leolei2012/power_system/inverter/reference/README.md

# 开源参考

本目录保留已有开源项目的索引和对照笔记。用户指定的参考资料下载统一放在工程根目录 [reference](../../reference/README.md)，ATK-PD6010B 单独归档。

当前第一版已定母线 12～60 V、直流输入最大 10 A、每相连续 10 A_rms、20 kHz。当前 G431 控制、驱动和功率级集成在 inverter 同一板，旧分板说明只作历史参考。下表及既有对照笔记中涉及旧 100 V / 1 kW 目标的比较，需按 [当前规格](../docs/spec.md)重新核对。

| 资料 | 电压 / 功率 | 对本板 | 笔记 |
|---|---|---|---|
| [OWNVERTER](ownverter.md) | 高压侧最高 100 V，约 1.3 kW | 电气最接近，优先看 | 滤波后电压采样口可参考 |
| [Nexperia 逆变板](nexperia-nevb.md) | 工作 12~48 V，1 kW；管子 100 V | 功率板单独成板的画法 | 不能直接上 100 V 母线 |
| [openinverter](openinverter.md) | 几百伏 IGBT | 控制 / 驱动 / 采样分板 | 第一版低压用不上功率级 |
| [ODrive / ODriveX](odrive.md) | 24~60 V | 电机固件成熟 | 母线不够出 60 V 交流 |
| [VESC / FOC_KING](vesc.md) | 常见 60 V 级，FOC_KING 约 84 V | 大电流布局、模块化 | 60 V 交流没有余量 |
| [SimpleFOC](simplefoc.md) | 评估板约 25 V | 学 FOC、对 PWM 接口 | 功率级不是这一档 |

没有找到带可旁路 LC、专门做可编程交流电源的开源功率板。电机驱动是主流，交流源要自己加。

## 使用约定

- 对照原理图时打开上游仓库，不要把 KiCad / Eagle 工程提交到这里。
- CERN-OHL、CC BY-SA 是相同方式共享。若以后把他人图纸改进 `hardware/`，必须保留原许可和署名，不能改成私有设计。
- MIT 可以借鉴电路思路；直接复制整页图纸仍要保留版权声明。
- 仓库简介和文档里的电压、电流有时不一致，以对应版本的原理图和手册为准。

各项目的克隆地址写在 [sources.md](sources.md)。
