leolei2012/power_system/docs/design_decisions.md

# Rev E-1 设计决定记录（design decisions）

- 整理人：领班（项目经理 bot），2026-11-12（Asia/Shanghai）
- 修订（2026-11-12 00:45 后）：
  - 新增 A12（叠板顺序），删去待定的叠板顺序项，冲突第 5 条改为已移除；
  - 默认做法几条改为已定；
  - C12 标为须按新顺序重新核对；
  - 2026-11-12 00:46 新增 A13（保护参数），风扇预留位移到作废方案 X17，删去对应待定项，冲突清单补 4 条；
  - 2026-11-12 00:57 新增 A14–A23（叠板细节、验收环境、母线电流检测）；C12 定案；X8 改为采用顶面散热片；冲突清单补 #32–#35；
  - 2026-11-12 01:03 新增 A24（阻容最小 0603），冲突清单补 #36；
  - 2026-11-12 01:36 新增 A25–A27（母线高端保护、板上比较器、J4 和 C20 位置），A13/A21/A23 加交叉注。
- 依据：
  - 总管 2026-11-12 00:30 转来的开工需求全文（下称「开工需求」）；
  - 2026-11-11 晚到 2026-11-12 凌晨雨田和总管的需求讨论记录；
  - 2026-11-11 群聊「研发部交流群」的讨论（本次只拿到群聊结论，没有拿到原文，见文末「说明」）；
  - 焊台评估 `/workspace/tmp/ps_eval/评估.md`、探针报告 `/workspace/tmp/probe/report.md`、料号立创查价笔记 `/workspace/liaohao_notes/*.md`（都在共享电脑上，不在仓库里）。
- 理由的写法：「理由」只写讨论记录里出现过的说法，并注明是谁说的。记录里没有理由的，写「理由未记录」。
- 拍板日期：多数决定在 2026-11-11 晚到 11-12 凌晨的讨论中陆续定下，**2026-11-12 00:30 雨田确认开工时整体生效**。下表「日期」列写讨论定下的日期。表中标「默认做法」的条目由总管提出，雨田 2026-11-12 00:30 在开工确认卡片上选「按默认开工」（总管转述），已定。
- 本文件只记录决定。和现有文档冲突的地方只在第 3 节标出来，没有改动那些文件。

## 1. 已定决定

### 1.1 总体与板间连接

| # | 决定 | 理由（出处） | 日期 |
|---|---|---|---|
| A1 | 保持**两块板**（controller + inverter），各 60×60 mm，叠装。不合成一块板 | 理由未记录（群聊讨论过合一块板，原文本次没拿到） | 2026-11-11 |
| A2 | 板间用 **2.54 mm 排针/排母叠装**，不做 GH1.25 线束端子版 | 雨田在群里说「改回 2.54 mm 排针叠装吧」，本人没说理由。参考依据：寻宝调研认为排针叠装的载流和插拔都比 GH1.25 线束好；焊台估算端子版到能打样要多出约 60–90 h | 2026-11-11 |
| A3 | 左右两条边**最外侧各放一个 2×16** 排针，共 64 针。**不改 2×20** | 雨田先定「最左边和最右边各一个排针」，后来说「2×16 两组吧，可以」，本人没说理由。总管说明：MCU 放在两排中间，引脚出线都短；2×16 竖放长约 41 mm，放得下 | 2026-11-11 |
| A4 | 排针上**空着的脚全部接 GND** | 默认做法，已定（出处：雨田 2026-11-12 00:30 在开工确认卡片上选「按默认开工」（总管转述））。总管的理由：多点回流，抗干扰更好。寻宝调研也指出 Rev E 只有 7/64 根地针，偏少 | 2026-11-12 |
| A5 | controller **4 层**，inverter **6 层** | 沿用现有 Rev E 层数，讨论中没另说理由 | 2026-11-12 |
| A6 | 铜厚 **2 oz** | 默认做法，已定（出处：雨田 2026-11-12 00:30 在开工确认卡片上选「按默认开工」（总管转述））。总管的理由：5 A 用 1 oz 也能过，但 2 oz 温升更低，贵不了多少 | 2026-11-12 |
| A7 | 这一版是 **controller 和功率级一起做的完整版**，不只是功率级验证板 | 默认做法，已定（出处：雨田 2026-11-12 00:30 在开工确认卡片上选「按默认开工」（总管转述））。理由未记录 | 2026-11-12 |
| A8 | 验收电流 **5 Arms**，母线 **12–60 V**，开关频率 **20 kHz** | 5 Arms：雨田说「最大电流 4A」，「5A 吧，留点余量」。12–60 V 和 20 kHz 是 2026-10-31 已定的指标（`inverter/docs/spec.md`），这次沿用 | 2026-11-12 |
| A9 | **不加风扇，不焊铜条** | 默认做法。总管按 5 A 估算，每颗 MOS 约 0.5 W，温升约 20–25 °C，靠 PCB 铺铜和过孔就够 | 2026-11-12 |
| A10 | 物料**一律从立创商城选**，写 C 编号和商品链接。价格和库存由料号去立创查 | 雨田的规定，理由未记录 | 2026-11-11 |
| A11 | 引脚改动**先改 `docs/pinmap.md`**，再改原理图和固件 | 团队协作规则（硬件和固件靠 pinmap 对接），开工需求里重申 | 2026-11-12 |
| A12 | 叠板顺序：**功率板（inverter）在上，controller 在下** | 雨田 2026-11-12 00:44 亲口定（经总管转达），理由未记录。现有 Rev E 文档本来就是这个顺序 | 2026-11-12 |

**A12 的影响项（焊台已在 #4 核对；2026-11-12 00:57 已按 A14–A23 定案）：**

1. **排针的公母和安装方向**：现有文档写的是 controller 顶面装公针朝上，功率板底面装母座朝下（`docs/controller_daughterboard.md:107`、`docs/pcb_review_2026-11-11.md:25`）。排针已改到左右外侧（A3），所以要重新核对 1 脚位置、镜像关系和同号针是否同心。
2. **controller 上的 SWD、LED 和 CAN/485/编码器端子**：这些都在功率板下面，要核对叠装后线还能不能插拔、LED 能不能看到。必要时调整端子的位置或朝向（比如改成侧出、弯角端子），或者加高铜柱。
3. **功率板底面正对 controller**：功率板底面的散热过孔和裸铜区对着 controller，要留够间距和绝缘，controller 顶面的器件高度也要算进去。
4. **散热可能要改到顶面**（**已定：顶面散热片，见 A20**）：功率板底面被 controller 挡住，散热余量可能要转到功率板顶面。注意「正面散热」X8 已经作废，当时的理由之一是「功率板上面被控制板挡住」，现在功率板在上，这条理由不再成立。X8 已同步改为采用。
   - 底面散热器已作废（X5）。如果将来恢复，必须考虑它正对着 controller。
5. **C12「controller 底面不放器件」**（**已定案，见 A19**）：C12 当时的理由是「排母高 8.5 mm，底面有元件会顶到功率板」，是按 controller 在上推出来的。现在 controller 在下，朝向功率板的是它的**顶面**，原来的理由不再成立，这条规则和叠板顺序已经对不上了。规则本身是开工需求原文，暂时保留，等焊台核对后报雨田。真正要约束的是 controller **顶面**器件高度和功率板底面之间的净空。
| # | 决定 | 理由（出处） | 日期 |
|---|---|---|---|
| A13 | **保护参数跟着 5 Arms 改**：相电流硬件过流门限从 ±20 A 降到**约 ±12 A**；保险和直流输入电流上限按**约 8 A** 选；**分流电阻不动**。具体数值由焊台按器件和采样量程核算后，写进原理图和 `inverter/sim/params.py` | 雨田 2026-11-12 00:46 定（总管转达），理由未记录 | 2026-11-12 **交叉注：母线短路快速关断见 A25（约 15 A，补在保险来不及的场合），±12 A 和约 8 A 不变** |

### 1.1b 叠板细节和母线电流检测（2026-11-12 00:57 定）

下面各条都是 **雨田 2026-11-12 00:57 定（总管转述）**。理由都引自焊台 #4 评论 https://github.com/leolei2012/power_system/issues/4#issuecomment-6801916762（下称「焊台 #4 核对」）。

| # | 决定 | 理由（出处：焊台 #4 核对） | 日期 |
|---|---|---|---|
| A14 | **板距 11.0 mm**，用 **M2×11 双通铜柱** | 板距由排针决定：公针塑高 2.50 mm + 母座塑高 8.5 mm = 11.0 mm。铜柱短了会压坏排针，长了会减少插入深度。加高板距对散热几乎没帮助 | 2026-11-12 |
| A15 | controller 的 **SWD、485、CAN、ABZ、SPI 接口全部用板边侧插**（卧式），插头在板外 | 叠好后 controller 顶面全被功率板盖住；竖插要 ≥20 mm 板距 | 2026-11-12 |
| A16 | **RESET 改成板边侧按开关** | 原来的 TS-1101 是顶面按压开关，叠好后按不到 | 2026-11-12 |
| A17 | **取消 BOOT 按钮**，烧录走 SWD，需要时用 nBOOT0 选项字节（BOOT0 保留下拉和测试焊盘，按焊台建议） | 同 A16；而且新 pinmap 中 BOOT0 不再经排针引出 | 2026-11-12 |
| A18 | **RUN/FAULT 用上边缘的侧发光 LED** | 顶面贴片 LED 从 11 mm 侧缝几乎看不到 | 2026-11-12 |
| A19 | **controller 底面允许放 ≤1 mm 的无源件，以及 SWD/测试焊盘**。不放有源器件、连接器和高于 1 mm 的器件；底部支撑 ≥5 mm | controller 在下，底面朝外；底面最靠近 MCU，适合放去耦；现在底面已经有 5 个 0402/0603 件；底面 SWD 焊盘分不分板都能接。**C12 由此定案** | 2026-11-12 注：A24 定最小 0603，现有底面 0402 件也要换成 0603，并继续满足 ≤1 mm 的高度要求。 |
| A20 | **功率板顶面加散热片**，**底面整面铺 GND**（大量缝合过孔接 In1/In4），散热铜放顶面和内层。**仍然无风扇、无铜条** | 功率管本来就在顶面朝外；底面朝着半封闭的板缝。估算在 Ta 25 °C 时，加顶面散热片后 controller 均温约 40–45 °C，只靠铜皮约 53–63 °C。底面铺 GND 既能均热又能屏蔽，裸露的开关节点铜也就没了 | 2026-11-12 |
| A21 | **功率级整体左移 8–10 mm**，**三相输出 J4 移到上边缘** | 右侧排针移到最外侧（x151–157）后，和功率板上 23 个封装、三块相铜冲突 | 2026-11-12 **交叉注：J4 定在上边缘，挪 C20，功率级再下移 2–3 mm，见 A27** |
| A22 | **MCU 保持 STM32G431RBT6，不换**；**验收环境 ≤30 °C** | 焊台估算：没有散热片时，Ta 40 °C 下板缝温度会超过 RBT6 的 85 °C 上限。焊台给的选项是「保持 RBT6，验收环境 ≤30 °C 并实测板缝温度」 | 2026-11-12 |
| A23 | **不接受相线对地短路的保护盲区，加母线电流检测**：母线分流电阻加放大器，接 ADC 或比较器，并接进硬件过流保护或 TIM1_BKIN。具体方案由焊台设计，引脚先在 PR #11 改 pinmap，器件由料号在立创查 | 雨田 00:57 定，理由未记录。背景：现有只有三路低端分流，`inverter/docs/spec.md:60` 写了「低端分流存在检测盲区」 | 2026-11-12 **交叉注：具体方案已定，见 A25（高端分流 5 mΩ、20 V/V、约 15 A、PA3/COMP2/BKIN2）和 A26（板上硬件比较器接故障锁存）** |
| A24 | **电阻及同类贴片阻容件最小封装 0603**，不用 0402 及更小封装 | 雨田 2026-11-12 01:03 定（总管转述）。理由：便于手焊 | 2026-11-12 |
| A25 | **母线高端电流保护**：5 mΩ 高端分流（在母线电容和三相桥上管漏极之间），双向、高共模电流检测放大器，增益 **20 V/V**，跳闸约 **15 A**。定位是在保险来不及的短路时快速关断；正常过载仍靠相电流 ±12 A 硬件过流和约 8 A 保险（A13）。I_BUS 走 **J101/23 → PA3**（ADC1_IN4 + COMP2 → TIM1_BKIN2） | 雨田 2026-11-12 01:36 定（总管转述）。理由引自焊台 PR #11 评论 https://github.com/leolei2012/power_system/pull/11#issuecomment-6802827693：相线对地短路、上管导通时，短路电流不经过下桥 RS1–RS3；共地系统里，低端分流会抬高控制地，经外部地返回的电流也会绕过它。PA3 同时有 ADC1_IN4 和 COMP2_INP，其他同时具备这两项的引脚都已占用 | 2026-11-12 |
| A26 | **inverter 上加硬件比较器**（开漏、带迟滞），接进现有故障锁存：触发后硬件封锁 PWM，并拉低 FAULT_N 到 PB12/BKIN | 雨田 2026-11-12 01:36 定（总管转述）。理由引自同一条评论：这一层保护不依赖固件 | 2026-11-12 |
| A27 | **MR60（J4）放在上边缘**，**挪开 C20**，功率级**再下移 2–3 mm** | 雨田 2026-11-12 01:36 定（总管转述），按焊台建议。J4 移到上边缘的原因见 A21（右排针让位）；挪 C20 和下移 2–3 mm 的具体理由，上面那条评论里没写，理由未记录 | 2026-11-12 |

### 1.2 controller（控制板）

| # | 决定 | 理由（出处） | 日期 |
|---|---|---|---|
| C1 | MCU 用 **STM32G431RBT6**，板上**只放 MCU 最小系统** | 雨田说「这块板上只有 mcu 的最小系统」，没说理由 | 2026-11-11 |
| C2 | 3.3 V 由**板上自己的 LDO** 产生，沿用现有方案 | 现有设计就是这样：控制板从排针取 5 V，再用 TLV76733 转 3.3 V，两块板的 3.3 V 不并联 | 2026-11-11 |
| C3 | **通讯口搬到 controller 上** | 雨田说「通讯端子做在 controller 上也可以」。总管的理由：通讯信号直接从 MCU 引到板边，不用穿过排针，空出来的针可以改成地 | 2026-11-11 |
| C4 | 通讯只做 **UART（改成 485）和 CAN**，不要 USB | 雨田说「UART、CAN 就够了」，没说理由 | 2026-11-11 |
| C5 | CAN 沿用 **SN65HVD232**（C30530） | 共享库里已经选好这颗料 | 2026-11-12 |
| C6 | 串口从 TTL **改成 RS-485** | 总管的理由：485 是差分信号，在逆变器噪声下抗干扰强，线可以拉长。探针补充：两块板共地，TTL 一接电脑，电脑的地就直接连到功率地 | 2026-11-11 |
| C7 | 485 收发器用 **MAX3485ESA+T（C18148），不隔离**。DE 脚从 **PB3、PB4、PB9** 里选一根 | 雨田问了隔离型的价格和体积后说「用 max3485 吧」，没说理由。DE 只能从这三根里选，因为它们是空闲脚，PC14/PC15 驱动能力弱（总管） | 2026-11-11 |
| C8 | 485 端子 **4 针：A、B、GND、5V**。5V 要串二极管或加跳线 | 第 4 针接 5 V 是雨田定的（「5 V」），没说理由。加二极管或跳线是为了防止 5 V 倒灌底板的 5 V，现有文档也禁止两路 5 V 并联 | 2026-11-11 |
| C9 | 485 和功率地**共地**，PC 端**必须用隔离型 USB 转 485**。这一条写进测试规范 | MAX3485 不隔离，485 的地就是功率地（总管、探针） | 2026-11-11 |
| C10 | 编码器**两种接口都留**：一路 ABZ（PA0/PA1/PA2，TIM2），一路 SPI（引脚由焊台定）。原来的第二路 ABZ 去掉 | 雨田说「两种都留吧」。总管的理由：现成电机多半带 ABZ；SPI 磁编上电就知道绝对角度，FOC 不用先对位。两种都留最灵活 | 2026-11-11 |
| C11 | **两颗可编程 LED**：PC5 RUN 绿色、PC8 FAULT 红色，放在**上边缘** | 两颗灯是雨田定的，没说理由。复用 PC5/PC8 是总管的建议，理由是固件不用改。放在边缘是雨田定的，总管补充：叠装后从侧面也能看到 | 2026-11-11 **2026-11-12 00:57 改成上边缘侧发光 LED（A18）** |
| C12 | （**已定案，见 A15、A19。底面规则改为允许 ≤1 mm 无源件和 SWD/测试焊盘，端子改为板边侧插**）布局：**上边缘**放 SWD 和 LED，**下边缘**放 CAN、485 和编码器端子，**左右两边**放排针，**底面不放器件** | 总管的理由：叠装后调试线不会挡住端子；排母高 8.5 mm，底面有元件会顶到另一块板 | 2026-11-11 |
| C13 | 备用 ADC **PB0、PB2 引到排针上**，在 inverter 上悬空。**不加额外的 AD 端子，三相电压不测** | 雨田先说「三相电压不需要测」，后来说「这两个端子不要了」，都没说理由 | 2026-11-12 |

### 1.3 inverter（功率板）

| # | 决定 | 理由（出处） | 日期 |
|---|---|---|---|
| I1 | MOS 沿用 **BSC110N15NS5**（C412739），**不换双面散热型号** | 总管按 5 A 估算，每颗约 0.5 W，用现有 MOS 就够，便宜，货也多。对比：双面散热的 BSC110N15NS5SC 价格约 2.6 倍，LCSC 国际站库存只有 24 只（料号查价） | 2026-11-12 |
| I2 | 散热靠**底面过孔加铺铜**。底面要留出以后贴绝缘导热垫和铝板的条件，MOS 附近留 **M3 安装孔和禁布区**，作为以后加散热器的余量 | 总管的理由：电流小时靠 PCB 就够，留好余量，以后加大电流再贴散热片 | 2026-11-12 **2026-11-12 00:57 补充：底面改为整面 GND，散热改为顶面散热片（A20）；底面导热垫和铝板的余量不再适用** |
| I3 | **NTC 放在 MOS 旁边，接 PB1**，型号由焊台选 | 总管的理由：紧贴 MOS 测温才准，最好放在 V 相下管旁边。PB1 是端子版规划里的 NTC 通道（ADC09） | 2026-11-11 |
| I4 | 母线输入用 **XT60PW-M（C98732）** | 雨田说「用 XT60 / XT30 插头当电源」，没说理由。料号建议板上装公座，电池或线端用母头 | 2026-11-11 |
| I5 | 辅助电源用 **XT30PW-M（C431092）** | 同 I4。总管补充：辅助电源电流小，XT30 就够 | 2026-11-11 |
| I6 | 三相输出用 **MR60PW-M（C19268044）**，线端配 **MR60-F（C3040681）** | 雨田说「用 mr60」。总管的理由：一个插头接三相，不会插错相序，比螺丝端子方便。料号提示：板端持续电流按保守的 20 A 算 | 2026-11-12 |
| I7 | **D1 改成理想二极管**做防反接，型号由焊台选 | 默认做法，已定（出处：雨田 2026-11-12 00:30 在开工确认卡片上选「按默认开工」（总管转述））。总管的理由：比普通二极管压降和发热都小。焊台和探针估算现有 MBRD20150CT 在 10 A 输入时约 6–7.5 W | 2026-11-12 |

### 1.4 评估中提出、还要在 Issue 里落实的项（不是雨田拍板的决定）

下面几条来自焊台、探针、寻宝的只读评估，开工需求里没有逐条写。列在这里，避免遗漏：

- DC 输入 J3→F1 只有一条 2.0 mm、1 oz 的外层线，按 10 A 估算温升约 82 °C（焊台）。改成 2 oz、5 A 后要重新核算。
- U/V 相的 VBUS 换层过孔只有 2–3 个，U 相 source-transfer 只有 2 个，焊台认为不够。
- 顶面测试点：探针建议补 GND 测试环和 VBUS 测试点。总管在讨论 controller 布局时也提过 I_U/V/W、FAULT_N、GND 测试点放顶层，雨田没有确认。
- ADC 加 RC：寻宝调研建议 MCU 一侧的 ADC 加 RC。现有底板已经有 360 Ω/BAT54S 加 100 Ω/1 nF。
- `inverter/sim/params.py` 的阈值要按 12–60 V 重写（见第 3 节）。

## 2. 作废方案

| # | 作废方案 | 作废原因（出处） | 替代方案 |
|---|---|---|---|
| X1 | 三相 U/V/W 用 **5.08 mm 螺丝端子**（KF128 / DG129 / DG500） | 雨田改用 MR60，总管的理由是一个插头不会插错相序。料号查价也发现：KF128 的 UL 额定只有 10 A；DG129 国际站库存只有 99 只 | MR60PW-M + MR60-F（I6） |
| X2 | **隔离型 485**（CA-IS2092W/A、ADM2587E、金升阳模块等） | 雨田选了 MAX3485，没说理由。背景：CA-IS2092W 10 只单价约 15 元，约是 SP3485 的 10 倍，整个 485 区域约占 15×12 mm | MAX3485ESA+T 不隔离，PC 端用隔离型 USB 转 485（C7、C9） |
| X3 | **两个额外 AD 输入端子**（PB0/PB2 各一个 2 针，先放 controller，后改 inverter） | 雨田说「算了，这两个端子不要了」，没说理由 | PB0、PB2 作为备用 ADC 引到排针，inverter 上悬空（C13） |
| X4 | **双面散热 MOS**（BSC110N15NS5SC / BSC093N15NS5SC 等） | 验收电流定为 5 A 后发热小，不需要（总管）。另外价格约 2.6 倍，库存紧（料号） | 沿用 BSC110N15NS5（I1） |
| X5 | **底面散热器 / 铝底板** | 5 A 时靠 PCB 铺铜和过孔就够（总管） | 底面过孔加铺铜，留好导热垫、铝板和 M3 孔的余量，现在不装（I2） |
| X6 | **大电流路径焊铜条** | 5 A 时不需要，「风扇和铜条都不加」（默认做法，雨田 2026-11-12 00:30 在开工确认卡片上选「按默认开工」（总管转述）） | 2 oz 铜加走线宽度和过孔（A6、A9） |
| X7 | **风扇 / 侧面风道** | 同 X6 | 无风扇（A9） |
| X8 | ~~**正面（顶面）散热**~~ **→ 2026-11-12 00:57 改为采用**：顶面散热片（A20），不换 TOLT 封装，仍然无风扇、无铜条 | 当时作废的理由是「功率板上方被控制板挡住」；叠板顺序定为功率板在上（A12）后，这条理由不成立。雨田 2026-11-12 00:57 定（总管转述） | 见 A20 |
| X9 | **两组 2×20 排针**（80 针） | 雨田定了 2×16，没说理由 | 2×16，空脚全接 GND（A3、A4） |
| X10 | **HSEC 金手指**（TI controlCARD 那种） | 雨田在群里问过它长什么样，最后改回 2.54 mm 排针，理由未记录。参考：寻宝调研提到它需要硬金，成本高 | 2.54 mm 排针叠装（A2） |
| X11 | **两块板合成一块板** | 理由未记录（群聊原文本次没拿到） | 两块板叠装（A1） |
| X12 | **GH1.25 线束端子版**（19 个连接器、10 个 ADC2P、I²C 等，见 `docs/terminal_interface_plan.json`） | 雨田改回排针叠装。焊台估算端子版到能打样要多约 60–90 h | 排针叠装（A2） |
| X13 | 串口用 **TTL**（3.3 V，3 针） | 485 抗干扰更好；共地时 TTL 会把电脑地直接连到功率地（总管、探针） | RS-485（C6） |
| X14 | **第二路 ABZ 编码器**（PB6/PB7/PA3）和**第二路 SPI** | 雨田定了 ABZ 和 SPI 各留一路 | 一路 ABZ 加一路 SPI（C10） |
| X15 | 底板上的 **4 颗 LED**（RUN/FAULT/COMM/AUX） | 雨田要在 controller 上放两颗可编程灯 | controller 上两颗（C11） |
| X16 | **4 mm 香蕉接线柱**做电源或相线端子 | 雨田直接选了 XT60/XT30。总管提过 60×60 板上放 5 个会很挤 | XT60/XT30/MR60（I4–I6） |
| X17 | **在 inverter 上预留风扇安装位**（只留孔和一个供电座，不装风扇） | 雨田 2026-11-12 00:46 定不留（总管转达）。背景：焊台估算 5 Arms、无风扇时整板约 2.6–4 W，开放放置时板温约 55–80 °C，叠板间隙小时悲观情况可能超过 110 °C（估算，不是仿真） | 不留风扇位；继续无风扇（A9），靠铺铜和过孔散热（I2） |

## 3. 与现有 docs 的冲突（只标出，不改）

基准：仓库 main 分支提交 `487548d`。行号是文件里的物理行号。很多 md 文件一行就是一整段，所以「行号」指那一段。

| # | 文件:行 | 旧写法（摘要） | 新决定 |
|---|---|---|---|
| 1 | `README.md:3` | 最新方案已收敛为单功率 PWM 口，19 个 GH1.25 连接器的端子版 | 端子版作废，走 2.54 mm 排针叠装（A2、X12） |
| 2 | `README.md:5` | 编码器、SPI、TTL、CAN、LED 和应用采样保护都在底板 | 通讯、编码器、LED 放在 controller；TTL 改成 485（C3、C6、C10、C11） |
| 3 | `README.md:14` | 两组 2×16 中有 7 根地；底板 9 个未用插座脚显式 NC | 空脚全部接 GND（A4） |
| 4 | `README.md:18` | 直流输入最大 10 A、每相连续 10 Arms | 验收 5 Arms（A8）；输入电流上限按约 8 A（A13） |
| 5 | （已移除）`README.md:12`、`docs/controller_daughterboard.md:105`、`docs/roadmap.md:3/40`、`docs/pcb_review_2026-11-11.md:3` | 上层功率板，下层 G431 最小核 | **与 A12 一致，不再算冲突**。排针位置的冲突另见第 6 条 |
| 6 | `docs/controller_daughterboard.md:105`、`docs/pcb_review_2026-11-11.md:18`、`docs/pcb_stack_contract_rev_e.json:15-17` | 两组排针集中在左侧（J101 x≈104.7，J102 x≈128.7），右侧留给功率桥 | 左右两条边最外侧各放一个 2×16（A3） |
| 7 | `docs/controller_daughterboard.md:3-90` | 「当前方案：单功率口」，包括 GH1.25 连接器表、10 路 ADC2P、I²C、TTL 3P、PWM 8P | 整段作废（X12） |
| 8 | `docs/controller_daughterboard.md:115`、`inverter/hardware/README.md:15`、`docs/roadmap.md:35` | SWD/TTL/ABZ/SPI/CAN 和五个 LED 都在底板 | 移到 controller（C3、C10–C12） |
| 9 | `docs/controller_daughterboard.md:119/131`、`docs/roadmap.md:33`、`inverter/docs/pin_assignment.md:29-31` | 本底板 9 个 socket 脚 NC；64 针里只有 7 根地 | 空脚全接 GND（A4） |
| 10 | `docs/controller_daughterboard.md:109`、`inverter/hardware/README.md:27`、`inverter/hardware/design_review.md:40` | 要安排上板背面散热和**风道**，按 10 Arms 考虑 | 无风扇；5 Arms；底面过孔加铺铜，并留好余量（A8、A9、I2） |
| 11 | `inverter/docs/pin_assignment.md:17-18` | V_W 接 **PB1**，NTC 接 **PB2**；另外还测 V_U/V_V/V_W | NTC 接 **PB1**；三相电压不测；PB0/PB2 作为备用 ADC（I3、C13） |
| 12 | `inverter/docs/pin_assignment.md:19-22` | 编码器 A、B 两路 ABZ；SPI A、B 两路 | 一路 ABZ（PA0/PA1/PA2）加一路 SPI，SPI 引脚由焊台定（C10） |
| 13 | `inverter/docs/pin_assignment.md:23` | 应用 TTL 用 PB10/PB11 | 改成 RS-485（MAX3485），另加一根 DE 脚（C6、C7） |
| 14 | `inverter/docs/pin_assignment.md:26` | 4 个 GPIO LED（PC5/PC8/PD2/PB5），实体都在底板 | 2 个 LED：PC5 绿、PC8 红，放在 controller 上边缘（C11） |
| 15 | `inverter/docs/pin_assignment.md:29` | PB3/PB4/PB9 应用未分配 | 其中一根做 485 DE（C7） |
| 16 | `inverter/docs/spec.md:7,15-16` | 每相连续 10 A_rms，峰值约 14.1 A | 验收 5 Arms（A8） |
| 17 | `inverter/docs/spec.md:36` | 「驱动、G431 与采样保护集成在 inverter 同一 PCB，不另设 controller 板」 | 两块板（A1） |
| 18 | `inverter/docs/spec.md:70-80` | 接口表：J3/J4 焊线孔，J2 辅助，J8 外接 NTC，J9/J10 两路 ABZ，J11/J12 两路 SPI，J13 SWD，J14 TTL，J15 CAN 都在 inverter | XT60/XT30/MR60；NTC 板载在 MOS 旁边；通讯和编码器在 controller（I3–I6、C3） |
| 19 | `inverter/hardware/README.md:11` | D1 用 MBRD20150CT-13/C151357；目标是 DC 输入最大 10 A、每相 10 Arms | D1 换成理想二极管；5 Arms；输入约 8 A（I7、A8、A13） |
| 20 | `inverter/hardware/README.md:19` | J3 是 6 mm 间距 2P 焊线孔，J4 是 15 mm 间距 U/V/W 三孔 | J3 改 XT60PW-M，J4 改 MR60PW-M，辅助 J2 改 XT30PW-M（I4–I6）。J5 制动电阻焊线孔没讨论 |
| 21 | `inverter/hardware/PCB_REVIEW.md:5`、`inverter/docs/component_selection.md:8`、`docs/integrated_board.md:98` | 6 层、1.6 mm，**1 oz** 铜厚为候选 | **2 oz**（A6） |
| 22 | `docs/pcb_review_2026-11-11.md:59` | 设计目标：12–60 V / 输入最大 10 A / 每相 10 Arms | 验收 5 Arms（A8）；输入约 8 A（A13） |
| 23 | `inverter/sim/params.py:8-12` | V_DC_NOM=100、MIN=80、MAX=120、**V_DC_UV=75、V_DC_OV=130** | 母线 12–60 V（A8）。`spec.md:56` 已经写明硬件过压 65 V、「旧 130 V 值作废」，params.py 没跟上；欠压阈值要按 12–60 V 重新定 |
| 24 | `inverter/sim/params.py:15,20-21` | V_LL_RMS_MAX=60、P_RATED=1000 W、I_RMS_RATED=10 A | `spec.md:22/25/29` 已经撤回 60 V_rms 和 1 kW；电流改成 5 Arms（A8） |
| 25 | `docs/terminal_interface_plan.json:2-4`、`docs/controller_single_power_pin_plan.*`、`docs/controller_connector_inventory.*` | 端子版规划，状态写着 Current（当前方案） | 作废（X12），要标成历史 |
| 26 | `docs/daughterboard_pin_contract.json` | 64 针合同：7 根 GND，未用脚在底板 NC，编码器 A/B 等应用网名 | 空脚接 GND，通讯移到 controller，合同要重写（A4、C3） |
| 27 | （缺文件）`docs/pinmap.md` | 仓库里**没有这个文件**。引脚信息分散在 `inverter/docs/pin_assignment.md`、`docs/controller_daughterboard.md` 和 csv/json 里 | 开工需求要求引脚改动先改 `docs/pinmap.md`（A11），由焊台新建 |
| 28 | `inverter/docs/spec.md:17,59-60` | 相电流硬件过流名义门限**瞬时 ±20 A**；按 5 mΩ、增益 10 换算约 0.65/2.65 V | 约 **±12 A**，分流电阻不动，具体值由焊台核算（A13） |
| 29 | `inverter/docs/spec.md:14,24,70` | 直流母线输入电流上限 **10 A**，P_dc,max = V_dc×10 A，最大 600 W@60 V | 输入电流上限和保险都按**约 8 A**（A13） |
| 30 | `docs/parts_to_complete_2026-11-10.md:41`（F1 0476015.MRSN，15 A） | 保险 15 A | 保险按约 8 A 输入重新选（A13） |
| 31 | `inverter/docs/component_selection.md:16,64`、`docs/schematic_handoff.md:39,63,82`、`docs/schematic_agent_task.md:59,67,108`、`docs/integrated_board.md:63,68` | 输入最大 10 A、瞬时 ±20 A 过流（多处重复） | 约 8 A 输入、约 ±12 A 过流（A13）。其中 handoff 和 agent_task 是旧任务书，integrated_board 是历史文档 |
| 32 | `inverter/docs/pin_assignment.md:35,41`、`docs/controller_daughterboard.md:5,111` | RESET（SW2）和 BOOT（SW3）都是控制板顶面按钮；物理 BOOT 操作是「按住 BOOT，再按 RESET」 | RESET 改成板边侧按开关，取消 BOOT 按钮，改用 SWD + nBOOT0 选项字节（A16、A17） |
| 33 | `docs/controller_daughterboard.md:107`、`docs/pcb_review_2026-11-11.md:29` | 「母座 8.5 mm 塑高不是已验证的板间距」，支柱长度待定 | 板距 11.0 mm，M2×11 双通铜柱（A14） |
| 34 | `inverter/docs/spec.md:60` | 只有三路低端分流，「存在检测盲区」 | 加母线电流检测，接硬件过流或 BKIN（A23） |
| 35 | `inverter/hardware/inverter.kicad_pcb`（不是文档，焊台 #4 核对实测 J4 在 x153.9–159.5） | J4 三相焊线孔在右边缘 | J4 移到上边缘，功率级左移 8–10 mm（A21） |
| 36 | `controller/hardware/g431_core/bom/bom.csv`、`controller/hardware/g431_core/bom/selection_pending.csv`（各 13 行 `C_0402_1005Metric`/`R_0402`，如 C63、C64 MCU 去耦）；`inverter/hardware/bom/bom.csv`、`inverter/hardware/bom/selection_pending.csv`（各 117 行 0402）；`docs/parts_to_complete_2026-11-11/selection_pending.csv`（24 行）、`docs/inverter_selection_todo.csv`（19 行） | 阻容封装用 0402 | 最小 0603（A24）。这些是 BOM/待选 csv，不是 md 文档；md 文档里没有写 0402 或更小封装的地方（检索到的「AR02016」是开关型号，不算）。原理图和 PCB 的封装要由焊台改（#2/#3/#4），BOM 由料号在 PR #12 改。只标出，不改 |

另外：`docs/integrated_board.md`、`docs/schematic_handoff.md`、`docs/schematic_agent_task.md`、`controller/docs/*`（旧 LKS 方案）、`vfd/docs/architecture.md` 本身已经标成历史或旧方案，没有逐条列。和现有文档一致、不算冲突的：12–60 V、20 kHz、controller 自己用 LDO 出 3.3 V、两侧 3.3 V 不并联、共地不隔离、物料走立创。

## 4. 待定事项

| # | 事项 | 现状 / 谁定 |
|---|---|---|
| P1 | **仓库要不要改成私有**。leolei2012/power_system 现在是 PUBLIC，它依赖的 kicad_library 是私有的 | 领班会给出建议（另开 Issue），**由雨田决定** |
| P2 | **kicad_library 用 submodule 引入，还是继续放同级目录** | 同上，由雨田决定 |
| P3 | 器件和引脚细节：理想二极管和 NTC 的型号（焊台选），485 DE 用 PB3/PB4/PB9 中哪一根，SPI 编码器用哪几根脚，485 端子的 5 V 用二极管还是跳线，M3 孔的位置 | 开工后由焊台定，先写进 `docs/pinmap.md` 和布局约束 |
| P4 | 控制板四条边能不能放下所有端子（CAN、485、ABZ、SPI、SWD、LED） | 等焊台出初始布局后确认 |
| P5 | J5 外接制动电阻端子保留现有焊线孔还是换型 | 这次讨论没涉及 |
| P6 | `params.py` 的欠压和软件过压阈值具体取多少 | 由焊台在 #7 重写；过流和输入上限的方向已定（A13） |

## 说明

- 群聊「研发部交流群」2026-11-11 的原文本次没能读到。A1、A2、X10、X11 是根据领班会话里的结论摘要整理的：雨田提过要不要「两块板不分开，合二为一」，问过「HSEC 金手指长什么样子」，最后说「改回 2.54 mm 排针叠装吧」。这几条雨田本人的理由都是「理由未记录」。
- 「默认做法」几条（A4、A6、A7、A9、I7）由总管在雨田问「可以开始设计了吗」时提出；雨田 2026-11-12 00:30 在开工确认卡片上选「按默认开工」（总管转述），这几条都已定。
