leolei2012/power_system/docs/schematic_agent_task.md

# 旧分板原理图任务书

## 当前入口：Rev E（2026-11-07）

最小核与应用底板原理图已完成：子板7页47位号/3DNP，底板20页317位号/14DNP，双ERC0错误/0警告；64针、全部52信号pad及32768组静态保护/ARM逻辑检查通过。子板仅MCU及最小系统，SWD/TTL/ABZ/SPI/CAN/LED/ADC应用保护均在底板；PC7用于主动ARM。两个新PCB均未画；机械规划为两板60×60 mm轮廓对齐、上功率板下最小核，四角M2孔及板距待共同校核。下板顶面male朝上，上板底面female朝下；8.5 mm母座塑高不等于板距。

当前入口为 [最小核与底板](controller_daughterboard.md)、[G431工程](../controller/hardware/g431_core/README.md)、[功率底板](../inverter/hardware/README.md)及 [应用脚表](../inverter/docs/pin_assignment.md)。当前PDF为 [controller.pdf](../controller/hardware/g431_core/review/controller.pdf)和 [inverter.pdf](../inverter/hardware/review/inverter.pdf)。

**下文LKS、旧24脚接口、Rev C合板及40针Rev D均为历史，不是当前实施任务。** Rev E两组2×16与旧40针不兼容；前版 [Rev D整体归档](../inverter/history/daughterboard_rev_d_before_minimum_core_2026-11-07.zip)及更早资料仅用于追溯。后续以当前原生工程、64针合同及BOOT/SWD操作说明为准。

## 以下为历史正文

2026-11-05 架构变更：用户确定控制、驱动与逆变功率级合板，MCU 改为 **STM32G431**。当前依据见 [合板方案](integrated_board.md)。本文下方 LKS、独立 controller、24 脚板间接口及旧引脚/软件预算属于上一版记录；旧 KiCad/BOM/检查结果不代表新合板版本已完成。已确定每板一颗 MCU，分变频板与电源板，取消单 MCU 同时控制两路逆变和 PFC。LLC 在电源板恢复讨论，具体配置、接口和 MCU 完整后缀待评估。

## 旧版交付及电气分析参考

以下分板结构、LKS 引脚和集中控制任务已被新方案取代；电气目标与功率电路分析按合板方案逐项复用。

2026-11-01 交付更新：[controller 九页](../controller/hardware/README.md)和 [inverter 十三页](../inverter/hardware/README.md)草稿均已完成，后续工作应基于现有原生工程修订。未进入 PCB 或生产发布；inverter 当前电路/缺口以 [Rev A 审查记录](../inverter/hardware/design_review.md)为准。

更新：2026-11-01。任务目标是完成可审查的 controller 与 inverter 第一版 KiCad 原理图草稿，并在绘图过程中补齐计算、选型与待解决项。当前可开始绘图；本任务书不代表电气参数已经冻结或可以直接制板。

## 范围与资料

工作目录为 `D:/workspace/power_system`。只展开 controller 与一份可复用的三相 inverter 电路，controller 保留两路逆变及一路 PFC 控制接口；PFC 功率板另阶段设计。LLC、USB、霍尔不在范围内。用户负责新增器件库物料，公共库位于 `D:/workspace/kicad_library`；本任务不自动改公共库、不提交或推送。

用户明确当前仅考虑硬件，不展开软件设计或固件实现，母线软件欠压门限后续再定。已记录的软件控制方向/门限目标保留为接口背景；现阶段只落实所需采样、控制输入、默认电平和硬件独立保护。软件实时性待验证项移交后续，不当作本次已完成内容；驱动 UVLO 与电源异常封锁等硬件需求仍须完成。

通用贴片小阻容品牌已统一为 **YAGEO（国巨）**，适用于 controller 和 inverter；常规去耦、滤波、上下拉等按此选型，不继续采用村田。采样分流、功率/制动电阻、母线大电解等仍单独选型。已确认的母线高频旁路改用国巨 CS1210KKX7R0BB225 / C5578983，两只 2.2 µF / 100 V / X7R / 1210，原村田候选不用于本工程；公共库维护不在本任务的自动修改范围。

首版功率母线按用户决定不做独立预充/限浪涌和专用放电支路，原 47 Ω 电阻、旁路继电器及其驱动不画、不留作本版装配项，也不新增 inverter 预充控制脚。参照 ATK 的直接母线入口结构，防反接、TVS及熔断器等具体防护另行落实；制动电路与独立辅助输入保护保留，PFC 预充资源不受影响。

先读以下文件，旧草案与本文有冲突时按当前决策和接口/引脚表处理，不能直接照抄旧图块：

1. [交接与缺口](schematic_handoff.md)。
2. [controller 接口](../controller/docs/connector.md)、[MCU 引脚分配](../controller/docs/pin_assignment.md)、[100 脚 CSV](../controller/hardware/LKS32MC451VCT8_pin_plan.csv)。
3. [供电结构及接地边界](../controller/docs/power_architecture.md)。
4. [有源器件依据](../inverter/docs/component_selection.md)、[电路草案](../inverter/hardware/design.md)、[候选规格](../inverter/docs/spec.md)。
5. [器件清单](library_build_list.md)、[含库引用的 CSV](library_build_list.csv)、[inverter BOM](../inverter/hardware/bom/bom.csv)。

## 按当前决策绘制的部分

| 部分 | 接线要求 |
| --- | --- |
| 主控 | 单颗 LKS32MC451VCT8，LQFP100，按既有脚号与 AF 分配；不覆盖 SWD 和 REF/LDO12 保留用途 |
| 控制接口 | 两路各 24 脚 inverter、一路 24 脚 PFC；两路 ABZ、两路 SPI、两路制动控制、TTL、CAN、SWD；功率母线不进入 controller |
| 功率桥 | 六只 **IRFS4227TRLPBF，TO-263 / D²PAK，200 V**；替代旧 IRFB4227PBF 直插候选。新库物料待建，不得套旧 TO-220 封装 |
| 母线电解电容 | 2026-11-01 用户确定首版暂用 **2×220 µF / 100 V 并联，共 440 µF**；选 NCC EKYB101ELL221MK25S / C1585673，库与纹波/温升验证待完成；桥臂旁路另核 |
| 母线高频旁路 | 每块 inverter 两只 **YAGEO CS1210KKX7R0BB225 / C5578983，2.2 µF / 100 V / ±10% / X7R / 1210**，并在 DC+/DC−、靠近功率桥；实际偏压容量及纹波/布局待核，替代旧三只 250 V 薄膜候选 |
| 门极驱动 | 每桥臂一颗 2ED2182S06FXUMA1，共三颗，与 MOS 集成在同一 inverter PCB，标称 12 V；自举后实际栅压、补电时间、MCU 与内部死区一起核对 |
| 制动驱动 | 每块 inverter 一颗 TI UCC27517DBVR，SOT-23-5 / C99395，稳压 12 V 供电；BRAKE 3.3 V 高有效、输入默认下拉，IN+ 接命令、IN− 接低；库与外围待完成 |
| 辅助电源 | 12～24 V 适配器进入 inverter，经保护后分别生成 12 V 驱动和 5 V；inverter 本地 LDO 到 3.3 V |
| controller 供电 | 指定一块 inverter 经独立 5 V/GND 线供电，controller 本地 LDO 到 3.3 V；两路电源不直接并联，供电不依赖电机 ENABLE |
| 采样 | 三路低端分流放大、三相输出电压、母线电压与 NTC；按既有接口刻度研究，1.65 V 用分压加缓冲生成 |
| 故障 | ENABLE 默认低，故障由硬件先关断；FAULT_N 开漏；活动故障优先于清锁存，故障消除不自动重启；不增加功率板 RESET_N |

用户已确定第一版直流母线工作范围 **12～60 V**，**直流母线输入电流最大 10 A**；输入功率上限为 V_dc×10 A，12 V 时 120 W、60 V 时 600 W，输出功率需扣除损耗。输出相电流已定每相连续 10 A_rms，正弦峰值约 14.1 A，需另计 PWM 纹波；相电流硬件过流名义门限已定瞬时 ±20 A；短时过载、误差和总关断延迟仍需核对。输入电流与相电流限制需同时满足，不能宣称最大输出电压和 10 A 相电流必然同时可用。三相桥 PWM 频率已定 **20 kHz**（周期 50 µs）；PFC、制动频率另定。旧 100 V / 80～120 V / 1 kW、60 V_rms 输出、130 V 过压和 ±25 A 过流不可当作当前定稿指标。涉及更改已定母线范围、隔离域或板卡结构的方案，须列明依据与影响交用户讨论。

## 建议分页与推进顺序

2026-11-01 补充确认：母线硬件过压名义门限 **65 V**，由 inverter 本地硬件封锁六路 PWM、锁存并拉低 FAULT_N；故障消除后经 ENABLE 复位，电压恢复不自动重启。分压、基准、迟滞及检测误差仍需计算。制动门限可配置，60 V 工况名义设计目标为 **62 V 开启、61 V 关闭，1 V 迟滞**；其他供电工况门限另定，具体实现与执行延迟须结合电源容差、母线电容、回馈功率及耗能能力验证，制动 PWM 频率未定。

同日已确认保护结构：比较器→板内故障汇总/锁存→六路 PWM 硬件封锁，同时经开漏 FAULT_N 通知 controller；沿用 2ED2182S06F，在其 HIN/LIN 前封锁，不新增外部关断/复位脚。按 [已确认保护结构](../inverter/hardware/design.md#保护)落实具体门电路、故障优先、上电默认态与 ENABLE 复位时序；74LVC74A 候选与新增逻辑门的型号/门数仍需完成设计。

制动控制方式也已确认：由 controller 软件读取所属母线电压、判断迟滞门限并输出 BRAKE_1/2，inverter 只执行制动功率驱动，不另加自主电压门限制动比较控制。65 V 硬件过压及瞬时 ±20 A 硬件过流锁存独立保留。原理图需落实制动输入/栅极默认态；软件快速路径需测最坏响应时间，核对 MCPWM FAIL 对制动 CH3P 的影响，避免三相桥关断误封锁制动输出。具体频率、失效策略和支路保护待设计。

外接制动电阻详细选型按用户要求后续进行：5.6 Ω、±5%、1 kW 等级仅为参考目标，完整型号及实际热/脉冲能力未定。当前先完成板内制动电路与 2P 端子；原理图定稿前仍需核对支路电流、功率及能量，保留未确定电阻和运行边界的清晰记录。

controller 先画电源入口及 3.3 V、MCU 最小系统与 SWD、三路 24 脚端口、ABZ/SPI、串口/CAN及制动控制接口。先落实已核对的芯片脚号、电源去耦和网络名，再处理连接器与外部电平调理。

inverter 分为辅助输入及转换、直流入口及防护、三相桥及栅极驱动、电流/电压/温度采样、比较与锁存/封锁、输出滤波及接口。三路驱动与六只 MOS 已确定集成在同一块 inverter PCB；驱动可作为层级功能页，板内直接连接。controller 继续独立。

新 MOS 资料、引脚和库引用确认后再完成该部分落图。其余已确认物料可先画；未建库或参数不明的部分用明确的设计 TODO 标注，不能用近似器件冒充最终物料或默认连通未审查的回路。

## 绘图时需要完成的设计工作

| 工作 | 需要给出的结果 |
| --- | --- |
| 电源外围 | 按原厂应用计算电感、电容、反馈/门限、限流、软启动、EN/IGN/PG 接法和 LDO 稳定性；核对 12 V 低输入角点、启动与负载预算 |
| 输入保护 | 适配器容差/浪涌假设、eFuse 切断门限及延迟、下游 32/36 V 额定协调；TVS 不能只看标称工作电压 |
| 保护逻辑 | 真值表、活动故障/复位优先级、上电/失电默认态、开漏输出与外部上拉；74LVC74 异步置位/清零不能同时有效，推挽比较器不能直接并联 |
| 地与驱动回流 | 完整标出三只低端分流、驱动 COM、辅助回流与 DC−；不得以公共地线跨接分流。未来串联整流/PFC 的多个参考域不能直接共地 |
| 关键功率件 | 母线及旁路/吸收电容、分流、熔断器、输入防护、输出 LC 的额定及脉冲计算；首版不做功率母线独立预充/限浪涌或专用放电支路。制动已定每块 inverter 一路 MOS 及驱动，一个 2P BR+/BR_SW 端子接外置电阻，电阻可不接、端子开路且禁止短接；驱动外围、电阻能量及门限实现仍需设计 |
| 连接器及外部接口 | 24 脚座方向、防反插、脚序、板间 5 V 接插件；ABZ/SPI 电平及供电、CAN 端接和防护、晶振与 NTC 完整型号 |
| 贴片散热 | TO-263 漏极焊盘网络、铜皮/导热过孔与外部散热路径；按已定 10 A_rms，冷态导通损耗简算约 7.8 W，不作为整桥总损耗，不把不同漏极铜区并接 |

常规去耦、阻容计算与未占用输入处理可按原厂资料完成并记录。需要额外 MCU 信号时先修订资源分配并列出影响，不擅自占用保留脚。软件/PFC 动态验证项继续保留，不以原理图连通代替验证。

## 交付与定稿条件

交付原生 KiCad 工程、分页 PDF 或可审查图、与实际位号一致的 BOM、库依赖及资料路径、关键计算、ERC 报告，以及包含位置/影响/所缺参数的待解决事项。正式工程放在对应 `controller/hardware` 和 `inverter/hardware` 目录，不能把公共库的单器件验证工程当应用原理图。

草稿允许有可追踪的 TODO。原理图定稿前，新 MOS 库定义、外部接口、供电及参考域、保护真值表和关键功率额定都应解决并审查；不隐藏 ERC 问题或以批量不连接标记消除未设计电路。电气与热设计审核后再进入 PCB。

## 指定参考板

用户指定 [ATK-PD6010B](../reference/ATK-PD6010B/README.md)为设计参考。已取得 GitHub 转存的 V1.0、2021/12/24 两页原理图，两仓库副本逐字节一致，两页均已渲染查看；另有 DMG474 配套控制板原理图及硬件手册，不能当作 PD6010B 独立用户手册。

2026-11-01 用户进一步明确：**inverter 以该板作为主要硬件设计参考**，按原图的功能块、回路和常规外围结构展开；只针对本项目已有决定与必要差异做适配，避免无依据扩大规格或把所有模块重新设计。controller 继续采用已定 LKS32MC451VCT8 引脚与接口方案。

| 模块 | 参考与适配方式 |
| --- | --- |
| 母线储能 | 沿用 2×220 µF / 100 V 首版配置，具体品牌料号按立创选型；纹波和热验证保留 |
| 三相桥 / 自举驱动 | 参考六管桥、低侧分流、自举及就近去耦结构；按已选 IRFS4227 与 2ED2182 的原厂引脚和外围要求适配 |
| 电流、电压与温度采样 | 参考信号路径与滤波/缓冲；按 INA241A1、1.65 V 偏置、现有 ADC 刻度及 NTC 方案计算，不采用 ATK 的 1.25 V 零点 |
| 过流 / 锁存 | 参考比较检测和锁存关断结构；实现本项目瞬时 ±20 A 正负窗口及 65 V 独立过压，适配推挽比较器汇总和六路 PWM 封锁 |
| 制动 | 参考低侧斩波 MOS 与外接电阻结构；采用已选 UCC27517、独立 BRAKE 控制和一个 2P 电阻功率端子 |
| 辅助电源 / 接口 | 本项目仍为独立 12～24 V 辅助输入、inverter 向 controller 送 5 V；24 脚口按本项目脚序，独立制动和供电接口按已定分工 |
| 参考板以外的扩展 | 用户已明确首版预充/限浪涌和专用母线放电与 ATK 一样先不做；交流源输出 LC 及旁路边界仍需单独确定 |

先读 [对照笔记](../reference/ATK-PD6010B/design_notes.md)，再对照原图。重点参考三相桥、自举驱动、低端电流采样和硬件过流锁存；该板供电结构、采样刻度与 24 脚脚序均不直接适用于本工程，光耦也不能作为整板隔离的证明。PD6010B 独立手册、可编辑源工程与 BOM 尚待补齐；本项目已定规格、器件和接口继续以自身文档为准。
