leolei2012/power_system/docs/schematic_handoff.md

# 设计交接与旧分板资料

## 当前入口：Rev E（2026-11-07）

最小核与应用底板原理图已完成：子板7页47位号/3DNP，底板20页317位号/14DNP，双ERC0错误/0警告；64针、全部52信号pad及32768组静态保护/ARM逻辑检查通过。子板仅MCU及最小系统，SWD/TTL/ABZ/SPI/CAN/LED/ADC应用保护均在底板；PC7用于主动ARM。两个新PCB均未画；机械规划为两板60×60 mm轮廓对齐、上功率板下最小核，四角M2孔及板距待共同校核。下板顶面male朝上，上板底面female朝下；8.5 mm母座塑高不等于板距。

当前入口为 [最小核与底板](controller_daughterboard.md)、[G431工程](../controller/hardware/g431_core/README.md)、[功率底板](../inverter/hardware/README.md)及 [应用脚表](../inverter/docs/pin_assignment.md)。当前PDF为 [controller.pdf](../controller/hardware/g431_core/review/controller.pdf)和 [inverter.pdf](../inverter/hardware/review/inverter.pdf)。

**下文LKS、旧24脚接口、Rev C合板及40针Rev D均为历史，不是当前实施任务。** Rev E两组2×16与旧40针不兼容；前版 [Rev D整体归档](../inverter/history/daughterboard_rev_d_before_minimum_core_2026-11-07.zip)及更早资料仅用于追溯。后续以当前原生工程、64针合同及BOOT/SWD操作说明为准。

## 以下为历史正文

2026-11-05 架构变更：用户确定控制、驱动与逆变功率级合板，MCU 改为 **STM32G431**。当前依据见 [合板方案](integrated_board.md)。本文下方 LKS、独立 controller、24 脚板间接口及旧引脚/软件预算属于上一版记录；旧 KiCad/BOM/检查结果不代表新合板版本已完成。已确定每板一颗 MCU，分变频板与电源板，取消单 MCU 同时控制两路逆变和 PFC。LLC 在电源板恢复讨论，具体配置、接口和 MCU 完整后缀待评估。

## 旧版交付及电气分析参考

以下分板结构、LKS 引脚和集中控制任务已被新方案取代；电气目标与功率电路分析按合板方案逐项复用。

2026-11-01 原理图交付时复核公共库：本清单 19 种中 18 种已为 reviewed（包含 UCC27517、NCC 电解、国巨旁路），IRFS4227 尚待公共入库。下文早期“新增三种待建库”记录由此更新取代；详细符号/封装见 CSV。inverter 新增候选 D1、D2、小信号管、分流及未定电感/连接器见实际 BOM，不包含在这 19 种历史清单内。

更新：2026-11-01。本轮范围只包括 controller 控制板与 inverter 逆变功率板。PFC 功率板不在当前原理图任务内；controller 仍保留两路变频和一路 PFC 接口。LLC 暂停。

当前阶段用户明确只推进硬件设计，软件实现及母线软件欠压门限的讨论留待后续。保留已有软件控制方向与软硬件接口约定，作为引脚/电路需求；不在本阶段继续细化固件、线程时序或软件保护参数。母线欠压的数值尚未确认，不能采用对话中的未确认建议作定稿；硬件驱动 UVLO、供电监控、上电/掉电默认封锁及已定过流/过压保护继续落实。

用户明确 inverter 以 ATK-PD6010B V1.0 作为主要硬件参考，按其功能块和回路展开；本项目已选 MCU/器件、独立辅助供电、保护门限与接口做必要适配。具体模块对应见 [指定参考板](schematic_agent_task.md#指定参考板)。

2026-11-01 用户确定首版功率母线参照 ATK：取消独立预充/限浪涌及专用母线放电支路，原 47 Ω 预充电阻、旁路继电器与驱动撤出首版 BOM/原理图。不新增 inverter 预充 GPIO；PFC 预充资源保留。已有制动、输入防反接/TVS及独立辅助供电保护继续设计，不能将本决定扩展为取消这些功能。

通用贴片小阻容已统一采用 **YAGEO（国巨）**，覆盖 controller 与 inverter 的常规去耦、滤波、上下拉等；分流、功率电阻及大电解仍单独选型。母线高频旁路已定每板两只 2.2 µF/100 V/X7R/1210，并按品牌决定选 YAGEO CS1210KKX7R0BB225 / C5578983，替代此前村田候选及旧 3×250 V 薄膜草案。库及偏压/纹波/布局验证仍待完成。

结论：**controller 九页、inverter 十三页第一版 KiCad 原理图草稿均已建立；两板 PCB 尚未开始。** 原生工程、PDF、实际位号 BOM 和检查结果分别见 [controller](../controller/hardware/README.md) 与 [inverter](../inverter/hardware/README.md)。两工程默认 ERC 均为 0 错误、0 警告；inverter 与 controller 的接口及静态故障逻辑核对通过。inverter 电源外围与门级故障逻辑已展开，但选型、额定、热及动态保护尚未完成验证；最新实现和阻断项以 [Rev A 审查记录](../inverter/hardware/design_review.md)为准。下文为需求与待定项清单，历史“待设计”不再表示缺少原理图。

## 已确定的边界

- 一颗 LKS32MC451VCT8，同时控制两路逆变和一路预留 PFC。控制器采用 ThreadX 的方向已确定，线程和内存等具体数值为预算草案。
- 控制器保留两路 24 脚变频口、一路 24 脚 PFC 专用口、两路 A/B/Z、两路独立 SPI、两路制动、TTL、CAN、SWD；不设 USB、霍尔或 LLC 口。
- 第一版直流母线工作范围已确定为 **12～60 V**，**直流母线输入电流最大 10 A**；输入功率上限 120～600 W，随母线变化；输出相电流已定每相连续 10 A_rms，正弦峰值约 14.1 A；相电流硬件过流名义门限已定瞬时 ±20 A；短时过载、误差/延迟与额定输出功率待核算。旧 100 V / 80～120 V / 1 kW 指标不再沿用。
- inverter 三相桥 PWM 开关频率已定 **20 kHz**，周期 **50 µs**；死区仍需结合驱动及开关波形确定。该决定不冻结 PFC 或制动 PWM 频率。
- 2026-11-01 已确定母线硬件过压名义门限 **65 V**，由 inverter 本地硬件关断六路 PWM、锁存并拉低 FAULT_N；故障消除后通过 ENABLE 复位，电压恢复不自动重启。分压/基准误差、迟滞、响应和器件裕量仍需核对。
- 同日已确认直流母线电解首版暂用 **2×220 µF / 100 V 并联，共 440 µF**，选 NCC EKYB101ELL221MK25S / C1585673。仅作为首版试验配置，纹波、温升/寿命、实际母线应力及钳位配合仍需校核；库定义待建立，桥臂旁路单独设计。
- 同日已确认制动门限可配置：**60 V 工况按 62 V 开启、61 V 关闭（1 V 迟滞）作为名义设计目标**。其他供电工况门限另定；需核对实际电源输出容差、检测误差/纹波、总响应时间及制动耗能能力，尚不代表实际母线已能钳位于该范围。控制分工已确定为 controller 软件判断、BRAKE_1/2 输出、inverter 制动驱动执行，不另设自主电压门限制动控制；65 V 本地硬件过压锁存保留。快速采样/执行时序、PWM 频率及 MCU/采样故障策略待定，见 [软件规划](../controller/docs/software_resources.md)。
- 2026-11-01 已确认保护结构：inverter 本地比较器经逻辑汇总进入故障锁存，锁存同时控制六路 PWM 硬件封锁与开漏 FAULT_N 通知；保留 2ED2182S06F，封锁位于 HIN/LIN 前。对外只沿用 ENABLE 和 FAULT_N，不新增关断/复位脚。74LVC74A 为优先研究的锁存候选，具体门级实现及上下电/复位验证仍为绘图任务。
- inverter 的功率入口为 DC+ / DC−。可接实验直流电源，也可接以后自研模块的直流输出；运行时选择一种来源，输入需满足最终电气规格。
- 辅助供电与功率母线分开。第一阶段外部适配器供控制板和栅极驱动的辅助电，辅助输入目标 12～24 V，功率母线另接实验直流电源。本轮按板上 12 V 升降压、5 V Buck、两板各自 3.3 V LDO 结构推进。适配器容量、外围与热设计、隔离和接地仍待核对。
- 用户提出 controller 从 inverter 取辅助电：适配器先接 inverter，独立电源线再供 controller。当前按稳压 5 V 送 controller、本地 LDO 到 3.3 V 的结构选型与绘图，该入口不能接 24 V。电源分支不受电机 ENABLE 控制；两路 inverter 中先指定一路供电，不直接并联稳压输出。
- 主桥 MOS 已由用户确认改为 IRFS4227TRLPBF（TO-263 / D²PAK）六只；采用 200 V 等级、标称 12 V 栅极驱动，低端电流采样。制动功率管沿用同型号候选；2026-11-01 已确认每块 inverter 集成一路制动 MOS 及驱动、设置一个 2P 外接电阻端子，不再按只留空位不贴处理。电阻可不接，功率端子开路、禁止短接；驱动、电阻参数及门限具体实现待设计。
- controller 目录由原 control 更名。三路半桥驱动、自举电容、栅极电阻及六只 MOS 全部集成在 inverter 同一 PCB；controller 独立，板间通过 24 脚信号口连接。
- 2026-11-01 已确认制动低侧驱动为 **TI UCC27517DBVR，SOT-23-5，C99395**；每块 inverter 一颗，稳压 12 V 供电，BRAKE 3.3 V 高有效、输入默认下拉关闭。IN+ 接 BRAKE，IN− 接低；详细引脚与来源见选型文档，建库及外围验证待完成。
- 外接制动电阻以 **5.6 Ω、±5%、1 kW 等级**作用户接受的参考目标，用户允许详细设计后续进行；完整型号、散热和单次/重复制动能量待负载参数明确后核算，不作为已定采购物料或持续制动能力保证。板内先落实 MOS、驱动及 2P 端子，支路额定校核仍是原理图定稿要求。
- 选型及采购统一用立创商城国内站；技术依据使用厂家规格书与勘误。价格/库存不可读取则标待核实，不以其他商城替代。

## 阅读顺序与资料状态

| 资料 | 当前可用于什么 | 状态 |
| --- | --- | --- |
| [controller 接口](../controller/docs/connector.md) | 24 脚信号类别、方向与故障复位原则 | 功能草案；连接器未选 |
| [引脚草案 A](../controller/docs/pin_assignment.md) / [100 脚 CSV](../controller/hardware/LKS32MC451VCT8_pin_plan.csv) | MCU 网络名、编号、AF、模拟通道 | 静态核对通过；PFC 时序/采样窗口待验证 |
| [单芯片评估](../controller/docs/single_mcu_evaluation.md) | 数量、算力与待验证项 | 不代表三套闭环运行已验证 |
| [ThreadX 软件资源](../controller/docs/software_resources.md) | 线程、中断、CPU、内存与 DMA 预算 | 规划草案；无可编译工程 |
| [供电与参考地](../controller/docs/power_architecture.md) | 适配器/母线来源、12～24 V 输入与接地边界 | 输入范围为目标；容量/稳压/隔离待定 |
| [inverter 规格](../inverter/docs/spec.md) | 第一版 12～60 V 母线、直流输入最大 10 A | 每相连续 10 A_rms、瞬时 ±20 A 过流及 65 V 过压名义门限已定；误差、时延及额定输出功率待核算 |
| [inverter 电路草案](../inverter/hardware/design.md) | 功率级、采样、保护、驱动的候选结构 | 未冻结，需按本文修订项逐项审查 |
| [inverter 首轮选型](../inverter/docs/component_selection.md) | 有源器件、立创记录及所需电源电压 | 主桥、制动驱动、母线电解及国巨旁路已列选型；新增库与整板定型待完成 |
| [实际位号 BOM](../inverter/hardware/bom/bom.csv) | 对照十三页原理图的 214 条记录 | 设计 BOM；含 TBD，非采购发布；旧候选表已归档 |

controller MCU 已可在 `D:/workspace/kicad_library` 中找到规格书、MyParts:LKS32MC451VCT8、100 脚对照和验证工程；其库验证不等于应用电路验证。当前清单中的原有 15 种有源器件已在库中记录为 reviewed（资料、符号及封装核对，无实物验证）；新增 IRFS4227TRLPBF、UCC27517DBVR、EKYB101ELL221MK25S 与 CS1210KKX7R0BB225 待建库，MOS 不能套用原 IRFB4227PBF 的 TO-220 封装。旧直插物料保留在公共库。库引用见建库 CSV，应用电路仍待审查。该库的测试工程不是本项目原理图模板电路。

## Controller 定稿前缺口

1. 适配器输出电压/电流、容差和启动行为；各辅助电源的功耗预算、保护、稳压、分配和隔离方式。
2. controller GND 与每个功率端口参考地的关系，独立逆变试验与未来串联系统分别画出电源/信号隔离边界。非隔离 GPIO/ADC 跨参考地时不能仅接排线解决。
3. 3.3 V 负载、电源候选的外围/热设计、晶振频率/负载、上电复位和去耦；REF/LDO12 脚不能误当固定电源输入。
4. 24 脚连接器的具体型号、方向、防反插和封装；SPI/编码器的电平调理、供电和接插件；CAN 收发器候选 SN65HVD232 的端接、防护和供电默认态。
5. 25 路模拟输入的调理、保护、滤波和源阻抗，以及信号调理放在哪块板上。GPIO 的 5VT 不代表模拟输入允许 5 V。
6. 79 脚已安排、5 脚保留的预算下，新增板卡识别、CAN 待机、额外故障或温度反馈需要重排；不得擅自覆盖 SWD 保留脚。
7. PFC 通用 Timer 同步/更新和三套共享 ADC 的窗口尚未验证；只画预留接口不等于这些能力已验证。

## Inverter 定稿前缺口

1. 母线工作范围已定 12～60 V；直流母线输入电流最大 10 A 已确定，输入功率上限随母线为 120～600 W；输出相电流已定每相连续 10 A_rms；相电流硬件过流名义门限已定瞬时 ±20 A、母线硬件过压名义门限已定 65 V；短时过载、门限误差和时延、损耗及额定输出功率待核算。按新范围重新计算采样刻度、已定保护/制动门限的实现、尚未确定的欠压与其他供电工况制动门限及功率无源件；不沿用旧 1 kW 指标。
2. MOSFET、半桥驱动、放大器、比较器与逻辑已有完整后缀候选，其中新贴片 MOS 需完成建库，已有 reviewed 库物料可用于草稿；分流器及完整保护逻辑仍待定型。
3. 母线电解/旁路、熔断器、输入防护、制动功率件和输出 LC 的纹波、脉冲、热与故障额定值校核；功率母线预充及专用放电已确定首版不做。
4. 母线 TVS 与 MOSFET 裕量重新核对：旧候选 Littelfuse 5.0SMDJ150A 的 150 V 为反向工作电压，规格书最大钳位可到 243 V；不能将其作为已证明能保护 200 V MOSFET 的方案。该候选从冻结清单撤回，需重新设计吸收/钳位与开关过冲裕量。[厂家规格书](https://www.littelfuse.com/~/media/electronics/datasheets/tvs_diodes/littelfuse_tvs_diode_5_0smdj_datasheet.pdf.pdf)
5. 母线电解首版配置 440 µF，60 V 电解储能约 0.792 J、65 V 约 0.930 J。首版无独立预充/限浪涌和专用自动放电能力，应在实际实验电源与接线条件下核对上电瞬态，断电残压实测确认，不设固定自动放电时间承诺。旧 47 Ω/继电器/200 ms 方案不再属于首版。
6. 每相低端分流源极的驱动参考与公共辅助电源回路须完整画出；不能通过公共驱动/辅助回流跨接三个分流器。采样盲区、开关瞬态与短路保护要单独设计，不能以软件下次采样或母线熔断器代替快速保护。
7. 故障锁存需保证活动故障优先、ENABLE 默认封锁、清锁存仅在故障消除后允许；上电/欠压状态和最短复位时间要用完整电路证明。不设独立功率板 RESET_N。
8. TO-263 底部散热焊盘为漏极，按 DC+ 及各相开关节点分别布铜，禁止跨网络合并散热铜皮。设计铜皮、导热过孔及绝缘散热结构，热态导通和开关损耗需另外计算。
9. 每块 inverter 使用一路 24 脚接口，原两根 20 脚线、2×13 排针与固定 BOARD_ID 数值均不再作为当前要求。两路制动控制独立于这些端子，分别对应两块 inverter 上各一路制动功率电路；每块设一个 2P 外接电阻端子 BR+/BR_SW，功率端子与低压控制接口分开，接插件及驱动仍需选型。

## 建议交付顺序

按 [任务书](schematic_agent_task.md)开始草稿：先画 controller 最小系统、供电和已分配接口，同时展开 inverter 的电源、驱动、采样与保护功能页。已有 reviewed 库物料可以直接核对后引用；新 MOS 建库期间可推进其他部分。电源外围与保护逻辑作为绘图任务的设计工作补齐，影响母线额定、隔离域或板卡结构的决定列出依据与影响后再定稿。

原理图交付应同时包含：功能与供电框图、选型依据和原厂资料、带立创编号的可核对 BOM、已建库器件记录、KiCad 原理图、ERC 结果，以及未解决事项。电气审核通过后再进入 PCB；不以 ERC 零报错替代功率、电气额定和保护审查。

## 当前器件与资料交接

[器件清单](library_build_list.md)及 [CSV](library_build_list.csv)包含 19 种选型。新增贴片 IRFS4227TRLPBF、制动驱动 UCC27517DBVR、母线电解 EKYB101ELL221MK25S 与国巨旁路 CS1210KKX7R0BB225 待建库，其余原有 15 种均匹配到公共库 reviewed 记录及实际符号/封装文件；MCU 另有 reviewed 物料。库状态不等于整板或实物验证。

2ED2182S06FXUMA1 的国内商品页 C1850289 已补核。贴片 MOS 的原厂型号、200 V、26 mΩ 与 TO-263 封装已核对，C146578 来自 LCSC 全球商品记录，国内商品页与价格仍待补核；未沿用原直插 MOS 的 C2652、价格和封装。

开始绘图无需等所有阻容值讨论完，但定稿前必须完成上文缺口及任务书的电气审查。完整的可执行任务见 [Controller 和 Inverter 原理图任务书](schematic_agent_task.md)。
