leolei2012/power_system/controller/hardware/design_review.md

# Controller Rev A 设计审查记录

2026-11-05：本文为旧分板/集中控制方案的参考记录。当前按 [变频板与电源板各一颗 MCU](../../docs/integrated_board.md)推进，MCU 改为 STM32G431 方向，电源板 PFC＋LLC 恢复评估；本文旧引脚、资源数量和检查不能覆盖新版。

日期：2026-11-01。当前交付为九页 KiCad 原理图草稿，范围仅 controller。inverter 电路、固件与 PCB 不属于本次绘图交付。

## 已落实的电路

U1 使用现有 MyParts:LKS32MC451VCT8，四个单元合并为同一颗 LQFP100；全部 100 个编号逐项与 [引脚规划](LKS32MC451VCT8_pin_plan.csv) 对照。84 个 GPIO 中 79 个已有业务/系统用途，另外五个保留脚只接高阻测试焊盘。74/85 脚未当作电源，不加默认大电容；NC 5/29/60/72 悬空。

AVDD 14/42/71/92/93 全部接同一个 +3V3_MCU，每脚一只 100 nF，并另设 4.7 uF 局部储能；七个地脚全部接 GND。不以原理图上的 AGND 名字划出隔离域，不在 MCU 下方切断地平面。布局时仍需逐脚靠近去耦，控制功率和数字回流路径。

U2 为 TLV76733DRVR：6 脚 IN、4 脚 EN 接独立 +5V_CTRL；1 脚 OUT 与 2 脚 SNS 相接；3/5 脚 GND 与 7 脚 EP 接地。输入和输出各 10 uF + 100 nF；10 uF 暂用 0805、至少 16 V 的国巨 X7R/X5R，最终完整型号及偏压降容待核。厂家推荐输入至少 1 uF、输出有效电容最低 0.5 uF；本项目选料目标按有效容量至少 1 uF 复核。[TI TLV767 Rev D](https://www.ti.com/lit/ds/symlink/tlv767.pdf)

U3 为 TPS3808G33DBVR，监测 3.3 V，下降阈值名义 3.07 V；CT 有意悬空选择名义 20 ms 释放延时。开漏 RESET 接 MCU_NRST，10 kΩ 上拉。按键经 MR 请求复位，SWD NRST 可直接拉低 MCU_NRST；没有在 SWD 复位线上接大容量电容。[TI TPS3808 Rev N](https://www.ti.com/lit/ds/symlink/tps3808.pdf)

三路 24 脚口沿用 [端口定义](../docs/connector.md) 的脚序：每路六个地接触点；INV1/INV2 的 12、24 脚有意不连接；PFC 的 12、24 脚分别为下半母线反馈和预充控制。制动通过 J3/J5 单独引出，不经过 24 脚口，也不与 ENABLE 短接。全部功率板接口只有控制和反馈，不接功率母线或板间电源。

18 路 PWM 命令、三路 ENABLE、一路 PFC_PRECHARGE、两路 BRAKE 共 24 路均设 33 Ω 串联和 10 kΩ 默认下拉。MCU 复位高阻时由下拉保持低；功率板侧仍必须完成独立、默认关断的本地保护。本控制板未用 MCU 中断替代 inverter 硬件关断。三路开漏 FAULT_N 各有 4.7 kΩ 上拉和 100 Ω 串联，不加延时电容；接口断开时上拉为高，因此不具备断线检测。

25 路 ADC 分为 INV1 八路、INV2 八路、PFC 九路。每路预设 100 Ω + 1 nF，就近放在 MCU 侧；这是源阻抗及采样窗口验证前的起始值，不是已完成的过压保护或带宽设计。电流 1.65 V ±50 mV/A、电压 50:1 为 inverter 已有接口目标，PFC 刻度及 NTC 分压仍需功率板设计配合。

编码器暂按 A/B/Z/GND/VOPT 五脚，3.3 V 推挽单端，信号串 100 Ω、MCU 侧 100 kΩ 下拉。SPI 暂按 SCK/MOSI/MISO/CS_N/GND/VOPT 六脚，信号串 33 Ω、CS_N 10 kΩ 上拉。四路 VOPT 均通过默认 DNP 的 0 Ω 接 3.3 V，旁路也 DNP，初始装配不向外部传感器供电。此排列为绘图选择，未冻结用户尚未确定的传感器和连接器规格。

SWD 为 3V3/IO/CLK/GND/NRST；3V3 只作 VTREF，不默认从调试器给板供电。TTL 为 TX/RX/GND，无供电脚。CAN 用已建库 SN65HVD232DR，5/8 脚 NC、没有额外待机 GPIO；4 脚连接器暂排 CAN_H/CAN_L/GND/NC。CAN 全模块默认 DNP，通过两只 DNP 的 0 Ω 将 MCU TX/RX 与未装的收发器隔开。120 Ω 端接只在总线端点选装。[TI SN65HVD23x Rev O](https://www.ti.com/lit/ds/symlink/sn65hvd230.pdf)

五个 LED 为电源、RUN1、RUN2、FAULT、COMM；四个业务灯按原规划低有效，每灯 2.2 kΩ。LED 不是门极许可或故障锁存器。LED 完整型号、正向压降及低电流亮度仍待定。

## 时钟依据

本地原厂规格书：`D:/workspace/kicad_library/datasheets/LINKOSEMI_LKS32MC451VCT8_DS_v1.71.pdf`，印刷第 41 页 / PDF 第 42 页，第 8 章。该芯片外部晶体起振电路为 **12 MHz**，内置放大器与起振电容，因此 Y1 接 OSC_IN/OSC_OUT，没有照搬其他 MCU 的外接两只负载电容。

Y1 目前是 12 MHz、3225 四脚晶体的功能占位，完整晶体型号、CL 和 ESR 尚未冻结，不把搜索到的 20 pF 晶体直接当作兼容结论。厂家资料没有在本地规格书中给出足够的内部负载电容匹配参数，需补充官方应用电路/硬件指南或向厂商确认。Y1 的 1/3 为晶体端，2/4 为接地外壳端；最终料号必须核对该焊盘定义和起振裕量。

## 计算与当前设计假设

| 项目 | 计算 / 结果 | 限制 |
| --- | --- | --- |
| 3.3 V 初始负载预算 | 250 mA | 来源为原供电讨论；不是测量值，不含尚未启用的传感器功耗 |
| LDO 标称损耗 | (5−3.3)×0.25 = 0.425 W，另加静态损耗 | EP 必须有有效地铜散热 |
| 假设输入 5.25 V 时 | (5.25−3.3)×0.25 = 0.4875 W | 5 V ±5% 仅为角点计算假设，待 inverter 输出规格确认 |
| 参考热阻估算 | 厂家 DRV θJA 77.7 ℃/W；0.425 W 对应约 33 ℃ 温升 | 厂家测试板条件不等于本板，不能当作热验证结果 |
| ADC RC 时间常数 | 100 Ω×1 nF = 100 ns | 另计源阻抗、ADC 采样电容、通道切换及允许建立时间 |
| ADC RC 截止频率 | 1/(2πRC) ≈1.59 MHz | 不代表 2 MHz 连续转换已满足 14 位精度 |
| 一阶满量程阶跃至半 LSB | 14 位需要 ln(32768)×RC≈1.04 us | 只是简化参考，不直接等于 SAR 内部实际采样建立模型；需按采样窗口重算 |
| 33 Ω 与 10 kΩ 下拉的静态分压 | 3.3×10000/(10000+33)≈3.289 V | 还要叠加 MCU VOH、外部驱动 VIH、双端下拉、线缆和噪声裕量 |
| 故障上拉低态电流 | 3.3/4.7k≈0.70 mA | 核对功率板开漏输出灌电流、VOL 和未上电漏电 |
| LED 示例电流 | (3.3−1.6)/2.2k≈0.77 mA | 不同颜色 Vf 和实际亮度需选料验证 |

## 定稿前待解决事项

| 位置 | 尚缺内容及影响 | 草稿处理 |
| --- | --- | --- |
| J1~J13、SW1 | 完整型号、间距、方向、防反插、封装和采购编号 | 通用逻辑符号，连接器与按键封装为空；24 脚 0.5 mm 仅沿用原方向 |
| Y1 | 12 MHz 晶体与 LKS 内置负载匹配、ESR/驱动电平/温度及起振裕量 | 3225 功能占位，不默认采用任何已查到的晶体 |
| J7/J8 | 实际编码器供电、电平、推挽/开集/差分、频率和线缆 | 暂限 3.3 V 单端，VOPT 不装；其他类型需加对应接收器/电平调理 |
| J9/J10 | SPI 外设电流、电平、时钟速率和供电顺序 | 3.3 V，CS 上拉，可选供电不装，33 Ω 初值 |
| 25 路 ADC | 完整源阻抗/量程、抗混叠及采样建立、正负过压和失电注入保护 | RC 初值，不将 MCU 内部钳位或 5VT 字样当成已设计的外部保护 |
| 三路功率口 | 各参考域与隔离位置、共模误差、上下电反灌及连线容限 | 非隔离同参考地实验草稿；不同功率参考域不能直接接线 |
| CAN、外接调试及传感器口 | 外部 ESD/浪涌等级、TVS 钳位、终端和接地 | 未虚构防护等级；CAN 默认 DNP，保护按实际外接环境补设计 |
| U2 与上游 5 V | 负载预算、压降、启动、下游电容/偏压、EP 热设计和输入分支保护 | U2 外围已连通；上游保护仍由 inverter 完成 |
| R1~R123、C1~C41、D1~D5 | 国巨阻容及 LED 完整型号、立创 C 编号、允许误差/功率/偏压 | BOM 明确 TBD，未把通用符号当成公共库 reviewed 具体料 |
| PFC / MCPWM / ADC | 六路门极关系、公共时序、触发/采样窗口、FAIL 对制动的影响 | 保留既有引脚资源，不宣称单 MCU 全部同时闭环已验证 |

未确定事项保留在图面、BOM 与本表，不通过 ERC 排除或批量 NC 标记掩盖。已放 NC 的只有真正未用的封装/连接器脚，以及按规格书有意悬空的 U3 CT。

## 核对结果与复查方法

KiCad 10.0.7 已成功加载九页层级工程、导出 PDF 和原生 XML 网表。ERC 默认规则为 0 错误、0 警告；未新增自定义忽略项。另用独立于图面生成器的核对脚本检查原始引脚 CSV 的全部 100 脚、50 条 24 脚口信号路径、25 个 ADC RC、24 路默认下拉、三路 FAULT、五个保留点、SWD/TTL/ABZ/SPI/CAN 和实际 BOM，全部通过。DNP 默认装配状态另行核对，因为 ERC 的连线分析仍包含 DNP 器件。

复查命令（在本目录，kicad-cli 使用安装目录中的可执行文件）：

```powershell
& 'C:/Program Files/KiCad/10.0/bin/kicad-cli.exe' sch export netlist controller.kicad_sch --format kicadxml -o review/controller.net.xml
python tools/verify_controller.py
& 'C:/Program Files/KiCad/10.0/bin/kicad-cli.exe' sch erc controller.kicad_sch -o review/erc.rpt --exit-code-violations
& 'C:/Program Files/KiCad/10.0/bin/kicad-cli.exe' sch export pdf controller.kicad_sch -o review/controller.pdf
```

这些结果验证静态网络和文件，不验证模拟性能、上电安全时序、抗扰度、热、实物装配或软件实时性。完成上述硬件待定项并审查后再转 PCB。
