leolei2012/power_system/inverter/docs/spec.md

# 逆变器规格

2026-11-06 Rev D：变频器由一颗STM32G431RBT6控制一套三相桥和一路制动，物理上拆成8页MCU子板与16页功率底板，两组2×10排针连接。新PCB尚未设计，底板目标60×60 mm。PFC/LLC电源板暂停绘图；当前图纸及未定项见[硬件入口](../hardware/README.md)和[审查记录](../hardware/design_review.md)。

第一版目标：实验室可用的低压三相逆变，先把功率级和控制跑通。

2026-10-31 用户确定第一版直流母线工作范围为 **12～60 V**，**直流母线输入电流最大 10 A**。输入功率上限按 V_dc×10 A 计算，12 V 时 120 W，60 V 时 600 W；交流有功输出扣除损耗。输出相电流已确定为每相连续 10 A_rms，正弦峰值约 14.1 A；相电流硬件过流名义门限已定瞬时 ±20 A；PWM 纹波、检测误差及关断延迟、短时过载与额定输出功率仍需核算。两项电流限制须同时满足，不保证最高输出电压与最大相电流同时可用。旧 100 V / 80～120 V / 1 kW 工作点不再作为第一版设计指标。辅助电源仍单独按 12～24 V 规划。

## 电气

| 参数 | 符号 | 值 | 备注 |
|---|---|----|---|
| 直流母线工作范围 | V_dc | **12～60 V DC** | 用户已确认；标称测试点另定 |
| 直流母线输入电流上限 | I_dc,max | **10 A** | 用户已确认电流定义；持续/短时条件待定 |
| 连续输出相电流上限 | I_phase,rms | **每相 10 A_rms** | 用户已确认；受直流输入电流及功率约束 |
| 正弦相电流峰值 | I_phase,pk | **约 14.1 A** | 10 A_rms×√2；另计 PWM 纹波，不等于故障关断门限 |
| 相电流硬件过流名义门限 | I_trip | **瞬时 ±20 A** | 用户已确认；检测到越限后硬件关断并锁存，误差与总延迟待校核 |
| 母线硬件过压名义门限 | V_trip | **65 V** | 2026-11-01 用户确认；本地硬件关断六路 PWM 并锁存，FAULT_N 拉低；误差与制动配合待校核 |
| 直流母线电解电容配置 | C_dc | **2×220 µF / 100 V，并联共 440 µF** | 2026-11-01 用户确定首版暂用配置，参照 ATK；选型 EKYB101ELL221MK25S，纹波/温升及完整工况待验证；不改变母线 12～60 V 工作范围 |
| 制动开启名义门限（60 V 工况） | V_brake,on | **62 V** | 2026-11-01 用户确认设计目标；按实验母线配置，误差及动态响应待校核 |
| 制动关闭名义门限（60 V 工况） | V_brake,off | **61 V** | 对应 1 V 名义迟滞；其他供电工况的具体门限另定 |
| 输出线电压 | V_ll | 随母线与调制方式变化 | 不再沿用旧 60 V_rms 输出指标 |
| 输出频率 | f | 0～100 Hz 候选 | 交流源默认 50 Hz，仍待定稿 |
| 直流输入功率上限 | P_dc,max | V_dc×10 A；最大 600 W@60 V | 12 V 时上限 120 W；不含独立辅助输入 |
| 额定输出功率 | P_out | 待工况及损耗核算 | 不再沿用旧 1 kW 指标 |
| 三相桥 PWM 开关频率 | f_sw | **20 kHz** | 用户已确认；周期 50 µs；PFC 和制动频率另定 |
| 死区 | t_d | 1 µs 旧仿真候选 | 与最终驱动及波形共同核对 |

理想 SVPWM 线性区下，线电压有效值最大约为 \(V_{dc}/\sqrt{2}\)。60 V 母线对应约 42.4 V_rms，12 V 母线对应约 8.5 V_rms；实际还要计入死区及器件压降。旧草案 60 V_rms 输出要求已撤回。

当前电路见 [Rev C 审查](../hardware/design_review.md)和[PCB0.2说明](../hardware/PCB_REVIEW.md)；[早期电路讨论](../hardware/design.md)只作历史参考。

## 拓扑

- 三相两电平桥：6 只150 V BSC110N15NS5 TDSON-8贴片MOS；另一路制动同款，完整订货码BSC110N15NS5ATMA1，应用及热待验证
- 三颗半桥驱动、自举、栅极电阻、G431 与采样保护集成在 inverter 同一 PCB，不另设 controller 板
- 母线电解电容首版暂用 2×220 µF / 100 V 并联，共 440 µF；按用户决定，功率入口经输入防护直接供电，不设置独立预充/限浪涌电路或专用母线放电支路。制动电路保留，纹波/热额定及完整工况待验证
- 母线高频旁路已定每块两只 2.2 µF / 100 V / X7R / 1210，采用 YAGEO CS1210KKX7R0BB225 / C5578983；贴近功率桥并联于 DC+/DC−，实际偏压容量、纹波与布局待核
- 每块 inverter 集成一路制动 MOS 及驱动，一组2P、6 mm间距焊线孔接板外制动电阻；每板独立控制；制动由本板 MCU 的 TIM8 控制，不再有板间命令接口。电阻可不接，不用时端子开路、禁止短接；参考 5.6 Ω/±5%/1 kW，能量和热待核。制动门限可配置，60 V 工况名义目标为 62 V 开启、61 V 关闭
- 当前 U/V/W 为原始桥 PWM，未装输出 LC；旧 470 µH+10 µF 仅历史候选，交流源滤波与阻尼需另定

## 控制模式

2026-11-01 已确认制动驱动器为 **TI UCC27517DBVR（SOT-23-5，C99395）**，每块 inverter 一颗，接已有稳压 12 V。BRAKE 3.3 V 高有效、默认下拉关闭，外围已画入原理图；实际动态/栅压仍待验证，见 [本版审查](../hardware/design_review.md)。

| 模式 | 控制目标 | 第一版算法 |
|---|---|---|
| 交流源 | 三相电压跟踪给定 V、f | 开环 SVPWM，再加电压闭环 |
| 电机 | 转速 / 转矩 | 先 V/f，再 FOC |

两种模式共用 PWM、采样和保护。

## 保护（第一版）

- 2026-11-01 用户确认保护结构：inverter 本地比较检测→故障汇总与锁存→硬件封锁六路驱动命令，同时经开集电极 FAULT_N 通知本板 MCU 并接 TIM1_BKIN。沿用 2ED2182S06F，在 HIN/LIN 前封锁六路 PWM；ENABLE 与 FAULT_N 为板内网络，不增加独立故障复位脚。具体门级实现、上电/掉电状态及总关断时间仍须验证，详见 [当前保护结构](../hardware/design_review.md#MCU-与板内控制)。
- 母线硬件过压名义门限：**65 V**，2026-11-01 用户确认。inverter 本地比较器触发后硬件关断六路 PWM 并锁存，FAULT_N 拉低；电压恢复不自动重启，故障消除后通过 ENABLE 明确复位。分压比例、基准及检测总误差、纹波、响应时间和母线器件耐压需校核；过压关断不代替再生能量处理。旧 130 V 值作废。
- 制动开启/关闭门限：**可按实验母线配置；60 V 工况名义目标为上升至 62 V 开启、下降至 61 V 关闭，1 V 迟滞**，2026-11-01 用户确认。12/24/48 V 等其他工况具体值另定，不统一等待 62 V 才制动。配置须使关闭门限高于实际电源输出上限并计入检测误差/纹波，开启门限与 65 V 硬件过压之间需保留误差和动态升压裕量。采样/执行延迟、母线电容及制动耗能能力待校核，不把名义门限当作已验证钳位能力。
- 制动控制分工同日已确认：**本板 MCU 根据本路母线电压控制独立 BRAKE，不另设自主电压门限制动控制**；65 V 硬件过压及瞬时 ±20 A 硬件过流锁存独立保留。制动判断纳入快速采样/控制路径，不等待 ThreadX 1 ms 线程检查；具体采样/执行时序、输出方式、PWM 频率、MCU/采样故障行为仍需验证。
- 相电流硬件过流名义门限：**瞬时 ±20 A**（不是有效值），用户已确认。任一相检测超过正/负门限，硬件封锁六路 PWM 并锁存，FAULT_N 拉低；故障消除后仍需显式复位/重新使能，不自动重启。
- 保护实现需计入约 14.1 A 正弦峰值之外的 PWM 纹波，以及全链误差、滤波/放大/比较/锁存/驱动延迟和故障能量。候选 5 mΩ、增益 10、1.65 V 偏置下名义阈值为 0.65/2.65 V；低端分流存在检测盲区，门限确定不等于短路保护已验证。母线输入 10 A 限制另行落实。
- 上下管互锁在驱动芯片内；PWM 还要和硬件使能相与
- 母线欠压由软件处理，数值门限、滤波及恢复策略留待软件阶段确定；当前用户只推进硬件，不将未确认的软件欠压建议作为规格。硬件保留母线采样、驱动供电 UVLO、供电监控及上电/掉电默认封锁；驱动供电欠压与功率母线欠压是不同检测对象。

## 当前外部接口

旧 24 脚控制排线已取消；PWM、ENABLE、FAULT_N、八路采样及制动命令均为板内网络。详细脚号与资源见 [G431 引脚说明](pin_assignment.md)。

| 接口 | 位号 | 说明 |
| --- | --- | --- |
| 功率母线 | J3 | DC+ / DC−，12～60 V，直流输入最大 10 A |
| 三相输出 | J4 | U/V/W 原始 PWM |
| 辅助输入 | J2 | 独立 12～24 V，回路参考按本板设计 |
| 外接制动电阻 | J5 | VBUS/BR_SW，非 DC+/DC−；不用时开路 |
| 外接 NTC | J8 | TEMP_NTC/GND，10 kΩ基准配置，具体热敏电阻待选 |
| 两路 ABZ | J9/J10 | 3.3 V 单端；可选供电连接默认 DNP |
| 两路 SPI | J11/J12 | 独立 SPI1/SPI3，3.3 V；可选供电连接默认 DNP |
| SWD | J13 | VTREF/SWDIO/SWCLK/GND/NRST；VTREF 只作检测 |
| TTL 串口 | J14 | 本板 TX/RX/GND，3.3 V |
| 可选经典 CAN | J15 | H/L/GND；整物理层默认 DNP，端点终端另配置 |
| 可选传感器电源 | J7 | 5 V/GND，默认 DNP；全支路总目标 0.5 A |

连接器完整型号、封装、电流及电平/ESD防护尚未定稿。5 V 传感器供电不代表信号接口支持 5 V。没有 USB、霍尔、外部 PFC/LLC 控制口或 BOARD_ID。
