leolei2012/power_system/reference/ATK-PD6010B/design_notes.md

# ATK-PD6010B V1.0 原理图对照笔记

更新：2026-10-31。依据 [原始 PDF](original/github/ATK-PD6010B_V1.0.pdf)，标题栏 V1.0、2021/12/24、`lycreturn@ALIENTEK`。文件来自第三方 GitHub 仓库，来源和校验记录见 [README](README.md)。两页已渲染查看，文字提取见 [extracted](extracted/ATK-PD6010B_V1.0.txt)。以下仅为读图记录，不修改本项目的已定规格或选型。

## 分页

| 页码 | 图纸名 | 内容 |
| --- | --- | --- |
| 1 | MOTER.SchDoc | 三相桥、栅极驱动、电流采样、比较器与过流关断 |
| 2 | POWER&CON.SchDoc | 电源、板间接口、电压/温度采样、霍尔/编码器相关接口、制动 |

## 可参考的结构与差异

| 项目 | 参考板图纸所示 | 本工程对照要求 |
| --- | --- | --- |
| 三相桥及驱动（第 1 页） | 3 颗 IR2110SPBF、6 只 IRFS3607PBF，六路 PWM 经 TLP2355(TPL) 光耦进入驱动 | 参考自举和栅极回路组织；本工程仍按 2ED2182S06FXUMA1 与 IRFS4227TRLPBF 选型设计，不直接替换 |
| 电流采样（第 1 页） | 三路低端 20 mΩ 分流，TP2412-VR 放大；图中注明 `Vout = 6 × 0.02Ω × I + 1.25V` | 本工程候选 5 mΩ、INA241A1 增益 10、1.65 V 偏置，刻度不同；采样窗口、误差及低端分流盲区需独立检查 |
| 硬件保护（第 1 页） | LMV393TP-VR 比较器与 OC_OUT；注释通过 R70 装配选项选择锁存或逐周期保护，锁存由 CTRL_SD=0 清除 | 可参考硬件先关断的路径；本工程仍采用瞬时 ±20 A 名义门限及锁存，不照搬参考板门限。活动故障优先、禁止自动重启的逻辑需完整验证 |
| 辅助供电（第 2 页） | 从功率输入派生 VCC11、VCC5、3.3 V，图中器件为 TX4139、RY3825、ME6217C33M5G | 本工程辅助 12～24 V 独立输入；驱动 12 V、5 V 和本地 3.3 V 按已定拓扑计算，不能将参考板母线取电结构直接复制 |
| 板间连接（第 2 页） | CN3 为 2×12，含 PWM、关断、采样及编码器/霍尔相关信号，也包含 5V_IN | 同为 24 脚不代表兼容。本工程 24 脚仅作信号连接，controller 5 V/GND 用独立供电线，按自身 connector 文档执行 |
| 制动（第 2 页） | HSU0048 功率管、S8050 与 EL357N 驱动，外接电阻接口 | 可参考斩波结构；本工程制动电阻能量、门限、位置与驱动仍需单独确定 |
| 隔离与参考地（两页） | PWM 光耦两侧在图纸中使用相同 GND 网络 | 不能据“有光耦”推断整板电气隔离；按完整供电、地和其他跨接信号判断隔离边界 |

## 使用边界

### 2026-11-01：直流入口、预充与母线放电

两页图纸所示主路径为 CN1 的 VIN → 并联的 D17/D18（SS510）→ POWER → 三相桥及 C12/C42 母线电解，GND 为回流。串联肖特基支路用于正向供电并阻止该支路反向导通，提供输入反接/倒灌方向的阻断；不能据并联数量就保证持续电流或均流能力。

VD9（SMAJ60CA）接在 VIN 与 GND 之间作瞬态抑制。POWER 另经 L3（47 µH）及 C70/C73/C74 输入滤波进入 TX4139 辅助降压，L3 位于辅助电源支路，并未串在三相桥主供电回路中；R98（30 mΩ）为 TX4139 的 ILIM 相关元件，不能误当母线预充电阻。

图内未见主母线独立串联的预充电阻、NTC 限浪涌器件、继电器旁路或专用主动软启动，也未见独立输入熔断器符号。此结论仅针对已取得的 V1.0 两页板内原理图，不推断外部电源/线缆上没有相关设施，亦不说明允许任意带电插拔。

两页内也未见专用母线泄放电阻或自动断电放电开关。POWER 的电压采样分压与辅助电源负载可以消耗部分储能，但图纸未定义可保证的断电放电时间；制动电阻支路需外接电阻并由 R_BREAK 控制，不能默认自动承担断电放电。

本项目早期 47 Ω＋旁路继电器的预充方案属于额外草案候选，不是照搬 ATK 的既有电路。2026-11-01 用户已明确首版跟随 ATK 的简化入口，先不做独立预充/限浪涌和专用母线放电，旧预充电阻、继电器与驱动从首版移除；输入防反接/TVS、已有制动和独立辅助供电保护仍保留设计。

### 2026-11-01：主母线电容核对

第 1 页 C12、C42 均为 **220 µF / 100 V 电解电容**，并接在 POWER 与 GND 之间，主母线电解合计 **440 µF**；C9、C45 各为 2.2 µF / 100 V 的并联小容量旁路，图纸本身未明确其介质。不能将各驱动的自举或 11 V/5 V 去耦电容累计到主母线电解容量中。

第 2 页 C70（47 µF / 100 V）位于 L3 后的辅助降压输入滤波节点，不能直接当作三相桥端 POWER 母线的并联主储能电容。ATK 的 440 µF 是参考配置，不证明本项目每相连续 10 A_rms 和全部输出/线缆/回馈工况下同样够用。

### 2026-11-01：过流与过压实现核对

第 1 页过流路径为：R17/R57/R86（各 20 mΩ）→ U4A/U5A/U7A（TP2412-VR，增益 6、1.25 V 偏置）→ U8A/U11A/U12A（LMV393TP-VR，与约 2.5 V 基准比较）→ 共用低有效 OC_OUT → Q7（SI2302）、U9（BC847PN）及 OC7（EL357N）→ SD_IN → 三颗 IR2110 的 SD。任何一路过流拉低 OC_OUT，Q7 截止使 OC7 熄灭，R64 将 SD_IN 拉高，三颗驱动关断。故障灯 OC_LED 同时由该故障网络指示。

R67/R76/R89（510 kΩ）与各 10 kΩ 基准输入电阻形成正反馈迟滞，图注给出约 64 mV、折合约 0.51 A 的迟滞量，不能当作整链精度。比较器为每相一个正向上限比较通道，并非本工程正负双向窗口。按图中采样刻度，门限约在 10 A 量级，具体上下翻转点受迟滞及误差影响。

R70 装配时，U9 的互补双三极管及外围形成自锁；故障消失后 OC_OUT 仍保持低，直到 CTRL_SD 拉低清锁存。R70 不装配时取消这一持续锁存，图注称“周期保护”，过流信号解除后可恢复；不能据此推断全链路具有精确的逐 PWM 周期限流时序。

第 1 页 U8B/U11B/U12B 为反电动势过零检测，不是母线过压比较器。第 2 页 POWER 经 R112/R113/R118（12 kΩ + 12 kΩ 对 1 kΩ，约 25:1）分压、U17A（LMV358B-VR）缓冲后输出 VBUS 到控制接口。两页内未见 VBUS 送独立比较器再触发 SD_IN 的母线过压锁存通路，因此不能称此版本驱动板具有与过流同样的独立硬件过压关断。是否在外接控制器内部比较器或固件中实现，尚未核对。

第 2 页 VD9（SMAJ60CA）是输入瞬态抑制，VD7/VD8 为低压电源轨 TVS；它们不是精确过压锁存比较器。制动的 OC8、Q10、Q8 和外接电阻由 R_BREAK 输入控制，图内未见自主母线阈值比较器。其控制策略需查配套控制器资料/程序。

本工程仍保留独立母线过压比较器，与正负过流窗口汇总后进入硬件锁存及 PWM 封锁；已确定的 65 V、瞬时 ±20 A 名义门限不沿用 ATK 参数。TLV3202 为推挽输出，不照抄 ATK 的 OC_OUT 并接方式。

参考板的产品名称和电流宣传不能证明本工程 12～60 V、母线最大 10 A、每相连续 10 A_rms、20 kHz 和瞬时 ±20 A 保护组合已经成立。功率器件额定、热设计、保护误差与关断延迟均按 [inverter 规格](../../inverter/docs/spec.md)及实际器件资料验证。

DMG474 的 6 页原理图与 38 页硬件手册是配套控制板资料，本轮仅确认可读取与页数，未做逐页电气审查。PD6010B 独立用户手册、可编辑 SchDoc/PCB 源工程及 BOM 未取得。
