leolei2012/power_system/controller/hardware/g431_core/PCB_REVIEW.md

# Rev E G431最小核PCB审查稿

当前原生板为 [controller.kicad_pcb](controller.kicad_pcb)，从本轮47件原理图的实际XML建立，另加4个板级安装孔。全部233个符号物理引脚对应真实封装焊盘；Y1、C83、C84三项DNP保留。PCB使用的通用封装不代表剩余26个位号的采购型号已经确定。

两板共用 [机械合同](../../../docs/pcb_stack_contract_rev_e.json)：轮廓为60×60 mm，当前坐标范围为(100,100)～(160,160)；四角M2孔为2.2 mm NPTH，孔心(104,104)、(156,104)、(104,156)、(156,156)，各保留半径2.8 mm的铜净空。两组公头均位于控制板顶面，64个同号焊盘坐标与上层功率板配对。四层、1.6 mm及1 oz铜厚为本轮候选，板间支撑高度和实际插合仍须验证。

MCU和两键在顶面，C65/C67/C81/R122/R402安排在背面。RESET、BOOT靠底边，操作面朝上，从叠板侧面伸入后向下按，必须留出同时按住BOOT并操作RESET的空间。上层功率板的按键操作预留区、支柱和线束须共同检查，当前尚无实物装配验证。

## 布线与检查状态

已完成MCU与去耦、VDDA/VREF、可选HSE、LDO及监控/ARM的局部连线，再以本地路由器补普通GPIO。In1为GND参考面，In2为3.3 V供电面，普通信号仅在F/In2/B布线；全部走线保持不小于0.15 mm，通孔过孔采用0.6/0.3 mm，电气铜间距不小于0.15 mm。关键局部线先锁定，必要调整会保留网络关系并记录。

2026-11-11最终保存板已填铜，共1041段线、95个过孔，原生连通检查与CLI均为0项未连接，电气/几何DRC错误为0。独立重新加载检查通过47个位号、233个物理pin、3项DNP及全部64个排针触点，courtyard碰撞和器件出界均为0。实际结果见 [最终跨板报告](../../../outputs/pcb_review_2026-11-11/system_check.json)和 [当前原生DRC](../../../outputs/pcb_review_2026-11-11/controller_drc.json)。收尾另加3.0mm安装孔铺铜避让并重填铜复核2.8mm最小净空；走线、过孔和元件位置保持本段统计。

最后局部调整包括C79原位旋转以保留VREF去耦与MCU地返回、VBAT改为直接接本地3.3 V馈入、C67背面焊盘接同网过孔，以及PC13单独逃线。冗余悬空短枝和单层无用途过孔已清理；没有移动64针排针或四孔。自动路由曾产生的107段细线均恢复至0.15 mm下限并重新检查间距，没有降低制造规则。

15条原理图一致性警告均为KiCad 10保留字段`ki_fp_filters`未保存在PCB用户字段中。实际Value、FPID、DNP和逐焊盘网络独立核对通过；没有通过改原理图或排除规则隐藏这些警告。另有9条丝印警告（5条丝印覆盖铜、4条文字重叠），须在生产发布前整理；最终报告没有悬空走线或过孔警告。

HSE两脚同时引出至GPIO排针；安装晶体时必须把该分支寄生计入CL和启动验证。去耦回路、参考电源噪声、TL431稳定性及断电/注入动态仍须样机验证。共地结构不能保证功率器件损坏后MCU存活。

## 文件与复核工具

- [PCB独立检查](review/pcb_2026-11-11/pcb_check.json)：重新加载保存板，核对47个位号、233个物理pin、DNP、64触点、四孔、轮廓、courtyard及真实3D路径。
- [本轮布线记录](review/pcb_2026-11-11/)：初始/局部/路由DRC、固定短回路、线宽修正及最后补丁。旧阶段DRC仅用于追溯，不能代替最终保存板检查。
- [布线保存记录](review/pcb_2026-11-11/final_state.json)：铺铜余量收尾前的PCB哈希、布线统计和最后局部改动来源；当前源哈希以最终跨板报告为准。[before_final_merge.kicad_pcb](review/pcb_2026-11-11/before_final_merge.kicad_pcb)保留最后两项未连接时的快照。
- [建板工具](tools/build_core_pcb_2026_11_11.py)、[局部短回路工具](tools/seed_core_routes_2026_11_11.py)、[本地路由接口](tools/route_core_pcb_2026_11_11.py)、[局部逃线工具](tools/fanout_core_gpio_2026_11_11.py)。这些是本轮作者记录，不应重跑覆盖人工修改后的板。
- [只读PCB校验](tools/verify_core_pcb_2026_11_11.py)可在最终填铜保存后重跑，`--require-connected`要求零未连接，`--drc`指定同一保存版本的原生DRC JSON。
- 原项目文件备份为 [rev_e_before_pcb_2026-11-11.zip](history/rev_e_before_pcb_2026-11-11.zip)。原理图及公共库在PCB阶段未修改。

共享STEP路径只在板实例上改为指向相邻公共库，保存后已重新加载核对。两键没有借用其它型号的3D模型；布局预览不能代替厂家机械图或实际插合验证。本版不提供生产Gerber、钻孔或装配发布包。
