leolei2012/power_system/inverter/hardware/review/pcb_control_review.md

# 控制、采样与保护区 PCB 首稿审查

历史范围：本文为200×140 mm四层PCB0.1的审查记录，坐标、器件封装和检查结论仅对应 [改板前归档](../../history/pcb_0_1_200x140_before_60mm_2026-11-06.zip)。当前60×60 mm六层PCB0.2正在重新布线，见 [现行板级审查](../PCB_REVIEW.md)，不得把本文作为当前布局或验证结果。

本报告检查原生 `inverter.kicad_pcb` 的实际 footprint/pad 坐标、网络与最初功率铜，并查看 `pcb_top.png`。审查基线 SHA256：`08d3f9571eb73bf8e4544930046115f0714341367e12dea62201dca9a22d5da2`。该快照包含313个电路器件及4个安装孔、126条铜线段、40个过孔、6个已填充铜区；线段集中在母线、相线、SOURCE、功率回流和栅极电阻到MOS栅极，控制/ADC/去耦回路尚未完成。下面距离均为实际焊盘中心的欧氏直线距离，除特别注明外不是已布线路径长度。

已输出独立候选 `tools/pcb_control_refinements.json`，本审查未修改PCB、原理图或工程设置。候选48件与当前317个footprint的courtyard一起检查，未出现新courtyard重叠；四组指定的母线电容过孔阵列中心另留0.7mm半宽避让。根代理导入及布线后需重做实际DRC。

## 本稿已给出可直接应用的局部修正

### 三相分流与硬件过流前端

|通道|原 IN+→RS高端 / IN−→RS低端|候选两路距离|原 INA OUT→比较器输入|候选距离|
|---|---:|---:|---:|---:|
|U10 / RS1 / U18|16.519 / 10.364 mm|5.961 / 5.961 mm|61.786 mm|10.032 mm|
|U11 / RS2 / U19|17.072 / 11.020 mm|5.961 / 5.961 mm|62.968 mm|10.032 mm|
|U12 / RS3 / U20|17.271 / 11.387 mm|5.961 / 5.961 mm|81.298 mm|11.547 mm|

实际RS1/2/3中心在(119.35/143.35/167.35,71)，高端pad1位于y68.0375、低端pad2位于y73.9625。候选INA中心改为(126/150/174,71)、旋转90°，使pin8 IN+和pin1 IN−朝向分流器。比较器及各自去耦跟随前端，六只过流阈值电阻也移到中间安静区，避免以很长的参考线代替原本很长的电流信号线。TI明确要求放大器输入以独立Kelvin连接接到分流器，布局不能只看同网连通。[INA241 Rev D §8.4](https://www.ti.com/lit/ds/symlink/ina241a.pdf)

原W相INA U12中心(177,82.5)贴近制动MOS Q7：Q7的BR_SW大漏极pad2中心(177.5,90)、尺寸9.4×10.8mm；U12 OUT pad5中心(178.1375,83.475)，其焊盘边到该开关漏极焊盘顶边仅约0.875mm。候选把U12移到y71，直接消除这处模拟输出邻接开关铜的问题。此距离问题即使不触发间距DRC也值得先修。

### 八路ADC滤波电容靠近对应实际引脚

|电容 / ADC|原cap pad1→MCU pad|候选距离|
|---|---:|---:|
|C69 / U30.8|9.788 mm|4.016 mm|
|C70 / U30.9|9.381 mm|4.934 mm|
|C71 / U30.10|10.593 mm|2.689 mm|
|C72 / U30.11|12.977 mm|4.907 mm|
|C73 / U30.18|3.516 mm|3.516 mm|
|C74 / U30.24|6.780 mm|4.203 mm|
|C75 / U30.25|10.534 mm|3.559 mm|
|C76 / U30.26|12.139 mm|2.410 mm|

网络事实为R84..R91 pad2、对应C69..C76 pad1及相应MCU ADC pad共网，电容pad2接GND。候选优先缩短电容后的ADC节点；HSE晶体及负载电容稍向右下让位，C63/C67、NRST支路与两只SPI串阻仅做局部微移。这里的5mm是本稿优化目标，不是芯片规格书规定的合格界限；最终要看电容到ADC的真实路径、回流与采样稳定时间。

## 布线阶段仍应完成的本地连接

### MCU与模拟参考去耦

|器件|实际目标|当前pad中心直线距离|
|---|---|---:|
|C63|VDD pin16|2.051 mm（候选为让ADC空间小幅外移）|
|C64|VDD pin32|3.843 mm|
|C65|VDD pin48|2.065 mm|
|C66|VDD pin64|2.658 mm|
|C67|VBAT pin1|2.065 mm（候选小幅下移）|
|C77|VDDA pin29|3.093 mm|
|C79|VREF+ pin28|2.562 mm|

C79的GND pad2当前在(65.5,38.225)，U30 VSSA pin27在(65.75,42.325)，两者直线4.108mm；现有电容朝向使其地端背向MCU。布线时应优先把C79/C80的回路直接收在VREF+与VSSA附近，避免自动路由分别接到很远的同名GND节点后绕回。可试把C79改为水平放置再检查courtyard和两根局部短线；该额外建议没有包含在48件候选中。ST要求参考去耦以尽量小的寄生回路连接VREF+与VSSA，不能只依据电源网名判定完成。[AN5346 §2.5.1](https://www.st.com/resource/en/application_note/an5346-stm32g4-adc-use-tips-and-recommendations-stmicroelectronics.pdf)

所有VDD去耦及对应地返回需先于普通信号布线固定。C64与pin32之间比其他VDD去耦更远，可在不挤占VDDA/VREF区的前提下收紧。C17已随U6移动，C17.pad1→U6.VDD pin6约2.32mm，属于本地去耦；NRST原C81→U30.7为7.999mm、U6.1→U30.7为14.487mm，候选为ADC让位后仍需把这条复位网作为敏感输入检查实际绕行。ST的电源布局建议强调去耦及供电/地连接的低阻抗和小回路。[AN5093 §7.3–7.4](https://www.st.com/resource/en/application_note/dm00442716-getting-started-with-stm32g4-series-hardware-development-boards-stmicroelectronics.pdf)

### FAULT、ENABLE与六路PWM

FAULT_N实际只有Q8集电极、R143上拉、TP16及U30.PB12/TIM1_BKIN；Q8.3→U30.34直线22.253mm，R143.1→U30.34约3.935mm。这条网应优先直接回到BKIN，避免经TP16或绕保护逻辑外围形成长支线。FAULT_N没有误并到NRST，ENABLE和BRAKE也保持独立。

六路TIM1信号先经R135..R140接到原PWM_*_IN，再经U25/U26硬件门送U7/U8/U9。当前快照只完成了栅极电阻到MOS栅极的固定铜，不能据此认为PWM链已经完成。最终应逐条确认MCU→串阻→逻辑输入及逻辑输出→驱动输入的真实路径；与PHASE、BR_SW和栅极功率回路保持可见分离。

## 连接器与发布前需验证的具体事项

- J9/J10/J11/J12已采用2.54mm单排候选，旋转90°后分别沿上边缘水平排布。其courtyard距上板边约8.23mm；J13/J14/J15距左板边约8.23mm，当前没有角孔空间冲突。J13 pad1为+3V3_INV的VTREF，pad4为GND，pad5为NRST；J14为TX/RX/GND。应保持这些针序的丝印可读。
- 当前实际板上接口文字只有ENC A/B、SPI A/B、SWD、TTL 3V3、CAN DNP等。J9..J12的电源分别经DNP的R100/R107/R113/R119接5V_SENSOR，而信号直接进入3.3V逻辑，并没有5V信号电平转换。发布前应在接口旁增加电源选择/3.3V IO说明，避免把候选5V供电理解为允许5V信号。
- CAN的U31、R126..R129、C82、J15和HSE的Y1/C83/C84仍须保留DNP状态；可选器件已经放置不等于首版装配启用。现有单排连接器及SW2均是机械候选，需与最终采购件核实针序、键位、插拔和触达空间。
- In1.Cu和B.Cu都存在覆盖(1,1)..(199,139)的GND区，且三只分流器低端均通过4个贯穿过孔连接地。它们在电气上属于同一GND，不能仅凭“In1安静/B层功率回流”的命名保证动力回流不经过模拟参考附近。最终检查分流低端到DC−的实际高电流回路、平面颈部与信号参考完整性。
- 完成布线后重点复核：INA.8→各RS.1的独立SOURCE支路、INA.1→各RS.2的独立GND Kelvin支路、FAULT_N→BKIN及六路PWM是否被普通自动长线绕行。Kelvin负输入与整板GND同网，ratsnest归零不能证明已从对应分流器低端独立取样。
- 发布前仍需对本板实际铜厚、分流/制动发热、母线与相线过孔阵列、采样噪声及硬件过流/过压到桥臂关断的总延时做验证；这些不由本次pad距离和courtyard检查证明。
