leolei2012/power_system/inverter/hardware/review/pcb_power_review.md

# PCB 功率与辅助电源独立审查

历史范围：本文为200×140 mm四层PCB0.1的审查记录，坐标、器件封装和检查结论仅对应 [改板前归档](../../history/pcb_0_1_200x140_before_60mm_2026-11-06.zip)。当前60×60 mm六层PCB0.2正在重新布线，见 [现行板级审查](../PCB_REVIEW.md)，不得把本文作为当前布局或验证结果。

2026-11-06。范围为当前200×140 mm、4层整合变频板的功率铜、驱动、分流取样和辅助电源；只读审查，未修改原生PCB、原理图、工程或BOM。本版是机械/电气审查稿，本文不构成投板或10 A运行放行。

## 审查基准与结果边界

本文几何测量以只读快照 `pcb_power_review_tmp/power_snapshot.kicad_pcb` 为准，SHA-256：`08d3f9571eb73bf8e4544930046115f0714341367e12dea62201dca9a22d5da2`。此快照包含126条线段、40个过孔、6个已填充铜区；信号布线尚未补齐。父任务随后决定进行下文“本稿修正”列出的局部修改，因此**本文原始尺寸描述不表示修改后仍存在，修改后须重新读板核验**。

核对实际原生文件、pcbnew读取的焊盘/网络/铜区/线宽，及独立导出的B.Cu+F.Fab图 `pcb_power_review_tmp/power_bottom.svg` / `power_bottom.png`。现有 `pcb_power_drc.json` 的已布铜违反项为0错误、8丝印警告，另有499条未连接项；parity为0。该结果说明当前部分布线的几何和网络映射，不说明功率回路、Kelvin取样或热设计完成。

## 主要发现及本稿修正

| 优先级 | 快照中的实际证据 | 影响与本稿处理 |
| --- | --- | --- |
| 优先修正 | C21/C22正端位于(134.025,67.5)/(158.025,67.5)，而顶层VBUS区只覆盖x122..183、y21..49；当前没有专门的功率连接到这两个正端。 | 信号自动布线即使连通，也可能只生成HV默认0.6 mm长支路，旁路回路仍很差。根代理已决定增加In2.Cu VBUS宽区x111..184、y20..78，与In1 GND配对，高侧漏极及两只MLCC正端接独立过孔阵列，负端就近接GND多过孔；实施后重查间隙和实际连通。 |
| 优先修正 | 各相下管tab中心至y67.2过孔排均用1.2 mm宽、7.2 mm长的F.Cu共同干线。脚本生成四条完全重合的干线，重合不增加铜厚或并行截面。 | 此处是4 mm输出线前的窄颈。根代理已决定加宽至4 mm；需确认从tab铜面到所有过孔的连续有效宽度，不能只改某条重复线。 |
| 优先修正 | RS低端是GND，INA241的IN−也叫GND，故自动布线可直接利用附近平面，网表/ERC/DRC都不会识别其没有Kelvin回路。快照INA中心分别(127,83)/(152,83)/(177,82.5)，距分流约14～15 mm。 | 必须从RS两个焊盘分别取样，输入正负两线成对直达INA，不能从附近GND取代低端取样。根代理已决定把三INA移到RS右侧约(126/150/174,71)、90°，比较器跟到y80..83。移动只是创造条件，还须固定两条Kelvin线。 |
| 保留待优化 | U/V输出B.Cu的4 mm线绕到上边再回J4，固定路由中心线长分别139.20/114.72 mm，W为17.02 mm；不含各自局部PHASE铜区中的路径。 | U/V大幅绕行且三相不对称；它们与PHASE铜区共同切开B面DC−回流空间，并把高dv/dt节点带到母线电容、输入二极管下方。本稿按根代理决定保留此初稿走向，明确后续改成桥至端子的就近通道；不能以4 mm宽度推断该路线已经合格。 |
| 保留待验证 | 各相共8个0.8/0.4 mm通孔：4个在高管源极出口，另外4个在下管漏极出口。 | 这是“4个并联组成第一组，再经B面铜区，串联通过第二组4个”的路径，**不是8个一起并联分担电流**。加宽干线后仍需验证两组过孔的分流、温升、孔铜和动态寄生。 |

## SOURCE与GND：当前正确部分与布线约束

快照三个下管源极到RS高端均已用独立2 mm、长5.4975 mm的F.Cu连接，且SOURCE没有被赋成GND。实际焊盘网络正确：Q2/4/6源极、RS1/2/3高端、U7/8/9的COM、对应VCC电容负端和栅源/输入下拉属于各相SOURCE；只有RS低端才是GND。已填充GND区没有显示为SOURCE的铜桥，现有DRC也没有相应短路报告。

当前固定SOURCE铜只完成Q→RS主支路，其余COM/电容/下拉连接仍待补齐。后续必须做到：

- COM与VCC去耦回流在下管源极/RS高端附近取短支路，不能经全局GND；三相SOURCE也不能先并成一片再接某一只分流。
- INA正输入在RS高端焊盘单独取线，负输入在RS低端焊盘单独取线；避免沿Q→RS的功率干线、过孔公共回流或GND铜中的电流路径取样。
- INA的IN−即便与电源地同名，也应在外层无GND铺铜的短通道成对布线，避免自动就近打GND过孔或在芯片旁先与电源地脚短并。当前两层GND平面中的任意地电位不等于RS低端焊盘电位。5 mΩ分流上1 mV的取样地误差就对应0.2 A。
- 高侧驱动VS、自举负端和高管栅源下拉接对应PHASE；低侧COM、低管栅源下拉及VCC去耦负端接SOURCE。必须按这个分工配对回线。

## 驱动、自举与回流

栅阻已经靠近MOS：固定R19/20等到MOS gate的0.4 mm支路约3.64 mm；自举电容靠近驱动的VB/VS，机械位置可以作为第一稿基础。C28/C32/C36的100 nF到VCC脚约3.6 mm，位置也有利。

但HO/LO、VS/COM、自举和100 nF回流还未布好，不能仅凭器件距离判定栅极环路。特别是100 nF负端位于驱动右侧，COM脚在左侧，建议在驱动下方形成**本相SOURCE局部铜岛/短回线**，把VCC电容和COM就近闭合，再单独回到下管源极。不要把电容回流拉到RS附近后再绕回驱动，也不要用全板GND代替SOURCE。对HO配PHASE、LO配SOURCE；这些回路宜人工固定，不能只按自动布线的网络连通接受。

## 主母线、DC−和热

新增In2 VBUS可以让C21/C22经宽铜接入并与In1 GND配对，但并不自动解决所有回流：新增VBUS过孔、原有PHASE通孔和后续信号孔会在In1 GND形成反焊盘，必须确认功率区仍有足够连续的DC−截面。B面U/V长输出路由已经造成明显绕行，功率回流不可只依赖“整板GND区”名称。检查RS低端→C21/22负端→C19/20负端→J3负端的实际填充铜和过孔，而非仅检查网络同名。

当前只有C21/C22两只2.2 µF/100 V MLCC供三相共用。即使补上宽铜，也仍没有三相各自独立的一颗局部电容；有效直流偏压容量、纹波电流、再生/换流时的母线过冲和三相间共阻抗仍须验证。本轮不增加未批准器件。

散热方面，高侧三个tab连接约1599 mm²的顶层VBUS铜区；低侧tab仅经上述干线和两组过孔转接到各约313 mm²的B面PHASE区，热路径不同。Q7和D1也未形成经计算的散热设计。**Q1/3/5和D1 tab是VBUS，Q2/4/6 tab是各自PHASE，Q7 tab是BR_SW**；任何公共散热器、热孔或底层扩铜都必须保留这些电气隔离，不能按“都是功率器件”直接合并。

`pcb_power_copper.json`中的外层70 µm/内层35 µm目前是目标；快照只有1.6 mm总板厚，没有显式制造叠层铜厚定义。因而4 mm线、2 mm SOURCE、孔径/孔数与所需10 A之间还没有完成可审核的温升计算，不能据报告字段认定已经选择2 oz板或通过10 A能力验证。

## 辅助电源审查约束

12 V buck-boost和5 V buck的电感、输入输出电容布局分区合理；本快照尚未完成这些电源的开关/自举/去耦实际回路，因此仍须人工复核开关环路，禁止把BB_L1/BB_L2、BUCK_SW做成长距离跨板铜区。U2的VREG仅限本地调节/去耦，不作负载电源。

U1 eFuse裸露焊盘17及pin8为EFUSE_RTN，pin9才是GND。热孔、铜岛与UV/OV/MODE/ILIM/DVDT及复位按键回流必须按实际网络区分；不可给EP套通用GND热孔模板。3.3 V LDO的总负载和温升预算、两只10.4 mm电感候选的实际Isat/DCR及F1/F2的DC能力仍属于物料/电气定稿项，几何可放下不代表额定已通过。

## 本稿后续最低复查

根代理实施上述三项局部修正并补信号后，应重新保存、填铜和运行完整DRC/原理图parity，再独立核对：两只主MLCC的宽铜/过孔接入、下管tab宽颈、每只RS两端Kelvin路线、每相COM/自举/100 nF闭环，以及新增In2 VBUS与SOURCE/PHASE/GND的间隙。本文没有审查尚未生成的最终自动布线会话；最终板如与快照不同，以新的原生文件和检查结果为准。
