leolei2012/power_system/docs/roadmap.md

# 电力电子实验平台长期规划

更新：2026-11-07。平台仍分变频器与电源板两类功能。当前变频器采用 **STM32G431RBT6最小核＋共地应用功率底板**，Rev E七页最小核和二十页底板原理图已完成；新PCB均未设计，两板均规划60×60 mm，上功率板、下G431最小核，轮廓边线对齐，四角M2支撑待PCB共同校核。全部52个可GPIO复用pad由64针引出，专用接口/ADC应用保护均在底板。电源板暂不绘制，继续按自有MCU、G431方向独立评估。原LKS集中控制双逆变/PFC保留历史，当前依据见 [最小核与底板](controller_daughterboard.md)。

## 已确定的方向

先用外部直流源开展实验，不接市电；后续再独立设计市电版本。各板先单独验证，再组合运行。长期实验电源的 12~100 V 设想不改变当前变频板已确定的 12～60 V 母线指标，也不表示电源板已完成对应范围设计。

| 板卡或功能 | 当前分工 | 尚未确定 |
| --- | --- | --- |
| 变频器双板 | 一颗G431控制一路三相桥及一路制动；Rev E最小核7页47位号/3DNP，底板20页317位号/14DNP，双ERC0/0；52信号pad全部引出、PC7 ARM、64针；应用接口/采样保护在底板 | 两板60×60 mm叠放布局、四角M2支撑/插合/板距与散热、公共库同步、额定、输出LC、热与动态保护验证 |
| 电源板 | 暂不绘图；本板一颗 MCU 独立完成所属电源控制和保护，当前按 STM32G431 方向评估 | 输入/中间母线、具体拓扑、辅助供电、隔离、板间通信、资源与实时性；已定输出见下文 |
| Boost PFC | 电源板的一个后续版本，原单相整流加 Boost 为候选起点 | 单路/交错、工作模式、输入输出指标与外围 |
| Vienna PFC | 电源板的另一个后续版本，研究三相三电平整流 | 输入输出指标、器件连接、中点平衡及采样/保护 |
| LLC | 已恢复讨论：评估在电源板上增加 LLC，由该板单颗 MCU 同时控制 PFC 与 LLC | 半桥/全桥、输出电压/电流、频率范围、调制控制、同步整流及单 MCU 资源可行性 |
| 市电版本 | 低压实验验证后另行设计 | 输入制式、隔离、防护、结构与完整额定 |

电源板对外已确定两路输出：辅助低压和功率母线。功率母线已定 12～60 V 可调、最大 10 A，最大 600 W@60 V；辅助口及连续额定/启动方式尚未冻结，见 [输出规划](integrated_board.md#电源板两路输出)。

Boost 与 Vienna 是两种 PFC 版本，不要求串联。电源板采用 PFC 加 LLC 是正在评估的组合，不代表一块通用 PCB 已兼容全部拓扑，也不代表 STM32G431 同时控制 PFC 和 LLC 已得到验证。LLC 的功率级及输出指标须先确定，再核对定时器、互补/死区、ADC 触发、保护与软件预算。

## 可组合的实验路径

- 实验直流源直接给变频板供母线，先验证三相桥和电机控制。
- 实验直流源 → 作为交流源的变频板 → Boost 或 Vienna 电源板 → 直流负载，或另一块电机变频板。
- 若采用 PFC 加 LLC：交流源 → 电源板 PFC 级 → LLC 级 → 匹配的直流负载或变频板。

每套变频器（含控制子板和功率底板）与每块电源板分别运行自有MCU；两套变频器可以分别承担交流源和电机控制，不共享一颗主控。Vienna 路线需匹配三相交流源；LLC 是否承担隔离、输出是否适合后级、各级参考地及通信隔离均待设计。上述路径没有冻结各级电压和功率。

## 对当前工程的影响

- inverter为二十页Rev E应用底板，controller/hardware/g431_core为七页G431最小核；双ERC0/0，64针、52pad及32768组静态保护/ARM逻辑通过，新PCB均未画。上一版 [40针Rev D](../inverter/history/daughterboard_rev_d_before_minimum_core_2026-11-07.zip)、[Rev C集成板](../inverter/history/integrated_rev_c_60x60/)及旧LKS工程保留历史。
- 子板只保留MCU、局部电源/去耦/VDDA/VREF、RESET/BOOT/HSE、ARM及两组2×16排针。52个信号pad全部引出，底板9个未用socket脚NC；核心参考轨仅供回传钳位/故障上拉及调试参考，不与底板本地3.3 V并联。NRST通过64针供底板SWD。
- 原 LKS 100 脚分配、25 路 ADC 预算以及“两路逆变加一路 PFC”的单 MCU 实时预算失效。变频板与电源板各自重新规划资源和固件。
- 两路ABZ、两路SPI、TTL、SWD、可选经典CAN、五个LED、ADC末端RC及输入保护均在底板。核心仅HSE三件DNP，底板14项DNP；外部应用信号为3.3 V单端。PC7插底板时保留RUN_ARM，ROM/复位默认不许可功率桥。电源板接口、通信及隔离仍待定义。
- ThreadX 方向保留，需按 G431 的存储与各板控制任务重算；PFC 加 LLC 的可行性不能由原软件预算推导。

## 实施状态

当前已完成Rev E最小核7页47位号/3DNP、应用功率底板20页317位号/14DNP；双ERC0错误/0警告，64针、52信号pad、迁移物理pin及32768组静态保护/ARM逻辑检查通过。两个PCB均未设计，两板60×60 mm同轮廓，上功率板下最小核为机械规划。四角M2孔、实际板距及上下元件/风道需校核，母座8.5 mm塑高不冻结板距。历史 [Rev D](../inverter/history/daughterboard_rev_d_before_minimum_core_2026-11-07.zip)、[Rev C](../inverter/history/integrated_rev_c_60x60/)及 [PCB0.1](../inverter/history/pcb_0_1_200x140_before_60mm_2026-11-06.zip)不覆盖本版；机械、额定、热和保护动态仍待实物验证，见 [双板说明](controller_daughterboard.md)和 [审查](../inverter/hardware/design_review.md)。

PFC 电源板按本阶段要求暂不绘图；既有 PFC 加 LLC、两路输出及已确定的功率母线指标继续保留，其他拓扑和资源问题留待后续明确。原 100 V/1 kW 实验逆变、390 V 市电母线及旧 FFC 结构均不自动用于新版。

## 拓扑参考

- [TI Vienna 三相 PFC 参考设计](https://www.ti.com/tool/TIDA-010257)
- [TI PFC 与 LLC 产品及拓扑资料](https://www.ti.com/product-category/power-management/pfc-llc.html)
