leolei2012/power_system/controller/docs/connector.md

# 控制板端子

2026-11-05 架构变更：用户确定控制、驱动与逆变功率级合板，MCU 改为 **STM32G431**。当前依据见 [合板方案](../../docs/integrated_board.md)。本文下方 LKS、独立 controller、24 脚板间接口及旧引脚/软件预算属于上一版记录；旧 KiCad/BOM/检查结果不代表新合板版本已完成。已确定每板一颗 MCU，分变频板与电源板，取消单 MCU 同时控制两路逆变和 PFC。LLC 在电源板恢复讨论，具体配置、接口和 MCU 完整后缀待评估。

控制板按功能分端子，板与板用螺钉柱固定。机箱内信号排线长度暂按不超过约 15 cm 设计。

## 接口范围

| 端子 | 数量 | 用途 |
|---|---|---|
| 变频接口 | 2 路，每路 24 脚 | 两路逆变 / 电机控制，预留脚暂不接 MCU |
| PFC 专用接口 | 1 路，24 脚 | 支持 Boost / Vienna 板型，独立于两路变频接口 |
| 编码器 | 2 路独立接口 | 暂按增量式 A/B/Z 预留；供电、电平、脚数和接插件待定，不支持霍尔 |
| SPI | 2 路独立接口 | 面向 SPI 编码器或其他外设；暂按各 4 根信号线规划 |
| 制动 | 2 路独立控制接口，脚位待定 | 分别控制两路制动电阻斩波电路 |
| 电源 | 独立电源入口，建议 2 芯 | 从指定 inverter 取稳压 5 V；独立电源线；容量/接插件待定 |
| 通讯 | 1 路 TTL 串口，预留 CAN | 调试、给定、总线；不设 USB |
| SWD | 1 路，暂按 5 脚 | 烧录和在线调试，包含复位 |

主控为单颗 LKS32MC451VCT8。最新要求为两路变频加一路 Boost / Vienna PFC 同时运行，LLC 暂停且接口取消。[引脚草案 A](pin_assignment.md)已落实封装脚号和外设复用，静态核对无物理冲突；PFC PWM 时序、三套采样窗口和实时负载仍待验证，详见 [单芯片评估](single_mcu_evaluation.md)。

功率母线不进控制板，不经信号 FFC 传输。适配器供辅助电、实验直流源供母线；辅助输入目标为 12～24 V，当前按 12 V 驱动、5 V 板间供电和本地 3.3 V 选型；参考地和隔离边界见 [供电讨论](power_architecture.md)。电源板可由本控制板或另一块控制板单独控制。

## 变频端子

每路一只 24 脚变频功率板接口，两路采用相同定义，分别独立接 MCU；下文 PFC 为另外一路专用接口。若继续采用 FFC，间距暂沿用 0.5 mm，24 脚座型号待选。原两根 20 脚排线方案作废。

### 引脚预算

| 信号 | 脚数 |
|---|---|
| 三相上下管 PWM | 6 |
| ENABLE、FAULT_N | 2 |
| 三相电流 I_U / I_V / I_W | 3 |
| 母线电压 V_DC | 1 |
| 三相输出电压 V_U / V_V / V_W | 3 |
| NTC 温度反馈 TEMP_NTC | 1 |
| 地线 | 6 |
| 预留 | 2 |
| 合计 | 24 |

原 TEMP 信号用于 NTC 温度反馈，占一个采样脚。NTC 的阻值、安装位置、分压电路所在板卡与温度刻度待定；接口送给 MCU 的电压必须在 ADC 允许范围内。高压板仍须满足采样隔离要求。

以下是讨论用排列，最终顺序需结合布局和信号回流确认，尚不作为制板依据。

| 脚 | 信号 | 脚 | 信号 |
|----|---|----|---|
| 1 | PWM_UH | 13 | GND |
| 2 | PWM_UL | 14 | I_U |
| 3 | GND | 15 | I_V |
| 4 | PWM_VH | 16 | I_W |
| 5 | PWM_VL | 17 | AGND |
| 6 | GND | 18 | V_DC |
| 7 | PWM_WH | 19 | V_U |
| 8 | PWM_WL | 20 | V_V |
| 9 | GND | 21 | AGND |
| 10 | ENABLE | 22 | V_W |
| 11 | FAULT_N | 23 | TEMP_NTC |
| 12 | RSVD_ADC | 24 | RSVD_GPIO |

GND / AGND 是数字与模拟信号回流的命名，不代表两者隔离；接地方式随板卡原理图与布局确定。当前以六根地线做引脚预算，后续布线审查再验证。

PWM 和 ENABLE 为 3.3 V，高有效；FAULT_N 低有效、开漏。不设独立 RESET_N，故障复位合并到 ENABLE。实验室逆变器电流刻度沿用 1.65 V ± 50 mV/A，电压 50:1；其他功率板另定。

两路编码器和两路制动控制分别另设接口，不支持霍尔。24 脚变频接口不提供传感器供电，也不保留原 3V3_OUT。

BOARD_ID 是否采用尚未确定，第 24 脚暂作预留，不固定电阻编码或识别电压。固件必须使用与实际功率板匹配的采样刻度和保护参数；若后续采用板卡识别，再补充识别与启动规则。

### 使能与故障复位

- ENABLE 默认下拉。低电平时硬件封锁全部六路 PWM；只有故障条件已消除时，才允许清除故障锁存。
- ENABLE 为高且无活动故障、无锁存故障时，才允许 PWM 进入驱动器。
- 故障条件仍存在时，故障置位优先，必须保持封锁，FAULT_N 保持低；ENABLE 的任何变化都不能绕过保护。
- 运行中故障先由功率板硬件关断，不等待 MCU。MCU 随后记录故障、停 PWM 并拉低 ENABLE。
- FAULT_N 是 inverter → controller 的开漏故障通知输出。板内故障锁存同时控制六路驱动命令的硬件封锁；封锁不依赖 FAULT_N 经过 MCU 处理。此结构已于 2026-11-01 用户确认，不增加外部关断/复位脚，连接关系见 [inverter 保护](../../inverter/hardware/design.md#保护)。
- 恢复时保持 PWM 为低，确认故障消除并完成锁存复位后，再拉高 ENABLE，最后恢复 PWM；不因故障自行消失而自动重启。
- ENABLE 低电平复位所需的最短时间待锁存电路确定。停机可能清除历史锁存状态，固件应在复位前记录故障；掉电等情况下不保证保留历史记录。

## PFC 专用控制端子：24 脚

PFC 改为 24 脚，原 12 脚方案作废。采用与变频接口相同的地线位置和信号类别，但保持专用。目标为两路变频端子加一路 PFC 端子同时工作；PFC 支持 Boost / Vienna，不承诺兼容电机变频。下表的电机列仅作脚序对照。MCU 管脚见 [引脚草案 A](pin_assignment.md)，连接器型号待定；三个端子独立布线，不直接并联 MCU 信号。

| 脚 | 电机逆变 / 交流源 | 单路 Boost | Vienna |
|----|---|---|---|
| 1 | PWM_UH | PWM_BOOST | PWM_A1 |
| 2 | PWM_UL | 不使用 | PWM_A2 |
| 3 | GND | GND | GND |
| 4 | PWM_VH | 不使用 | PWM_B1 |
| 5 | PWM_VL | 不使用 | PWM_B2 |
| 6 | GND | GND | GND |
| 7 | PWM_WH | 不使用 | PWM_C1 |
| 8 | PWM_WL | 不使用 | PWM_C2 |
| 9 | GND | GND | GND |
| 10 | ENABLE | ENABLE | ENABLE |
| 11 | FAULT_N | FAULT_N | FAULT_N |
| 12 | 预留模拟输入 | 不使用 | V_BUS_LOWER |
| 13 | GND | GND | GND |
| 14 | I_U | I_L | I_A |
| 15 | I_V | 不使用 | I_B |
| 16 | I_W | 不使用 | I_C |
| 17 | AGND | AGND | AGND |
| 18 | V_DC | V_DC | V_BUS_UPPER |
| 19 | V_U | V_AC | V_A |
| 20 | V_V | 不使用 | V_B |
| 21 | AGND | AGND | AGND |
| 22 | V_W | 不使用 | V_C |
| 23 | TEMP_NTC | TEMP_NTC | TEMP_NTC |
| 24 | 预留数字输出 | PRECHARGE | PRECHARGE |

两路变频接口的第 12/24 脚均预留且不接 MCU，每路占 16 根 MCU 信号。PFC 专用口的第 12 脚接下半母线 ADC，第 24 脚接预充控制 GPIO；不再要求变频口切换成 PFC。LLC 接口取消。

### 兼容条件

- 六根地线位置固定，PWM、ADC 和数字控制的方向固定；各模式未使用的脚在功率板侧不连接，控制侧设为已定义的安全状态。
- 反馈经调理及所需隔离后，必须符合控制侧 ADC 范围。电流零点、增益、电压比例及欠压 / 过压阈值由板型配置决定，不能只因插头相同就沿用参数。
- Vienna 的两路半母线反馈用于获得总母线电压及中点平衡信息；母线中点不直接接控制地。
- 六路门极命令仅代表接口预算。Vienna 是否需要六路、每路如何配对，由实际开关连接与驱动方案确定；不能直接沿用电机的互补 PWM 时序或半桥互锁驱动电路。
- ENABLE / FAULT_N 沿用硬件封锁和故障复位原则。预充脚仅输出控制信号，继电器驱动与续流保护位于功率板；极性和时序待定。
- 同一种连接器不等于允许随意换板运行。启动前需明确板型、门极时序和采样刻度；BOARD_ID 是否采用仍待定。
- PFC 第 12 脚 ADC、第 24 脚 GPIO 及六路命令已在引脚草案落脚；Boost / Vienna 的功能停用、门极关系和采样时序须随板型验证，不能仅凭物理脚号认定兼容已完成。

参考：[TI TIDM-1000 设计指南](https://www.ti.com/lit/ug/tiducj0g/tiducj0g.pdf)列出六路 PWM、三相电流、三相电压与上下半母线反馈。本表的共用脚序、预充和温度信号为本项目设计草案。

## 制动控制接口

预留两路独立制动控制接口，分别输出 BRAKE_1、BRAKE_2，对应两块 inverter 各自板内的一路制动斩波电路。低压接口按控制信号与 GND 连接；2026-11-01 已确认 3.3 V 高有效、输入默认下拉关闭，inverter 每路使用一颗 12 V 供电的 TI UCC27517DBVR 同相驱动。接插件型号、最终脚数及是否增加独立故障 / 温度反馈仍需落实；当前 MCU 预算仅计两个控制输出，不含这些可选反馈。

2026-11-01 已确认：每块 inverter 集成一路制动功率 MOS 及驱动，设置一个 2P 外接电阻端子（BR+、BR_SW），制动电阻放在板外。电阻可不接，不用时功率端子保持开路，不短接。控制板不承载制动功率；此低压控制接口与制动电阻功率端子分开。每路使用其所属母线的电压反馈决定制动动作。两路独立母线各对应一路；共母线时按实际配置选择启用一路或协调使用两路。

三相桥停 PWM 后仍可能发生能量回馈，制动控制不能简单跟随电机 ENABLE 一并关闭。制动单元自身保护与故障处理策略待功率电路设计时确定。

2026-11-01 已确认制动门限按所属实验母线配置：60 V 工况名义目标为母线上升到 62 V 开启、下降到 61 V 关闭（1 V 迟滞）；65 V 独立硬件过压锁存门限保持已定值。其他供电工况的具体门限另定，需匹配实际电源输出容差及允许回馈电压。同日用户确定制动由 controller 软件判断并经 BRAKE_1/2 控制，inverter 执行功率驱动，不另设自主电压门限制动控制。快速采样/输出响应时间及制动 PWM 频率仍待落实；MCPWM FAIL 不能未经核对就连同 CH3P 制动输出一起封锁。

## 编码器接口

预留两路独立编码器接口，不支持霍尔。每路暂按增量式 A/B/Z 信号规划；编码器供电、单端 / 差分、电平、总脚数与接插件尚未确定，不能仅按三个信号脚确定连接器。

MCU 资源需安排两组编码器 A/B 计数功能，Z 相作为索引输入另行分配。两路与两路功率控制的并行能力须在引脚分配时确认。

## SPI 接口

在两路 A/B/Z 编码器接口之外，增加两路独立 SPI 接口，暂命名 SPI_A、SPI_B。两路分别安排硬件 SPI 实例及独立信号线，控制板作为主机，不默认共享时钟或数据线。用于短距离连接 SPI 编码器等外设。

| 信号 | 相对控制板的方向 | 用途 |
|---|---|---|
| SCK | 输出 | 时钟 |
| MOSI | 输出 | 主机发送数据 |
| MISO | 输入 | 从机返回数据 |
| CS_N | 输出 | 暂按低有效片选，最终以外设协议为准 |
| GND | 参考地 | 信号回流 |

逻辑电平暂按 3.3 V。每路 MCU 预算为 4 个信号脚，两路共 8 个；若外设无需 MOSI，可不接该信号但接口仍预留。是否提供传感器电源、供电电压与电流、额外地线以及最终接插件脚数待定，不将连接器先固定为五脚。

SPI 模式、时钟频率、帧格式和角度读取周期随具体编码器确定。新增 SPI 不替代两路 A/B/Z，也不表示所接器件必然具有绝对位置功能。与全部功率控制接口的同时可用性需核对 MCU 引脚复用、SPI 实例和控制时序。

## 电源端子

当前讨论方向为低压适配器的 12～24 V 先进入 inverter，再由 inverter 给 controller 提供辅助电。本轮推荐独立电源线送稳压 5 V，controller 本地生成 3.3 V；5 V 尚未冻结，不能据此把 controller 同一入口标成可直接接 24 V。若最终转送原始 12～24 V，需相应调整 controller 的本地稳压级。

辅助供电不经 24 脚信号 FFC，建议独立 2 芯电源口，具体脚序、接插件、限流、滤波及共地/隔离待设计。供电不受电机 ENABLE 控制。两路 inverter 同时连接时，初版只指定一路提供电源，不直接并联两路稳压输出；独立调试也使用同一电源入口。详见 [供电讨论](power_architecture.md)。

## 通讯端子

不设 USB 接口。TTL 串口用于调试和给定，SWD 用于烧录和在线调试。CAN 单独留一只 4 脚座，给以后的机器人或无人机总线，不和功率板接口混在一起，第一台可以不贴 CAN 座。
## TTL 串口

预留一路独立 UART，暂按 3.3 V 逻辑电平、3 脚接口设计：TX、RX、GND。TX / RX 方向以控制板为准，与外部串口交叉连接。不提供供电脚，不是 RS-232 或 RS-485 电平。引脚草案采用 UART0，TX 为 P0_2（4 脚）、RX 为 P2_11（53 脚）；波特率和连接器型号待定。

## SWD 烧录调试口

预留一路，暂按以下 5 脚排列；最终连接器与顺序待布局确认。

| 脚 | 信号 | 用途 |
|----|---|---|
| 1 | VTREF / 3V3 | 提供目标板逻辑电压参考，不默认由调试器给板供电 |
| 2 | SWDIO | 调试数据 |
| 3 | SWCLK | 调试时钟 |
| 4 | GND | 调试参考地 |
| 5 | NRST | MCU 复位，支持连接复位状态下的目标板 |

SWDIO / SWCLK 对应 MCU 调试功能脚，优先保留；不与功率控制信号冲突。此处 NRST 是 MCU 复位，不是已取消的功率板 RESET_N。SWO 暂不列入接口。
## MCU 资源评估

最新方案的 GPIO、ADC、PWM 与算力评估见 [单芯片评估](single_mcu_evaluation.md)。旧的含 LLC 和第三路完整通用口预算作废。
