leolei2012/power_system/inverter/reference/sources.md

# 上游地址

需要看原图时在仓库外克隆，不要把这些目录提交进 `power_system`。

| 项目 | 地址 | 许可 |
|---|---|---|
| OWNVERTER | https://github.com/owntech-foundation/OWNVERTER | CERN-OHL-S，文档 CC BY-SA |
| SPIN 控制板 | https://github.com/owntech-foundation/SPIN | 与 OWNVERTER 配套 |
| OWNVERTER 文档 | https://docs.owntech.org/latest/ownverter/1.1.0/getting_started/ | CC BY-SA |
| Nexperia 逆变板 | https://github.com/Nexperia/NEVB-MTR1-I56-1 | MIT/X |
| Nexperia 原理图 PDF | https://assets.nexperia.com/documents/design-support/NEVB-MTR1-I56-1-schematic.pdf | 厂商设计文件 |
| openinverter 硬件 | https://github.com/jsphuebner/inverter-hardware | CC BY-SA 4.0 |
| openinverter 说明 | https://openinverter.org/wiki/Main_Page | 见站内页面 |
| ODrive 硬件 | https://github.com/odriverobotics/ODriveHardware | 见仓库 LICENSE |
| ODrive 固件 | https://github.com/odriverobotics/ODriveFirmware | 见仓库 LICENSE |
| ODriveX | https://github.com/zhbi98/MotorKit | MIT |
| FOC_KING | https://github.com/nordstream3/FOC | CERN-OHL |
| VESC 控制板（paltatech） | https://github.com/paltatech/VESC-controller | CERN OHL 1.2 |
| VESC 固件 | https://github.com/vedderb/bldc | GNU GPL |
| SimpleFOC | https://github.com/simplefoc/Arduino-FOC | MIT |
| B-G431B-ESC1 用户手册 | https://www.st.com/resource/en/user_manual/um2516-electronic-speed-controller-discovery-kit-based-on-b-g431besc1-stmicroelectronics.pdf | ST 文档 |
| 立创三相 BLDC（课设） | https://oshwhub.com/lovewangdake/BLDC_Drive | GPL 3.0 |
