leolei2012/power_system/controller/hardware/g431_core/review/core_supply.pdf

1 | 2 | 3 | 4 | 5 | 6 | 7 | 8

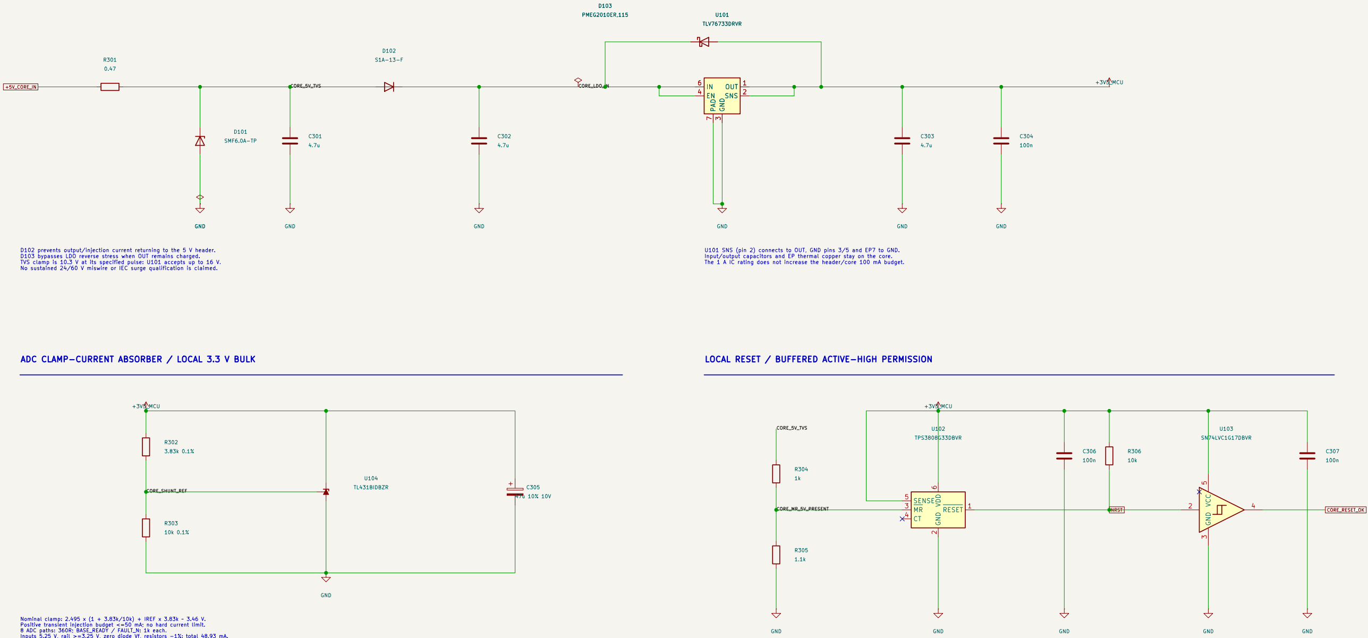
[picture p3: figure]
GND ⁺3V3_MCU; SMF6.0A-TP; GND; OUT 1 SNS 2 GND; PAD; TLV76733DRVR; 3 VCC; SN74LVC1G17DBVR; GND U104; TL431BIDBZR; +3V3_MCU; D103 PMEG2010ER,115 GND; 1.1k GND; R306 10k RESET 1 GND; SENSE 5; VDD; TPS3808G33DBVR ⁺3V3_MCU; 100n GND; +5V_CORE_IN; NRST; CORE_RESET_OK; CORE_5V_TVS; CORE_SHUNT_REF; CORE_LDO_IN; TLV76733DRVR OUT 1; SNS 2 GND
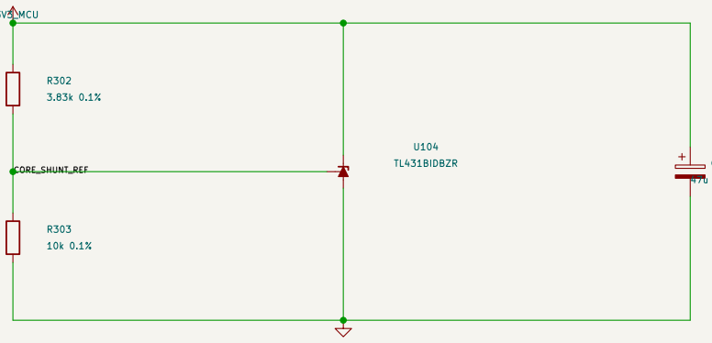
[picture p4: figure]
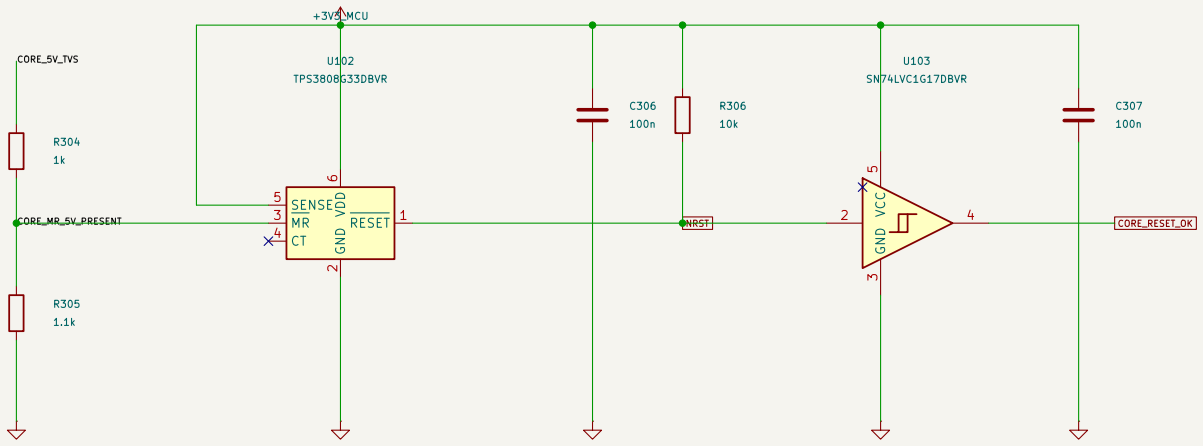
[picture p5: figure]

1 | 2 | 3 | 4 | 5 | 6 | 7 | 8

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
## F Date: 2026-11-07 KiCad E.D.A. 10.0.7

Size: A3 | Rev: E-core-draft Id: 5/7

# Title: Minimum core - independent power and local reset

## File: core_supply.kicad_sch

## Sheet: /Local power and reset/

## power_system

## HARDWARE REVIEW DRAFT - NOT RELEASED FOR PCB

## CONTROLLER | local regulated 5 V input | independent 3.3 V | common ground

## CORE_MR_5V_PRESENT LOCAL RESET / BUFFERED ACTIVE-HIGH PERMISSION

## 5 V INPUT / INDEPENDENT 3.3 V MCU RAIL

Regulated baseboard supply: +5V_CORE_IN = 4.75-5.25 V at header. Shared GND; no galvanic isolation. 100 mA continuous core budget; optional CAN/sensors require a fresh load and thermal budget.

RESET is open drain; CT open gives nominal 20 ms release delay. MR divider requires 5 V presence even if ADC clamps back-power 3.3 V. RESET and C81 stay on the core support page; SWD is on the base. CORE_RESET_OK goes to the separate RUN_ARM gate. PC7/RUN_ARM is required before CTRL_READY can be HIGH.

U101 SNS (pin 2) connects to OUT, GND pins 3/5 and EP7 to GND. Input/output capacitors and EP thermal copper stay on the core. The 1 A IC rating does not increase the header/core 100 mA budget. ADC CLAMP-CURRENT ABSORBER / LOCAL 3.3 V BULK

Nominal clamp: 2.495 x (1 + 3.83k/10k) + IREF x 3.83k ~ 3.46 V. Positive transient injection budget <=50 mA; no hard current limit. 8 ADC paths: 360R; BASE_READY / FAULT_N: 1k each.

Inputs 5.25 V, rail >=3.25 V, zero diode Vf, resistors -1%: total 48.93 mA. The downstream 100R does not limit rail injection. ADC RC: (360+100)R x 1nF = 0.46 us; add external source impedance. C305 required for shunt stability; validate startup/pulse/ringing on prototype. No sustained 60 V fault immunity is claimed.

D102 prevents output/injection current returning to the 5 V header. D103 bypasses LDO reverse stress when OUT remains charged. TVS clamp is 10.3 V at its specified pulse: U101 accepts up to 16 V. No sustained 24/60 V miswire or IEC surge qualification is claimed. | U101
