leolei2012/power_system/controller/hardware/review/expected_pin_nets.csv

Sheet | Reference | Pin | Expected_Net
power | J1 | 1 | +5V_CTRL
power | J1 | 2 | GND
power | #FLG01 | 1 | +5V_CTRL
power | #FLG02 | 1 | GND
power | C1 | 2 | GND
power | C1 | 1 | +5V_CTRL
power | C2 | 2 | GND
power | C2 | 1 | +5V_CTRL
power | C3 | 2 | GND
power | C3 | 1 | +3V3_MCU
power | C4 | 2 | GND
power | C4 | 1 | +3V3_MCU
power | U2 | 6 | +5V_CTRL
power | U2 | 4 | +5V_CTRL
power | U2 | 1 | +3V3_MCU
power | U2 | 2 | +3V3_MCU
power | U2 | 3 | GND
power | U2 | 5 | GND
power | U2 | 7 | GND
power | U3 | 1 | MCU_NRST
power | U3 | 2 | GND
power | U3 | 3 | RESET_BUTTON_N
power | U3 | 5 | +3V3_MCU
power | U3 | 6 | +3V3_MCU
power | C5 | 1 | +3V3_MCU
power | C5 | 2 | GND
power | R1 | 1 | MCU_NRST
power | R1 | 2 | +3V3_MCU
power | R2 | 1 | RESET_BUTTON_N
power | R2 | 2 | +3V3_MCU
power | SW1 | 1 | RESET_BUTTON_N
power | SW1 | 2 | GND
power | U1 | 12 | GND
power | U1 | 14 | +3V3_MCU
power | U1 | 31 | GND
power | U1 | 42 | +3V3_MCU
power | U1 | 44 | GND
power | U1 | 62 | GND
power | U1 | 71 | +3V3_MCU
power | U1 | 73 | GND
power | U1 | 92 | +3V3_MCU
power | U1 | 93 | +3V3_MCU
power | U1 | 94 | GND
power | U1 | 95 | GND
power | C6 | 1 | +3V3_MCU
power | C6 | 2 | GND
power | C7 | 1 | +3V3_MCU
power | C7 | 2 | GND
power | C8 | 1 | +3V3_MCU
power | C8 | 2 | GND
power | C9 | 1 | +3V3_MCU
power | C9 | 2 | GND
power | C10 | 1 | +3V3_MCU
power | C10 | 2 | GND
power | C11 | 1 | +3V3_MCU
power | C11 | 2 | GND
power | TP1 | 1 | +5V_CTRL
power | TP2 | 1 | +3V3_MCU
power | TP3 | 1 | GND
mcu | U1 | 1 | INV1_ENABLE
mcu | U1 | 2 | SPI_A_CS_N
mcu | U1 | 4 | UART_TX
mcu | U1 | 7 | SPI_A_MISO
mcu | U1 | 8 | INV1_I_W
mcu | U1 | 9 | INV2_I_W
mcu | U1 | 10 | MCU_NRST
mcu | U1 | 11 | OSC_OUT
mcu | U1 | 13 | OSC_IN
mcu | U1 | 15 | DEBUG_nTRST_RESERVED
mcu | U1 | 16 | SWDIO
mcu | U1 | 17 | DEBUG_TDI_RESERVED
mcu | U1 | 18 | SWCLK
mcu | U1 | 19 | DEBUG_TDO_RESERVED
mcu | U1 | 20 | CAN_RX
mcu | U1 | 21 | LED_RUN1
mcu | U1 | 22 | BRAKE_2
mcu | U1 | 23 | SPI_B_SCK
mcu | U1 | 24 | INV1_PWM_UH
mcu | U1 | 25 | INV1_PWM_VL
mcu | U1 | 26 | INV1_PWM_VH
mcu | U1 | 27 | INV1_PWM_WL
mcu | U1 | 28 | SPI_A_MOSI
mcu | U1 | 30 | SPI_B_CS_N
mcu | U1 | 32 | BRAKE_1
mcu | U1 | 33 | SPI_B_MOSI
mcu | U1 | 34 | SPI_B_MISO
mcu | U1 | 35 | PFC_PWM_A2
mcu | U1 | 36 | PFC_PRECHARGE
mcu | U1 | 37 | SPI_A_SCK
mcu | U1 | 38 | ENC1_A
mcu | U1 | 39 | ENC1_B
mcu | U1 | 40 | PFC_PWM_B1
mcu | U1 | 41 | PFC_FAULT_N
mcu | U1 | 43 | INV2_FAULT_N
mcu | U1 | 45 | INV2_PWM_WH
mcu | U1 | 46 | INV2_PWM_VH
mcu | U1 | 47 | INV2_PWM_UH
mcu | U1 | 48 | INV2_PWM_WL
mcu | U1 | 49 | INV2_PWM_VL
mcu | U1 | 50 | INV2_PWM_UL
mcu | U1 | 51 | ENC1_Z
mcu | U1 | 52 | PFC_PWM_C1
mcu | U1 | 53 | UART_RX
mcu | U1 | 54 | PFC_PWM_C2
mcu | U1 | 55 | LED_RUN2
mcu | U1 | 56 | INV1_PWM_UL
mcu | U1 | 57 | INV1_FAULT_N
mcu | U1 | 58 | INV1_I_U
mcu | U1 | 59 | INV2_I_U
mcu | U1 | 61 | LED_FAULT
mcu | U1 | 63 | INV1_I_V
mcu | U1 | 64 | INV2_I_V
mcu | U1 | 65 | PFC_I_B
mcu | U1 | 66 | PFC_PWM_B2
mcu | U1 | 67 | PFC_I_C
mcu | U1 | 68 | INV1_V_W
mcu | U1 | 69 | INV1_TEMP_NTC
mcu | U1 | 70 | INV2_V_W
mcu | U1 | 74 | REF_TEST_RESERVED
mcu | U1 | 75 | INV2_TEMP_NTC
mcu | U1 | 76 | PFC_V_C
mcu | U1 | 77 | PFC_TEMP_NTC
mcu | U1 | 78 | PFC_PWM_A1
mcu | U1 | 3 | INV2_ENABLE
mcu | U1 | 6 | PFC_ENABLE
mcu | U1 | 79 | LED_COMM
mcu | U1 | 80 | INV1_V_V
mcu | U1 | 81 | INV2_V_V
mcu | U1 | 82 | CAN_TX
mcu | U1 | 83 | INV1_PWM_WH
mcu | U1 | 84 | INV1_V_DC
mcu | U1 | 85 | LDO12_TEST_RESERVED
mcu | U1 | 86 | PFC_V_A
mcu | U1 | 87 | PFC_V_B
mcu | U1 | 88 | ENC2_B
mcu | U1 | 89 | ENC2_A
mcu | U1 | 90 | ENC2_Z
mcu | U1 | 91 | PFC_I_A
mcu | U1 | 96 | INV1_V_U
mcu | U1 | 97 | INV2_V_DC
mcu | U1 | 98 | INV2_V_U
mcu | U1 | 99 | PFC_V_BUS_LOWER
mcu | U1 | 100 | PFC_V_BUS_UPPER
mcu | TP4 | 1 | DEBUG_nTRST_RESERVED
mcu | TP5 | 1 | DEBUG_TDI_RESERVED
mcu | TP6 | 1 | DEBUG_TDO_RESERVED
mcu | TP7 | 1 | REF_TEST_RESERVED
mcu | TP8 | 1 | LDO12_TEST_RESERVED
mcu | Y1 | 1 | OSC_IN
mcu | Y1 | 3 | OSC_OUT
mcu | Y1 | 2 | GND
mcu | Y1 | 4 | GND
inverter_1 | J2 | 1 | INV1_PWM_UH_PORT
inverter_1 | J2 | 2 | INV1_PWM_UL_PORT
inverter_1 | J2 | 3 | GND
inverter_1 | J2 | 4 | INV1_PWM_VH_PORT
inverter_1 | J2 | 5 | INV1_PWM_VL_PORT
inverter_1 | J2 | 6 | GND
inverter_1 | J2 | 7 | INV1_PWM_WH_PORT
inverter_1 | J2 | 8 | INV1_PWM_WL_PORT
inverter_1 | J2 | 9 | GND
inverter_1 | J2 | 10 | INV1_ENABLE_PORT
inverter_1 | J2 | 11 | INV1_FAULT_N_PORT
inverter_1 | J2 | 13 | GND
inverter_1 | J2 | 14 | INV1_I_U_PORT
inverter_1 | J2 | 15 | INV1_I_V_PORT
inverter_1 | J2 | 16 | INV1_I_W_PORT
inverter_1 | J2 | 17 | GND
inverter_1 | J2 | 18 | INV1_V_DC_PORT
inverter_1 | J2 | 19 | INV1_V_U_PORT
inverter_1 | J2 | 20 | INV1_V_V_PORT
inverter_1 | J2 | 21 | GND
inverter_1 | J2 | 22 | INV1_V_W_PORT
inverter_1 | J2 | 23 | INV1_TEMP_NTC_PORT
inverter_1 | R3 | 1 | INV1_PWM_UH
inverter_1 | R4 | 2 | GND
inverter_1 | R3 | 2 | INV1_PWM_UH_PORT
inverter_1 | R4 | 1 | INV1_PWM_UH_PORT
inverter_1 | R5 | 1 | INV1_PWM_UL
inverter_1 | R6 | 2 | GND
inverter_1 | R5 | 2 | INV1_PWM_UL_PORT
inverter_1 | R6 | 1 | INV1_PWM_UL_PORT
inverter_1 | R7 | 1 | INV1_PWM_VH
inverter_1 | R8 | 2 | GND
inverter_1 | R7 | 2 | INV1_PWM_VH_PORT
inverter_1 | R8 | 1 | INV1_PWM_VH_PORT
inverter_1 | R9 | 1 | INV1_PWM_VL
inverter_1 | R10 | 2 | GND
inverter_1 | R9 | 2 | INV1_PWM_VL_PORT
inverter_1 | R10 | 1 | INV1_PWM_VL_PORT
inverter_1 | R11 | 1 | INV1_PWM_WH
inverter_1 | R12 | 2 | GND
inverter_1 | R11 | 2 | INV1_PWM_WH_PORT
inverter_1 | R12 | 1 | INV1_PWM_WH_PORT
inverter_1 | R13 | 1 | INV1_PWM_WL
inverter_1 | R14 | 2 | GND
inverter_1 | R13 | 2 | INV1_PWM_WL_PORT
inverter_1 | R14 | 1 | INV1_PWM_WL_PORT
inverter_1 | R15 | 1 | INV1_ENABLE
inverter_1 | R16 | 2 | GND
inverter_1 | R15 | 2 | INV1_ENABLE_PORT
inverter_1 | R16 | 1 | INV1_ENABLE_PORT
inverter_1 | R17 | 1 | INV1_FAULT_N
inverter_1 | R18 | 2 | +3V3_MCU
inverter_1 | R17 | 2 | INV1_FAULT_N_PORT
inverter_1 | R18 | 1 | INV1_FAULT_N_PORT
inverter_1 | R19 | 1 | INV1_I_U_PORT
inverter_1 | C12 | 2 | GND
inverter_1 | R19 | 2 | INV1_I_U
inverter_1 | C12 | 1 | INV1_I_U
inverter_1 | R20 | 1 | INV1_I_V_PORT
inverter_1 | C13 | 2 | GND
inverter_1 | R20 | 2 | INV1_I_V
inverter_1 | C13 | 1 | INV1_I_V
inverter_1 | R21 | 1 | INV1_I_W_PORT
inverter_1 | C14 | 2 | GND
inverter_1 | R21 | 2 | INV1_I_W
inverter_1 | C14 | 1 | INV1_I_W
inverter_1 | R22 | 1 | INV1_V_DC_PORT
inverter_1 | C15 | 2 | GND
inverter_1 | R22 | 2 | INV1_V_DC
inverter_1 | C15 | 1 | INV1_V_DC
inverter_1 | R23 | 1 | INV1_V_U_PORT
inverter_1 | C16 | 2 | GND
inverter_1 | R23 | 2 | INV1_V_U
inverter_1 | C16 | 1 | INV1_V_U
inverter_1 | R24 | 1 | INV1_V_V_PORT
inverter_1 | C17 | 2 | GND
inverter_1 | R24 | 2 | INV1_V_V
inverter_1 | C17 | 1 | INV1_V_V
inverter_1 | R25 | 1 | INV1_V_W_PORT
inverter_1 | C18 | 2 | GND
inverter_1 | R25 | 2 | INV1_V_W
inverter_1 | C18 | 1 | INV1_V_W
inverter_1 | R26 | 1 | INV1_TEMP_NTC_PORT
inverter_1 | C19 | 2 | GND
inverter_1 | R26 | 2 | INV1_TEMP_NTC
inverter_1 | C19 | 1 | INV1_TEMP_NTC
inverter_1 | R27 | 1 | BRAKE_1
inverter_1 | R28 | 2 | GND
inverter_1 | R27 | 2 | BRAKE_1_PORT
inverter_1 | R28 | 1 | BRAKE_1_PORT
inverter_1 | J3 | 1 | BRAKE_1_PORT
inverter_1 | J3 | 2 | GND
inverter_2 | J4 | 1 | INV2_PWM_UH_PORT
inverter_2 | J4 | 2 | INV2_PWM_UL_PORT
inverter_2 | J4 | 3 | GND
inverter_2 | J4 | 4 | INV2_PWM_VH_PORT
inverter_2 | J4 | 5 | INV2_PWM_VL_PORT
inverter_2 | J4 | 6 | GND
inverter_2 | J4 | 7 | INV2_PWM_WH_PORT
inverter_2 | J4 | 8 | INV2_PWM_WL_PORT
inverter_2 | J4 | 9 | GND
inverter_2 | J4 | 10 | INV2_ENABLE_PORT
inverter_2 | J4 | 11 | INV2_FAULT_N_PORT
inverter_2 | J4 | 13 | GND
inverter_2 | J4 | 14 | INV2_I_U_PORT
inverter_2 | J4 | 15 | INV2_I_V_PORT
inverter_2 | J4 | 16 | INV2_I_W_PORT
inverter_2 | J4 | 17 | GND
inverter_2 | J4 | 18 | INV2_V_DC_PORT
inverter_2 | J4 | 19 | INV2_V_U_PORT
inverter_2 | J4 | 20 | INV2_V_V_PORT
inverter_2 | J4 | 21 | GND
inverter_2 | J4 | 22 | INV2_V_W_PORT
inverter_2 | J4 | 23 | INV2_TEMP_NTC_PORT
inverter_2 | R29 | 1 | INV2_PWM_UH
inverter_2 | R30 | 2 | GND
inverter_2 | R29 | 2 | INV2_PWM_UH_PORT
inverter_2 | R30 | 1 | INV2_PWM_UH_PORT
inverter_2 | R31 | 1 | INV2_PWM_UL
inverter_2 | R32 | 2 | GND
inverter_2 | R31 | 2 | INV2_PWM_UL_PORT
inverter_2 | R32 | 1 | INV2_PWM_UL_PORT
inverter_2 | R33 | 1 | INV2_PWM_VH
inverter_2 | R34 | 2 | GND
inverter_2 | R33 | 2 | INV2_PWM_VH_PORT
inverter_2 | R34 | 1 | INV2_PWM_VH_PORT
inverter_2 | R35 | 1 | INV2_PWM_VL
inverter_2 | R36 | 2 | GND
inverter_2 | R35 | 2 | INV2_PWM_VL_PORT
inverter_2 | R36 | 1 | INV2_PWM_VL_PORT
inverter_2 | R37 | 1 | INV2_PWM_WH
inverter_2 | R38 | 2 | GND
inverter_2 | R37 | 2 | INV2_PWM_WH_PORT
inverter_2 | R38 | 1 | INV2_PWM_WH_PORT
inverter_2 | R39 | 1 | INV2_PWM_WL
inverter_2 | R40 | 2 | GND
inverter_2 | R39 | 2 | INV2_PWM_WL_PORT
inverter_2 | R40 | 1 | INV2_PWM_WL_PORT
inverter_2 | R41 | 1 | INV2_ENABLE
inverter_2 | R42 | 2 | GND
inverter_2 | R41 | 2 | INV2_ENABLE_PORT
inverter_2 | R42 | 1 | INV2_ENABLE_PORT
inverter_2 | R43 | 1 | INV2_FAULT_N
inverter_2 | R44 | 2 | +3V3_MCU
inverter_2 | R43 | 2 | INV2_FAULT_N_PORT
inverter_2 | R44 | 1 | INV2_FAULT_N_PORT
inverter_2 | R45 | 1 | INV2_I_U_PORT
inverter_2 | C20 | 2 | GND
inverter_2 | R45 | 2 | INV2_I_U
inverter_2 | C20 | 1 | INV2_I_U
inverter_2 | R46 | 1 | INV2_I_V_PORT
inverter_2 | C21 | 2 | GND
inverter_2 | R46 | 2 | INV2_I_V
inverter_2 | C21 | 1 | INV2_I_V
inverter_2 | R47 | 1 | INV2_I_W_PORT
inverter_2 | C22 | 2 | GND
inverter_2 | R47 | 2 | INV2_I_W
inverter_2 | C22 | 1 | INV2_I_W
inverter_2 | R48 | 1 | INV2_V_DC_PORT
inverter_2 | C23 | 2 | GND
inverter_2 | R48 | 2 | INV2_V_DC
inverter_2 | C23 | 1 | INV2_V_DC
inverter_2 | R49 | 1 | INV2_V_U_PORT
inverter_2 | C24 | 2 | GND
inverter_2 | R49 | 2 | INV2_V_U
inverter_2 | C24 | 1 | INV2_V_U
inverter_2 | R50 | 1 | INV2_V_V_PORT
inverter_2 | C25 | 2 | GND
inverter_2 | R50 | 2 | INV2_V_V
inverter_2 | C25 | 1 | INV2_V_V
inverter_2 | R51 | 1 | INV2_V_W_PORT
inverter_2 | C26 | 2 | GND
inverter_2 | R51 | 2 | INV2_V_W
inverter_2 | C26 | 1 | INV2_V_W
inverter_2 | R52 | 1 | INV2_TEMP_NTC_PORT
inverter_2 | C27 | 2 | GND
inverter_2 | R52 | 2 | INV2_TEMP_NTC
inverter_2 | C27 | 1 | INV2_TEMP_NTC
inverter_2 | R53 | 1 | BRAKE_2
inverter_2 | R54 | 2 | GND
inverter_2 | R53 | 2 | BRAKE_2_PORT
inverter_2 | R54 | 1 | BRAKE_2_PORT
inverter_2 | J5 | 1 | BRAKE_2_PORT
inverter_2 | J5 | 2 | GND
pfc | J6 | 1 | PFC_PWM_A1_PORT
pfc | J6 | 2 | PFC_PWM_A2_PORT
pfc | J6 | 3 | GND
pfc | J6 | 4 | PFC_PWM_B1_PORT
pfc | J6 | 5 | PFC_PWM_B2_PORT
pfc | J6 | 6 | GND
pfc | J6 | 7 | PFC_PWM_C1_PORT
pfc | J6 | 8 | PFC_PWM_C2_PORT
pfc | J6 | 9 | GND
pfc | J6 | 10 | PFC_ENABLE_PORT
pfc | J6 | 11 | PFC_FAULT_N_PORT
pfc | J6 | 12 | PFC_V_BUS_LOWER_PORT
pfc | J6 | 13 | GND
pfc | J6 | 14 | PFC_I_A_PORT
pfc | J6 | 15 | PFC_I_B_PORT
pfc | J6 | 16 | PFC_I_C_PORT
pfc | J6 | 17 | GND
pfc | J6 | 18 | PFC_V_BUS_UPPER_PORT
pfc | J6 | 19 | PFC_V_A_PORT
pfc | J6 | 20 | PFC_V_B_PORT
pfc | J6 | 21 | GND
pfc | J6 | 22 | PFC_V_C_PORT
pfc | J6 | 23 | PFC_TEMP_NTC_PORT
pfc | J6 | 24 | PFC_PRECHARGE_PORT
pfc | R55 | 1 | PFC_PWM_A1
pfc | R56 | 2 | GND
pfc | R55 | 2 | PFC_PWM_A1_PORT
pfc | R56 | 1 | PFC_PWM_A1_PORT
pfc | R57 | 1 | PFC_PWM_A2
pfc | R58 | 2 | GND
pfc | R57 | 2 | PFC_PWM_A2_PORT
pfc | R58 | 1 | PFC_PWM_A2_PORT
pfc | R59 | 1 | PFC_PWM_B1
pfc | R60 | 2 | GND
pfc | R59 | 2 | PFC_PWM_B1_PORT
pfc | R60 | 1 | PFC_PWM_B1_PORT
pfc | R61 | 1 | PFC_PWM_B2
pfc | R62 | 2 | GND
pfc | R61 | 2 | PFC_PWM_B2_PORT
pfc | R62 | 1 | PFC_PWM_B2_PORT
pfc | R63 | 1 | PFC_PWM_C1
pfc | R64 | 2 | GND
pfc | R63 | 2 | PFC_PWM_C1_PORT
pfc | R64 | 1 | PFC_PWM_C1_PORT
pfc | R65 | 1 | PFC_PWM_C2
pfc | R66 | 2 | GND
pfc | R65 | 2 | PFC_PWM_C2_PORT
pfc | R66 | 1 | PFC_PWM_C2_PORT
pfc | R67 | 1 | PFC_ENABLE
pfc | R68 | 2 | GND
pfc | R67 | 2 | PFC_ENABLE_PORT
pfc | R68 | 1 | PFC_ENABLE_PORT
pfc | R69 | 1 | PFC_PRECHARGE
pfc | R70 | 2 | GND
pfc | R69 | 2 | PFC_PRECHARGE_PORT
pfc | R70 | 1 | PFC_PRECHARGE_PORT
pfc | R71 | 1 | PFC_FAULT_N
pfc | R72 | 2 | +3V3_MCU
pfc | R71 | 2 | PFC_FAULT_N_PORT
pfc | R72 | 1 | PFC_FAULT_N_PORT
pfc | R73 | 1 | PFC_V_BUS_LOWER_PORT
pfc | C28 | 2 | GND
pfc | R73 | 2 | PFC_V_BUS_LOWER
pfc | C28 | 1 | PFC_V_BUS_LOWER
pfc | R74 | 1 | PFC_I_A_PORT
pfc | C29 | 2 | GND
pfc | R74 | 2 | PFC_I_A
pfc | C29 | 1 | PFC_I_A
pfc | R75 | 1 | PFC_I_B_PORT
pfc | C30 | 2 | GND
pfc | R75 | 2 | PFC_I_B
pfc | C30 | 1 | PFC_I_B
pfc | R76 | 1 | PFC_I_C_PORT
pfc | C31 | 2 | GND
pfc | R76 | 2 | PFC_I_C
pfc | C31 | 1 | PFC_I_C
pfc | R77 | 1 | PFC_V_BUS_UPPER_PORT
pfc | C32 | 2 | GND
pfc | R77 | 2 | PFC_V_BUS_UPPER
pfc | C32 | 1 | PFC_V_BUS_UPPER
pfc | R78 | 1 | PFC_V_A_PORT
pfc | C33 | 2 | GND
pfc | R78 | 2 | PFC_V_A
pfc | C33 | 1 | PFC_V_A
pfc | R79 | 1 | PFC_V_B_PORT
pfc | C34 | 2 | GND
pfc | R79 | 2 | PFC_V_B
pfc | C34 | 1 | PFC_V_B
pfc | R80 | 1 | PFC_V_C_PORT
pfc | C35 | 2 | GND
pfc | R80 | 2 | PFC_V_C
pfc | C35 | 1 | PFC_V_C
pfc | R81 | 1 | PFC_TEMP_NTC_PORT
pfc | C36 | 2 | GND
pfc | R81 | 2 | PFC_TEMP_NTC
pfc | C36 | 1 | PFC_TEMP_NTC
sensors | J7 | 1 | ENC1_A_PORT
sensors | R82 | 1 | ENC1_A_PORT
sensors | R82 | 2 | ENC1_A
sensors | R83 | 1 | ENC1_A
sensors | R83 | 2 | GND
sensors | J7 | 2 | ENC1_B_PORT
sensors | R84 | 1 | ENC1_B_PORT
sensors | R84 | 2 | ENC1_B
sensors | R85 | 1 | ENC1_B
sensors | R85 | 2 | GND
sensors | J7 | 3 | ENC1_Z_PORT
sensors | R86 | 1 | ENC1_Z_PORT
sensors | R86 | 2 | ENC1_Z
sensors | R87 | 1 | ENC1_Z
sensors | R87 | 2 | GND
sensors | J7 | 4 | GND
sensors | J7 | 5 | ENC1_VOPT
sensors | R88 | 1 | +3V3_MCU
sensors | R88 | 2 | ENC1_VOPT
sensors | C37 | 1 | ENC1_VOPT
sensors | C37 | 2 | GND
sensors | J8 | 1 | ENC2_A_PORT
sensors | R89 | 1 | ENC2_A_PORT
sensors | R89 | 2 | ENC2_A
sensors | R90 | 1 | ENC2_A
sensors | R90 | 2 | GND
sensors | J8 | 2 | ENC2_B_PORT
sensors | R91 | 1 | ENC2_B_PORT
sensors | R91 | 2 | ENC2_B
sensors | R92 | 1 | ENC2_B
sensors | R92 | 2 | GND
sensors | J8 | 3 | ENC2_Z_PORT
sensors | R93 | 1 | ENC2_Z_PORT
sensors | R93 | 2 | ENC2_Z
sensors | R94 | 1 | ENC2_Z
sensors | R94 | 2 | GND
sensors | J8 | 4 | GND
sensors | J8 | 5 | ENC2_VOPT
sensors | R95 | 1 | +3V3_MCU
sensors | R95 | 2 | ENC2_VOPT
sensors | C38 | 1 | ENC2_VOPT
sensors | C38 | 2 | GND
spi | J9 | 1 | SPI_A_SCK_PORT
spi | R96 | 1 | SPI_A_SCK
spi | R96 | 2 | SPI_A_SCK_PORT
spi | J9 | 2 | SPI_A_MOSI_PORT
spi | R97 | 1 | SPI_A_MOSI
spi | R97 | 2 | SPI_A_MOSI_PORT
spi | J9 | 3 | SPI_A_MISO_PORT
spi | R98 | 1 | SPI_A_MISO_PORT
spi | R98 | 2 | SPI_A_MISO
spi | J9 | 4 | SPI_A_CS_N_PORT
spi | R99 | 1 | SPI_A_CS_N
spi | R99 | 2 | SPI_A_CS_N_PORT
spi | J9 | 5 | GND
spi | J9 | 6 | SPI_A_VOPT
spi | R100 | 1 | SPI_A_CS_N_PORT
spi | R100 | 2 | +3V3_MCU
spi | R101 | 1 | +3V3_MCU
spi | R101 | 2 | SPI_A_VOPT
spi | C39 | 1 | SPI_A_VOPT
spi | C39 | 2 | GND
spi | J10 | 1 | SPI_B_SCK_PORT
spi | R102 | 1 | SPI_B_SCK
spi | R102 | 2 | SPI_B_SCK_PORT
spi | J10 | 2 | SPI_B_MOSI_PORT
spi | R103 | 1 | SPI_B_MOSI
spi | R103 | 2 | SPI_B_MOSI_PORT
spi | J10 | 3 | SPI_B_MISO_PORT
spi | R104 | 1 | SPI_B_MISO_PORT
spi | R104 | 2 | SPI_B_MISO
spi | J10 | 4 | SPI_B_CS_N_PORT
spi | R105 | 1 | SPI_B_CS_N
spi | R105 | 2 | SPI_B_CS_N_PORT
spi | J10 | 5 | GND
spi | J10 | 6 | SPI_B_VOPT
spi | R106 | 1 | SPI_B_CS_N_PORT
spi | R106 | 2 | +3V3_MCU
spi | R107 | 1 | +3V3_MCU
spi | R107 | 2 | SPI_B_VOPT
spi | C40 | 1 | SPI_B_VOPT
spi | C40 | 2 | GND
debug_comms | J11 | 1 | +3V3_MCU
debug_comms | J11 | 2 | SWDIO_PORT
debug_comms | J11 | 3 | SWCLK_PORT
debug_comms | J11 | 4 | GND
debug_comms | J11 | 5 | MCU_NRST
debug_comms | R108 | 1 | SWDIO_PORT
debug_comms | R108 | 2 | SWDIO
debug_comms | R109 | 1 | SWCLK_PORT
debug_comms | R109 | 2 | SWCLK
debug_comms | R110 | 1 | SWDIO
debug_comms | R110 | 2 | +3V3_MCU
debug_comms | R111 | 1 | SWCLK
debug_comms | R111 | 2 | GND
debug_comms | J12 | 1 | UART_TX_PORT
debug_comms | J12 | 2 | UART_RX_PORT
debug_comms | J12 | 3 | GND
debug_comms | R112 | 1 | UART_TX
debug_comms | R112 | 2 | UART_TX_PORT
debug_comms | R113 | 1 | UART_RX_PORT
debug_comms | R113 | 2 | UART_RX
debug_comms | R114 | 1 | UART_RX
debug_comms | R114 | 2 | +3V3_MCU
debug_comms | U4 | 1 | CAN_TX_PHY
debug_comms | U4 | 4 | CAN_RX_PHY
debug_comms | U4 | 3 | +3V3_MCU
debug_comms | U4 | 2 | GND
debug_comms | U4 | 6 | CAN_L
debug_comms | U4 | 7 | CAN_H
debug_comms | R115 | 1 | CAN_TX
debug_comms | R115 | 2 | CAN_TX_PHY
debug_comms | R116 | 1 | CAN_RX_PHY
debug_comms | R116 | 2 | CAN_RX
debug_comms | R117 | 1 | CAN_TX_PHY
debug_comms | R117 | 2 | +3V3_MCU
debug_comms | C41 | 1 | +3V3_MCU
debug_comms | C41 | 2 | GND
debug_comms | J13 | 1 | CAN_H
debug_comms | J13 | 2 | CAN_L
debug_comms | J13 | 3 | GND
debug_comms | R118 | 1 | CAN_H
debug_comms | R118 | 2 | CAN_L
debug_comms | R119 | 1 | +3V3_MCU
debug_comms | R119 | 2 | PWR_ANODE
debug_comms | D1 | 2 | PWR_ANODE
debug_comms | D1 | 1 | GND
debug_comms | R120 | 1 | +3V3_MCU
debug_comms | R120 | 2 | LED_RUN1_ANODE
debug_comms | D2 | 2 | LED_RUN1_ANODE
debug_comms | D2 | 1 | LED_RUN1
debug_comms | R121 | 1 | +3V3_MCU
debug_comms | R121 | 2 | LED_RUN2_ANODE
debug_comms | D3 | 2 | LED_RUN2_ANODE
debug_comms | D3 | 1 | LED_RUN2
debug_comms | R122 | 1 | +3V3_MCU
debug_comms | R122 | 2 | LED_FAULT_ANODE
debug_comms | D4 | 2 | LED_FAULT_ANODE
debug_comms | D4 | 1 | LED_FAULT
debug_comms | R123 | 1 | +3V3_MCU
debug_comms | R123 | 2 | LED_COMM_ANODE
debug_comms | D5 | 2 | LED_COMM_ANODE
debug_comms | D5 | 1 | LED_COMM
