leolei2012/power_system/inverter/hardware/review/expected_pin_nets.csv

Sheet | Reference | Pin | Net
aux_input | J2 | 1 | AUX_IN
aux_input | J2 | 2 | GND
aux_input | F2 | 1 | AUX_IN
aux_input | F2 | 2 | AUX_FUSED
aux_input | C1 | 1 | AUX_FUSED
aux_input | C1 | 2 | GND
aux_input | U1 | 1 | AUX_FUSED
aux_input | U1 | 2 | AUX_FUSED
aux_input | U1 | 3 | AUX_UV_DIV
aux_input | U1 | 5 | AUX_OV_DIV
aux_input | U1 | 6 | AUX_MODE
aux_input | U1 | 7 | AUX_SHDN_N
aux_input | U1 | 8 | EFUSE_RTN
aux_input | U1 | 9 | GND
aux_input | U1 | 11 | AUX_ILIM
aux_input | U1 | 12 | AUX_DVDT
aux_input | U1 | 14 | AUX_FLT_N
aux_input | U1 | 15 | AUX_PROTECTED
aux_input | U1 | 16 | AUX_PROTECTED
aux_input | U1 | 17 | EFUSE_RTN
aux_input | R1 | 1 | AUX_FUSED
aux_input | R1 | 2 | AUX_UV_DIV
aux_input | R2 | 1 | AUX_UV_DIV
aux_input | R2 | 2 | EFUSE_RTN
aux_input | R3 | 1 | AUX_FUSED
aux_input | R3 | 2 | AUX_OV_DIV
aux_input | R4 | 1 | AUX_OV_DIV
aux_input | R4 | 2 | EFUSE_RTN
aux_input | R5 | 1 | AUX_MODE
aux_input | R5 | 2 | EFUSE_RTN
aux_input | R6 | 1 | AUX_ILIM
aux_input | R6 | 2 | EFUSE_RTN
aux_input | C2 | 1 | AUX_DVDT
aux_input | C2 | 2 | EFUSE_RTN
aux_input | R7 | 1 | AUX_FLT_N
aux_input | R7 | 2 | +3V3_INV
aux_input | C3 | 1 | AUX_PROTECTED
aux_input | C3 | 2 | GND
aux_input | R8 | 1 | AUX_FUSED
aux_input | R8 | 2 | AUX_SHDN_N
aux_input | SW1 | 1 | AUX_SHDN_N
aux_input | SW1 | 2 | EFUSE_RTN
supply_12v | U2 | 1 | GND
supply_12v | U2 | 2 | BB_L1
supply_12v | U2 | 3 | BB_BST1
supply_12v | U2 | 4 | AUX_PROTECTED
supply_12v | U2 | 5 | AUX_PROTECTED
supply_12v | U2 | 6 | AUX_PROTECTED
supply_12v | U2 | 7 | GND
supply_12v | U2 | 8 | GND
supply_12v | U2 | 9 | GND
supply_12v | U2 | 10 | BB_PG_DLY
supply_12v | U2 | 11 | BB_VREG
supply_12v | U2 | 12 | BB_VREG
supply_12v | U2 | 13 | GND
supply_12v | U2 | 14 | BB_VREG
supply_12v | U2 | 15 | DRV_PG_NOM
supply_12v | U2 | 16 | +12V_DRV
supply_12v | U2 | 17 | +12V_DRV
supply_12v | U2 | 18 | GND
supply_12v | U2 | 19 | BB_BST2
supply_12v | U2 | 20 | BB_L2
supply_12v | U2 | 21 | GND
supply_12v | L1 | 1 | BB_L1
supply_12v | L1 | 2 | BB_L2
supply_12v | C4 | 1 | BB_BST1
supply_12v | C4 | 2 | BB_L1
supply_12v | C5 | 1 | BB_BST2
supply_12v | C5 | 2 | BB_L2
supply_12v | C6 | 1 | AUX_PROTECTED
supply_12v | C6 | 2 | GND
supply_12v | C7 | 1 | AUX_PROTECTED
supply_12v | C7 | 2 | GND
supply_12v | C8 | 1 | +12V_DRV
supply_12v | C8 | 2 | GND
supply_12v | C9 | 1 | +12V_DRV
supply_12v | C9 | 2 | GND
supply_12v | C10 | 1 | BB_VREG
supply_12v | C10 | 2 | GND
supply_12v | R9 | 1 | BB_PG_DLY
supply_12v | R9 | 2 | GND
supply_12v | R10 | 1 | +5V_INV
supply_12v | R10 | 2 | DRV_PG_NOM
supply_12v | R11 | 1 | DRV_PG_NOM
supply_12v | R11 | 2 | DRV_PG_LOGIC
supply_12v | R12 | 1 | DRV_PG_LOGIC
supply_12v | R12 | 2 | GND
supply_12v | TP1 | 1 | +12V_DRV
supply_12v | TP2 | 1 | BB_VREG
supply_12v | TP3 | 1 | DRV_PG_LOGIC
supply_logic | U3 | 1 | +5V_INV
supply_logic | U3 | 2 | AUX_PROTECTED
supply_logic | U3 | 3 | AUX_PROTECTED
supply_logic | U3 | 4 | GND
supply_logic | U3 | 5 | BUCK_SW
supply_logic | U3 | 6 | BUCK_BST
supply_logic | C11 | 1 | AUX_PROTECTED
supply_logic | C11 | 2 | GND
supply_logic | C12 | 1 | BUCK_BST
supply_logic | C12 | 2 | BUCK_SW
supply_logic | L2 | 1 | BUCK_SW
supply_logic | L2 | 2 | +5V_INV
supply_logic | C13 | 1 | +5V_INV
supply_logic | C13 | 2 | GND
supply_logic | C14 | 1 | +5V_INV
supply_logic | C14 | 2 | GND
supply_logic | U4 | 1 | +5V_INV
supply_logic | U4 | 2 | GND
supply_logic | U4 | 3 | +5V_INV
supply_logic | U4 | 5 | +3V3_INV
supply_logic | C15 | 1 | +5V_INV
supply_logic | C15 | 2 | GND
supply_logic | C16 | 1 | +3V3_INV
supply_logic | C16 | 2 | GND
supply_logic | U6 | 1 | LOGIC_POWER_OK
supply_logic | U6 | 2 | GND
supply_logic | U6 | 3 | +3V3_INV
supply_logic | U6 | 5 | +3V3_INV
supply_logic | U6 | 6 | +3V3_INV
supply_logic | R13 | 1 | LOGIC_POWER_OK
supply_logic | R13 | 2 | +3V3_INV
supply_logic | C17 | 1 | +3V3_INV
supply_logic | C17 | 2 | GND
supply_logic | U5 | 1 | +5V_INV
supply_logic | U5 | 2 | GND
supply_logic | U5 | 3 | +5V_INV
supply_logic | U5 | 4 | SENSOR_PWR_FLT_N
supply_logic | U5 | 5 | SENSOR_ILIM
supply_logic | U5 | 6 | +5V_SENSOR
supply_logic | R14 | 1 | SENSOR_ILIM
supply_logic | R14 | 2 | GND
supply_logic | R15 | 1 | SENSOR_PWR_FLT_N
supply_logic | R15 | 2 | +3V3_INV
supply_logic | C18 | 1 | +5V_SENSOR
supply_logic | C18 | 2 | GND
supply_logic | J7 | 1 | +5V_SENSOR
supply_logic | J7 | 2 | GND
supply_logic | TP4 | 1 | SENSOR_PWR_FLT_N
bus_brake | J3 | 1 | DC_INPUT_POS
bus_brake | J3 | 2 | GND
bus_brake | F1 | 1 | DC_INPUT_POS
bus_brake | F1 | 2 | DC_FUSED
bus_brake | D1 | 1 | DC_FUSED
bus_brake | D1 | 3 | DC_FUSED
bus_brake | D1 | 2 | VBUS
bus_brake | C19 | 1 | VBUS
bus_brake | C19 | 2 | GND
bus_brake | C20 | 1 | VBUS
bus_brake | C20 | 2 | GND
bus_brake | C21 | 1 | VBUS
bus_brake | C21 | 2 | GND
bus_brake | C22 | 1 | VBUS
bus_brake | C22 | 2 | GND
bus_brake | D2 | 1 | VBUS
bus_brake | D2 | 2 | GND
bus_brake | J4 | 1 | U_PHASE
bus_brake | J4 | 2 | V_PHASE
bus_brake | J4 | 3 | W_PHASE
bus_brake | J5 | 1 | VBUS
bus_brake | J5 | 2 | BR_SW
bus_brake | R16 | 1 | BRAKE_IN
bus_brake | R16 | 2 | GND
bus_brake | U29 | 1 | +12V_DRV
bus_brake | U29 | 2 | GND
bus_brake | U29 | 3 | BRAKE_IN
bus_brake | U29 | 4 | GND
bus_brake | U29 | 5 | BR_DRV
bus_brake | C23 | 1 | +12V_DRV
bus_brake | C23 | 2 | GND
bus_brake | C24 | 1 | +12V_DRV
bus_brake | C24 | 2 | GND
bus_brake | Q7 | 4 | BR_GATE
bus_brake | Q7 | 5 | BR_SW
bus_brake | Q7 | 6 | BR_SW
bus_brake | Q7 | 7 | BR_SW
bus_brake | Q7 | 8 | BR_SW
bus_brake | Q7 | 1 | GND
bus_brake | Q7 | 2 | GND
bus_brake | Q7 | 3 | GND
bus_brake | R17 | 1 | BR_DRV
bus_brake | R17 | 2 | BR_GATE
bus_brake | R18 | 1 | BR_GATE
bus_brake | R18 | 2 | GND
bridge_u | U7 | 1 | U_HIN
bridge_u | U7 | 2 | U_LIN
bridge_u | U7 | 3 | U_SOURCE
bridge_u | U7 | 4 | U_LO
bridge_u | U7 | 5 | +12V_DRV
bridge_u | U7 | 6 | U_PHASE
bridge_u | U7 | 7 | U_HO
bridge_u | U7 | 8 | U_BOOT
bridge_u | Q1 | 4 | U_GATE_H
bridge_u | Q1 | 5 | VBUS
bridge_u | Q1 | 6 | VBUS
bridge_u | Q1 | 7 | VBUS
bridge_u | Q1 | 8 | VBUS
bridge_u | Q2 | 4 | U_GATE_L
bridge_u | Q1 | 1 | U_PHASE
bridge_u | Q1 | 2 | U_PHASE
bridge_u | Q1 | 3 | U_PHASE
bridge_u | Q2 | 5 | U_PHASE
bridge_u | Q2 | 6 | U_PHASE
bridge_u | Q2 | 7 | U_PHASE
bridge_u | Q2 | 8 | U_PHASE
bridge_u | R19 | 1 | U_HO
bridge_u | R19 | 2 | U_GATE_H
bridge_u | R20 | 1 | U_LO
bridge_u | R20 | 2 | U_GATE_L
bridge_u | R21 | 1 | U_GATE_H
bridge_u | R21 | 2 | U_PHASE
bridge_u | R22 | 1 | U_GATE_L
bridge_u | R22 | 2 | U_SOURCE
bridge_u | C25 | 1 | U_BOOT
bridge_u | C25 | 2 | U_PHASE
bridge_u | C26 | 1 | U_BOOT
bridge_u | C26 | 2 | U_PHASE
bridge_u | C27 | 1 | +12V_DRV
bridge_u | C27 | 2 | U_SOURCE
bridge_u | C28 | 1 | +12V_DRV
bridge_u | C28 | 2 | U_SOURCE
bridge_u | R23 | 1 | U_HIN
bridge_u | R23 | 2 | U_SOURCE
bridge_u | R24 | 1 | U_LIN
bridge_u | R24 | 2 | U_SOURCE
bridge_u | Q2 | 1 | U_SOURCE
bridge_u | Q2 | 2 | U_SOURCE
bridge_u | Q2 | 3 | U_SOURCE
bridge_u | RS1 | 1 | U_SOURCE
bridge_u | RS1 | 2 | GND
bridge_u | TP5 | 1 | U_PHASE
bridge_u | TP6 | 1 | U_SOURCE
bridge_v | U8 | 1 | V_HIN
bridge_v | U8 | 2 | V_LIN
bridge_v | U8 | 3 | V_SOURCE
bridge_v | U8 | 4 | V_LO
bridge_v | U8 | 5 | +12V_DRV
bridge_v | U8 | 6 | V_PHASE
bridge_v | U8 | 7 | V_HO
bridge_v | U8 | 8 | V_BOOT
bridge_v | Q3 | 4 | V_GATE_H
bridge_v | Q3 | 5 | VBUS
bridge_v | Q3 | 6 | VBUS
bridge_v | Q3 | 7 | VBUS
bridge_v | Q3 | 8 | VBUS
bridge_v | Q4 | 4 | V_GATE_L
bridge_v | Q3 | 1 | V_PHASE
bridge_v | Q3 | 2 | V_PHASE
bridge_v | Q3 | 3 | V_PHASE
bridge_v | Q4 | 5 | V_PHASE
bridge_v | Q4 | 6 | V_PHASE
bridge_v | Q4 | 7 | V_PHASE
bridge_v | Q4 | 8 | V_PHASE
bridge_v | R25 | 1 | V_HO
bridge_v | R25 | 2 | V_GATE_H
bridge_v | R26 | 1 | V_LO
bridge_v | R26 | 2 | V_GATE_L
bridge_v | R27 | 1 | V_GATE_H
bridge_v | R27 | 2 | V_PHASE
bridge_v | R28 | 1 | V_GATE_L
bridge_v | R28 | 2 | V_SOURCE
bridge_v | C29 | 1 | V_BOOT
bridge_v | C29 | 2 | V_PHASE
bridge_v | C30 | 1 | V_BOOT
bridge_v | C30 | 2 | V_PHASE
bridge_v | C31 | 1 | +12V_DRV
bridge_v | C31 | 2 | V_SOURCE
bridge_v | C32 | 1 | +12V_DRV
bridge_v | C32 | 2 | V_SOURCE
bridge_v | R29 | 1 | V_HIN
bridge_v | R29 | 2 | V_SOURCE
bridge_v | R30 | 1 | V_LIN
bridge_v | R30 | 2 | V_SOURCE
bridge_v | Q4 | 1 | V_SOURCE
bridge_v | Q4 | 2 | V_SOURCE
bridge_v | Q4 | 3 | V_SOURCE
bridge_v | RS2 | 1 | V_SOURCE
bridge_v | RS2 | 2 | GND
bridge_v | TP7 | 1 | V_PHASE
bridge_v | TP8 | 1 | V_SOURCE
bridge_w | U9 | 1 | W_HIN
bridge_w | U9 | 2 | W_LIN
bridge_w | U9 | 3 | W_SOURCE
bridge_w | U9 | 4 | W_LO
bridge_w | U9 | 5 | +12V_DRV
bridge_w | U9 | 6 | W_PHASE
bridge_w | U9 | 7 | W_HO
bridge_w | U9 | 8 | W_BOOT
bridge_w | Q5 | 4 | W_GATE_H
bridge_w | Q5 | 5 | VBUS
bridge_w | Q5 | 6 | VBUS
bridge_w | Q5 | 7 | VBUS
bridge_w | Q5 | 8 | VBUS
bridge_w | Q6 | 4 | W_GATE_L
bridge_w | Q5 | 1 | W_PHASE
bridge_w | Q5 | 2 | W_PHASE
bridge_w | Q5 | 3 | W_PHASE
bridge_w | Q6 | 5 | W_PHASE
bridge_w | Q6 | 6 | W_PHASE
bridge_w | Q6 | 7 | W_PHASE
bridge_w | Q6 | 8 | W_PHASE
bridge_w | R31 | 1 | W_HO
bridge_w | R31 | 2 | W_GATE_H
bridge_w | R32 | 1 | W_LO
bridge_w | R32 | 2 | W_GATE_L
bridge_w | R33 | 1 | W_GATE_H
bridge_w | R33 | 2 | W_PHASE
bridge_w | R34 | 1 | W_GATE_L
bridge_w | R34 | 2 | W_SOURCE
bridge_w | C33 | 1 | W_BOOT
bridge_w | C33 | 2 | W_PHASE
bridge_w | C34 | 1 | W_BOOT
bridge_w | C34 | 2 | W_PHASE
bridge_w | C35 | 1 | +12V_DRV
bridge_w | C35 | 2 | W_SOURCE
bridge_w | C36 | 1 | +12V_DRV
bridge_w | C36 | 2 | W_SOURCE
bridge_w | R35 | 1 | W_HIN
bridge_w | R35 | 2 | W_SOURCE
bridge_w | R36 | 1 | W_LIN
bridge_w | R36 | 2 | W_SOURCE
bridge_w | Q6 | 1 | W_SOURCE
bridge_w | Q6 | 2 | W_SOURCE
bridge_w | Q6 | 3 | W_SOURCE
bridge_w | RS3 | 1 | W_SOURCE
bridge_w | RS3 | 2 | GND
bridge_w | TP9 | 1 | W_PHASE
bridge_w | TP10 | 1 | W_SOURCE
current_sense | U10 | 1 | GND
current_sense | U10 | 5 | I_U
current_sense | U10 | 6 | +3V3_INV
current_sense | U10 | 8 | U_SOURCE
current_sense | U10 | 2 | GND
current_sense | U10 | 4 | GND
current_sense | U10 | 3 | VBIAS_1V65
current_sense | U10 | 7 | VBIAS_1V65
current_sense | R37 | 1 | I_U
current_sense | R37 | 2 | I_U_PORT
current_sense | C37 | 1 | +3V3_INV
current_sense | C37 | 2 | GND
current_sense | TP11 | 1 | I_U
current_sense | U11 | 1 | GND
current_sense | U11 | 5 | I_V
current_sense | U11 | 6 | +3V3_INV
current_sense | U11 | 8 | V_SOURCE
current_sense | U11 | 2 | GND
current_sense | U11 | 4 | GND
current_sense | U11 | 3 | VBIAS_1V65
current_sense | U11 | 7 | VBIAS_1V65
current_sense | R38 | 1 | I_V
current_sense | R38 | 2 | I_V_PORT
current_sense | C38 | 1 | +3V3_INV
current_sense | C38 | 2 | GND
current_sense | TP12 | 1 | I_V
current_sense | U12 | 1 | GND
current_sense | U12 | 5 | I_W
current_sense | U12 | 6 | +3V3_INV
current_sense | U12 | 8 | W_SOURCE
current_sense | U12 | 2 | GND
current_sense | U12 | 4 | GND
current_sense | U12 | 3 | VBIAS_1V65
current_sense | U12 | 7 | VBIAS_1V65
current_sense | R39 | 1 | I_W
current_sense | R39 | 2 | I_W_PORT
current_sense | C39 | 1 | +3V3_INV
current_sense | C39 | 2 | GND
current_sense | TP13 | 1 | I_W
current_sense | R40 | 1 | +3V3_INV
current_sense | R40 | 2 | VBIAS_DIV
current_sense | R41 | 1 | VBIAS_DIV
current_sense | R41 | 2 | GND
current_sense | C40 | 1 | VBIAS_DIV
current_sense | C40 | 2 | GND
current_sense | U13 | 1 | VBIAS_DIV
current_sense | U13 | 2 | GND
current_sense | U13 | 3 | VBIAS_1V65
current_sense | U13 | 4 | VBIAS_1V65
current_sense | U13 | 5 | +3V3_INV
current_sense | C41 | 1 | +3V3_INV
current_sense | C41 | 2 | GND
current_sense | R42 | 1 | +3V3_INV
current_sense | R42 | 2 | OC_LO_MID
current_sense | R43 | 1 | OC_LO_MID
current_sense | R43 | 2 | OC_LOW_REF
current_sense | R44 | 1 | OC_LOW_REF
current_sense | R44 | 2 | GND
current_sense | R45 | 1 | +3V3_INV
current_sense | R45 | 2 | OC_HIGH_REF
current_sense | R46 | 1 | OC_HIGH_REF
current_sense | R46 | 2 | OC_HI_MID
current_sense | R47 | 1 | OC_HI_MID
current_sense | R47 | 2 | GND
current_sense | U28 | 10 | +3V3_INV
current_sense | U28 | 11 | GND
current_sense | U28 | 12 | GND
current_sense | U28 | 13 | +3V3_INV
current_sense | U28 | 7 | GND
current_sense | U28 | 14 | +3V3_INV
current_sense | C62 | 1 | +3V3_INV
current_sense | C62 | 2 | GND
voltage_sense | R48 | 1 | VBUS
voltage_sense | R48 | 2 | V_DC_DIV1
voltage_sense | R49 | 1 | V_DC_DIV1
voltage_sense | R49 | 2 | V_DC_DIV2
voltage_sense | R50 | 1 | V_DC_DIV2
voltage_sense | R50 | 2 | V_DC_DIV
voltage_sense | R51 | 1 | V_DC_DIV
voltage_sense | R51 | 2 | GND
voltage_sense | C42 | 1 | V_DC_DIV
voltage_sense | C42 | 2 | GND
voltage_sense | U14 | 1 | V_DC_DIV
voltage_sense | U14 | 2 | GND
voltage_sense | U14 | 3 | V_DC
voltage_sense | U14 | 4 | V_DC
voltage_sense | U14 | 5 | +3V3_INV
voltage_sense | R52 | 1 | V_DC
voltage_sense | R52 | 2 | V_DC_PORT
voltage_sense | C43 | 1 | +3V3_INV
voltage_sense | C43 | 2 | GND
voltage_sense | R53 | 1 | U_PHASE
voltage_sense | R53 | 2 | V_U_DIV1
voltage_sense | R54 | 1 | V_U_DIV1
voltage_sense | R54 | 2 | V_U_DIV2
voltage_sense | R55 | 1 | V_U_DIV2
voltage_sense | R55 | 2 | V_U_DIV
voltage_sense | R56 | 1 | V_U_DIV
voltage_sense | R56 | 2 | GND
voltage_sense | C44 | 1 | V_U_DIV
voltage_sense | C44 | 2 | GND
voltage_sense | U15 | 1 | V_U_DIV
voltage_sense | U15 | 2 | GND
voltage_sense | U15 | 3 | V_U
voltage_sense | U15 | 4 | V_U
voltage_sense | U15 | 5 | +3V3_INV
voltage_sense | R57 | 1 | V_U
voltage_sense | R57 | 2 | V_U_PORT
voltage_sense | C45 | 1 | +3V3_INV
voltage_sense | C45 | 2 | GND
voltage_sense | R58 | 1 | V_PHASE
voltage_sense | R58 | 2 | V_V_DIV1
voltage_sense | R59 | 1 | V_V_DIV1
voltage_sense | R59 | 2 | V_V_DIV2
voltage_sense | R60 | 1 | V_V_DIV2
voltage_sense | R60 | 2 | V_V_DIV
voltage_sense | R61 | 1 | V_V_DIV
voltage_sense | R61 | 2 | GND
voltage_sense | C46 | 1 | V_V_DIV
voltage_sense | C46 | 2 | GND
voltage_sense | U16 | 1 | V_V_DIV
voltage_sense | U16 | 2 | GND
voltage_sense | U16 | 3 | V_V
voltage_sense | U16 | 4 | V_V
voltage_sense | U16 | 5 | +3V3_INV
voltage_sense | R62 | 1 | V_V
voltage_sense | R62 | 2 | V_V_PORT
voltage_sense | C47 | 1 | +3V3_INV
voltage_sense | C47 | 2 | GND
voltage_sense | R63 | 1 | W_PHASE
voltage_sense | R63 | 2 | V_W_DIV1
voltage_sense | R64 | 1 | V_W_DIV1
voltage_sense | R64 | 2 | V_W_DIV2
voltage_sense | R65 | 1 | V_W_DIV2
voltage_sense | R65 | 2 | V_W_DIV
voltage_sense | R66 | 1 | V_W_DIV
voltage_sense | R66 | 2 | GND
voltage_sense | C48 | 1 | V_W_DIV
voltage_sense | C48 | 2 | GND
voltage_sense | U17 | 1 | V_W_DIV
voltage_sense | U17 | 2 | GND
voltage_sense | U17 | 3 | V_W
voltage_sense | U17 | 4 | V_W
voltage_sense | U17 | 5 | +3V3_INV
voltage_sense | R67 | 1 | V_W
voltage_sense | R67 | 2 | V_W_PORT
voltage_sense | C49 | 1 | +3V3_INV
voltage_sense | C49 | 2 | GND
voltage_sense | R68 | 1 | +3V3_INV
voltage_sense | R68 | 2 | OV_REF_1V30
voltage_sense | R69 | 1 | OV_REF_1V30
voltage_sense | R69 | 2 | GND
voltage_sense | J8 | 1 | TEMP_NTC
voltage_sense | J8 | 2 | GND
voltage_sense | R70 | 1 | +3V3_INV
voltage_sense | R70 | 2 | TEMP_NTC
voltage_sense | C50 | 1 | TEMP_NTC
voltage_sense | C50 | 2 | GND
comparators | U18 | 1 | OC_U_HIGH_OK
comparators | U18 | 2 | I_U
comparators | U18 | 3 | OC_HIGH_REF
comparators | U18 | 5 | I_U
comparators | U18 | 6 | OC_LOW_REF
comparators | U18 | 7 | OC_U_LOW_OK
comparators | U19 | 1 | OC_V_HIGH_OK
comparators | U19 | 2 | I_V
comparators | U19 | 3 | OC_HIGH_REF
comparators | U19 | 5 | I_V
comparators | U19 | 6 | OC_LOW_REF
comparators | U19 | 7 | OC_V_LOW_OK
comparators | U20 | 1 | OC_W_HIGH_OK
comparators | U20 | 2 | I_W
comparators | U20 | 3 | OC_HIGH_REF
comparators | U20 | 5 | I_W
comparators | U20 | 6 | OC_LOW_REF
comparators | U20 | 7 | OC_W_LOW_OK
comparators | U21 | 1 | BUS_OV_OK
comparators | U21 | 2 | V_DC
comparators | U21 | 3 | OV_REF_1V30
comparators | U21 | 5 | DRV_UV_DIV
comparators | U21 | 6 | OV_REF_1V30
comparators | U21 | 7 | DRV_UV_OK
comparators | U18 | 4 | GND
comparators | U18 | 8 | +3V3_INV
comparators | C51 | 1 | +3V3_INV
comparators | C51 | 2 | GND
comparators | U19 | 4 | GND
comparators | U19 | 8 | +3V3_INV
comparators | C52 | 1 | +3V3_INV
comparators | C52 | 2 | GND
comparators | U20 | 4 | GND
comparators | U20 | 8 | +3V3_INV
comparators | C53 | 1 | +3V3_INV
comparators | C53 | 2 | GND
comparators | U21 | 4 | GND
comparators | U21 | 8 | +3V3_INV
comparators | C54 | 1 | +3V3_INV
comparators | C54 | 2 | GND
comparators | R71 | 1 | +12V_DRV
comparators | R71 | 2 | DRV_UV_DIV
comparators | R72 | 1 | DRV_UV_DIV
comparators | R72 | 2 | GND
fault_logic | U22 | 1 | OC_U_HIGH_OK
fault_logic | U22 | 2 | OC_U_LOW_OK
fault_logic | U22 | 3 | HEALTH_CHAIN_1
fault_logic | U22 | 4 | HEALTH_CHAIN_1
fault_logic | U22 | 5 | OC_V_HIGH_OK
fault_logic | U22 | 6 | HEALTH_CHAIN_2
fault_logic | U22 | 9 | HEALTH_CHAIN_2
fault_logic | U22 | 10 | OC_V_LOW_OK
fault_logic | U22 | 8 | HEALTH_CHAIN_3
fault_logic | U22 | 12 | HEALTH_CHAIN_3
fault_logic | U22 | 13 | OC_W_HIGH_OK
fault_logic | U22 | 11 | HEALTH_CHAIN_4
fault_logic | U23 | 1 | HEALTH_CHAIN_4
fault_logic | U23 | 2 | OC_W_LOW_OK
fault_logic | U23 | 3 | HEALTH_CHAIN_5
fault_logic | U23 | 4 | HEALTH_CHAIN_5
fault_logic | U23 | 5 | BUS_OV_OK
fault_logic | U23 | 6 | HEALTH_CHAIN_6
fault_logic | U23 | 9 | HEALTH_CHAIN_6
fault_logic | U23 | 10 | DRV_UV_OK
fault_logic | U23 | 8 | HEALTH_CHAIN_7
fault_logic | U23 | 12 | HEALTH_CHAIN_7
fault_logic | U23 | 13 | LOGIC_POWER_OK
fault_logic | U23 | 11 | HEALTH_CHAIN_8
fault_logic | U24 | 1 | HEALTH_CHAIN_8
fault_logic | U24 | 2 | DRV_PG_LOGIC
fault_logic | U24 | 3 | HEALTH_CHAIN_9
fault_logic | U24 | 4 | HEALTH_CHAIN_9
fault_logic | U24 | 5 | AUX_FLT_N
fault_logic | U24 | 6 | HEALTH_ALL
fault_logic | U27 | 1 | ENABLE_IN
fault_logic | U27 | 2 | ENABLE_IN
fault_logic | U27 | 3 | ENABLE_N
fault_logic | U24 | 9 | HEALTH_ALL
fault_logic | U24 | 10 | ENABLE_N
fault_logic | U24 | 8 | RESET_REQUEST
fault_logic | R73 | 1 | RESET_REQUEST
fault_logic | R73 | 2 | RESET_CLK
fault_logic | C55 | 1 | RESET_CLK
fault_logic | C55 | 2 | GND
fault_logic | U28 | 1 | +3V3_INV
fault_logic | U28 | 2 | GND
fault_logic | U28 | 3 | RESET_CLK
fault_logic | U28 | 4 | HEALTH_ALL
fault_logic | U28 | 5 | FAULT_LATCH
fault_logic | U28 | 6 | NO_LATCH
fault_logic | U24 | 12 | HEALTH_ALL
fault_logic | U24 | 13 | NO_LATCH
fault_logic | U24 | 11 | HEALTH_UNLATCHED
fault_logic | U25 | 1 | HEALTH_UNLATCHED
fault_logic | U25 | 2 | ENABLE_IN
fault_logic | U25 | 3 | DRIVE_PERMIT
fault_logic | U27 | 4 | HEALTH_ALL
fault_logic | U27 | 5 | NO_LATCH
fault_logic | U27 | 6 | FAULT_ACTIVE
fault_logic | R74 | 1 | FAULT_ACTIVE
fault_logic | R74 | 2 | FAULT_BASE
fault_logic | Q8 | 1 | FAULT_BASE
fault_logic | Q8 | 2 | GND
fault_logic | Q8 | 3 | FAULT_N
fault_logic | R75 | 1 | FAULT_BASE
fault_logic | R75 | 2 | GND
fault_logic | TP14 | 1 | FAULT_LATCH
control_interface | U25 | 4 | PWM_UH_IN
control_interface | U25 | 5 | DRIVE_PERMIT
control_interface | U25 | 6 | U_HIN
control_interface | R76 | 1 | PWM_UH_IN
control_interface | R76 | 2 | GND
control_interface | U25 | 9 | PWM_UL_IN
control_interface | U25 | 10 | DRIVE_PERMIT
control_interface | U25 | 8 | U_LIN
control_interface | R77 | 1 | PWM_UL_IN
control_interface | R77 | 2 | GND
control_interface | U25 | 12 | PWM_VH_IN
control_interface | U25 | 13 | DRIVE_PERMIT
control_interface | U25 | 11 | V_HIN
control_interface | R78 | 1 | PWM_VH_IN
control_interface | R78 | 2 | GND
control_interface | U26 | 1 | PWM_VL_IN
control_interface | U26 | 2 | DRIVE_PERMIT
control_interface | U26 | 3 | V_LIN
control_interface | R79 | 1 | PWM_VL_IN
control_interface | R79 | 2 | GND
control_interface | U26 | 4 | PWM_WH_IN
control_interface | U26 | 5 | DRIVE_PERMIT
control_interface | U26 | 6 | W_HIN
control_interface | R80 | 1 | PWM_WH_IN
control_interface | R80 | 2 | GND
control_interface | U26 | 9 | PWM_WL_IN
control_interface | U26 | 10 | DRIVE_PERMIT
control_interface | U26 | 8 | W_LIN
control_interface | R81 | 1 | PWM_WL_IN
control_interface | R81 | 2 | GND
control_interface | R82 | 1 | ENABLE_IN
control_interface | R82 | 2 | GND
control_interface | R83 | 1 | DRIVE_PERMIT
control_interface | R83 | 2 | GND
control_interface | U22 | 7 | GND
control_interface | U22 | 14 | +3V3_INV
control_interface | C56 | 1 | +3V3_INV
control_interface | C56 | 2 | GND
control_interface | U23 | 7 | GND
control_interface | U23 | 14 | +3V3_INV
control_interface | C57 | 1 | +3V3_INV
control_interface | C57 | 2 | GND
control_interface | U24 | 7 | GND
control_interface | U24 | 14 | +3V3_INV
control_interface | C58 | 1 | +3V3_INV
control_interface | C58 | 2 | GND
control_interface | U25 | 7 | GND
control_interface | U25 | 14 | +3V3_INV
control_interface | C59 | 1 | +3V3_INV
control_interface | C59 | 2 | GND
control_interface | U26 | 7 | GND
control_interface | U26 | 14 | +3V3_INV
control_interface | C60 | 1 | +3V3_INV
control_interface | C60 | 2 | GND
control_interface | U27 | 7 | GND
control_interface | U27 | 14 | +3V3_INV
control_interface | C61 | 1 | +3V3_INV
control_interface | C61 | 2 | GND
control_interface | U26 | 12 | GND
control_interface | U26 | 13 | GND
control_interface | U27 | 9 | GND
control_interface | U27 | 10 | GND
control_interface | U27 | 12 | GND
control_interface | U27 | 13 | GND
mcu | U30 | 1 | +3V3_INV
mcu | U30 | 16 | +3V3_INV
mcu | U30 | 32 | +3V3_INV
mcu | U30 | 48 | +3V3_INV
mcu | U30 | 64 | +3V3_INV
mcu | U30 | 15 | GND
mcu | U30 | 31 | GND
mcu | U30 | 47 | GND
mcu | U30 | 63 | GND
mcu | U30 | 27 | GND
mcu | U30 | 29 | +3V3_A_MCU
mcu | U30 | 5 | HSE_IN
mcu | U30 | 6 | HSE_OUT
mcu | U30 | 7 | LOGIC_POWER_OK
mcu | U30 | 8 | ADC_I_U
mcu | U30 | 9 | ADC_I_V
mcu | U30 | 10 | ADC_I_W
mcu | U30 | 11 | ADC_V_DC
mcu | U30 | 12 | ENC_A_A
mcu | U30 | 13 | ENC_A_B
mcu | U30 | 14 | ENC_A_Z
mcu | U30 | 17 | ENC_B_Z
mcu | U30 | 18 | ADC_V_U
mcu | U30 | 19 | SPI_A_SCK
mcu | U30 | 20 | SPI_A_MISO
mcu | U30 | 21 | SPI_A_MOSI
mcu | U30 | 22 | MCU_ENABLE
mcu | U30 | 23 | LED_RUN
mcu | U30 | 24 | ADC_V_V
mcu | U30 | 25 | ADC_V_W
mcu | U30 | 26 | ADC_TEMP_NTC
mcu | U30 | 28 | VREF_MCU
mcu | U30 | 30 | UART_TX
mcu | U30 | 33 | UART_RX
mcu | U30 | 34 | FAULT_N
mcu | U30 | 35 | MCU_PWM_UL
mcu | U30 | 36 | MCU_PWM_VL
mcu | U30 | 37 | MCU_PWM_WL
mcu | U30 | 38 | MCU_BRAKE
mcu | U30 | 40 | LED_FAULT
mcu | U30 | 41 | SPI_B_CS
mcu | U30 | 42 | MCU_PWM_UH
mcu | U30 | 43 | MCU_PWM_VH
mcu | U30 | 44 | MCU_PWM_WH
mcu | U30 | 45 | CAN_RX
mcu | U30 | 46 | CAN_TX
mcu | U30 | 49 | SWDIO
mcu | U30 | 50 | SWCLK
mcu | U30 | 51 | SPI_A_CS
mcu | U30 | 52 | SPI_B_SCK
mcu | U30 | 53 | SPI_B_MISO
mcu | U30 | 54 | SPI_B_MOSI
mcu | U30 | 55 | LED_COMM
mcu | U30 | 58 | LED_AUX
mcu | U30 | 59 | ENC_B_A
mcu | U30 | 60 | ENC_B_B
mcu | U30 | 61 | BOOT0
mcu | C63 | 1 | +3V3_INV
mcu | C63 | 2 | GND
mcu | C64 | 1 | +3V3_INV
mcu | C64 | 2 | GND
mcu | C65 | 1 | +3V3_INV
mcu | C65 | 2 | GND
mcu | C66 | 1 | +3V3_INV
mcu | C66 | 2 | GND
mcu | C67 | 1 | +3V3_INV
mcu | C67 | 2 | GND
mcu | C68 | 1 | +3V3_INV
mcu | C68 | 2 | GND
mcu_analog | R84 | 1 | I_U_PORT
mcu_analog | R84 | 2 | ADC_I_U
mcu_analog | C69 | 1 | ADC_I_U
mcu_analog | C69 | 2 | GND
mcu_analog | R85 | 1 | I_V_PORT
mcu_analog | R85 | 2 | ADC_I_V
mcu_analog | C70 | 1 | ADC_I_V
mcu_analog | C70 | 2 | GND
mcu_analog | R86 | 1 | I_W_PORT
mcu_analog | R86 | 2 | ADC_I_W
mcu_analog | C71 | 1 | ADC_I_W
mcu_analog | C71 | 2 | GND
mcu_analog | R87 | 1 | V_DC_PORT
mcu_analog | R87 | 2 | ADC_V_DC
mcu_analog | C72 | 1 | ADC_V_DC
mcu_analog | C72 | 2 | GND
mcu_analog | R88 | 1 | V_U_PORT
mcu_analog | R88 | 2 | ADC_V_U
mcu_analog | C73 | 1 | ADC_V_U
mcu_analog | C73 | 2 | GND
mcu_analog | R89 | 1 | V_V_PORT
mcu_analog | R89 | 2 | ADC_V_V
mcu_analog | C74 | 1 | ADC_V_V
mcu_analog | C74 | 2 | GND
mcu_analog | R90 | 1 | V_W_PORT
mcu_analog | R90 | 2 | ADC_V_W
mcu_analog | C75 | 1 | ADC_V_W
mcu_analog | C75 | 2 | GND
mcu_analog | R91 | 1 | TEMP_NTC
mcu_analog | R91 | 2 | ADC_TEMP_NTC
mcu_analog | C76 | 1 | ADC_TEMP_NTC
mcu_analog | C76 | 2 | GND
mcu_analog | R92 | 1 | +3V3_INV
mcu_analog | R92 | 2 | +3V3_A_MCU
mcu_analog | C77 | 1 | +3V3_A_MCU
mcu_analog | C77 | 2 | GND
mcu_analog | C78 | 1 | +3V3_A_MCU
mcu_analog | C78 | 2 | GND
mcu_analog | R93 | 1 | +3V3_A_MCU
mcu_analog | R93 | 2 | VREF_MCU
mcu_analog | C79 | 1 | VREF_MCU
mcu_analog | C79 | 2 | GND
mcu_analog | C80 | 1 | VREF_MCU
mcu_analog | C80 | 2 | GND
sensors | J9 | 1 | ENC_A_VCC
sensors | J9 | 2 | GND
sensors | J9 | 3 | ENC_A_A_PORT
sensors | J9 | 4 | ENC_A_B_PORT
sensors | J9 | 5 | ENC_A_Z_PORT
sensors | R94 | 1 | ENC_A_A_PORT
sensors | R94 | 2 | ENC_A_A
sensors | R95 | 1 | ENC_A_A
sensors | R95 | 2 | +3V3_INV
sensors | R96 | 1 | ENC_A_B_PORT
sensors | R96 | 2 | ENC_A_B
sensors | R97 | 1 | ENC_A_B
sensors | R97 | 2 | +3V3_INV
sensors | R98 | 1 | ENC_A_Z_PORT
sensors | R98 | 2 | ENC_A_Z
sensors | R99 | 1 | ENC_A_Z
sensors | R99 | 2 | +3V3_INV
sensors | R100 | 1 | +5V_SENSOR
sensors | R100 | 2 | ENC_A_VCC
sensors | J10 | 1 | ENC_B_VCC
sensors | J10 | 2 | GND
sensors | J10 | 3 | ENC_B_A_PORT
sensors | J10 | 4 | ENC_B_B_PORT
sensors | J10 | 5 | ENC_B_Z_PORT
sensors | R101 | 1 | ENC_B_A_PORT
sensors | R101 | 2 | ENC_B_A
sensors | R102 | 1 | ENC_B_A
sensors | R102 | 2 | +3V3_INV
sensors | R103 | 1 | ENC_B_B_PORT
sensors | R103 | 2 | ENC_B_B
sensors | R104 | 1 | ENC_B_B
sensors | R104 | 2 | +3V3_INV
sensors | R105 | 1 | ENC_B_Z_PORT
sensors | R105 | 2 | ENC_B_Z
sensors | R106 | 1 | ENC_B_Z
sensors | R106 | 2 | +3V3_INV
sensors | R107 | 1 | +5V_SENSOR
sensors | R107 | 2 | ENC_B_VCC
sensors | J11 | 1 | SPI_A_VCC
sensors | J11 | 2 | GND
sensors | J11 | 3 | SPI_A_SCK_PORT
sensors | J11 | 4 | SPI_A_MOSI_PORT
sensors | J11 | 5 | SPI_A_MISO_PORT
sensors | J11 | 6 | SPI_A_CS_PORT
sensors | R108 | 1 | SPI_A_SCK
sensors | R108 | 2 | SPI_A_SCK_PORT
sensors | R109 | 1 | SPI_A_MOSI
sensors | R109 | 2 | SPI_A_MOSI_PORT
sensors | R110 | 1 | SPI_A_MISO
sensors | R110 | 2 | SPI_A_MISO_PORT
sensors | R111 | 1 | SPI_A_CS
sensors | R111 | 2 | SPI_A_CS_PORT
sensors | R112 | 1 | SPI_A_CS
sensors | R112 | 2 | +3V3_INV
sensors | R113 | 1 | +5V_SENSOR
sensors | R113 | 2 | SPI_A_VCC
sensors | J12 | 1 | SPI_B_VCC
sensors | J12 | 2 | GND
sensors | J12 | 3 | SPI_B_SCK_PORT
sensors | J12 | 4 | SPI_B_MOSI_PORT
sensors | J12 | 5 | SPI_B_MISO_PORT
sensors | J12 | 6 | SPI_B_CS_PORT
sensors | R114 | 1 | SPI_B_SCK
sensors | R114 | 2 | SPI_B_SCK_PORT
sensors | R115 | 1 | SPI_B_MOSI
sensors | R115 | 2 | SPI_B_MOSI_PORT
sensors | R116 | 1 | SPI_B_MISO
sensors | R116 | 2 | SPI_B_MISO_PORT
sensors | R117 | 1 | SPI_B_CS
sensors | R117 | 2 | SPI_B_CS_PORT
sensors | R118 | 1 | SPI_B_CS
sensors | R118 | 2 | +3V3_INV
sensors | R119 | 1 | +5V_SENSOR
sensors | R119 | 2 | SPI_B_VCC
debug_comms | J13 | 1 | +3V3_INV
debug_comms | J13 | 2 | SWDIO_PORT
debug_comms | J13 | 3 | SWCLK_PORT
debug_comms | J13 | 4 | GND
debug_comms | J13 | 5 | LOGIC_POWER_OK
debug_comms | R120 | 1 | SWDIO_PORT
debug_comms | R120 | 2 | SWDIO
debug_comms | R121 | 1 | SWCLK_PORT
debug_comms | R121 | 2 | SWCLK
debug_comms | SW2 | 1 | LOGIC_POWER_OK
debug_comms | SW2 | 2 | GND
debug_comms | C81 | 1 | LOGIC_POWER_OK
debug_comms | C81 | 2 | GND
debug_comms | R122 | 1 | BOOT0
debug_comms | R122 | 2 | GND
debug_comms | TP15 | 1 | BOOT0
debug_comms | J14 | 1 | UART_TX_PORT
debug_comms | J14 | 2 | UART_RX_PORT
debug_comms | J14 | 3 | GND
debug_comms | R123 | 1 | UART_TX
debug_comms | R123 | 2 | UART_TX_PORT
debug_comms | R124 | 1 | UART_RX_PORT
debug_comms | R124 | 2 | UART_RX
debug_comms | R125 | 1 | UART_RX
debug_comms | R125 | 2 | +3V3_INV
debug_comms | U31 | 1 | CAN_TX_PHY
debug_comms | U31 | 2 | GND
debug_comms | U31 | 3 | +3V3_INV
debug_comms | U31 | 4 | CAN_RX_PHY
debug_comms | U31 | 6 | CAN_L
debug_comms | U31 | 7 | CAN_H
debug_comms | R126 | 1 | CAN_TX
debug_comms | R126 | 2 | CAN_TX_PHY
debug_comms | R127 | 1 | CAN_RX_PHY
debug_comms | R127 | 2 | CAN_RX
debug_comms | R128 | 1 | CAN_TX_PHY
debug_comms | R128 | 2 | +3V3_INV
debug_comms | C82 | 1 | +3V3_INV
debug_comms | C82 | 2 | GND
debug_comms | J15 | 1 | CAN_H
debug_comms | J15 | 2 | CAN_L
debug_comms | J15 | 3 | GND
debug_comms | R129 | 1 | CAN_H
debug_comms | R129 | 2 | CAN_L
debug_comms | R130 | 1 | +3V3_INV
debug_comms | R130 | 2 | LED_AN_0
debug_comms | D3 | 2 | LED_AN_0
debug_comms | D3 | 1 | GND
debug_comms | R131 | 1 | +3V3_INV
debug_comms | R131 | 2 | LED_AN_1
debug_comms | D4 | 2 | LED_AN_1
debug_comms | D4 | 1 | LED_RUN
debug_comms | R132 | 1 | +3V3_INV
debug_comms | R132 | 2 | LED_AN_2
debug_comms | D5 | 2 | LED_AN_2
debug_comms | D5 | 1 | LED_FAULT
debug_comms | R133 | 1 | +3V3_INV
debug_comms | R133 | 2 | LED_AN_3
debug_comms | D6 | 2 | LED_AN_3
debug_comms | D6 | 1 | LED_COMM
debug_comms | R134 | 1 | +3V3_INV
debug_comms | R134 | 2 | LED_AN_4
debug_comms | D7 | 2 | LED_AN_4
debug_comms | D7 | 1 | LED_AUX
mcu_control | R135 | 1 | MCU_PWM_UH
mcu_control | R135 | 2 | PWM_UH_IN
mcu_control | R136 | 1 | MCU_PWM_UL
mcu_control | R136 | 2 | PWM_UL_IN
mcu_control | R137 | 1 | MCU_PWM_VH
mcu_control | R137 | 2 | PWM_VH_IN
mcu_control | R138 | 1 | MCU_PWM_VL
mcu_control | R138 | 2 | PWM_VL_IN
mcu_control | R139 | 1 | MCU_PWM_WH
mcu_control | R139 | 2 | PWM_WH_IN
mcu_control | R140 | 1 | MCU_PWM_WL
mcu_control | R140 | 2 | PWM_WL_IN
mcu_control | R141 | 1 | MCU_ENABLE
mcu_control | R141 | 2 | ENABLE_IN
mcu_control | R142 | 1 | MCU_BRAKE
mcu_control | R142 | 2 | BRAKE_IN
mcu_control | R143 | 1 | FAULT_N
mcu_control | R143 | 2 | +3V3_INV
mcu_control | TP16 | 1 | FAULT_N
mcu_control | TP17 | 1 | ENABLE_IN
mcu_control | Y1 | 1 | HSE_IN
mcu_control | Y1 | 3 | HSE_OUT
mcu_control | Y1 | 2 | GND
mcu_control | Y1 | 4 | GND
mcu_control | C83 | 1 | HSE_IN
mcu_control | C83 | 2 | GND
mcu_control | C84 | 1 | HSE_OUT
mcu_control | C84 | 2 | GND
