leolei2012/power_system/controller/hardware/g431_core/review/core_contact_final.png

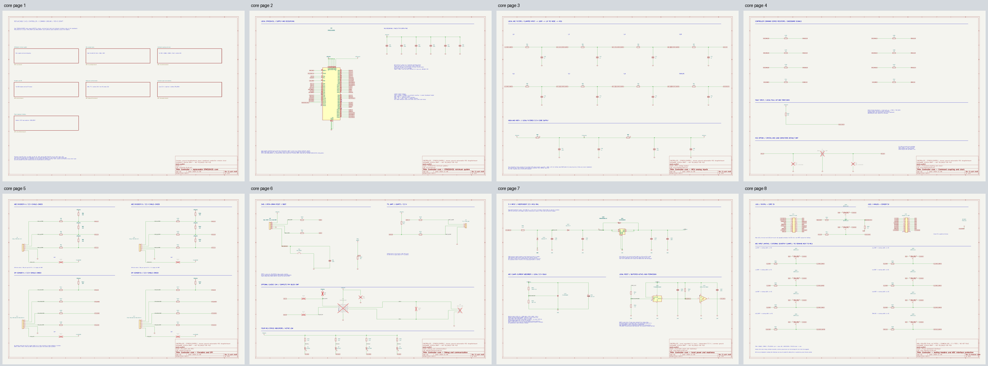
controller/hardware/g431_core/review/core_contact_final.png
