leolei2012/power_system/controller/hardware/g431_core/review/core_final_01.png

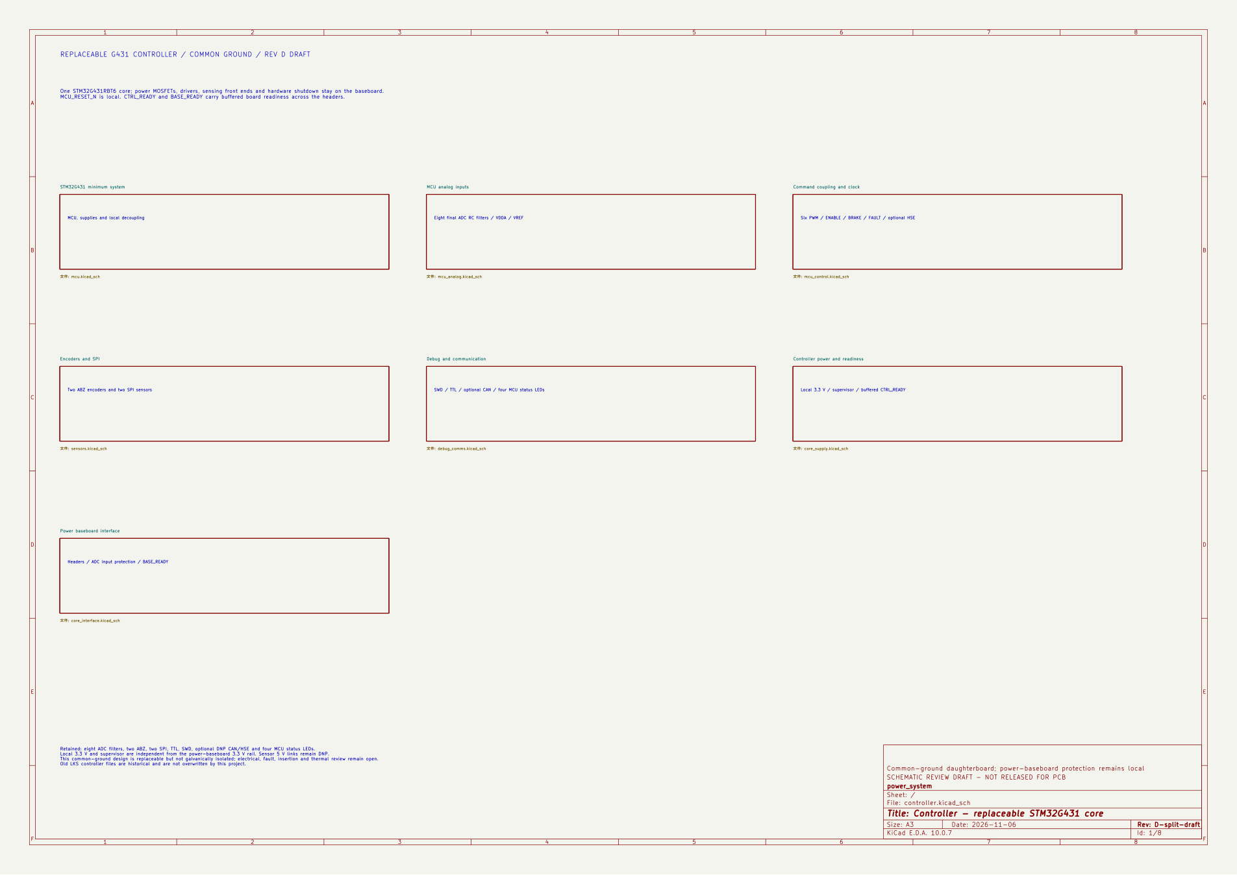
controller/hardware/g431_core/review/core_final_01.png
