leolei2012/power_system/controller/hardware/g431_core/review/core_final_02.png

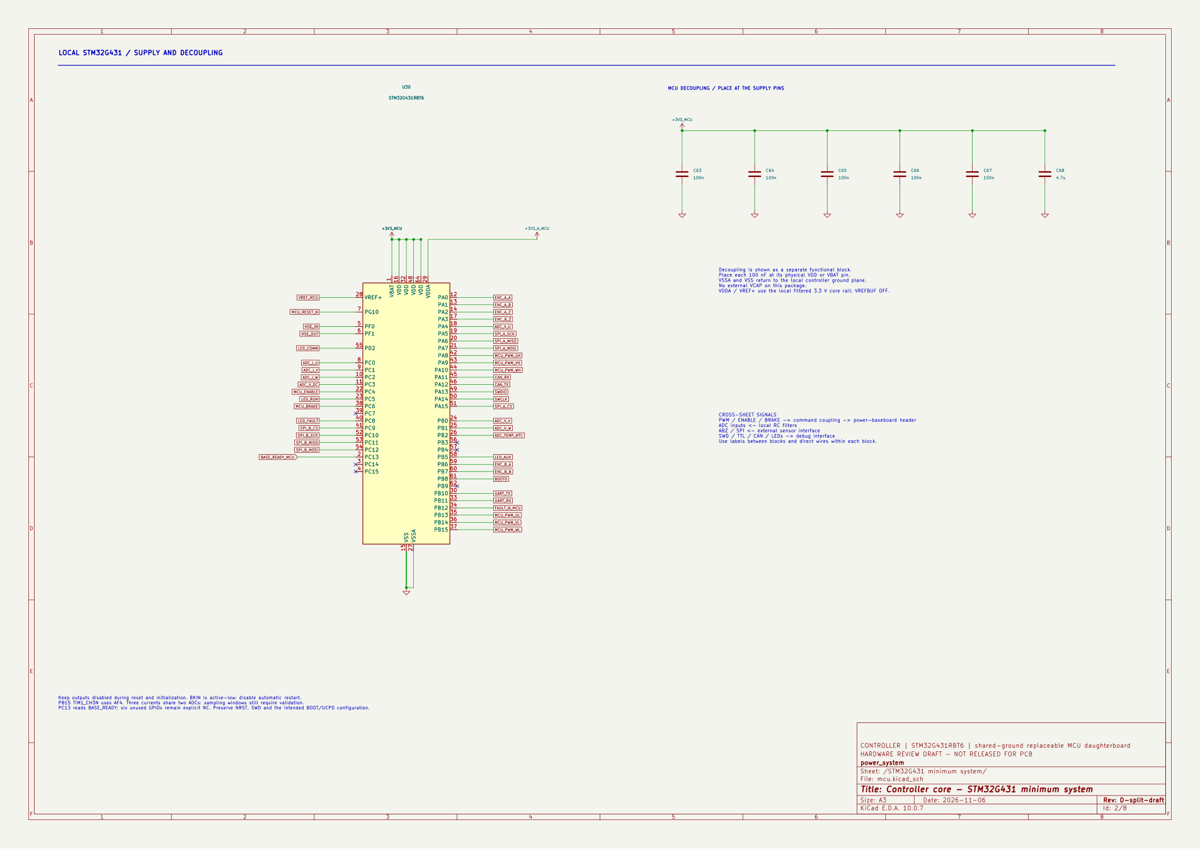
controller/hardware/g431_core/review/core_final_02.png
