leolei2012/power_system/controller/hardware/g431_core/review/core_header_detail.png

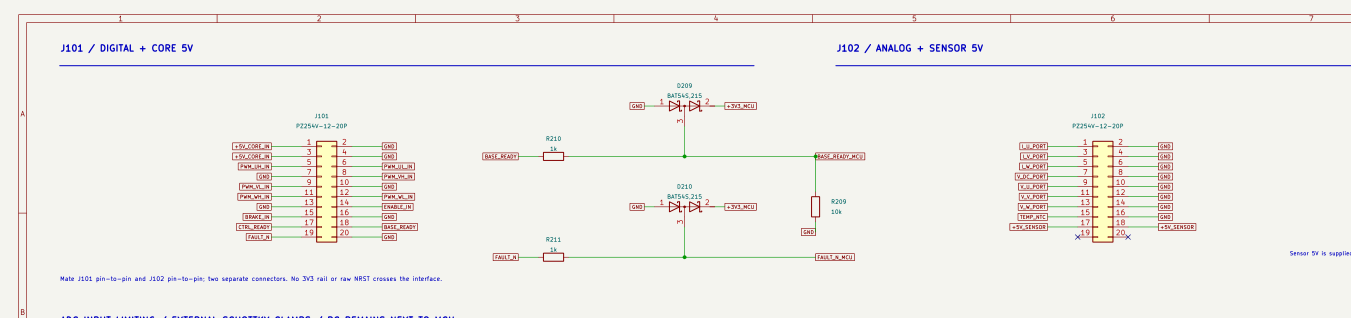
controller/hardware/g431_core/review/core_header_detail.png
