leolei2012/power_system/controller/hardware/g431_core/review/core_minimum_4.png

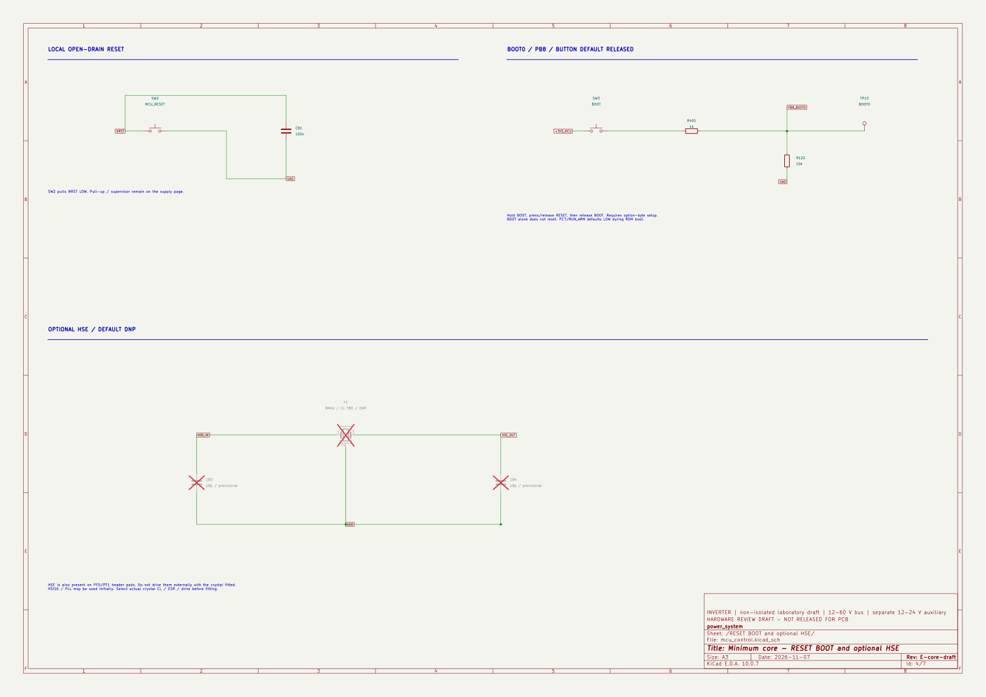
controller/hardware/g431_core/review/core_minimum_4.png
