leolei2012/power_system/controller/hardware/g431_core/review/core_minimum_6.png

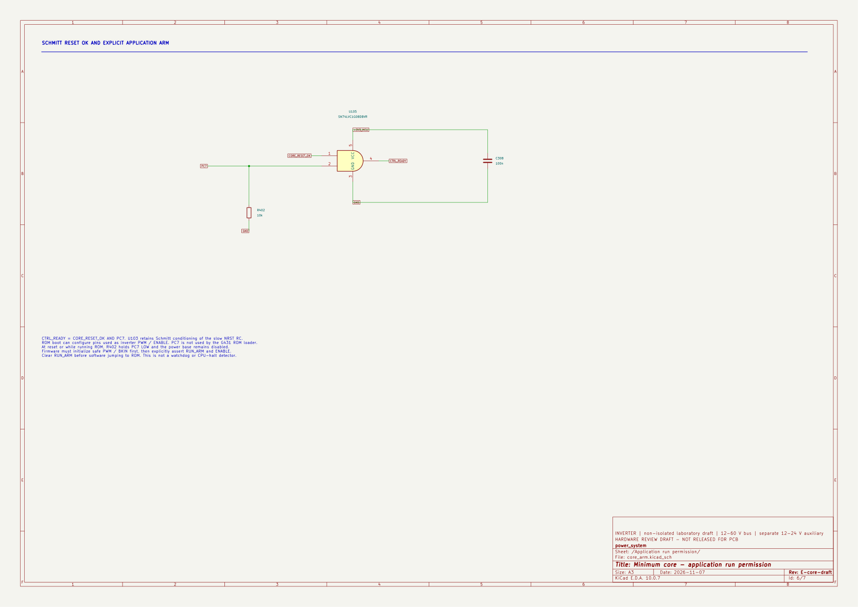
controller/hardware/g431_core/review/core_minimum_6.png
