leolei2012/power_system/controller/hardware/g431_core/review/core_minimum_7.png

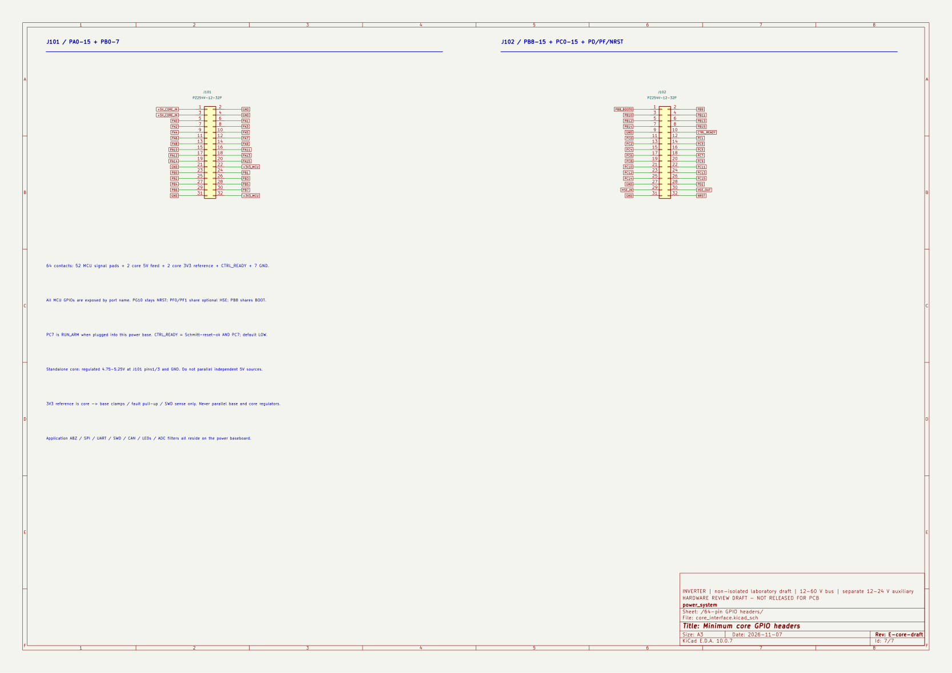
controller/hardware/g431_core/review/core_minimum_7.png
