leolei2012/power_system/controller/hardware/g431_core/review/core_minimum_contact.png

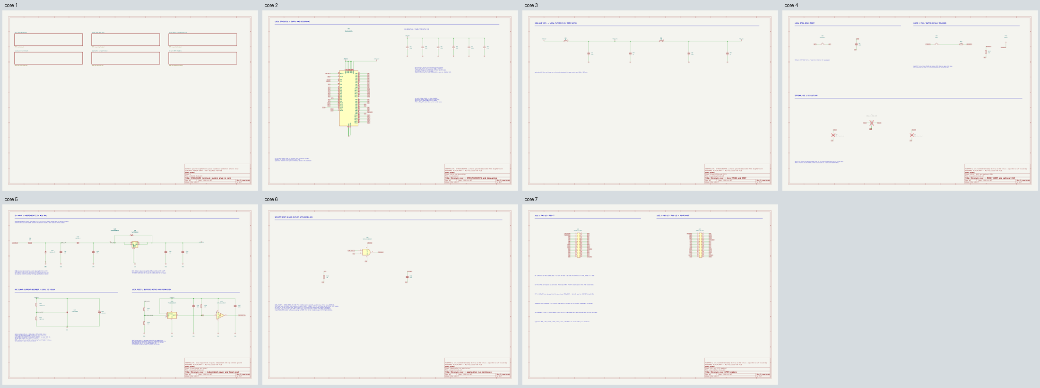
controller/hardware/g431_core/review/core_minimum_contact.png
