leolei2012/power_system/controller/hardware/g431_core/review/core_page_03.png

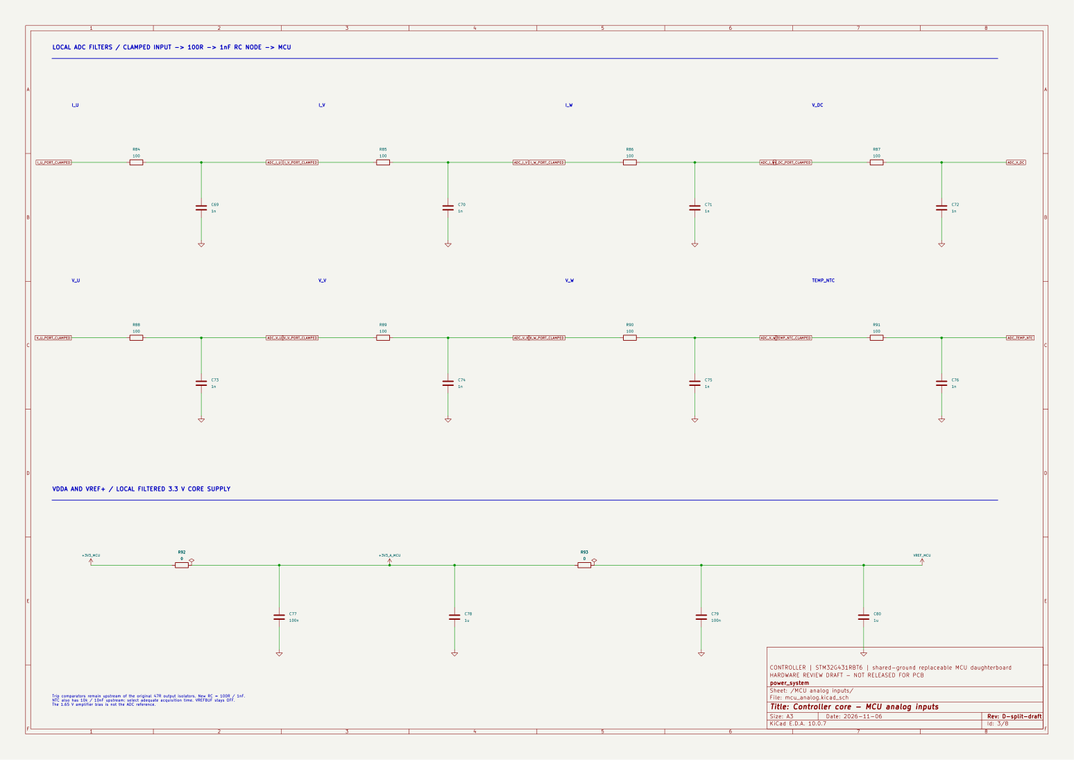
controller/hardware/g431_core/review/core_page_03.png
