leolei2012/power_system/controller/hardware/g431_core/review/core_page_04.png

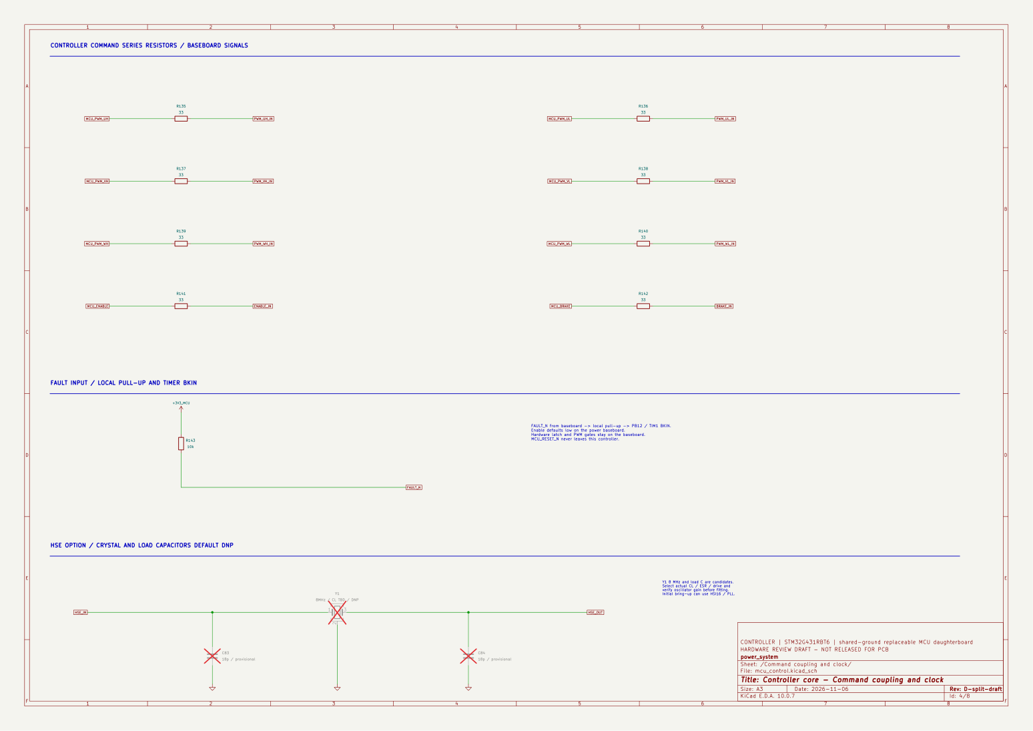
controller/hardware/g431_core/review/core_page_04.png
