leolei2012/power_system/controller/hardware/g431_core/review/core_page_05.png

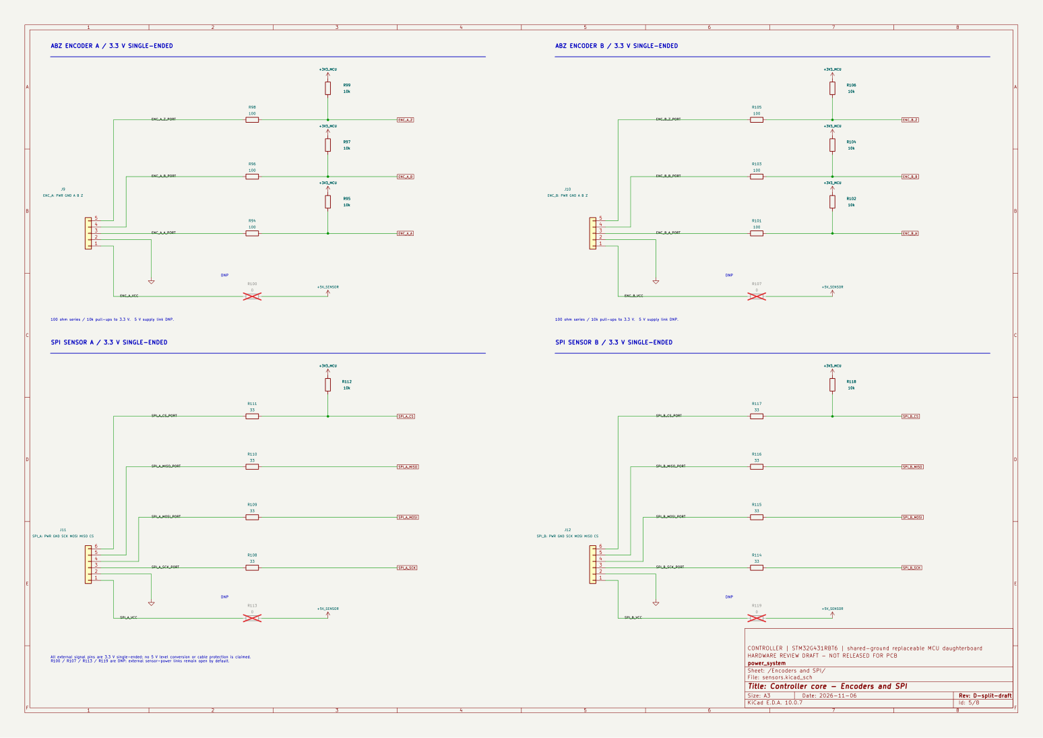
controller/hardware/g431_core/review/core_page_05.png
