leolei2012/power_system/controller/hardware/g431_core/review/core_supply_note_preview.png

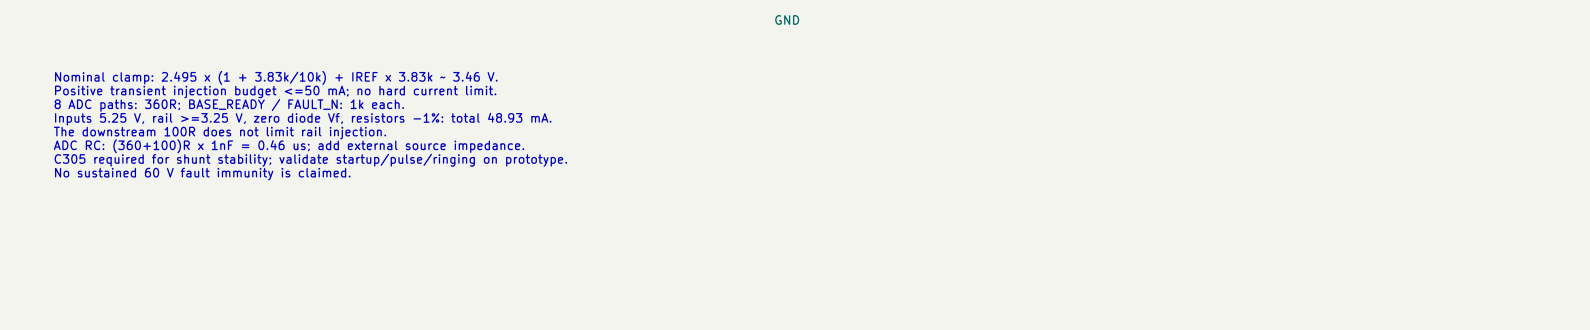
controller/hardware/g431_core/review/core_supply_note_preview.png
