leolei2012/power_system/controller/hardware/g431_core/review/supply_reference/tl431_stability.png

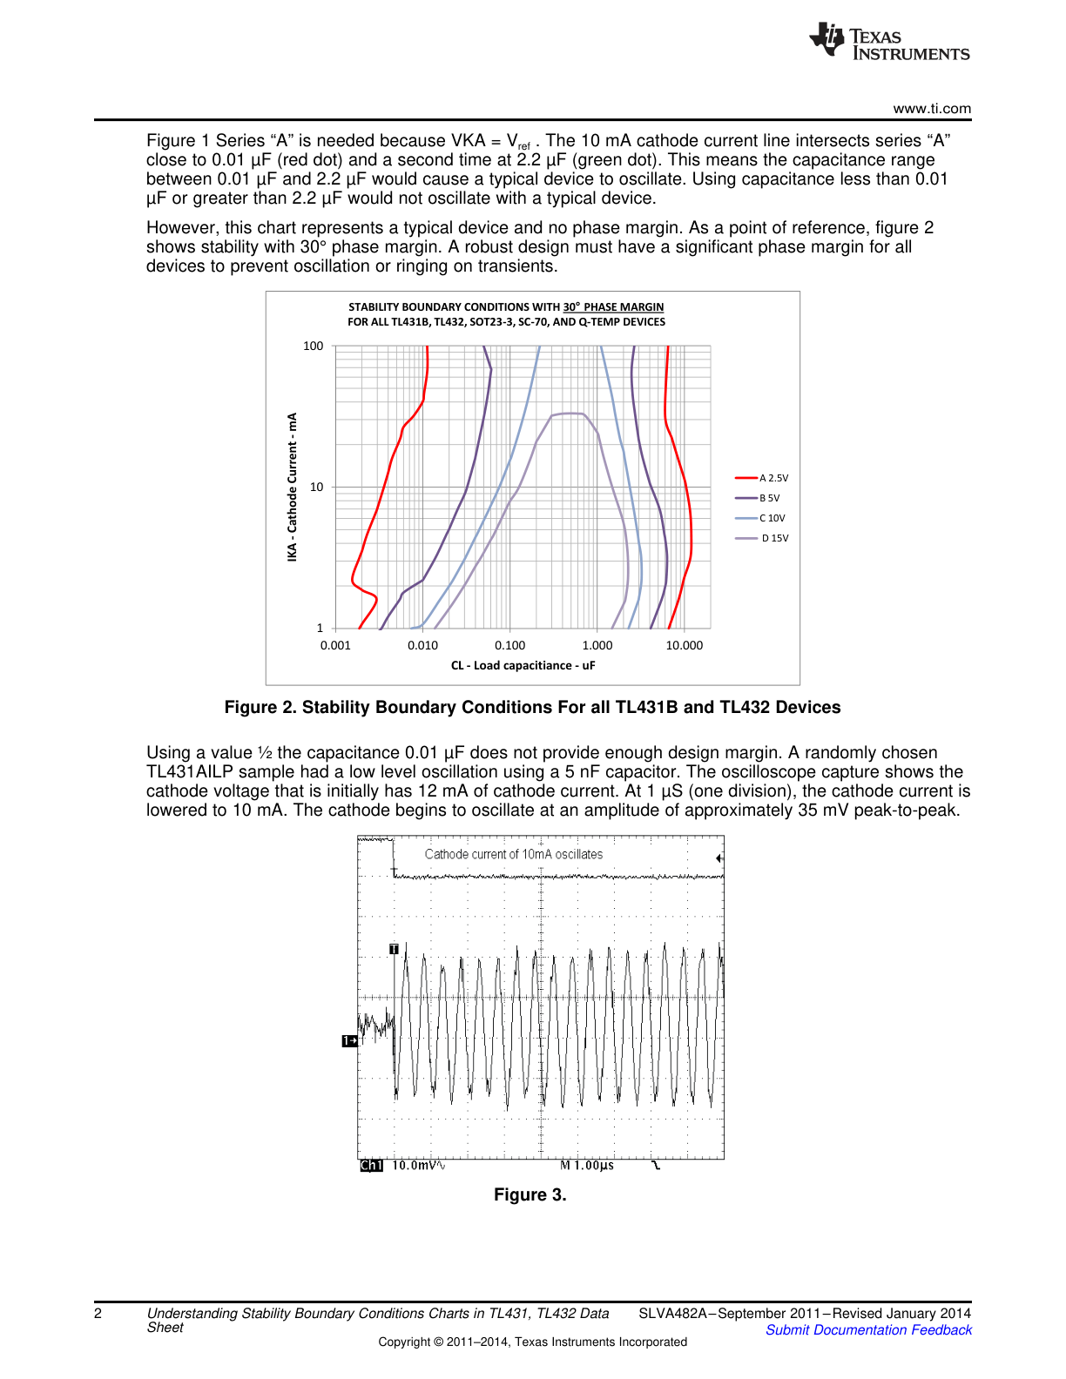
controller/hardware/g431_core/review/supply_reference/tl431_stability.png
