leolei2012/power_system/controller/hardware/review/preview/contact-sheet.png

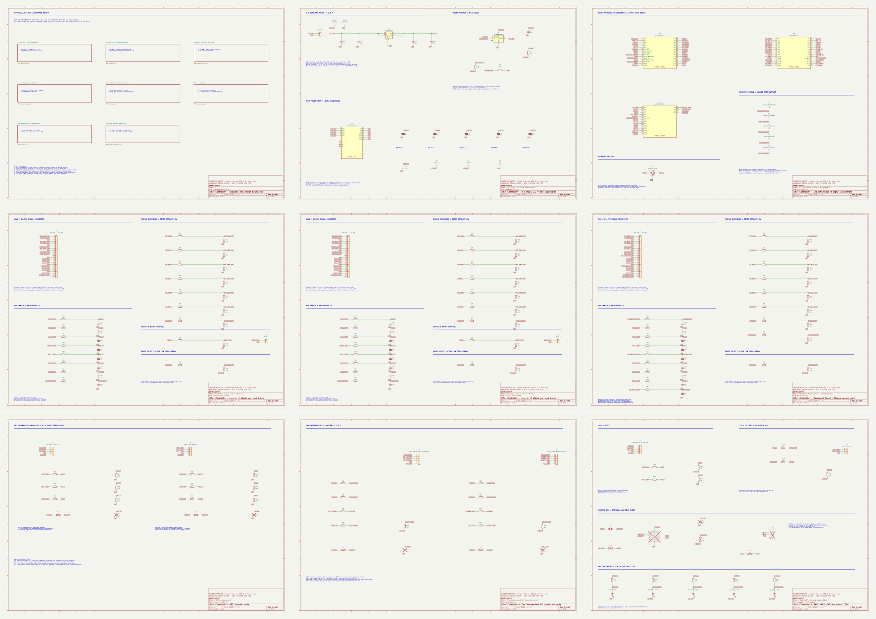
controller/hardware/review/preview/contact-sheet.png
