leolei2012/power_system/controller/hardware/review/preview/page-02.png

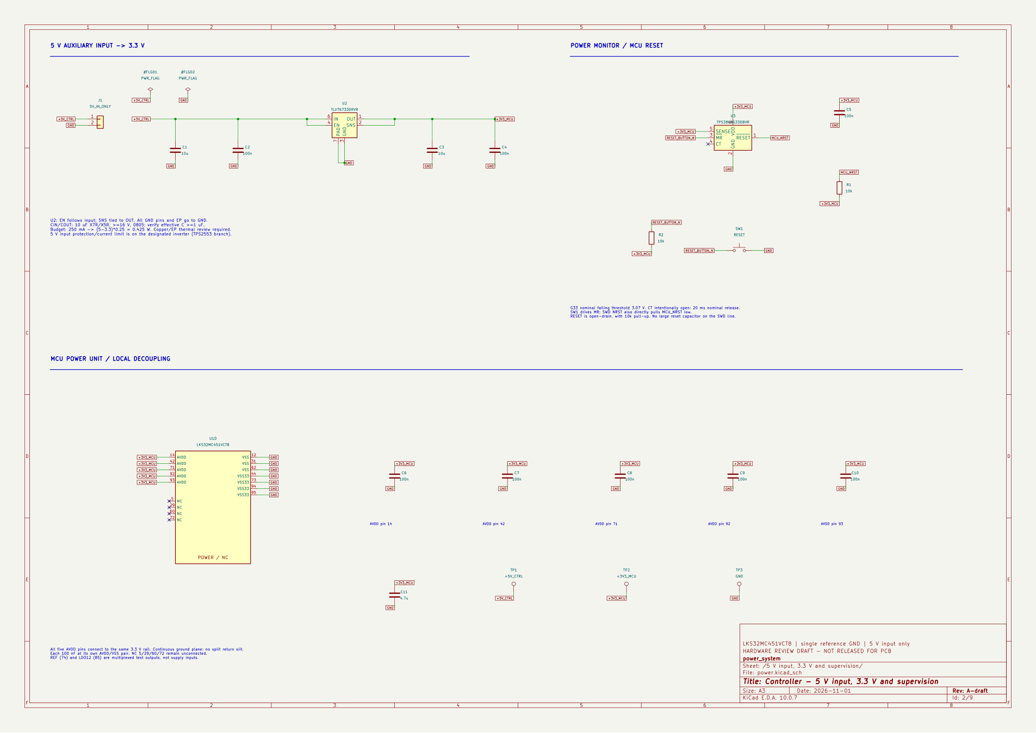
controller/hardware/review/preview/page-02.png
