leolei2012/power_system/controller/hardware/review/preview/page-04.png

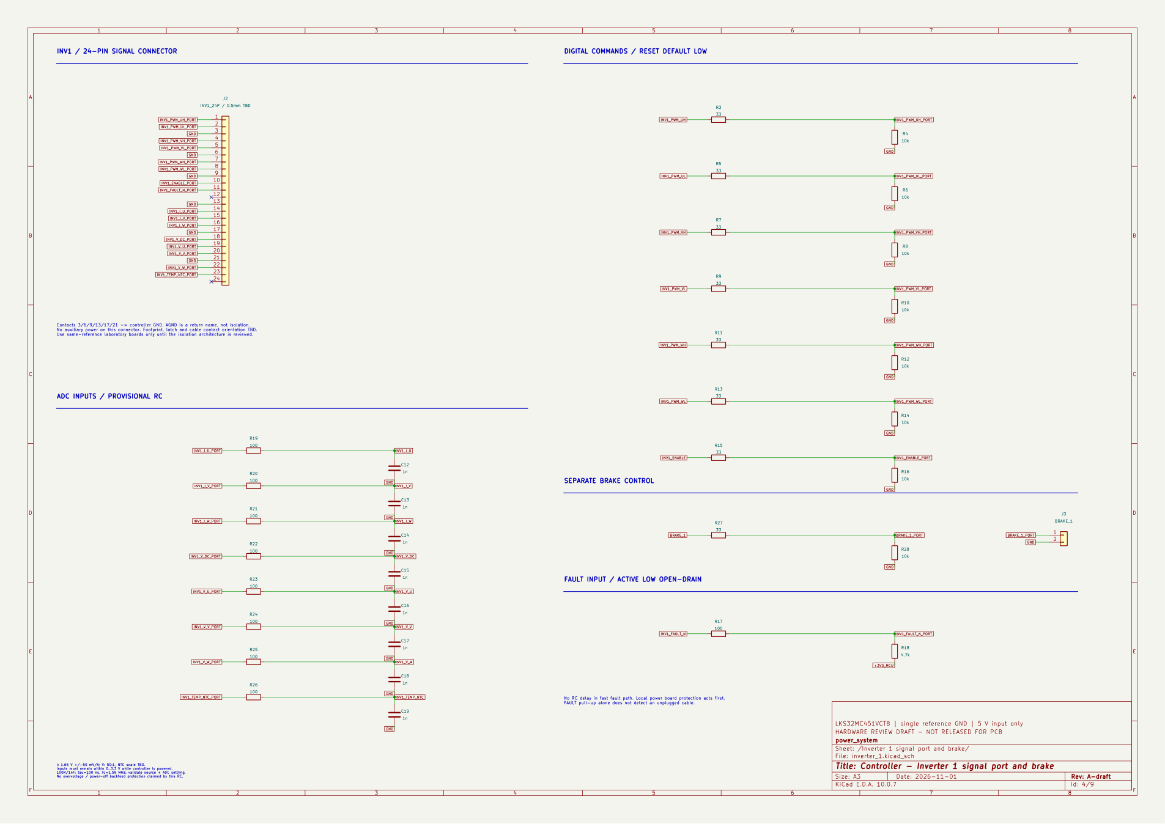
controller/hardware/review/preview/page-04.png
