leolei2012/power_system/inverter/hardware/review/base_minimum_17.png

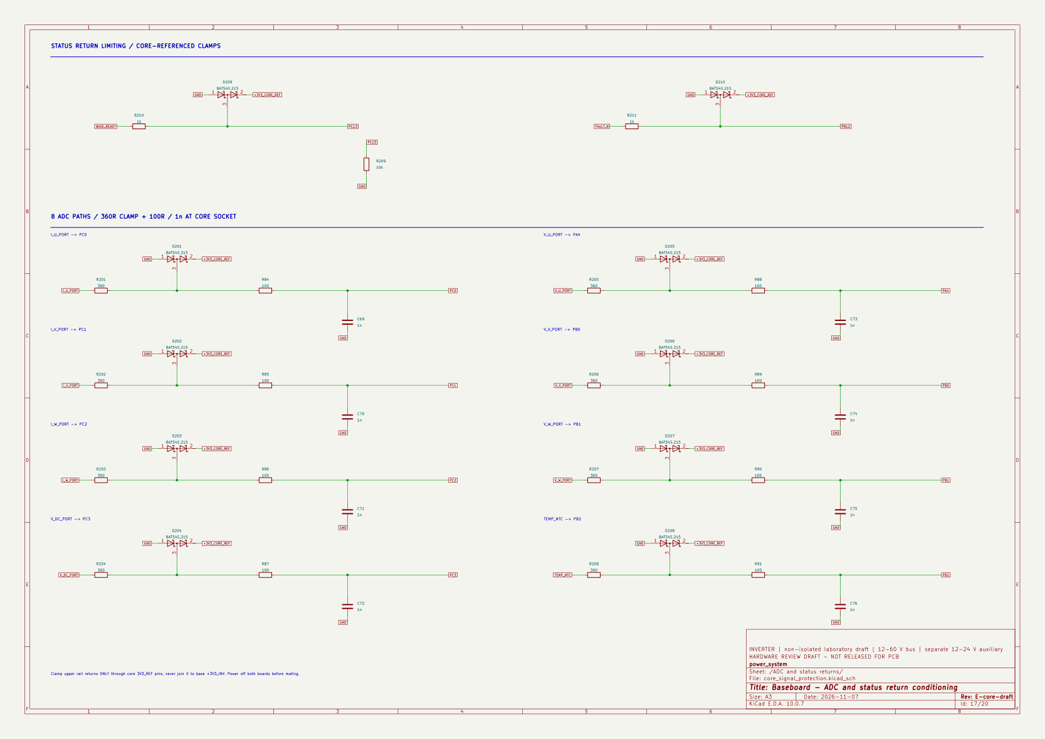
inverter/hardware/review/base_minimum_17.png
