leolei2012/power_system/inverter/hardware/review/base_minimum_19.png

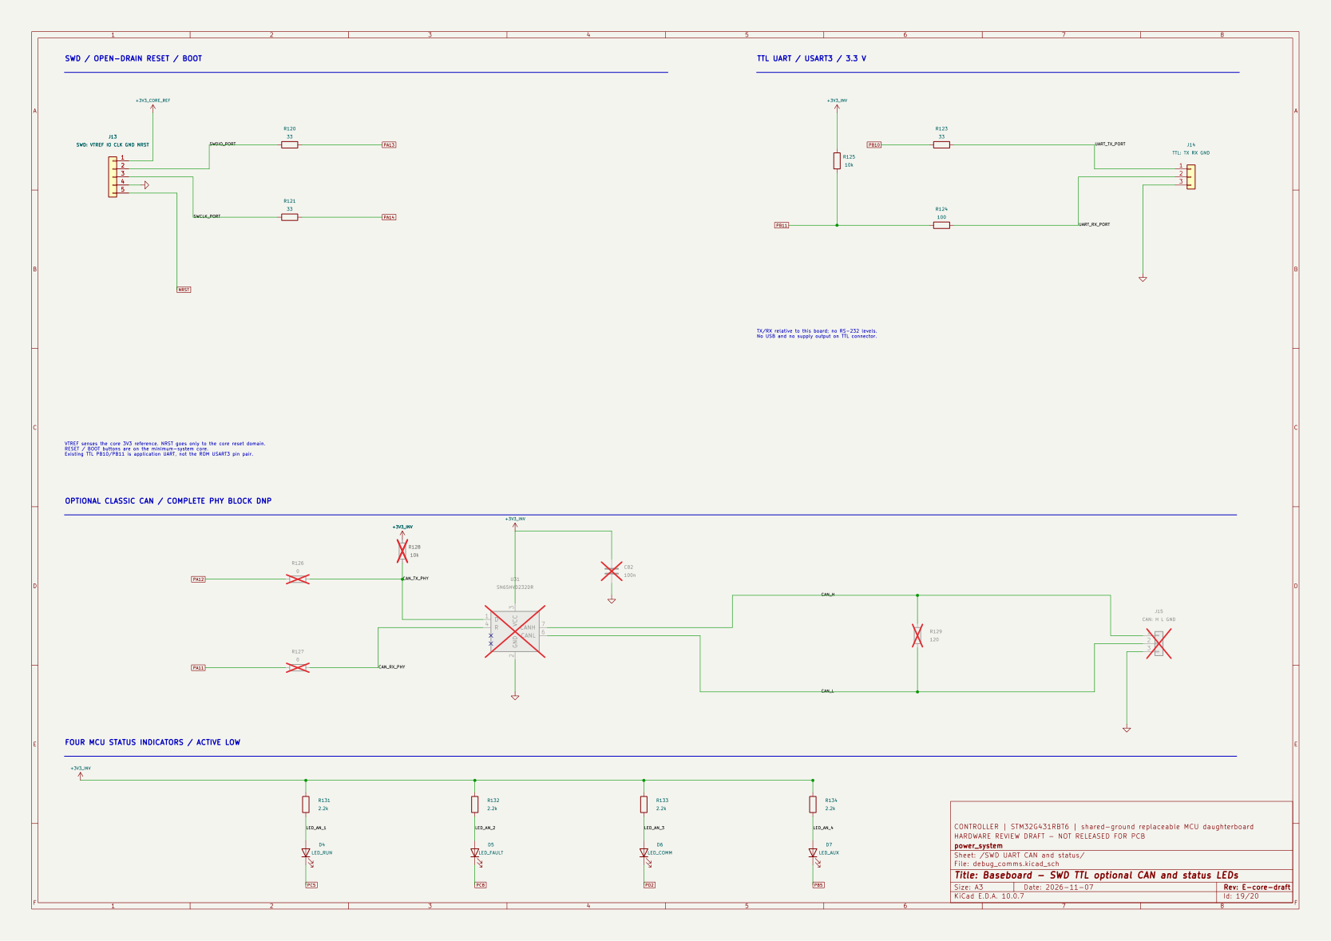
inverter/hardware/review/base_minimum_19.png
