leolei2012/power_system/inverter/hardware/review/base_minimum_20.png

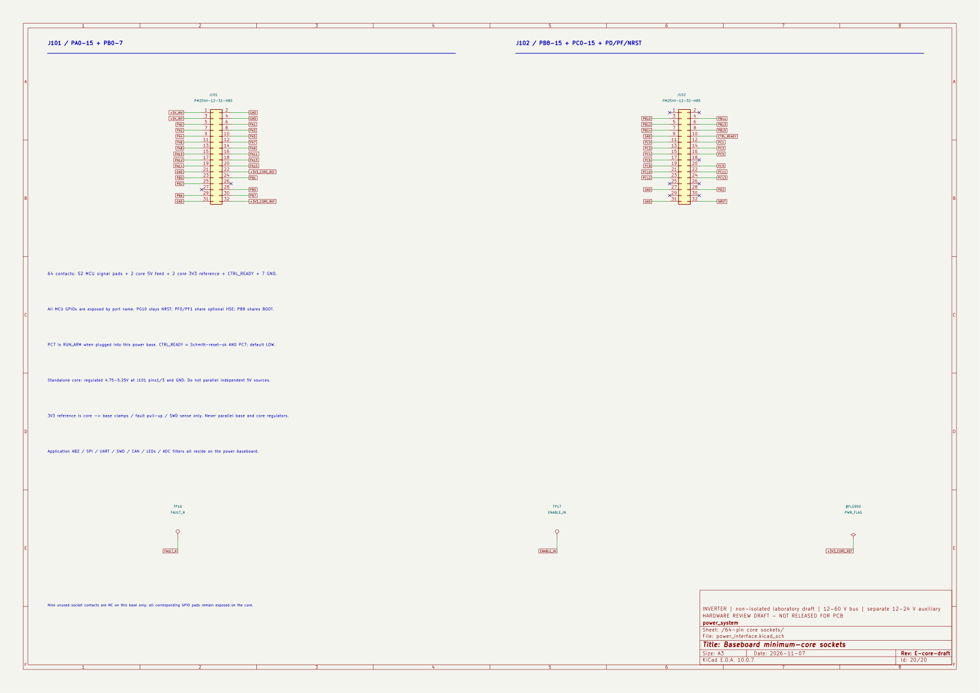
inverter/hardware/review/base_minimum_20.png
