leolei2012/power_system/inverter/hardware/review/base_minimum_contact.png

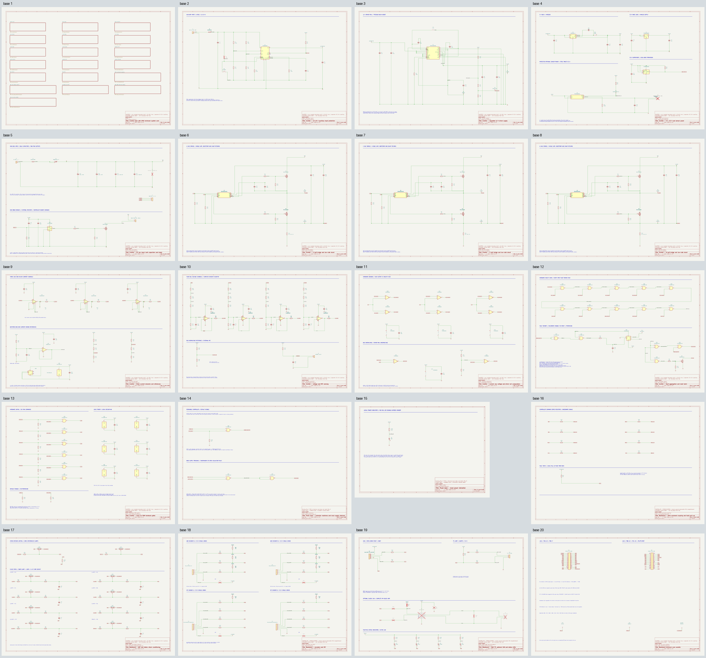
inverter/hardware/review/base_minimum_contact.png
