leolei2012/power_system/inverter/hardware/review/compact_d1_pinout.png

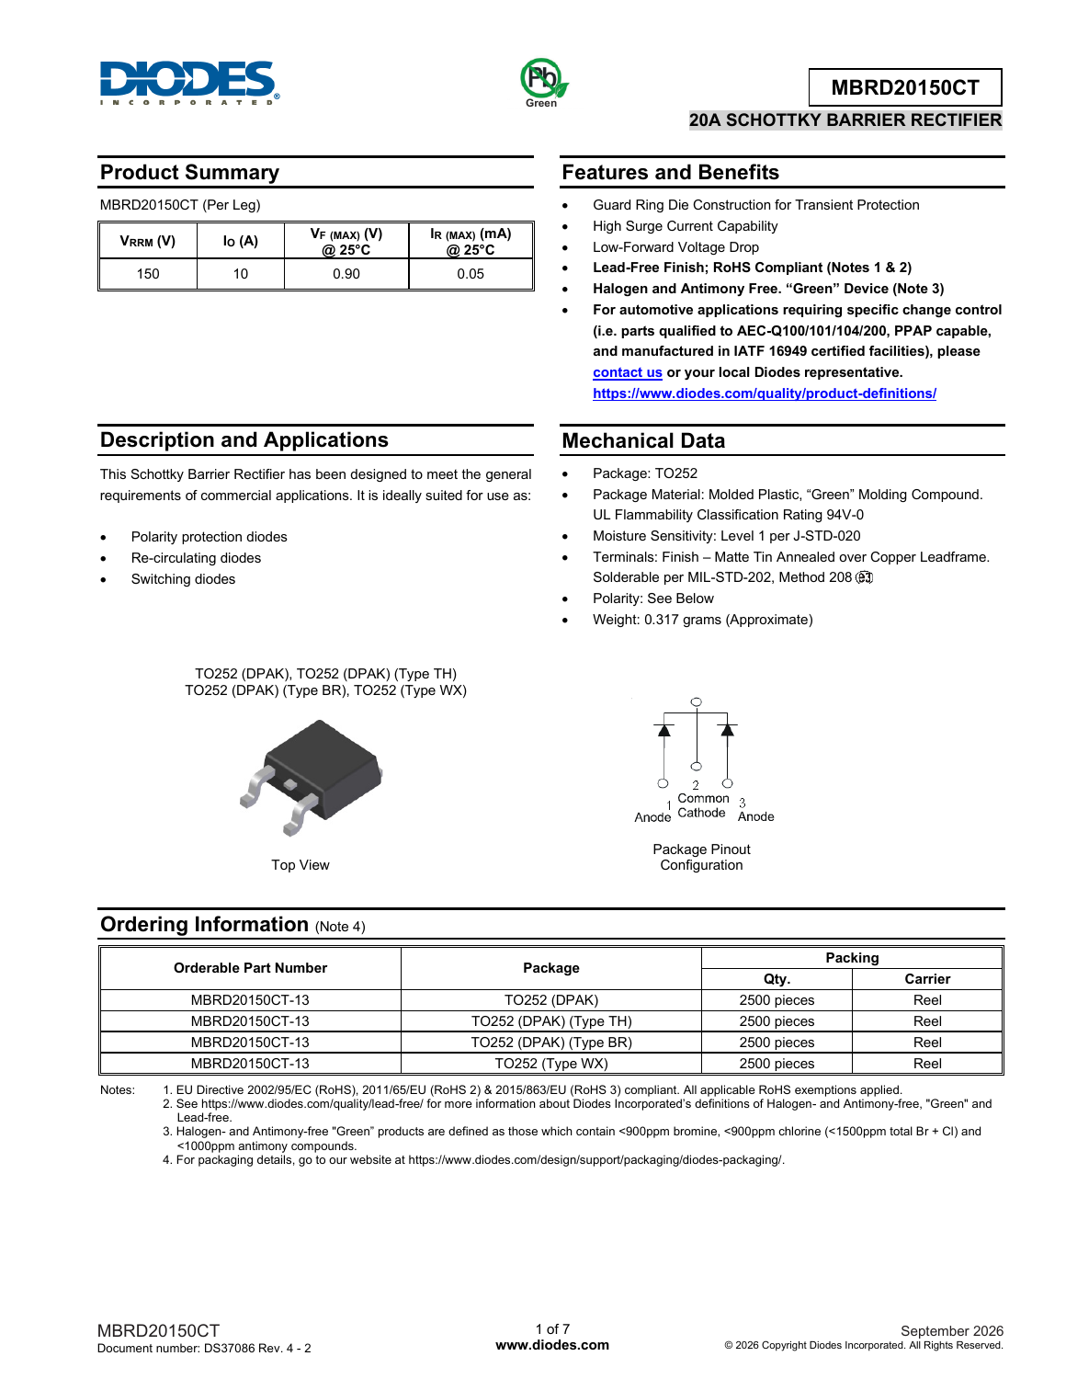
inverter/hardware/review/compact_d1_pinout.png
