leolei2012/power_system/inverter/hardware/review/compact_first_top.png

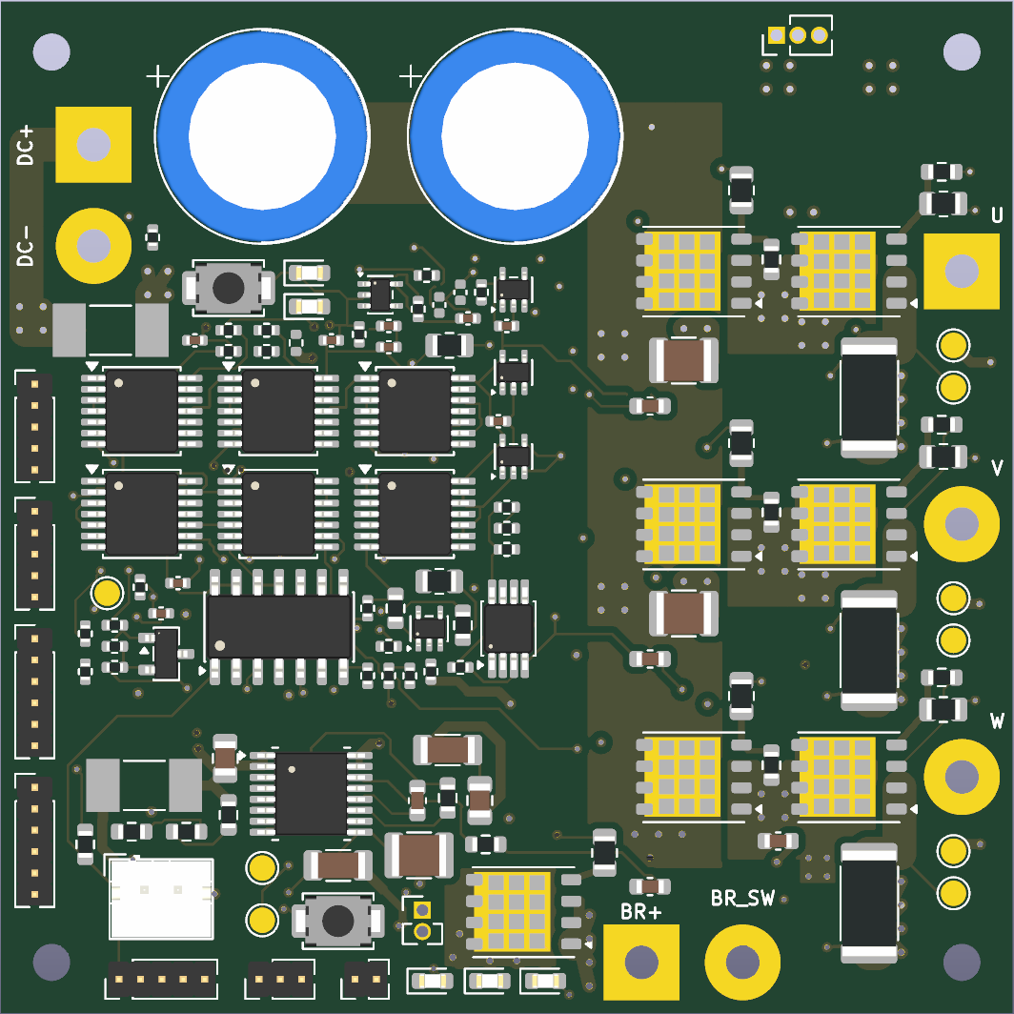
inverter/hardware/review/compact_first_top.png
