leolei2012/power_system/inverter/hardware/review/compact_placement_top.png

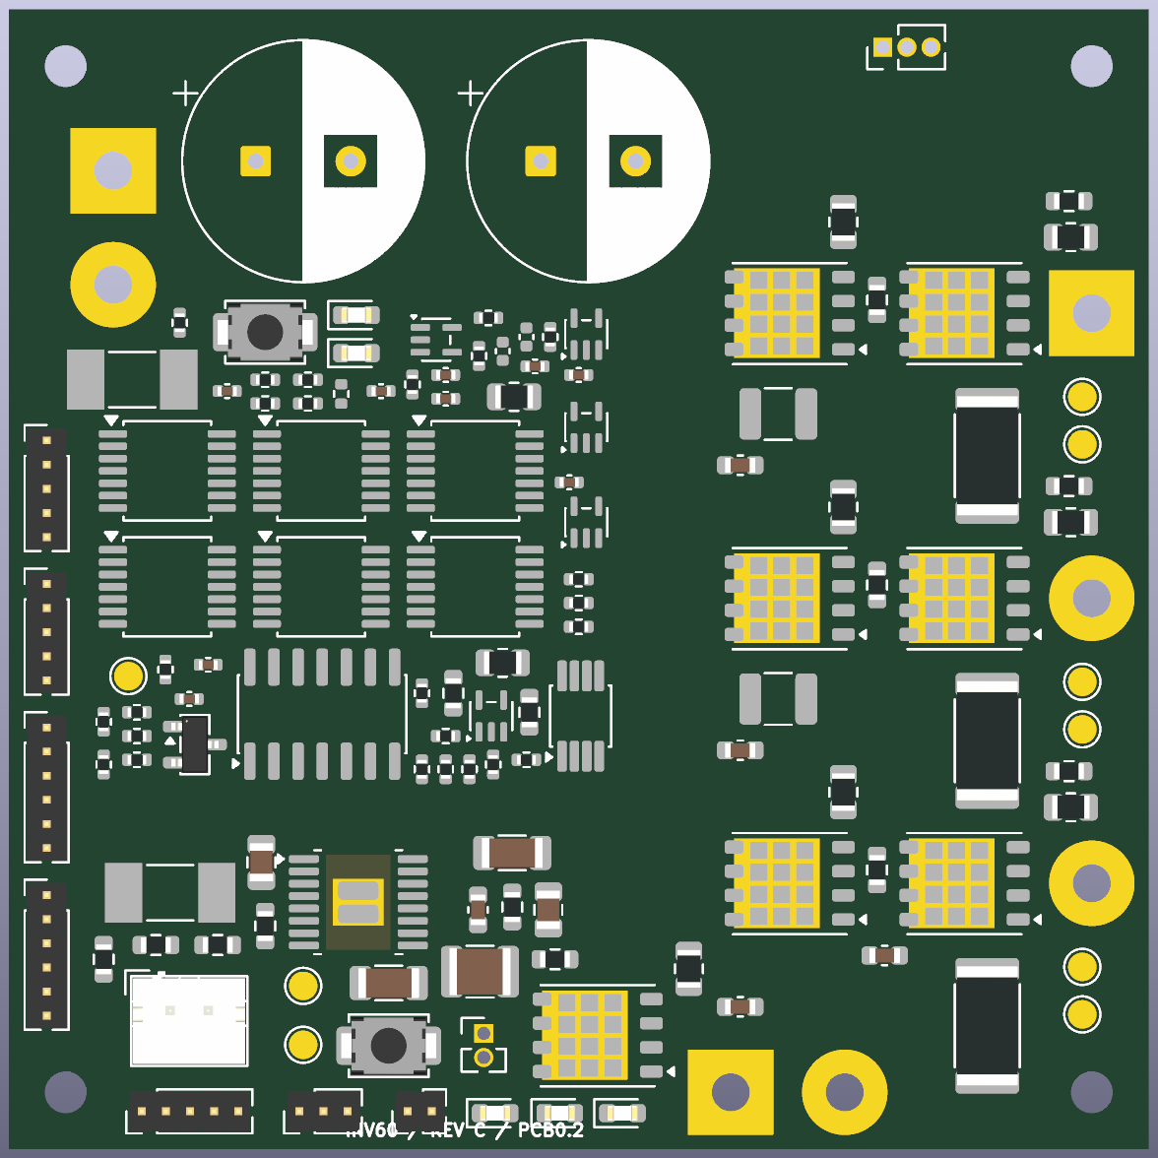
inverter/hardware/review/compact_placement_top.png
