leolei2012/power_system/inverter/hardware/review/compact_sch_page_06.png

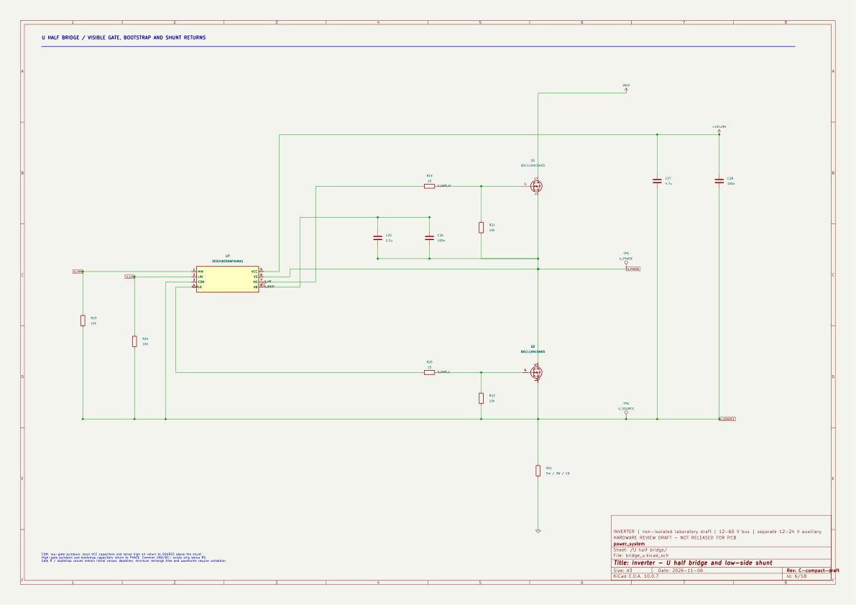
inverter/hardware/review/compact_sch_page_06.png
