leolei2012/power_system/inverter/hardware/review/pcb_back_copper.png

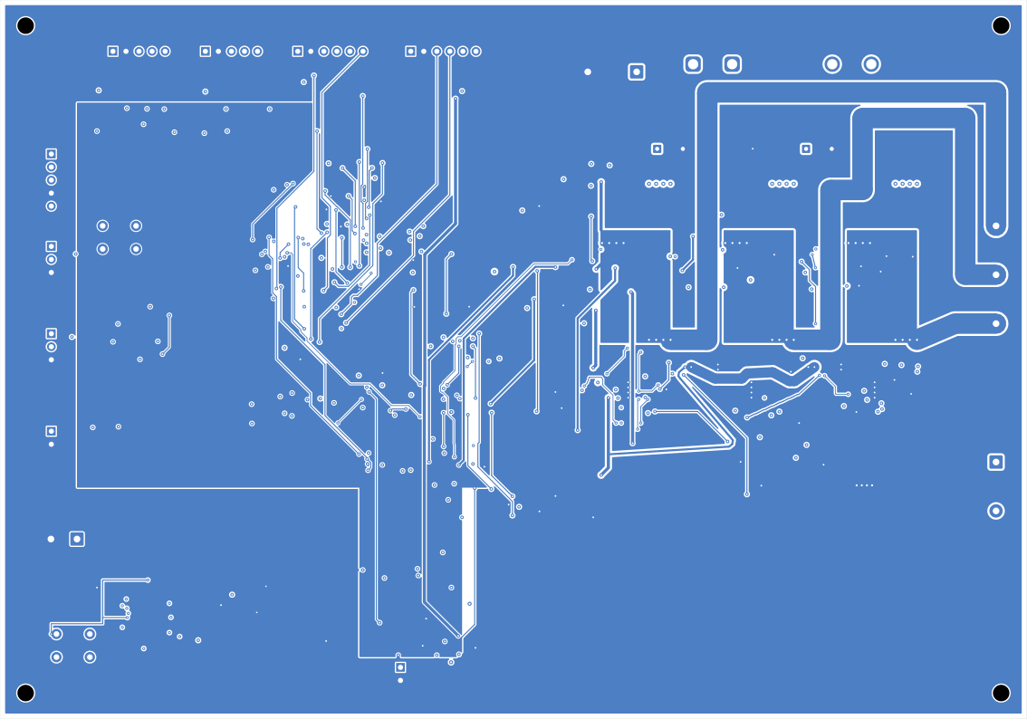
inverter/hardware/review/pcb_back_copper.png
