leolei2012/power_system/inverter/hardware/review/pcb_front_copper.png

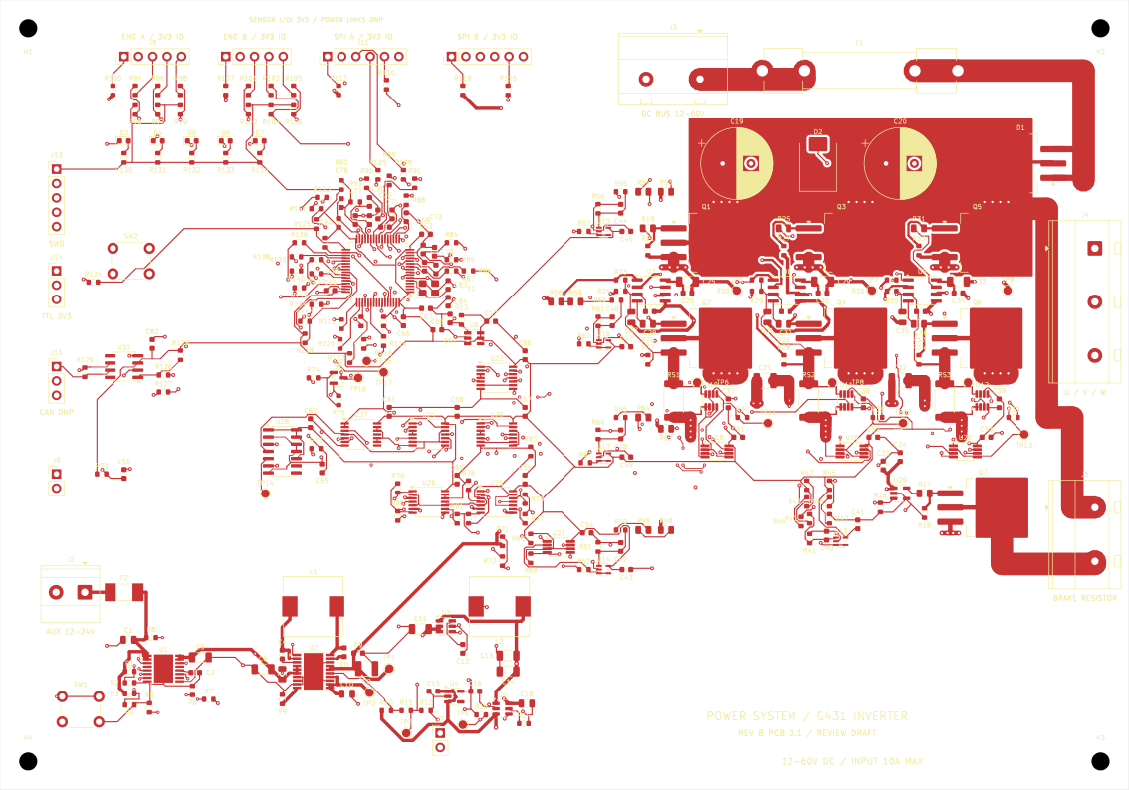
inverter/hardware/review/pcb_front_copper.png
