leolei2012/power_system/inverter/hardware/review/pcb_power_review_tmp/power_bottom.png

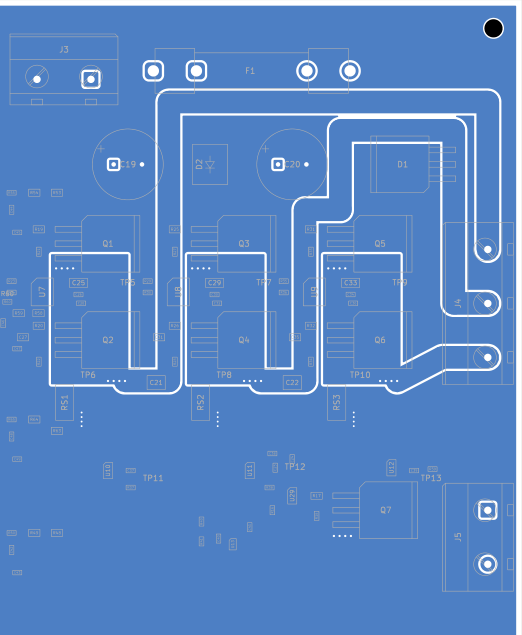
inverter/hardware/review/pcb_power_review_tmp/power_bottom.png
