leolei2012/power_system/inverter/hardware/review/pcb_top.png

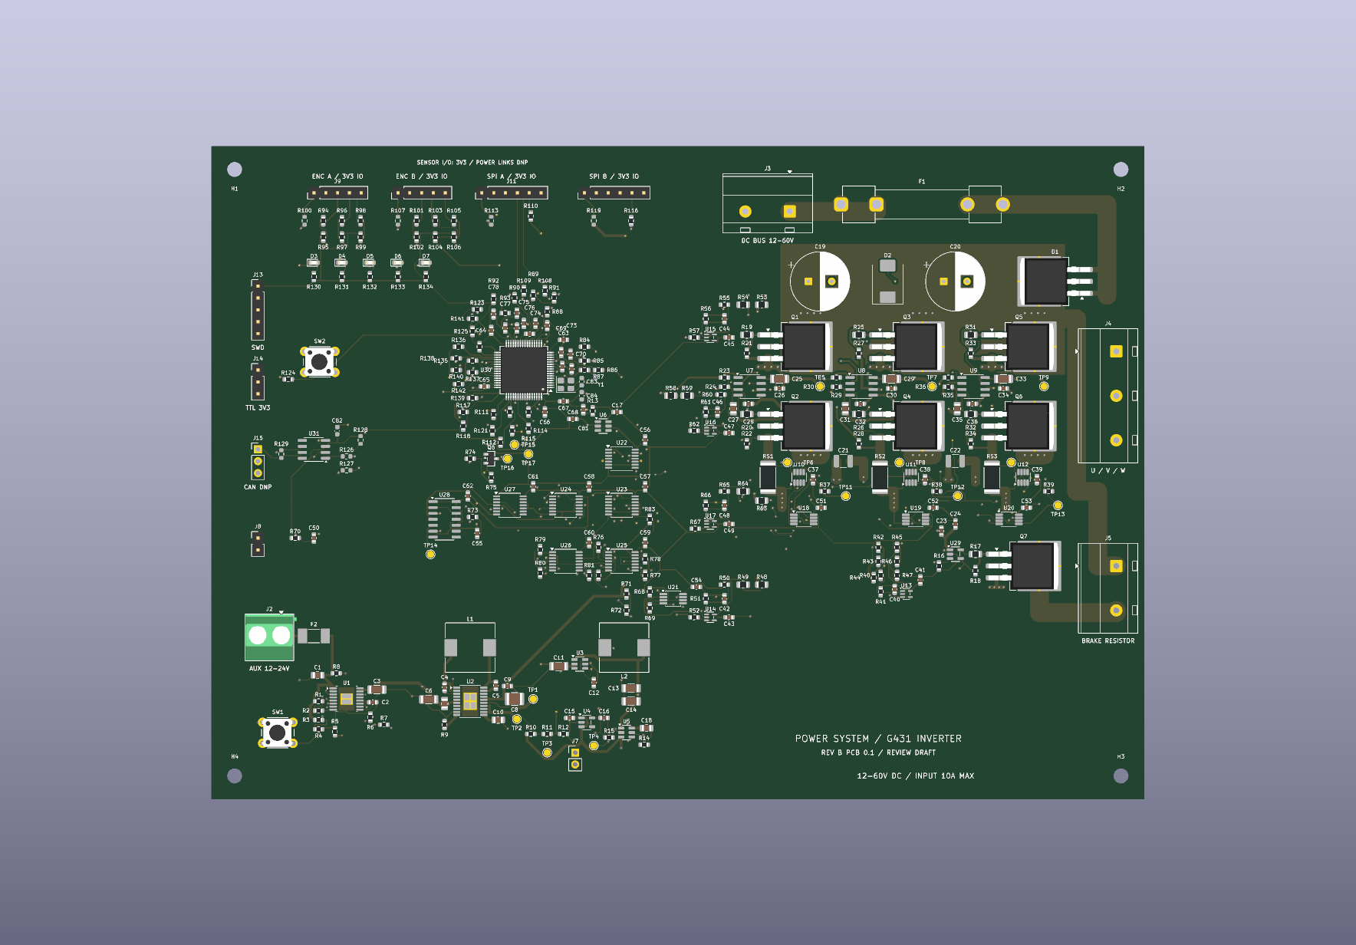
inverter/hardware/review/pcb_top.png
