leolei2012/power_system/inverter/hardware/review/power_contact_final.png

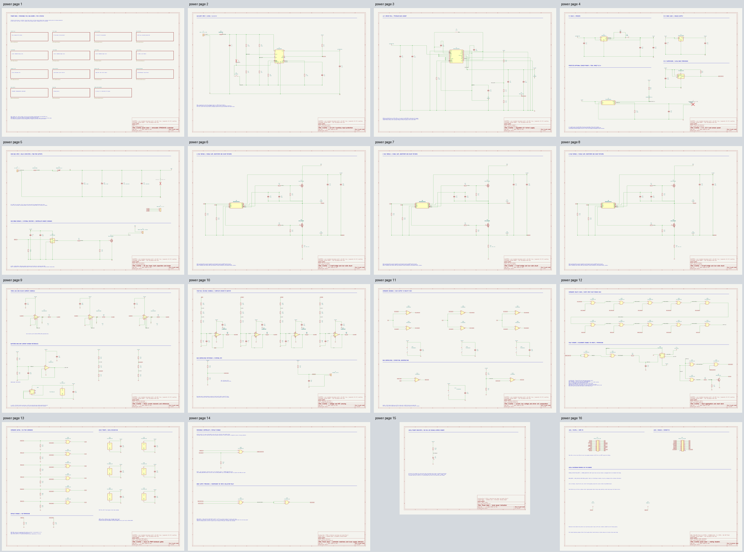
inverter/hardware/review/power_contact_final.png
