leolei2012/power_system/inverter/hardware/review/power_final_01.png

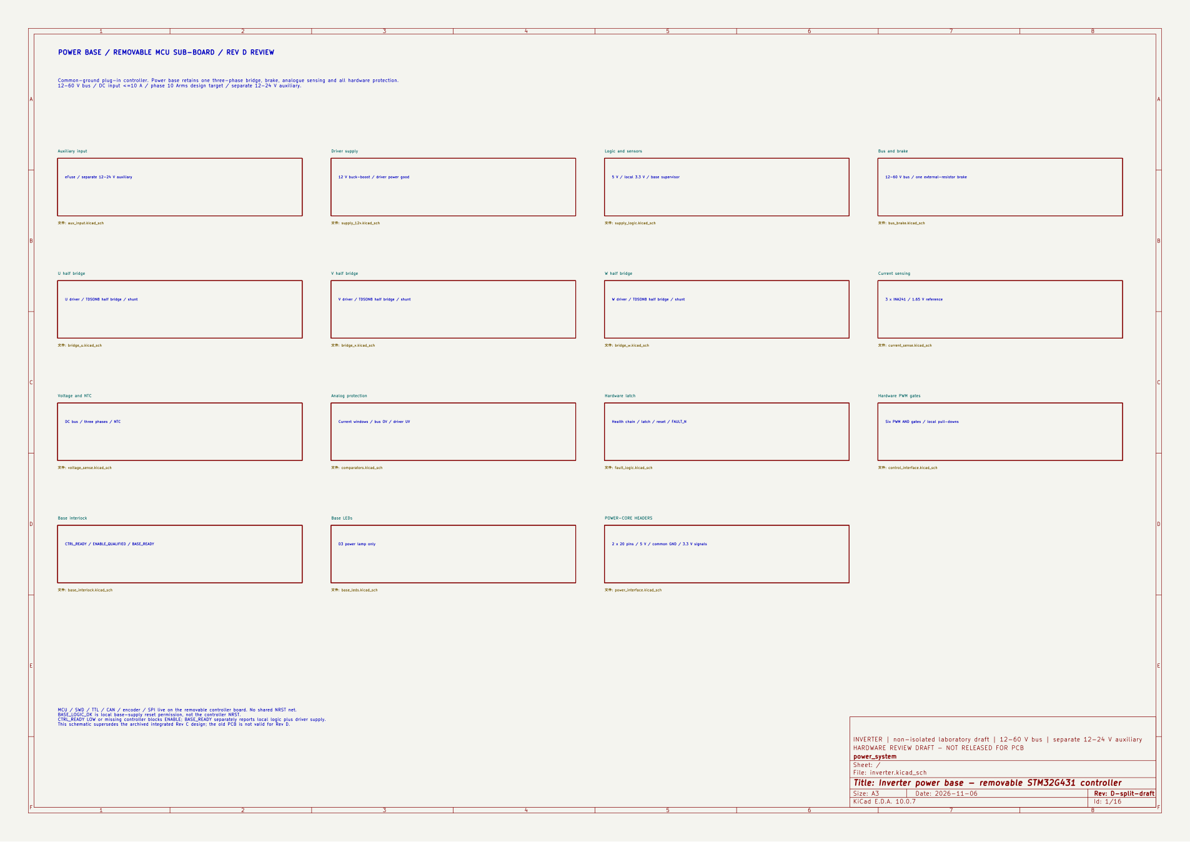
inverter/hardware/review/power_final_01.png
