leolei2012/power_system/inverter/hardware/review/power_final_16.png

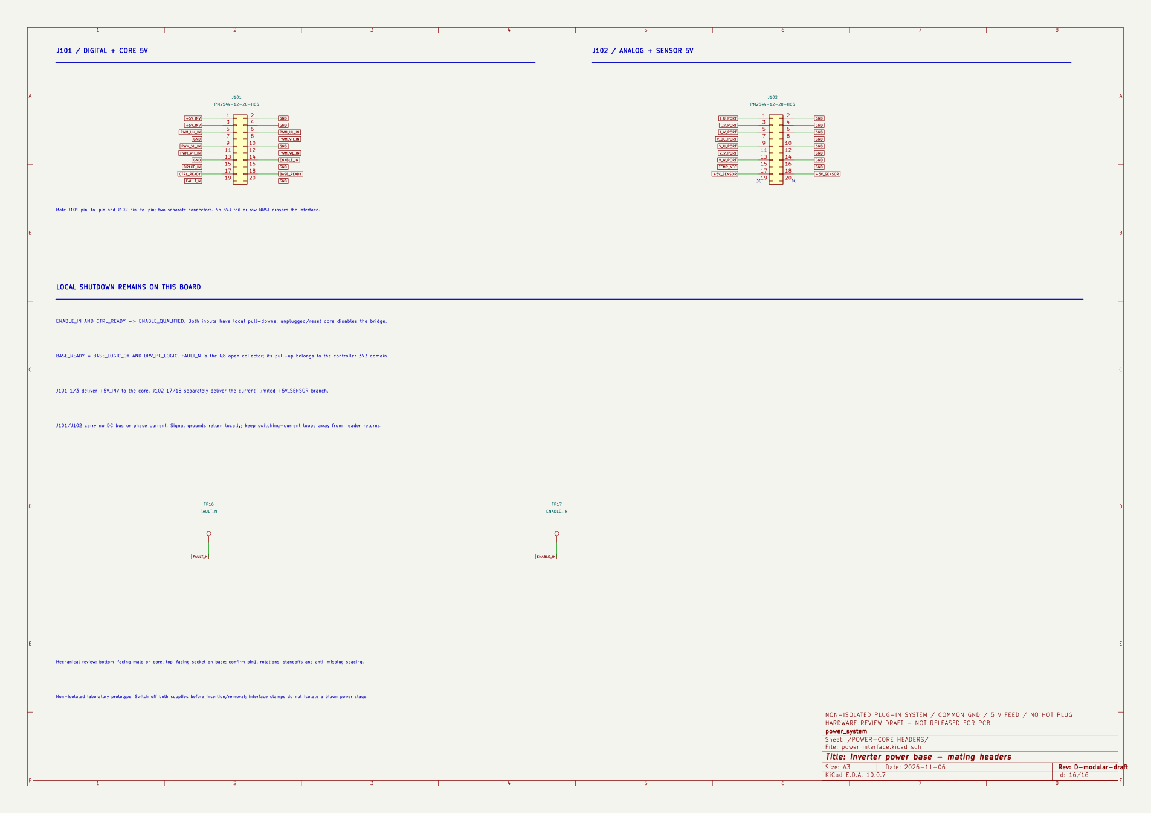
inverter/hardware/review/power_final_16.png
