leolei2012/power_system/inverter/hardware/review/power_redraw_renders/p3.png

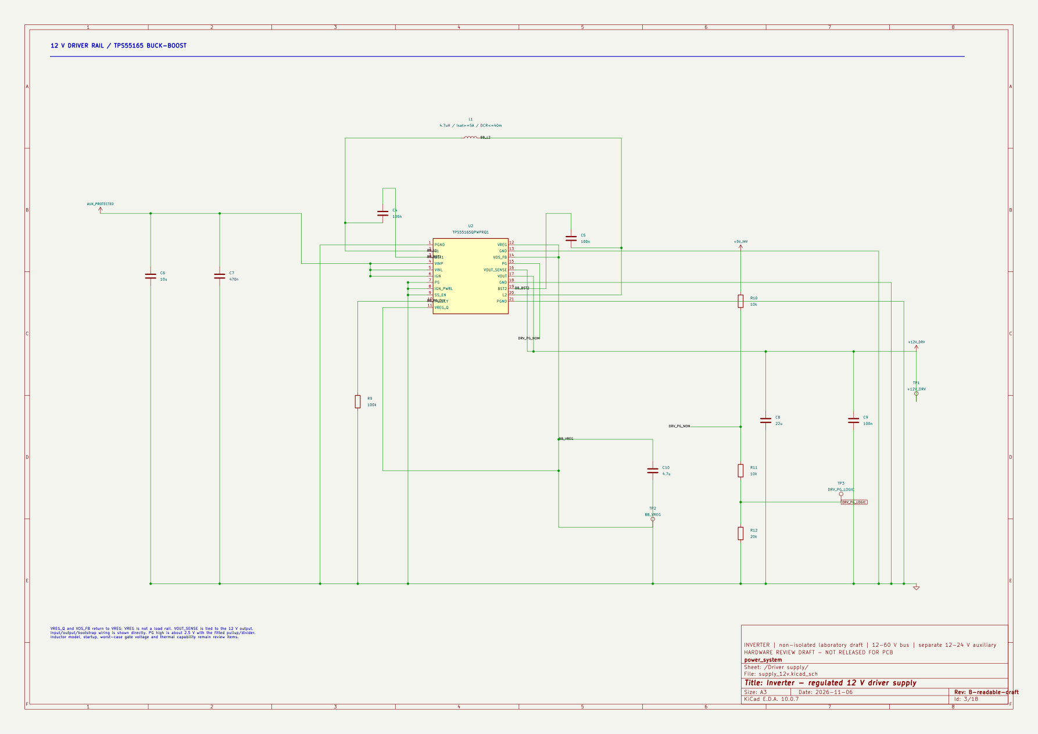
inverter/hardware/review/power_redraw_renders/p3.png
