leolei2012/power_system/inverter/hardware/review/preview/contact-sheet.png

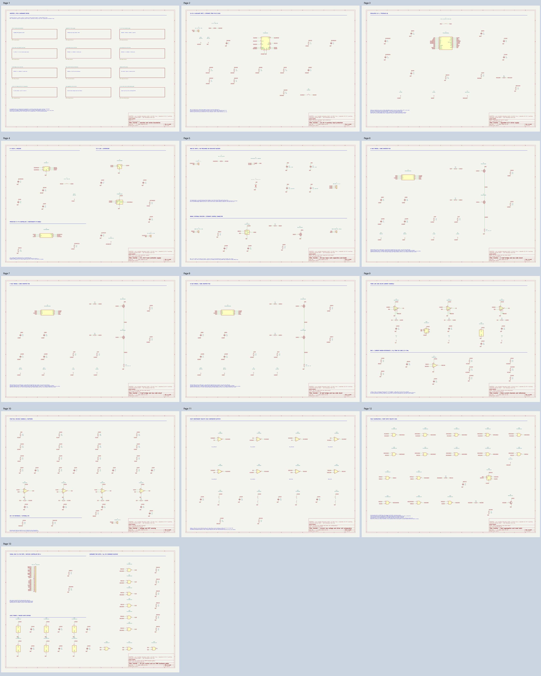
inverter/hardware/review/preview/contact-sheet.png
