leolei2012/power_system/inverter/hardware/review/preview/page-10.png

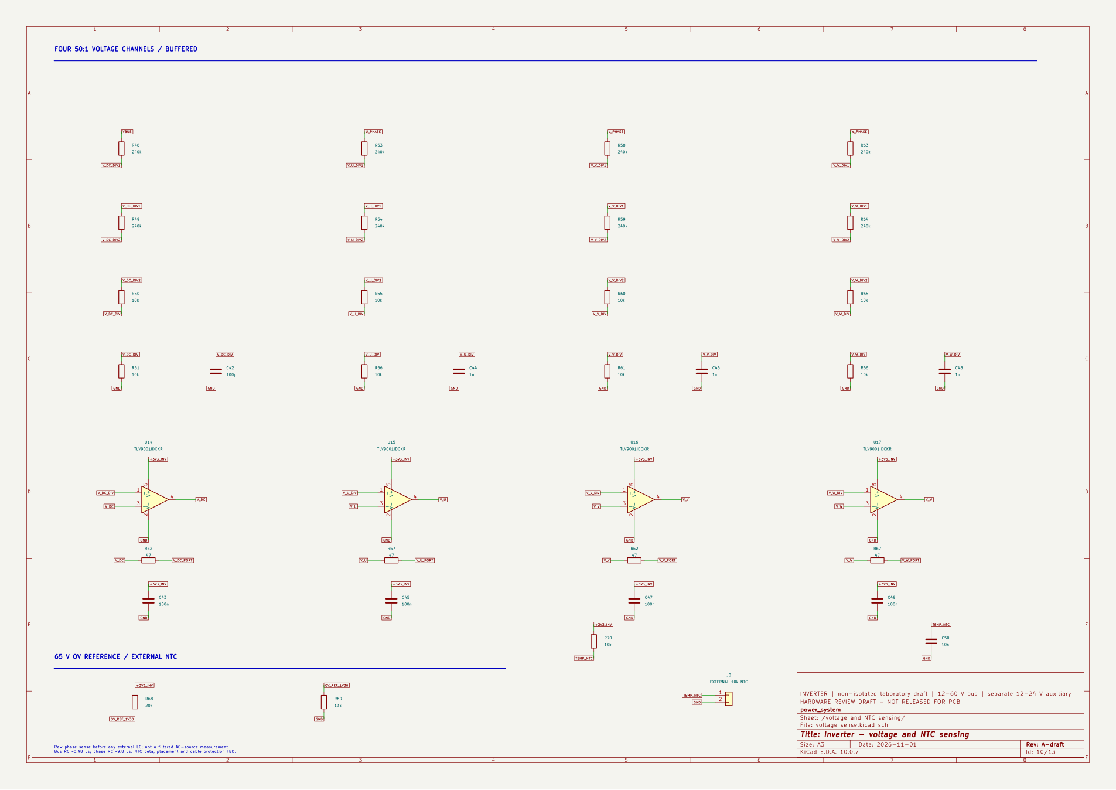
inverter/hardware/review/preview/page-10.png
