leolei2012/power_system/inverter/hardware/review/preview/page-13.png

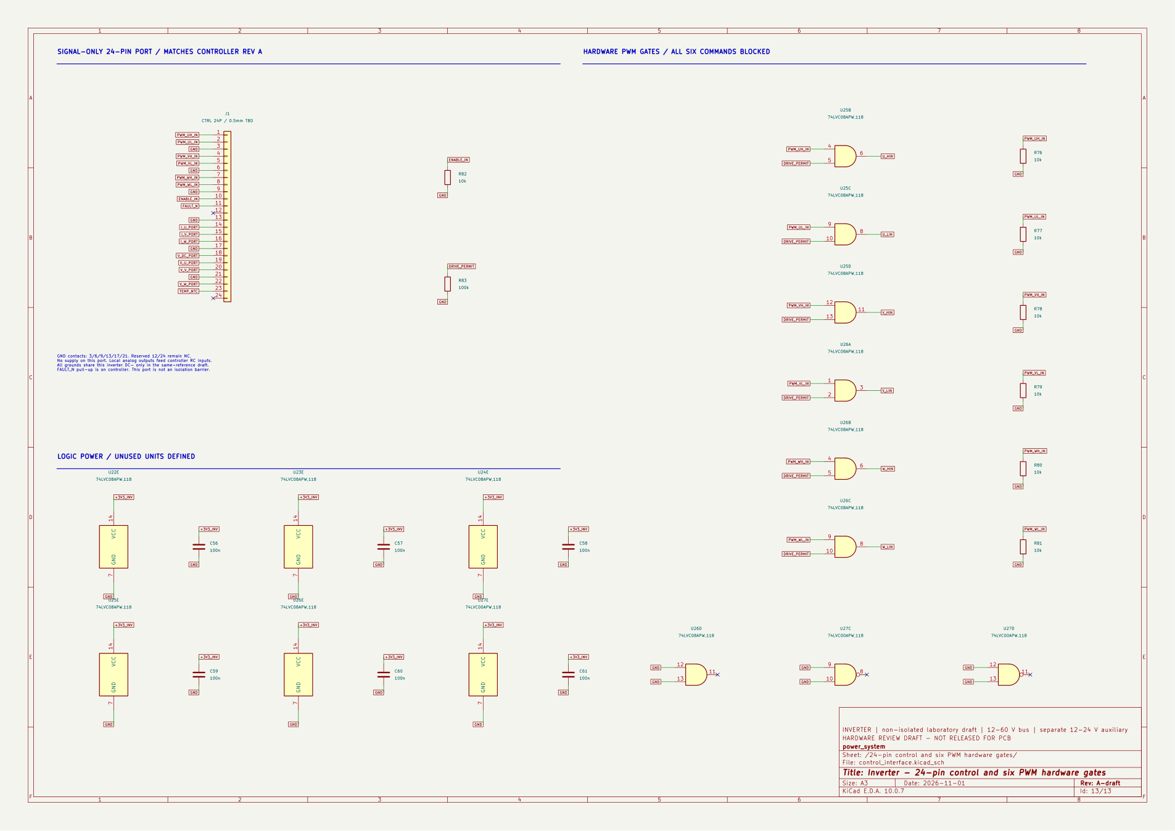
inverter/hardware/review/preview/page-13.png
