leolei2012/power_system/inverter/hardware/review/renders_readable/contact_01_06.png

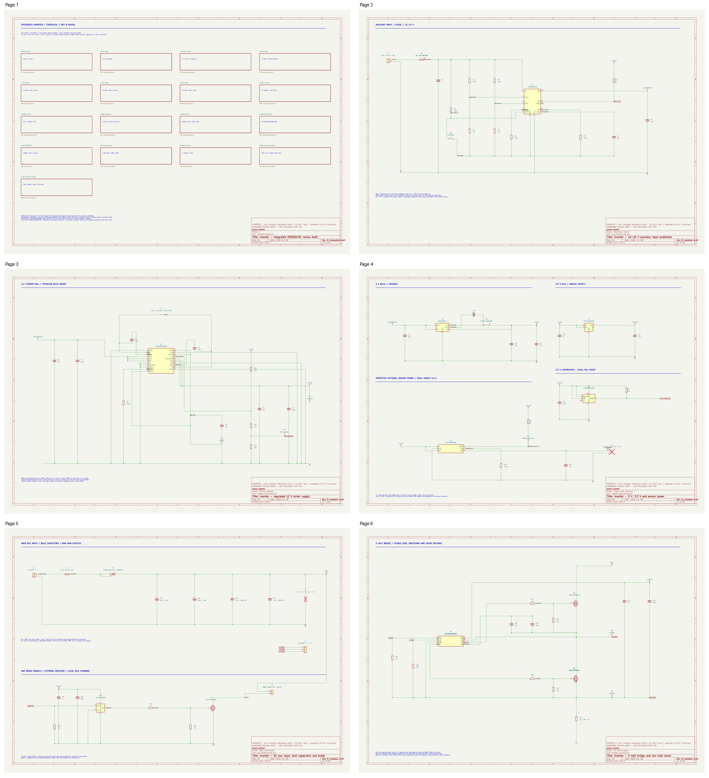
inverter/hardware/review/renders_readable/contact_01_06.png
