leolei2012/power_system/inverter/hardware/review/renders_readable/contact_07_12.png

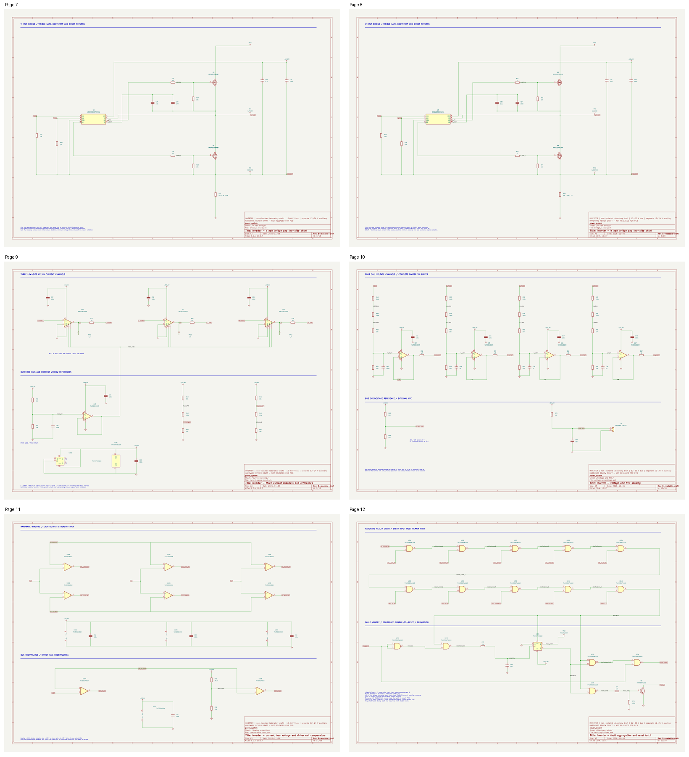
inverter/hardware/review/renders_readable/contact_07_12.png
