leolei2012/power_system/inverter/hardware/review/renders_readable/page_09.png

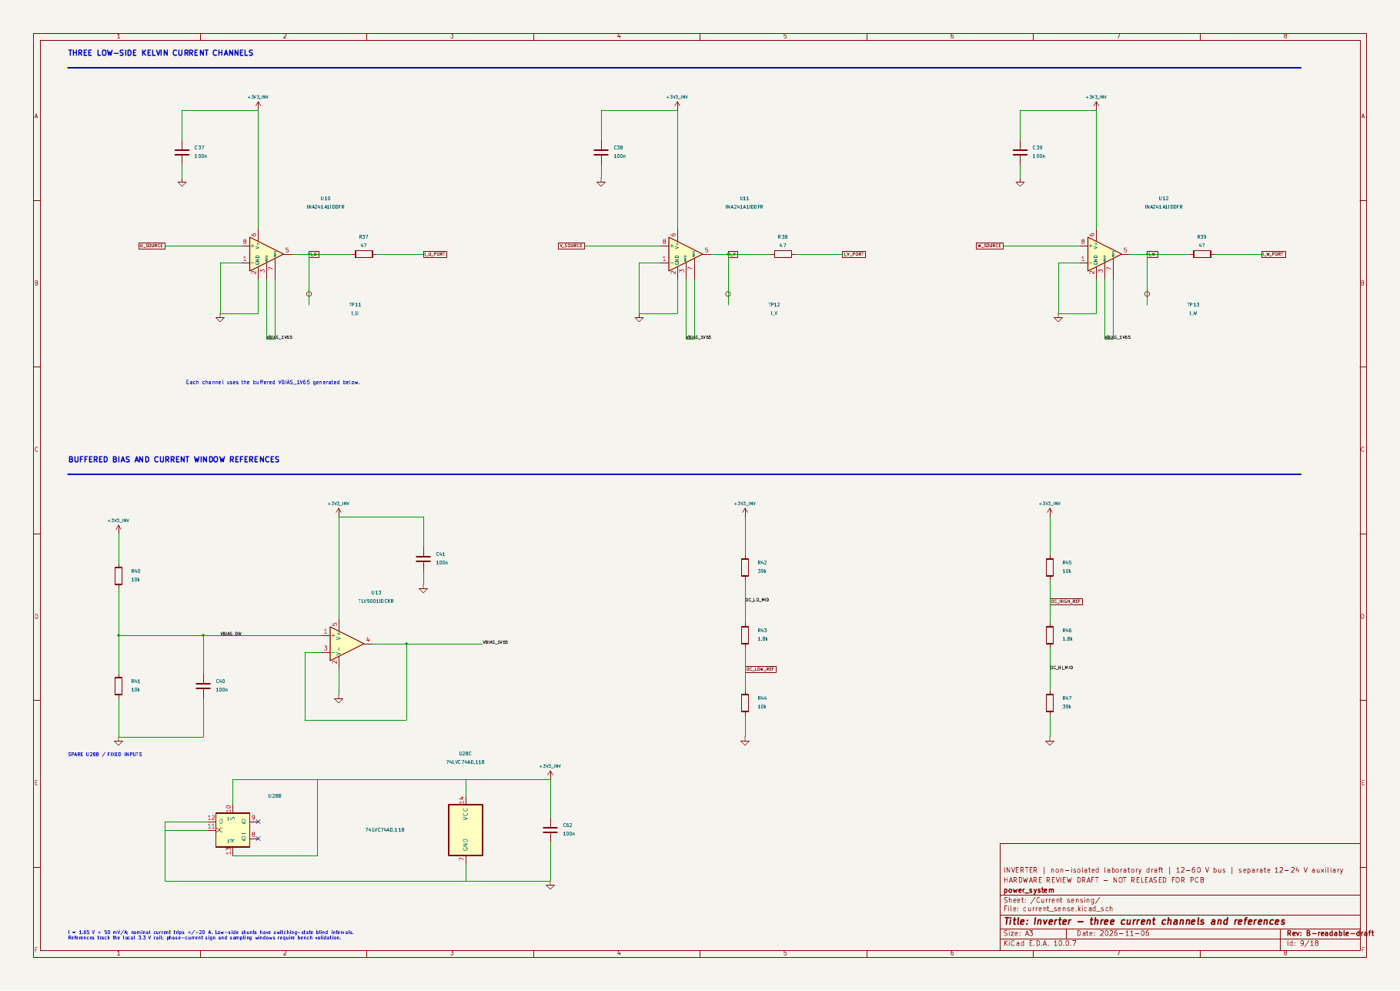
inverter/hardware/review/renders_readable/page_09.png
