leolei2012/power_system/inverter/hardware/review/renders_readable/page_11.png

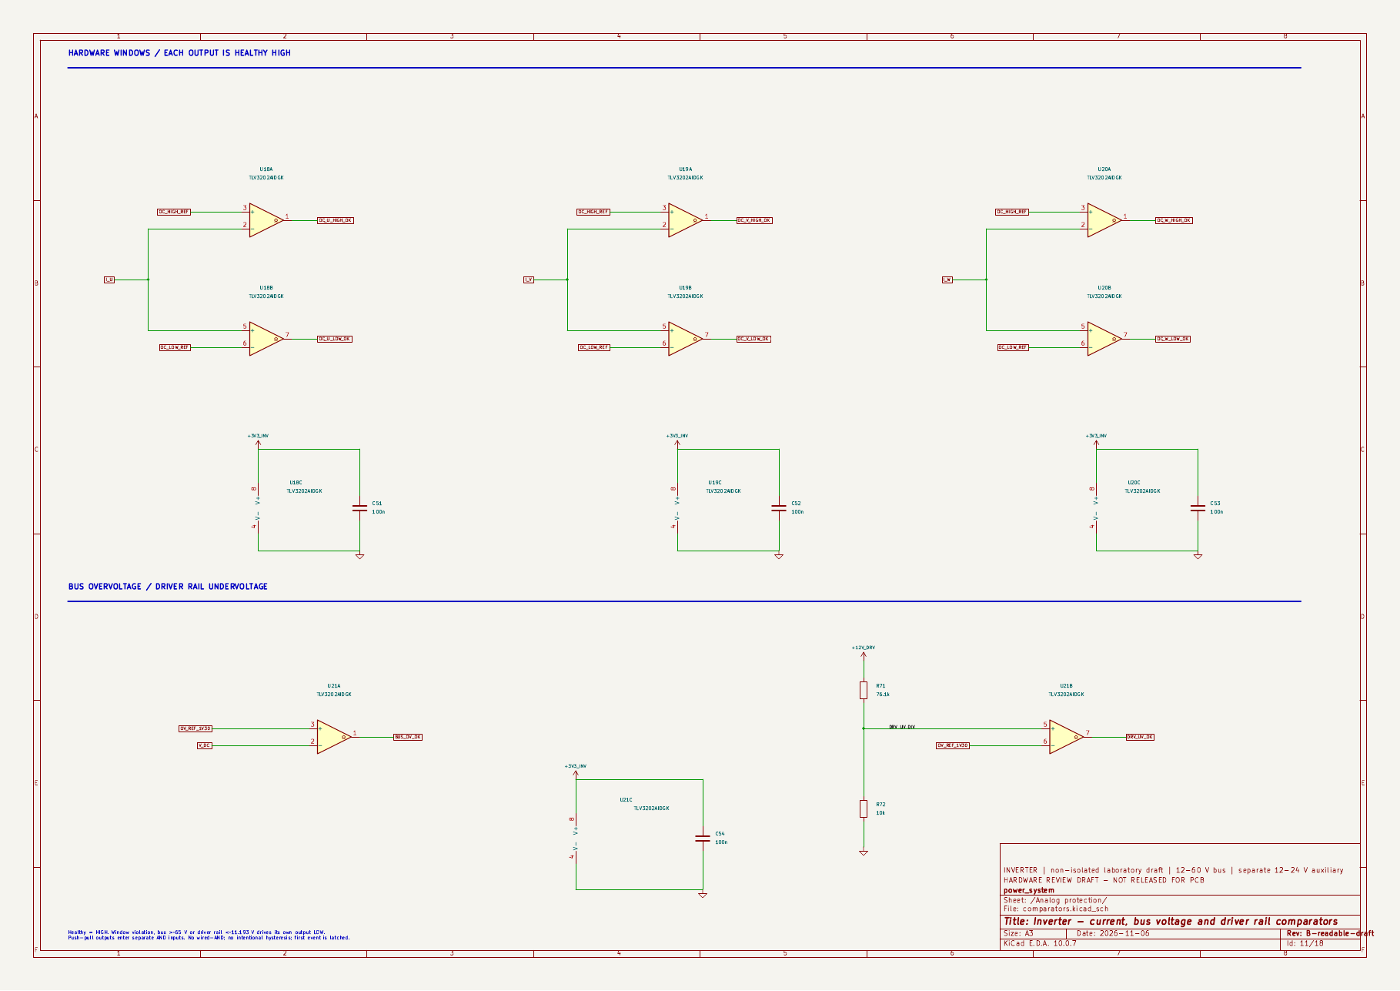
inverter/hardware/review/renders_readable/page_11.png
