leolei2012/power_system/inverter/hardware/review/renders_rev_b/contact_01_06.png

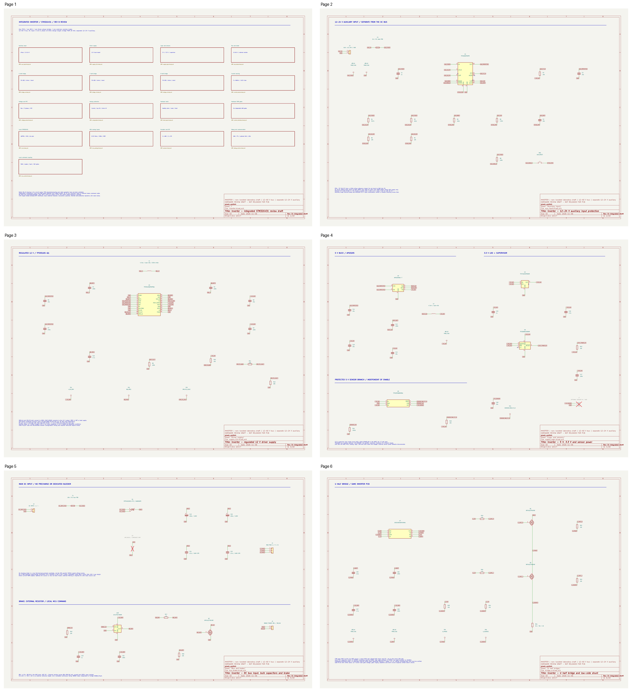
inverter/hardware/review/renders_rev_b/contact_01_06.png
