leolei2012/power_system/inverter/hardware/review/renders_rev_b/page_14.png

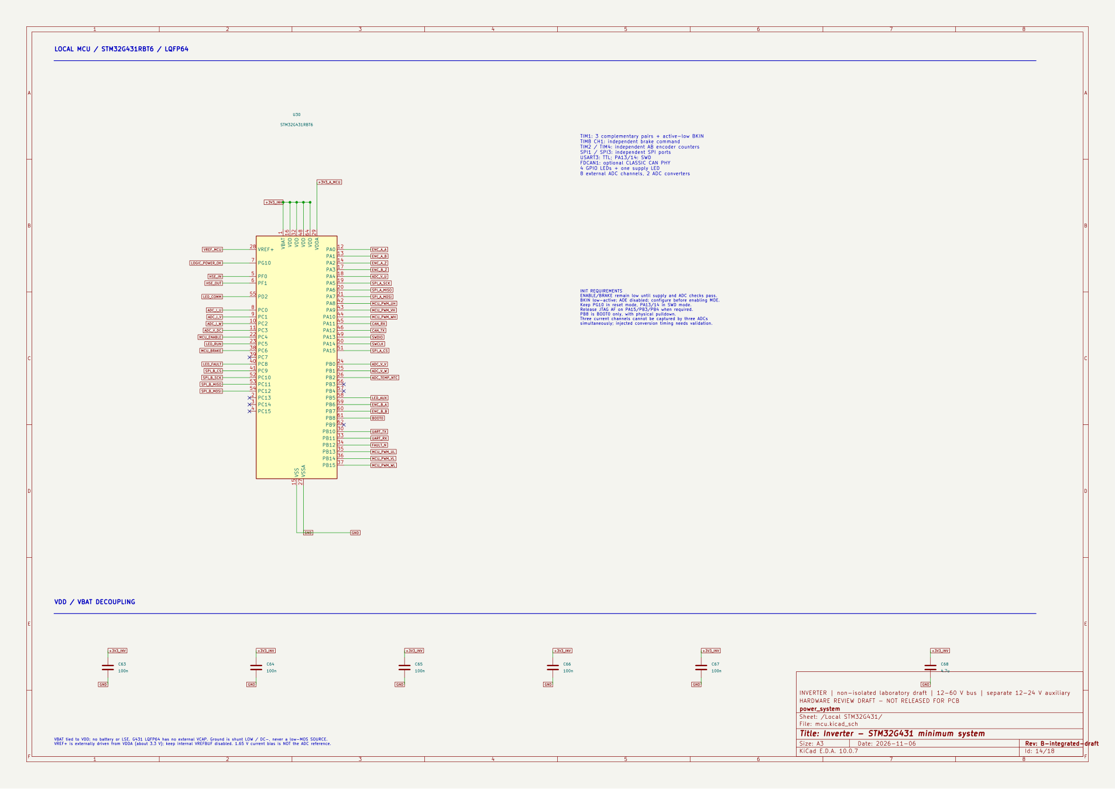
inverter/hardware/review/renders_rev_b/page_14.png
