leolei2012/power_system/inverter/hardware/review/renders_rev_b/page_18.png

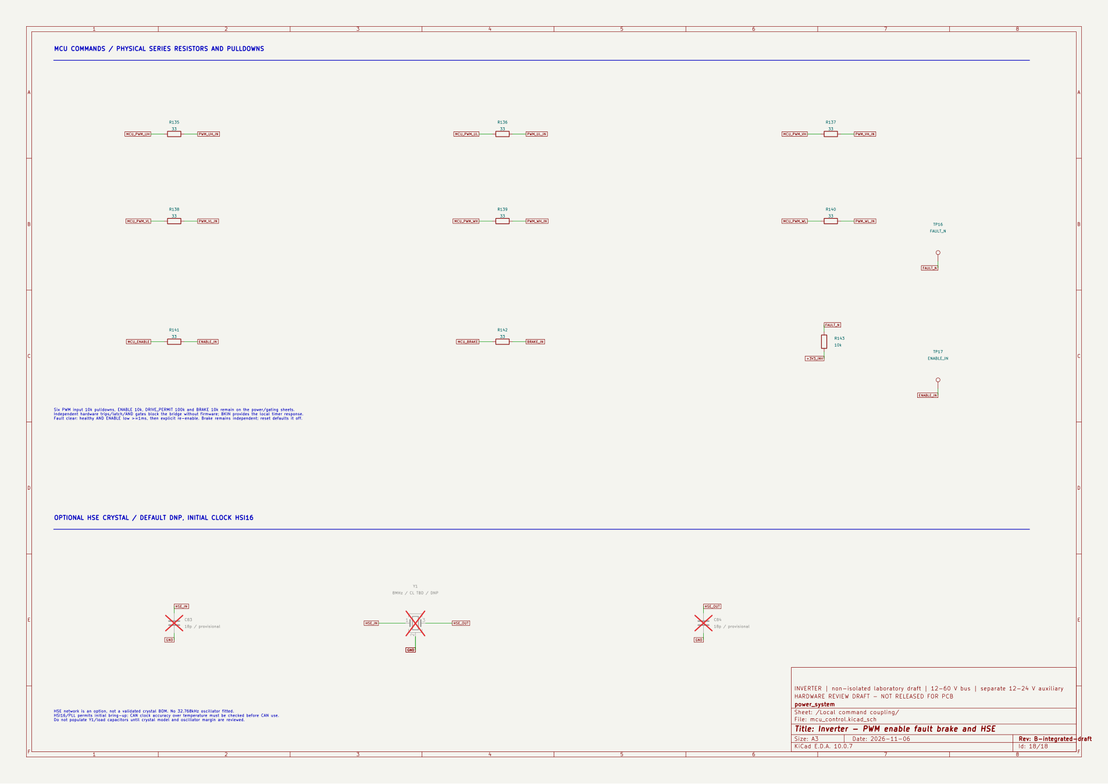
inverter/hardware/review/renders_rev_b/page_18.png
