leolei2012/power_system/inverter/hardware/review/revd_page_12.png

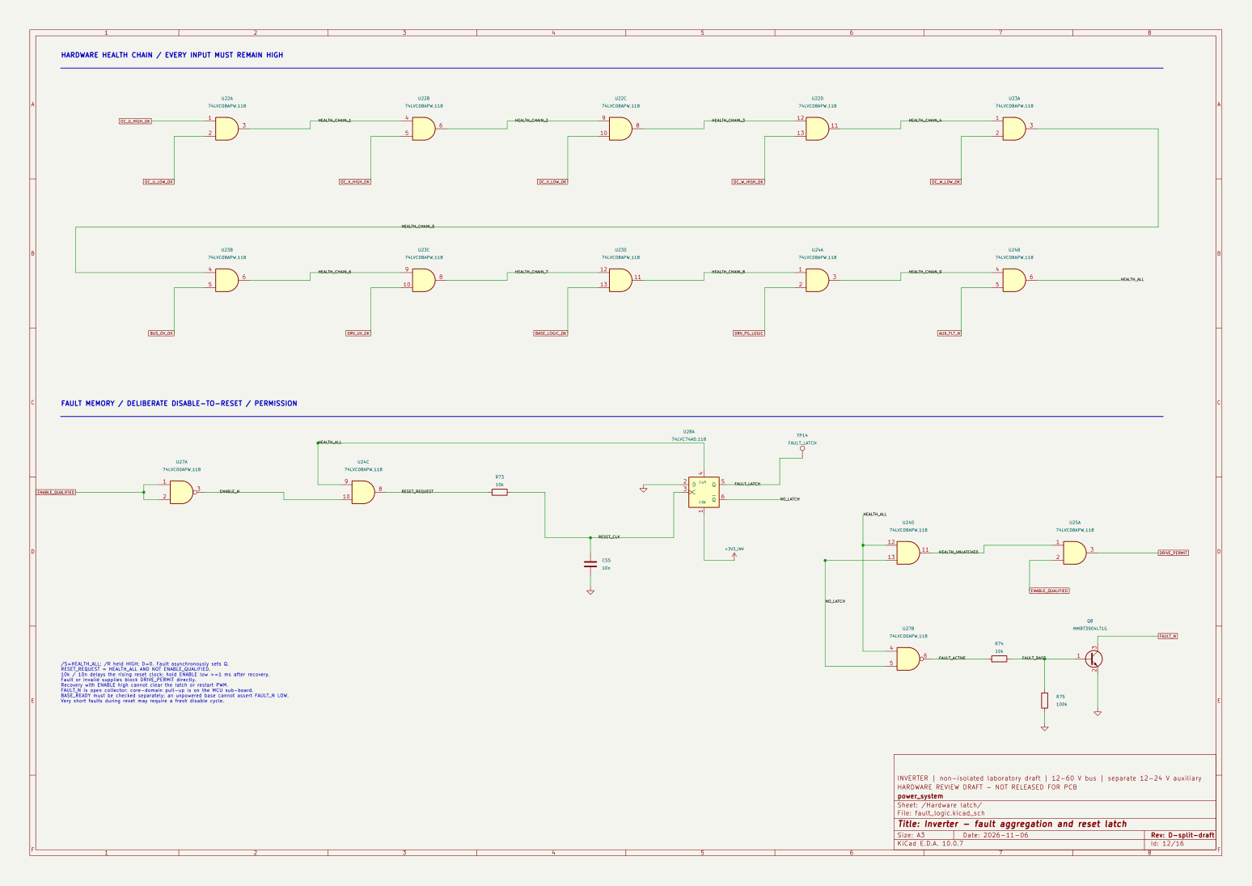
inverter/hardware/review/revd_page_12.png
