leolei2012/power_system/inverter/hardware/review/revd_power_page_13.png

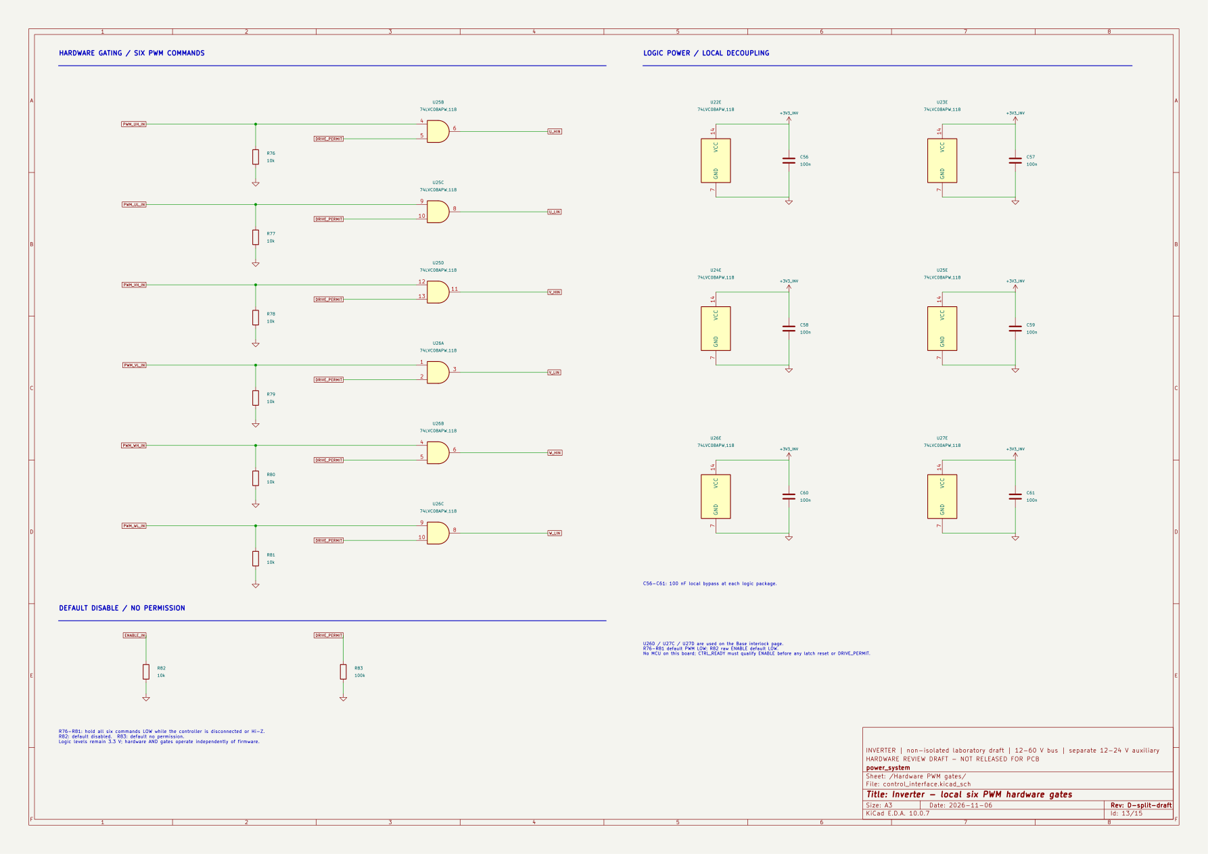
inverter/hardware/review/revd_power_page_13.png
