leolei2012/power_system/inverter/hardware/review/revd_power_page_15.png

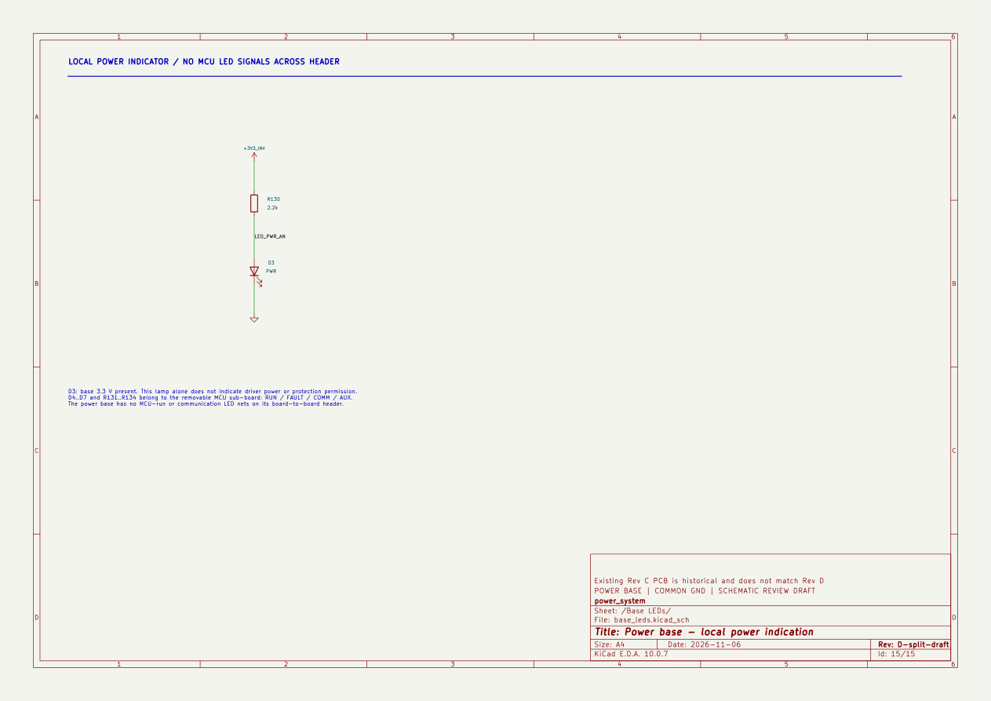
inverter/hardware/review/revd_power_page_15.png
