leolei2012/power_system/inverter/hardware/review/source_images/IRFS4227-pinout.png

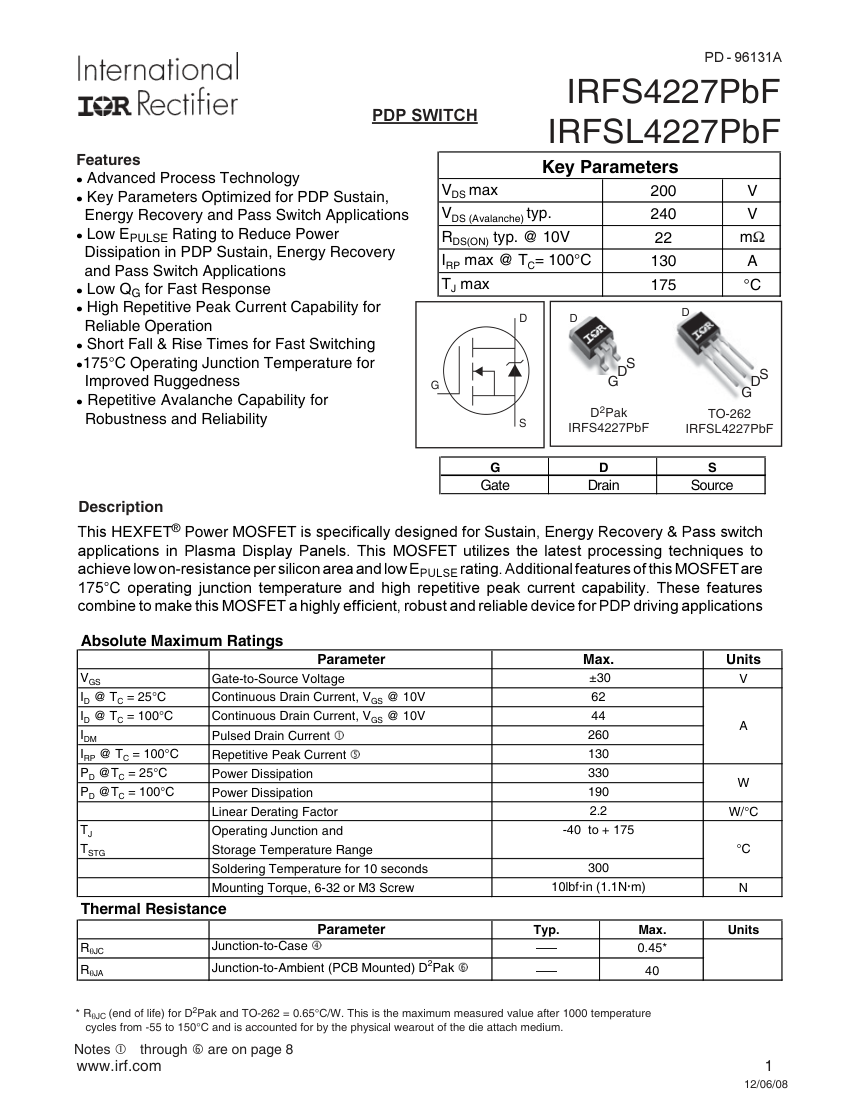
inverter/hardware/review/source_images/IRFS4227-pinout.png
