leolei2012/power_system/inverter/hardware/review/source_images/Milliohm_HoJLR2512-3W-5mR-1_lcsc.pdf-1.png

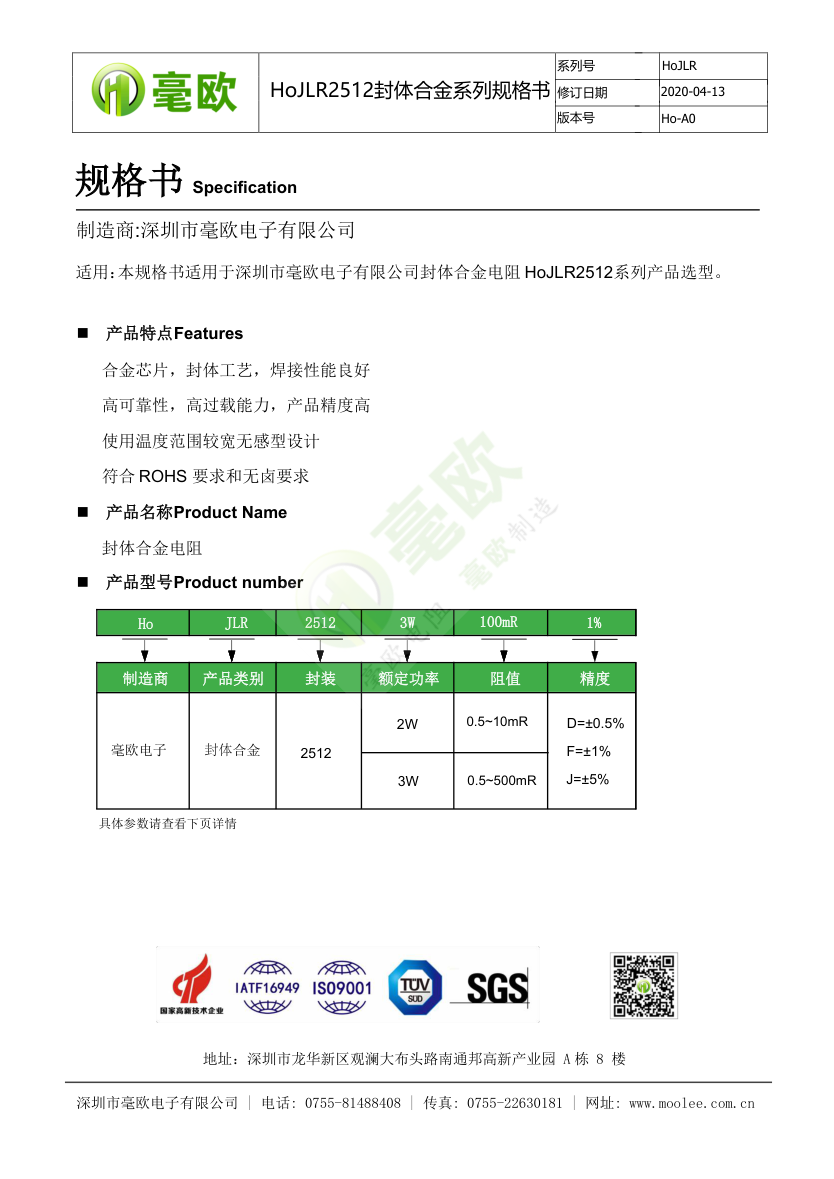
inverter/hardware/review/source_images/Milliohm_HoJLR2512-3W-5mR-1_lcsc.pdf-1.png
