leolei2012/power_system/inverter/hardware/review/source_images/TI_TPS26600PWPR.pdf-29.png

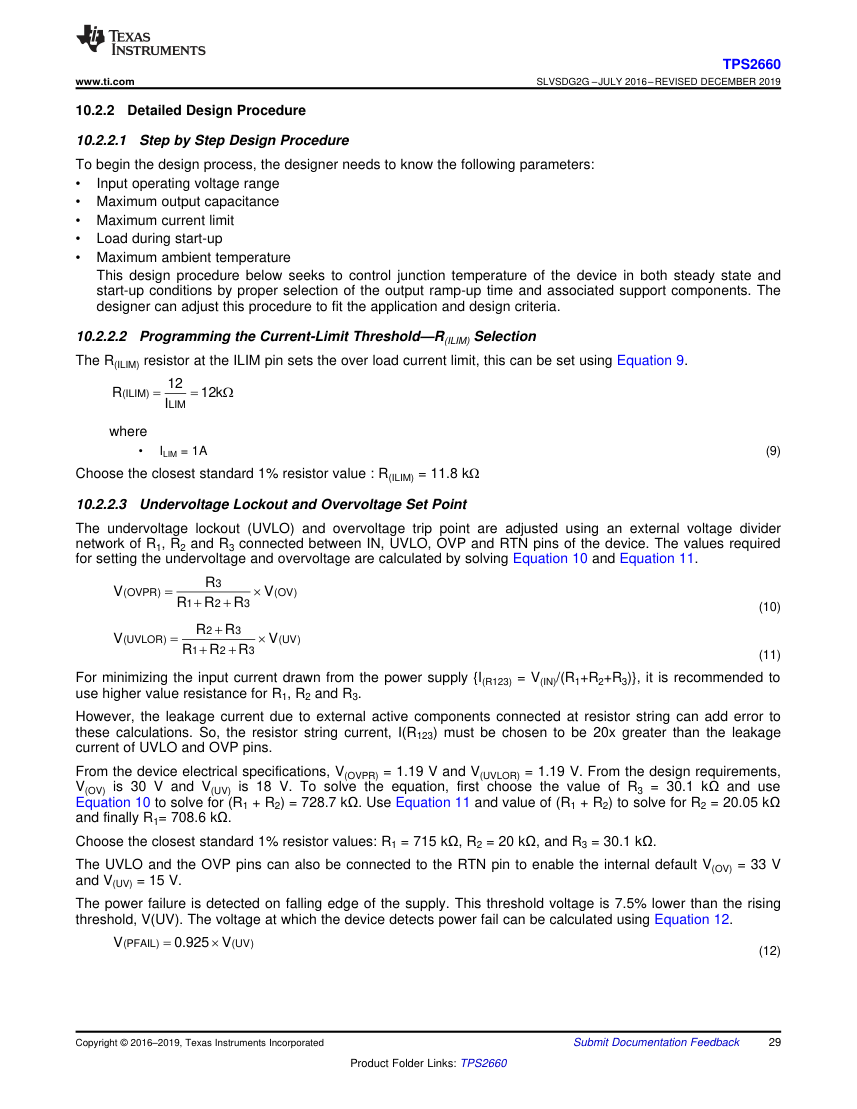
inverter/hardware/review/source_images/TI_TPS26600PWPR.pdf-29.png
