leolei2012/power_system/inverter/hardware/review/source_images/TI_TPS55165QPWPRQ1.pdf-31.png

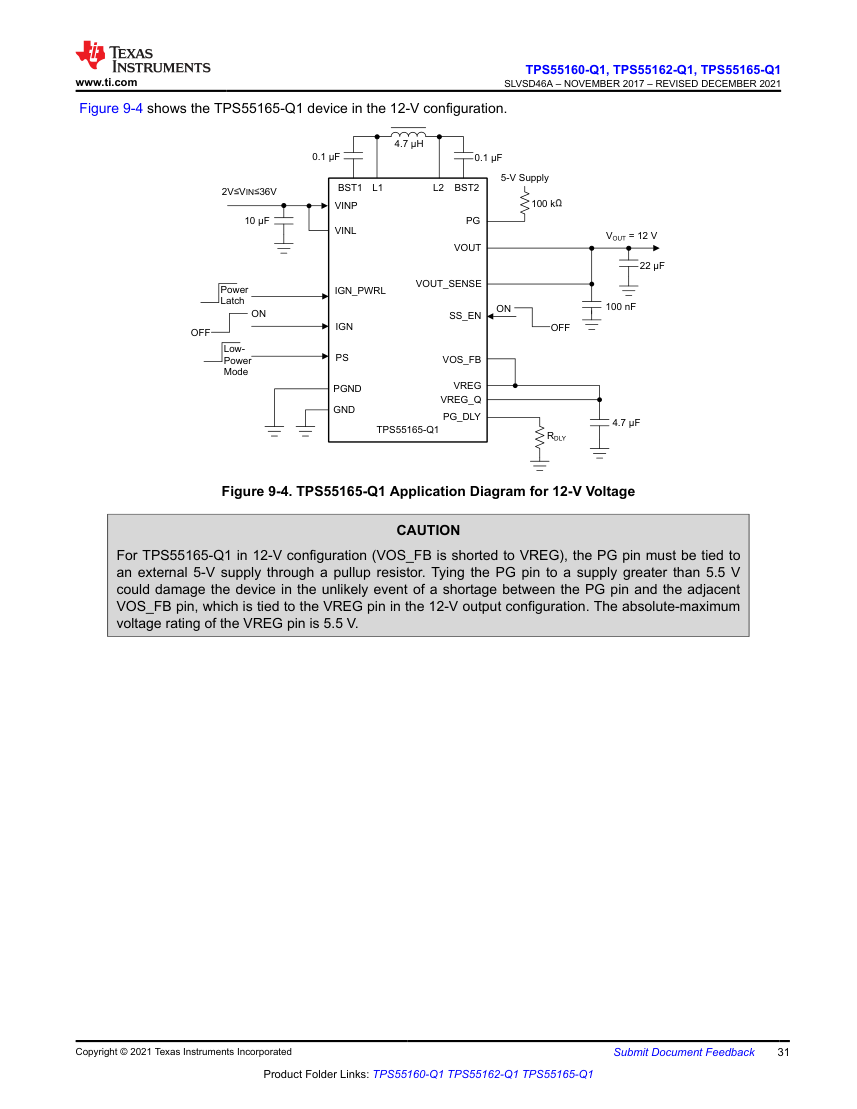
inverter/hardware/review/source_images/TI_TPS55165QPWPRQ1.pdf-31.png
