leolei2012/power_system/inverter/hardware/review/TS-1101-C-W_datasheet.png

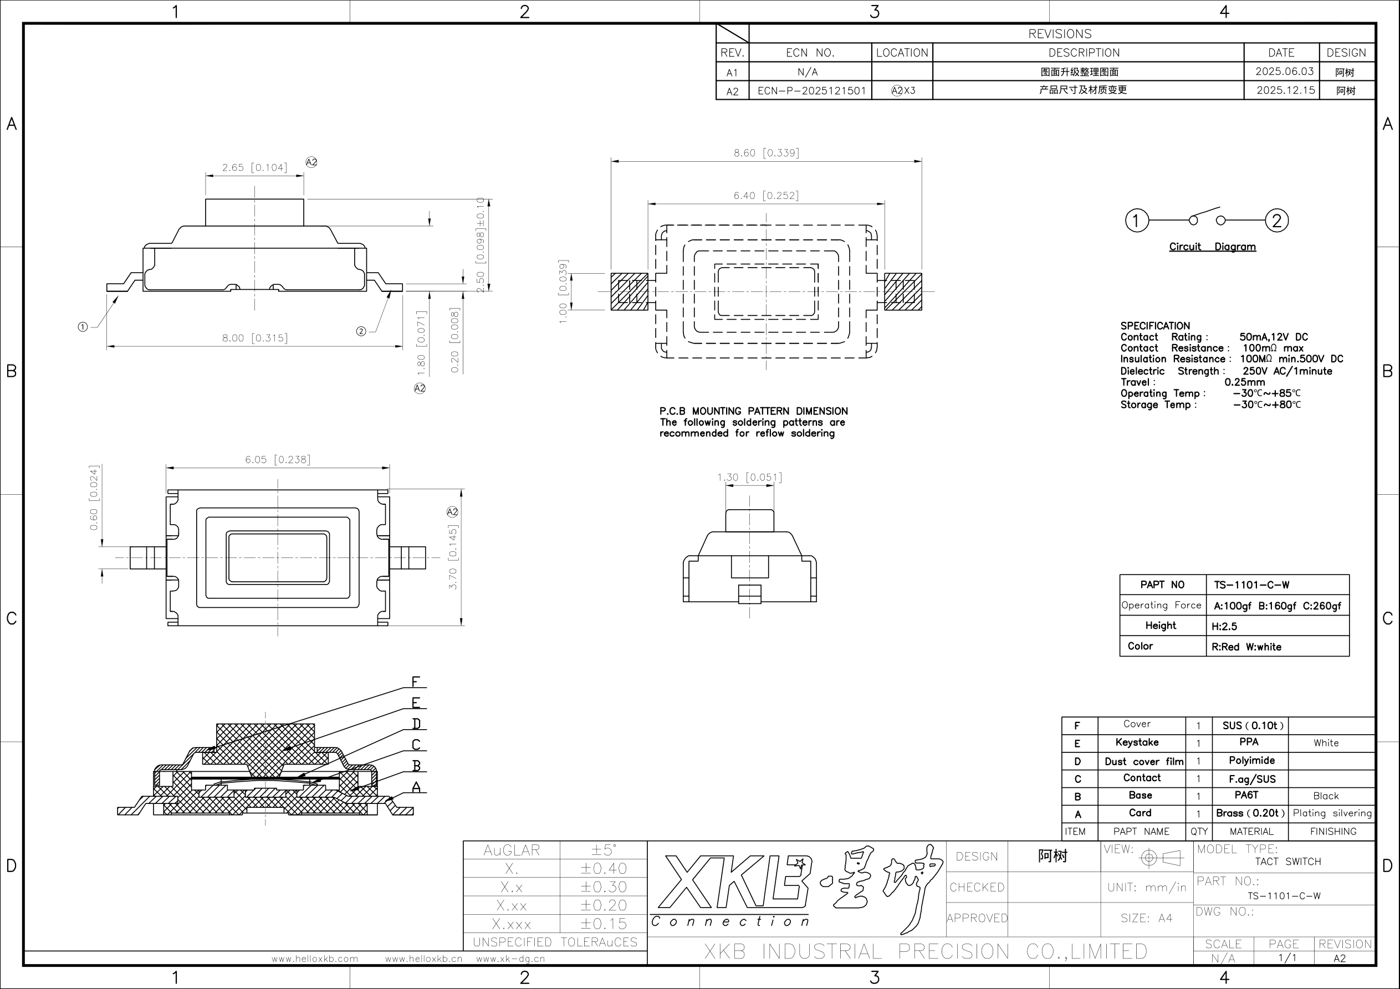
inverter/hardware/review/TS-1101-C-W_datasheet.png
