leolei2012/power_system/outputs/connector_candidates_2026-11-11/HC-GH-6PWT.jpg

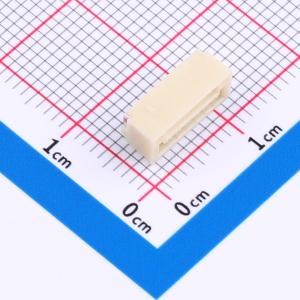
outputs/connector_candidates_2026-11-11/HC-GH-6PWT.jpg
