leolei2012/power_system/outputs/controller_60mm_fit_study_2026-11-11/controller_60mm_two_face_body_study.png

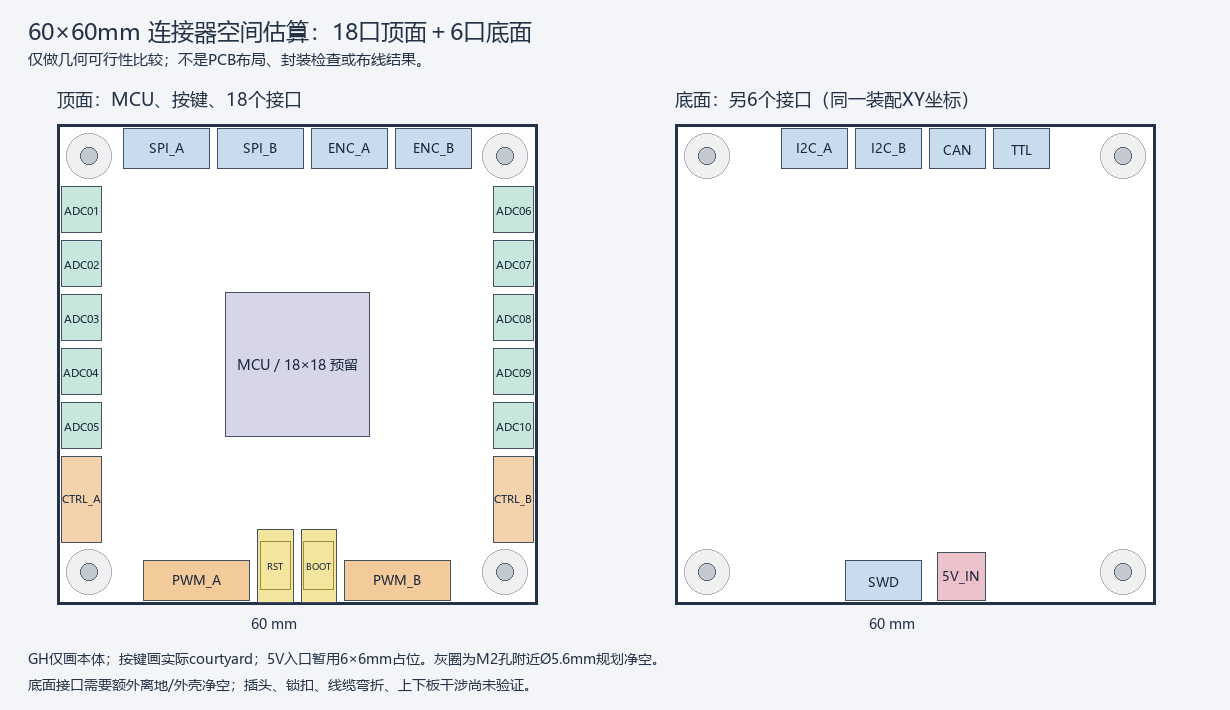
outputs/controller_60mm_fit_study_2026-11-11/controller_60mm_two_face_body_study.png
