leolei2012/power_system/outputs/controller_single_power_2026-11-11/controller_60mm_single_power_study.png

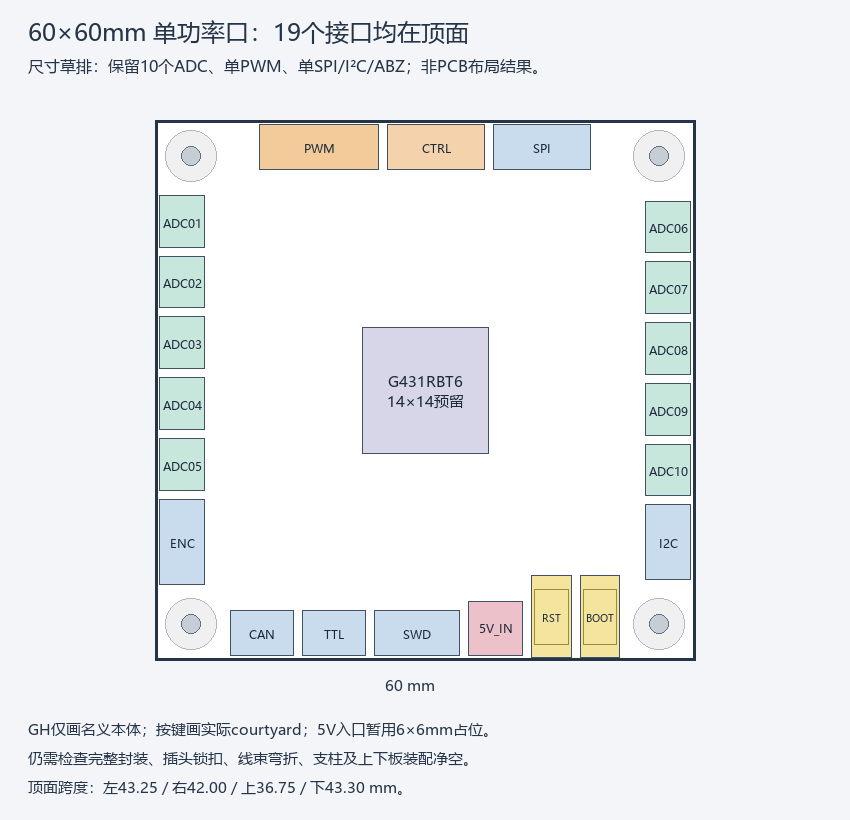
outputs/controller_single_power_2026-11-11/controller_60mm_single_power_study.png
