leolei2012/power_system/outputs/dual_pwm_pin_review_2026-11-11/DS12589_page_49.png

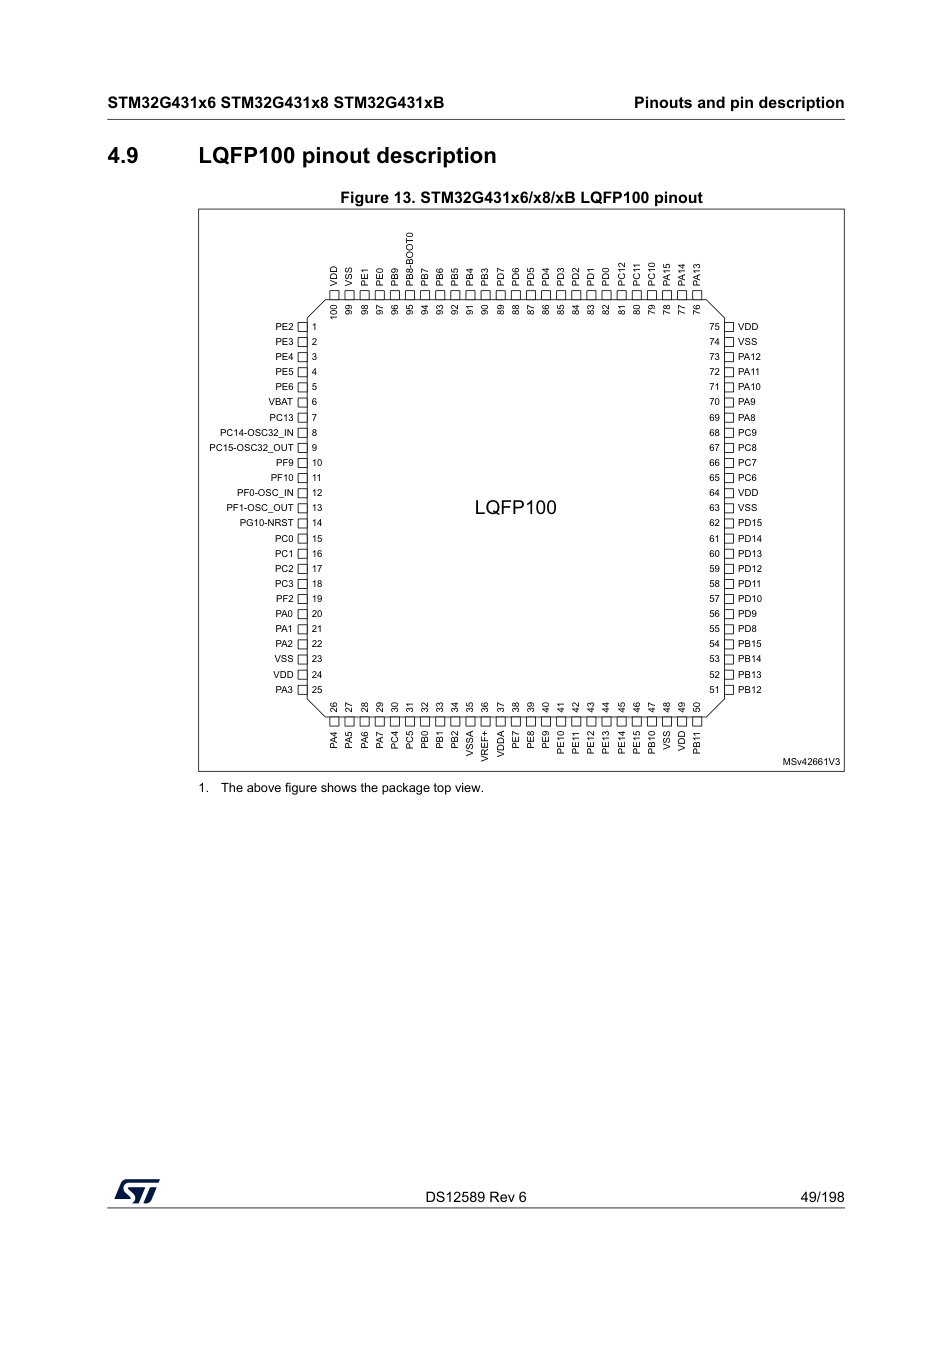
outputs/dual_pwm_pin_review_2026-11-11/DS12589_page_49.png
