leolei2012/power_system/outputs/g431_dual_motor_reference_2026-11-11/ST_dual_FOC_slide7.png

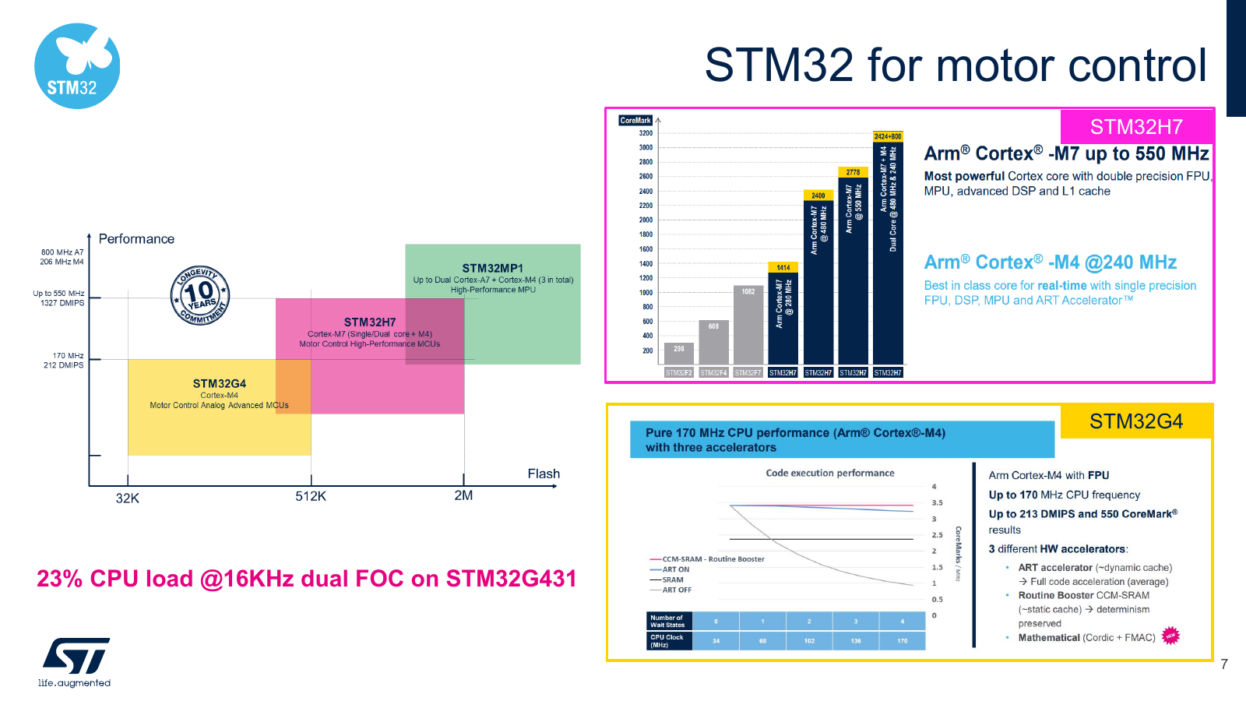
outputs/g431_dual_motor_reference_2026-11-11/ST_dual_FOC_slide7.png
