leolei2012/power_system/outputs/g431_dual_motor_reference_2026-11-11/UM2896_page1.png

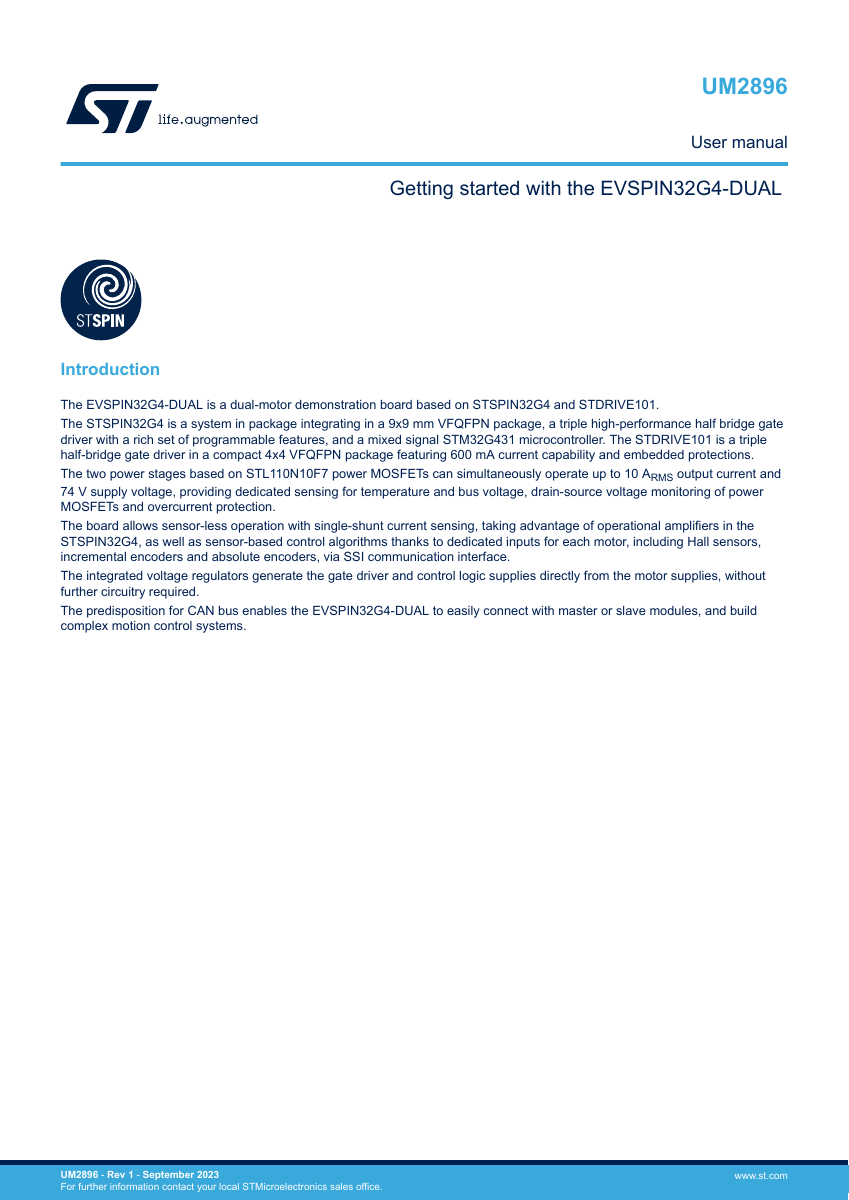
outputs/g431_dual_motor_reference_2026-11-11/UM2896_page1.png
