leolei2012/power_system/outputs/pcb_review_2026-11-11/previews/controller_bottom.png

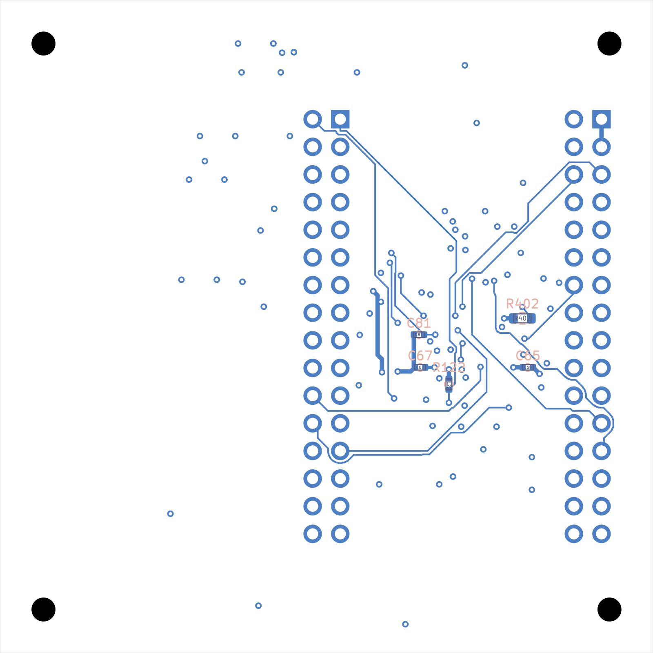
outputs/pcb_review_2026-11-11/previews/controller_bottom.png
