leolei2012/power_system/outputs/pcb_review_2026-11-11/previews/inverter_3d.png

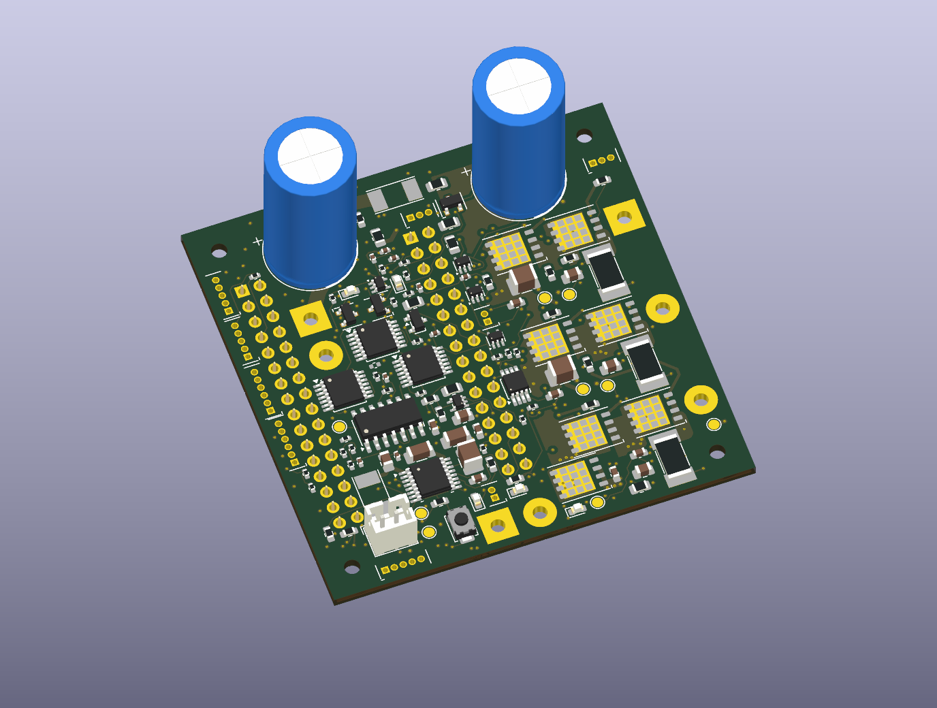
outputs/pcb_review_2026-11-11/previews/inverter_3d.png
