leolei2012/power_system/outputs/schematic_review_2026-11-11/final_core_render/page-4.png

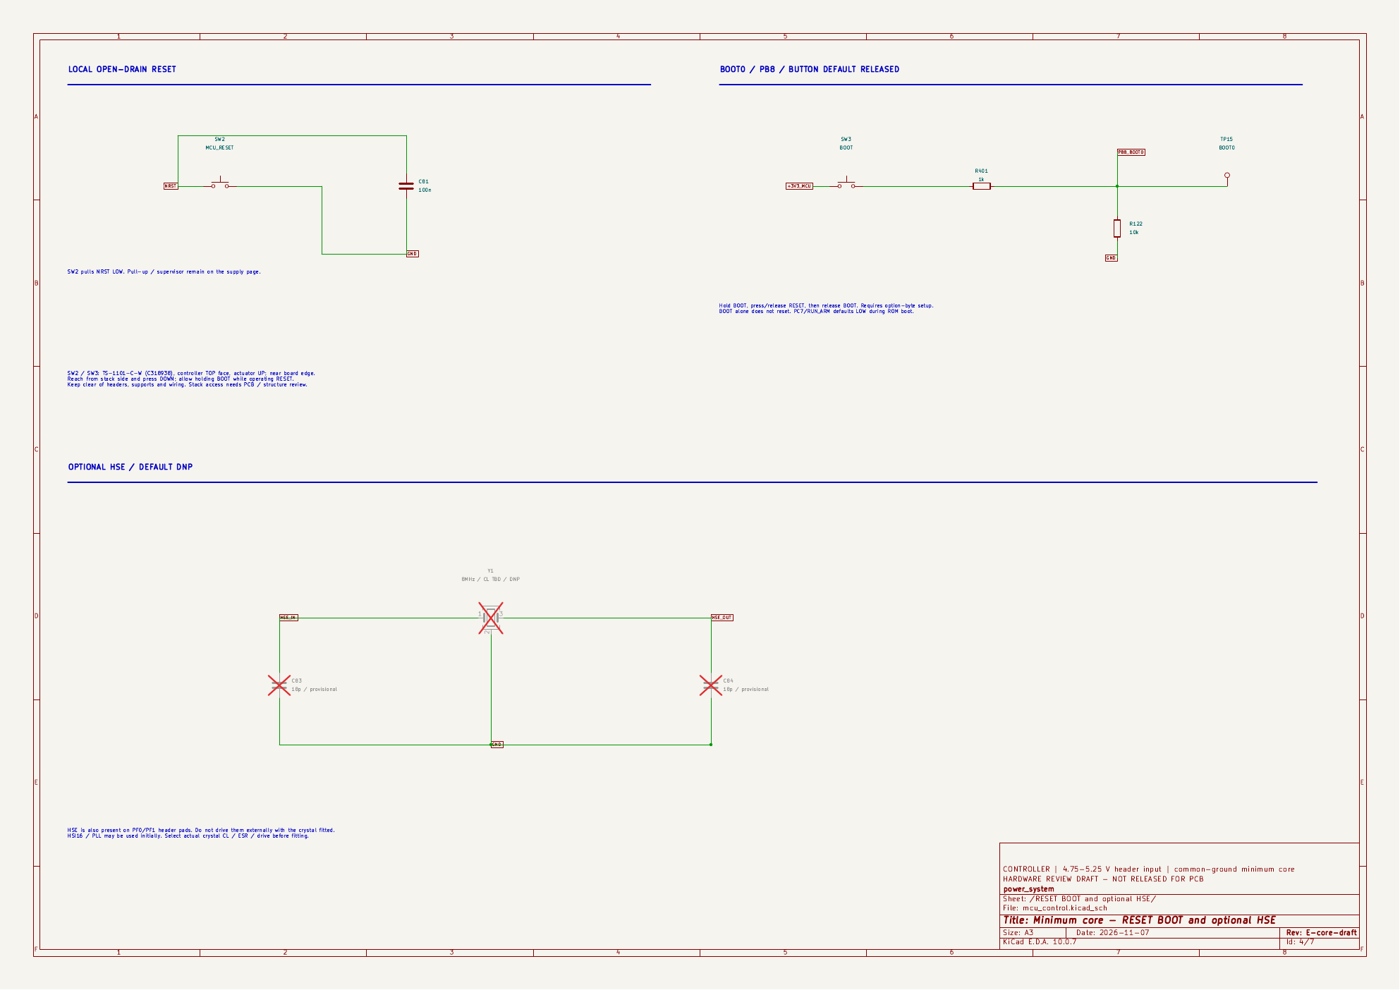
outputs/schematic_review_2026-11-11/final_core_render/page-4.png
