leolei2012/power_system/reference/ATK-PD6010B/preview/schematic-1.png

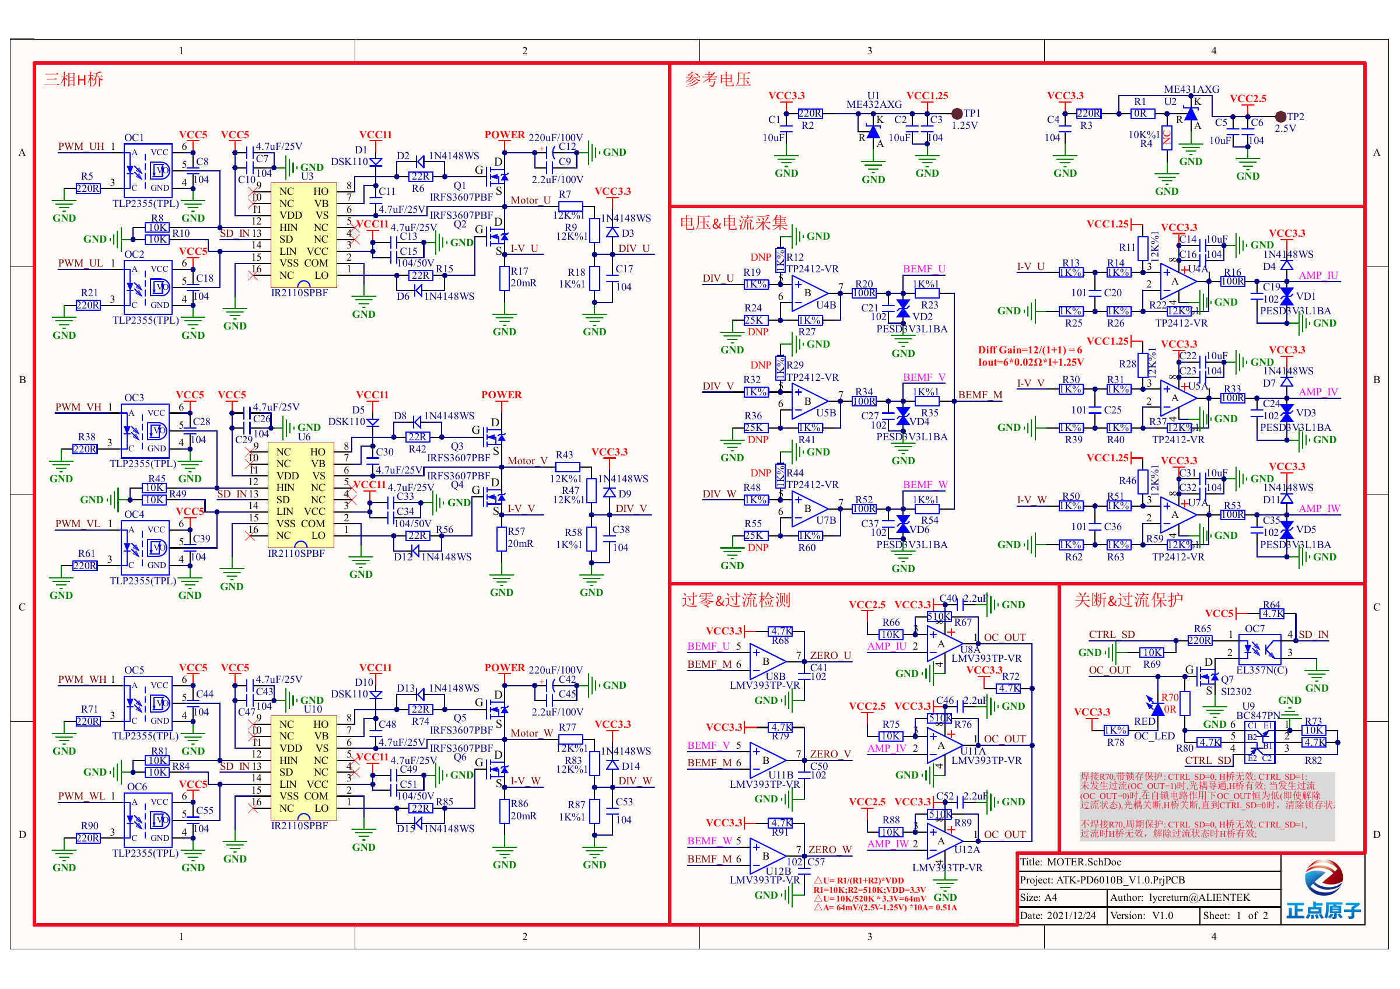
reference/ATK-PD6010B/preview/schematic-1.png
