leolei2012/power_system/docs/parts_to_complete_2026-11-11/README.md

# 待补采购型号清单（2026-11-11）

`selection_pending.csv` 是当前两块板的采购选型工作表，共 65 组、233 个位号：220 个装配位号、13 个 DNP 位号。controller 为 13 组 / 26 位号，inverter 为 52 组 / 207 位号。

表格沿用 2026-11-10 清单的列、分组编号、额定电压、公差、厂家要求、逐位号说明和已有候选记录。原 S04、S26 的 21 个 100 nF / 0603 位号已采用共享库 reviewed 物料 CC0603KRX7R9BB104 / C14663，因此剔除；其余 65 行保持原文，编号留空缺便于追溯。

填写“补充完整型号”“补充立创编号”“补充采购链接”；采购链接使用国内立创商城。已有候选及候选链接仅保留历史线索，不代表已选定或可直接下单。

这些分组只是选型起点。每个型号须满足组内所有逐位号要求；如有效容量、脉冲功率、精度或装配状态要求不同，应拆组复核。DNP 表示当前不装配，仍保留在工作表中；不能把它计入本版实装采购数量。普通电阻电容仍按表内国巨要求；未在这里新选任何型号。

从仓库根目录运行 `python tools/export_pending_parts.py` 可重新生成本目录。工具先核对 canonical BOM、待选 BOM 与最新 XML 完全一致，再核对分组覆盖和统计；不修改原理图、共享库或原 BOM。`summary.json` 记录输入 SHA-256、移除位号和分板统计。
