leolei2012/power_system/inverter/docs/component_selection.md

# Inverter 第一轮有源器件与电源轨评估

2026-11-11：本文保留历次选型推导，后续各段的“当前”“待建库”均指各自历史时点。现用Rev E为7页G431最小核＋20页功率底板，已接入reviewed共享器件；主桥及制动MOS为BSC110N15NS5ATMA1。当前入口为 [原理图交接](../../docs/schematic_update_2026-11-11.md)及 [双板说明](../../docs/controller_daughterboard.md)，采购料号和位号以当前原生图/BOM为准，旧PCB、数量及库状态不适用于本轮。

2026-11-06 Rev D：当前已改为G431可插拔子板与功率底板，8页+16页原理图完成，新PCB尚未设计。当前入口见[分板设计](../../docs/controller_daughterboard.md)，实际参数与位号以两板当前原生图/BOM为准。**本文件下方为历次设计推导，包含已废止的合板、LKS与24针叙述。**

2026-11-06：以下为历史讨论/选型背景。当前以 [Rev C / PCB0.2 紧凑方案](../hardware/PCB_REVIEW.md) 为准：60×60 mm、六层1 oz、双面装配和四个M2孔，正在布线；当前MOS为BSC110N15NS5、D1为MBRD20150CT-13。下文旧IRFS/TO-263、四层及分板叙述不构成当前装配或布局依据。

2026-11-05：本文为旧分板/集中控制方案的参考记录。当前按 [变频板与电源板各一颗 MCU](../../docs/integrated_board.md)推进，MCU 改为 STM32G431 方向，电源板 PFC＋LLC 恢复评估；本文旧引脚、资源数量和检查不能覆盖新版。

2026-11-01 实现更新：[十三页原理图及审查记录](../hardware/design_review.md)已建立。下文为首轮历史选型，数量/库状态以当前实际 BOM 和公共库台账为准。TLV9001 实用五颗（偏置及四路电压缓冲），74LVC08A 五颗；UCC27517、NCC 电解、国巨旁路均已有公共库 reviewed 记录。IRFS4227 尚未公共入库，当前使用工程专用草稿库。

日期：2026-10-31。目标是先确认决定供电电压的器件，当前母线范围已定 12～60 V、直流母线输入电流最大 10 A，输入功率上限为 V_dc×10 A，最高 600 W；输出相电流已定每相连续 10 A_rms，正弦峰值约 14.1 A，相电流硬件过流名义门限已定瞬时 ±20 A；门限误差和总关断延迟待核对。原器件评估按旧 100 V、10 A_rms、20 kHz 算例完成；下文旧工况的损耗/保护推导需按新指标复核。所有型号均为优先候选，尚未完成整板热设计、保护时序或应用原理图；库状态已同步，新增贴片 MOS 待建库。母线仍由实验电源或以后自研模块提供，与辅助输入分开。

## 本轮建议

inverter 先按 **12 V 门极驱动＋3.3 V 模拟/数字逻辑**规划。3V3_A/3V3_D 可以是滤波与布局区分的网络，不先要求两颗独立稳压器。1.65 V 是采样偏置参考，不是大电流电源。5 V 可作为降压后送 LDO 的中间电压；以下器件本身不要求必须增加独立 5 V 工作电源。15 V 驱动保留作复核备选，当前没有被本轮候选强制要求。

这些电压属于工程建议，待完整负载/时序核对后冻结。输入目标 12～24 V 不变：若要求全范围严格稳压到 12 V，低输入端须有足够调节能力，不能默认 LDO 或普通 Buck 在 Vin=12 V 时还能稳出 12 V。可研究升降压，或明确允许的驱动电压范围并验证低压角点；不默认直接把 24 V 送给驱动器。

## 优先候选

| 功能 | 完整型号 | 单块 inverter 数量候选 | 封装 | 器件电压范围/依据 | 项目电源建议 | 立创编号与国内页 |
| --- | --- | --- | --- | --- | --- | --- |
| 六只主功率 MOSFET | Infineon IRFS4227TRLPBF | 6 | TO-263 / D²PAK | VDS 200 V；RDS(on) 按 VGS=10 V 给出 | 栅极标称 12 V，漏极接功率母线 | C146578（国内商品页待核） |
| 半桥栅极驱动 | Infineon 2ED2182S06FXUMA1 | 3 | PG-DSO-8 | VCC 工作范围 10～20 V | 标称 12 V；高边自举另核对 | [C1850289](https://item.szlcsc.com/1941102.html) |
| 制动低侧栅极驱动（2026-11-01 已确认） | TI UCC27517DBVR | 1 | SOT-23-5 | VDD 4.5～18 V；兼容 3.3 V 输入 | 稳压 12 V；BRAKE 高有效，默认下拉 | [C99395](https://item.szlcsc.com/100609.html) |
| 低端电流检测放大器 | TI INA241A1IDDFR | 3 | SOT-23-8 | VS 2.7～20 V；增益 10 V/V | 3.3 V | [C19712054](https://item.szlcsc.com/21022225.html) |
| 1.65 V 偏置缓冲 | TI TLV9001IDCKR | 1 | SC-70-5 | 1.8～5.5 V，轨到轨输入/输出 | 3.3 V | [C398362](https://item.szlcsc.com/380592.html) |
| 电流窗口/母线过压比较 | TI TLV3202AIDGK | 4（8 个比较通道） | VSSOP-8 | 2.7～5.5 V，轨到轨输入，推挽输出 | 3.3 V | [C182416](https://item.szlcsc.com/193816.html) |
| 六路 PWM 硬件封锁 | Nexperia 74LVC08APW,118 | 2；故障汇总另计 | TSSOP-14 | 1.2～3.6 V | 3.3 V | [C6053](https://item.szlcsc.com/6519.html) |
| 故障锁存候选 | Nexperia 74LVC74AD,118 | 1 起，随逻辑审查 | SOIC-14 | 1.2～3.6 V；异步置位/复位 | 3.3 V | [C6099](https://item.szlcsc.com/6565.html) |

国内商城页用于确认型号、C 编号和封装；电气数值以下列厂家资料为依据。未引用其他商城价格/库存。本轮未核实这些候选的可购数量与价格，不能据此视为采购清单。带相似前缀的其他品牌料号不自动替代这里的厂家型号。

## MOSFET 与驱动电压

[IRFS4227TRLPBF 原厂规格书](https://www.infineon.com/assets/row/public/documents/24/49/infineon-irfs4227-datasheet-en.pdf)给出的 VDS 为 200 V，VGS=10 V 时 RDS(on) 最大 26 mΩ，栅极阈值 3～5 V 不是充分导通所需的驱动电压。标称 12 V 驱动是候选工作点，不能由 MCU 3.3 V 直接驱动主功率管。200 V 耐压还须与母线最高值、寄生过冲及吸收电路一起核对；不把封装电流额定当作整板额定电流。

[2ED2182S06F 原厂规格书 V2.32](https://www.infineon.com/assets/row/public/documents/24/49/infineon-2ed2182-4-s06f-j-datasheet-en.pdf)确认完整订货型号、10～20 V VCC、集成自举二极管和 3.3 V 逻辑兼容路线。它采用功能性电平移位，不提供控制/功率侧的隔离。逻辑电平为 3.3 V 与驱动电源为 12 V 是不同概念，驱动器峰值拉灌电流也不能直接当适配器持续电流。

低侧实际 VGS、驱动压降、高侧自举二极管压降、电容纹波和电源容差须一起计算；目标是在需要使用数据手册 10 V 导通电阻保证的工况中，实际栅压满足该条件，同时留有 UVLO 裕量。VCC=12 V 不代表高侧 VGS 恒为 12 V。若角点或试验表明裕量不足，可复核 15 V 驱动，但这会改变电源、栅极电荷、损耗与应力预算，不在本轮自动切换。

集成自举二极管后，旧 BOM 的外置 ES1J 不是必贴件。自举电容、栅极电阻/分立关断通道和栅源下拉均需依据所选 MOSFET、占空比、Qg、死区和开关速度计算，旧 10 µF/15 Ω 只保留为待复核值。自举不能保证上管无限期常导通。

## 主桥 MOSFET 与驱动配对建议

当前母线改为 12～60 V、直流母线输入电流最大 10 A，第一版暂保留已讨论的 **IRFS4227TRLPBF ×6＋2ED2182S06FXUMA1 ×3**，门极电源标称 12 V。两块 inverter 合计主桥用 12 只 MOSFET、6 颗半桥驱动；制动功率管及其驱动另计。此配对用于建库与详细设计，不把未冻结的母线/功率指标写成保证能力。

200 V MOSFET 为此前较高母线草案选出的型号；当前范围改为 12～60 V 后先保留该已讨论候选，耐压等级与效率优化另项评估，最终仍须核对尖峰裕量。IRFS4227 在 VGS=10 V、25°C 测试条件下 RDS(on) 最大 26 mΩ，Qg 典型 70 nC、最大 98 nC（对应手册测试工况）。按已确认每相连续 10 A_rms，按三相平衡且每相由一只 MOS 沟道导通的简化模型，整桥冷态导通损耗约 3×10²×0.026=7.8 W；温升、死区二极管导通、开关和反向恢复损耗另计，须配散热器。用户已确认采用 TO-263 贴片功率结构；效率与热设计仍需详细验证。

2ED2182 每颗独立接收 HIN、LIN，控制一个桥臂的上下管，与既有六路 PWM 接口匹配；3.3 V 输入逻辑、10～20 V 工作供电、集成自举二极管、高低侧欠压锁定与互锁均符合当前路线。手册给出的 ±2.5 A 为典型峰值驱动能力，电流测试条件涉及 15 V，不能写成 12 V 下持续能力。内部固定死区典型 400 ns，仍需与 MCU 死区和实际开关过程一起核对。

650 V 为驱动浮动通道的能力，不是本板母线额定，也不提供隔离或整机短路保护。过流/过压比较、故障锁存和六路硬件 PWM 封锁继续保留。自举要求定期补电，上管不能按无限期 100% 导通设计；12 V 供电下须核对二极管、驱动压降和纹波后实际 VGS。栅极环路应靠近功率管，公共辅助回路不能跨接低端分流器。

贴片 MOS 的完整订货型号为 IRFS4227TRLPBF；原厂型号与 TO-263 封装已核对，立创全球记录 C146578 的国内商品页仍待确认。驱动国内商品页 [C1850289](https://item.szlcsc.com/1941102.html)已核对，且库物料为 reviewed；新增 MOS 不得套用旧 TO-220 封装。

## 采样、偏置和保护

[INA241A 原厂规格书](https://www.ti.com/lit/ds/symlink/ina241a.pdf)确认 A1 为增益 10、允许 3.3 V 供电。与原 5 mΩ 分流候选配合，信号目标保持 Vout=1.65 V＋I×0.05 V/A，已定瞬时 ±20 A 名义门限对应约 0.65/2.65 V；具体零点、误差、输出摆幅、负载和滤波需核对。该方案是低端分流，其输入参考在 DC− 附近；当前 12～60 V 母线仍沿用低端分流结构；若改到相线/高侧，需要重新核对共模瞬态、接口和保护，不能仅凭约 110 V 的共模额定直接换位置。

[TLV9001 原厂产品资料](https://www.ti.com/product/TLV9001)确认 1.8～5.5 V 供电与单位增益缓冲用途。本轮具体化为已找到国内页的 IDCKR（SC-70-5），不将其与其他封装的引脚顺序混用。1.65 V 先由合适精度的分压/滤波生成再缓冲；分压误差、运放失调、REF 负载以及容性负载稳定性要算入偏置误差。它不是独立精密电压基准芯片。

[TLV3202 原厂规格书](https://www.ti.com/lit/ds/symlink/tlv3202.pdf)确认 3.3 V 供电可用、输入涵盖两电源轨附近、输出为推挽。三相正负过流窗口共 6 路，再加母线过压 1 路，需 7 个比较通道，因此先预留 4 颗双比较器；第 8 路用途未定，不默认形成额外反馈接口。典型 40 ns 是比较器自身延迟，不是“分流→放大→滤波→锁存→驱动关断”的整链时间。

本轮以 TLV3202 替代旧 LM393 的优先候选地位，必须同步重做故障汇总：**推挽输出不得像开漏输出一样直接并联线与。** 可通过逻辑门组合，再进入故障优先锁存；需要额外的故障汇总/反相逻辑，不能认为两颗用于六路 PWM 的 74LVC08 已覆盖全部保护逻辑。FAULT_N 对外仍按开漏定义，需要相应输出转换。

[74LVC08A](https://assets.nexperia.com/documents/data-sheet/74LVC08A.pdf)和[74LVC74A](https://assets.nexperia.com/documents/data-sheet/74LVC74A.pdf)均可在 3.3 V 工作。74LVC74 只是锁存元件候选，异步置位/复位同时有效等非法/不确定释放情形不能靠器件名称解决；需证明活动故障优先于 ENABLE 清锁存、上电/欠压默认封锁以及无自动重启。掉电输入、未使用输入和 3.3 V 与辅助驱动电源的起落顺序也需设计。

低端分流仍有采样和保护盲区。以上采样比较器组合不等于已完成短路保护；须核对不同调制状态、电机模式、放大器恢复及故障能量，并落实保护闭环。

## 其他器件对电压的影响

| 部分 | 目前建议/待定 | 对电源的影响 |
| --- | --- | --- |
| NTC 分压、母线与相电压采样 | 输出按 3.3 V ADC 接口目标调理 | 归入 3.3 V 模拟域，无需负电源 |
| 制动斩波 | 功率管沿用 200 V 候选；低侧驱动已选 TI UCC27517DBVR | 接已有稳压 12 V；独立保护/温度需求未定 |
| 电源监控/FAULT_N 输出级 | 监控优先 TPS3808G33DBVR；FAULT_N 输出级及完整逻辑待设计 | 用 3.3 V，不能靠 ThreadX 完成上电硬件封锁 |
| 输入稳压与保护 | TPS26600、TPS55165、AP63205、TPS7A20 等完整后缀见建库清单 | 转换器已选候选；外围、容差/瞬态、负载与散热待核对 |
| 母线电容、TVS、LC、分流、熔断器 | 额定/热/脉冲校核与物料未完成 | 不增加逻辑电源轨，但决定功率母线能力与保护 |

本轮可作为下一步辅助电源设计的输入：优先研究 12 V 与 3.3 V 两种工作电压，5 V 为可选中间轨。下一步需计算单块板和双块板的驱动平均功耗、采样/逻辑负载、制动附加负载及启动峰值，再选稳压器和适配器容量。已有 reviewed 库物料的引用见建库 CSV；新增贴片 MOS 仍须按 kicad_library 流程建立。整板静态兼容性与库定义核对属于不同验证范围。首版功率母线预充与旁路继电器已取消。

后续供电讨论增加了 controller 从 inverter 取辅助电的方向。若采用所建议的 5 V_CTRL 输出，中间 5 V 将同时承担板间电源接口用途，须追加 controller 与外接传感器负载预算；这一接口仍未冻结。电源分支在电机 ENABLE 关闭、功率母线未上电时仍应可工作，见 [供电架构](../../controller/docs/power_architecture.md)。

后续选型已补齐 12～24 V 辅助输入保护、12 V 升降压、5 V Buck 和两板 3.3 V LDO，具体型号及建库顺序见 [建库清单](../../docs/library_build_list.md)。本页保留功率、驱动和采样的选型依据。

2026-10-31 用户确认将主桥改为贴片 IRFS4227TRLPBF，旧直插 IRFB4227PBF 不再作为当前工程主桥候选。新型号需要单独建库，功率布局与散热按 TO-263 设计。

## 制动低侧驱动（2026-11-01 已确认型号）

制动已确定由 controller 软件经 BRAKE_1/2 控制，每块 inverter 板内各有一路制动 MOS 及驱动。用户已确认选用 **TI UCC27517DBVR**，每块 inverter 一颗，两块合计两颗；使用已有稳压 12 V，BRAKE 采用 3.3 V 高有效、输入默认下拉关闭。型号与控制极性已确认，公共库建库、外围参数及整板验证仍待完成。

| 项目 | 已核对内容 |
| --- | --- |
| 制造商 / 完整型号 | Texas Instruments / UCC27517DBVR，不与其他厂家同数字型号混用 |
| 立创国内商品 | [C99395](https://item.szlcsc.com/100609.html)，型号、TI 品牌及 SOT-23-5 已核对 |
| 电源 | 工作范围 4.5～18 V；本项目接已有稳压 12 V，不接原始 12～24 V 适配器输入 |
| 输入 | 固定 TTL/CMOS 兼容阈值，支持 3.3 V 命令；原厂表列输入高阈值最大 2.4 V，板间实际高电平裕量仍需核对 |
| 输出能力 | 12 V 条件下 4 A 拉 / 4 A 灌峰值栅极驱动能力，不是制动支路连续电流额定 |
| 拓扑 | 单通道低侧驱动，适合源极接 DC− 的制动 N-MOS；不需自举，功率回路仍由外接电阻及 MOS 承载 |
| 价格与库存 | 本次未取得可核实的阶梯报价及库存，不把搜索摘要中的起价作为报价 |
| 库状态 | 本轮 parts.csv 检索未找到该型号；如采用需按公共库流程另行核对建库，本次未修改公共库 |

原厂依据：[UCC27517 规格书](https://www.ti.com/lit/ds/symlink/ucc27517.pdf)，本次取得 SLUSAY4D / Rev. D。其 DBV 五脚定义为 1=VDD、2=GND、3=IN+、4=IN−、5=OUT。

已确认同相驱动方向：VDD 接稳压 12 V；GND 接制动 MOS 源极参考；IN+ 接 BRAKE_1 或 BRAKE_2 并设外部默认下拉；IN− 固定接低，使 OUT 跟随 IN+；OUT 经栅极串联电阻接 MOS 栅极，另设栅源下拉。BRAKE 高电平请求制动导通，低电平关闭；未使用输入不能悬空。具体阻容值、回流及上电/掉电行为在详细原理图中核对。

详细设计仍需计算去耦、栅极电阻/下拉、掉电与跨板输入行为、供电瞬态、最坏驱动延迟和开关损耗，并核对制动 MOS 栅极波形。后续若利用 IN− 加入本地支路故障关断，需明确其优先级；不能直接用三相桥 ENABLE/锁存故障把仍需耗能的制动支路一并封锁。

## 外接制动电阻参考目标（2026-11-01，详细选型后续进行）

用户接受每块 inverter 外接 **5.6 Ω、±5%、1 kW 等级**作为参考目标，并明确详细设计可后续进行。完整型号、实际连续耗能能力、散热安装和允许制动能量仍待负载条件明确后核算，不作为已定采购物料或已验证额定值。以下按“60 V 工况、回馈功率约 600 W”作初步比较；600 W 是计算假设，不由直流输入最大 10 A 推导成最大再生功率保证，实际负载回馈功率、惯量、速度和减速时间尚未确定。

| 母线电压 | 5.6 Ω 名义导通电流 V/R | 名义完全导通耗能功率 V²/R |
| --- | --- | --- |
| 61 V | 10.89 A | 664 W |
| 62 V | 11.07 A | 686 W |
| 65 V | 11.61 A | 754 W |

阻值 ±5% 下，R_min=5.32 Ω，65 V 完全导通电流约 12.22 A、功率约 794 W；R_max=5.88 Ω，61 V 完全导通功率约 633 W。需将这些值、温度系数及更高瞬态角点用于 MOS、端子、线缆、走线、保护和热设计；不能沿用“电源输入最大 10 A”作为制动支路电流上限。

对比：10 Ω 在 62 V 完全导通仅耗能约 384 W，100 Ω 仅约 38.4 W。提高电阻标称瓦数不会改变 V²/R，因此不能通过采用更高瓦数的 10 Ω 电阻就获得约 600 W 的瞬时耗能能力。

1 kW 为优先寻找的额定等级，须满足具体厂家的散热器、环境温度及降额要求，不表示自然散热可连续耗能 1 kW。参考 [Ohmite KABR 原厂资料](https://www.ohmite.com/arcolresistors/kabr/)对带/不带散热器的额定值分别定义；这里仅引用散热额定原则，不选定该系列或引用其他商城采购信息。重复制动平均功率、单次能量 E=∫Pdt、脉冲能力和允许温升仍待核算。

本轮尚未在立创国内站核实满足此规格的完整型号、C 编号与价格，不以全球站或其他商城信息代替。BOM 记录参考目标并保持完整选型待定；目前先完成板上制动 MOS、已选驱动和 2P 电阻端子的设计，支路电流、能量及保护额定在原理图定稿前仍须校核，不能将“外接电阻型号后选”视为板内功率回路免于核算。

## 母线电解选型（2026-11-01，首版暂用 2×220 µF）

用户确定首版每块 inverter 暂用两只 220 µF / 100 V 并联，共 440 µF，并以 ATK-PD6010B 为主要硬件参考。按其立创选型要求，选 **NCC / Nippon Chemi-Con EKYB101ELL221MK25S**，国内商品 [C1585673](https://item.szlcsc.com/1676488.html)，两块 inverter 合计四只；本次不修改公共器件库，库定义待建立。

| 参数 | 原厂及国内商品记录核对 |
| --- | --- |
| 额定值 | 220 µF、100 V、±20% |
| 耐久条件 | 10000 h / 105°C，具体使用寿命按实际环境和纹波发热核算 |
| 尺寸 | 直插径向，D12.5×L25 mm；脚距 5 mm，最大外形/引线尺寸按 KYB 原厂图建库 |
| 额定纹波 | 单只 1.62 A_rms / 105°C / 100 kHz；两只同条件理想均流合计 3.24 A，非已验证整板承载值 |
| 频率系数 | 120 Hz:0.50，1 kHz:0.85，10 kHz:0.94，100 kHz:1.00；20 kHz 及谐波按原厂规则和实际频谱核算 |
| 阻抗 | 20°C / 100 kHz 最大 39 mΩ；不是纯 ESR，不能直接混写 |
| 价格 / 库存 | 本轮未取得可核实的国内阶梯报价和库存，待采购时确认 |

依据：[原厂单品资料](https://www.chemi-con.co.jp/en/products/detail-condenser.php?part_number=EKYB101ELL221MK25S)、[KYB 原厂目录](https://www.chemi-con.co.jp/products/relatedfiles/capacitor/catalog/KYBLL-e.PDF)。首版先按两只落图，电容实际纹波分配、热/寿命和母线波动须复核；若实际电容电流超出该组合额定，应调整选型或试验工况，不能仅因 ATK 同容量就认定满足本项目每相 10 A_rms 全工况。

### 历史检索备选（不用于当前 BOM）

已找到可供后续比较的 **Nippon Chemi-Con EKYB101ELL681MMN3S**，立创国内 [C1585943](https://item.szlcsc.com/1676758.html)。[原厂单品资料](https://www.chemi-con.co.jp/en/products/detail-condenser.php?part_number=EKYB101ELL681MMN3S)与 [KYB 系列目录](https://www.chemi-con.co.jp/products/relatedfiles/capacitor/catalog/KYBLL-e.PDF)确认：680 µF、100 V、±20%、105°C/10000 h 耐久条件，D18×L31.5 mm，引脚间距 7.5 mm；额定纹波 2.55 A_rms / 105°C / 100 kHz，20°C / 100 kHz 最大阻抗 20 mΩ，后者不能直接标为纯 ESR。原厂频率折算系数为 120 Hz:0.60、1 kHz:0.87、10 kHz:0.95、100 kHz:1.00，故 120 Hz 额定为 1.53 A，不与 100 kHz 数值混用。

680 µF 型号仅保留为历史检索备选，不进入当前 BOM 或建库清单。当前按用户已确定的 2×220 µF 首版配置推进，2000 µF 算例不作为容量要求。

## 母线高频旁路（2026-11-01 已确认配置，统一国巨）

用户已确认每块 inverter 两只 2.2 µF / 100 V / X7R / 1210 母线旁路；随后明确通用贴片小阻容统一采用 YAGEO（国巨），因此本工程选用 **CS1210KKX7R0BB225**，取代原村田候选。原 ATK 图中 C9/C45 仅明确标称 2.2 µF/100 V，未明确介质；本项目采用贴片 MLCC 是当前选型，不声称与 ATK 实物料号相同。

| 项目 | 核对结果 |
| --- | --- |
| 厂家及完整型号 | YAGEO / CS1210KKX7R0BB225 |
| 国内商品 | [立创 C5578983](https://item.szlcsc.com/6497372.html)，国内索引记录已核对；本次页面请求返回访问校验内容，未取得实时价格/库存 |
| 标称参数 | 2.2 µF / ±10% / 100 VDC / X7R，1210 / 3225 |
| 结构与外形 | 软端头；原厂表列 L=3.2±0.4 mm、W=2.5±0.3 mm、T=2.0±0.3 mm，建库时以完整原厂图为准 |
| 数量 | 每块 inverter 2，只数已确认；两块共 4 |
| 库状态 | 新型号待建库，本次不修改公共库，也不删除已存在的村田物料 |

电气依据：[YAGEO 原厂单品规格及仿真页](https://www.yageogroup.com/download/specsheet/CS1210KKX7R0BB225)，本轮可读取 Generated 2026-10-20 版本。DC 偏压、交流纹波和温升曲线属于典型仿真而非保证额定，须结合实际工况核对，不将标称值核对写成应用验证。

两只并在 DC+ / DC−，靠近三相桥的母线换流回路，不串入相线，也不作为自举电容。须核对 60 V 及保护/瞬态角点下的有效容量、交流纹波/发热、焊接机械应力与布线寄生。与两只 220 µF 电解共同工作，首版按两只落图，具体位置按回路电感/过冲验证。旧 C2 三只 2.2 µF/250 V 薄膜从当前 BOM 撤下；额外吸收网络仍按波形另行设计。

## 通用贴片小阻容品牌规则

controller 与 inverter 的常规贴片电阻、小电容统一 YAGEO（国巨），包括去耦、常规滤波、上下拉等。具体型号随实际精度、功率/耐压、封装及应用计算补齐；精密采样/功率分流、制动功率电阻和母线大电解继续按专项要求选型。原有 NCC 母线电解保留，不把本次品牌统一扩展到未要求更换的关键功率器件。
