leolei2012/power_system/inverter/hardware/review/shared_parts_2026-11-11/review.md

# 底板共享物料同步检查（2026-11-11）

当前有效20页原理图已同步34种确切型号、91个位号到共享MyParts/MyFootprints。该91项均为器件库定义reviewed，不代表整板应用或实物通过。未修改PCB、共享库、控制板或工程电气规则；BOM及跨板汇总由主任务统一重导。

- 迁移前备份：`hardware/history/rev_e_before_shared_parts_2026-11-11_000310.zip`。备份内容含20页、库表、原工程设置及项目符号库，SHA见`backup_manifest.json`。
- 实际CLI前/后网表：`before.net.xml`、`after.net.xml`。317个位号、969个物理pin节点、238条网络分区、所有显示标称值、14DNP、J101/J102的64针连接全部保留，`pin_equivalence.json`为PASS。
- BAT54S采用厂家共享符号后，八条自动名由`Net-(D20x-common)`改为`Net-(D20x-K1/A2)`，只有名字变化。显式标签网名全部不变，物理pin连通分区完全等效。
- 91项共享器件的符号物理pin集合与对应封装所有非空pad编号逐项比较，0不匹配，见`physical_pad_audit.json`。MOS保留1/2/3为S、4为G、5/6/7/8为D；大散热盘仍重复D5。
- ERC：0错误、0警告，见`erc.json`；没有新增豁免或降低电气规则。
- 17颗100 nF/0603采用C14663（CC0603KRX7R9BB104，50 V、±10%、X7R），覆盖原25 V局部去耦/自举要求；所有其余TBD保持，见`remaining_tbd.json`：207个位号、52分组，其中152电阻/50电容/5 LED。未补猜采购型号。

图面QA已检查20页总览与D1、三相桥模板、ADC/状态钳位及64针页细图。D1采用完整双共阴肖特基图形，1/3仍由输入支路直连并联、2为VBUS输出，并修正横排字段；其余替换符号pin坐标一致，原模块内实线、模块间标签的结构保持。重点PNG为`after_d1.png`、`page_05.png`、`page_06.png`、`page_17.png`、`page_20.png`；全页PDF为`inverter.pdf`，20页SVG位于`svg/`。

三颗半桥驱动采购链接按主任务核得的官方C1850289/productId1941102对应国内页更新；不声明动态库存。电感C408447仍保留国内搜索链接，详情页待核。SW1仍是底板辅助复位TS-1088-AR02016，不随子板SW2/SW3按钮替换。

尚需待选料建档、PCB设计、功率/热/栅极/保护动态、供电及插接实物验证。当前ERC及静态网表检查不证明这些应用性能。
