leolei2012/power_system/inverter/hardware/review/shared_parts_2026-11-11/before.pdf

1 | 2 | 3 | 4 | 5 | 6 | 7 | 8

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
Size: A3 | Rev: E-core-draft | F Date: 2026-11-07
KiCad E.D.A. 10.0.7 | Id: 1/20

## Title: Inverter base with GPIO minimum-system core

File: inverter.kicad_sch

Sheet: /

power_system

HARDWARE REVIEW DRAFT - NOT RELEASED FOR PCB

INVERTER | non-isolated laboratory draft | 12-60 V bus | separate 12-24 V auxiliary
Driver supply 文件: supply_12v.kicad_sch | Logic and sensors 文件: supply_logic.kicad_sch U half bridge 文件: bridge_u.kicad_sch Encoders and SPI 文件: sensors.kicad_sch

Auxiliary input 文件: aux_input.kicad_sch Bus and brake 文件: bus_brake.kicad_sch W half bridge 文件: bridge_w.kicad_sch Analog protection 文件: comparators.kicad_sch Base interlock 文件: base_interlock.kicad_sch

Current sensing 文件: current_sense.kicad_sch Hardware latch 文件: fault_logic.kicad_sch Base LEDs 文件: base_leds.kicad_sch ADC and status returns 文件: core_signal_protection.kicad_sch 64-pin core sockets 文件: power_interface.kicad_sch

V half bridge 文件: bridge_v.kicad_sch Voltage and NTC 文件: voltage_sense.kicad_sch Hardware PWM gates 文件: control_interface.kicad_sch GPIO command coupling 文件: mcu_coupling.kicad_sch SWD UART CAN and status 文件: debug_comms.kicad_sch

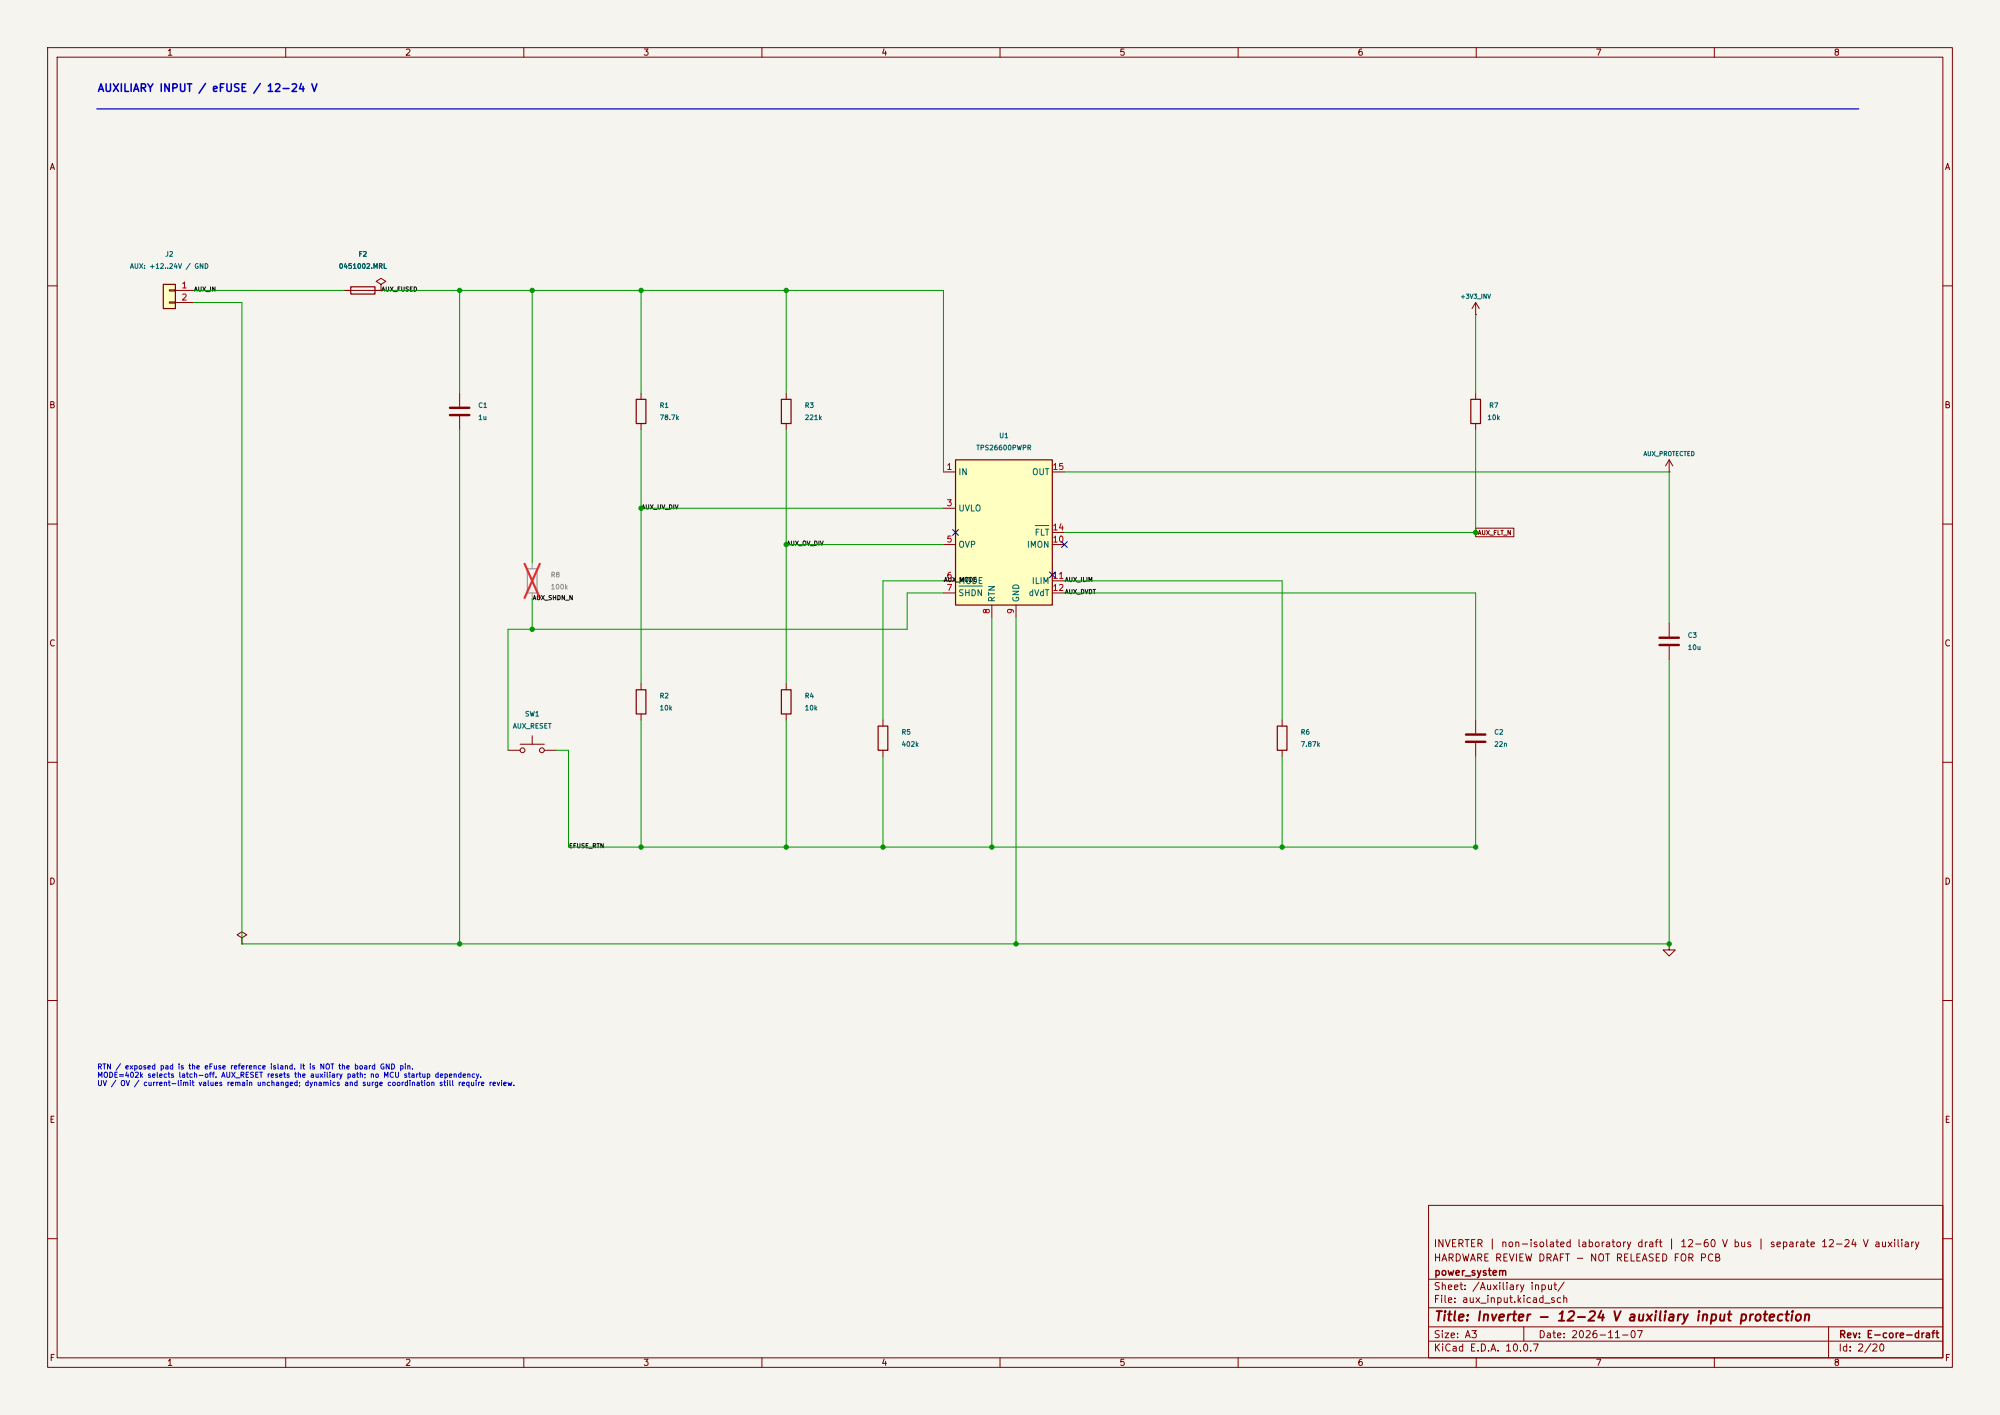
[picture p132: page 2]

RTN / exposed pad is the eFuse reference island. It is NOT the board GND pin. MODE=402k selects latch-off. AUX_RESET resets the auxiliary path; no MCU startup dependency. UV / OV / current-limit values remain unchanged; dynamics and surge coordination still require review.

INVERTER | non-isolated laboratory draft | 12-60 V bus | separate 12-24 V auxiliary
HARDWARE REVIEW DRAFT - NOT RELEASED FOR PCB
power_system
Sheet: /Auxiliary input/
File: aux_input.kicad_sch
Title: Inverter - 12-24 V auxiliary input protection

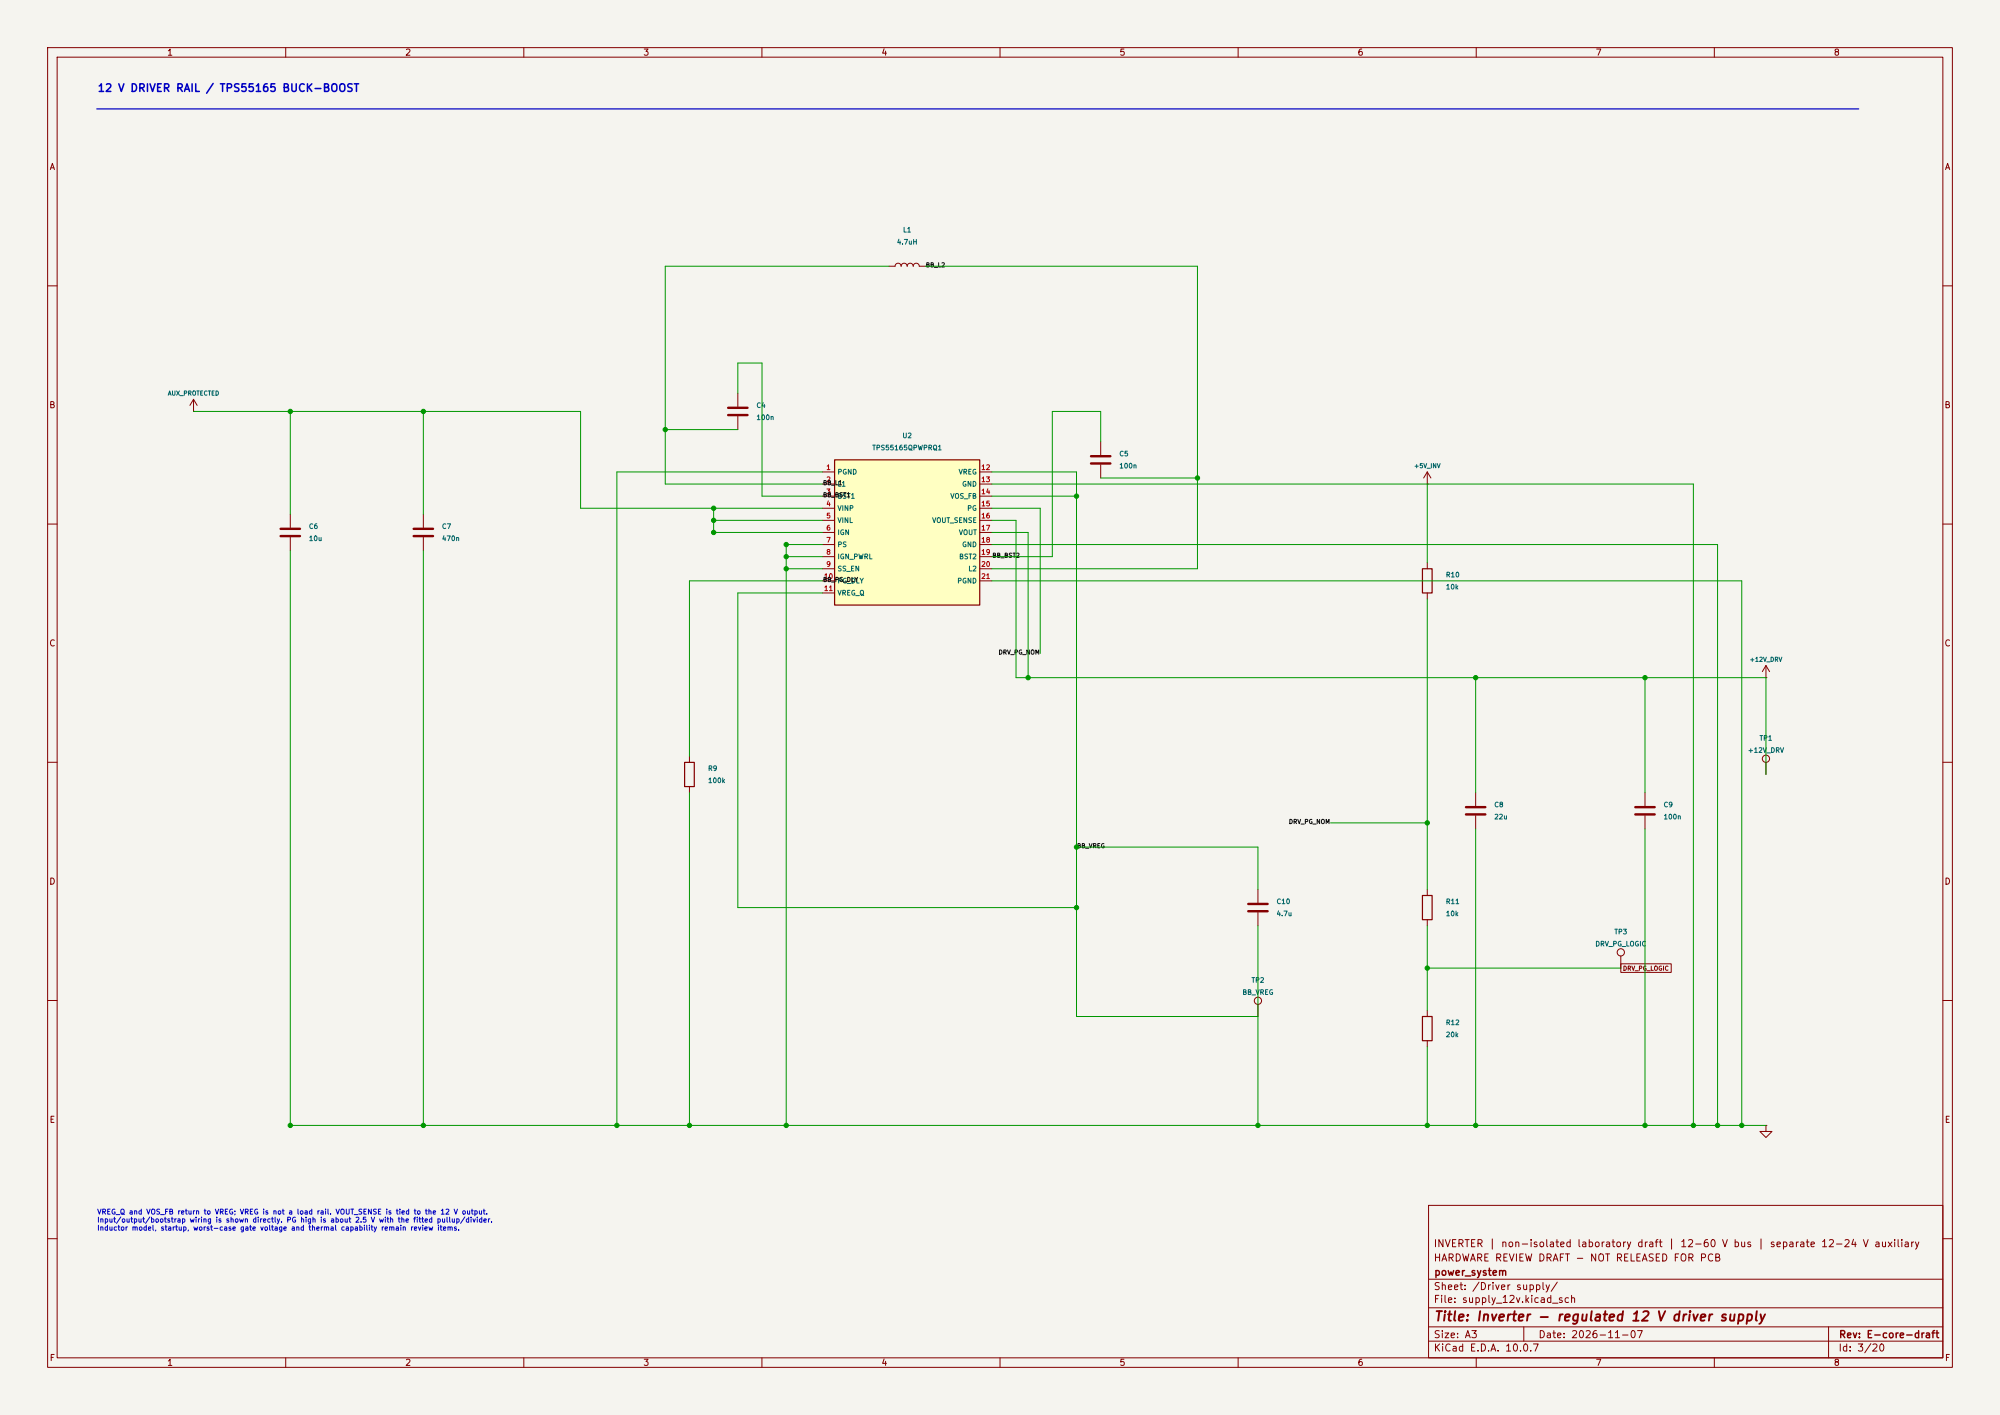
[picture p133: page 3]

12 V DRIVER RAIL / TPS55165 BUCK-BOOST

VREG_Q and VOS_FB return to VREG; VREG is not a load rail. VOUT_SENSE is tied to the 12 V output.
Input/output/bootstrap wiring is shown directly. PG high is about 2.5 V with the fitted pullup/divider.
Inductor model, startup, worst-case gate voltage and thermal capability remain review items.

INVERTER | non-isolated laboratory draft | 12-60 V bus | separate 12-24 V auxiliary
HARDWARE REVIEW DRAFT - NOT RELEASED FOR PCB
power_system
Sheet: /Driver supply/
File: supply_12v.kicad_sch
Title: Inverter - regulated 12 V driver supply

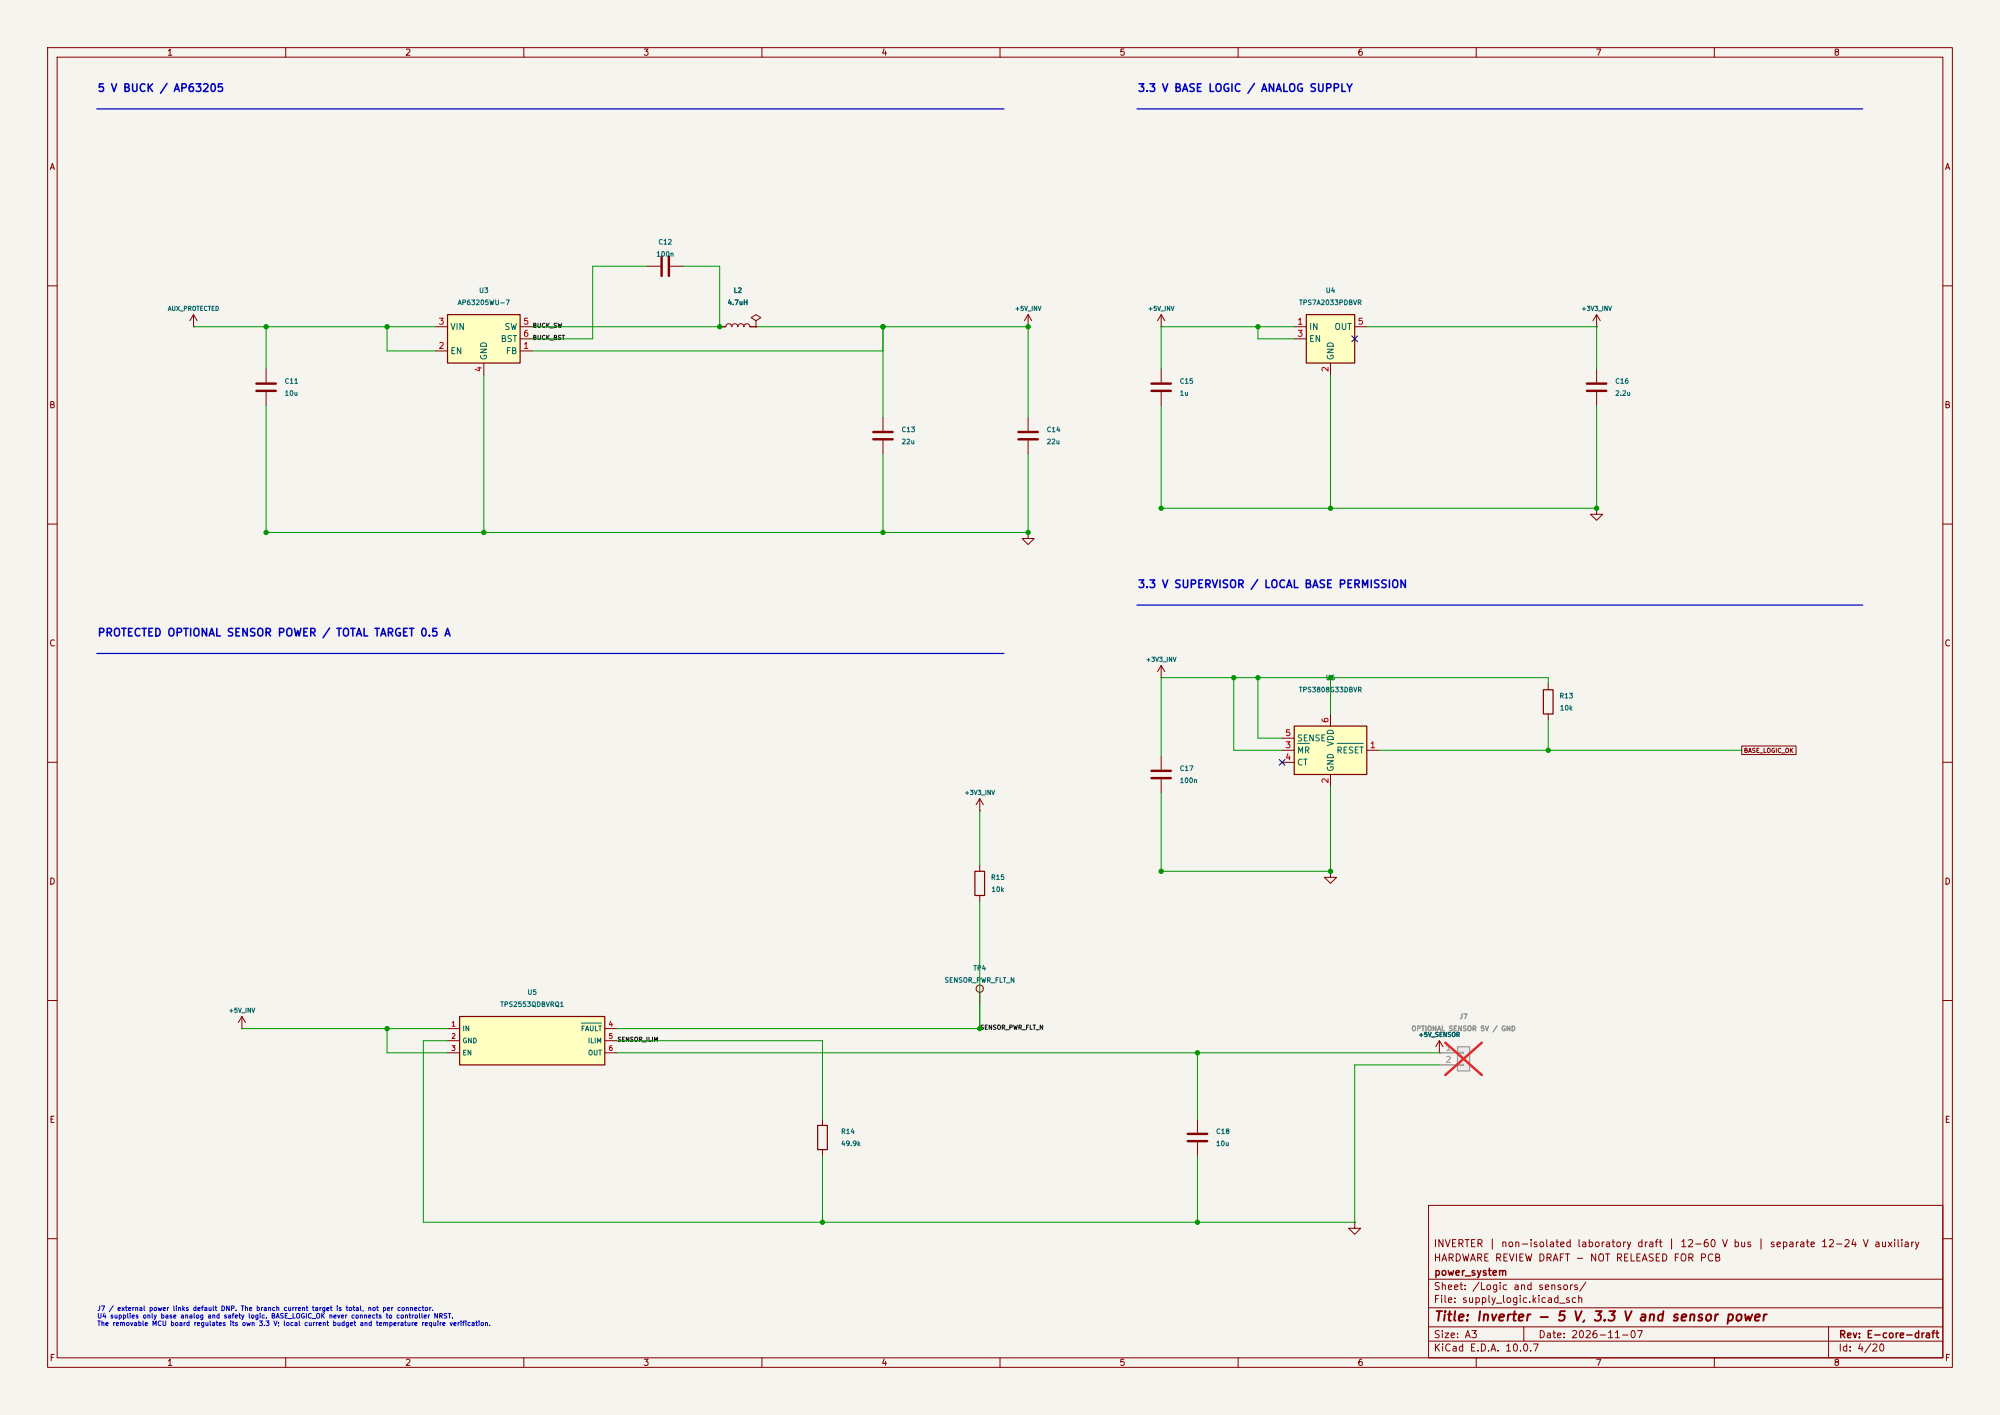
[picture p134: page 4]

3.3 V BASE LOGIC / ANALOG SUPPLY

3.3 V SUPERVISOR / LOCAL BASE PERMISSION

PROTECTED OPTIONAL SENSOR POWER / TOTAL TARGET 0.5 A

INVERTER | non-isolated laboratory draft | 12-60 V bus | separate 12-24 V auxiliary
HARDWARE REVIEW DRAFT - NOT RELEASED FOR PCB
power_system
Sheet: /Logic and sensors/
File: supply_logic.kicad_sch
Title: Inverter - 5 V, 3.3 V and sensor power

J7 / external power links default DNP. The branch current target is total, not per connector. U4 supplies only base analog and safety logic. BASE_LOGIC_OK never connects to controller NRST. The removable MCU board regulates its own 3.3 V; local current budget and temperature require verification.

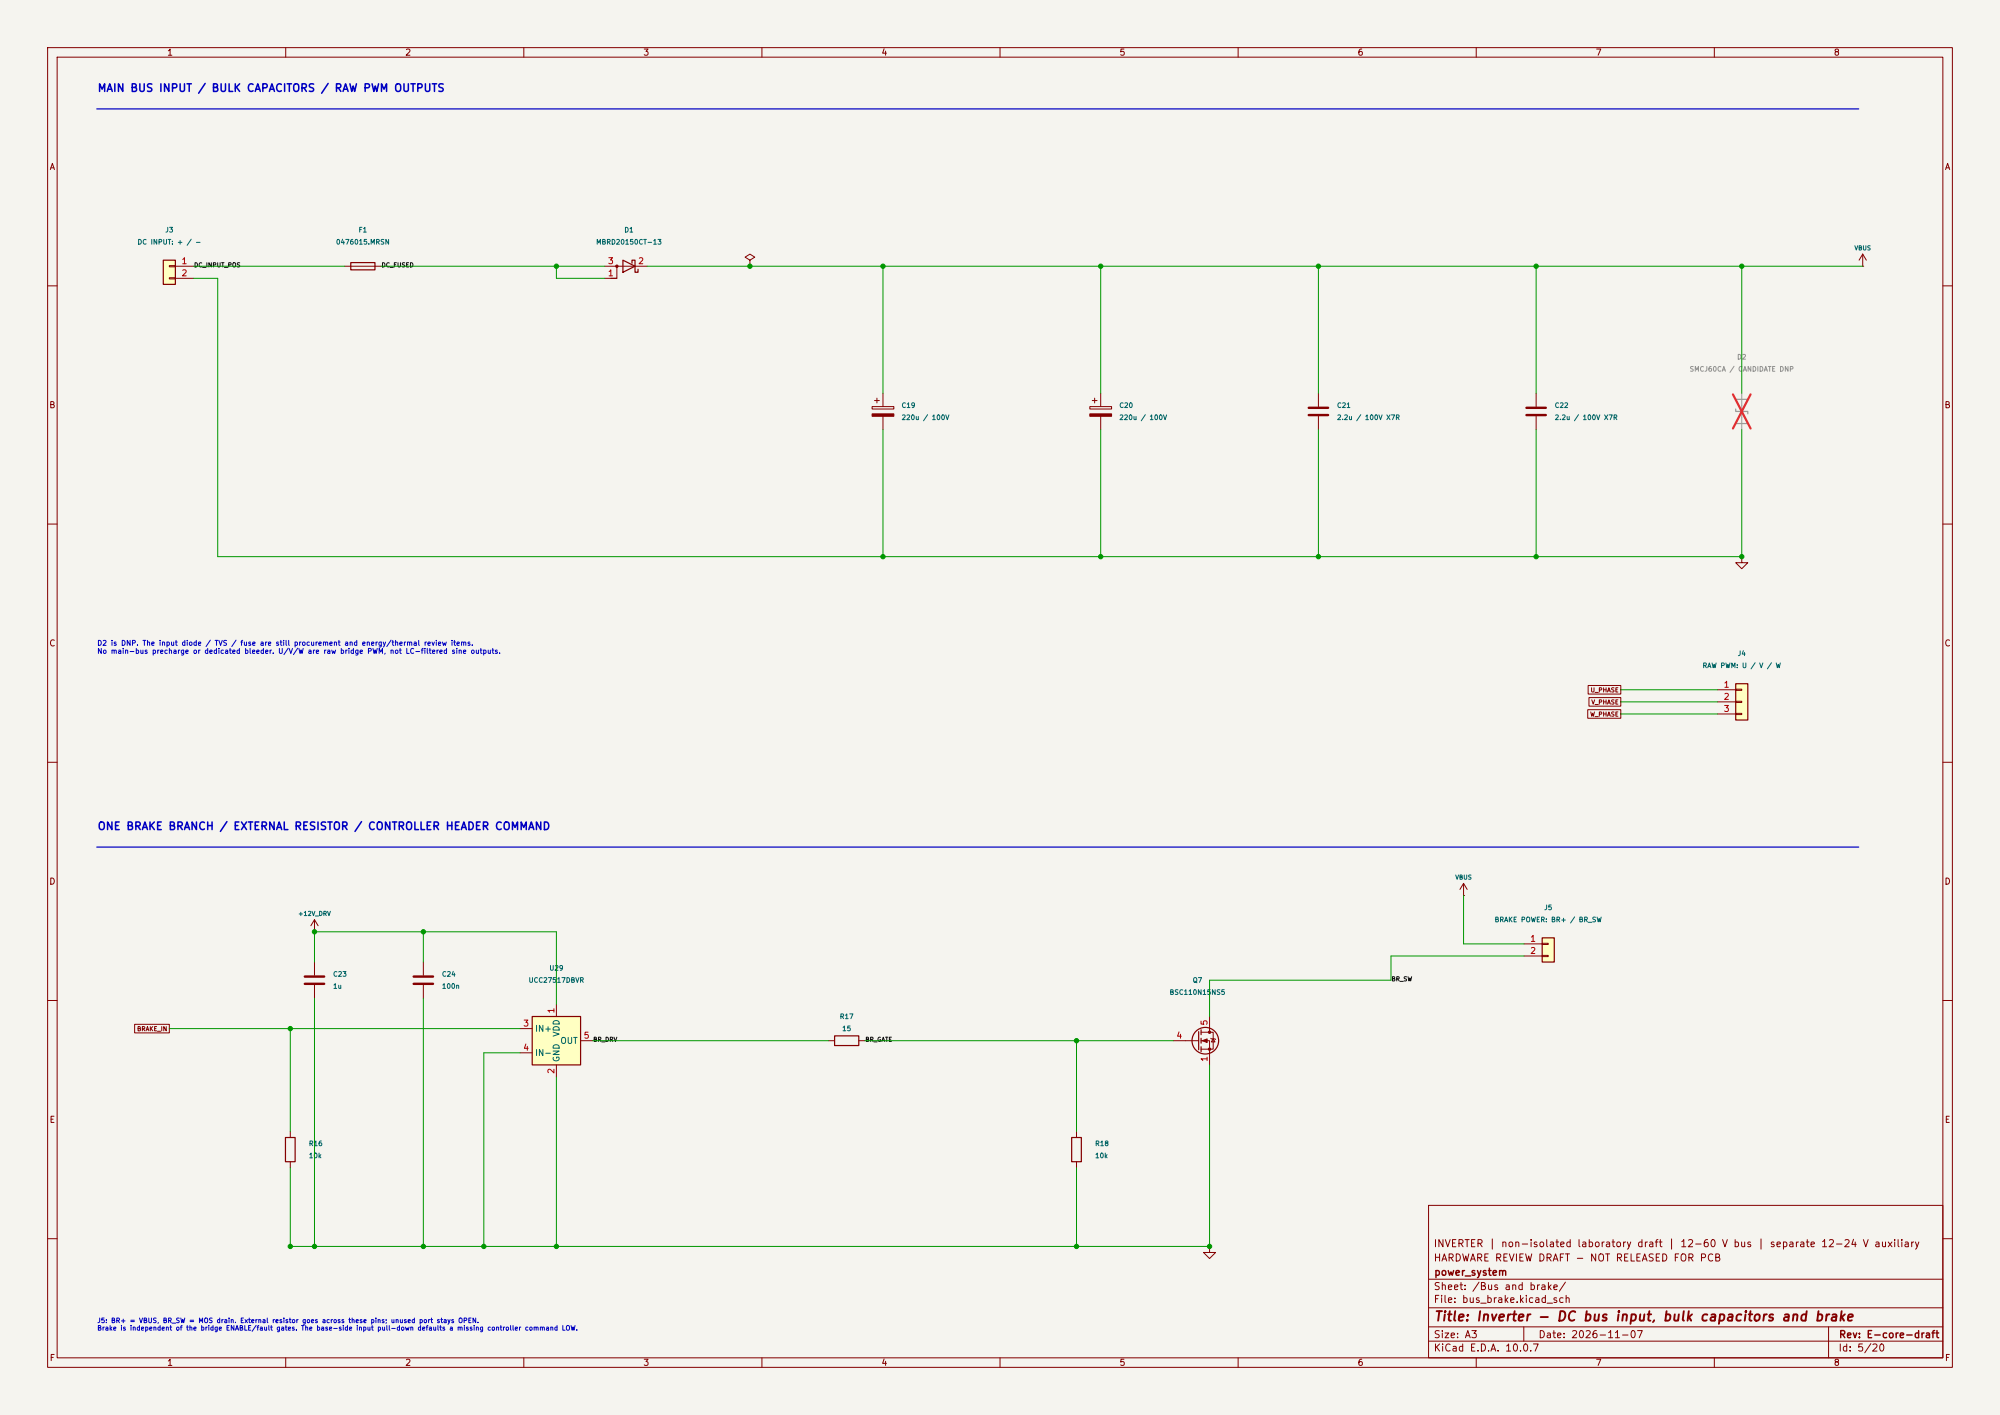
[picture p135: page 5]

D2 is DNP. The input diode / TVS / fuse are still procurement and energy/thermal review items. No main-bus precharge or dedicated bleeder. U/V/W are raw bridge PWM, not LC-filtered sine outputs. MAIN BUS INPUT / BULK CAPACITORS / RAW PWM OUTPUTS

ONE BRAKE BRANCH / EXTERNAL RESISTOR / CONTROLLER HEADER COMMAND

INVERTER | non-isolated laboratory draft | 12-60 V bus | separate 12-24 V auxiliary
HARDWARE REVIEW DRAFT - NOT RELEASED FOR PCB
power_system
Sheet: /Bus and brake/
File: bus_brake.kicad_sch
Title: Inverter - DC bus input, bulk capacitors and brake

J5: BR+ = VBUS, BR_SW = MOS drain. External resistor goes across these pins; unused port stays OPEN. Brake is independent of the bridge ENABLE/fault gates. The base-side input pull-down defaults a missing controller command LOW.

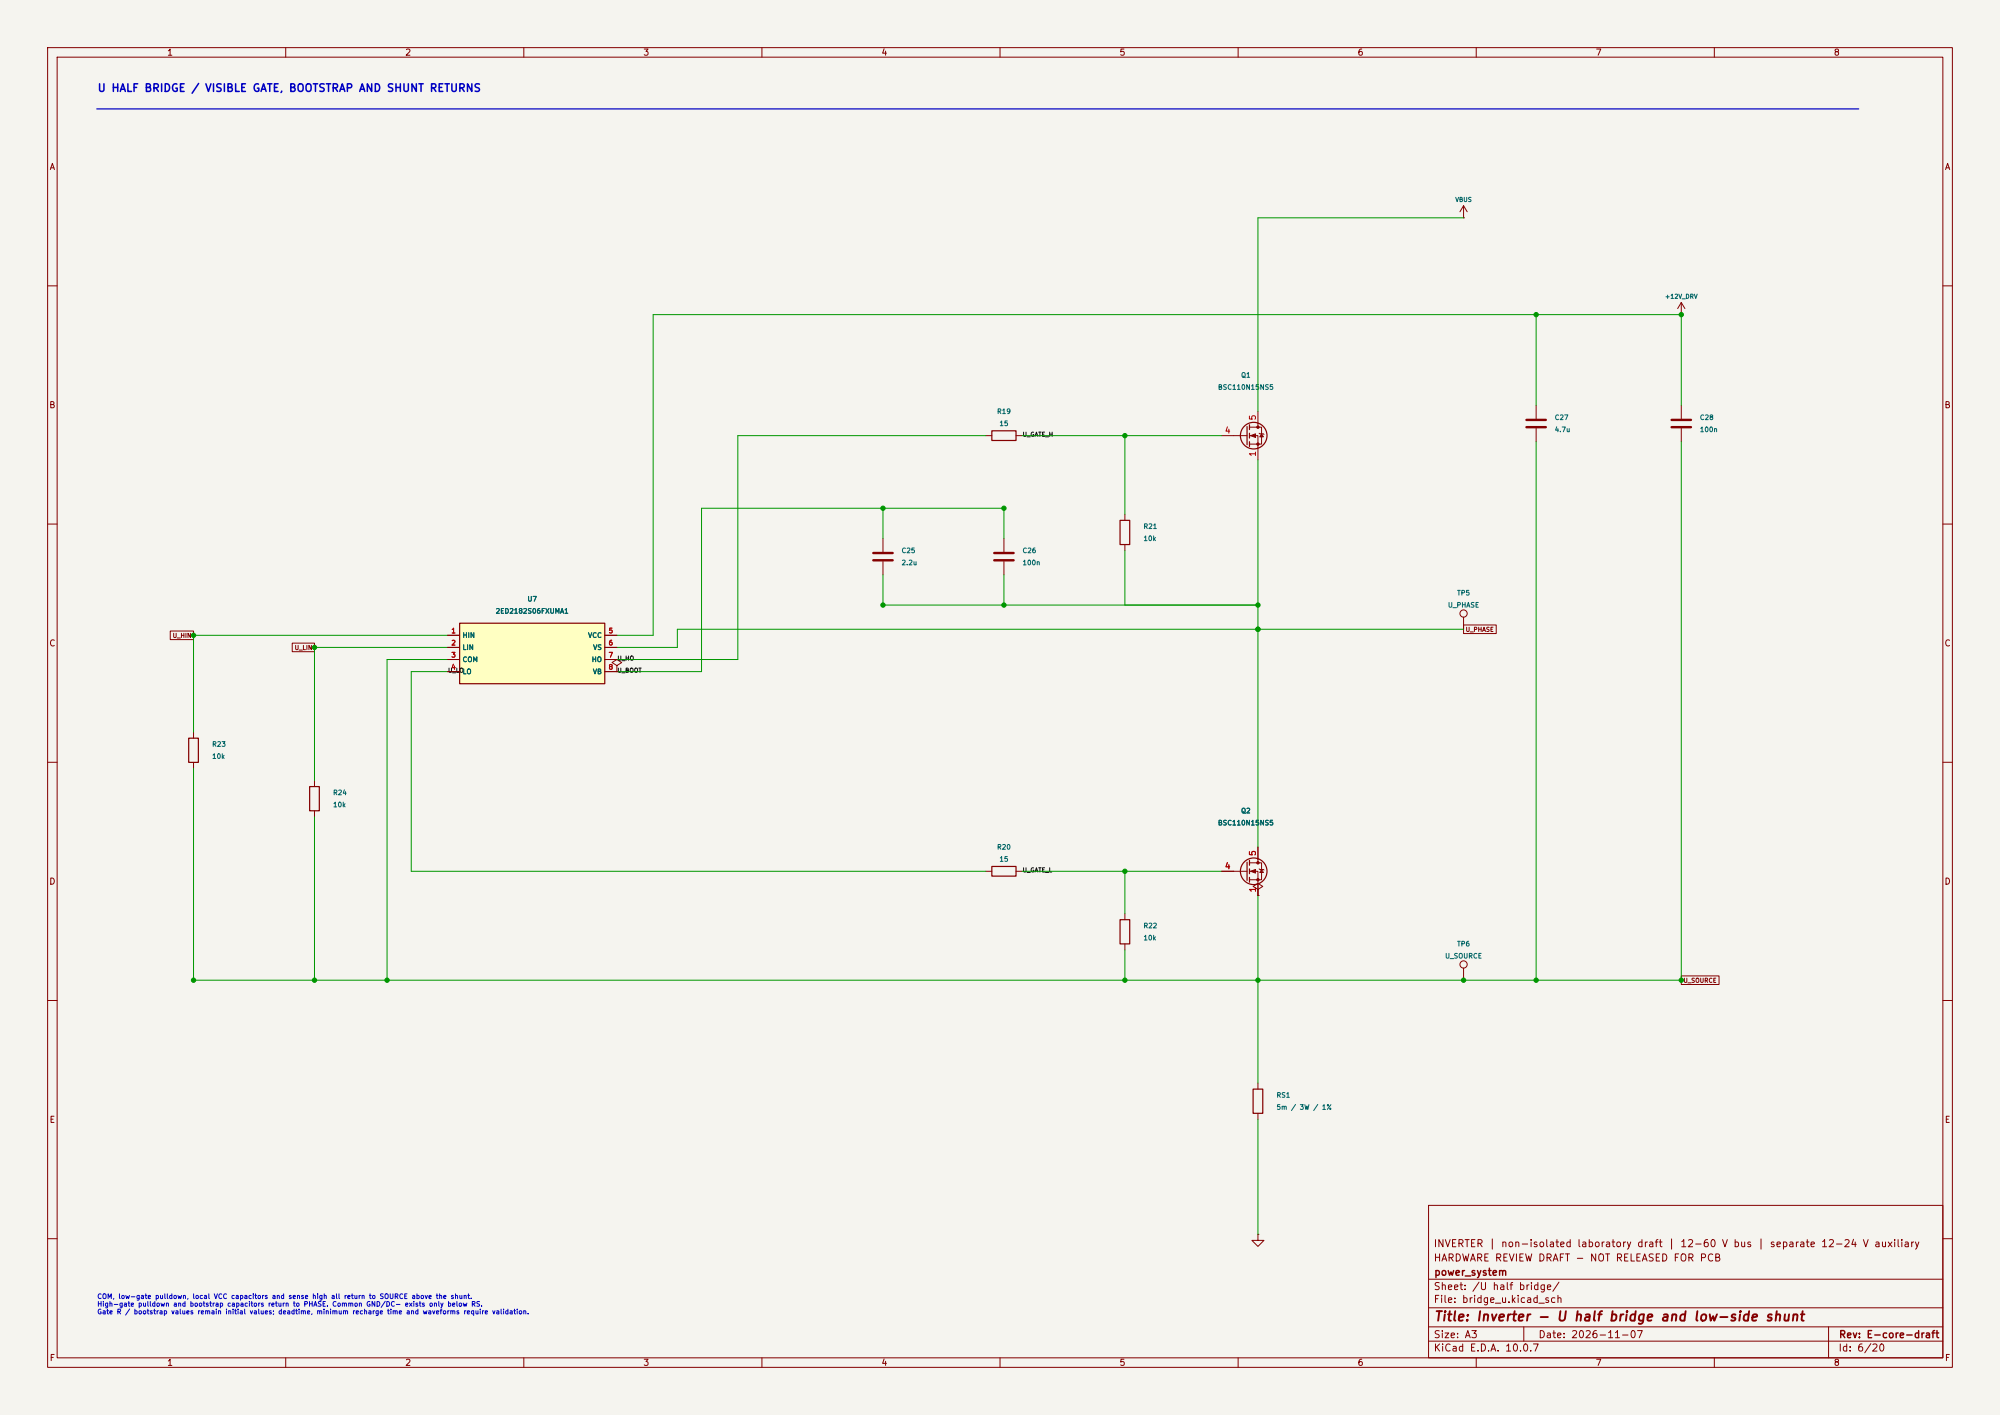
[picture p136: page 6]

U HALF BRIDGE / VISIBLE GATE, BOOTSTRAP AND SHUNT RETURNS

INVERTER | non-isolated laboratory draft | 12-60 V bus | separate 12-24 V auxiliary
HARDWARE REVIEW DRAFT - NOT RELEASED FOR PCB
power_system
Sheet: /U half bridge/
File: bridge_u.kicad_sch
Title: Inverter - U half bridge and low-side shunt

COM, low-gate pulldown, local VCC capacitors and sense high all return to SOURCE above the shunt. High-gate pulldown and bootstrap capacitors return to PHASE. Common GND/DC- exists only below RS. Gate R / bootstrap values remain initial values; deadtime, minimum recharge time and waveforms require validation.

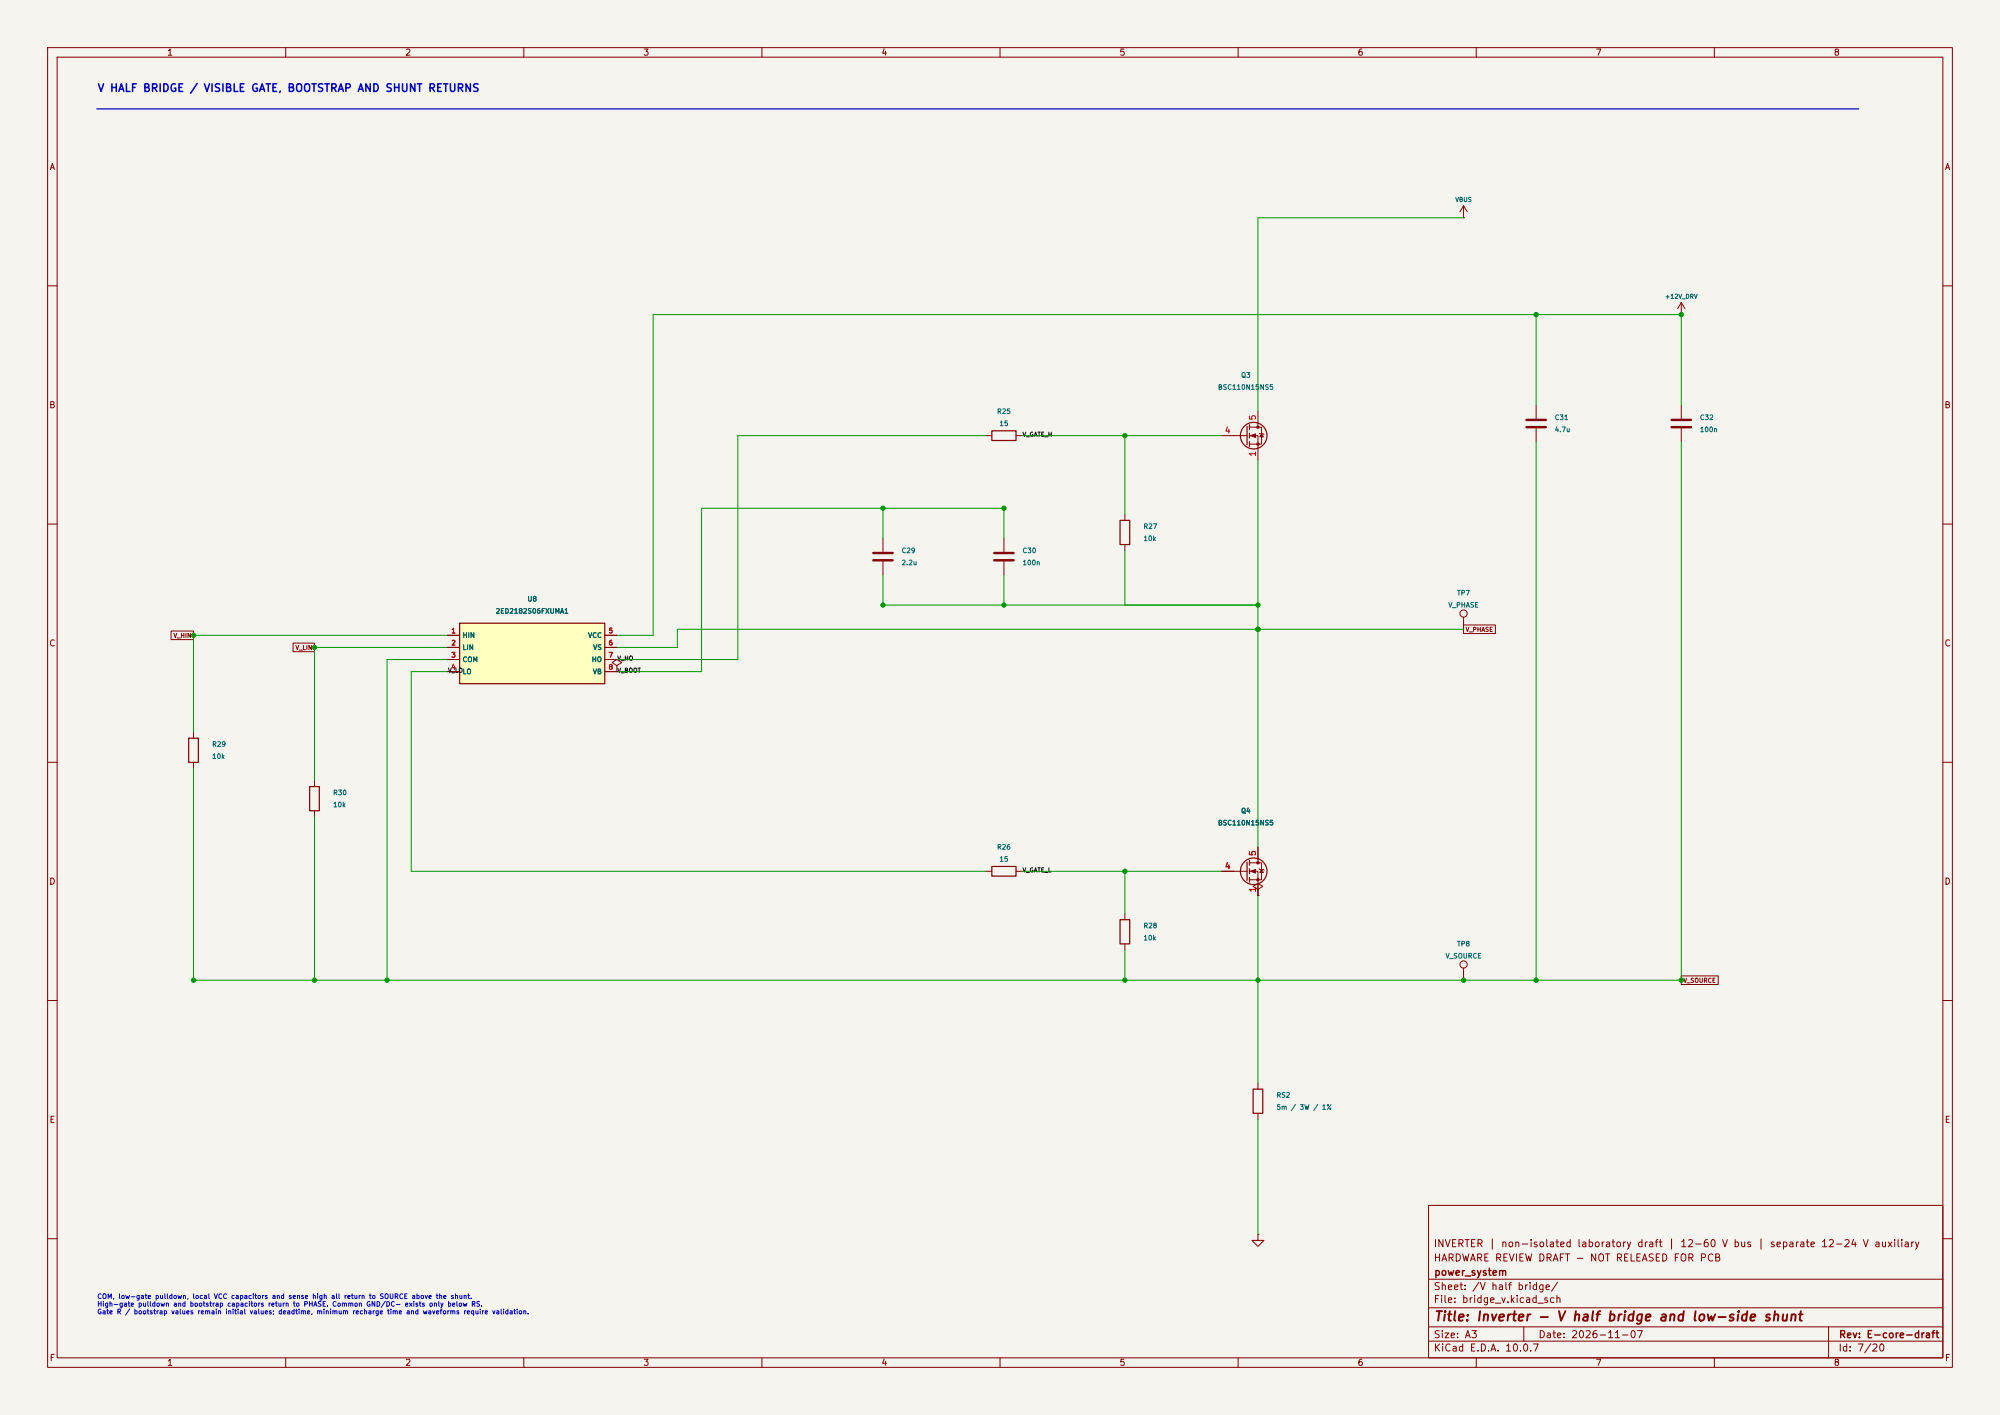
[picture p137: page 7]

V HALF BRIDGE / VISIBLE GATE, BOOTSTRAP AND SHUNT RETURNS

INVERTER | non-isolated laboratory draft | 12-60 V bus | separate 12-24 V auxiliary
HARDWARE REVIEW DRAFT - NOT RELEASED FOR PCB
power_system
Sheet: /V half bridge/
File: bridge_v.kicad_sch
Title: Inverter - V half bridge and low-side shunt

COM, low-gate pulldown, local VCC capacitors and sense high all return to SOURCE above the shunt. High-gate pulldown and bootstrap capacitors return to PHASE. Common GND/DC- exists only below RS. Gate R / bootstrap values remain initial values; deadtime, minimum recharge time and waveforms require validation.

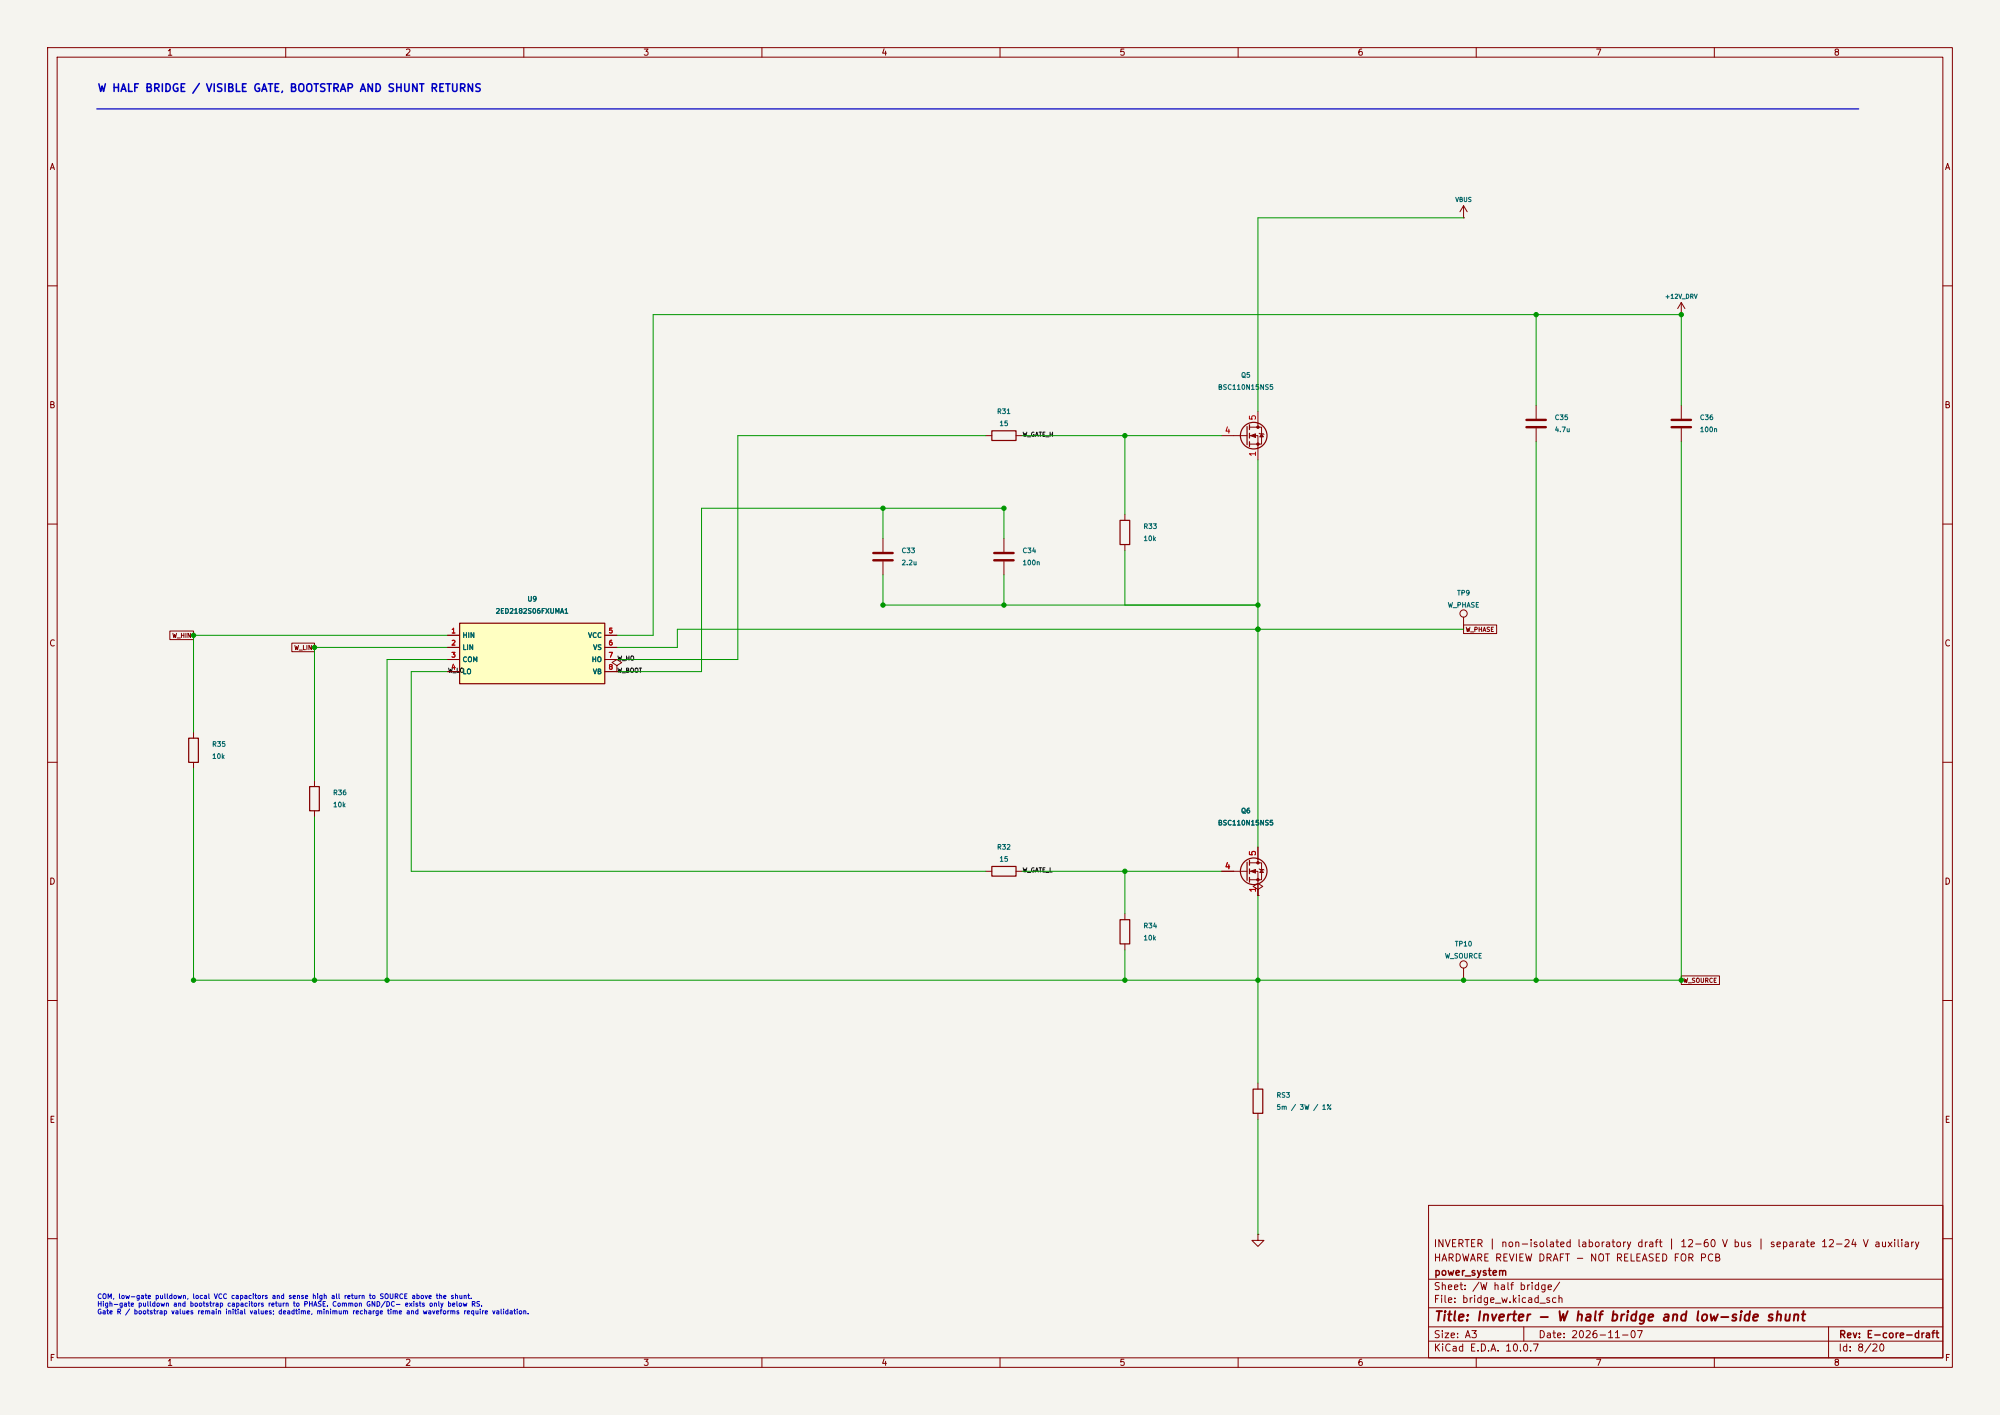
[picture p138: page 8]

W HALF BRIDGE / VISIBLE GATE, BOOTSTRAP AND SHUNT RETURNS

INVERTER | non-isolated laboratory draft | 12-60 V bus | separate 12-24 V auxiliary
HARDWARE REVIEW DRAFT - NOT RELEASED FOR PCB
power_system
Sheet: /W half bridge/
File: bridge_w.kicad_sch
Title: Inverter - W half bridge and low-side shunt

COM, low-gate pulldown, local VCC capacitors and sense high all return to SOURCE above the shunt. High-gate pulldown and bootstrap capacitors return to PHASE. Common GND/DC- exists only below RS. Gate R / bootstrap values remain initial values; deadtime, minimum recharge time and waveforms require validation.

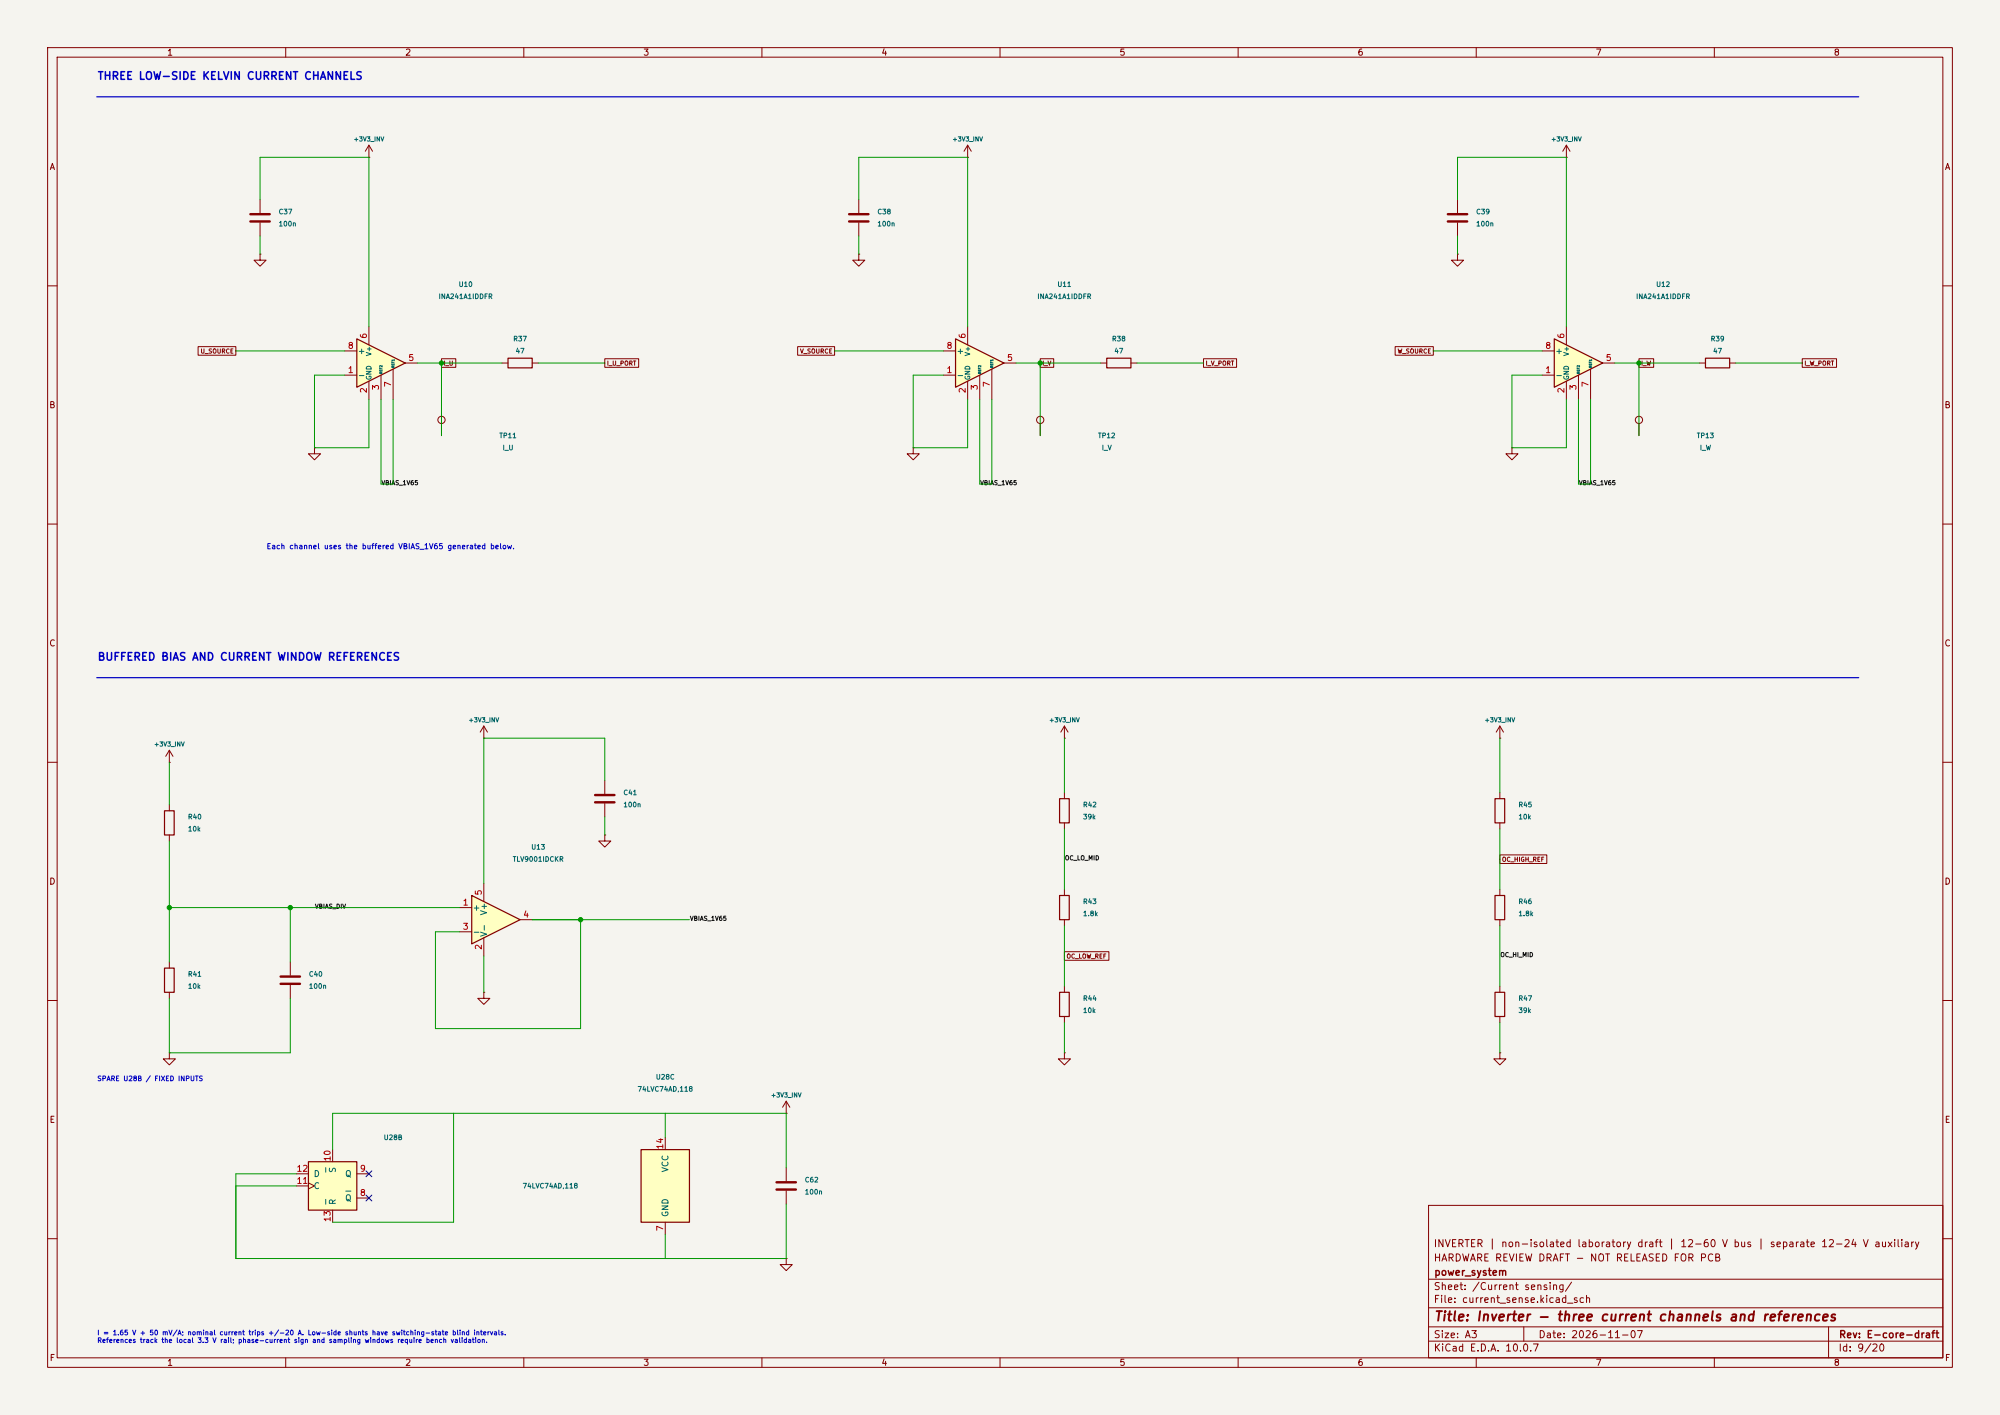
[picture p139: page 9]

THREE LOW-SIDE KELVIN CURRENT CHANNELS

Each channel uses the buffered VBIAS_1V65 generated below. BUFFERED BIAS AND CURRENT WINDOW REFERENCES

INVERTER | non-isolated laboratory draft | 12-60 V bus | separate 12-24 V auxiliary
HARDWARE REVIEW DRAFT - NOT RELEASED FOR PCB
power_system
Sheet: /Current sensing/
File: current_sense.kicad_sch
Title: Inverter - three current channels and references

I = 1.65 V + 50 mV/A; nominal current trips +/-20 A. Low-side shunts have switching-state blind intervals. References track the local 3.3 V rail; phase-current sign and sampling windows require bench validation.

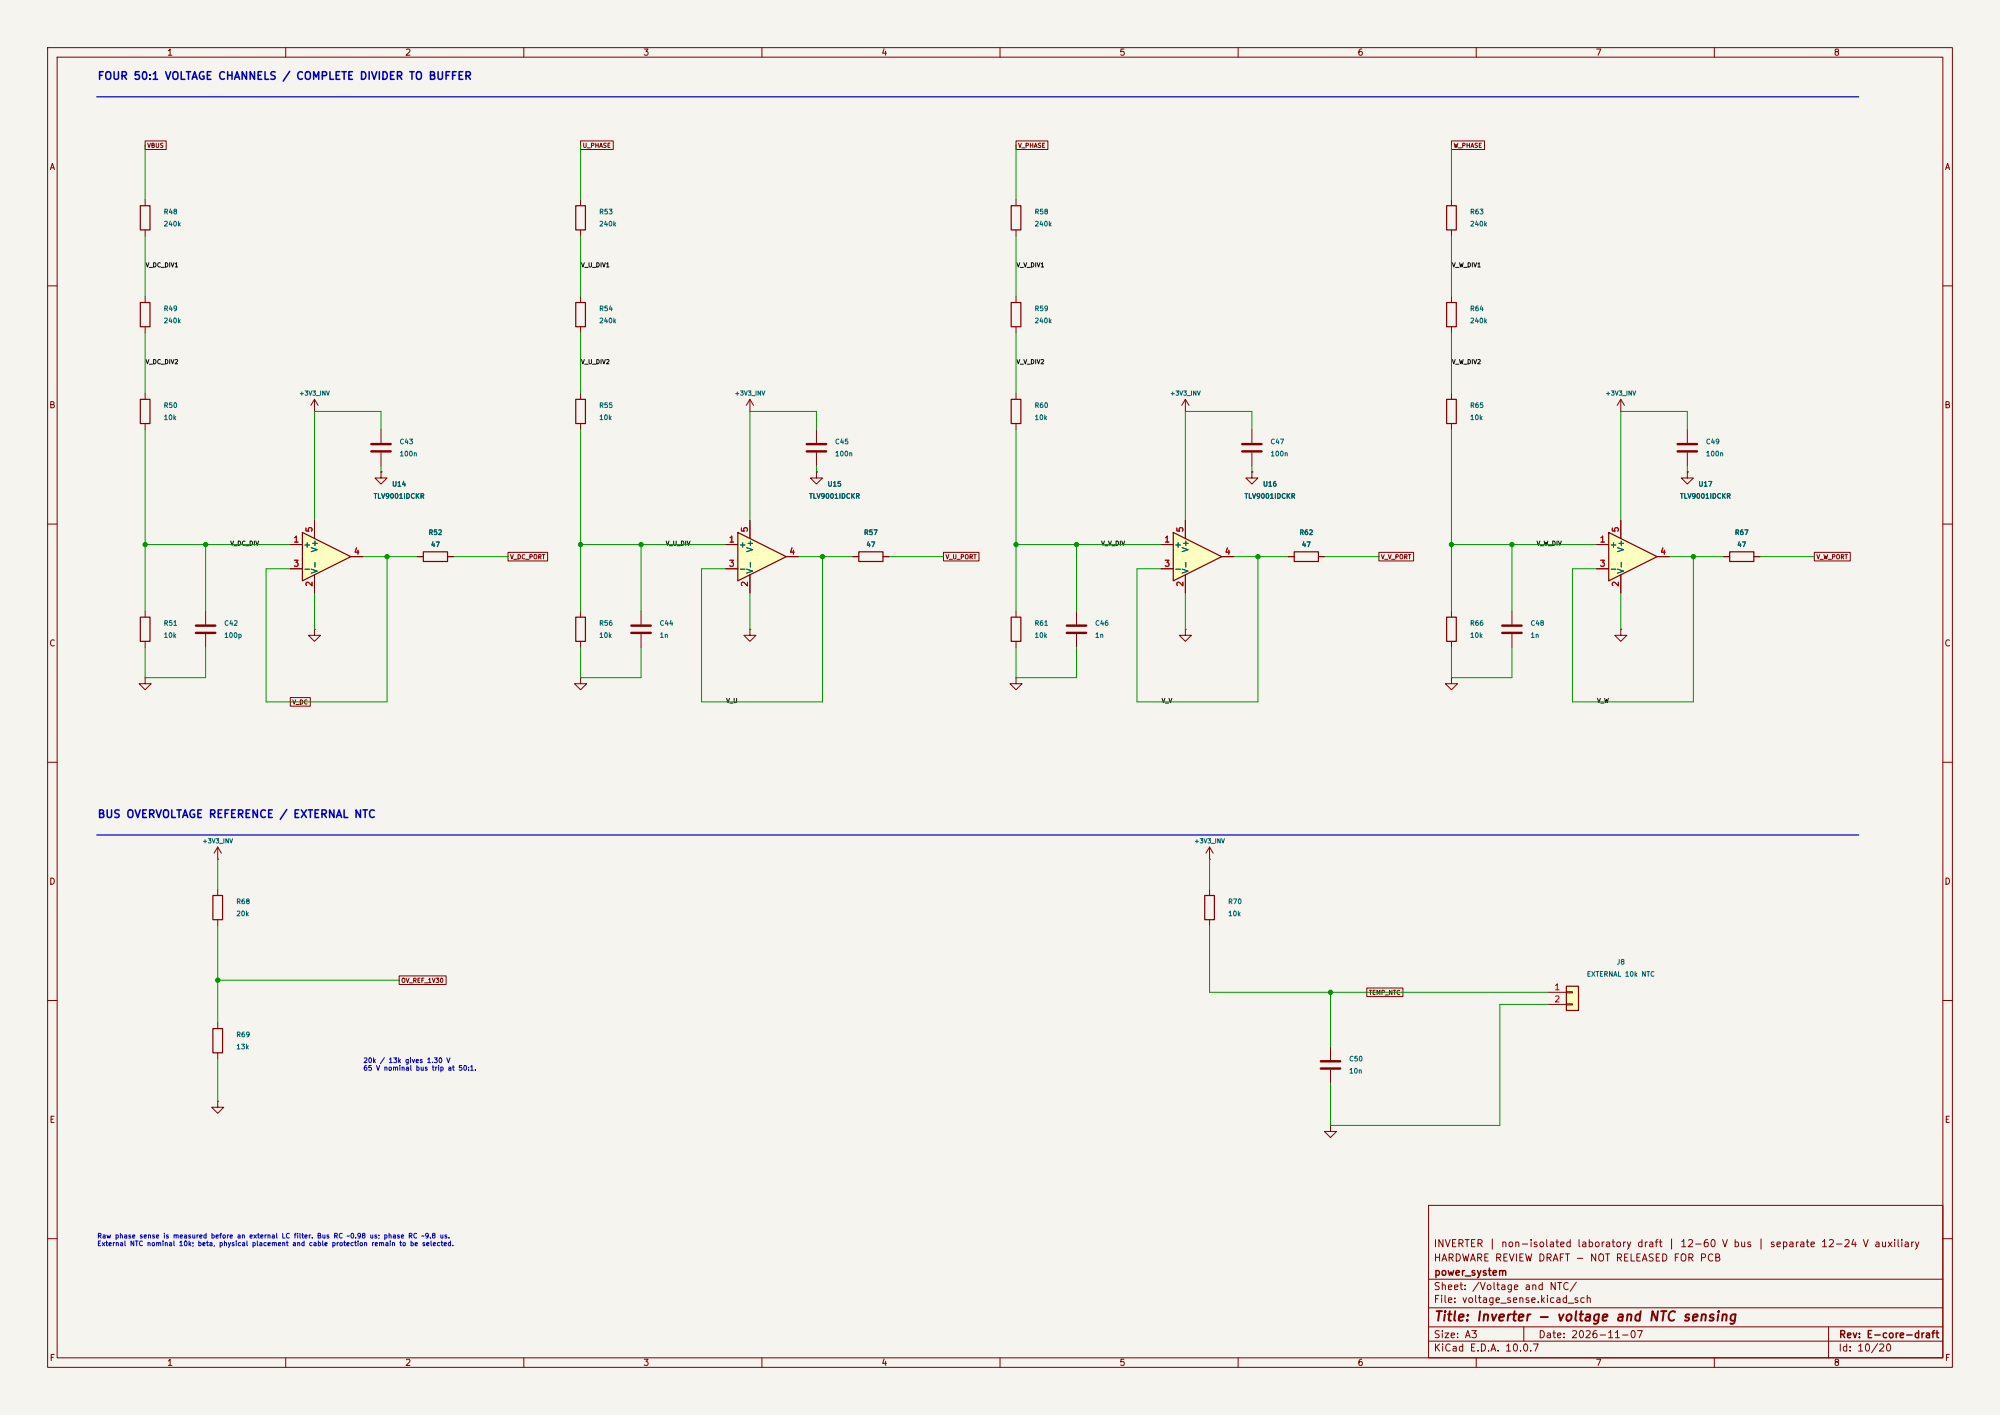
[picture p140: page 10]

FOUR 50:1 VOLTAGE CHANNELS / COMPLETE DIVIDER TO BUFFER

Raw phase sense is measured before an external LC filter. Bus RC ~0.98 us; phase RC ~9.8 us. External NTC nominal 10k; beta, physical placement and cable protection remain to be selected. BUS OVERVOLTAGE REFERENCE / EXTERNAL NTC

20k / 13k gives 1.30 V 65 V nominal bus trip at 50:1.

INVERTER | non-isolated laboratory draft | 12-60 V bus | separate 12-24 V auxiliary
HARDWARE REVIEW DRAFT - NOT RELEASED FOR PCB
power_system
Sheet: /Voltage and NTC/
File: voltage_sense.kicad_sch
Title: Inverter - voltage and NTC sensing

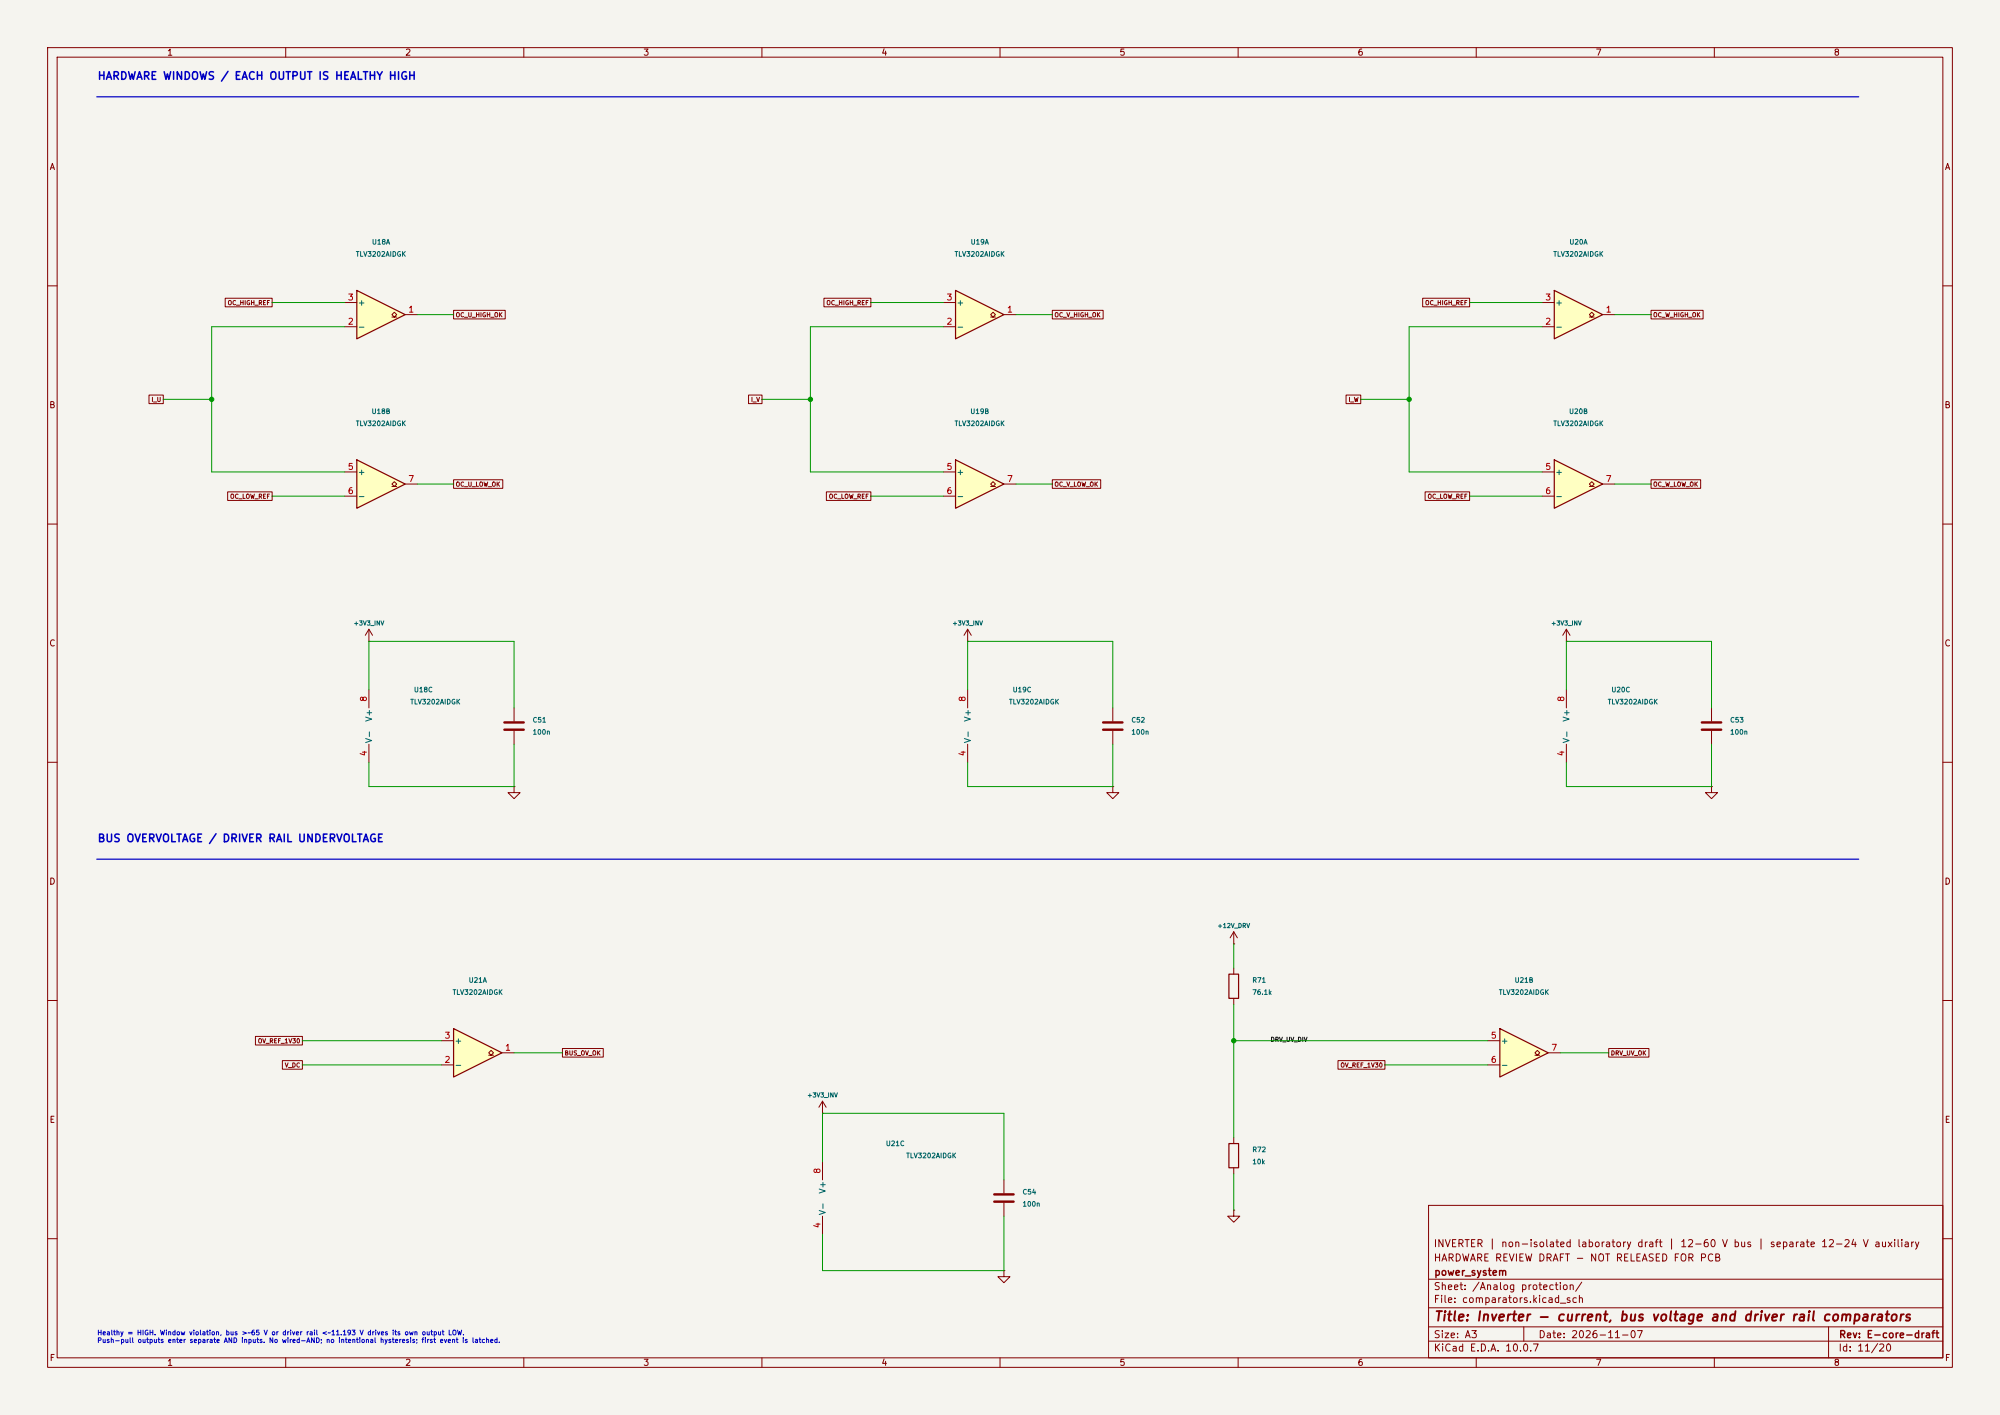
[picture p141: page 11]

HARDWARE WINDOWS / EACH OUTPUT IS HEALTHY HIGH

BUS OVERVOLTAGE / DRIVER RAIL UNDERVOLTAGE

INVERTER | non-isolated laboratory draft | 12-60 V bus | separate 12-24 V auxiliary
HARDWARE REVIEW DRAFT - NOT RELEASED FOR PCB
power_system
Sheet: /Analog protection/
File: comparators.kicad_sch
Title: Inverter - current, bus voltage and driver rail comparators

Healthy = HIGH. Window violation, bus >~65 V or driver rail <~11.193 V drives its own output LOW. Push-pull outputs enter separate AND inputs. No wired-AND; no intentional hysteresis; first event is latched.

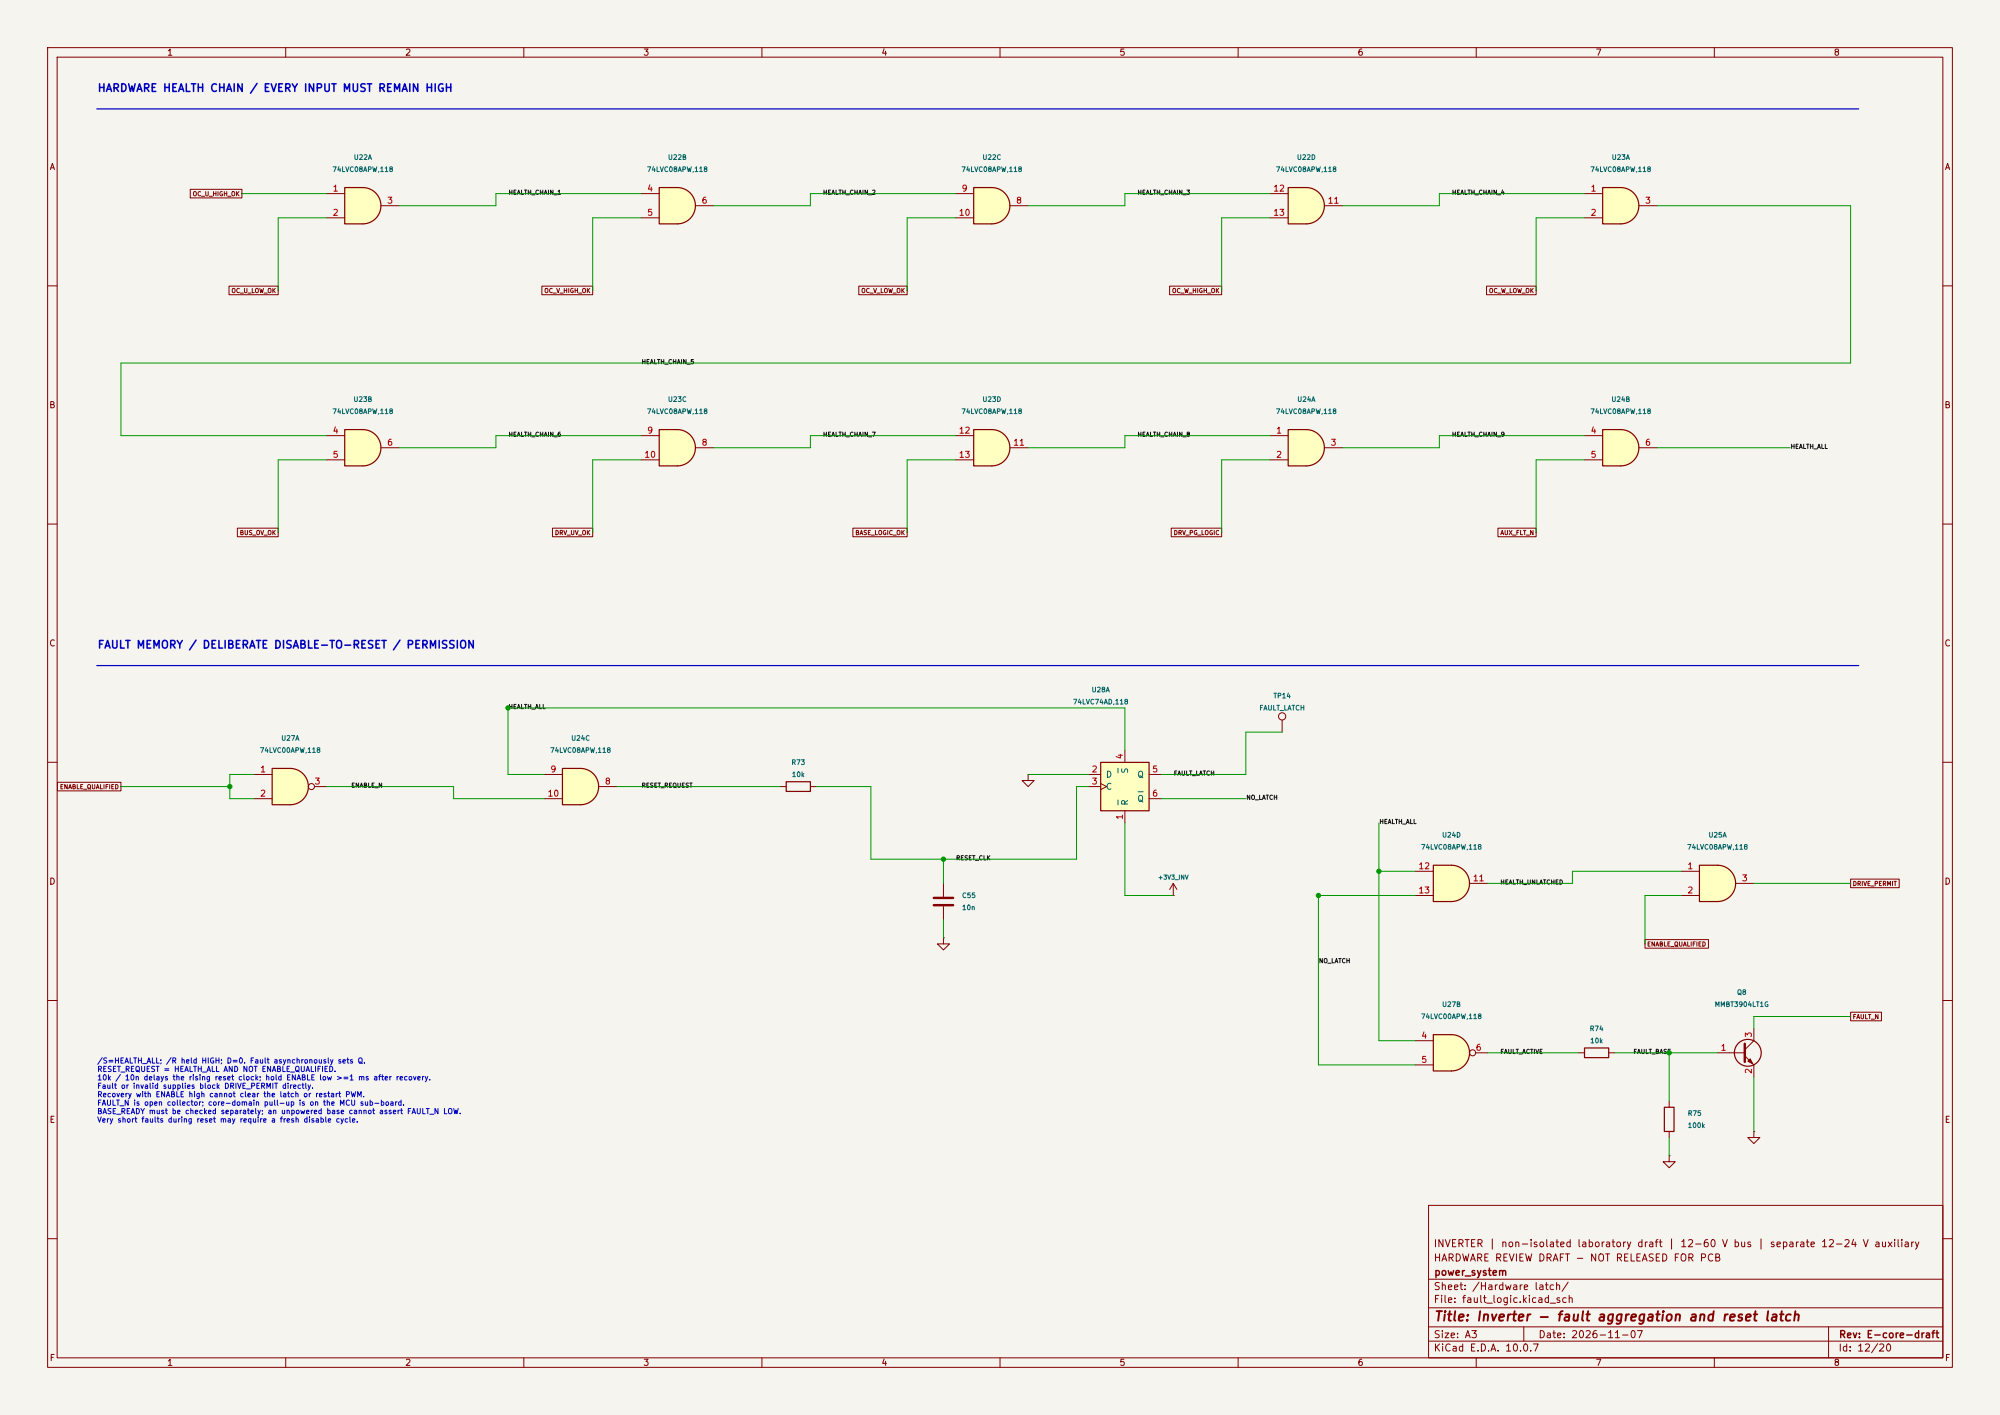
[picture p142: page 12]

HARDWARE HEALTH CHAIN / EVERY INPUT MUST REMAIN HIGH

FAULT_BASE FAULT MEMORY / DELIBERATE DISABLE-TO-RESET / PERMISSION

/S=HEALTH_ALL; /R held HIGH; D=0. Fault asynchronously sets Q. RESET_REQUEST = HEALTH_ALL AND NOT ENABLE_QUALIFIED. 10k / 10n delays the rising reset clock; hold ENABLE low >=1 ms after recovery. Fault or invalid supplies block DRIVE_PERMIT directly.

Recovery with ENABLE high cannot clear the latch or restart PWM. FAULT_N is open collector; core-domain pull-up is on the MCU sub-board. BASE_READY must be checked separately; an unpowered base cannot assert FAULT_N LOW. Very short faults during reset may require a fresh disable cycle.

INVERTER | non-isolated laboratory draft | 12-60 V bus | separate 12-24 V auxiliary
HARDWARE REVIEW DRAFT - NOT RELEASED FOR PCB
power_system
Sheet: /Hardware latch/
File: fault_logic.kicad_sch
Title: Inverter - fault aggregation and reset latch

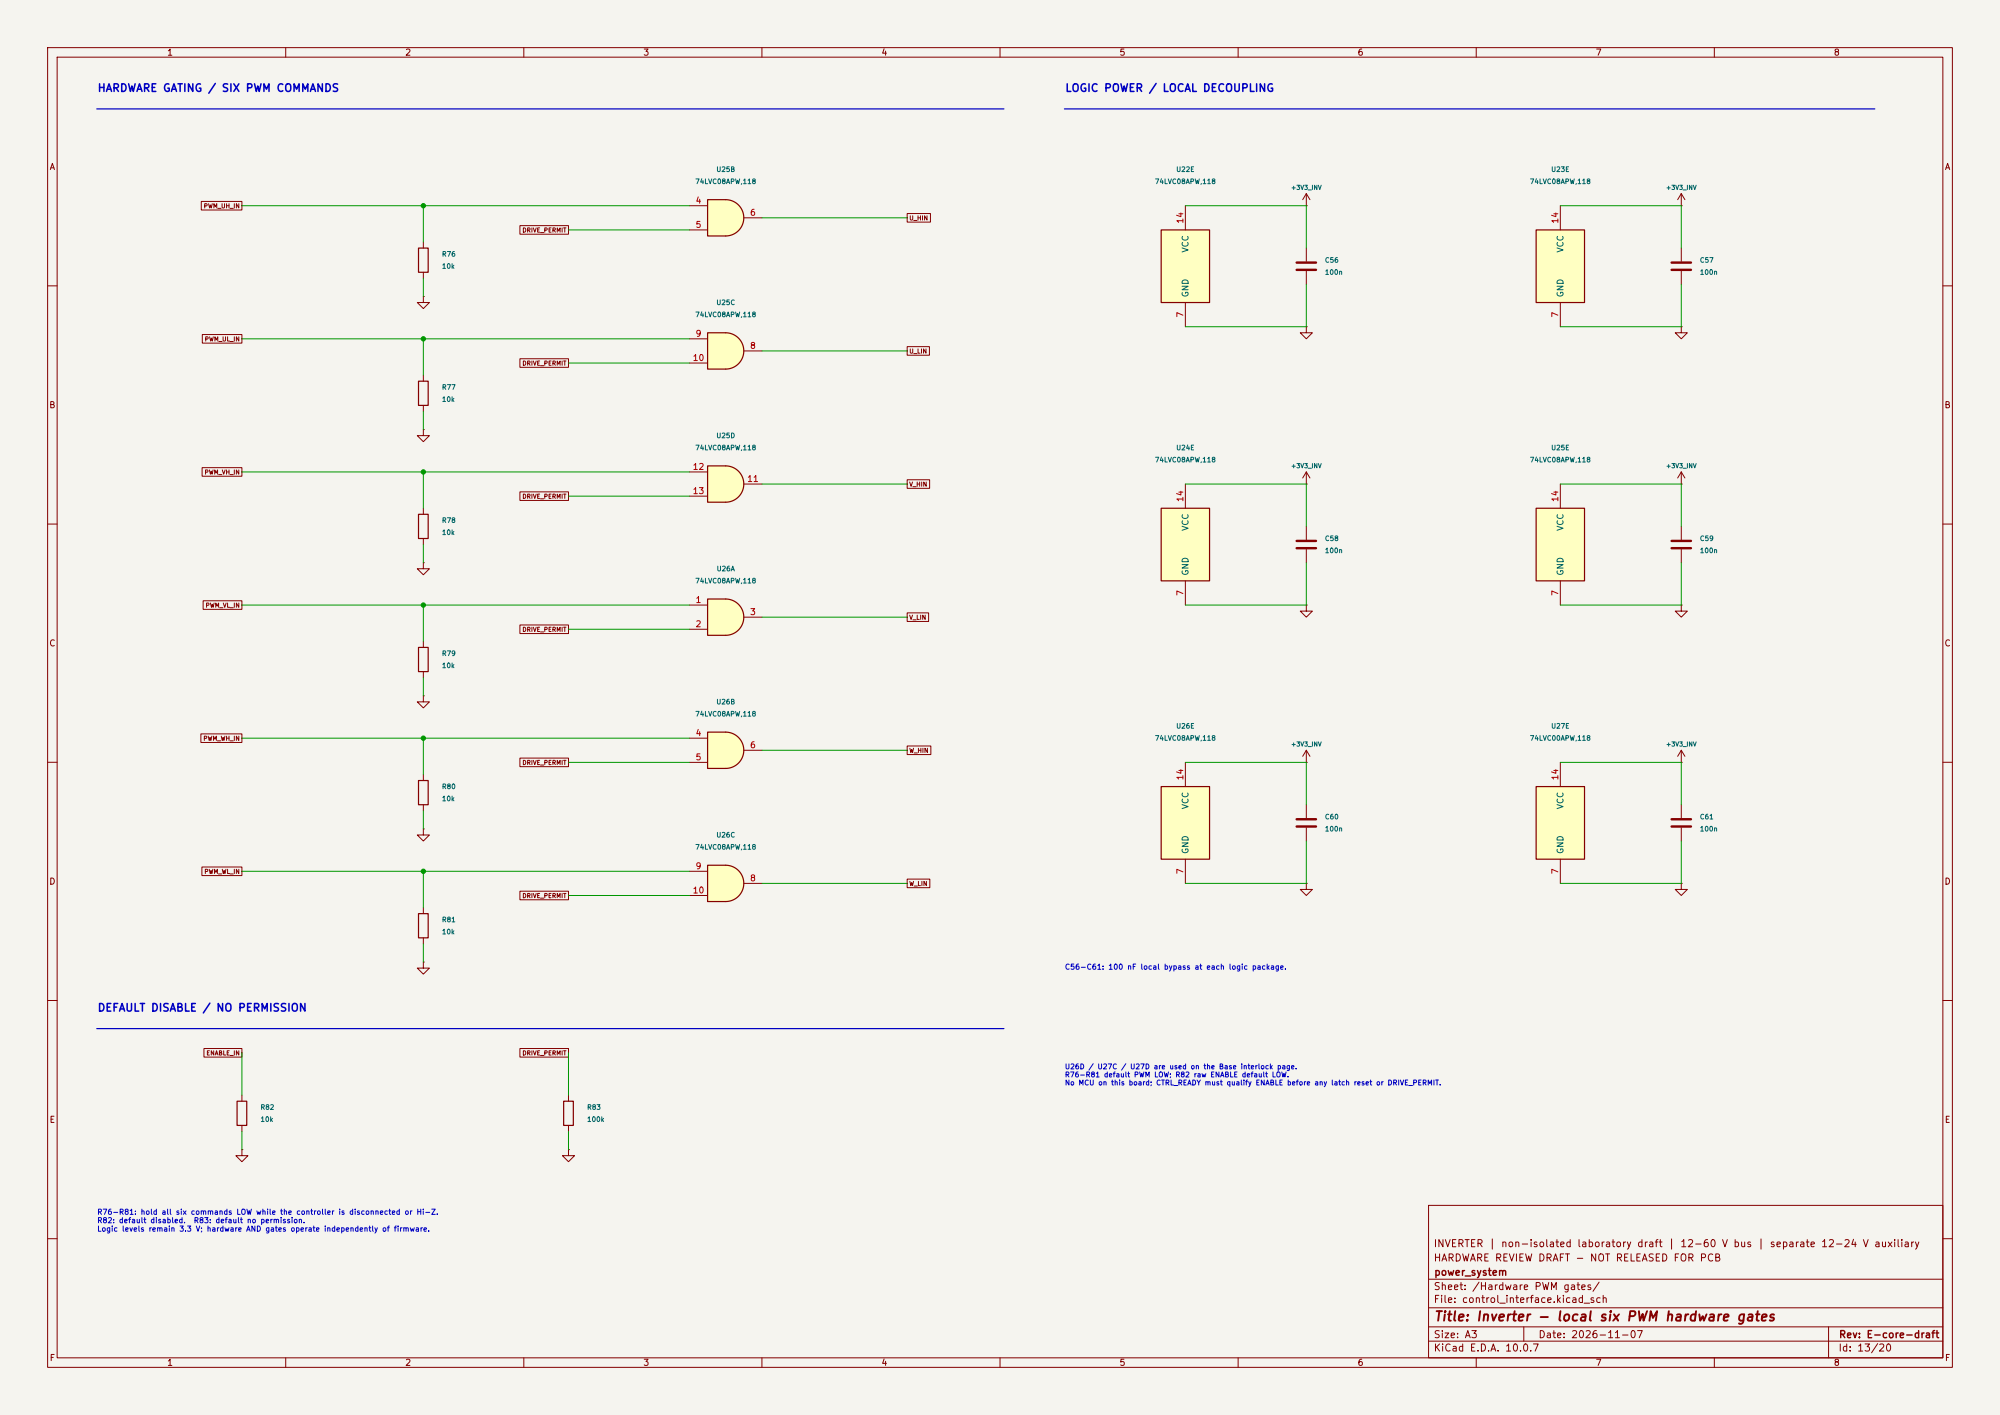
[picture p143: page 13]

U26D / U27C / U27D are used on the Base interlock page. R76-R81 default PWM LOW; R82 raw ENABLE default LOW. No MCU on this board; CTRL_READY must qualify ENABLE before any latch reset or DRIVE_PERMIT. C56-C61: 100 nF local bypass at each logic package.

DEFAULT DISABLE / NO PERMISSION

R76-R81: hold all six commands LOW while the controller is disconnected or Hi-Z. R82: default disabled. R83: default no permission.

Logic levels remain 3.3 V; hardware AND gates operate independently of firmware.

INVERTER | non-isolated laboratory draft | 12-60 V bus | separate 12-24 V auxiliary
HARDWARE REVIEW DRAFT - NOT RELEASED FOR PCB
power_system
Sheet: /Hardware PWM gates/
File: control_interface.kicad_sch
Title: Inverter - local six PWM hardware gates

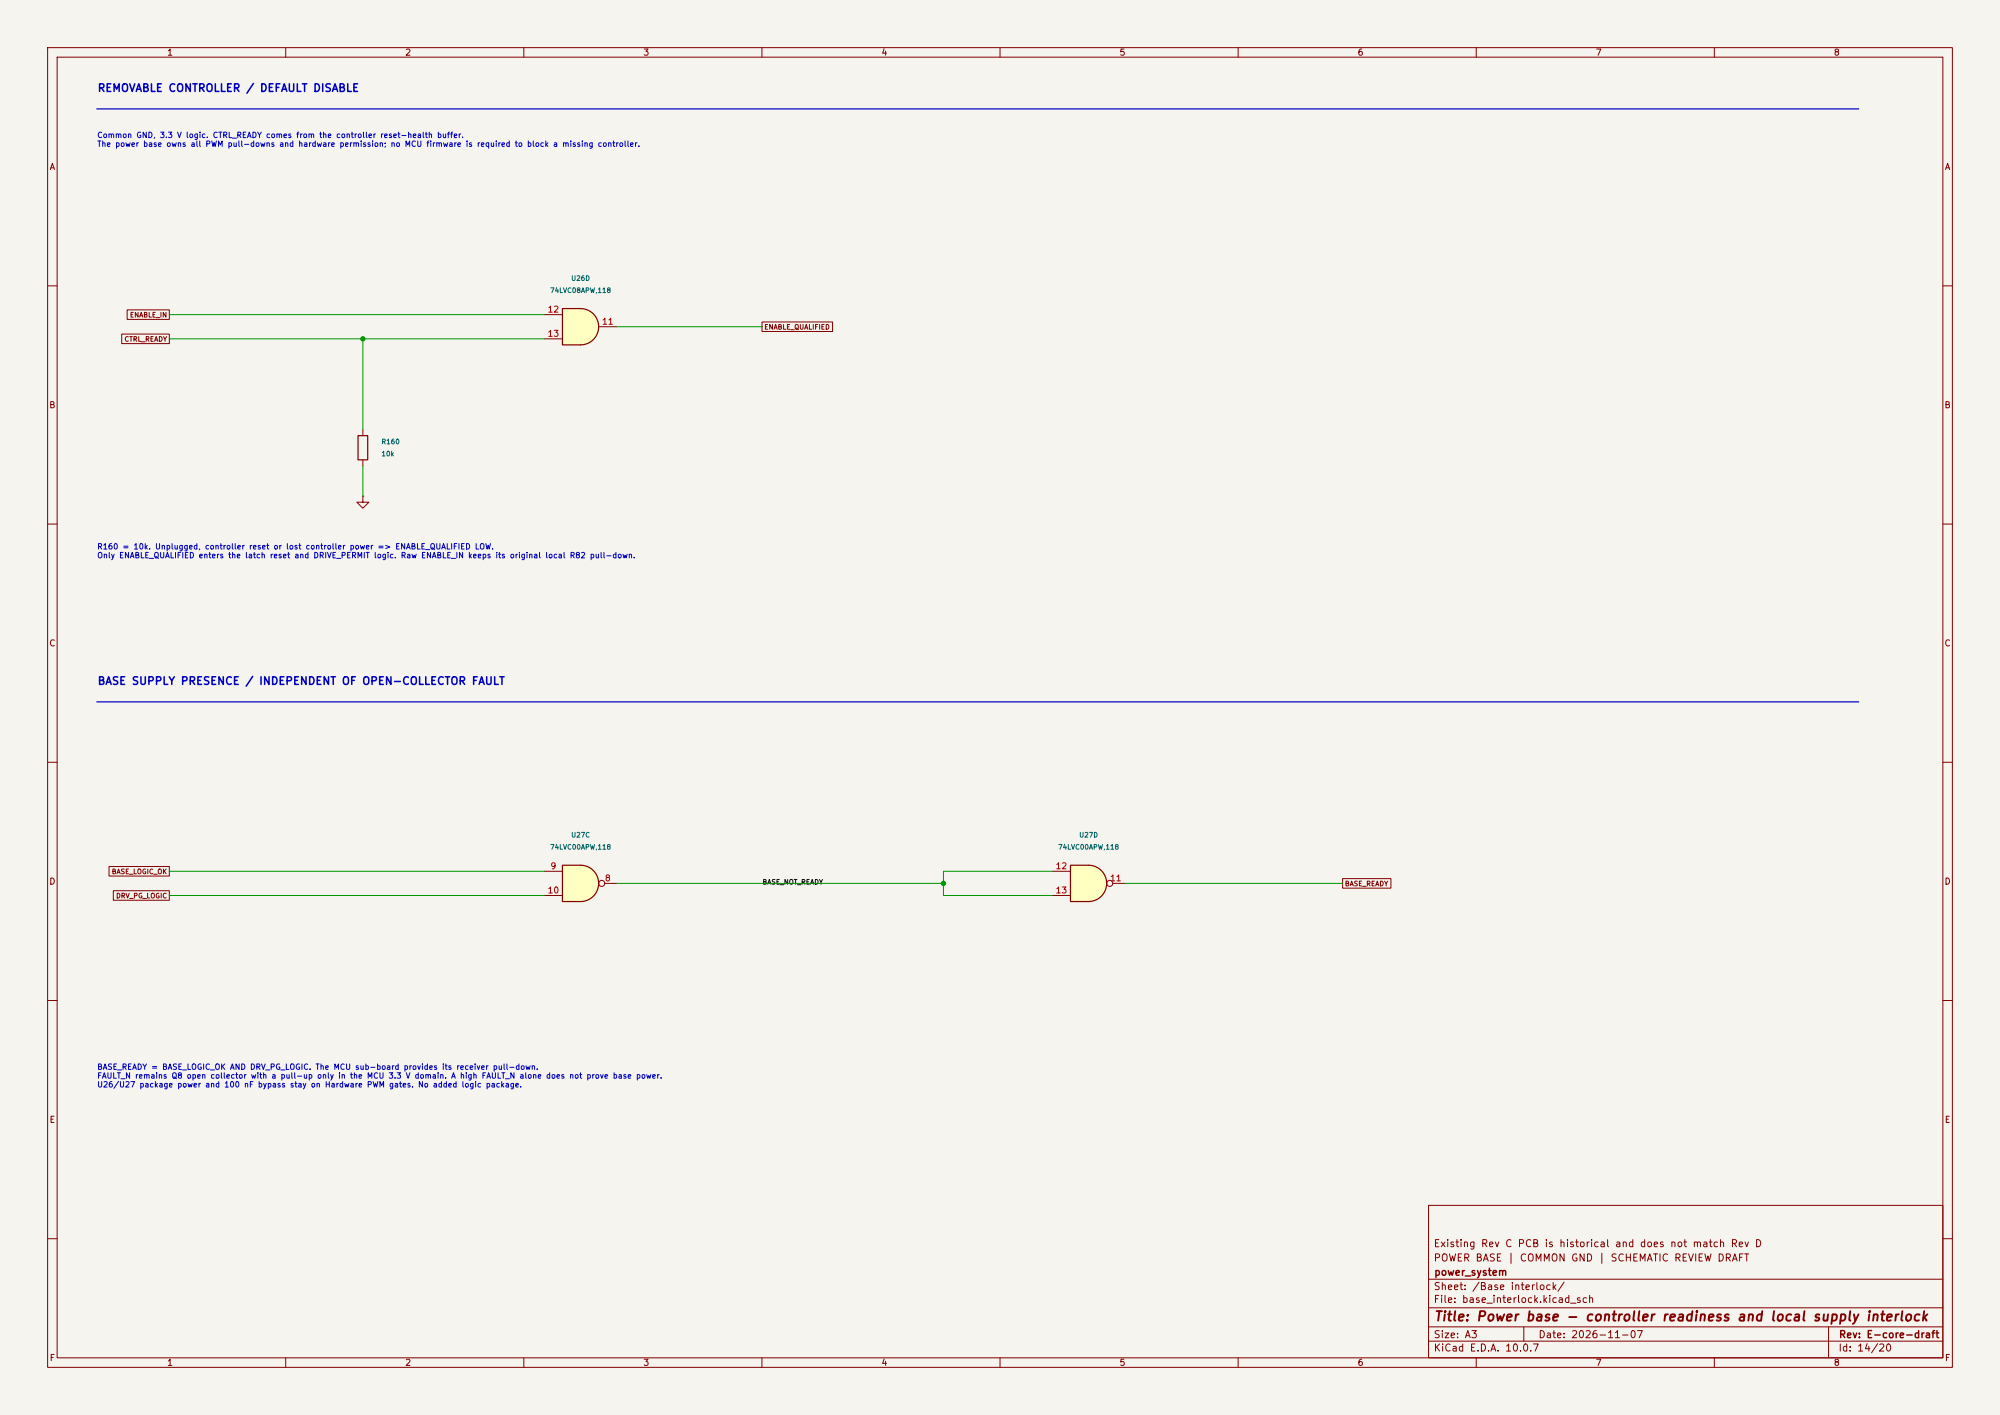
[picture p144: page 14]

REMOVABLE CONTROLLER / DEFAULT DISABLE

Common GND, 3.3 V logic. CTRL_READY comes from the controller reset-health buffer. The power base owns all PWM pull-downs and hardware permission; no MCU firmware is required to block a missing controller. R160 = 10k. Unplugged, controller reset or lost controller power => ENABLE_QUALIFIED LOW. Only ENABLE_QUALIFIED enters the latch reset and DRIVE_PERMIT logic. Raw ENABLE_IN keeps its original local R82 pull-down.

BASE SUPPLY PRESENCE / INDEPENDENT OF OPEN-COLLECTOR FAULT

BASE_READY = BASE_LOGIC_OK AND DRV_PG_LOGIC. The MCU sub-board provides its receiver pull-down. FAULT_N remains Q8 open collector with a pull-up only in the MCU 3.3 V domain. A high FAULT_N alone does not prove base power. U26/U27 package power and 100 nF bypass stay on Hardware PWM gates. No added logic package.

Existing Rev C PCB is historical and does not match Rev D
POWER BASE | COMMON GND | SCHEMATIC REVIEW DRAFT
power_system
Sheet: /Base interlock/
File: base_interlock.kicad_sch
Title: Power base - controller readiness and local supply interlock

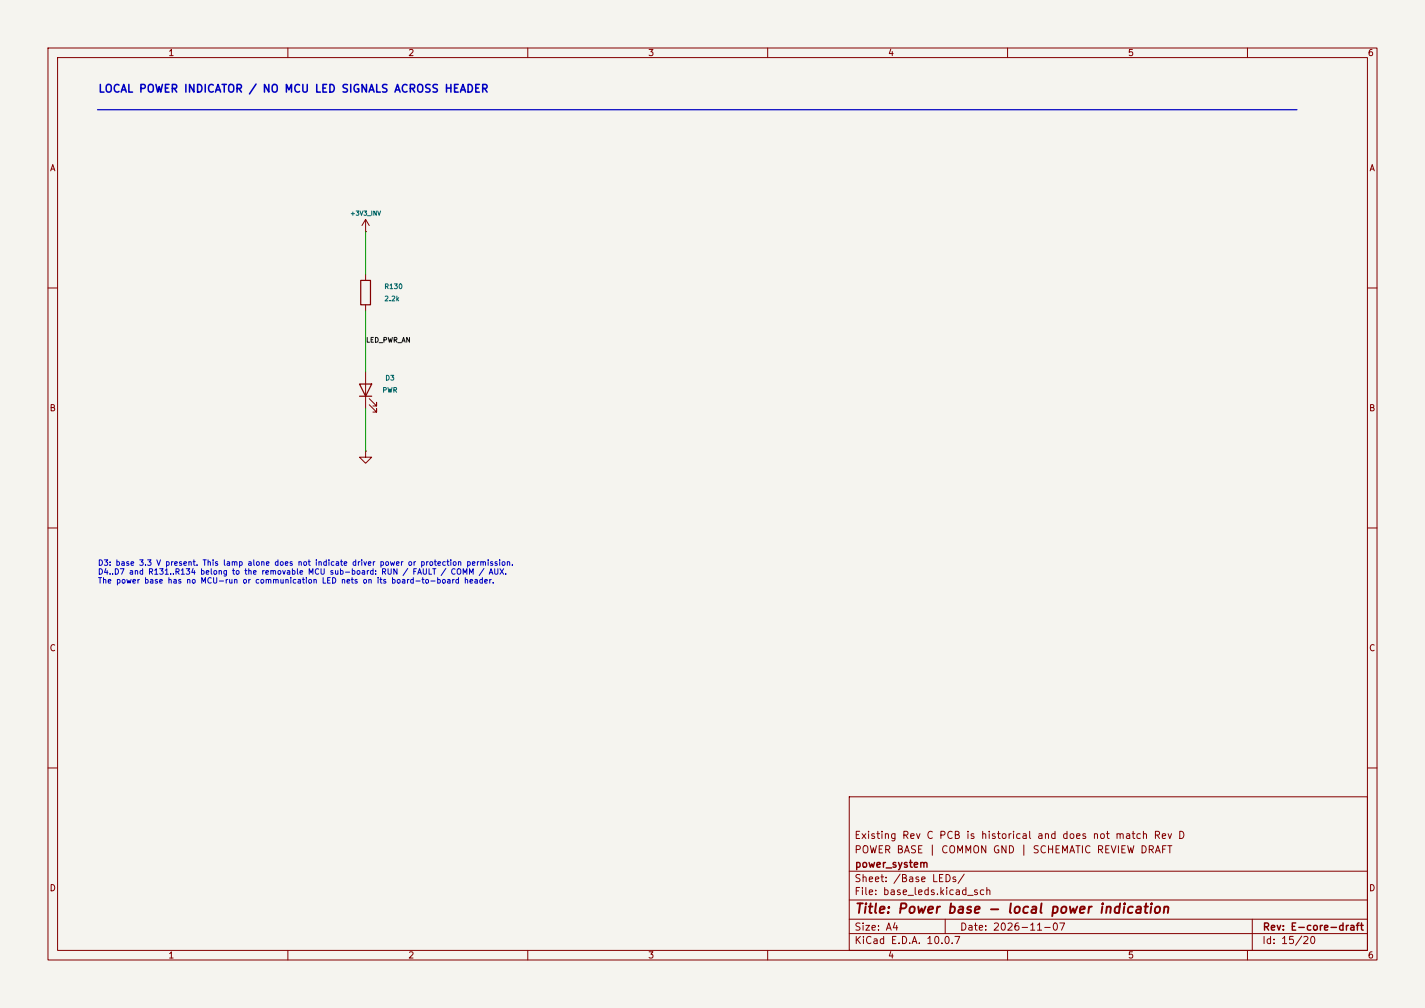
[picture p145: page 15]

LOCAL POWER INDICATOR / NO MCU LED SIGNALS ACROSS HEADER

LED_PWR_AN D3: base 3.3 V present. This lamp alone does not indicate driver power or protection permission. D4..D7 and R131..R134 belong to the removable MCU sub-board: RUN / FAULT / COMM / AUX. The power base has no MCU-run or communication LED nets on its board-to-board header.

Existing Rev C PCB is historical and does not match Rev D
POWER BASE | COMMON GND | SCHEMATIC REVIEW DRAFT
power_system
Sheet: /Base LEDs/
File: base_leds.kicad_sch
Title: Power base - local power indication

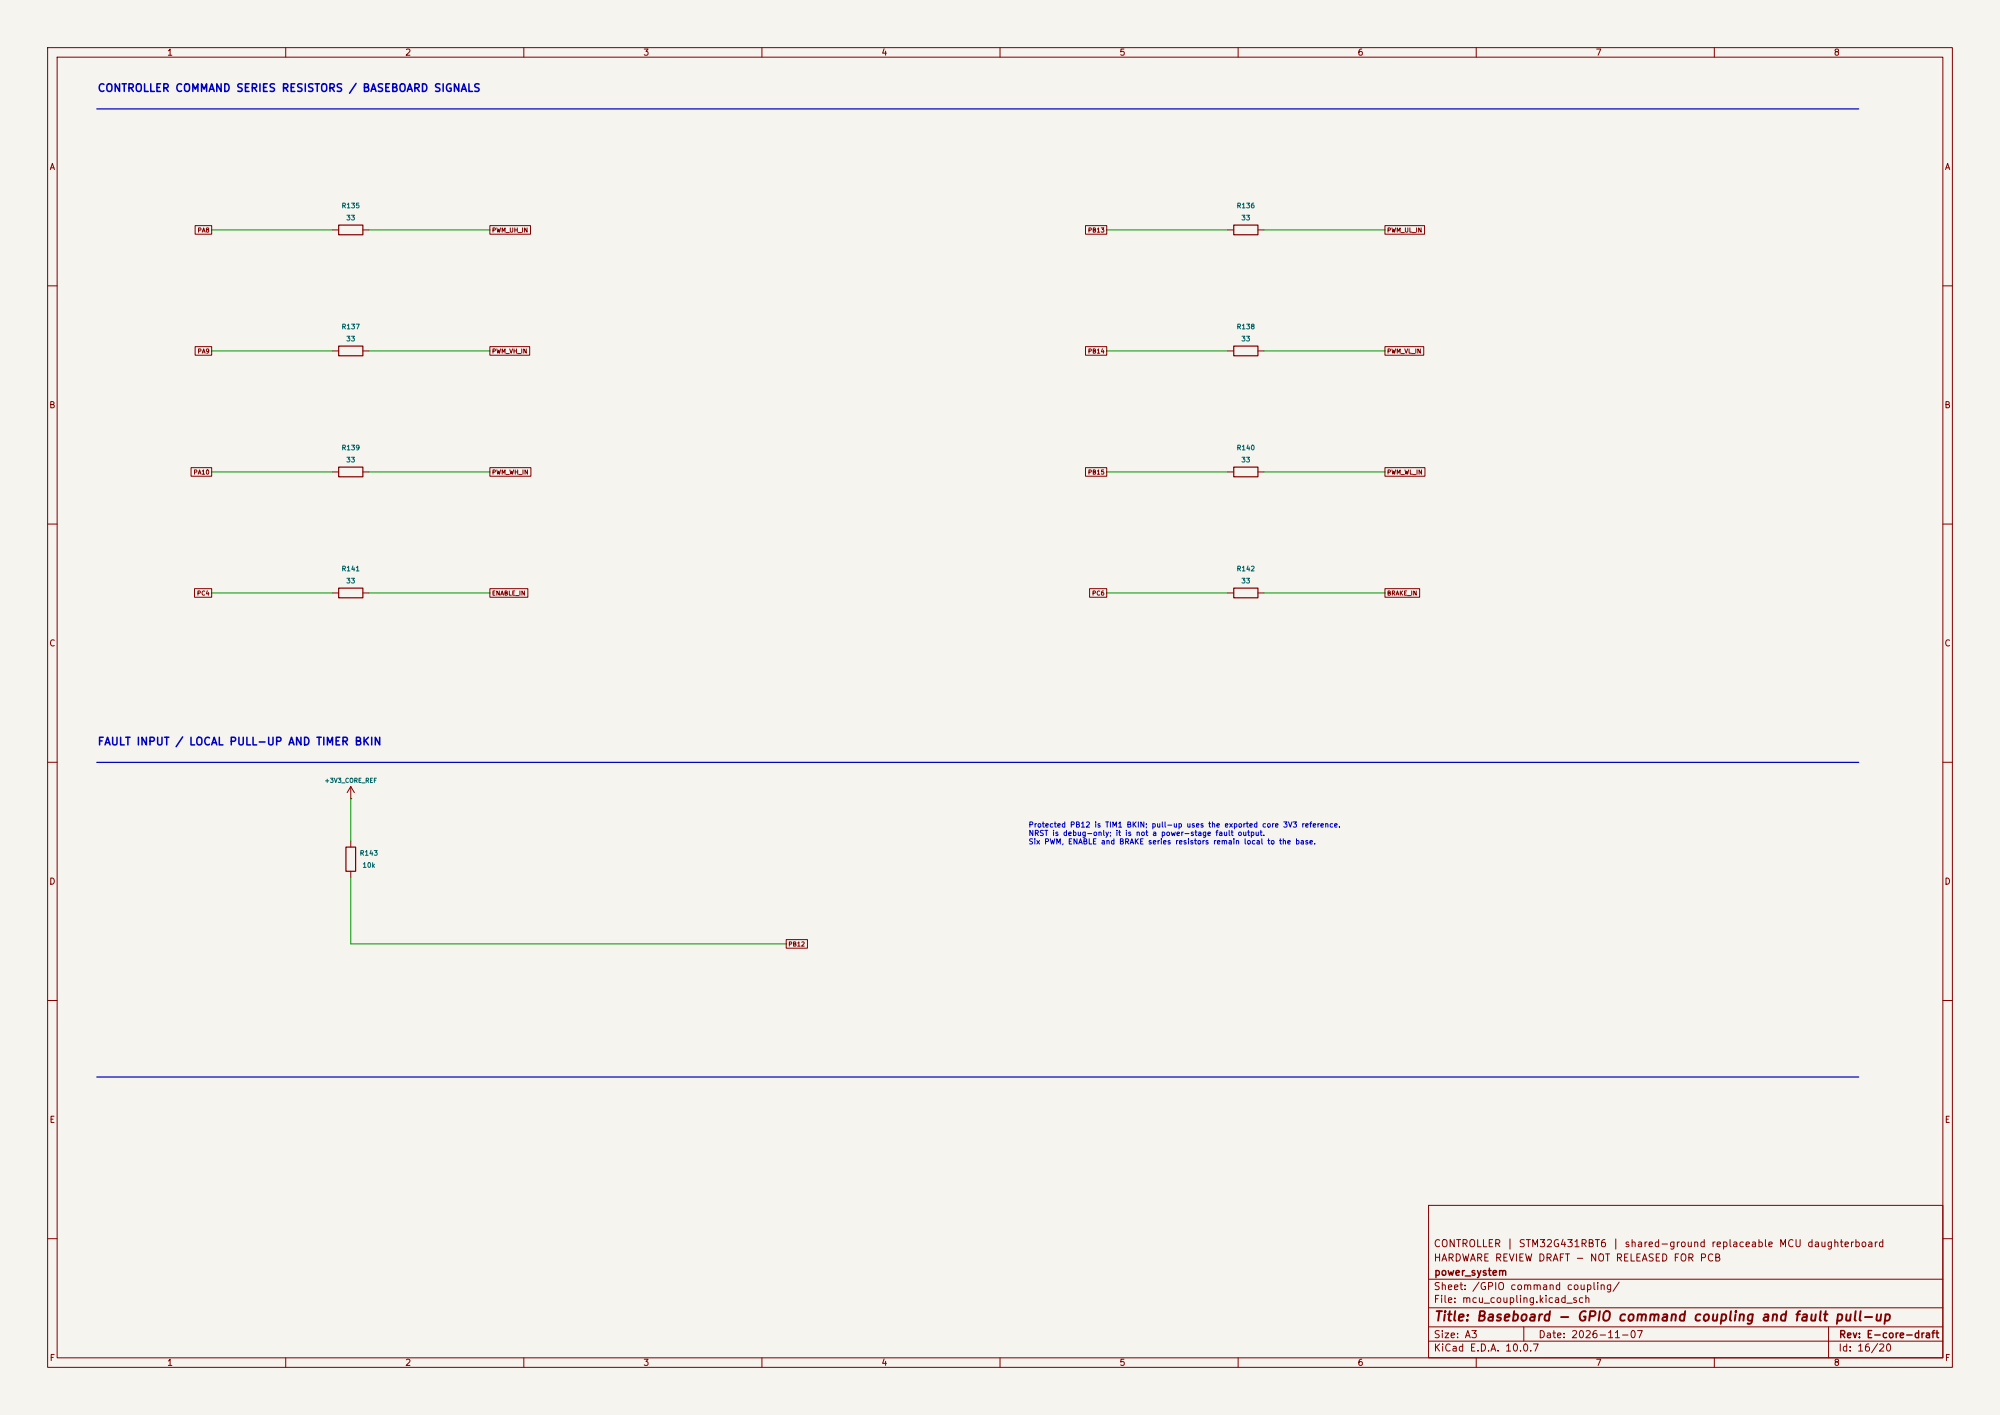
[picture p146: page 16]

PWM_UL_IN CONTROLLER COMMAND SERIES RESISTORS / BASEBOARD SIGNALS

Protected PB12 is TIM1 BKIN; pull-up uses the exported core 3V3 reference. NRST is debug-only; it is not a power-stage fault output. Six PWM, ENABLE and BRAKE series resistors remain local to the base. FAULT INPUT / LOCAL PULL-UP AND TIMER BKIN

CONTROLLER | STM32G431RBT6 | shared-ground replaceable MCU daughterboard
HARDWARE REVIEW DRAFT - NOT RELEASED FOR PCB
power_system
Sheet: /GPIO command coupling/
File: mcu_coupling.kicad_sch
Title: Baseboard - GPIO command coupling and fault pull-up

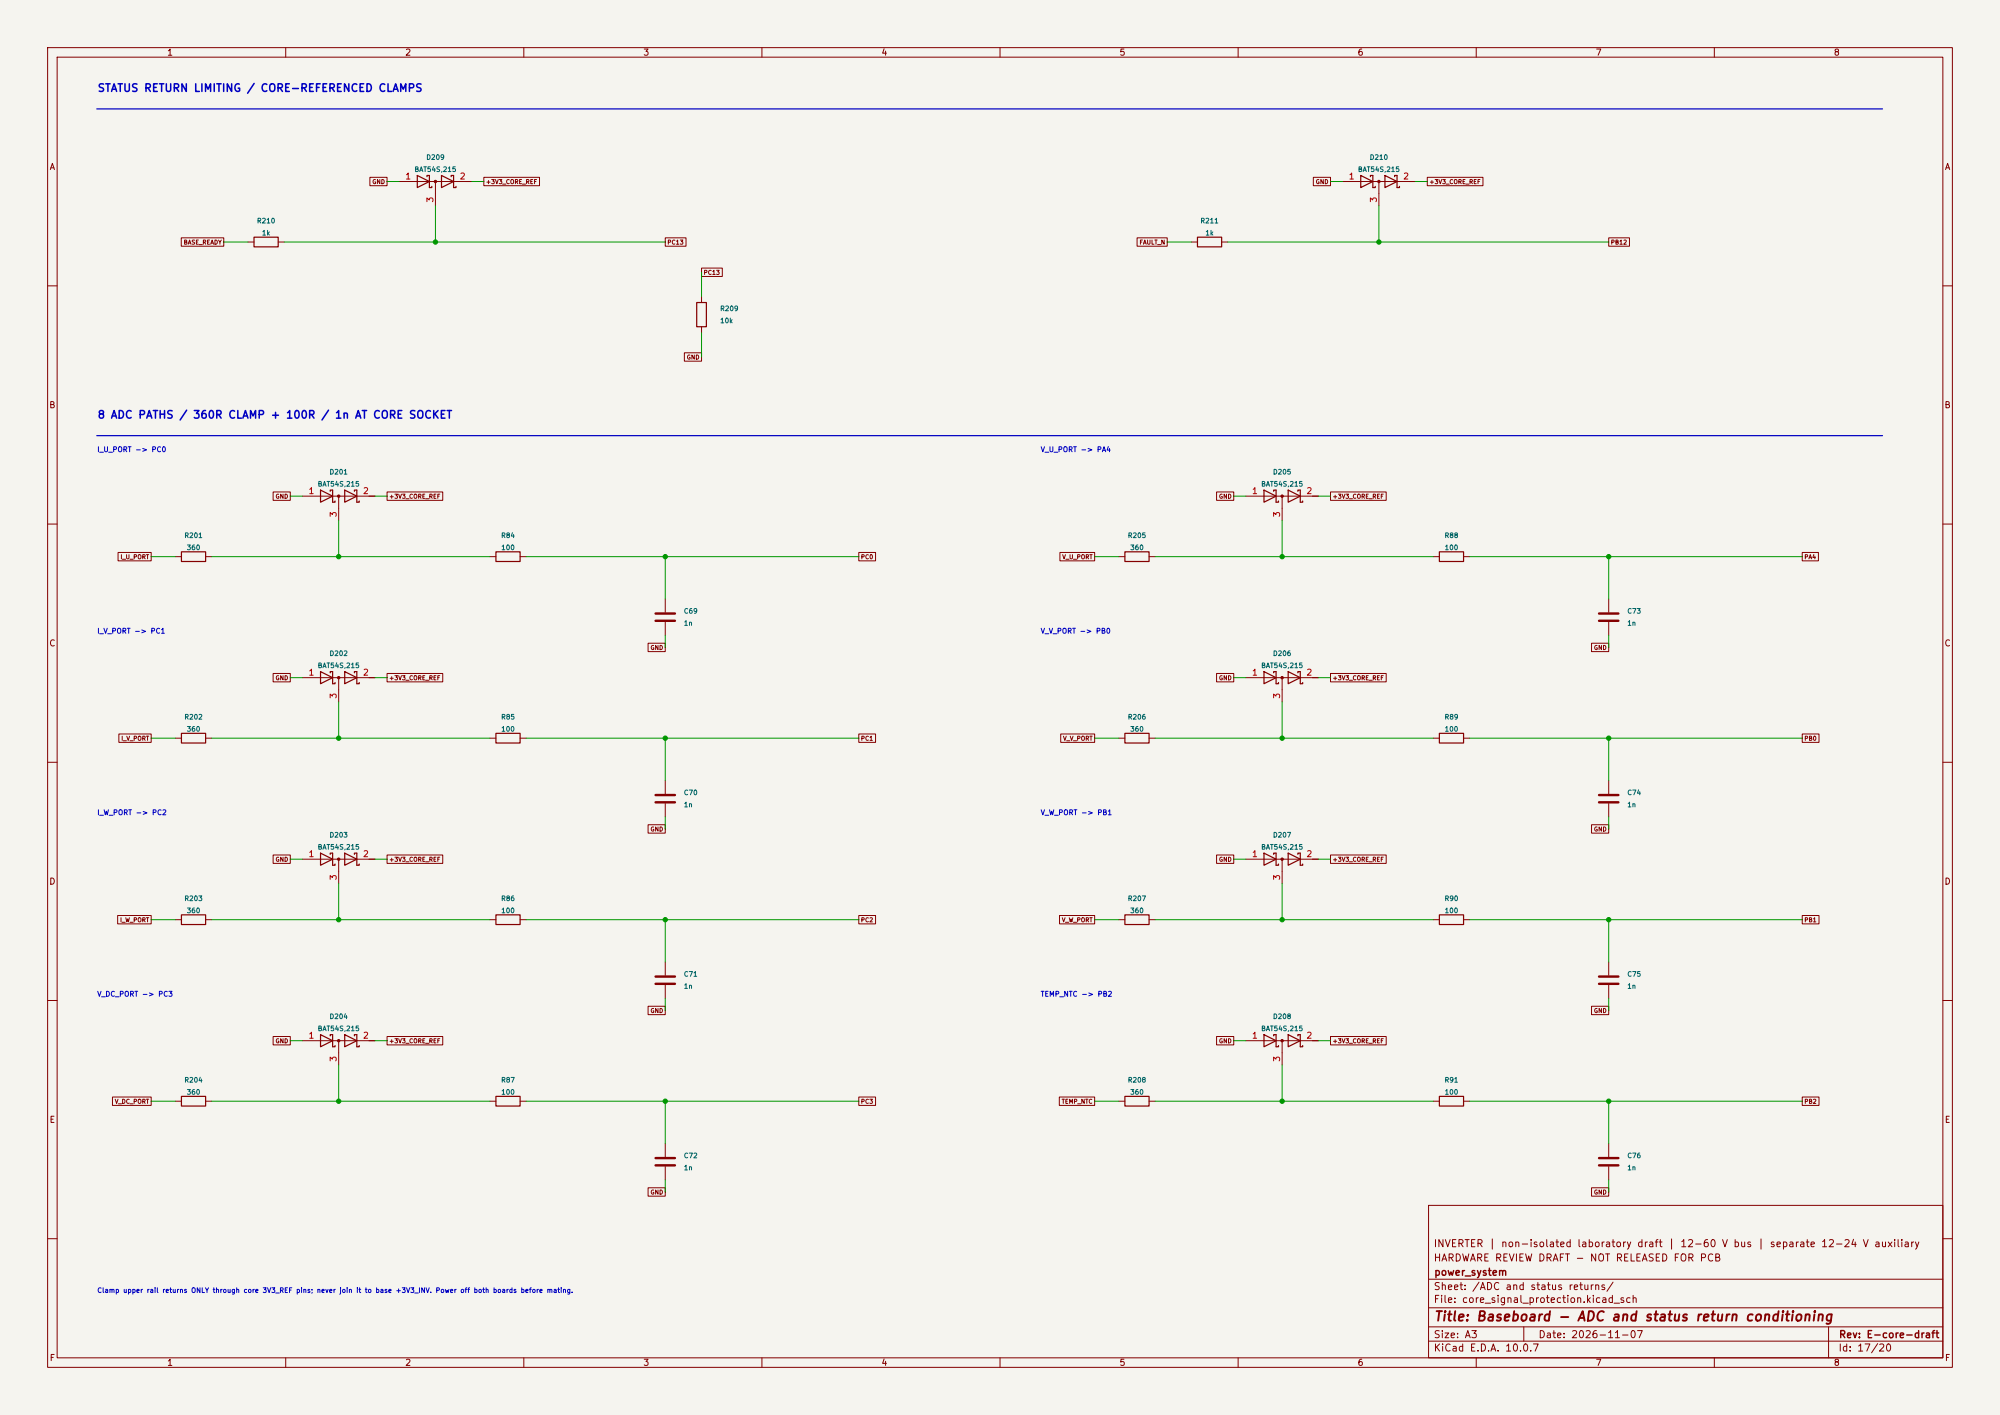
[picture p147: page 17]

V_U_PORT -> PA4 STATUS RETURN LIMITING / CORE-REFERENCED CLAMPS

8 ADC PATHS / 360R CLAMP + 100R / 1n AT CORE SOCKET

INVERTER | non-isolated laboratory draft | 12-60 V bus | separate 12-24 V auxiliary
HARDWARE REVIEW DRAFT - NOT RELEASED FOR PCB
power_system
Sheet: /ADC and status returns/
File: core_signal_protection.kicad_sch
Title: Baseboard - ADC and status return conditioning

Clamp upper rail returns ONLY through core 3V3_REF pins; never join it to base +3V3_INV. Power off both boards before mating.

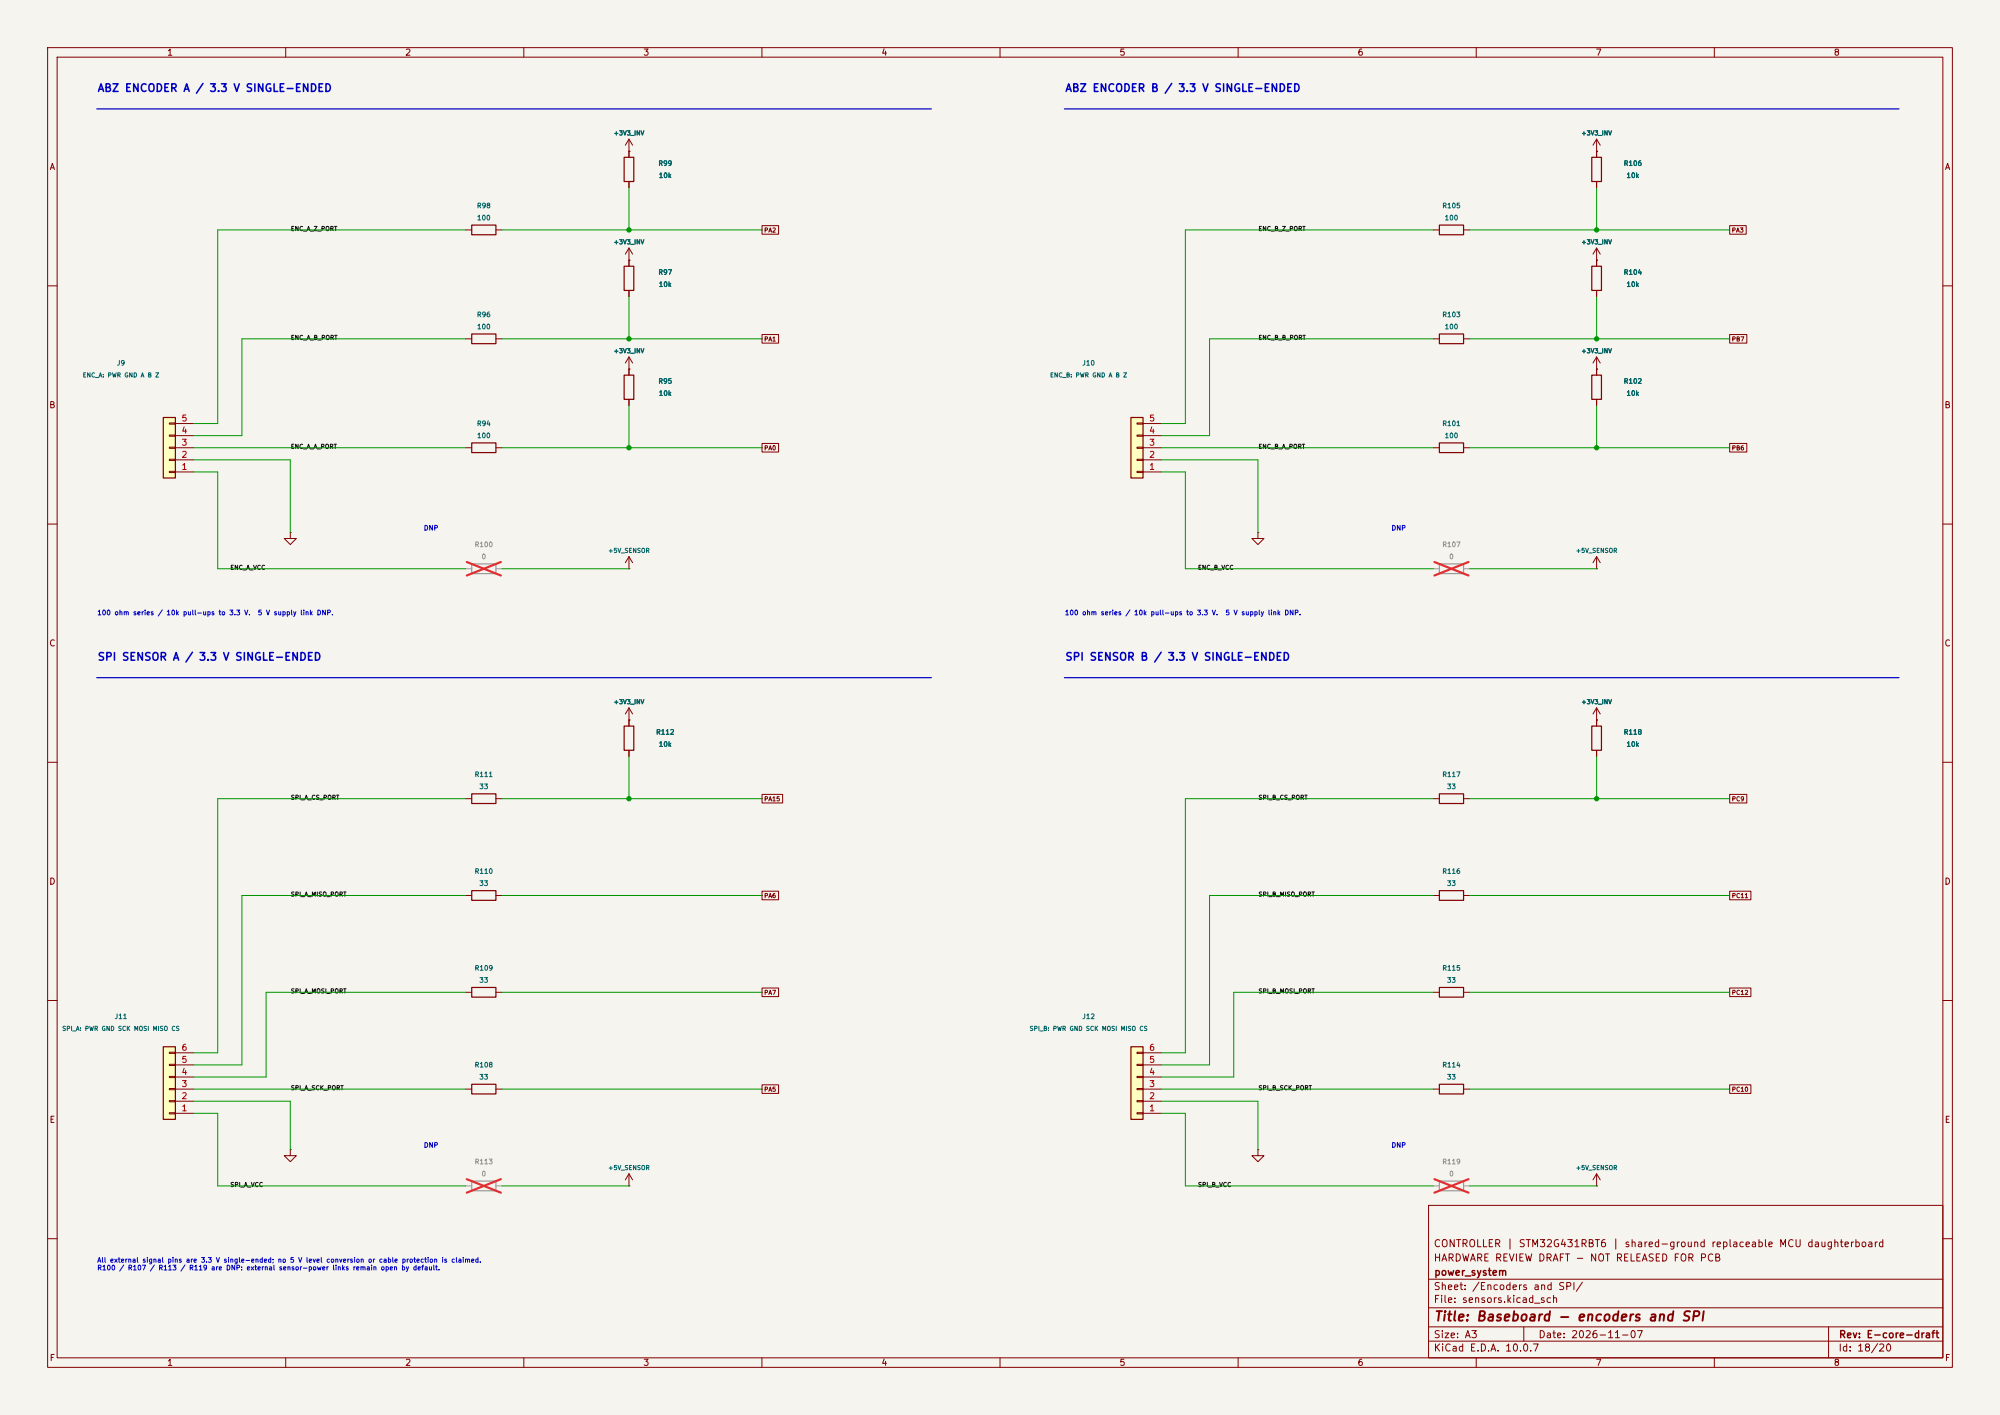
[picture p148: page 18]

ABZ ENCODER A / 3.3 V SINGLE-ENDED

SPI_B_MISO_PORT SPI_B_VCC DNP SPI SENSOR A / 3.3 V SINGLE-ENDED

CONTROLLER | STM32G431RBT6 | shared-ground replaceable MCU daughterboard
HARDWARE REVIEW DRAFT - NOT RELEASED FOR PCB
power_system
Sheet: /Encoders and SPI/
File: sensors.kicad_sch
Title: Baseboard - encoders and SPI

All external signal pins are 3.3 V single-ended; no 5 V level conversion or cable protection is claimed. R100 / R107 / R113 / R119 are DNP: external sensor-power links remain open by default.

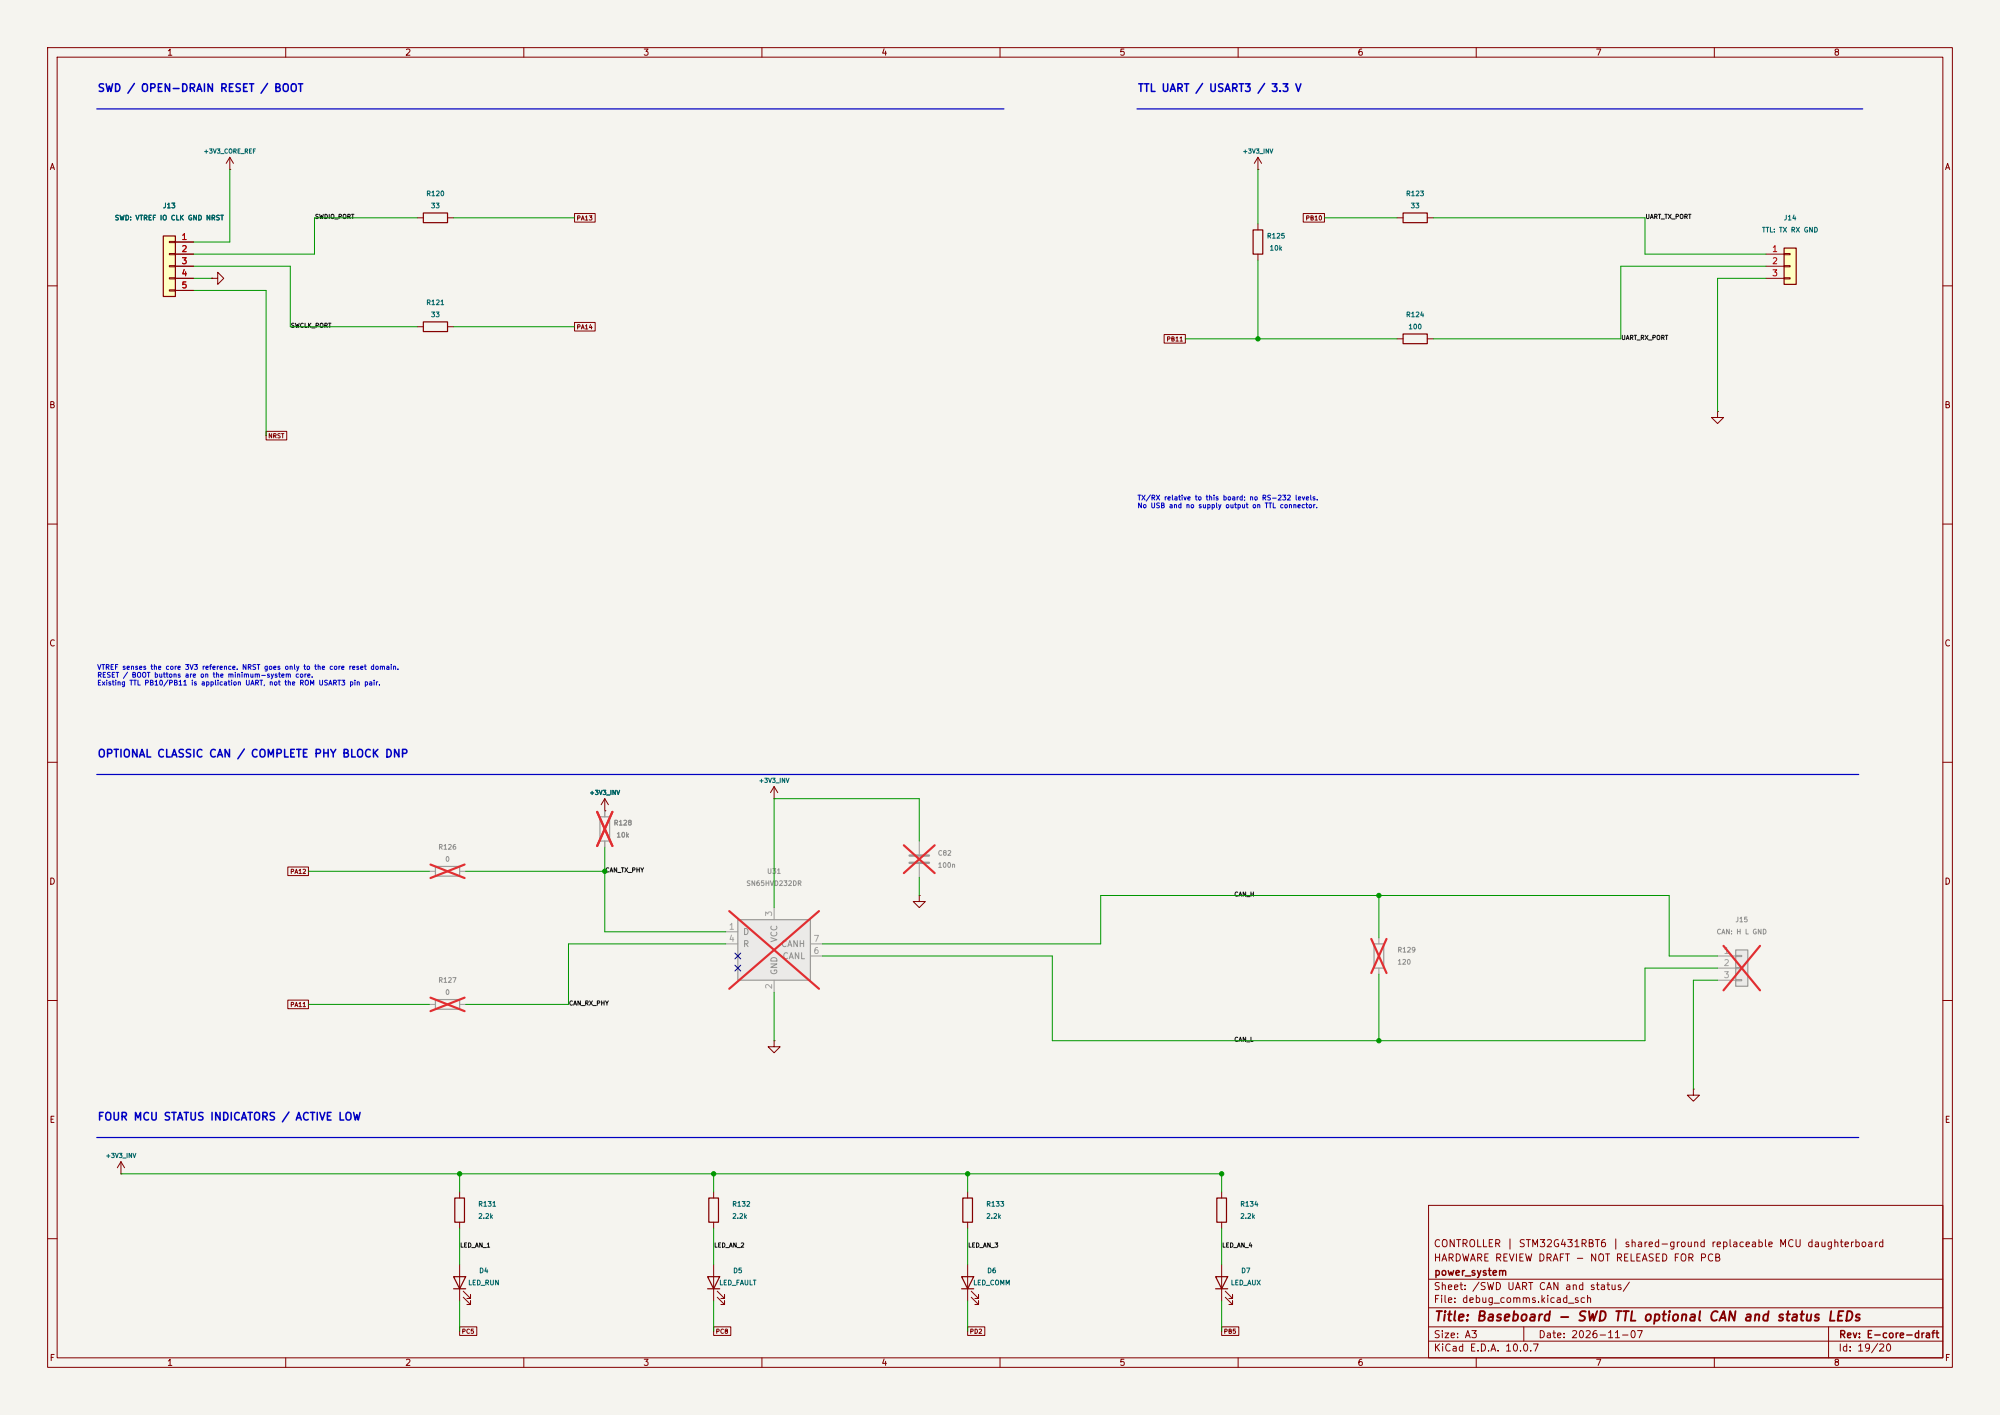
[picture p149: page 19]

SWD: VTREF IO CLK GND NRST 1

TTL: TX RX GND

TX/RX relative to this board; no RS-232 levels. No USB and no supply output on TTL connector. OPTIONAL CLASSIC CAN / COMPLETE PHY BLOCK DNP

VTREF senses the core 3V3 reference. NRST goes only to the core reset domain. RESET / BOOT buttons are on the minimum-system core. Existing TTL PB10/PB11 is application UART, not the ROM USART3 pin pair.

CONTROLLER | STM32G431RBT6 | shared-ground replaceable MCU daughterboard
HARDWARE REVIEW DRAFT - NOT RELEASED FOR PCB
power_system
Sheet: /SWD UART CAN and status/
File: debug_comms.kicad_sch
Title: Baseboard - SWD TTL optional CAN and status LEDs

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
## Title: Baseboard minimum-core sockets

File: power_interface.kicad_sch

Sheet: /64-pin core sockets/

power_system

HARDWARE REVIEW DRAFT - NOT RELEASED FOR PCB

INVERTER | non-isolated laboratory draft | 12-60 V bus | separate 12-24 V auxiliary
1 | 2
3 | 4
5 | 6
7 | 8
9 | 10
11 | 12
13 | 14
15 | 16
17 | 18
19 | 20
21 | 22
23 | 24
25 | 26
27 | 28
29 | 30
31 | 32

J101 PM254V-12-32-H85

#FLG950 PWR_FLAG

TP17

ENABLE_IN

TP16

FAULT_N

1 | 2
3 | 4
5 | 6
7 | 8
9 | 10
11 | 12
13 | 14
15 | 16
17 | 18
19 | 20
21 | 22
23 | 24
25 | 26
27 | 28
29 | 30
31 | 32

J102 PM254V-12-32-H85

PA2

FAULT_N

+5V_INV +5V_INV | GND
PA3 PA5 PA7 PA9 PA11 PA13 PA15 | PC3 PB1 +3V3_CORE_REF PA0 GND
PA4 PA6 | GND
PA1 | PB10 PB12 PB14 GND
PC0 PC2 PC8 PC10 PA8 PA10 PA12 PA14 PB0 | PC12 PB2 | GND

GND

PB11 PB13 PB6 | PB15 CTRL_READY PC1 PC5 PB5 | PC4 PB7 | PC6 | PC9 PC11 GND
PC13 +3V3_CORE_REF | PD2 NRST
ENABLE_IN | +3V3_CORE_REF

J101 / PA0-15 + PB0-7

64 contacts: 52 MCU signal pads + 2 core 5V feed + 2 core 3V3 reference + CTRL_READY + 7 GND. PC7 is RUN_ARM when plugged into this power base. CTRL_READY = Schmitt-reset-ok AND PC7; default LOW. Standalone core: regulated 4.75-5.25V at J101 pins1/3 and GND. Do not parallel independent 5V sources. 3V3 reference is core -> base clamps / fault pull-up / SWD sense only. Never parallel base and core regulators. All MCU GPIOs are exposed by port name. PG10 stays NRST; PF0/PF1 share optional HSE; PB8 shares BOOT. Application ABZ / SPI / UART / SWD / CAN / LEDs / ADC filters all reside on the power baseboard.

J102 / PB8-15 + PC0-15 + PD/PF/NRST

Nine unused socket contacts are NC on this base only; all corresponding GPIO pads remain exposed on the core. 60x60 POWER ABOVE / 60x60 CORE BELOW. Core TOP male -> power BOTTOM socket. Board gap / thermal / button access pending PCB.
