leolei2012/power_system/docs/parts_to_complete_2026-11-10/library_missing.csv

编号,板卡,完整订货型号,立创编号,位号,装配数,DNP数,现用封装,补库进度,立创链接,链接范围,厂家,现有定义,DNP位号,逐位号要求,规格书来源,工程来源
L01,controller,T491B476K010AT,C116617,C305,1,0,Capacitor_Tantalum_SMD:CP_EIA-3528-21_Kemet-B,待补,https://item.szlcsc.com/117871.html,国内商品页；已核对,KEMET,工程已有符号及官方封装,,C305: 47u 10% 10V；Populate. MnO2 tantalum bulk retains capacitance under bias. TL431 stability compensation | not interchangeable with a nominal MLCC without analysis.；原选型状态：project_draft,,controller/hardware/g431_core/bom/bom.csv | refs=C305
L02,controller,SMF6.0A-TP,C914434,D101,1,0,Diode_SMD:D_SOD-123F,待补,https://item.szlcsc.com/985114.html,国内商品页；正文受限,MCC,工程已有符号及官方封装,,D101: SMF6.0A-TP；原选型状态：project_draft | manufacturer pin map checked | no hardware validation,https://datasheet.lcsc.com/datasheet/pdf/3fdd4d54224eceb5fff57c8ce808199a.pdf | refs=D101
L03,controller,S1A-13-F,C150735,D102,1,0,Diode_SMD:D_SMA,待补,https://item.szlcsc.com/162075.html,国内商品页；正文受限,Diodes Incorporated,工程已有符号及官方封装,,D102: S1A-13-F；原选型状态：project_draft | manufacturer pin map checked | no hardware validation,https://www.diodes.com/datasheet/download/S1M.pdf,controller/hardware/g431_core/bom/bom.csv | refs=D102
L04,controller,"PMEG2010ER,115",C82288,D103,1,0,Diode_SMD:Nexperia_CFP3_SOD-123W,待补,https://item.szlcsc.com/83445.html,国内商品页；已核对,Nexperia,工程已有符号及官方封装,,"D103: PMEG2010ER,115；原选型状态：project_draft | manufacturer pin map checked | no hardware validation",https://assets.nexperia.com/documents/data-sheet/PMEG2010ER.pdf,controller/hardware/g431_core/bom/bom.csv | refs=D103
L05,controller,RT0603BRD073K83L,C861384,R302,1,0,Resistor_SMD:R_0603_1608Metric,待补,https://item.szlcsc.com/921722.html,国内商品页；已核对,YAGEO,工程已有符号及官方封装,,R302: 3.83k 0.1%；原选型状态：project_draft,,controller/hardware/g431_core/bom/bom.csv | refs=R302
L06,controller,RT0603BRD0710KL,C95204,R303,1,0,Resistor_SMD:R_0603_1608Metric,待补,https://item.szlcsc.com/96405.html,国内商品页；已核对,YAGEO,工程已有符号及官方封装,,R303: 10k 0.1%；原选型状态：project_draft,,controller/hardware/g431_core/bom/bom.csv | refs=R303
L07,controller,SN74LVC1G17DBVR,C7836,U103,1,0,Package_TO_SOT_SMD:SOT-23-5,待补,https://item.szlcsc.com/8313.html,国内商品页；已核对,Texas Instruments,工程已有符号及官方封装,,U103: SN74LVC1G17DBVR；原选型状态：project_draft | manufacturer pin map checked | no hardware validation,https://www.ti.com/lit/ds/symlink/sn74lvc1g17.pdf,controller/hardware/g431_core/bom/bom.csv | refs=U103
L08,controller,TL431BIDBZR,C41283,U104,1,0,Package_TO_SOT_SMD:SOT-23,待补,https://item.szlcsc.com/42267.html,国内商品页；已核对,Texas Instruments,工程已有符号及官方封装,,U104: TL431BIDBZR；原选型状态：project_draft | manufacturer pin map checked | no hardware validation,https://www.ti.com/lit/ds/symlink/tl431.pdf,controller/hardware/g431_core/bom/bom.csv | refs=U104
L09,controller,SN74LVC1G08DBVR,C7666,U105,1,0,Package_TO_SOT_SMD:SOT-23-5,待补,https://item.szlcsc.com/8143.html,国内商品页；已核对,TI,工程已有符号及官方封装,,U105: SN74LVC1G08DBVR；Ioff AND after U103 Schmitt reset buffer | PC7 held LOW unless application explicitly arms.,https://www.ti.com/lit/ds/symlink/sn74lvc1g08.pdf,controller/hardware/g431_core/bom/bom.csv | refs=U105
L10,inverter,MBRD20150CT-13,C151357,D1,1,0,Package_TO_SOT_SMD:TO-252-3_TabPin2,待补,https://item.szlcsc.com/162697.html,国内商品页；已核对,Diodes,工程已有符号及官方封装,,"D1: MBRD20150CT-13；原选型状态：60mm input series-diode candidate | 1/3 A,2 K/tab visually checked Rev4-2 p1 | thermal and production variant pending",https://www.diodes.com/datasheet/download/MBRD20150CT.pdf,inverter/hardware/bom/bom.csv | refs=D1
L11,inverter,"BAT54S,215",C47546,D201 D202 D203 D204 D205 D206 D207 D208 D209 D210,10,0,Package_TO_SOT_SMD:SOT-23,待补,https://item.szlcsc.com/48551.html,国内商品页；已核对,Nexperia,工程已有符号及官方封装,,"D201: BAT54S,215；DS 2022-07-01: pin1=A1 GND | pin2=K2 3V3_MCU | pin3=K1/A2 clamped signal. Basic transient clamps, no galvanic isolation.
D202: BAT54S,215；DS 2022-07-01: pin1=A1 GND | pin2=K2 3V3_MCU | pin3=K1/A2 clamped signal. Basic transient clamps, no galvanic isolation.
D203: BAT54S,215；DS 2022-07-01: pin1=A1 GND | pin2=K2 3V3_MCU | pin3=K1/A2 clamped signal. Basic transient clamps, no galvanic isolation.
D204: BAT54S,215；DS 2022-07-01: pin1=A1 GND | pin2=K2 3V3_MCU | pin3=K1/A2 clamped signal. Basic transient clamps, no galvanic isolation.
D205: BAT54S,215；DS 2022-07-01: pin1=A1 GND | pin2=K2 3V3_MCU | pin3=K1/A2 clamped signal. Basic transient clamps, no galvanic isolation.
D206: BAT54S,215；DS 2022-07-01: pin1=A1 GND | pin2=K2 3V3_MCU | pin3=K1/A2 clamped signal. Basic transient clamps, no galvanic isolation.
D207: BAT54S,215；DS 2022-07-01: pin1=A1 GND | pin2=K2 3V3_MCU | pin3=K1/A2 clamped signal. Basic transient clamps, no galvanic isolation.
D208: BAT54S,215；DS 2022-07-01: pin1=A1 GND | pin2=K2 3V3_MCU | pin3=K1/A2 clamped signal. Basic transient clamps, no galvanic isolation.
D209: BAT54S,215；1 GND,2 3V3_MCU,3 protected return status. Fault pullup remains on the protected MCU side.
D210: BAT54S,215；1 GND,2 3V3_MCU,3 protected return status. Fault pullup remains on the protected MCU side.",https://assets.nexperia.com/documents/data-sheet/BAT54S.pdf,inverter/hardware/bom/bom.csv | refs=D201 D202 D203 D204 D205 D206 D207 D208 D209 D210
L12,inverter,0476015.MRSN,C3165851,F1,1,0,Fuse:Fuse_Littelfuse-NANO2-451_453,待补,https://item.szlcsc.com/3727788.html,国内商品页；正文受限,Littelfuse,工程已有符号及官方封装,,F1: 0476015.MRSN；原选型状态：Exact 15 A / 125 V DC / 2410 candidate | electrical coordination and hot-board derating pending.,https://www.littelfuse.com/assetdocs/littelfuse-fuse-476-datasheet | refs=F1
L13,inverter,0451002.MRL,C99547,F2,1,0,Fuse:Fuse_Littelfuse-NANO2-451_453,待补,https://item.szlcsc.com/100761.html,国内商品页；已核对,Littelfuse,工程已有符号及官方封装,,"F2: 0451002.MRL；原选型状态：Exact 2 A candidate fits current Nano2 451/453 footprint | converter inrush, short-circuit coordination and ambient derating remain application checks.",https://www.littelfuse.com/assetdocs/fuse-451-and-453-datasheet | refs=F2
L14,inverter,B2B-PH-K-S(LF)(SN),C131337,J2,1,0,Connector_JST:JST_PH_B2B-PH-K_1x02_P2.00mm_Vertical,待补,https://item.szlcsc.com/142630.html,国内商品页；已核对,JST,工程已有符号及官方封装,,J2: AUX: +12..24V / GND；原选型状态：compact mechanical engineering candidate | original pin order retained,https://www.jst-mfg.com/product/pdf/jpn/PH.pdf,inverter/hardware/bom/bom.csv | refs=J2
L15,inverter,PZ127-1-02-Z,C5372825,J7 J8,1,1,Inverter_Compact:PinHeader_HCTL_PZ127_1x02_P1.27mm_D0.70mm,待补,https://item.szlcsc.com/6225189.html,国内商品页；正文受限,HCTL,项目 draft 符号及封装,J7,"J7: OPTIONAL SENSOR 5V / GND；原选型状态：compact mechanical engineering candidate | original pin order retained
J8: EXTERNAL 10k NTC；原选型状态：compact mechanical engineering candidate | original pin order retained",https://atta.szlcsc.com/upload/public/pdf/source/20240407/11460212CBFB9238DF6EEC00AAE28C4B.pdf,inverter/hardware/bom/bom.csv | refs=J7 J8
L16,inverter,PZ127-1-05-Z,C5372828,J9 J10 J13,3,0,Inverter_Compact:PinHeader_HCTL_PZ127_1x05_P1.27mm_D0.70mm,待补,https://item.szlcsc.com/6225192.html,国内商品页；正文受限,HCTL,项目 draft 符号及封装,,"J9: ENC_A: PWR GND A B Z；原选型状态：compact mechanical engineering candidate | original pin order retained
J10: ENC_B: PWR GND A B Z；原选型状态：compact mechanical engineering candidate | original pin order retained
J13: SWD: VTREF IO CLK GND NRST；原选型状态：compact mechanical engineering candidate | original pin order retained",https://atta.szlcsc.com/upload/public/pdf/source/20240407/11460212CBFB9238DF6EEC00AAE28C4B.pdf,inverter/hardware/bom/bom.csv | refs=J9 J10 J13
L17,inverter,PZ127-1-06-Z,C5372829,J11 J12,2,0,Inverter_Compact:PinHeader_HCTL_PZ127_1x06_P1.27mm_D0.70mm,待补,https://item.szlcsc.com/6225193.html,国内商品页；已核对,HCTL,项目 draft 符号及封装,,"J11: SPI_A: PWR GND SCK MOSI MISO CS；原选型状态：compact mechanical engineering candidate | original pin order retained
J12: SPI_B: PWR GND SCK MOSI MISO CS；原选型状态：compact mechanical engineering candidate | original pin order retained",https://atta.szlcsc.com/upload/public/pdf/source/20240407/11460212CBFB9238DF6EEC00AAE28C4B.pdf,inverter/hardware/bom/bom.csv | refs=J11 J12
L18,inverter,PZ127-1-03-Z,C5372826,J14 J15,1,1,Inverter_Compact:PinHeader_HCTL_PZ127_1x03_P1.27mm_D0.70mm,待补,https://item.szlcsc.com/6225190.html,国内商品页；正文受限,HCTL,项目 draft 符号及封装,J15,"J14: TTL: TX RX GND；原选型状态：compact mechanical engineering candidate | original pin order retained
J15: CAN: H L GND；原选型状态：compact mechanical engineering candidate | original pin order retained",https://atta.szlcsc.com/upload/public/pdf/source/20240407/11460212CBFB9238DF6EEC00AAE28C4B.pdf,inverter/hardware/bom/bom.csv | refs=J14 J15
L19,inverter,MWSA0603S-4R7MT,C408447,L1 L2,2,0,Inductor_SMD:L_Sunlord_MWSA0603S,待补,https://so.szlcsc.com/global.html?k=MWSA0603S-4R7MT,国内搜索；详情待核,Sunlord,工程已有符号及官方封装,,"L1: 4.7uH；原选型状态：Meets requested nominal L, current-table and DCR targets | auxiliary-converter operating/thermal qualification pending.
L2: 4.7uH；原选型状态：Meets requested nominal L, current-table and DCR targets | auxiliary-converter operating/thermal qualification pending.",https://www.sunlordinc.com/uploads/files/20230303/MWSA-S%C2%A0series%C2%A0of%C2%A0SMD%C2%A0Power%C2%A0Inductor.pdf,inverter/hardware/bom/bom.csv | refs=L1 L2
L20,inverter,BSC110N15NS5ATMA1,C412739,Q1 Q2 Q3 Q4 Q5 Q6 Q7,7,0,Inverter_Compact:BSC110N15NS5_TDSON8_8PhysicalPins,待补,https://item.szlcsc.com/404529.html,国内商品页；已核对,Infineon,项目 draft 符号及封装,,"Q1: BSC110N15NS5；原选型状态：60mm layout candidate | physical 1-3 S,4 G,5-8 D | thermal/pulse/EMI pending
Q2: BSC110N15NS5；原选型状态：60mm layout candidate | physical 1-3 S,4 G,5-8 D | thermal/pulse/EMI pending
Q3: BSC110N15NS5；原选型状态：60mm layout candidate | physical 1-3 S,4 G,5-8 D | thermal/pulse/EMI pending
Q4: BSC110N15NS5；原选型状态：60mm layout candidate | physical 1-3 S,4 G,5-8 D | thermal/pulse/EMI pending
Q5: BSC110N15NS5；原选型状态：60mm layout candidate | physical 1-3 S,4 G,5-8 D | thermal/pulse/EMI pending
Q6: BSC110N15NS5；原选型状态：60mm layout candidate | physical 1-3 S,4 G,5-8 D | thermal/pulse/EMI pending
Q7: BSC110N15NS5；原选型状态：60mm layout candidate | physical 1-3 S,4 G,5-8 D | thermal/pulse/EMI pending",https://www.infineon.com/assets/row/public/documents/24/49/infineon-bsc110n15ns5-datasheet-en.pdf,inverter/hardware/bom/bom.csv | refs=Q1 Q2 Q3 Q4 Q5 Q6 Q7
L21,inverter,TS-1088-AR02016,C720477,SW1,1,0,Button_Switch_SMD:SW_SPST_TS-1088-xR020,待补,https://item.szlcsc.com/763484.html,国内商品页；已核对,XUNPU,工程已有符号及官方封装,,SW1: AUX_RESET；原选型状态：Exact small SMD normally-open momentary 2-terminal switch | standard local footprint matches current manufacturer drawing. SW1 bias condition below remains an electrical-review hold point.,https://datasheet.lcsc.com/datasheet/pdf/0475ac02febf455ca9ddcfb380b0df0d.pdf?productCode=C720477,inverter/hardware/bom/bom.csv | refs=SW1
