leolei2012/power_system/docs/parts_to_complete_2026-11-10/selection_pending.csv

编号 | 板卡 | 类别 | 现有数值 | 现用封装 | 额定电压记录 | 公差记录 | 厂家要求 | 装配数 | DNP数 | 补充完整型号 | 补充立创编号 | 补充采购链接 | 选型进度 | 位号 | DNP位号 | 待补参数 | 逐位号要求 | 已有候选记录 | 候选链接 | 工程来源
S01 | controller | 晶振 | 8MHz / CL TBD / DNP | Crystal:Crystal_SMD_3225-4Pin_3.2x2.5mm | 未填写 | 未填写 | 待定 | 0 | 1 |  |  |  | 待选 | Y1 | Y1 | 完整型号、立创C编号、采购链接、CL、ESR、驱动等级、管脚定义及启动条件 | 可选HSE，默认DNP；当前1/3脚为振荡端，2/4脚接地，需核实际晶体定义。 |  |  | controller/hardware/g431_core/bom/selection_pending.csv; refs=Y1
S02 | controller | 电容 | 100n | Capacitor_SMD:C_0402_1005Metric | 16 V minimum | 未填写 | YAGEO | 8 | 0 |  |  |  | 待选 | C63 C64 C65 C66 C67 C77 C79 C81 |  | 完整型号、立创C编号、采购链接、介质、容差、偏压下有效容量 | C63: Place at U30 pin 16; return locally to VSS C64: Place at U30 pin 32; return locally to VSS C65: Place at U30 pin 48; return locally to VSS C66: Place at U30 pin 64; return locally to VSS C67: Place at U30 pin 1; return locally to VSS C81: NRST; TPS3808 and reset button/SWD share open-drain reset domain |  |  | controller/hardware/g431_core/bom/selection_pending.csv; refs=C63 C64 C65 C66 C67 C77 C79 C81
S03 | controller | 电容 | 18p / provisional | Capacitor_SMD:C_0402_1005Metric | 16 V minimum | 未填写 | YAGEO | 0 | 2 |  |  |  | 待选 | C83 C84 | C83 C84 | 完整型号、立创C编号、采购链接、介质、容差、偏压下有效容量 | C83 C84: DNP; select from actual crystal CL and PCB stray capacitance 18p仅占位，按Y1实际CL及PCB杂散重算，暂不按18p直接采购。 |  |  | controller/hardware/g431_core/bom/selection_pending.csv; refs=C83 C84
S04 | controller | 电容 | 100n | Capacitor_SMD:C_0603_1608Metric | 16V | 未填写 | YAGEO | 4 | 0 |  |  |  | 待选 | C304 C306 C307 C308 |  | 完整型号、立创C编号、采购链接、介质、容差、偏压下有效容量 |  | 共享库已有 draft：YAGEO CC0603KRX7R9BB104 / C14663，100nF 50V ±10% X7R；须核用途并完成库审核，原理图仍TBD，无须重复创建条目 | https://item.szlcsc.com/15331.html | controller/hardware/g431_core/bom/selection_pending.csv; refs=C304 C306 C307 C308
S05 | controller | 电容 | 1u | Capacitor_SMD:C_0603_1608Metric | 16 V minimum | 未填写 | YAGEO | 2 | 0 |  |  |  | 待选 | C78 C80 |  | 完整型号、立创C编号、采购链接、介质、容差、偏压下有效容量 |  |  |  | controller/hardware/g431_core/bom/selection_pending.csv; refs=C78 C80
S06 | controller | 电容 | 4.7u | Capacitor_SMD:C_0603_1608Metric | 16 V minimum | 未填写 | YAGEO | 1 | 0 |  |  |  | 待选 | C68 |  | 完整型号、立创C编号、采购链接、介质、容差、偏压下有效容量 |  |  |  | controller/hardware/g431_core/bom/selection_pending.csv; refs=C68
S07 | controller | 电容 | 4.7u | Capacitor_SMD:C_0805_2012Metric | 16V | 未填写 | YAGEO | 1 | 0 |  |  |  | 待选 | C303 |  | 完整型号、立创C编号、采购链接、介质、容差、偏压下有效容量 | C303: Effective >=2.2uF at 3.3V; U101 OUT capacitor |  |  | controller/hardware/g431_core/bom/selection_pending.csv; refs=C303
S08 | controller | 电容 | 4.7u | Capacitor_SMD:C_0805_2012Metric | 25V | 未填写 | YAGEO | 2 | 0 |  |  |  | 待选 | C301 C302 |  | 完整型号、立创C编号、采购链接、介质、容差、偏压下有效容量 | C301: Effective >=2.2uF at 5.25V; protected 5V input decoupling C302: Effective >=2.2uF at 5.25V; directly adjacent U101 IN/GND |  |  | controller/hardware/g431_core/bom/selection_pending.csv; refs=C301 C302
S09 | controller | 电阻 | 0 | Resistor_SMD:R_0402_1005Metric | 未填写 | 1% | YAGEO | 2 | 0 |  |  |  | 待选 | R92 R93 |  | 完整型号、立创C编号、采购链接、功率及额定工作电压核对 | R92: Default 0R; no unvalidated ferrite LC inserted R93: External VREF supply; VREFBUF disabled |  |  | controller/hardware/g431_core/bom/selection_pending.csv; refs=R92 R93
S10 | controller | 电阻 | 10k | Resistor_SMD:R_0402_1005Metric | 未填写 | 1% | YAGEO | 1 | 0 |  |  |  | 待选 | R122 |  | 完整型号、立创C编号、采购链接、功率及额定工作电压核对 |  |  |  | controller/hardware/g431_core/bom/selection_pending.csv; refs=R122
S11 | controller | 电阻 | 1.1k | Resistor_SMD:R_0603_1608Metric | 未填写 | 1% | YAGEO | 1 | 0 |  |  |  | 待选 | R305 |  | 完整型号、立创C编号、采购链接、功率及额定工作电压核对 |  |  |  | controller/hardware/g431_core/bom/selection_pending.csv; refs=R305
S12 | controller | 电阻 | 10k | Resistor_SMD:R_0603_1608Metric | 未填写 | 1% | YAGEO | 2 | 0 |  |  |  | 待选 | R306 R402 |  | 完整型号、立创C编号、采购链接、功率及额定工作电压核对 | R402: Local RUN_ARM pull-down. Inverter application reserves PC7; ROM bootloader leaves it undriven. |  |  | controller/hardware/g431_core/bom/selection_pending.csv; refs=R306 R402
S13 | controller | 电阻 | 1k | Resistor_SMD:R_0603_1608Metric | 未填写 | 1% | YAGEO | 2 | 0 |  |  |  | 待选 | R304 R401 |  | 完整型号、立创C编号、采购链接、功率及额定工作电压核对 | R401: BOOT button limiting; PB8 remains an exposed GPIO-capable pad. |  |  | controller/hardware/g431_core/bom/selection_pending.csv; refs=R304 R401
S14 | controller | 电阻 | 0.47 | Resistor_SMD:R_0805_2012Metric | 未填写 | 1% | YAGEO | 1 | 0 |  |  |  | 待选 | R301 |  | 完整型号、立创C编号、采购链接、功率及额定工作电压核对 | R301: Damped input filter; not a surge-rated fuse | 仅文档候选：YAGEO RL0805FR-070R47L / C705493；当前原理图仍TBD | https://item.szlcsc.com/742063.html | controller/hardware/g431_core/bom/selection_pending.csv; refs=R301
S15 | inverter | LED | LED_AUX | LED_SMD:LED_0603_1608Metric | 未填写 | 未填写 | 待定 | 1 | 0 |  |  |  | 待选 | D7 |  | 完整型号、立创C编号、采购链接、颜色、Vf及额定电流核对 |  |  |  | inverter/hardware/bom/selection_pending.csv; refs=D7
S16 | inverter | LED | LED_COMM | LED_SMD:LED_0603_1608Metric | 未填写 | 未填写 | 待定 | 1 | 0 |  |  |  | 待选 | D6 |  | 完整型号、立创C编号、采购链接、颜色、Vf及额定电流核对 |  |  |  | inverter/hardware/bom/selection_pending.csv; refs=D6
S17 | inverter | LED | LED_FAULT | LED_SMD:LED_0603_1608Metric | 未填写 | 未填写 | 待定 | 1 | 0 |  |  |  | 待选 | D5 |  | 完整型号、立创C编号、采购链接、颜色、Vf及额定电流核对 |  |  |  | inverter/hardware/bom/selection_pending.csv; refs=D5
S18 | inverter | LED | LED_RUN | LED_SMD:LED_0603_1608Metric | 未填写 | 未填写 | 待定 | 1 | 0 |  |  |  | 待选 | D4 |  | 完整型号、立创C编号、采购链接、颜色、Vf及额定电流核对 |  |  |  | inverter/hardware/bom/selection_pending.csv; refs=D4
S19 | inverter | LED | PWR | LED_SMD:LED_0603_1608Metric | 未填写 | 未填写 | 待定 | 1 | 0 |  |  |  | 待选 | D3 |  | 完整型号、立创C编号、采购链接、颜色、Vf及额定电流核对 |  |  |  | inverter/hardware/bom/selection_pending.csv; refs=D3
S20 | inverter | 电容 | 100n | Capacitor_SMD:C_0402_1005Metric | 16 V minimum | 未填写 | YAGEO | 0 | 1 |  |  |  | 待选 | C82 | C82 | 完整型号、立创C编号、采购链接、介质、容差、偏压下有效容量 |  |  |  | inverter/hardware/bom/selection_pending.csv; refs=C82
S21 | inverter | 电容 | 100n | Capacitor_SMD:C_0402_1005Metric | 25V | 未填写 | YAGEO | 15 | 0 |  |  |  | 待选 | C17 C40 C41 C43 C45 C47 C49 C54 C56 C57 C58 C59 C60 C61 C62 |  | 完整型号、立创C编号、采购链接、介质、容差、偏压下有效容量 |  |  |  | inverter/hardware/bom/selection_pending.csv; refs=C17 C40 C41 C43 C45 C47 C49 C54 C56 C57 C58 C59 C60 C61 C62
S22 | inverter | 电容 | 100p | Capacitor_SMD:C_0402_1005Metric | 25V | 未填写 | YAGEO | 1 | 0 |  |  |  | 待选 | C42 |  | 完整型号、立创C编号、采购链接、介质、容差、偏压下有效容量 |  |  |  | inverter/hardware/bom/selection_pending.csv; refs=C42
S23 | inverter | 电容 | 10n | Capacitor_SMD:C_0402_1005Metric | 25V | 未填写 | YAGEO | 2 | 0 |  |  |  | 待选 | C50 C55 |  | 完整型号、立创C编号、采购链接、介质、容差、偏压下有效容量 |  |  |  | inverter/hardware/bom/selection_pending.csv; refs=C50 C55
S24 | inverter | 电容 | 1n | Capacitor_SMD:C_0402_1005Metric | 16 V minimum | 未填写 | YAGEO | 8 | 0 |  |  |  | 待选 | C69 C70 C71 C72 C73 C74 C75 C76 |  | 完整型号、立创C编号、采购链接、介质、容差、偏压下有效容量 | C69 C70 C71 C72 C73 C74 C75 C76: Provisional RC; acquisition time and PWM sampling window to be validated |  |  | inverter/hardware/bom/selection_pending.csv; refs=C69 C70 C71 C72 C73 C74 C75 C76
S25 | inverter | 电容 | 1n | Capacitor_SMD:C_0402_1005Metric | 25V | 未填写 | YAGEO | 3 | 0 |  |  |  | 待选 | C44 C46 C48 |  | 完整型号、立创C编号、采购链接、介质、容差、偏压下有效容量 |  |  |  | inverter/hardware/bom/selection_pending.csv; refs=C44 C46 C48
S26 | inverter | 电容 | 100n | Capacitor_SMD:C_0603_1608Metric | 25V | 未填写 | YAGEO | 17 | 0 |  |  |  | 待选 | C4 C5 C9 C12 C24 C26 C28 C30 C32 C34 C36 C37 C38 C39 C51 C52 C53 |  | 完整型号、立创C编号、采购链接、介质、容差、偏压下有效容量 |  | 共享库已有 draft：YAGEO CC0603KRX7R9BB104 / C14663，100nF 50V ±10% X7R；须核用途并完成库审核，原理图仍TBD，无须重复创建条目 | https://item.szlcsc.com/15331.html | inverter/hardware/bom/selection_pending.csv; refs=C4 C5 C9 C12 C24 C26 C28 C30 C32 C34 C36 C37 C38 C39 C51 C52 C53
S27 | inverter | 电容 | 1u | Capacitor_SMD:C_0603_1608Metric | 25V | 未填写 | YAGEO | 2 | 0 |  |  |  | 待选 | C15 C23 |  | 完整型号、立创C编号、采购链接、介质、容差、偏压下有效容量 |  |  |  | inverter/hardware/bom/selection_pending.csv; refs=C15 C23
S28 | inverter | 电容 | 2.2u | Capacitor_SMD:C_0603_1608Metric | 25V | 未填写 | YAGEO | 1 | 0 |  |  |  | 待选 | C16 |  | 完整型号、立创C编号、采购链接、介质、容差、偏压下有效容量 |  |  |  | inverter/hardware/bom/selection_pending.csv; refs=C16
S29 | inverter | 电容 | 22n | Capacitor_SMD:C_0603_1608Metric | 25V | 未填写 | YAGEO | 1 | 0 |  |  |  | 待选 | C2 |  | 完整型号、立创C编号、采购链接、介质、容差、偏压下有效容量 |  |  |  | inverter/hardware/bom/selection_pending.csv; refs=C2
S30 | inverter | 电容 | 10u | Capacitor_SMD:C_0805_2012Metric | 16V | 未填写 | YAGEO | 1 | 0 |  |  |  | 待选 | C18 |  | 完整型号、立创C编号、采购链接、介质、容差、偏压下有效容量 |  |  |  | inverter/hardware/bom/selection_pending.csv; refs=C18
S31 | inverter | 电容 | 1u | Capacitor_SMD:C_0805_2012Metric | 100V | 未填写 | YAGEO | 1 | 0 |  |  |  | 待选 | C1 |  | 完整型号、立创C编号、采购链接、介质、容差、偏压下有效容量 |  |  |  | inverter/hardware/bom/selection_pending.csv; refs=C1
S32 | inverter | 电容 | 4.7u | Capacitor_SMD:C_0805_2012Metric | 10V | 未填写 | YAGEO | 1 | 0 |  |  |  | 待选 | C10 |  | 完整型号、立创C编号、采购链接、介质、容差、偏压下有效容量 |  |  |  | inverter/hardware/bom/selection_pending.csv; refs=C10
S33 | inverter | 电容 | 4.7u | Capacitor_SMD:C_0805_2012Metric | 25V | 未填写 | YAGEO | 3 | 0 |  |  |  | 待选 | C27 C31 C35 |  | 完整型号、立创C编号、采购链接、介质、容差、偏压下有效容量 |  |  |  | inverter/hardware/bom/selection_pending.csv; refs=C27 C31 C35
S34 | inverter | 电容 | 470n | Capacitor_SMD:C_0805_2012Metric | 50V | 未填写 | YAGEO | 1 | 0 |  |  |  | 待选 | C7 |  | 完整型号、立创C编号、采购链接、介质、容差、偏压下有效容量 |  |  |  | inverter/hardware/bom/selection_pending.csv; refs=C7
S35 | inverter | 电容 | 10u | Capacitor_SMD:C_1206_3216Metric | 50V | 未填写 | YAGEO | 3 | 0 |  |  |  | 待选 | C3 C6 C11 |  | 完整型号、立创C编号、采购链接、介质、容差、偏压下有效容量 |  |  |  | inverter/hardware/bom/selection_pending.csv; refs=C3 C6 C11
S36 | inverter | 电容 | 2.2u | Capacitor_SMD:C_1206_3216Metric | 25V | 未填写 | YAGEO | 3 | 0 |  |  |  | 待选 | C25 C29 C33 |  | 完整型号、立创C编号、采购链接、介质、容差、偏压下有效容量 |  |  |  | inverter/hardware/bom/selection_pending.csv; refs=C25 C29 C33
S37 | inverter | 电容 | 22u | Capacitor_SMD:C_1206_3216Metric | 16V | 未填写 | YAGEO | 2 | 0 |  |  |  | 待选 | C13 C14 |  | 完整型号、立创C编号、采购链接、介质、容差、偏压下有效容量 |  |  |  | inverter/hardware/bom/selection_pending.csv; refs=C13 C14
S38 | inverter | 电容 | 22u | Capacitor_SMD:C_1210_3225Metric | 25V | 未填写 | YAGEO | 1 | 0 |  |  |  | 待选 | C8 |  | 完整型号、立创C编号、采购链接、介质、容差、偏压下有效容量 |  |  |  | inverter/hardware/bom/selection_pending.csv; refs=C8
S39 | inverter | 电阻 | 0 | Resistor_SMD:R_0402_1005Metric | 未填写 | 1% | YAGEO | 0 | 6 |  |  |  | 待选 | R100 R107 R113 R119 R126 R127 | R100 R107 R113 R119 R126 R127 | 完整型号、立创C编号、采购链接、功率及额定工作电压核对 | R100 R107: DNP until encoder power/output stage selected; 5V supply is not 5V logic compatibility R113 R119: DNP until external module is selected; IO stays 3.3V |  |  | inverter/hardware/bom/selection_pending.csv; refs=R100 R107 R113 R119 R126 R127
S40 | inverter | 电阻 | 1.8k | Resistor_SMD:R_0402_1005Metric | 未填写 | 0.1% | YAGEO | 2 | 0 |  |  |  | 待选 | R43 R46 |  | 完整型号、立创C编号、采购链接、功率及额定工作电压核对 |  |  |  | inverter/hardware/bom/selection_pending.csv; refs=R43 R46
S41 | inverter | 电阻 | 100 | Resistor_SMD:R_0402_1005Metric | 未填写 | 1% | YAGEO | 15 | 0 |  |  |  | 待选 | R84 R85 R86 R87 R88 R89 R90 R91 R94 R96 R98 R101 R103 R105 R124 |  | 完整型号、立创C编号、采购链接、功率及额定工作电压核对 | R84 R85 R86 R87 R88 R89 R90 R91: Local ADC isolation; 47R source isolator also present except NTC |  |  | inverter/hardware/bom/selection_pending.csv; refs=R84 R85 R86 R87 R88 R89 R90 R91 R94 R96 R98 R101 R103 R105 R124
S42 | inverter | 电阻 | 100k | Resistor_SMD:R_0402_1005Metric | 未填写 | 1% | YAGEO | 2 | 0 |  |  |  | 待选 | R75 R83 |  | 完整型号、立创C编号、采购链接、功率及额定工作电压核对 |  |  |  | inverter/hardware/bom/selection_pending.csv; refs=R75 R83
S43 | inverter | 电阻 | 10k | Resistor_SMD:R_0402_1005Metric | 未填写 | 0.1% | YAGEO | 5 | 0 |  |  |  | 待选 | R40 R41 R44 R45 R72 |  | 完整型号、立创C编号、采购链接、功率及额定工作电压核对 |  |  |  | inverter/hardware/bom/selection_pending.csv; refs=R40 R41 R44 R45 R72
S44 | inverter | 电阻 | 10k | Resistor_SMD:R_0402_1005Metric | 未填写 | 1% | YAGEO | 22 | 1 |  |  |  | 待选 | R13 R70 R73 R74 R76 R77 R78 R79 R80 R81 R82 R95 R97 R99 R102 R104 R106 R112 R118 R125 R128 R143 R160 | R128 | 完整型号、立创C编号、采购链接、功率及额定工作电压核对 | R143: Required local pullup; Q8 open collector drives TIM1 BKIN low on fault R95 R97 R99 R102 R104 R106: For 3.3V open-collector/push-pull only; no 5V logic |  |  | inverter/hardware/bom/selection_pending.csv; refs=R13 R70 R73 R74 R76 R77 R78 R79 R80 R81 R82 R95 R97 R99 R102 R104 R106 R112 R118 R125 R128 R143 R160
S45 | inverter | 电阻 | 120 | Resistor_SMD:R_0402_1005Metric | 未填写 | 1% | YAGEO | 0 | 1 |  |  |  | 待选 | R129 | R129 | 完整型号、立创C编号、采购链接、功率及额定工作电压核对 | R129: Fit only at bus end; CAN PHY is classic <=1Mbps, not CAN-FD rated |  |  | inverter/hardware/bom/selection_pending.csv; refs=R129
S46 | inverter | 电阻 | 13k | Resistor_SMD:R_0402_1005Metric | 未填写 | 0.1% | YAGEO | 1 | 0 |  |  |  | 待选 | R69 |  | 完整型号、立创C编号、采购链接、功率及额定工作电压核对 |  |  |  | inverter/hardware/bom/selection_pending.csv; refs=R69
S47 | inverter | 电阻 | 2.2k | Resistor_SMD:R_0402_1005Metric | 未填写 | 1% | YAGEO | 5 | 0 |  |  |  | 待选 | R130 R131 R132 R133 R134 |  | 完整型号、立创C编号、采购链接、功率及额定工作电压核对 |  |  |  | inverter/hardware/bom/selection_pending.csv; refs=R130 R131 R132 R133 R134
S48 | inverter | 电阻 | 20k | Resistor_SMD:R_0402_1005Metric | 未填写 | 0.1% | YAGEO | 1 | 0 |  |  |  | 待选 | R68 |  | 完整型号、立创C编号、采购链接、功率及额定工作电压核对 |  |  |  | inverter/hardware/bom/selection_pending.csv; refs=R68
S49 | inverter | 电阻 | 33 | Resistor_SMD:R_0402_1005Metric | 未填写 | 1% | YAGEO | 19 | 0 |  |  |  | 待选 | R108 R109 R110 R111 R114 R115 R116 R117 R120 R121 R123 R135 R136 R137 R138 R139 R140 R141 R142 |  | 完整型号、立创C编号、采购链接、功率及额定工作电压核对 |  |  |  | inverter/hardware/bom/selection_pending.csv; refs=R108 R109 R110 R111 R114 R115 R116 R117 R120 R121 R123 R135 R136 R137 R138 R139 R140 R141 R142
S50 | inverter | 电阻 | 39k | Resistor_SMD:R_0402_1005Metric | 未填写 | 0.1% | YAGEO | 2 | 0 |  |  |  | 待选 | R42 R47 |  | 完整型号、立创C编号、采购链接、功率及额定工作电压核对 |  |  |  | inverter/hardware/bom/selection_pending.csv; refs=R42 R47
S51 | inverter | 电阻 | 47 | Resistor_SMD:R_0402_1005Metric | 未填写 | 1% | YAGEO | 4 | 0 |  |  |  | 待选 | R52 R57 R62 R67 |  | 完整型号、立创C编号、采购链接、功率及额定工作电压核对 | R52 R57 R62 R67: Local follower feedback before output isolator; cable and controller ADC RC after resistor |  |  | inverter/hardware/bom/selection_pending.csv; refs=R52 R57 R62 R67
S52 | inverter | 电阻 | 76.1k | Resistor_SMD:R_0402_1005Metric | 未填写 | 0.1% | YAGEO | 1 | 0 |  |  |  | 待选 | R71 |  | 完整型号、立创C编号、采购链接、功率及额定工作电压核对 |  |  |  | inverter/hardware/bom/selection_pending.csv; refs=R71
S53 | inverter | 电阻 | 100k | Resistor_SMD:R_0603_1608Metric | 未填写 | 1% | YAGEO | 1 | 1 |  |  |  | 待选 | R8 R9 | R8 | 完整型号、立创C编号、采购链接、功率及额定工作电压核对 | R8: DNP: remove external 12..24V SHDN pullup. TPS26600 internal SHDN bias is nominal 2.7V, recommended SHDN 0..4V. SW1 still pulls to EFUSE_RTN. |  |  | inverter/hardware/bom/selection_pending.csv; refs=R8 R9
S54 | inverter | 电阻 | 10k | Resistor_SMD:R_0603_1608Metric | 未填写 | 0.1% | YAGEO | 10 | 0 |  |  |  | 待选 | R2 R4 R50 R51 R55 R56 R60 R61 R65 R66 |  | 完整型号、立创C编号、采购链接、功率及额定工作电压核对 |  |  |  | inverter/hardware/bom/selection_pending.csv; refs=R2 R4 R50 R51 R55 R56 R60 R61 R65 R66
S55 | inverter | 电阻 | 10k | Resistor_SMD:R_0603_1608Metric | 未填写 | 1% | YAGEO | 18 | 0 |  |  |  | 待选 | R7 R10 R11 R15 R16 R18 R21 R22 R23 R24 R27 R28 R29 R30 R33 R34 R35 R36 |  | 完整型号、立创C编号、采购链接、功率及额定工作电压核对 |  |  |  | inverter/hardware/bom/selection_pending.csv; refs=R7 R10 R11 R15 R16 R18 R21 R22 R23 R24 R27 R28 R29 R30 R33 R34 R35 R36
S56 | inverter | 电阻 | 10k | Resistor_SMD:R_0603_1608Metric | 未填写 | 未填写 | YAGEO | 1 | 0 |  |  |  | 待选 | R209 |  | 完整型号、立创C编号、采购链接、公差、功率及额定工作电压核对 | R209: BASE_READY_MCU reads LOW if unplugged or the base output is unpowered. |  |  | inverter/hardware/bom/selection_pending.csv; refs=R209
S57 | inverter | 电阻 | 1k | Resistor_SMD:R_0603_1608Metric | 未填写 | 1% | YAGEO | 2 | 0 |  |  |  | 待选 | R210 R211 |  | 完整型号、立创C编号、采购链接、功率及额定工作电压核对 | R210 R211: Return-status transient limiting; 1k with the 10k local pull gives valid logic levels. No isolation. |  |  | inverter/hardware/bom/selection_pending.csv; refs=R210 R211
S58 | inverter | 电阻 | 20k | Resistor_SMD:R_0603_1608Metric | 未填写 | 1% | YAGEO | 1 | 0 |  |  |  | 待选 | R12 |  | 完整型号、立创C编号、采购链接、功率及额定工作电压核对 |  |  |  | inverter/hardware/bom/selection_pending.csv; refs=R12
S59 | inverter | 电阻 | 221k | Resistor_SMD:R_0603_1608Metric | 未填写 | 0.1% | YAGEO | 1 | 0 |  |  |  | 待选 | R3 |  | 完整型号、立创C编号、采购链接、功率及额定工作电压核对 |  |  |  | inverter/hardware/bom/selection_pending.csv; refs=R3
S60 | inverter | 电阻 | 360 | Resistor_SMD:R_0603_1608Metric | 未填写 | 1% | YAGEO | 8 | 0 |  |  |  | 待选 | R201 R202 R203 R204 R205 R206 R207 R208 |  | 完整型号、立创C编号、采购链接、功率及额定工作电压核对 | R201 R202 R203 R204 R205 R206 R207 R208: Input transient limiting; with original 100R gives 460R / 1n, tau about 0.46us. Not a 60V fault barrier. |  |  | inverter/hardware/bom/selection_pending.csv; refs=R201 R202 R203 R204 R205 R206 R207 R208
S61 | inverter | 电阻 | 402k | Resistor_SMD:R_0603_1608Metric | 未填写 | 1% | YAGEO | 1 | 0 |  |  |  | 待选 | R5 |  | 完整型号、立创C编号、采购链接、功率及额定工作电压核对 | R5: 402k selects current-limit latch-off; direct RTN would select auto-retry |  |  | inverter/hardware/bom/selection_pending.csv; refs=R5
S62 | inverter | 电阻 | 47 | Resistor_SMD:R_0603_1608Metric | 未填写 | 1% | YAGEO | 3 | 0 |  |  |  | 待选 | R37 R38 R39 |  | 完整型号、立创C编号、采购链接、功率及额定工作电压核对 | R37 R38 R39: Output isolation at amplifier; trip comparators sense before resistor |  |  | inverter/hardware/bom/selection_pending.csv; refs=R37 R38 R39
S63 | inverter | 电阻 | 49.9k | Resistor_SMD:R_0603_1608Metric | 未填写 | 1% | YAGEO | 1 | 0 |  |  |  | 待选 | R14 |  | 完整型号、立创C编号、采购链接、功率及额定工作电压核对 | R14: ~0.475..0.582 A datasheet min/max formula at nominal R; resistor tolerance adds error |  |  | inverter/hardware/bom/selection_pending.csv; refs=R14
S64 | inverter | 电阻 | 7.87k | Resistor_SMD:R_0603_1608Metric | 未填写 | 1% | YAGEO | 1 | 0 |  |  |  | 待选 | R6 |  | 完整型号、立创C编号、采购链接、功率及额定工作电压核对 | R6: Nominal 11.8k/R -> 1.50 A; tolerance/SOA/startup review |  |  | inverter/hardware/bom/selection_pending.csv; refs=R6
S65 | inverter | 电阻 | 78.7k | Resistor_SMD:R_0603_1608Metric | 未填写 | 0.1% | YAGEO | 1 | 0 |  |  |  | 待选 | R1 |  | 完整型号、立创C编号、采购链接、功率及额定工作电压核对 |  |  |  | inverter/hardware/bom/selection_pending.csv; refs=R1
S66 | inverter | 电阻 | 15 | Resistor_SMD:R_0805_2012Metric | 未填写 | 1% | YAGEO | 7 | 0 |  |  |  | 待选 | R17 R19 R20 R25 R26 R31 R32 |  | 完整型号、立创C编号、采购链接、功率及额定工作电压核对 | R17 R19 R20 R25 R26 R31 R32: Retain 0805 gate resistor; exact YAGEO pulse-rated MPN and gate waveform verification pending |  |  | inverter/hardware/bom/selection_pending.csv; refs=R17 R19 R20 R25 R26 R31 R32
S67 | inverter | 电阻 | 240k | Resistor_SMD:R_0805_2012Metric | 未填写 | 0.1% | YAGEO | 8 | 0 |  |  |  | 待选 | R48 R49 R53 R54 R58 R59 R63 R64 |  | 完整型号、立创C编号、采购链接、功率及额定工作电压核对 |  |  |  | inverter/hardware/bom/selection_pending.csv; refs=R48 R49 R53 R54 R58 R59 R63 R64
