leolei2012/power_system/inverter/hardware/bom/bom.csv

Reference | Value | Quantity | DNP | Sheet | Manufacturer | MPN | Supplier_PN | Purchase_URL | Footprint | Voltage_Rating | Tolerance | Design_Note | Selection_Status | Verification
C1 | 1u | 1 | no | /Auxiliary input/ | YAGEO | TBD |  |  | Capacitor_SMD:C_0805_2012Metric | 100V |  |  | value assigned; DC bias/MPN/LCSC pending
C2 | 22n | 1 | no | /Auxiliary input/ | YAGEO | TBD |  |  | Capacitor_SMD:C_0603_1608Metric | 25V |  |  | value assigned; DC bias/MPN/LCSC pending
C3 | 10u | 1 | no | /Auxiliary input/ | YAGEO | TBD |  |  | Capacitor_SMD:C_1206_3216Metric | 50V |  |  | value assigned; DC bias/MPN/LCSC pending
F2 | 0451002.MRL | 1 | no | /Auxiliary input/ | Littelfuse | 0451002.MRL | C99547 | https://item.szlcsc.com/100761.html | MyFootprints:Littelfuse_NANO2_451_476_Pad1.96x3.15mm_Gap2.95mm |  |  |  | Exact 2 A candidate fits current Nano2 451/453 footprint; converter inrush, short-circuit coordination and ambient derating remain application checks. | reviewed
J2 | XT30PW-M30.G.Y | 1 | no | /Auxiliary input/ | AMASS | XT30PW-M30.G.Y | C431092 | https://item.szlcsc.com/426930.html | MyFootprints:JST_PH_B2B-PH-K_1x02_P2.00mm_Vertical |  |  | 辅助电源输入（原 J2 AUX: +12..24V / GND）；Issue 简称 XT30PW-M；M30 为焊脚约 3.0 mm 高度，不是 30 A；现图封装尚未更新，待 #3。 人民币单价（SMT-CNY，嘉立创 SMT 的 LCSC 详情页 https://www.jlc-smt.com/lcsc/detail/C431092.html）：1 只 2.35 元，10 只 2.05 元；LCSC 国际站库存：70547 只（来源：https://wmsc.lcsc.com/ftps/wm/product/detail 00:40–00:46（Asia/Shanghai，CST）。 | 定案已定，待 #3 原理图更新位号/封装 | reviewed
R1 | 78.7k | 1 | no | /Auxiliary input/ | YAGEO | TBD |  |  | Resistor_SMD:R_0603_1608Metric |  | 0.1% |  | value assigned; exact MPN/LCSC pending
R2 | 10k | 1 | no | /Auxiliary input/ | YAGEO | TBD |  |  | Resistor_SMD:R_0603_1608Metric |  | 0.1% |  | value assigned; exact MPN/LCSC pending
R3 | 221k | 1 | no | /Auxiliary input/ | YAGEO | TBD |  |  | Resistor_SMD:R_0603_1608Metric |  | 0.1% |  | value assigned; exact MPN/LCSC pending
R4 | 10k | 1 | no | /Auxiliary input/ | YAGEO | TBD |  |  | Resistor_SMD:R_0603_1608Metric |  | 0.1% |  | value assigned; exact MPN/LCSC pending
R5 | 402k | 1 | no | /Auxiliary input/ | YAGEO | TBD |  |  | Resistor_SMD:R_0603_1608Metric |  | 1% | 402k selects current-limit latch-off; direct RTN would select auto-retry | value assigned; exact MPN/LCSC pending
R6 | 7.87k | 1 | no | /Auxiliary input/ | YAGEO | TBD |  |  | Resistor_SMD:R_0603_1608Metric |  | 1% | Nominal 11.8k/R -> 1.50 A; tolerance/SOA/startup review | value assigned; exact MPN/LCSC pending
R7 | 10k | 1 | no | /Auxiliary input/ | YAGEO | TBD |  |  | Resistor_SMD:R_0603_1608Metric |  | 1% |  | value assigned; exact MPN/LCSC pending
R8 | 100k | 1 | yes | /Auxiliary input/ | YAGEO | TBD |  |  | Resistor_SMD:R_0603_1608Metric |  | 1% | DNP: remove external 12..24V SHDN pullup. TPS26600 internal SHDN bias is nominal 2.7V, recommended SHDN 0..4V. SW1 still pulls to EFUSE_RTN. | compact revision electrical correction; retain footprint, do not populate
SW1 | AUX_RESET | 1 | no | /Auxiliary input/ | XUNPU | TS-1088-AR02016 | C720477 | https://item.szlcsc.com/763484.html | MyFootprints:SW_SPST_TS-1088-xR020 |  |  |  | Exact small SMD normally-open momentary 2-terminal switch; standard local footprint matches current manufacturer drawing. SW1 bias condition below remains an electrical-review hold point. | reviewed
U1 | TPS26600PWPR | 1 | no | /Auxiliary input/ | TI | TPS26600PWPR | C544399 | https://item.szlcsc.com/565050.html | MyFootprints:HTSSOP-16-1EP_4.4x5mm_P0.65mm_EP3.4x5mm_Mask2.66x2.46mm |  |  |  |  | reviewed
C4 | 100n | 1 | no | /Driver supply/ | YAGEO | CC0603KRX7R9BB104 | C14663 | https://item.szlcsc.com/15331.html | MyFootprints:C_0603_1608Metric | 50V | 10% |  | C14663; 50V X7R covers original 25V local decoupling/bootstrap requirement; application transient and DC-bias verification pending | reviewed
C5 | 100n | 1 | no | /Driver supply/ | YAGEO | CC0603KRX7R9BB104 | C14663 | https://item.szlcsc.com/15331.html | MyFootprints:C_0603_1608Metric | 50V | 10% |  | C14663; 50V X7R covers original 25V local decoupling/bootstrap requirement; application transient and DC-bias verification pending | reviewed
C6 | 10u | 1 | no | /Driver supply/ | YAGEO | TBD |  |  | Capacitor_SMD:C_1206_3216Metric | 50V |  |  | value assigned; DC bias/MPN/LCSC pending
C7 | 470n | 1 | no | /Driver supply/ | YAGEO | TBD |  |  | Capacitor_SMD:C_0805_2012Metric | 50V |  |  | value assigned; DC bias/MPN/LCSC pending
C8 | 22u | 1 | no | /Driver supply/ | YAGEO | TBD |  |  | Capacitor_SMD:C_1210_3225Metric | 25V |  |  | value assigned; DC bias/MPN/LCSC pending
C9 | 100n | 1 | no | /Driver supply/ | YAGEO | CC0603KRX7R9BB104 | C14663 | https://item.szlcsc.com/15331.html | MyFootprints:C_0603_1608Metric | 50V | 10% |  | C14663; 50V X7R covers original 25V local decoupling/bootstrap requirement; application transient and DC-bias verification pending | reviewed
C10 | 4.7u | 1 | no | /Driver supply/ | YAGEO | TBD |  |  | Capacitor_SMD:C_0805_2012Metric | 10V |  |  | value assigned; DC bias/MPN/LCSC pending
L1 | 4.7uH | 1 | no | /Driver supply/ | Sunlord | MWSA0603S-4R7MT | C408447 | https://so.szlcsc.com/global.html?k=MWSA0603S-4R7MT | MyFootprints:L_Sunlord_MWSA0603S |  |  |  | Meets requested nominal L, current-table and DCR targets; auxiliary-converter operating/thermal qualification pending. | reviewed
R9 | 100k | 1 | no | /Driver supply/ | YAGEO | TBD |  |  | Resistor_SMD:R_0603_1608Metric |  | 1% |  | value assigned; exact MPN/LCSC pending
R10 | 10k | 1 | no | /Driver supply/ | YAGEO | TBD |  |  | Resistor_SMD:R_0603_1608Metric |  | 1% |  | value assigned; exact MPN/LCSC pending
R11 | 10k | 1 | no | /Driver supply/ | YAGEO | TBD |  |  | Resistor_SMD:R_0603_1608Metric |  | 1% |  | value assigned; exact MPN/LCSC pending
R12 | 20k | 1 | no | /Driver supply/ | YAGEO | TBD |  |  | Resistor_SMD:R_0603_1608Metric |  | 1% |  | value assigned; exact MPN/LCSC pending
TP1 | +12V_DRV | 1 | no | /Driver supply/ |  |  |  |  | TestPoint:TestPoint_Pad_D1.5mm
TP2 | BB_VREG | 1 | no | /Driver supply/ |  |  |  |  | TestPoint:TestPoint_Pad_D1.5mm
TP3 | DRV_PG_LOGIC | 1 | no | /Driver supply/ |  |  |  |  | TestPoint:TestPoint_Pad_D1.5mm
U2 | TPS55165QPWPRQ1 | 1 | no | /Driver supply/ | TI | TPS55165QPWPRQ1 | C2071629 | https://item.szlcsc.com/2163212.html | MyFootprints:TI_PWP0020W_HTSSOP-20_4.4x6.5mm_P0.65mm_EP2.79x3.64mm |  |  |  |  | reviewed
C11 | 10u | 1 | no | /Logic and sensors/ | YAGEO | TBD |  |  | Capacitor_SMD:C_1206_3216Metric | 50V |  |  | value assigned; DC bias/MPN/LCSC pending
C12 | 100n | 1 | no | /Logic and sensors/ | YAGEO | CC0603KRX7R9BB104 | C14663 | https://item.szlcsc.com/15331.html | MyFootprints:C_0603_1608Metric | 50V | 10% |  | C14663; 50V X7R covers original 25V local decoupling/bootstrap requirement; application transient and DC-bias verification pending | reviewed
C13 | 22u | 1 | no | /Logic and sensors/ | YAGEO | TBD |  |  | Capacitor_SMD:C_1206_3216Metric | 16V |  |  | value assigned; DC bias/MPN/LCSC pending
C14 | 22u | 1 | no | /Logic and sensors/ | YAGEO | TBD |  |  | Capacitor_SMD:C_1206_3216Metric | 16V |  |  | value assigned; DC bias/MPN/LCSC pending
C15 | 1u | 1 | no | /Logic and sensors/ | YAGEO | TBD |  |  | Capacitor_SMD:C_0603_1608Metric | 25V |  |  | value assigned; DC bias/MPN/LCSC pending
C16 | 2.2u | 1 | no | /Logic and sensors/ | YAGEO | TBD |  |  | Capacitor_SMD:C_0603_1608Metric | 25V |  |  | value assigned; DC bias/MPN/LCSC pending
C17 | 100n | 1 | no | /Logic and sensors/ | YAGEO | CC0603KRX7R9BB104 | C14663 | https://item.szlcsc.com/15331.html | MyFootprints:C_0603_1608Metric | 50V | 10% | 封装已按雨田 11-12 规定改为 0603，原理图和 PCB 封装待焊台同步。0603 选用 50V，电压未降低；原行未标公差，采用下列标称公差。功率/介质：X7R 50V；标称公差：10%；嘉立创 SMT 库：基础库。人民币单价（SMT-CNY，嘉立创 SMT 的 LCSC 详情页）：1 只 0.0376 元，10 只 0.0376 元（1–999 同一档）；LCSC 国际站单价（LCSC-USD）：1 只 未查到，10 只 未查到（最低起订 100，100 只档 $0.0063）；LCSC 国际站库存：0 只；立创店招实时人民币价：未查到；立创国内库存：未查到；查询时间：2026-11-12 01:07–01:10（Asia/Shanghai，CST）。与板上已定 100n 0603 同一料，避免同板混料。 | 0402 已按雨田 11-12 规定改为 0603，待焊台同步原理图和 PCB | reviewed
C18 | 10u | 1 | no | /Logic and sensors/ | YAGEO | TBD |  |  | Capacitor_SMD:C_0805_2012Metric | 16V |  |  | value assigned; DC bias/MPN/LCSC pending
J7 | OPTIONAL SENSOR 5V / GND | 1 | yes | /Logic and sensors/ | HCTL | PZ127-1-02-Z | C5372825 | https://item.szlcsc.com/6225189.html | MyFootprints:HCTL_PZ127_1x02_P1.27mm_Drill0.70mm |  |  |  | compact mechanical engineering candidate; original pin order retained | reviewed
L2 | 4.7uH | 1 | no | /Logic and sensors/ | Sunlord | MWSA0603S-4R7MT | C408447 | https://so.szlcsc.com/global.html?k=MWSA0603S-4R7MT | MyFootprints:L_Sunlord_MWSA0603S |  |  |  | Meets requested nominal L, current-table and DCR targets; auxiliary-converter operating/thermal qualification pending. | reviewed
R13 | 10k | 1 | no | /Logic and sensors/ | UNI-ROYAL | 0603WAF1002T5E | C25804 | https://item.szlcsc.com/26547.html | MyFootprints:R_0603_1608Metric |  | 1% | 封装已按雨田 11-12 规定改为 0603，原理图和 PCB 封装待焊台同步。原行未标功率，0603 选用 100 mW，未自行降低。功率/介质：100mW 厚膜 ±100ppm/℃；标称公差：1%；嘉立创 SMT 库：基础库。人民币单价（SMT-CNY，嘉立创 SMT 的 LCSC 详情页）：1 只 0.0133 元，10 只 0.0133 元；LCSC 国际站单价（LCSC-USD）：1 只 未查到，10 只 未查到（最低起订 100，100 只档 $0.0022）；LCSC 国际站库存：4632500 只；立创店招实时人民币价：未查到；立创国内库存：未查到；查询时间：2026-11-12 01:07–01:10（Asia/Shanghai，CST）。 | 0402 已按雨田 11-12 规定改为 0603，待焊台同步原理图和 PCB | reviewed
R14 | 49.9k | 1 | no | /Logic and sensors/ | YAGEO | TBD |  |  | Resistor_SMD:R_0603_1608Metric |  | 1% | ~0.475..0.582 A datasheet min/max formula at nominal R; resistor tolerance adds error | value assigned; exact MPN/LCSC pending
R15 | 10k | 1 | no | /Logic and sensors/ | YAGEO | TBD |  |  | Resistor_SMD:R_0603_1608Metric |  | 1% |  | value assigned; exact MPN/LCSC pending
TP4 | SENSOR_PWR_FLT_N | 1 | no | /Logic and sensors/ |  |  |  |  | TestPoint:TestPoint_Pad_D1.5mm
U3 | AP63205WU-7 | 1 | no | /Logic and sensors/ | Diodes | AP63205WU-7 | C2071056 | https://item.szlcsc.com/2162639.html | MyFootprints:TSOT-23-6 |  |  |  |  | reviewed
U4 | TPS7A2033PDBVR | 1 | no | /Logic and sensors/ | TI | TPS7A2033PDBVR | C2862740 | https://item.szlcsc.com/3067417.html | MyFootprints:SOT-23-5 |  |  |  |  | reviewed
U5 | TPS2553QDBVRQ1 | 1 | no | /Logic and sensors/ | TI | TPS2553QDBVRQ1 | C130055 | https://item.szlcsc.com/141342.html | MyFootprints:SOT-23-6 |  |  |  |  | reviewed
U6 | TPS3808G33DBVR | 1 | no | /Logic and sensors/ | TI | TPS3808G33DBVR | C43698 | https://item.szlcsc.com/44691.html | MyFootprints:SOT-23-6 |  |  |  |  | reviewed
C19 | 220u / 100V | 1 | no | /Bus and brake/ | Nippon Chemi-Con | EKYB101ELL221MK25S | C1585673 | https://item.szlcsc.com/1676488.html | MyFootprints:CP_Radial_D12.5mm_H25mm_P5.00mm |  | 20% |  |  | reviewed
C20 | 220u / 100V | 1 | no | /Bus and brake/ | Nippon Chemi-Con | EKYB101ELL221MK25S | C1585673 | https://item.szlcsc.com/1676488.html | MyFootprints:CP_Radial_D12.5mm_H25mm_P5.00mm |  | 20% |  |  | reviewed
C21 | 2.2u / 100V X7R | 1 | no | /Bus and brake/ | YAGEO | CS1210KKX7R0BB225 | C5578983 | https://item.szlcsc.com/6497372.html | MyFootprints:C_1210_3225Metric |  | 10% |  |  | reviewed
C22 | 2.2u / 100V X7R | 1 | no | /Bus and brake/ | YAGEO | CS1210KKX7R0BB225 | C5578983 | https://item.szlcsc.com/6497372.html | MyFootprints:C_1210_3225Metric |  | 10% |  |  | reviewed
C23 | 1u | 1 | no | /Bus and brake/ | YAGEO | TBD |  |  | Capacitor_SMD:C_0603_1608Metric | 25V |  |  | value assigned; DC bias/MPN/LCSC pending
C24 | 100n | 1 | no | /Bus and brake/ | YAGEO | CC0603KRX7R9BB104 | C14663 | https://item.szlcsc.com/15331.html | MyFootprints:C_0603_1608Metric | 50V | 10% |  | C14663; 50V X7R covers original 25V local decoupling/bootstrap requirement; application transient and DC-bias verification pending | reviewed
D1 | MBRD20150CT-13 | 1 | no | /Bus and brake/ | Diodes Incorporated | MBRD20150CT-13 | C151357 | https://item.szlcsc.com/162697.html | MyFootprints:Diodes_MBRD20150CT_TO252_Recommended |  |  |  | 60mm input series-diode candidate; 1/3 A,2 K/tab visually checked Rev4-2 p1; thermal and production variant pending | reviewed
D2 | SMCJ60CA / CANDIDATE DNP | 1 | yes | /Bus and brake/ | SMC Diode Solutions | SMCJ60CA | C3719686 | https://item.szlcsc.com/4287506.html | MyFootprints:SMC_DO-214AB_Bidirectional |  |  |  | DNP candidate; manufacturer datasheet/clamp energy/layout and 100V cap margin require review | reviewed
F1 | 0476015.MRSN | 1 | no | /Bus and brake/ | Littelfuse | 0476015.MRSN | C3165851 | https://item.szlcsc.com/3727788.html | MyFootprints:Littelfuse_NANO2_451_476_Pad1.96x3.15mm_Gap2.95mm |  |  |  | Exact 15 A / 125 V DC / 2410 candidate; electrical coordination and hot-board derating pending. | reviewed
J3 | XT60PW-M | 1 | no | /Bus and brake/ | AMASS | XT60PW-M.G.Y | C98732 | https://item.szlcsc.com/99942.html | Inverter_Compact:WireSolder_2P_P6.00mm_D2.00mm |  |  | 母线输入（原 J3 DC INPUT: + / -）；立创型号全称 XT60PW-M.G.Y；现图封装尚未更新，待 #3。 人民币单价（SMT-CNY，嘉立创 SMT 的 LCSC 详情页 https://www.jlc-smt.com/lcsc/detail?componentCode=C98732）：1 只 3.69 元，10 只 3.47 元；LCSC 国际站库存：11712 只（来源：https://wmsc.lcsc.com/ftps/wm/product/detail 00:40–00:46（Asia/Shanghai，CST）。 | 定案已定，待 #3 原理图更新位号/封装
J4 | MR60PW-M.G.B | 1 | no | /Bus and brake/ | AMASS | MR60PW-M.G.B | C19268044 | https://item.szlcsc.com/20526055.html | Inverter_Compact:WireSolder_3P_P15.00mm_D2.00mm |  |  | 三相输出（原 J4 RAW PWM: U / V / W）；Issue 简称 MR60PW-M，立创在售为黑色 .G.B；现图封装尚未更新，待 #3。 人民币单价（SMT-CNY，嘉立创 SMT 的 LCSC 详情页 https://www.jlc-smt.com/lcsc/detail/C19268044.html）：1 只 4.53 元，10 只 4.26 元；LCSC 国际站库存：3725 只（来源：https://wmsc.lcsc.com/ftps/wm/product/detail 00:40–00:46（Asia/Shanghai，CST）。 | 定案已定，待 #3 原理图更新位号/封装
J5 | BRAKE POWER: BR+ / BR_SW | 1 | no | /Bus and brake/ |  | PCB solder holes / wire assembly |  |  | Inverter_Compact:WireSolder_2P_P6.00mm_D2.00mm |  |  |  | compact mechanical engineering candidate; original pin order retained
Q7 | BSC110N15NS5 | 1 | no | /Bus and brake/ | Infineon | BSC110N15NS5ATMA1 | C412739 | https://item.szlcsc.com/404529.html | MyFootprints:Infineon_BSC110N15NS5_PG-TDSON8_8PhysicalPins |  |  | 人民币单价（SMT-CNY，嘉立创 SMT 的 LCSC 详情页 https://www.jlc-smt.com/lcsc/detail/C412739.html）：1 只 10.56 元，10 只 9.03 元；LCSC 国际站库存：1417 只（来源：https://wmsc.lcsc.com/ftps/wm/product/detail 00:40–00:46（Asia/Shanghai，CST）。 | 60mm layout candidate; physical 1-3 S,4 G,5-8 D; thermal/pulse/EMI pending | reviewed
R16 | 10k | 1 | no | /Bus and brake/ | YAGEO | TBD |  |  | Resistor_SMD:R_0603_1608Metric |  | 1% |  | value assigned; exact MPN/LCSC pending
R17 | 15 | 1 | no | /Bus and brake/ | YAGEO | TBD |  |  | Resistor_SMD:R_0805_2012Metric |  | 1% | Retain 0805 gate resistor; exact YAGEO pulse-rated MPN and gate waveform verification pending | value assigned; exact MPN/LCSC pending
R18 | 10k | 1 | no | /Bus and brake/ | YAGEO | TBD |  |  | Resistor_SMD:R_0603_1608Metric |  | 1% |  | value assigned; exact MPN/LCSC pending
U29 | UCC27517DBVR | 1 | no | /Bus and brake/ | TI | UCC27517DBVR | C99395 | https://item.szlcsc.com/100609.html | MyFootprints:SOT-23-5 |  |  |  |  | reviewed
C25 | 2.2u | 1 | no | /U half bridge/ | YAGEO | TBD |  |  | Capacitor_SMD:C_1206_3216Metric | 25V |  |  | value assigned; DC bias/MPN/LCSC pending
C26 | 100n | 1 | no | /U half bridge/ | YAGEO | CC0603KRX7R9BB104 | C14663 | https://item.szlcsc.com/15331.html | MyFootprints:C_0603_1608Metric | 50V | 10% |  | C14663; 50V X7R covers original 25V local decoupling/bootstrap requirement; application transient and DC-bias verification pending | reviewed
C27 | 4.7u | 1 | no | /U half bridge/ | YAGEO | TBD |  |  | Capacitor_SMD:C_0805_2012Metric | 25V |  |  | value assigned; DC bias/MPN/LCSC pending
C28 | 100n | 1 | no | /U half bridge/ | YAGEO | CC0603KRX7R9BB104 | C14663 | https://item.szlcsc.com/15331.html | MyFootprints:C_0603_1608Metric | 50V | 10% |  | C14663; 50V X7R covers original 25V local decoupling/bootstrap requirement; application transient and DC-bias verification pending | reviewed
Q1 | BSC110N15NS5 | 1 | no | /U half bridge/ | Infineon | BSC110N15NS5ATMA1 | C412739 | https://item.szlcsc.com/404529.html | MyFootprints:Infineon_BSC110N15NS5_PG-TDSON8_8PhysicalPins |  |  | 人民币单价（SMT-CNY，嘉立创 SMT 的 LCSC 详情页 https://www.jlc-smt.com/lcsc/detail/C412739.html）：1 只 10.56 元，10 只 9.03 元；LCSC 国际站库存：1417 只（来源：https://wmsc.lcsc.com/ftps/wm/product/detail 00:40–00:46（Asia/Shanghai，CST）。 | 60mm layout candidate; physical 1-3 S,4 G,5-8 D; thermal/pulse/EMI pending | reviewed
Q2 | BSC110N15NS5 | 1 | no | /U half bridge/ | Infineon | BSC110N15NS5ATMA1 | C412739 | https://item.szlcsc.com/404529.html | MyFootprints:Infineon_BSC110N15NS5_PG-TDSON8_8PhysicalPins |  |  | 人民币单价（SMT-CNY，嘉立创 SMT 的 LCSC 详情页 https://www.jlc-smt.com/lcsc/detail/C412739.html）：1 只 10.56 元，10 只 9.03 元；LCSC 国际站库存：1417 只（来源：https://wmsc.lcsc.com/ftps/wm/product/detail 00:40–00:46（Asia/Shanghai，CST）。 | 60mm layout candidate; physical 1-3 S,4 G,5-8 D; thermal/pulse/EMI pending | reviewed
R19 | 15 | 1 | no | /U half bridge/ | YAGEO | TBD |  |  | Resistor_SMD:R_0805_2012Metric |  | 1% | Retain 0805 gate resistor; exact YAGEO pulse-rated MPN and gate waveform verification pending | value assigned; exact MPN/LCSC pending
R20 | 15 | 1 | no | /U half bridge/ | YAGEO | TBD |  |  | Resistor_SMD:R_0805_2012Metric |  | 1% | Retain 0805 gate resistor; exact YAGEO pulse-rated MPN and gate waveform verification pending | value assigned; exact MPN/LCSC pending
R21 | 10k | 1 | no | /U half bridge/ | YAGEO | TBD |  |  | Resistor_SMD:R_0603_1608Metric |  | 1% |  | value assigned; exact MPN/LCSC pending
R22 | 10k | 1 | no | /U half bridge/ | YAGEO | TBD |  |  | Resistor_SMD:R_0603_1608Metric |  | 1% |  | value assigned; exact MPN/LCSC pending
R23 | 10k | 1 | no | /U half bridge/ | YAGEO | TBD |  |  | Resistor_SMD:R_0603_1608Metric |  | 1% |  | value assigned; exact MPN/LCSC pending
R24 | 10k | 1 | no | /U half bridge/ | YAGEO | TBD |  |  | Resistor_SMD:R_0603_1608Metric |  | 1% |  | value assigned; exact MPN/LCSC pending
RS1 | 5m / 3W / 1% | 1 | no | /U half bridge/ | Milliohm | HoJLR2512-3W-5mR-1% | C2903482 | https://so.szlcsc.com/global.html?k=C2903482 | MyFootprints:Milliohm_HoJLR2512_Pad2.1x4.0mm_Gap4.1mm |  |  | 2-terminal resistor with Kelvin sense traces; no ground bypass across pads | candidate from local manufacturer series datasheet; domestic product URL and thermal/pulse review pending | reviewed
TP5 | U_PHASE | 1 | no | /U half bridge/ |  |  |  |  | TestPoint:TestPoint_Pad_D1.5mm
TP6 | U_SOURCE | 1 | no | /U half bridge/ |  |  |  |  | TestPoint:TestPoint_Pad_D1.5mm
U7 | 2ED2182S06FXUMA1 | 1 | no | /U half bridge/ | Infineon | 2ED2182S06FXUMA1 | C1850289 | https://item.szlcsc.com/1941102.html | MyFootprints:SOIC-8_3.9x4.9mm_P1.27mm |  |  |  |  | reviewed
C29 | 2.2u | 1 | no | /V half bridge/ | YAGEO | TBD |  |  | Capacitor_SMD:C_1206_3216Metric | 25V |  |  | value assigned; DC bias/MPN/LCSC pending
C30 | 100n | 1 | no | /V half bridge/ | YAGEO | CC0603KRX7R9BB104 | C14663 | https://item.szlcsc.com/15331.html | MyFootprints:C_0603_1608Metric | 50V | 10% |  | C14663; 50V X7R covers original 25V local decoupling/bootstrap requirement; application transient and DC-bias verification pending | reviewed
C31 | 4.7u | 1 | no | /V half bridge/ | YAGEO | TBD |  |  | Capacitor_SMD:C_0805_2012Metric | 25V |  |  | value assigned; DC bias/MPN/LCSC pending
C32 | 100n | 1 | no | /V half bridge/ | YAGEO | CC0603KRX7R9BB104 | C14663 | https://item.szlcsc.com/15331.html | MyFootprints:C_0603_1608Metric | 50V | 10% |  | C14663; 50V X7R covers original 25V local decoupling/bootstrap requirement; application transient and DC-bias verification pending | reviewed
Q3 | BSC110N15NS5 | 1 | no | /V half bridge/ | Infineon | BSC110N15NS5ATMA1 | C412739 | https://item.szlcsc.com/404529.html | MyFootprints:Infineon_BSC110N15NS5_PG-TDSON8_8PhysicalPins |  |  | 人民币单价（SMT-CNY，嘉立创 SMT 的 LCSC 详情页 https://www.jlc-smt.com/lcsc/detail/C412739.html）：1 只 10.56 元，10 只 9.03 元；LCSC 国际站库存：1417 只（来源：https://wmsc.lcsc.com/ftps/wm/product/detail 00:40–00:46（Asia/Shanghai，CST）。 | 60mm layout candidate; physical 1-3 S,4 G,5-8 D; thermal/pulse/EMI pending | reviewed
Q4 | BSC110N15NS5 | 1 | no | /V half bridge/ | Infineon | BSC110N15NS5ATMA1 | C412739 | https://item.szlcsc.com/404529.html | MyFootprints:Infineon_BSC110N15NS5_PG-TDSON8_8PhysicalPins |  |  | 人民币单价（SMT-CNY，嘉立创 SMT 的 LCSC 详情页 https://www.jlc-smt.com/lcsc/detail/C412739.html）：1 只 10.56 元，10 只 9.03 元；LCSC 国际站库存：1417 只（来源：https://wmsc.lcsc.com/ftps/wm/product/detail 00:40–00:46（Asia/Shanghai，CST）。 | 60mm layout candidate; physical 1-3 S,4 G,5-8 D; thermal/pulse/EMI pending | reviewed
R25 | 15 | 1 | no | /V half bridge/ | YAGEO | TBD |  |  | Resistor_SMD:R_0805_2012Metric |  | 1% | Retain 0805 gate resistor; exact YAGEO pulse-rated MPN and gate waveform verification pending | value assigned; exact MPN/LCSC pending
R26 | 15 | 1 | no | /V half bridge/ | YAGEO | TBD |  |  | Resistor_SMD:R_0805_2012Metric |  | 1% | Retain 0805 gate resistor; exact YAGEO pulse-rated MPN and gate waveform verification pending | value assigned; exact MPN/LCSC pending
R27 | 10k | 1 | no | /V half bridge/ | YAGEO | TBD |  |  | Resistor_SMD:R_0603_1608Metric |  | 1% |  | value assigned; exact MPN/LCSC pending
R28 | 10k | 1 | no | /V half bridge/ | YAGEO | TBD |  |  | Resistor_SMD:R_0603_1608Metric |  | 1% |  | value assigned; exact MPN/LCSC pending
R29 | 10k | 1 | no | /V half bridge/ | YAGEO | TBD |  |  | Resistor_SMD:R_0603_1608Metric |  | 1% |  | value assigned; exact MPN/LCSC pending
R30 | 10k | 1 | no | /V half bridge/ | YAGEO | TBD |  |  | Resistor_SMD:R_0603_1608Metric |  | 1% |  | value assigned; exact MPN/LCSC pending
RS2 | 5m / 3W / 1% | 1 | no | /V half bridge/ | Milliohm | HoJLR2512-3W-5mR-1% | C2903482 | https://so.szlcsc.com/global.html?k=C2903482 | MyFootprints:Milliohm_HoJLR2512_Pad2.1x4.0mm_Gap4.1mm |  |  | 2-terminal resistor with Kelvin sense traces; no ground bypass across pads | candidate from local manufacturer series datasheet; domestic product URL and thermal/pulse review pending | reviewed
TP7 | V_PHASE | 1 | no | /V half bridge/ |  |  |  |  | TestPoint:TestPoint_Pad_D1.5mm
TP8 | V_SOURCE | 1 | no | /V half bridge/ |  |  |  |  | TestPoint:TestPoint_Pad_D1.5mm
U8 | 2ED2182S06FXUMA1 | 1 | no | /V half bridge/ | Infineon | 2ED2182S06FXUMA1 | C1850289 | https://item.szlcsc.com/1941102.html | MyFootprints:SOIC-8_3.9x4.9mm_P1.27mm |  |  |  |  | reviewed
C33 | 2.2u | 1 | no | /W half bridge/ | YAGEO | TBD |  |  | Capacitor_SMD:C_1206_3216Metric | 25V |  |  | value assigned; DC bias/MPN/LCSC pending
C34 | 100n | 1 | no | /W half bridge/ | YAGEO | CC0603KRX7R9BB104 | C14663 | https://item.szlcsc.com/15331.html | MyFootprints:C_0603_1608Metric | 50V | 10% |  | C14663; 50V X7R covers original 25V local decoupling/bootstrap requirement; application transient and DC-bias verification pending | reviewed
C35 | 4.7u | 1 | no | /W half bridge/ | YAGEO | TBD |  |  | Capacitor_SMD:C_0805_2012Metric | 25V |  |  | value assigned; DC bias/MPN/LCSC pending
C36 | 100n | 1 | no | /W half bridge/ | YAGEO | CC0603KRX7R9BB104 | C14663 | https://item.szlcsc.com/15331.html | MyFootprints:C_0603_1608Metric | 50V | 10% |  | C14663; 50V X7R covers original 25V local decoupling/bootstrap requirement; application transient and DC-bias verification pending | reviewed
Q5 | BSC110N15NS5 | 1 | no | /W half bridge/ | Infineon | BSC110N15NS5ATMA1 | C412739 | https://item.szlcsc.com/404529.html | MyFootprints:Infineon_BSC110N15NS5_PG-TDSON8_8PhysicalPins |  |  | 人民币单价（SMT-CNY，嘉立创 SMT 的 LCSC 详情页 https://www.jlc-smt.com/lcsc/detail/C412739.html）：1 只 10.56 元，10 只 9.03 元；LCSC 国际站库存：1417 只（来源：https://wmsc.lcsc.com/ftps/wm/product/detail 00:40–00:46（Asia/Shanghai，CST）。 | 60mm layout candidate; physical 1-3 S,4 G,5-8 D; thermal/pulse/EMI pending | reviewed
Q6 | BSC110N15NS5 | 1 | no | /W half bridge/ | Infineon | BSC110N15NS5ATMA1 | C412739 | https://item.szlcsc.com/404529.html | MyFootprints:Infineon_BSC110N15NS5_PG-TDSON8_8PhysicalPins |  |  | 人民币单价（SMT-CNY，嘉立创 SMT 的 LCSC 详情页 https://www.jlc-smt.com/lcsc/detail/C412739.html）：1 只 10.56 元，10 只 9.03 元；LCSC 国际站库存：1417 只（来源：https://wmsc.lcsc.com/ftps/wm/product/detail 00:40–00:46（Asia/Shanghai，CST）。 | 60mm layout candidate; physical 1-3 S,4 G,5-8 D; thermal/pulse/EMI pending | reviewed
R31 | 15 | 1 | no | /W half bridge/ | YAGEO | TBD |  |  | Resistor_SMD:R_0805_2012Metric |  | 1% | Retain 0805 gate resistor; exact YAGEO pulse-rated MPN and gate waveform verification pending | value assigned; exact MPN/LCSC pending
R32 | 15 | 1 | no | /W half bridge/ | YAGEO | TBD |  |  | Resistor_SMD:R_0805_2012Metric |  | 1% | Retain 0805 gate resistor; exact YAGEO pulse-rated MPN and gate waveform verification pending | value assigned; exact MPN/LCSC pending
R33 | 10k | 1 | no | /W half bridge/ | YAGEO | TBD |  |  | Resistor_SMD:R_0603_1608Metric |  | 1% |  | value assigned; exact MPN/LCSC pending
R34 | 10k | 1 | no | /W half bridge/ | YAGEO | TBD |  |  | Resistor_SMD:R_0603_1608Metric |  | 1% |  | value assigned; exact MPN/LCSC pending
R35 | 10k | 1 | no | /W half bridge/ | YAGEO | TBD |  |  | Resistor_SMD:R_0603_1608Metric |  | 1% |  | value assigned; exact MPN/LCSC pending
R36 | 10k | 1 | no | /W half bridge/ | YAGEO | TBD |  |  | Resistor_SMD:R_0603_1608Metric |  | 1% |  | value assigned; exact MPN/LCSC pending
RS3 | 5m / 3W / 1% | 1 | no | /W half bridge/ | Milliohm | HoJLR2512-3W-5mR-1% | C2903482 | https://so.szlcsc.com/global.html?k=C2903482 | MyFootprints:Milliohm_HoJLR2512_Pad2.1x4.0mm_Gap4.1mm |  |  | 2-terminal resistor with Kelvin sense traces; no ground bypass across pads | candidate from local manufacturer series datasheet; domestic product URL and thermal/pulse review pending | reviewed
TP9 | W_PHASE | 1 | no | /W half bridge/ |  |  |  |  | TestPoint:TestPoint_Pad_D1.5mm
TP10 | W_SOURCE | 1 | no | /W half bridge/ |  |  |  |  | TestPoint:TestPoint_Pad_D1.5mm
U9 | 2ED2182S06FXUMA1 | 1 | no | /W half bridge/ | Infineon | 2ED2182S06FXUMA1 | C1850289 | https://item.szlcsc.com/1941102.html | MyFootprints:SOIC-8_3.9x4.9mm_P1.27mm |  |  |  |  | reviewed
C37 | 100n | 1 | no | /Current sensing/ | YAGEO | CC0603KRX7R9BB104 | C14663 | https://item.szlcsc.com/15331.html | MyFootprints:C_0603_1608Metric | 50V | 10% |  | C14663; 50V X7R covers original 25V local decoupling/bootstrap requirement; application transient and DC-bias verification pending | reviewed
C38 | 100n | 1 | no | /Current sensing/ | YAGEO | CC0603KRX7R9BB104 | C14663 | https://item.szlcsc.com/15331.html | MyFootprints:C_0603_1608Metric | 50V | 10% |  | C14663; 50V X7R covers original 25V local decoupling/bootstrap requirement; application transient and DC-bias verification pending | reviewed
C39 | 100n | 1 | no | /Current sensing/ | YAGEO | CC0603KRX7R9BB104 | C14663 | https://item.szlcsc.com/15331.html | MyFootprints:C_0603_1608Metric | 50V | 10% |  | C14663; 50V X7R covers original 25V local decoupling/bootstrap requirement; application transient and DC-bias verification pending | reviewed
C40 | 100n | 1 | no | /Current sensing/ | YAGEO | CC0603KRX7R9BB104 | C14663 | https://item.szlcsc.com/15331.html | MyFootprints:C_0603_1608Metric | 50V | 10% | 封装已按雨田 11-12 规定改为 0603，原理图和 PCB 封装待焊台同步。0603 选用 50V，电压未降低；原行未标公差，采用下列标称公差。功率/介质：X7R 50V；标称公差：10%；嘉立创 SMT 库：基础库。人民币单价（SMT-CNY，嘉立创 SMT 的 LCSC 详情页）：1 只 0.0376 元，10 只 0.0376 元（1–999 同一档）；LCSC 国际站单价（LCSC-USD）：1 只 未查到，10 只 未查到（最低起订 100，100 只档 $0.0063）；LCSC 国际站库存：0 只；立创店招实时人民币价：未查到；立创国内库存：未查到；查询时间：2026-11-12 01:07–01:10（Asia/Shanghai，CST）。与板上已定 100n 0603 同一料，避免同板混料。 | 0402 已按雨田 11-12 规定改为 0603，待焊台同步原理图和 PCB | reviewed
C41 | 100n | 1 | no | /Current sensing/ | YAGEO | CC0603KRX7R9BB104 | C14663 | https://item.szlcsc.com/15331.html | MyFootprints:C_0603_1608Metric | 50V | 10% | 封装已按雨田 11-12 规定改为 0603，原理图和 PCB 封装待焊台同步。0603 选用 50V，电压未降低；原行未标公差，采用下列标称公差。功率/介质：X7R 50V；标称公差：10%；嘉立创 SMT 库：基础库。人民币单价（SMT-CNY，嘉立创 SMT 的 LCSC 详情页）：1 只 0.0376 元，10 只 0.0376 元（1–999 同一档）；LCSC 国际站单价（LCSC-USD）：1 只 未查到，10 只 未查到（最低起订 100，100 只档 $0.0063）；LCSC 国际站库存：0 只；立创店招实时人民币价：未查到；立创国内库存：未查到；查询时间：2026-11-12 01:07–01:10（Asia/Shanghai，CST）。与板上已定 100n 0603 同一料，避免同板混料。 | 0402 已按雨田 11-12 规定改为 0603，待焊台同步原理图和 PCB | reviewed
C62 | 100n | 1 | no | /Current sensing/ | YAGEO | CC0603KRX7R9BB104 | C14663 | https://item.szlcsc.com/15331.html | MyFootprints:C_0603_1608Metric | 50V | 10% | 封装已按雨田 11-12 规定改为 0603，原理图和 PCB 封装待焊台同步。0603 选用 50V，电压未降低；原行未标公差，采用下列标称公差。功率/介质：X7R 50V；标称公差：10%；嘉立创 SMT 库：基础库。人民币单价（SMT-CNY，嘉立创 SMT 的 LCSC 详情页）：1 只 0.0376 元，10 只 0.0376 元（1–999 同一档）；LCSC 国际站单价（LCSC-USD）：1 只 未查到，10 只 未查到（最低起订 100，100 只档 $0.0063）；LCSC 国际站库存：0 只；立创店招实时人民币价：未查到；立创国内库存：未查到；查询时间：2026-11-12 01:07–01:10（Asia/Shanghai，CST）。与板上已定 100n 0603 同一料，避免同板混料。 | 0402 已按雨田 11-12 规定改为 0603，待焊台同步原理图和 PCB | reviewed
R37 | 47 | 1 | no | /Current sensing/ | YAGEO | TBD |  |  | Resistor_SMD:R_0603_1608Metric |  | 1% | Output isolation at amplifier; trip comparators sense before resistor | value assigned; exact MPN/LCSC pending
R38 | 47 | 1 | no | /Current sensing/ | YAGEO | TBD |  |  | Resistor_SMD:R_0603_1608Metric |  | 1% | Output isolation at amplifier; trip comparators sense before resistor | value assigned; exact MPN/LCSC pending
R39 | 47 | 1 | no | /Current sensing/ | YAGEO | TBD |  |  | Resistor_SMD:R_0603_1608Metric |  | 1% | Output isolation at amplifier; trip comparators sense before resistor | value assigned; exact MPN/LCSC pending
R40 | 10k | 1 | no | /Current sensing/ | YAGEO | RT0603BRD0710KL | C95204 | https://item.szlcsc.com/96405.html | MyFootprints:R_0603_1608Metric |  | 0.1% | 封装已按雨田 11-12 规定改为 0603，原理图和 PCB 封装待焊台同步。原行未标功率，0603 选用 100 mW，未自行降低。功率/介质：100mW 薄膜 ±25ppm/℃；标称公差：0.1%；嘉立创 SMT 库：扩展库（0.1% 基础库未见到同规格）。人民币单价（SMT-CNY，嘉立创 SMT 的 LCSC 详情页）：1 只 未查到，10 只 未查到（SMT 页本次未取到 priceList）；LCSC 国际站单价（LCSC-USD）：1 只 未查到，10 只 未查到（最低起订 20，20 只档 $0.0304）；LCSC 国际站库存：411760 只；立创店招实时人民币价：未查到；立创国内库存：未查到；查询时间：2026-11-12 01:07–01:10（Asia/Shanghai，CST）。与 controller 已有 10k 0.1% 0603 为同一料。 | 0402 已按雨田 11-12 规定改为 0603，待焊台同步原理图和 PCB | reviewed
R41 | 10k | 1 | no | /Current sensing/ | YAGEO | RT0603BRD0710KL | C95204 | https://item.szlcsc.com/96405.html | MyFootprints:R_0603_1608Metric |  | 0.1% | 封装已按雨田 11-12 规定改为 0603，原理图和 PCB 封装待焊台同步。原行未标功率，0603 选用 100 mW，未自行降低。功率/介质：100mW 薄膜 ±25ppm/℃；标称公差：0.1%；嘉立创 SMT 库：扩展库（0.1% 基础库未见到同规格）。人民币单价（SMT-CNY，嘉立创 SMT 的 LCSC 详情页）：1 只 未查到，10 只 未查到（SMT 页本次未取到 priceList）；LCSC 国际站单价（LCSC-USD）：1 只 未查到，10 只 未查到（最低起订 20，20 只档 $0.0304）；LCSC 国际站库存：411760 只；立创店招实时人民币价：未查到；立创国内库存：未查到；查询时间：2026-11-12 01:07–01:10（Asia/Shanghai，CST）。与 controller 已有 10k 0.1% 0603 为同一料。 | 0402 已按雨田 11-12 规定改为 0603，待焊台同步原理图和 PCB | reviewed
R42 | 39k | 1 | no | /Current sensing/ | YAGEO | RT0603BRD0739KL | C309652 | https://item.szlcsc.com/293268.html | MyFootprints:R_0603_1608Metric |  | 0.1% | 封装已按雨田 11-12 规定改为 0603，原理图和 PCB 封装待焊台同步。原行未标功率，0603 选用 100 mW，未自行降低。功率/介质：100mW 薄膜 ±25ppm/℃；标称公差：0.1%；嘉立创 SMT 库：扩展库。人民币单价（SMT-CNY，嘉立创 SMT 的 LCSC 详情页）：1 只 未查到，10 只 未查到（SMT 页本次未取到 priceList）；LCSC 国际站单价（LCSC-USD）：1 只 未查到，10 只 $0.0517（最低起订 10，10 只档 $0.0517）；LCSC 国际站库存：14000 只；立创店招实时人民币价：未查到；立创国内库存：未查到；查询时间：2026-11-12 01:07–01:10（Asia/Shanghai，CST）。 | 0402 已按雨田 11-12 规定改为 0603，待焊台同步原理图和 PCB | reviewed
R43 | 1.8k | 1 | no | /Current sensing/ | YAGEO | RT0603BRD071K8L | C705745 | https://item.szlcsc.com/742265.html | MyFootprints:R_0603_1608Metric |  | 0.1% | 封装已按雨田 11-12 规定改为 0603，原理图和 PCB 封装待焊台同步。原行未标功率，0603 选用 100 mW，未自行降低。功率/介质：100mW 薄膜 ±25ppm/℃；标称公差：0.1%；嘉立创 SMT 库：扩展库。人民币单价（SMT-CNY，嘉立创 SMT 的 LCSC 详情页）：1 只 0.216 元，10 只 0.216 元（1–199 同一档）；LCSC 国际站单价（LCSC-USD）：1 只 未查到，10 只 未查到（最低起订 20，20 只档 $0.0355）；LCSC 国际站库存：131120 只；立创店招实时人民币价：未查到；立创国内库存：未查到；查询时间：2026-11-12 01:07–01:10（Asia/Shanghai，CST）。 | 0402 已按雨田 11-12 规定改为 0603，待焊台同步原理图和 PCB | reviewed
R44 | 10k | 1 | no | /Current sensing/ | YAGEO | RT0603BRD0710KL | C95204 | https://item.szlcsc.com/96405.html | MyFootprints:R_0603_1608Metric |  | 0.1% | 封装已按雨田 11-12 规定改为 0603，原理图和 PCB 封装待焊台同步。原行未标功率，0603 选用 100 mW，未自行降低。功率/介质：100mW 薄膜 ±25ppm/℃；标称公差：0.1%；嘉立创 SMT 库：扩展库（0.1% 基础库未见到同规格）。人民币单价（SMT-CNY，嘉立创 SMT 的 LCSC 详情页）：1 只 未查到，10 只 未查到（SMT 页本次未取到 priceList）；LCSC 国际站单价（LCSC-USD）：1 只 未查到，10 只 未查到（最低起订 20，20 只档 $0.0304）；LCSC 国际站库存：411760 只；立创店招实时人民币价：未查到；立创国内库存：未查到；查询时间：2026-11-12 01:07–01:10（Asia/Shanghai，CST）。与 controller 已有 10k 0.1% 0603 为同一料。 | 0402 已按雨田 11-12 规定改为 0603，待焊台同步原理图和 PCB | reviewed
R45 | 10k | 1 | no | /Current sensing/ | YAGEO | RT0603BRD0710KL | C95204 | https://item.szlcsc.com/96405.html | MyFootprints:R_0603_1608Metric |  | 0.1% | 封装已按雨田 11-12 规定改为 0603，原理图和 PCB 封装待焊台同步。原行未标功率，0603 选用 100 mW，未自行降低。功率/介质：100mW 薄膜 ±25ppm/℃；标称公差：0.1%；嘉立创 SMT 库：扩展库（0.1% 基础库未见到同规格）。人民币单价（SMT-CNY，嘉立创 SMT 的 LCSC 详情页）：1 只 未查到，10 只 未查到（SMT 页本次未取到 priceList）；LCSC 国际站单价（LCSC-USD）：1 只 未查到，10 只 未查到（最低起订 20，20 只档 $0.0304）；LCSC 国际站库存：411760 只；立创店招实时人民币价：未查到；立创国内库存：未查到；查询时间：2026-11-12 01:07–01:10（Asia/Shanghai，CST）。与 controller 已有 10k 0.1% 0603 为同一料。 | 0402 已按雨田 11-12 规定改为 0603，待焊台同步原理图和 PCB | reviewed
R46 | 1.8k | 1 | no | /Current sensing/ | YAGEO | RT0603BRD071K8L | C705745 | https://item.szlcsc.com/742265.html | MyFootprints:R_0603_1608Metric |  | 0.1% | 封装已按雨田 11-12 规定改为 0603，原理图和 PCB 封装待焊台同步。原行未标功率，0603 选用 100 mW，未自行降低。功率/介质：100mW 薄膜 ±25ppm/℃；标称公差：0.1%；嘉立创 SMT 库：扩展库。人民币单价（SMT-CNY，嘉立创 SMT 的 LCSC 详情页）：1 只 0.216 元，10 只 0.216 元（1–199 同一档）；LCSC 国际站单价（LCSC-USD）：1 只 未查到，10 只 未查到（最低起订 20，20 只档 $0.0355）；LCSC 国际站库存：131120 只；立创店招实时人民币价：未查到；立创国内库存：未查到；查询时间：2026-11-12 01:07–01:10（Asia/Shanghai，CST）。 | 0402 已按雨田 11-12 规定改为 0603，待焊台同步原理图和 PCB | reviewed
R47 | 39k | 1 | no | /Current sensing/ | YAGEO | RT0603BRD0739KL | C309652 | https://item.szlcsc.com/293268.html | MyFootprints:R_0603_1608Metric |  | 0.1% | 封装已按雨田 11-12 规定改为 0603，原理图和 PCB 封装待焊台同步。原行未标功率，0603 选用 100 mW，未自行降低。功率/介质：100mW 薄膜 ±25ppm/℃；标称公差：0.1%；嘉立创 SMT 库：扩展库。人民币单价（SMT-CNY，嘉立创 SMT 的 LCSC 详情页）：1 只 未查到，10 只 未查到（SMT 页本次未取到 priceList）；LCSC 国际站单价（LCSC-USD）：1 只 未查到，10 只 $0.0517（最低起订 10，10 只档 $0.0517）；LCSC 国际站库存：14000 只；立创店招实时人民币价：未查到；立创国内库存：未查到；查询时间：2026-11-12 01:07–01:10（Asia/Shanghai，CST）。 | 0402 已按雨田 11-12 规定改为 0603，待焊台同步原理图和 PCB | reviewed
TP11 | I_U | 1 | no | /Current sensing/ |  |  |  |  | TestPoint:TestPoint_Pad_D1.5mm
TP12 | I_V | 1 | no | /Current sensing/ |  |  |  |  | TestPoint:TestPoint_Pad_D1.5mm
TP13 | I_W | 1 | no | /Current sensing/ |  |  |  |  | TestPoint:TestPoint_Pad_D1.5mm
U10 | INA241A1IDDFR | 1 | no | /Current sensing/ | TI | INA241A1IDDFR | C19712054 | https://item.szlcsc.com/21022225.html | MyFootprints:SOT-23-8 |  |  |  |  | reviewed
U11 | INA241A1IDDFR | 1 | no | /Current sensing/ | TI | INA241A1IDDFR | C19712054 | https://item.szlcsc.com/21022225.html | MyFootprints:SOT-23-8 |  |  |  |  | reviewed
U12 | INA241A1IDDFR | 1 | no | /Current sensing/ | TI | INA241A1IDDFR | C19712054 | https://item.szlcsc.com/21022225.html | MyFootprints:SOT-23-8 |  |  |  |  | reviewed
U13 | TLV9001IDCKR | 1 | no | /Current sensing/ | TI | TLV9001IDCKR | C398362 | https://item.szlcsc.com/380592.html | MyFootprints:SOT-353_SC-70-5 |  |  |  |  | reviewed
U28 | 74LVC74AD,118 | 1 | no | /Current sensing/ | Nexperia | 74LVC74AD,118 | C6099 | https://item.szlcsc.com/6565.html | MyFootprints:SOIC-14_3.9x8.7mm_P1.27mm |  |  |  |  | reviewed
C42 | 100p | 1 | no | /Voltage and NTC/ | Samsung Electro-Mechanics | CL10C101JB8NNNC | C14858 | https://item.szlcsc.com/15530.html | MyFootprints:C_0603_1608Metric | 50V | 5% | 封装已按雨田 11-12 规定改为 0603，原理图和 PCB 封装待焊台同步。0603 选用 50V，电压未降低；原行未标公差，采用下列标称公差。功率/介质：C0G 50V；标称公差：5%；嘉立创 SMT 库：基础库。人民币单价（SMT-CNY，嘉立创 SMT 的 LCSC 详情页）：1 只 0.0501 元，10 只 0.0501 元（1–499 同一档）；LCSC 国际站单价（LCSC-USD）：1 只 未查到，10 只 未查到（最低起订 50，50 只档 $0.0083）；LCSC 国际站库存：407950 只；立创店招实时人民币价：未查到；立创国内库存：未查到；查询时间：2026-11-12 01:07–01:10（Asia/Shanghai，CST）。 | 0402 已按雨田 11-12 规定改为 0603，待焊台同步原理图和 PCB | reviewed
C43 | 100n | 1 | no | /Voltage and NTC/ | YAGEO | CC0603KRX7R9BB104 | C14663 | https://item.szlcsc.com/15331.html | MyFootprints:C_0603_1608Metric | 50V | 10% | 封装已按雨田 11-12 规定改为 0603，原理图和 PCB 封装待焊台同步。0603 选用 50V，电压未降低；原行未标公差，采用下列标称公差。功率/介质：X7R 50V；标称公差：10%；嘉立创 SMT 库：基础库。人民币单价（SMT-CNY，嘉立创 SMT 的 LCSC 详情页）：1 只 0.0376 元，10 只 0.0376 元（1–999 同一档）；LCSC 国际站单价（LCSC-USD）：1 只 未查到，10 只 未查到（最低起订 100，100 只档 $0.0063）；LCSC 国际站库存：0 只；立创店招实时人民币价：未查到；立创国内库存：未查到；查询时间：2026-11-12 01:07–01:10（Asia/Shanghai，CST）。与板上已定 100n 0603 同一料，避免同板混料。 | 0402 已按雨田 11-12 规定改为 0603，待焊台同步原理图和 PCB | reviewed
C44 | 1n | 1 | no | /Voltage and NTC/ | Samsung Electro-Mechanics | CL10B102KB8NNNC | C1588 | https://item.szlcsc.com/1940.html | MyFootprints:C_0603_1608Metric | 50V | 10% | 封装已按雨田 11-12 规定改为 0603，原理图和 PCB 封装待焊台同步。0603 选用 50V，电压未降低；原行未标公差，采用下列标称公差。功率/介质：X7R 50V；标称公差：10%；嘉立创 SMT 库：基础库。人民币单价（SMT-CNY，嘉立创 SMT 的 LCSC 详情页）：1 只 0.05 元，10 只 0.05 元（1–499 同一档）；LCSC 国际站单价（LCSC-USD）：1 只 未查到，10 只 未查到（最低起订 50，50 只档 $0.0083）；LCSC 国际站库存：1160650 只；立创店招实时人民币价：未查到；立创国内库存：未查到；查询时间：2026-11-12 01:07–01:10（Asia/Shanghai，CST）。 | 0402 已按雨田 11-12 规定改为 0603，待焊台同步原理图和 PCB | reviewed
C45 | 100n | 1 | no | /Voltage and NTC/ | YAGEO | CC0603KRX7R9BB104 | C14663 | https://item.szlcsc.com/15331.html | MyFootprints:C_0603_1608Metric | 50V | 10% | 封装已按雨田 11-12 规定改为 0603，原理图和 PCB 封装待焊台同步。0603 选用 50V，电压未降低；原行未标公差，采用下列标称公差。功率/介质：X7R 50V；标称公差：10%；嘉立创 SMT 库：基础库。人民币单价（SMT-CNY，嘉立创 SMT 的 LCSC 详情页）：1 只 0.0376 元，10 只 0.0376 元（1–999 同一档）；LCSC 国际站单价（LCSC-USD）：1 只 未查到，10 只 未查到（最低起订 100，100 只档 $0.0063）；LCSC 国际站库存：0 只；立创店招实时人民币价：未查到；立创国内库存：未查到；查询时间：2026-11-12 01:07–01:10（Asia/Shanghai，CST）。与板上已定 100n 0603 同一料，避免同板混料。 | 0402 已按雨田 11-12 规定改为 0603，待焊台同步原理图和 PCB | reviewed
C46 | 1n | 1 | no | /Voltage and NTC/ | Samsung Electro-Mechanics | CL10B102KB8NNNC | C1588 | https://item.szlcsc.com/1940.html | MyFootprints:C_0603_1608Metric | 50V | 10% | 封装已按雨田 11-12 规定改为 0603，原理图和 PCB 封装待焊台同步。0603 选用 50V，电压未降低；原行未标公差，采用下列标称公差。功率/介质：X7R 50V；标称公差：10%；嘉立创 SMT 库：基础库。人民币单价（SMT-CNY，嘉立创 SMT 的 LCSC 详情页）：1 只 0.05 元，10 只 0.05 元（1–499 同一档）；LCSC 国际站单价（LCSC-USD）：1 只 未查到，10 只 未查到（最低起订 50，50 只档 $0.0083）；LCSC 国际站库存：1160650 只；立创店招实时人民币价：未查到；立创国内库存：未查到；查询时间：2026-11-12 01:07–01:10（Asia/Shanghai，CST）。 | 0402 已按雨田 11-12 规定改为 0603，待焊台同步原理图和 PCB | reviewed
C47 | 100n | 1 | no | /Voltage and NTC/ | YAGEO | CC0603KRX7R9BB104 | C14663 | https://item.szlcsc.com/15331.html | MyFootprints:C_0603_1608Metric | 50V | 10% | 封装已按雨田 11-12 规定改为 0603，原理图和 PCB 封装待焊台同步。0603 选用 50V，电压未降低；原行未标公差，采用下列标称公差。功率/介质：X7R 50V；标称公差：10%；嘉立创 SMT 库：基础库。人民币单价（SMT-CNY，嘉立创 SMT 的 LCSC 详情页）：1 只 0.0376 元，10 只 0.0376 元（1–999 同一档）；LCSC 国际站单价（LCSC-USD）：1 只 未查到，10 只 未查到（最低起订 100，100 只档 $0.0063）；LCSC 国际站库存：0 只；立创店招实时人民币价：未查到；立创国内库存：未查到；查询时间：2026-11-12 01:07–01:10（Asia/Shanghai，CST）。与板上已定 100n 0603 同一料，避免同板混料。 | 0402 已按雨田 11-12 规定改为 0603，待焊台同步原理图和 PCB | reviewed
C48 | 1n | 1 | no | /Voltage and NTC/ | Samsung Electro-Mechanics | CL10B102KB8NNNC | C1588 | https://item.szlcsc.com/1940.html | MyFootprints:C_0603_1608Metric | 50V | 10% | 封装已按雨田 11-12 规定改为 0603，原理图和 PCB 封装待焊台同步。0603 选用 50V，电压未降低；原行未标公差，采用下列标称公差。功率/介质：X7R 50V；标称公差：10%；嘉立创 SMT 库：基础库。人民币单价（SMT-CNY，嘉立创 SMT 的 LCSC 详情页）：1 只 0.05 元，10 只 0.05 元（1–499 同一档）；LCSC 国际站单价（LCSC-USD）：1 只 未查到，10 只 未查到（最低起订 50，50 只档 $0.0083）；LCSC 国际站库存：1160650 只；立创店招实时人民币价：未查到；立创国内库存：未查到；查询时间：2026-11-12 01:07–01:10（Asia/Shanghai，CST）。 | 0402 已按雨田 11-12 规定改为 0603，待焊台同步原理图和 PCB | reviewed
C49 | 100n | 1 | no | /Voltage and NTC/ | YAGEO | CC0603KRX7R9BB104 | C14663 | https://item.szlcsc.com/15331.html | MyFootprints:C_0603_1608Metric | 50V | 10% | 封装已按雨田 11-12 规定改为 0603，原理图和 PCB 封装待焊台同步。0603 选用 50V，电压未降低；原行未标公差，采用下列标称公差。功率/介质：X7R 50V；标称公差：10%；嘉立创 SMT 库：基础库。人民币单价（SMT-CNY，嘉立创 SMT 的 LCSC 详情页）：1 只 0.0376 元，10 只 0.0376 元（1–999 同一档）；LCSC 国际站单价（LCSC-USD）：1 只 未查到，10 只 未查到（最低起订 100，100 只档 $0.0063）；LCSC 国际站库存：0 只；立创店招实时人民币价：未查到；立创国内库存：未查到；查询时间：2026-11-12 01:07–01:10（Asia/Shanghai，CST）。与板上已定 100n 0603 同一料，避免同板混料。 | 0402 已按雨田 11-12 规定改为 0603，待焊台同步原理图和 PCB | reviewed
C50 | 10n | 1 | no | /Voltage and NTC/ | FH | 0603B103K500NT | C57112 | https://item.szlcsc.com/58143.html | MyFootprints:C_0603_1608Metric | 50V | 10% | 封装已按雨田 11-12 规定改为 0603，原理图和 PCB 封装待焊台同步。0603 选用 50V，电压未降低；原行未标公差，采用下列标称公差。功率/介质：X7R 50V；标称公差：10%；嘉立创 SMT 库：基础库。人民币单价（SMT-CNY，嘉立创 SMT 的 LCSC 详情页）：1 只 0.0626 元，10 只 0.0626 元（1–999 同一档）；LCSC 国际站单价（LCSC-USD）：1 只 未查到，10 只 未查到（最低起订 100，100 只档 $0.0104）；LCSC 国际站库存：700 只；立创店招实时人民币价：未查到；立创国内库存：未查到；查询时间：2026-11-12 01:07–01:10（Asia/Shanghai，CST）。库存偏少，仍优先基础库。 | 0402 已按雨田 11-12 规定改为 0603，待焊台同步原理图和 PCB | reviewed
J8 | EXTERNAL 10k NTC | 1 | no | /Voltage and NTC/ | HCTL | PZ127-1-02-Z | C5372825 | https://item.szlcsc.com/6225189.html | MyFootprints:HCTL_PZ127_1x02_P1.27mm_Drill0.70mm |  |  |  | compact mechanical engineering candidate; original pin order retained | reviewed
R48 | 240k | 1 | no | /Voltage and NTC/ | YAGEO | TBD |  |  | Resistor_SMD:R_0805_2012Metric |  | 0.1% |  | value assigned; exact MPN/LCSC pending
R49 | 240k | 1 | no | /Voltage and NTC/ | YAGEO | TBD |  |  | Resistor_SMD:R_0805_2012Metric |  | 0.1% |  | value assigned; exact MPN/LCSC pending
R50 | 10k | 1 | no | /Voltage and NTC/ | YAGEO | TBD |  |  | Resistor_SMD:R_0603_1608Metric |  | 0.1% |  | value assigned; exact MPN/LCSC pending
R51 | 10k | 1 | no | /Voltage and NTC/ | YAGEO | TBD |  |  | Resistor_SMD:R_0603_1608Metric |  | 0.1% |  | value assigned; exact MPN/LCSC pending
R52 | 47 | 1 | no | /Voltage and NTC/ | UNI-ROYAL | 0603WAF470JT5E | C23182 | https://item.szlcsc.com/23909.html | MyFootprints:R_0603_1608Metric |  | 1% | Local follower feedback before output isolator; cable and controller ADC RC after resistor 封装已按雨田 11-12 规定改为 0603，原理图和 PCB 封装待焊台同步。原行未标功率，0603 选用 100 mW，未自行降低。功率/介质：100mW 厚膜 ±100ppm/℃；标称公差：1%；嘉立创 SMT 库：基础库。人民币单价（SMT-CNY，嘉立创 SMT 的 LCSC 详情页）：1 只 0.011 元，10 只 0.011 元；LCSC 国际站单价（LCSC-USD）：1 只 未查到，10 只 未查到（最低起订 100，100 只档 $0.0019）；LCSC 国际站库存：270200 只；立创店招实时人民币价：未查到；立创国内库存：未查到；查询时间：2026-11-12 01:07–01:10（Asia/Shanghai，CST）。 | 0402 已按雨田 11-12 规定改为 0603，待焊台同步原理图和 PCB | reviewed
R53 | 240k | 1 | no | /Voltage and NTC/ | YAGEO | TBD |  |  | Resistor_SMD:R_0805_2012Metric |  | 0.1% |  | value assigned; exact MPN/LCSC pending
R54 | 240k | 1 | no | /Voltage and NTC/ | YAGEO | TBD |  |  | Resistor_SMD:R_0805_2012Metric |  | 0.1% |  | value assigned; exact MPN/LCSC pending
R55 | 10k | 1 | no | /Voltage and NTC/ | YAGEO | TBD |  |  | Resistor_SMD:R_0603_1608Metric |  | 0.1% |  | value assigned; exact MPN/LCSC pending
R56 | 10k | 1 | no | /Voltage and NTC/ | YAGEO | TBD |  |  | Resistor_SMD:R_0603_1608Metric |  | 0.1% |  | value assigned; exact MPN/LCSC pending
R57 | 47 | 1 | no | /Voltage and NTC/ | UNI-ROYAL | 0603WAF470JT5E | C23182 | https://item.szlcsc.com/23909.html | MyFootprints:R_0603_1608Metric |  | 1% | Local follower feedback before output isolator; cable and controller ADC RC after resistor 封装已按雨田 11-12 规定改为 0603，原理图和 PCB 封装待焊台同步。原行未标功率，0603 选用 100 mW，未自行降低。功率/介质：100mW 厚膜 ±100ppm/℃；标称公差：1%；嘉立创 SMT 库：基础库。人民币单价（SMT-CNY，嘉立创 SMT 的 LCSC 详情页）：1 只 0.011 元，10 只 0.011 元；LCSC 国际站单价（LCSC-USD）：1 只 未查到，10 只 未查到（最低起订 100，100 只档 $0.0019）；LCSC 国际站库存：270200 只；立创店招实时人民币价：未查到；立创国内库存：未查到；查询时间：2026-11-12 01:07–01:10（Asia/Shanghai，CST）。 | 0402 已按雨田 11-12 规定改为 0603，待焊台同步原理图和 PCB | reviewed
R58 | 240k | 1 | no | /Voltage and NTC/ | YAGEO | TBD |  |  | Resistor_SMD:R_0805_2012Metric |  | 0.1% |  | value assigned; exact MPN/LCSC pending
R59 | 240k | 1 | no | /Voltage and NTC/ | YAGEO | TBD |  |  | Resistor_SMD:R_0805_2012Metric |  | 0.1% |  | value assigned; exact MPN/LCSC pending
R60 | 10k | 1 | no | /Voltage and NTC/ | YAGEO | TBD |  |  | Resistor_SMD:R_0603_1608Metric |  | 0.1% |  | value assigned; exact MPN/LCSC pending
R61 | 10k | 1 | no | /Voltage and NTC/ | YAGEO | TBD |  |  | Resistor_SMD:R_0603_1608Metric |  | 0.1% |  | value assigned; exact MPN/LCSC pending
R62 | 47 | 1 | no | /Voltage and NTC/ | UNI-ROYAL | 0603WAF470JT5E | C23182 | https://item.szlcsc.com/23909.html | MyFootprints:R_0603_1608Metric |  | 1% | Local follower feedback before output isolator; cable and controller ADC RC after resistor 封装已按雨田 11-12 规定改为 0603，原理图和 PCB 封装待焊台同步。原行未标功率，0603 选用 100 mW，未自行降低。功率/介质：100mW 厚膜 ±100ppm/℃；标称公差：1%；嘉立创 SMT 库：基础库。人民币单价（SMT-CNY，嘉立创 SMT 的 LCSC 详情页）：1 只 0.011 元，10 只 0.011 元；LCSC 国际站单价（LCSC-USD）：1 只 未查到，10 只 未查到（最低起订 100，100 只档 $0.0019）；LCSC 国际站库存：270200 只；立创店招实时人民币价：未查到；立创国内库存：未查到；查询时间：2026-11-12 01:07–01:10（Asia/Shanghai，CST）。 | 0402 已按雨田 11-12 规定改为 0603，待焊台同步原理图和 PCB | reviewed
R63 | 240k | 1 | no | /Voltage and NTC/ | YAGEO | TBD |  |  | Resistor_SMD:R_0805_2012Metric |  | 0.1% |  | value assigned; exact MPN/LCSC pending
R64 | 240k | 1 | no | /Voltage and NTC/ | YAGEO | TBD |  |  | Resistor_SMD:R_0805_2012Metric |  | 0.1% |  | value assigned; exact MPN/LCSC pending
R65 | 10k | 1 | no | /Voltage and NTC/ | YAGEO | TBD |  |  | Resistor_SMD:R_0603_1608Metric |  | 0.1% |  | value assigned; exact MPN/LCSC pending
R66 | 10k | 1 | no | /Voltage and NTC/ | YAGEO | TBD |  |  | Resistor_SMD:R_0603_1608Metric |  | 0.1% |  | value assigned; exact MPN/LCSC pending
R67 | 47 | 1 | no | /Voltage and NTC/ | UNI-ROYAL | 0603WAF470JT5E | C23182 | https://item.szlcsc.com/23909.html | MyFootprints:R_0603_1608Metric |  | 1% | Local follower feedback before output isolator; cable and controller ADC RC after resistor 封装已按雨田 11-12 规定改为 0603，原理图和 PCB 封装待焊台同步。原行未标功率，0603 选用 100 mW，未自行降低。功率/介质：100mW 厚膜 ±100ppm/℃；标称公差：1%；嘉立创 SMT 库：基础库。人民币单价（SMT-CNY，嘉立创 SMT 的 LCSC 详情页）：1 只 0.011 元，10 只 0.011 元；LCSC 国际站单价（LCSC-USD）：1 只 未查到，10 只 未查到（最低起订 100，100 只档 $0.0019）；LCSC 国际站库存：270200 只；立创店招实时人民币价：未查到；立创国内库存：未查到；查询时间：2026-11-12 01:07–01:10（Asia/Shanghai，CST）。 | 0402 已按雨田 11-12 规定改为 0603，待焊台同步原理图和 PCB | reviewed
R68 | 20k | 1 | no | /Voltage and NTC/ | YAGEO | AT0603BRD0720KL | C855705 | https://item.szlcsc.com/916033.html | MyFootprints:R_0603_1608Metric |  | 0.1% | 封装已按雨田 11-12 规定改为 0603，原理图和 PCB 封装待焊台同步。原行未标功率，0603 选用 100 mW，未自行降低。功率/介质：100mW 薄膜 ±25ppm/℃；标称公差：0.1%；嘉立创 SMT 库：扩展库。人民币单价（SMT-CNY，嘉立创 SMT 的 LCSC 详情页）：1 只 0.659 元，10 只 0.659 元（1–49 同一档）；LCSC 国际站单价（LCSC-USD）：1 只 未查到，10 只 $0.1091（最低起订 5，10 只在 5–49 档 $0.1091）；LCSC 国际站库存：8300 只；立创店招实时人民币价：未查到；立创国内库存：未查到；查询时间：2026-11-12 01:07–01:10（Asia/Shanghai，CST）。同规格 RT0603BRD0720KL（C723637）国际站库存为 0，改选有库存的 YAGEO AT 系列，值/精度/功率/TCR 相同。 | 0402 已按雨田 11-12 规定改为 0603，待焊台同步原理图和 PCB | reviewed
R69 | 13k | 1 | no | /Voltage and NTC/ | YAGEO | RT0603BRD0713KL | C861121 | https://item.szlcsc.com/921459.html | MyFootprints:R_0603_1608Metric |  | 0.1% | 封装已按雨田 11-12 规定改为 0603，原理图和 PCB 封装待焊台同步。原行未标功率，0603 选用 100 mW，未自行降低。功率/介质：100mW 薄膜 ±25ppm/℃；标称公差：0.1%；嘉立创 SMT 库：扩展库。人民币单价（SMT-CNY，嘉立创 SMT 的 LCSC 详情页）：1 只 0.24 元，10 只 0.24 元（1–199 同一档）；LCSC 国际站单价（LCSC-USD）：1 只 未查到，10 只 未查到（最低起订 20，20 只档 $0.0397）；LCSC 国际站库存：18600 只；立创店招实时人民币价：未查到；立创国内库存：未查到；查询时间：2026-11-12 01:07–01:10（Asia/Shanghai，CST）。 | 0402 已按雨田 11-12 规定改为 0603，待焊台同步原理图和 PCB | reviewed
R70 | 10k | 1 | no | /Voltage and NTC/ | UNI-ROYAL | 0603WAF1002T5E | C25804 | https://item.szlcsc.com/26547.html | MyFootprints:R_0603_1608Metric |  | 1% | 封装已按雨田 11-12 规定改为 0603，原理图和 PCB 封装待焊台同步。原行未标功率，0603 选用 100 mW，未自行降低。功率/介质：100mW 厚膜 ±100ppm/℃；标称公差：1%；嘉立创 SMT 库：基础库。人民币单价（SMT-CNY，嘉立创 SMT 的 LCSC 详情页）：1 只 0.0133 元，10 只 0.0133 元；LCSC 国际站单价（LCSC-USD）：1 只 未查到，10 只 未查到（最低起订 100，100 只档 $0.0022）；LCSC 国际站库存：4632500 只；立创店招实时人民币价：未查到；立创国内库存：未查到；查询时间：2026-11-12 01:07–01:10（Asia/Shanghai，CST）。 | 0402 已按雨田 11-12 规定改为 0603，待焊台同步原理图和 PCB | reviewed
U14 | TLV9001IDCKR | 1 | no | /Voltage and NTC/ | TI | TLV9001IDCKR | C398362 | https://item.szlcsc.com/380592.html | MyFootprints:SOT-353_SC-70-5 |  |  |  |  | reviewed
U15 | TLV9001IDCKR | 1 | no | /Voltage and NTC/ | TI | TLV9001IDCKR | C398362 | https://item.szlcsc.com/380592.html | MyFootprints:SOT-353_SC-70-5 |  |  |  |  | reviewed
U16 | TLV9001IDCKR | 1 | no | /Voltage and NTC/ | TI | TLV9001IDCKR | C398362 | https://item.szlcsc.com/380592.html | MyFootprints:SOT-353_SC-70-5 |  |  |  |  | reviewed
U17 | TLV9001IDCKR | 1 | no | /Voltage and NTC/ | TI | TLV9001IDCKR | C398362 | https://item.szlcsc.com/380592.html | MyFootprints:SOT-353_SC-70-5 |  |  |  |  | reviewed
C51 | 100n | 1 | no | /Analog protection/ | YAGEO | CC0603KRX7R9BB104 | C14663 | https://item.szlcsc.com/15331.html | MyFootprints:C_0603_1608Metric | 50V | 10% |  | C14663; 50V X7R covers original 25V local decoupling/bootstrap requirement; application transient and DC-bias verification pending | reviewed
C52 | 100n | 1 | no | /Analog protection/ | YAGEO | CC0603KRX7R9BB104 | C14663 | https://item.szlcsc.com/15331.html | MyFootprints:C_0603_1608Metric | 50V | 10% |  | C14663; 50V X7R covers original 25V local decoupling/bootstrap requirement; application transient and DC-bias verification pending | reviewed
C53 | 100n | 1 | no | /Analog protection/ | YAGEO | CC0603KRX7R9BB104 | C14663 | https://item.szlcsc.com/15331.html | MyFootprints:C_0603_1608Metric | 50V | 10% |  | C14663; 50V X7R covers original 25V local decoupling/bootstrap requirement; application transient and DC-bias verification pending | reviewed
C54 | 100n | 1 | no | /Analog protection/ | YAGEO | CC0603KRX7R9BB104 | C14663 | https://item.szlcsc.com/15331.html | MyFootprints:C_0603_1608Metric | 50V | 10% | 封装已按雨田 11-12 规定改为 0603，原理图和 PCB 封装待焊台同步。0603 选用 50V，电压未降低；原行未标公差，采用下列标称公差。功率/介质：X7R 50V；标称公差：10%；嘉立创 SMT 库：基础库。人民币单价（SMT-CNY，嘉立创 SMT 的 LCSC 详情页）：1 只 0.0376 元，10 只 0.0376 元（1–999 同一档）；LCSC 国际站单价（LCSC-USD）：1 只 未查到，10 只 未查到（最低起订 100，100 只档 $0.0063）；LCSC 国际站库存：0 只；立创店招实时人民币价：未查到；立创国内库存：未查到；查询时间：2026-11-12 01:07–01:10（Asia/Shanghai，CST）。与板上已定 100n 0603 同一料，避免同板混料。 | 0402 已按雨田 11-12 规定改为 0603，待焊台同步原理图和 PCB | reviewed
R71 | 76.1k | 1 | no | /Analog protection/ | YAGEO | TBD |  |  | MyFootprints:R_0603_1608Metric |  | 0.1% | 封装已按雨田 11-12 规定改为 0603，原理图和 PCB 封装待焊台同步。立创目录未查到 0603 76.1k ±0.1%。只改封装，保持原值和精度；查询时间：2026-11-12 01:07–01:10（Asia/Shanghai，CST）。 | 0402 已按雨田 11-12 规定改为 0603，立创目录料号未查到，待焊台同步原理图和 PCB
R72 | 10k | 1 | no | /Analog protection/ | YAGEO | RT0603BRD0710KL | C95204 | https://item.szlcsc.com/96405.html | MyFootprints:R_0603_1608Metric |  | 0.1% | 封装已按雨田 11-12 规定改为 0603，原理图和 PCB 封装待焊台同步。原行未标功率，0603 选用 100 mW，未自行降低。功率/介质：100mW 薄膜 ±25ppm/℃；标称公差：0.1%；嘉立创 SMT 库：扩展库（0.1% 基础库未见到同规格）。人民币单价（SMT-CNY，嘉立创 SMT 的 LCSC 详情页）：1 只 未查到，10 只 未查到（SMT 页本次未取到 priceList）；LCSC 国际站单价（LCSC-USD）：1 只 未查到，10 只 未查到（最低起订 20，20 只档 $0.0304）；LCSC 国际站库存：411760 只；立创店招实时人民币价：未查到；立创国内库存：未查到；查询时间：2026-11-12 01:07–01:10（Asia/Shanghai，CST）。与 controller 已有 10k 0.1% 0603 为同一料。 | 0402 已按雨田 11-12 规定改为 0603，待焊台同步原理图和 PCB | reviewed
U18 | TLV3202AIDGK | 1 | no | /Analog protection/ | TI | TLV3202AIDGK | C182416 | https://item.szlcsc.com/193816.html | MyFootprints:VSSOP-8_3x3mm_P0.65mm |  |  |  |  | reviewed
U19 | TLV3202AIDGK | 1 | no | /Analog protection/ | TI | TLV3202AIDGK | C182416 | https://item.szlcsc.com/193816.html | MyFootprints:VSSOP-8_3x3mm_P0.65mm |  |  |  |  | reviewed
U20 | TLV3202AIDGK | 1 | no | /Analog protection/ | TI | TLV3202AIDGK | C182416 | https://item.szlcsc.com/193816.html | MyFootprints:VSSOP-8_3x3mm_P0.65mm |  |  |  |  | reviewed
U21 | TLV3202AIDGK | 1 | no | /Analog protection/ | TI | TLV3202AIDGK | C182416 | https://item.szlcsc.com/193816.html | MyFootprints:VSSOP-8_3x3mm_P0.65mm |  |  |  |  | reviewed
C55 | 10n | 1 | no | /Hardware latch/ | FH | 0603B103K500NT | C57112 | https://item.szlcsc.com/58143.html | MyFootprints:C_0603_1608Metric | 50V | 10% | 封装已按雨田 11-12 规定改为 0603，原理图和 PCB 封装待焊台同步。0603 选用 50V，电压未降低；原行未标公差，采用下列标称公差。功率/介质：X7R 50V；标称公差：10%；嘉立创 SMT 库：基础库。人民币单价（SMT-CNY，嘉立创 SMT 的 LCSC 详情页）：1 只 0.0626 元，10 只 0.0626 元（1–999 同一档）；LCSC 国际站单价（LCSC-USD）：1 只 未查到，10 只 未查到（最低起订 100，100 只档 $0.0104）；LCSC 国际站库存：700 只；立创店招实时人民币价：未查到；立创国内库存：未查到；查询时间：2026-11-12 01:07–01:10（Asia/Shanghai，CST）。库存偏少，仍优先基础库。 | 0402 已按雨田 11-12 规定改为 0603，待焊台同步原理图和 PCB | reviewed
Q8 | MMBT3904LT1G | 1 | no | /Hardware latch/ | onsemi | MMBT3904LT1G | C81464 | https://item.szlcsc.com/82615.html | MyFootprints:onsemi_SOT-23_CASE318_Recommended |  |  |  | project draft; public library not modified | reviewed
R73 | 10k | 1 | no | /Hardware latch/ | UNI-ROYAL | 0603WAF1002T5E | C25804 | https://item.szlcsc.com/26547.html | MyFootprints:R_0603_1608Metric |  | 1% | 封装已按雨田 11-12 规定改为 0603，原理图和 PCB 封装待焊台同步。原行未标功率，0603 选用 100 mW，未自行降低。功率/介质：100mW 厚膜 ±100ppm/℃；标称公差：1%；嘉立创 SMT 库：基础库。人民币单价（SMT-CNY，嘉立创 SMT 的 LCSC 详情页）：1 只 0.0133 元，10 只 0.0133 元；LCSC 国际站单价（LCSC-USD）：1 只 未查到，10 只 未查到（最低起订 100，100 只档 $0.0022）；LCSC 国际站库存：4632500 只；立创店招实时人民币价：未查到；立创国内库存：未查到；查询时间：2026-11-12 01:07–01:10（Asia/Shanghai，CST）。 | 0402 已按雨田 11-12 规定改为 0603，待焊台同步原理图和 PCB | reviewed
R74 | 10k | 1 | no | /Hardware latch/ | UNI-ROYAL | 0603WAF1002T5E | C25804 | https://item.szlcsc.com/26547.html | MyFootprints:R_0603_1608Metric |  | 1% | 封装已按雨田 11-12 规定改为 0603，原理图和 PCB 封装待焊台同步。原行未标功率，0603 选用 100 mW，未自行降低。功率/介质：100mW 厚膜 ±100ppm/℃；标称公差：1%；嘉立创 SMT 库：基础库。人民币单价（SMT-CNY，嘉立创 SMT 的 LCSC 详情页）：1 只 0.0133 元，10 只 0.0133 元；LCSC 国际站单价（LCSC-USD）：1 只 未查到，10 只 未查到（最低起订 100，100 只档 $0.0022）；LCSC 国际站库存：4632500 只；立创店招实时人民币价：未查到；立创国内库存：未查到；查询时间：2026-11-12 01:07–01:10（Asia/Shanghai，CST）。 | 0402 已按雨田 11-12 规定改为 0603，待焊台同步原理图和 PCB | reviewed
R75 | 100k | 1 | no | /Hardware latch/ | UNI-ROYAL | 0603WAF1003T5E | C25803 | https://item.szlcsc.com/26546.html | MyFootprints:R_0603_1608Metric |  | 1% | 封装已按雨田 11-12 规定改为 0603，原理图和 PCB 封装待焊台同步。原行未标功率，0603 选用 100 mW，未自行降低。功率/介质：100mW 厚膜 ±100ppm/℃；标称公差：1%；嘉立创 SMT 库：基础库。人民币单价（SMT-CNY，嘉立创 SMT 的 LCSC 详情页）：1 只 0.0176 元，10 只 0.0176 元；LCSC 国际站单价（LCSC-USD）：1 只 未查到，10 只 未查到（最低起订 100，100 只档 $0.0030）；LCSC 国际站库存：6373100 只；立创店招实时人民币价：未查到；立创国内库存：未查到；查询时间：2026-11-12 01:07–01:10（Asia/Shanghai，CST）。 | 0402 已按雨田 11-12 规定改为 0603，待焊台同步原理图和 PCB | reviewed
TP14 | FAULT_LATCH | 1 | no | /Hardware latch/ |  |  |  |  | TestPoint:TestPoint_Pad_D1.5mm
U22 | 74LVC08APW,118 | 1 | no | /Hardware latch/ | Nexperia | 74LVC08APW,118 | C6053 | https://item.szlcsc.com/6519.html | MyFootprints:TSSOP-14_4.4x5mm_P0.65mm |  |  |  |  | reviewed
U23 | 74LVC08APW,118 | 1 | no | /Hardware latch/ | Nexperia | 74LVC08APW,118 | C6053 | https://item.szlcsc.com/6519.html | MyFootprints:TSSOP-14_4.4x5mm_P0.65mm |  |  |  |  | reviewed
U24 | 74LVC08APW,118 | 1 | no | /Hardware latch/ | Nexperia | 74LVC08APW,118 | C6053 | https://item.szlcsc.com/6519.html | MyFootprints:TSSOP-14_4.4x5mm_P0.65mm |  |  |  |  | reviewed
U25 | 74LVC08APW,118 | 1 | no | /Hardware latch/ | Nexperia | 74LVC08APW,118 | C6053 | https://item.szlcsc.com/6519.html | MyFootprints:TSSOP-14_4.4x5mm_P0.65mm |  |  |  |  | reviewed
U27 | 74LVC00APW,118 | 1 | no | /Hardware latch/ | Nexperia | 74LVC00APW,118 | C6045 | https://item.szlcsc.com/6511.html | MyFootprints:TSSOP-14_4.4x5mm_P0.65mm |  |  |  |  | reviewed
C56 | 100n | 1 | no | /Hardware PWM gates/ | YAGEO | CC0603KRX7R9BB104 | C14663 | https://item.szlcsc.com/15331.html | MyFootprints:C_0603_1608Metric | 50V | 10% | 封装已按雨田 11-12 规定改为 0603，原理图和 PCB 封装待焊台同步。0603 选用 50V，电压未降低；原行未标公差，采用下列标称公差。功率/介质：X7R 50V；标称公差：10%；嘉立创 SMT 库：基础库。人民币单价（SMT-CNY，嘉立创 SMT 的 LCSC 详情页）：1 只 0.0376 元，10 只 0.0376 元（1–999 同一档）；LCSC 国际站单价（LCSC-USD）：1 只 未查到，10 只 未查到（最低起订 100，100 只档 $0.0063）；LCSC 国际站库存：0 只；立创店招实时人民币价：未查到；立创国内库存：未查到；查询时间：2026-11-12 01:07–01:10（Asia/Shanghai，CST）。与板上已定 100n 0603 同一料，避免同板混料。 | 0402 已按雨田 11-12 规定改为 0603，待焊台同步原理图和 PCB | reviewed
C57 | 100n | 1 | no | /Hardware PWM gates/ | YAGEO | CC0603KRX7R9BB104 | C14663 | https://item.szlcsc.com/15331.html | MyFootprints:C_0603_1608Metric | 50V | 10% | 封装已按雨田 11-12 规定改为 0603，原理图和 PCB 封装待焊台同步。0603 选用 50V，电压未降低；原行未标公差，采用下列标称公差。功率/介质：X7R 50V；标称公差：10%；嘉立创 SMT 库：基础库。人民币单价（SMT-CNY，嘉立创 SMT 的 LCSC 详情页）：1 只 0.0376 元，10 只 0.0376 元（1–999 同一档）；LCSC 国际站单价（LCSC-USD）：1 只 未查到，10 只 未查到（最低起订 100，100 只档 $0.0063）；LCSC 国际站库存：0 只；立创店招实时人民币价：未查到；立创国内库存：未查到；查询时间：2026-11-12 01:07–01:10（Asia/Shanghai，CST）。与板上已定 100n 0603 同一料，避免同板混料。 | 0402 已按雨田 11-12 规定改为 0603，待焊台同步原理图和 PCB | reviewed
C58 | 100n | 1 | no | /Hardware PWM gates/ | YAGEO | CC0603KRX7R9BB104 | C14663 | https://item.szlcsc.com/15331.html | MyFootprints:C_0603_1608Metric | 50V | 10% | 封装已按雨田 11-12 规定改为 0603，原理图和 PCB 封装待焊台同步。0603 选用 50V，电压未降低；原行未标公差，采用下列标称公差。功率/介质：X7R 50V；标称公差：10%；嘉立创 SMT 库：基础库。人民币单价（SMT-CNY，嘉立创 SMT 的 LCSC 详情页）：1 只 0.0376 元，10 只 0.0376 元（1–999 同一档）；LCSC 国际站单价（LCSC-USD）：1 只 未查到，10 只 未查到（最低起订 100，100 只档 $0.0063）；LCSC 国际站库存：0 只；立创店招实时人民币价：未查到；立创国内库存：未查到；查询时间：2026-11-12 01:07–01:10（Asia/Shanghai，CST）。与板上已定 100n 0603 同一料，避免同板混料。 | 0402 已按雨田 11-12 规定改为 0603，待焊台同步原理图和 PCB | reviewed
C59 | 100n | 1 | no | /Hardware PWM gates/ | YAGEO | CC0603KRX7R9BB104 | C14663 | https://item.szlcsc.com/15331.html | MyFootprints:C_0603_1608Metric | 50V | 10% | 封装已按雨田 11-12 规定改为 0603，原理图和 PCB 封装待焊台同步。0603 选用 50V，电压未降低；原行未标公差，采用下列标称公差。功率/介质：X7R 50V；标称公差：10%；嘉立创 SMT 库：基础库。人民币单价（SMT-CNY，嘉立创 SMT 的 LCSC 详情页）：1 只 0.0376 元，10 只 0.0376 元（1–999 同一档）；LCSC 国际站单价（LCSC-USD）：1 只 未查到，10 只 未查到（最低起订 100，100 只档 $0.0063）；LCSC 国际站库存：0 只；立创店招实时人民币价：未查到；立创国内库存：未查到；查询时间：2026-11-12 01:07–01:10（Asia/Shanghai，CST）。与板上已定 100n 0603 同一料，避免同板混料。 | 0402 已按雨田 11-12 规定改为 0603，待焊台同步原理图和 PCB | reviewed
C60 | 100n | 1 | no | /Hardware PWM gates/ | YAGEO | CC0603KRX7R9BB104 | C14663 | https://item.szlcsc.com/15331.html | MyFootprints:C_0603_1608Metric | 50V | 10% | 封装已按雨田 11-12 规定改为 0603，原理图和 PCB 封装待焊台同步。0603 选用 50V，电压未降低；原行未标公差，采用下列标称公差。功率/介质：X7R 50V；标称公差：10%；嘉立创 SMT 库：基础库。人民币单价（SMT-CNY，嘉立创 SMT 的 LCSC 详情页）：1 只 0.0376 元，10 只 0.0376 元（1–999 同一档）；LCSC 国际站单价（LCSC-USD）：1 只 未查到，10 只 未查到（最低起订 100，100 只档 $0.0063）；LCSC 国际站库存：0 只；立创店招实时人民币价：未查到；立创国内库存：未查到；查询时间：2026-11-12 01:07–01:10（Asia/Shanghai，CST）。与板上已定 100n 0603 同一料，避免同板混料。 | 0402 已按雨田 11-12 规定改为 0603，待焊台同步原理图和 PCB | reviewed
C61 | 100n | 1 | no | /Hardware PWM gates/ | YAGEO | CC0603KRX7R9BB104 | C14663 | https://item.szlcsc.com/15331.html | MyFootprints:C_0603_1608Metric | 50V | 10% | 封装已按雨田 11-12 规定改为 0603，原理图和 PCB 封装待焊台同步。0603 选用 50V，电压未降低；原行未标公差，采用下列标称公差。功率/介质：X7R 50V；标称公差：10%；嘉立创 SMT 库：基础库。人民币单价（SMT-CNY，嘉立创 SMT 的 LCSC 详情页）：1 只 0.0376 元，10 只 0.0376 元（1–999 同一档）；LCSC 国际站单价（LCSC-USD）：1 只 未查到，10 只 未查到（最低起订 100，100 只档 $0.0063）；LCSC 国际站库存：0 只；立创店招实时人民币价：未查到；立创国内库存：未查到；查询时间：2026-11-12 01:07–01:10（Asia/Shanghai，CST）。与板上已定 100n 0603 同一料，避免同板混料。 | 0402 已按雨田 11-12 规定改为 0603，待焊台同步原理图和 PCB | reviewed
R76 | 10k | 1 | no | /Hardware PWM gates/ | UNI-ROYAL | 0603WAF1002T5E | C25804 | https://item.szlcsc.com/26547.html | MyFootprints:R_0603_1608Metric |  | 1% | 封装已按雨田 11-12 规定改为 0603，原理图和 PCB 封装待焊台同步。原行未标功率，0603 选用 100 mW，未自行降低。功率/介质：100mW 厚膜 ±100ppm/℃；标称公差：1%；嘉立创 SMT 库：基础库。人民币单价（SMT-CNY，嘉立创 SMT 的 LCSC 详情页）：1 只 0.0133 元，10 只 0.0133 元；LCSC 国际站单价（LCSC-USD）：1 只 未查到，10 只 未查到（最低起订 100，100 只档 $0.0022）；LCSC 国际站库存：4632500 只；立创店招实时人民币价：未查到；立创国内库存：未查到；查询时间：2026-11-12 01:07–01:10（Asia/Shanghai，CST）。 | 0402 已按雨田 11-12 规定改为 0603，待焊台同步原理图和 PCB | reviewed
R77 | 10k | 1 | no | /Hardware PWM gates/ | UNI-ROYAL | 0603WAF1002T5E | C25804 | https://item.szlcsc.com/26547.html | MyFootprints:R_0603_1608Metric |  | 1% | 封装已按雨田 11-12 规定改为 0603，原理图和 PCB 封装待焊台同步。原行未标功率，0603 选用 100 mW，未自行降低。功率/介质：100mW 厚膜 ±100ppm/℃；标称公差：1%；嘉立创 SMT 库：基础库。人民币单价（SMT-CNY，嘉立创 SMT 的 LCSC 详情页）：1 只 0.0133 元，10 只 0.0133 元；LCSC 国际站单价（LCSC-USD）：1 只 未查到，10 只 未查到（最低起订 100，100 只档 $0.0022）；LCSC 国际站库存：4632500 只；立创店招实时人民币价：未查到；立创国内库存：未查到；查询时间：2026-11-12 01:07–01:10（Asia/Shanghai，CST）。 | 0402 已按雨田 11-12 规定改为 0603，待焊台同步原理图和 PCB | reviewed
R78 | 10k | 1 | no | /Hardware PWM gates/ | UNI-ROYAL | 0603WAF1002T5E | C25804 | https://item.szlcsc.com/26547.html | MyFootprints:R_0603_1608Metric |  | 1% | 封装已按雨田 11-12 规定改为 0603，原理图和 PCB 封装待焊台同步。原行未标功率，0603 选用 100 mW，未自行降低。功率/介质：100mW 厚膜 ±100ppm/℃；标称公差：1%；嘉立创 SMT 库：基础库。人民币单价（SMT-CNY，嘉立创 SMT 的 LCSC 详情页）：1 只 0.0133 元，10 只 0.0133 元；LCSC 国际站单价（LCSC-USD）：1 只 未查到，10 只 未查到（最低起订 100，100 只档 $0.0022）；LCSC 国际站库存：4632500 只；立创店招实时人民币价：未查到；立创国内库存：未查到；查询时间：2026-11-12 01:07–01:10（Asia/Shanghai，CST）。 | 0402 已按雨田 11-12 规定改为 0603，待焊台同步原理图和 PCB | reviewed
R79 | 10k | 1 | no | /Hardware PWM gates/ | UNI-ROYAL | 0603WAF1002T5E | C25804 | https://item.szlcsc.com/26547.html | MyFootprints:R_0603_1608Metric |  | 1% | 封装已按雨田 11-12 规定改为 0603，原理图和 PCB 封装待焊台同步。原行未标功率，0603 选用 100 mW，未自行降低。功率/介质：100mW 厚膜 ±100ppm/℃；标称公差：1%；嘉立创 SMT 库：基础库。人民币单价（SMT-CNY，嘉立创 SMT 的 LCSC 详情页）：1 只 0.0133 元，10 只 0.0133 元；LCSC 国际站单价（LCSC-USD）：1 只 未查到，10 只 未查到（最低起订 100，100 只档 $0.0022）；LCSC 国际站库存：4632500 只；立创店招实时人民币价：未查到；立创国内库存：未查到；查询时间：2026-11-12 01:07–01:10（Asia/Shanghai，CST）。 | 0402 已按雨田 11-12 规定改为 0603，待焊台同步原理图和 PCB | reviewed
R80 | 10k | 1 | no | /Hardware PWM gates/ | UNI-ROYAL | 0603WAF1002T5E | C25804 | https://item.szlcsc.com/26547.html | MyFootprints:R_0603_1608Metric |  | 1% | 封装已按雨田 11-12 规定改为 0603，原理图和 PCB 封装待焊台同步。原行未标功率，0603 选用 100 mW，未自行降低。功率/介质：100mW 厚膜 ±100ppm/℃；标称公差：1%；嘉立创 SMT 库：基础库。人民币单价（SMT-CNY，嘉立创 SMT 的 LCSC 详情页）：1 只 0.0133 元，10 只 0.0133 元；LCSC 国际站单价（LCSC-USD）：1 只 未查到，10 只 未查到（最低起订 100，100 只档 $0.0022）；LCSC 国际站库存：4632500 只；立创店招实时人民币价：未查到；立创国内库存：未查到；查询时间：2026-11-12 01:07–01:10（Asia/Shanghai，CST）。 | 0402 已按雨田 11-12 规定改为 0603，待焊台同步原理图和 PCB | reviewed
R81 | 10k | 1 | no | /Hardware PWM gates/ | UNI-ROYAL | 0603WAF1002T5E | C25804 | https://item.szlcsc.com/26547.html | MyFootprints:R_0603_1608Metric |  | 1% | 封装已按雨田 11-12 规定改为 0603，原理图和 PCB 封装待焊台同步。原行未标功率，0603 选用 100 mW，未自行降低。功率/介质：100mW 厚膜 ±100ppm/℃；标称公差：1%；嘉立创 SMT 库：基础库。人民币单价（SMT-CNY，嘉立创 SMT 的 LCSC 详情页）：1 只 0.0133 元，10 只 0.0133 元；LCSC 国际站单价（LCSC-USD）：1 只 未查到，10 只 未查到（最低起订 100，100 只档 $0.0022）；LCSC 国际站库存：4632500 只；立创店招实时人民币价：未查到；立创国内库存：未查到；查询时间：2026-11-12 01:07–01:10（Asia/Shanghai，CST）。 | 0402 已按雨田 11-12 规定改为 0603，待焊台同步原理图和 PCB | reviewed
R82 | 10k | 1 | no | /Hardware PWM gates/ | UNI-ROYAL | 0603WAF1002T5E | C25804 | https://item.szlcsc.com/26547.html | MyFootprints:R_0603_1608Metric |  | 1% | 封装已按雨田 11-12 规定改为 0603，原理图和 PCB 封装待焊台同步。原行未标功率，0603 选用 100 mW，未自行降低。功率/介质：100mW 厚膜 ±100ppm/℃；标称公差：1%；嘉立创 SMT 库：基础库。人民币单价（SMT-CNY，嘉立创 SMT 的 LCSC 详情页）：1 只 0.0133 元，10 只 0.0133 元；LCSC 国际站单价（LCSC-USD）：1 只 未查到，10 只 未查到（最低起订 100，100 只档 $0.0022）；LCSC 国际站库存：4632500 只；立创店招实时人民币价：未查到；立创国内库存：未查到；查询时间：2026-11-12 01:07–01:10（Asia/Shanghai，CST）。 | 0402 已按雨田 11-12 规定改为 0603，待焊台同步原理图和 PCB | reviewed
R83 | 100k | 1 | no | /Hardware PWM gates/ | UNI-ROYAL | 0603WAF1003T5E | C25803 | https://item.szlcsc.com/26546.html | MyFootprints:R_0603_1608Metric |  | 1% | 封装已按雨田 11-12 规定改为 0603，原理图和 PCB 封装待焊台同步。原行未标功率，0603 选用 100 mW，未自行降低。功率/介质：100mW 厚膜 ±100ppm/℃；标称公差：1%；嘉立创 SMT 库：基础库。人民币单价（SMT-CNY，嘉立创 SMT 的 LCSC 详情页）：1 只 0.0176 元，10 只 0.0176 元；LCSC 国际站单价（LCSC-USD）：1 只 未查到，10 只 未查到（最低起订 100，100 只档 $0.0030）；LCSC 国际站库存：6373100 只；立创店招实时人民币价：未查到；立创国内库存：未查到；查询时间：2026-11-12 01:07–01:10（Asia/Shanghai，CST）。 | 0402 已按雨田 11-12 规定改为 0603，待焊台同步原理图和 PCB | reviewed
U26 | 74LVC08APW,118 | 1 | no | /Hardware PWM gates/ | Nexperia | 74LVC08APW,118 | C6053 | https://item.szlcsc.com/6519.html | MyFootprints:TSSOP-14_4.4x5mm_P0.65mm |  |  |  |  | reviewed
R160 | 10k | 1 | no | /Base interlock/ | UNI-ROYAL | 0603WAF1002T5E | C25804 | https://item.szlcsc.com/26547.html | MyFootprints:R_0603_1608Metric |  | 1% | 封装已按雨田 11-12 规定改为 0603，原理图和 PCB 封装待焊台同步。原行未标功率，0603 选用 100 mW，未自行降低。功率/介质：100mW 厚膜 ±100ppm/℃；标称公差：1%；嘉立创 SMT 库：基础库。人民币单价（SMT-CNY，嘉立创 SMT 的 LCSC 详情页）：1 只 0.0133 元，10 只 0.0133 元；LCSC 国际站单价（LCSC-USD）：1 只 未查到，10 只 未查到（最低起订 100，100 只档 $0.0022）；LCSC 国际站库存：4632500 只；立创店招实时人民币价：未查到；立创国内库存：未查到；查询时间：2026-11-12 01:07–01:10（Asia/Shanghai，CST）。 | 0402 已按雨田 11-12 规定改为 0603，待焊台同步原理图和 PCB | reviewed
D3 | PWR | 1 | no | /Base LEDs/ |  | TBD |  |  | LED_SMD:LED_0603_1608Metric |  |  |  | color/MPN pending
R130 | 2.2k | 1 | no | /Base LEDs/ | UNI-ROYAL | 0603WAF2201T5E | C4190 | https://item.szlcsc.com/4597.html | MyFootprints:R_0603_1608Metric |  | 1% | 封装已按雨田 11-12 规定改为 0603，原理图和 PCB 封装待焊台同步。原行未标功率，0603 选用 100 mW，未自行降低。功率/介质：100mW 厚膜 ±100ppm/℃；标称公差：1%；嘉立创 SMT 库：基础库。人民币单价（SMT-CNY，嘉立创 SMT 的 LCSC 详情页）：1 只 0.0109 元，10 只 0.0109 元；LCSC 国际站单价（LCSC-USD）：1 只 未查到，10 只 未查到（最低起订 100，100 只档 $0.0019）；LCSC 国际站库存：2080900 只；立创店招实时人民币价：未查到；立创国内库存：未查到；查询时间：2026-11-12 01:07–01:10（Asia/Shanghai，CST）。 | 0402 已按雨田 11-12 规定改为 0603，待焊台同步原理图和 PCB | reviewed
R135 | 33 | 1 | no | /GPIO command coupling/ | UNI-ROYAL | 0603WAF330JT5E | C23140 | https://item.szlcsc.com/23867.html | MyFootprints:R_0603_1608Metric |  | 1% | 封装已按雨田 11-12 规定改为 0603，原理图和 PCB 封装待焊台同步。原行未标功率，0603 选用 100 mW，未自行降低。功率/介质：100mW 厚膜 ±100ppm/℃；标称公差：1%；嘉立创 SMT 库：基础库。人民币单价（SMT-CNY，嘉立创 SMT 的 LCSC 详情页）：1 只 0.0142 元，10 只 0.0142 元；LCSC 国际站单价（LCSC-USD）：1 只 未查到，10 只 未查到（最低起订 100，100 只档 $0.0024）；LCSC 国际站库存：1229500 只；立创店招实时人民币价：未查到；立创国内库存：未查到；查询时间：2026-11-12 01:07–01:10（Asia/Shanghai，CST）。 | 0402 已按雨田 11-12 规定改为 0603，待焊台同步原理图和 PCB | reviewed
R136 | 33 | 1 | no | /GPIO command coupling/ | UNI-ROYAL | 0603WAF330JT5E | C23140 | https://item.szlcsc.com/23867.html | MyFootprints:R_0603_1608Metric |  | 1% | 封装已按雨田 11-12 规定改为 0603，原理图和 PCB 封装待焊台同步。原行未标功率，0603 选用 100 mW，未自行降低。功率/介质：100mW 厚膜 ±100ppm/℃；标称公差：1%；嘉立创 SMT 库：基础库。人民币单价（SMT-CNY，嘉立创 SMT 的 LCSC 详情页）：1 只 0.0142 元，10 只 0.0142 元；LCSC 国际站单价（LCSC-USD）：1 只 未查到，10 只 未查到（最低起订 100，100 只档 $0.0024）；LCSC 国际站库存：1229500 只；立创店招实时人民币价：未查到；立创国内库存：未查到；查询时间：2026-11-12 01:07–01:10（Asia/Shanghai，CST）。 | 0402 已按雨田 11-12 规定改为 0603，待焊台同步原理图和 PCB | reviewed
R137 | 33 | 1 | no | /GPIO command coupling/ | UNI-ROYAL | 0603WAF330JT5E | C23140 | https://item.szlcsc.com/23867.html | MyFootprints:R_0603_1608Metric |  | 1% | 封装已按雨田 11-12 规定改为 0603，原理图和 PCB 封装待焊台同步。原行未标功率，0603 选用 100 mW，未自行降低。功率/介质：100mW 厚膜 ±100ppm/℃；标称公差：1%；嘉立创 SMT 库：基础库。人民币单价（SMT-CNY，嘉立创 SMT 的 LCSC 详情页）：1 只 0.0142 元，10 只 0.0142 元；LCSC 国际站单价（LCSC-USD）：1 只 未查到，10 只 未查到（最低起订 100，100 只档 $0.0024）；LCSC 国际站库存：1229500 只；立创店招实时人民币价：未查到；立创国内库存：未查到；查询时间：2026-11-12 01:07–01:10（Asia/Shanghai，CST）。 | 0402 已按雨田 11-12 规定改为 0603，待焊台同步原理图和 PCB | reviewed
R138 | 33 | 1 | no | /GPIO command coupling/ | UNI-ROYAL | 0603WAF330JT5E | C23140 | https://item.szlcsc.com/23867.html | MyFootprints:R_0603_1608Metric |  | 1% | 封装已按雨田 11-12 规定改为 0603，原理图和 PCB 封装待焊台同步。原行未标功率，0603 选用 100 mW，未自行降低。功率/介质：100mW 厚膜 ±100ppm/℃；标称公差：1%；嘉立创 SMT 库：基础库。人民币单价（SMT-CNY，嘉立创 SMT 的 LCSC 详情页）：1 只 0.0142 元，10 只 0.0142 元；LCSC 国际站单价（LCSC-USD）：1 只 未查到，10 只 未查到（最低起订 100，100 只档 $0.0024）；LCSC 国际站库存：1229500 只；立创店招实时人民币价：未查到；立创国内库存：未查到；查询时间：2026-11-12 01:07–01:10（Asia/Shanghai，CST）。 | 0402 已按雨田 11-12 规定改为 0603，待焊台同步原理图和 PCB | reviewed
R139 | 33 | 1 | no | /GPIO command coupling/ | UNI-ROYAL | 0603WAF330JT5E | C23140 | https://item.szlcsc.com/23867.html | MyFootprints:R_0603_1608Metric |  | 1% | 封装已按雨田 11-12 规定改为 0603，原理图和 PCB 封装待焊台同步。原行未标功率，0603 选用 100 mW，未自行降低。功率/介质：100mW 厚膜 ±100ppm/℃；标称公差：1%；嘉立创 SMT 库：基础库。人民币单价（SMT-CNY，嘉立创 SMT 的 LCSC 详情页）：1 只 0.0142 元，10 只 0.0142 元；LCSC 国际站单价（LCSC-USD）：1 只 未查到，10 只 未查到（最低起订 100，100 只档 $0.0024）；LCSC 国际站库存：1229500 只；立创店招实时人民币价：未查到；立创国内库存：未查到；查询时间：2026-11-12 01:07–01:10（Asia/Shanghai，CST）。 | 0402 已按雨田 11-12 规定改为 0603，待焊台同步原理图和 PCB | reviewed
R140 | 33 | 1 | no | /GPIO command coupling/ | UNI-ROYAL | 0603WAF330JT5E | C23140 | https://item.szlcsc.com/23867.html | MyFootprints:R_0603_1608Metric |  | 1% | 封装已按雨田 11-12 规定改为 0603，原理图和 PCB 封装待焊台同步。原行未标功率，0603 选用 100 mW，未自行降低。功率/介质：100mW 厚膜 ±100ppm/℃；标称公差：1%；嘉立创 SMT 库：基础库。人民币单价（SMT-CNY，嘉立创 SMT 的 LCSC 详情页）：1 只 0.0142 元，10 只 0.0142 元；LCSC 国际站单价（LCSC-USD）：1 只 未查到，10 只 未查到（最低起订 100，100 只档 $0.0024）；LCSC 国际站库存：1229500 只；立创店招实时人民币价：未查到；立创国内库存：未查到；查询时间：2026-11-12 01:07–01:10（Asia/Shanghai，CST）。 | 0402 已按雨田 11-12 规定改为 0603，待焊台同步原理图和 PCB | reviewed
R141 | 33 | 1 | no | /GPIO command coupling/ | UNI-ROYAL | 0603WAF330JT5E | C23140 | https://item.szlcsc.com/23867.html | MyFootprints:R_0603_1608Metric |  | 1% | 封装已按雨田 11-12 规定改为 0603，原理图和 PCB 封装待焊台同步。原行未标功率，0603 选用 100 mW，未自行降低。功率/介质：100mW 厚膜 ±100ppm/℃；标称公差：1%；嘉立创 SMT 库：基础库。人民币单价（SMT-CNY，嘉立创 SMT 的 LCSC 详情页）：1 只 0.0142 元，10 只 0.0142 元；LCSC 国际站单价（LCSC-USD）：1 只 未查到，10 只 未查到（最低起订 100，100 只档 $0.0024）；LCSC 国际站库存：1229500 只；立创店招实时人民币价：未查到；立创国内库存：未查到；查询时间：2026-11-12 01:07–01:10（Asia/Shanghai，CST）。 | 0402 已按雨田 11-12 规定改为 0603，待焊台同步原理图和 PCB | reviewed
R142 | 33 | 1 | no | /GPIO command coupling/ | UNI-ROYAL | 0603WAF330JT5E | C23140 | https://item.szlcsc.com/23867.html | MyFootprints:R_0603_1608Metric |  | 1% | 封装已按雨田 11-12 规定改为 0603，原理图和 PCB 封装待焊台同步。原行未标功率，0603 选用 100 mW，未自行降低。功率/介质：100mW 厚膜 ±100ppm/℃；标称公差：1%；嘉立创 SMT 库：基础库。人民币单价（SMT-CNY，嘉立创 SMT 的 LCSC 详情页）：1 只 0.0142 元，10 只 0.0142 元；LCSC 国际站单价（LCSC-USD）：1 只 未查到，10 只 未查到（最低起订 100，100 只档 $0.0024）；LCSC 国际站库存：1229500 只；立创店招实时人民币价：未查到；立创国内库存：未查到；查询时间：2026-11-12 01:07–01:10（Asia/Shanghai，CST）。 | 0402 已按雨田 11-12 规定改为 0603，待焊台同步原理图和 PCB | reviewed
R143 | 10k | 1 | no | /GPIO command coupling/ | UNI-ROYAL | 0603WAF1002T5E | C25804 | https://item.szlcsc.com/26547.html | MyFootprints:R_0603_1608Metric |  | 1% | Required local pullup; Q8 open collector drives TIM1 BKIN low on fault 封装已按雨田 11-12 规定改为 0603，原理图和 PCB 封装待焊台同步。原行未标功率，0603 选用 100 mW，未自行降低。功率/介质：100mW 厚膜 ±100ppm/℃；标称公差：1%；嘉立创 SMT 库：基础库。人民币单价（SMT-CNY，嘉立创 SMT 的 LCSC 详情页）：1 只 0.0133 元，10 只 0.0133 元；LCSC 国际站单价（LCSC-USD）：1 只 未查到，10 只 未查到（最低起订 100，100 只档 $0.0022）；LCSC 国际站库存：4632500 只；立创店招实时人民币价：未查到；立创国内库存：未查到；查询时间：2026-11-12 01:07–01:10（Asia/Shanghai，CST）。 | 0402 已按雨田 11-12 规定改为 0603，待焊台同步原理图和 PCB | reviewed
C69 | 1n | 1 | no | /ADC and status returns/ | Samsung Electro-Mechanics | CL10B102KB8NNNC | C1588 | https://item.szlcsc.com/1940.html | MyFootprints:C_0603_1608Metric | 50V | 10% | Provisional RC; acquisition time and PWM sampling window to be validated 封装已按雨田 11-12 规定改为 0603，原理图和 PCB 封装待焊台同步。0603 选用 50V，电压未降低；原行未标公差，采用下列标称公差。功率/介质：X7R 50V；标称公差：10%；嘉立创 SMT 库：基础库。人民币单价（SMT-CNY，嘉立创 SMT 的 LCSC 详情页）：1 只 0.05 元，10 只 0.05 元（1–499 同一档）；LCSC 国际站单价（LCSC-USD）：1 只 未查到，10 只 未查到（最低起订 50，50 只档 $0.0083）；LCSC 国际站库存：1160650 只；立创店招实时人民币价：未查到；立创国内库存：未查到；查询时间：2026-11-12 01:07–01:10（Asia/Shanghai，CST）。 | 0402 已按雨田 11-12 规定改为 0603，待焊台同步原理图和 PCB | reviewed
C70 | 1n | 1 | no | /ADC and status returns/ | Samsung Electro-Mechanics | CL10B102KB8NNNC | C1588 | https://item.szlcsc.com/1940.html | MyFootprints:C_0603_1608Metric | 50V | 10% | Provisional RC; acquisition time and PWM sampling window to be validated 封装已按雨田 11-12 规定改为 0603，原理图和 PCB 封装待焊台同步。0603 选用 50V，电压未降低；原行未标公差，采用下列标称公差。功率/介质：X7R 50V；标称公差：10%；嘉立创 SMT 库：基础库。人民币单价（SMT-CNY，嘉立创 SMT 的 LCSC 详情页）：1 只 0.05 元，10 只 0.05 元（1–499 同一档）；LCSC 国际站单价（LCSC-USD）：1 只 未查到，10 只 未查到（最低起订 50，50 只档 $0.0083）；LCSC 国际站库存：1160650 只；立创店招实时人民币价：未查到；立创国内库存：未查到；查询时间：2026-11-12 01:07–01:10（Asia/Shanghai，CST）。 | 0402 已按雨田 11-12 规定改为 0603，待焊台同步原理图和 PCB | reviewed
C71 | 1n | 1 | no | /ADC and status returns/ | Samsung Electro-Mechanics | CL10B102KB8NNNC | C1588 | https://item.szlcsc.com/1940.html | MyFootprints:C_0603_1608Metric | 50V | 10% | Provisional RC; acquisition time and PWM sampling window to be validated 封装已按雨田 11-12 规定改为 0603，原理图和 PCB 封装待焊台同步。0603 选用 50V，电压未降低；原行未标公差，采用下列标称公差。功率/介质：X7R 50V；标称公差：10%；嘉立创 SMT 库：基础库。人民币单价（SMT-CNY，嘉立创 SMT 的 LCSC 详情页）：1 只 0.05 元，10 只 0.05 元（1–499 同一档）；LCSC 国际站单价（LCSC-USD）：1 只 未查到，10 只 未查到（最低起订 50，50 只档 $0.0083）；LCSC 国际站库存：1160650 只；立创店招实时人民币价：未查到；立创国内库存：未查到；查询时间：2026-11-12 01:07–01:10（Asia/Shanghai，CST）。 | 0402 已按雨田 11-12 规定改为 0603，待焊台同步原理图和 PCB | reviewed
C72 | 1n | 1 | no | /ADC and status returns/ | Samsung Electro-Mechanics | CL10B102KB8NNNC | C1588 | https://item.szlcsc.com/1940.html | MyFootprints:C_0603_1608Metric | 50V | 10% | Provisional RC; acquisition time and PWM sampling window to be validated 封装已按雨田 11-12 规定改为 0603，原理图和 PCB 封装待焊台同步。0603 选用 50V，电压未降低；原行未标公差，采用下列标称公差。功率/介质：X7R 50V；标称公差：10%；嘉立创 SMT 库：基础库。人民币单价（SMT-CNY，嘉立创 SMT 的 LCSC 详情页）：1 只 0.05 元，10 只 0.05 元（1–499 同一档）；LCSC 国际站单价（LCSC-USD）：1 只 未查到，10 只 未查到（最低起订 50，50 只档 $0.0083）；LCSC 国际站库存：1160650 只；立创店招实时人民币价：未查到；立创国内库存：未查到；查询时间：2026-11-12 01:07–01:10（Asia/Shanghai，CST）。 | 0402 已按雨田 11-12 规定改为 0603，待焊台同步原理图和 PCB | reviewed
C73 | 1n | 1 | no | /ADC and status returns/ | Samsung Electro-Mechanics | CL10B102KB8NNNC | C1588 | https://item.szlcsc.com/1940.html | MyFootprints:C_0603_1608Metric | 50V | 10% | Provisional RC; acquisition time and PWM sampling window to be validated 封装已按雨田 11-12 规定改为 0603，原理图和 PCB 封装待焊台同步。0603 选用 50V，电压未降低；原行未标公差，采用下列标称公差。功率/介质：X7R 50V；标称公差：10%；嘉立创 SMT 库：基础库。人民币单价（SMT-CNY，嘉立创 SMT 的 LCSC 详情页）：1 只 0.05 元，10 只 0.05 元（1–499 同一档）；LCSC 国际站单价（LCSC-USD）：1 只 未查到，10 只 未查到（最低起订 50，50 只档 $0.0083）；LCSC 国际站库存：1160650 只；立创店招实时人民币价：未查到；立创国内库存：未查到；查询时间：2026-11-12 01:07–01:10（Asia/Shanghai，CST）。 | 0402 已按雨田 11-12 规定改为 0603，待焊台同步原理图和 PCB | reviewed
C74 | 1n | 1 | no | /ADC and status returns/ | Samsung Electro-Mechanics | CL10B102KB8NNNC | C1588 | https://item.szlcsc.com/1940.html | MyFootprints:C_0603_1608Metric | 50V | 10% | Provisional RC; acquisition time and PWM sampling window to be validated 封装已按雨田 11-12 规定改为 0603，原理图和 PCB 封装待焊台同步。0603 选用 50V，电压未降低；原行未标公差，采用下列标称公差。功率/介质：X7R 50V；标称公差：10%；嘉立创 SMT 库：基础库。人民币单价（SMT-CNY，嘉立创 SMT 的 LCSC 详情页）：1 只 0.05 元，10 只 0.05 元（1–499 同一档）；LCSC 国际站单价（LCSC-USD）：1 只 未查到，10 只 未查到（最低起订 50，50 只档 $0.0083）；LCSC 国际站库存：1160650 只；立创店招实时人民币价：未查到；立创国内库存：未查到；查询时间：2026-11-12 01:07–01:10（Asia/Shanghai，CST）。 | 0402 已按雨田 11-12 规定改为 0603，待焊台同步原理图和 PCB | reviewed
C75 | 1n | 1 | no | /ADC and status returns/ | Samsung Electro-Mechanics | CL10B102KB8NNNC | C1588 | https://item.szlcsc.com/1940.html | MyFootprints:C_0603_1608Metric | 50V | 10% | Provisional RC; acquisition time and PWM sampling window to be validated 封装已按雨田 11-12 规定改为 0603，原理图和 PCB 封装待焊台同步。0603 选用 50V，电压未降低；原行未标公差，采用下列标称公差。功率/介质：X7R 50V；标称公差：10%；嘉立创 SMT 库：基础库。人民币单价（SMT-CNY，嘉立创 SMT 的 LCSC 详情页）：1 只 0.05 元，10 只 0.05 元（1–499 同一档）；LCSC 国际站单价（LCSC-USD）：1 只 未查到，10 只 未查到（最低起订 50，50 只档 $0.0083）；LCSC 国际站库存：1160650 只；立创店招实时人民币价：未查到；立创国内库存：未查到；查询时间：2026-11-12 01:07–01:10（Asia/Shanghai，CST）。 | 0402 已按雨田 11-12 规定改为 0603，待焊台同步原理图和 PCB | reviewed
C76 | 1n | 1 | no | /ADC and status returns/ | Samsung Electro-Mechanics | CL10B102KB8NNNC | C1588 | https://item.szlcsc.com/1940.html | MyFootprints:C_0603_1608Metric | 50V | 10% | Provisional RC; acquisition time and PWM sampling window to be validated 封装已按雨田 11-12 规定改为 0603，原理图和 PCB 封装待焊台同步。0603 选用 50V，电压未降低；原行未标公差，采用下列标称公差。功率/介质：X7R 50V；标称公差：10%；嘉立创 SMT 库：基础库。人民币单价（SMT-CNY，嘉立创 SMT 的 LCSC 详情页）：1 只 0.05 元，10 只 0.05 元（1–499 同一档）；LCSC 国际站单价（LCSC-USD）：1 只 未查到，10 只 未查到（最低起订 50，50 只档 $0.0083）；LCSC 国际站库存：1160650 只；立创店招实时人民币价：未查到；立创国内库存：未查到；查询时间：2026-11-12 01:07–01:10（Asia/Shanghai，CST）。 | 0402 已按雨田 11-12 规定改为 0603，待焊台同步原理图和 PCB | reviewed
D201 | BAT54S,215 | 1 | no | /ADC and status returns/ | Nexperia | BAT54S,215 | C47546 | https://item.szlcsc.com/48551.html | MyFootprints:Nexperia_SOT23_Reflow_Pad0.70x0.60mm |  |  | DS 2022-07-01: pin1=A1 GND; pin2=K2 3V3_MCU; pin3=K1/A2 clamped signal. Basic transient clamps, no galvanic isolation. |  | reviewed
D202 | BAT54S,215 | 1 | no | /ADC and status returns/ | Nexperia | BAT54S,215 | C47546 | https://item.szlcsc.com/48551.html | MyFootprints:Nexperia_SOT23_Reflow_Pad0.70x0.60mm |  |  | DS 2022-07-01: pin1=A1 GND; pin2=K2 3V3_MCU; pin3=K1/A2 clamped signal. Basic transient clamps, no galvanic isolation. |  | reviewed
D203 | BAT54S,215 | 1 | no | /ADC and status returns/ | Nexperia | BAT54S,215 | C47546 | https://item.szlcsc.com/48551.html | MyFootprints:Nexperia_SOT23_Reflow_Pad0.70x0.60mm |  |  | DS 2022-07-01: pin1=A1 GND; pin2=K2 3V3_MCU; pin3=K1/A2 clamped signal. Basic transient clamps, no galvanic isolation. |  | reviewed
D204 | BAT54S,215 | 1 | no | /ADC and status returns/ | Nexperia | BAT54S,215 | C47546 | https://item.szlcsc.com/48551.html | MyFootprints:Nexperia_SOT23_Reflow_Pad0.70x0.60mm |  |  | DS 2022-07-01: pin1=A1 GND; pin2=K2 3V3_MCU; pin3=K1/A2 clamped signal. Basic transient clamps, no galvanic isolation. |  | reviewed
D205 | BAT54S,215 | 1 | no | /ADC and status returns/ | Nexperia | BAT54S,215 | C47546 | https://item.szlcsc.com/48551.html | MyFootprints:Nexperia_SOT23_Reflow_Pad0.70x0.60mm |  |  | DS 2022-07-01: pin1=A1 GND; pin2=K2 3V3_MCU; pin3=K1/A2 clamped signal. Basic transient clamps, no galvanic isolation. |  | reviewed
D206 | BAT54S,215 | 1 | no | /ADC and status returns/ | Nexperia | BAT54S,215 | C47546 | https://item.szlcsc.com/48551.html | MyFootprints:Nexperia_SOT23_Reflow_Pad0.70x0.60mm |  |  | DS 2022-07-01: pin1=A1 GND; pin2=K2 3V3_MCU; pin3=K1/A2 clamped signal. Basic transient clamps, no galvanic isolation. |  | reviewed
D207 | BAT54S,215 | 1 | no | /ADC and status returns/ | Nexperia | BAT54S,215 | C47546 | https://item.szlcsc.com/48551.html | MyFootprints:Nexperia_SOT23_Reflow_Pad0.70x0.60mm |  |  | DS 2022-07-01: pin1=A1 GND; pin2=K2 3V3_MCU; pin3=K1/A2 clamped signal. Basic transient clamps, no galvanic isolation. |  | reviewed
D208 | BAT54S,215 | 1 | no | /ADC and status returns/ | Nexperia | BAT54S,215 | C47546 | https://item.szlcsc.com/48551.html | MyFootprints:Nexperia_SOT23_Reflow_Pad0.70x0.60mm |  |  | DS 2022-07-01: pin1=A1 GND; pin2=K2 3V3_MCU; pin3=K1/A2 clamped signal. Basic transient clamps, no galvanic isolation. |  | reviewed
D209 | BAT54S,215 | 1 | no | /ADC and status returns/ | Nexperia | BAT54S,215 | C47546 | https://item.szlcsc.com/48551.html | MyFootprints:Nexperia_SOT23_Reflow_Pad0.70x0.60mm |  |  | 1 GND,2 3V3_MCU,3 protected return status. Fault pullup remains on the protected MCU side. |  | reviewed
D210 | BAT54S,215 | 1 | no | /ADC and status returns/ | Nexperia | BAT54S,215 | C47546 | https://item.szlcsc.com/48551.html | MyFootprints:Nexperia_SOT23_Reflow_Pad0.70x0.60mm |  |  | 1 GND,2 3V3_MCU,3 protected return status. Fault pullup remains on the protected MCU side. |  | reviewed
R84 | 100 | 1 | no | /ADC and status returns/ | UNI-ROYAL | 0603WAF1000T5E | C22775 | https://item.szlcsc.com/23502.html | MyFootprints:R_0603_1608Metric |  | 1% | Local ADC isolation; 47R source isolator also present except NTC 封装已按雨田 11-12 规定改为 0603，原理图和 PCB 封装待焊台同步。原行未标功率，0603 选用 100 mW，未自行降低。功率/介质：100mW 厚膜 ±100ppm/℃；标称公差：1%；嘉立创 SMT 库：基础库。人民币单价（SMT-CNY，嘉立创 SMT 的 LCSC 详情页）：1 只 未查到，10 只 未查到（SMT 页本次未取到 priceList）；LCSC 国际站单价（LCSC-USD）：1 只 未查到，10 只 未查到（最低起订 100，100 只档 $0.0021）；LCSC 国际站库存：1705000 只；立创店招实时人民币价：未查到；立创国内库存：未查到；查询时间：2026-11-12 01:07–01:10（Asia/Shanghai，CST）。 | 0402 已按雨田 11-12 规定改为 0603，待焊台同步原理图和 PCB | reviewed
R85 | 100 | 1 | no | /ADC and status returns/ | UNI-ROYAL | 0603WAF1000T5E | C22775 | https://item.szlcsc.com/23502.html | MyFootprints:R_0603_1608Metric |  | 1% | Local ADC isolation; 47R source isolator also present except NTC 封装已按雨田 11-12 规定改为 0603，原理图和 PCB 封装待焊台同步。原行未标功率，0603 选用 100 mW，未自行降低。功率/介质：100mW 厚膜 ±100ppm/℃；标称公差：1%；嘉立创 SMT 库：基础库。人民币单价（SMT-CNY，嘉立创 SMT 的 LCSC 详情页）：1 只 未查到，10 只 未查到（SMT 页本次未取到 priceList）；LCSC 国际站单价（LCSC-USD）：1 只 未查到，10 只 未查到（最低起订 100，100 只档 $0.0021）；LCSC 国际站库存：1705000 只；立创店招实时人民币价：未查到；立创国内库存：未查到；查询时间：2026-11-12 01:07–01:10（Asia/Shanghai，CST）。 | 0402 已按雨田 11-12 规定改为 0603，待焊台同步原理图和 PCB | reviewed
R86 | 100 | 1 | no | /ADC and status returns/ | UNI-ROYAL | 0603WAF1000T5E | C22775 | https://item.szlcsc.com/23502.html | MyFootprints:R_0603_1608Metric |  | 1% | Local ADC isolation; 47R source isolator also present except NTC 封装已按雨田 11-12 规定改为 0603，原理图和 PCB 封装待焊台同步。原行未标功率，0603 选用 100 mW，未自行降低。功率/介质：100mW 厚膜 ±100ppm/℃；标称公差：1%；嘉立创 SMT 库：基础库。人民币单价（SMT-CNY，嘉立创 SMT 的 LCSC 详情页）：1 只 未查到，10 只 未查到（SMT 页本次未取到 priceList）；LCSC 国际站单价（LCSC-USD）：1 只 未查到，10 只 未查到（最低起订 100，100 只档 $0.0021）；LCSC 国际站库存：1705000 只；立创店招实时人民币价：未查到；立创国内库存：未查到；查询时间：2026-11-12 01:07–01:10（Asia/Shanghai，CST）。 | 0402 已按雨田 11-12 规定改为 0603，待焊台同步原理图和 PCB | reviewed
R87 | 100 | 1 | no | /ADC and status returns/ | UNI-ROYAL | 0603WAF1000T5E | C22775 | https://item.szlcsc.com/23502.html | MyFootprints:R_0603_1608Metric |  | 1% | Local ADC isolation; 47R source isolator also present except NTC 封装已按雨田 11-12 规定改为 0603，原理图和 PCB 封装待焊台同步。原行未标功率，0603 选用 100 mW，未自行降低。功率/介质：100mW 厚膜 ±100ppm/℃；标称公差：1%；嘉立创 SMT 库：基础库。人民币单价（SMT-CNY，嘉立创 SMT 的 LCSC 详情页）：1 只 未查到，10 只 未查到（SMT 页本次未取到 priceList）；LCSC 国际站单价（LCSC-USD）：1 只 未查到，10 只 未查到（最低起订 100，100 只档 $0.0021）；LCSC 国际站库存：1705000 只；立创店招实时人民币价：未查到；立创国内库存：未查到；查询时间：2026-11-12 01:07–01:10（Asia/Shanghai，CST）。 | 0402 已按雨田 11-12 规定改为 0603，待焊台同步原理图和 PCB | reviewed
R88 | 100 | 1 | no | /ADC and status returns/ | UNI-ROYAL | 0603WAF1000T5E | C22775 | https://item.szlcsc.com/23502.html | MyFootprints:R_0603_1608Metric |  | 1% | Local ADC isolation; 47R source isolator also present except NTC 封装已按雨田 11-12 规定改为 0603，原理图和 PCB 封装待焊台同步。原行未标功率，0603 选用 100 mW，未自行降低。功率/介质：100mW 厚膜 ±100ppm/℃；标称公差：1%；嘉立创 SMT 库：基础库。人民币单价（SMT-CNY，嘉立创 SMT 的 LCSC 详情页）：1 只 未查到，10 只 未查到（SMT 页本次未取到 priceList）；LCSC 国际站单价（LCSC-USD）：1 只 未查到，10 只 未查到（最低起订 100，100 只档 $0.0021）；LCSC 国际站库存：1705000 只；立创店招实时人民币价：未查到；立创国内库存：未查到；查询时间：2026-11-12 01:07–01:10（Asia/Shanghai，CST）。 | 0402 已按雨田 11-12 规定改为 0603，待焊台同步原理图和 PCB | reviewed
R89 | 100 | 1 | no | /ADC and status returns/ | UNI-ROYAL | 0603WAF1000T5E | C22775 | https://item.szlcsc.com/23502.html | MyFootprints:R_0603_1608Metric |  | 1% | Local ADC isolation; 47R source isolator also present except NTC 封装已按雨田 11-12 规定改为 0603，原理图和 PCB 封装待焊台同步。原行未标功率，0603 选用 100 mW，未自行降低。功率/介质：100mW 厚膜 ±100ppm/℃；标称公差：1%；嘉立创 SMT 库：基础库。人民币单价（SMT-CNY，嘉立创 SMT 的 LCSC 详情页）：1 只 未查到，10 只 未查到（SMT 页本次未取到 priceList）；LCSC 国际站单价（LCSC-USD）：1 只 未查到，10 只 未查到（最低起订 100，100 只档 $0.0021）；LCSC 国际站库存：1705000 只；立创店招实时人民币价：未查到；立创国内库存：未查到；查询时间：2026-11-12 01:07–01:10（Asia/Shanghai，CST）。 | 0402 已按雨田 11-12 规定改为 0603，待焊台同步原理图和 PCB | reviewed
R90 | 100 | 1 | no | /ADC and status returns/ | UNI-ROYAL | 0603WAF1000T5E | C22775 | https://item.szlcsc.com/23502.html | MyFootprints:R_0603_1608Metric |  | 1% | Local ADC isolation; 47R source isolator also present except NTC 封装已按雨田 11-12 规定改为 0603，原理图和 PCB 封装待焊台同步。原行未标功率，0603 选用 100 mW，未自行降低。功率/介质：100mW 厚膜 ±100ppm/℃；标称公差：1%；嘉立创 SMT 库：基础库。人民币单价（SMT-CNY，嘉立创 SMT 的 LCSC 详情页）：1 只 未查到，10 只 未查到（SMT 页本次未取到 priceList）；LCSC 国际站单价（LCSC-USD）：1 只 未查到，10 只 未查到（最低起订 100，100 只档 $0.0021）；LCSC 国际站库存：1705000 只；立创店招实时人民币价：未查到；立创国内库存：未查到；查询时间：2026-11-12 01:07–01:10（Asia/Shanghai，CST）。 | 0402 已按雨田 11-12 规定改为 0603，待焊台同步原理图和 PCB | reviewed
R91 | 100 | 1 | no | /ADC and status returns/ | UNI-ROYAL | 0603WAF1000T5E | C22775 | https://item.szlcsc.com/23502.html | MyFootprints:R_0603_1608Metric |  | 1% | Local ADC isolation; 47R source isolator also present except NTC 封装已按雨田 11-12 规定改为 0603，原理图和 PCB 封装待焊台同步。原行未标功率，0603 选用 100 mW，未自行降低。功率/介质：100mW 厚膜 ±100ppm/℃；标称公差：1%；嘉立创 SMT 库：基础库。人民币单价（SMT-CNY，嘉立创 SMT 的 LCSC 详情页）：1 只 未查到，10 只 未查到（SMT 页本次未取到 priceList）；LCSC 国际站单价（LCSC-USD）：1 只 未查到，10 只 未查到（最低起订 100，100 只档 $0.0021）；LCSC 国际站库存：1705000 只；立创店招实时人民币价：未查到；立创国内库存：未查到；查询时间：2026-11-12 01:07–01:10（Asia/Shanghai，CST）。 | 0402 已按雨田 11-12 规定改为 0603，待焊台同步原理图和 PCB | reviewed
R201 | 360 | 1 | no | /ADC and status returns/ | YAGEO | TBD |  |  | Resistor_SMD:R_0603_1608Metric |  | 1% | Input transient limiting; with original 100R gives 460R / 1n, tau about 0.46us. Not a 60V fault barrier. | exact YAGEO MPN pending
R202 | 360 | 1 | no | /ADC and status returns/ | YAGEO | TBD |  |  | Resistor_SMD:R_0603_1608Metric |  | 1% | Input transient limiting; with original 100R gives 460R / 1n, tau about 0.46us. Not a 60V fault barrier. | exact YAGEO MPN pending
R203 | 360 | 1 | no | /ADC and status returns/ | YAGEO | TBD |  |  | Resistor_SMD:R_0603_1608Metric |  | 1% | Input transient limiting; with original 100R gives 460R / 1n, tau about 0.46us. Not a 60V fault barrier. | exact YAGEO MPN pending
R204 | 360 | 1 | no | /ADC and status returns/ | YAGEO | TBD |  |  | Resistor_SMD:R_0603_1608Metric |  | 1% | Input transient limiting; with original 100R gives 460R / 1n, tau about 0.46us. Not a 60V fault barrier. | exact YAGEO MPN pending
R205 | 360 | 1 | no | /ADC and status returns/ | YAGEO | TBD |  |  | Resistor_SMD:R_0603_1608Metric |  | 1% | Input transient limiting; with original 100R gives 460R / 1n, tau about 0.46us. Not a 60V fault barrier. | exact YAGEO MPN pending
R206 | 360 | 1 | no | /ADC and status returns/ | YAGEO | TBD |  |  | Resistor_SMD:R_0603_1608Metric |  | 1% | Input transient limiting; with original 100R gives 460R / 1n, tau about 0.46us. Not a 60V fault barrier. | exact YAGEO MPN pending
R207 | 360 | 1 | no | /ADC and status returns/ | YAGEO | TBD |  |  | Resistor_SMD:R_0603_1608Metric |  | 1% | Input transient limiting; with original 100R gives 460R / 1n, tau about 0.46us. Not a 60V fault barrier. | exact YAGEO MPN pending
R208 | 360 | 1 | no | /ADC and status returns/ | YAGEO | TBD |  |  | Resistor_SMD:R_0603_1608Metric |  | 1% | Input transient limiting; with original 100R gives 460R / 1n, tau about 0.46us. Not a 60V fault barrier. | exact YAGEO MPN pending
R209 | 10k | 1 | no | /ADC and status returns/ | YAGEO | TBD |  |  | Resistor_SMD:R_0603_1608Metric |  |  | BASE_READY_MCU reads LOW if unplugged or the base output is unpowered.
R210 | 1k | 1 | no | /ADC and status returns/ | YAGEO | TBD |  |  | Resistor_SMD:R_0603_1608Metric |  | 1% | Return-status transient limiting; 1k with the 10k local pull gives valid logic levels. No isolation.
R211 | 1k | 1 | no | /ADC and status returns/ | YAGEO | TBD |  |  | Resistor_SMD:R_0603_1608Metric |  | 1% | Return-status transient limiting; 1k with the 10k local pull gives valid logic levels. No isolation.
J9 | ENC_A: PWR GND A B Z | 1 | no | /Encoders and SPI/ | HCTL | PZ127-1-05-Z | C5372828 | https://item.szlcsc.com/6225192.html | MyFootprints:HCTL_PZ127_1x05_P1.27mm_Drill0.70mm |  |  |  | compact mechanical engineering candidate; original pin order retained | reviewed
J10 | ENC_B: PWR GND A B Z | 1 | no | /Encoders and SPI/ | HCTL | PZ127-1-05-Z | C5372828 | https://item.szlcsc.com/6225192.html | MyFootprints:HCTL_PZ127_1x05_P1.27mm_Drill0.70mm |  |  |  | compact mechanical engineering candidate; original pin order retained | reviewed
J11 | SPI_A: PWR GND SCK MOSI MISO CS | 1 | no | /Encoders and SPI/ | HCTL | PZ127-1-06-Z | C5372829 | https://item.szlcsc.com/6225193.html | MyFootprints:HCTL_PZ127_1x06_P1.27mm_Drill0.70mm |  |  |  | compact mechanical engineering candidate; original pin order retained | reviewed
J12 | SPI_B: PWR GND SCK MOSI MISO CS | 1 | no | /Encoders and SPI/ | HCTL | PZ127-1-06-Z | C5372829 | https://item.szlcsc.com/6225193.html | MyFootprints:HCTL_PZ127_1x06_P1.27mm_Drill0.70mm |  |  |  | compact mechanical engineering candidate; original pin order retained | reviewed
R94 | 100 | 1 | no | /Encoders and SPI/ | UNI-ROYAL | 0603WAF1000T5E | C22775 | https://item.szlcsc.com/23502.html | MyFootprints:R_0603_1608Metric |  | 1% | 封装已按雨田 11-12 规定改为 0603，原理图和 PCB 封装待焊台同步。原行未标功率，0603 选用 100 mW，未自行降低。功率/介质：100mW 厚膜 ±100ppm/℃；标称公差：1%；嘉立创 SMT 库：基础库。人民币单价（SMT-CNY，嘉立创 SMT 的 LCSC 详情页）：1 只 未查到，10 只 未查到（SMT 页本次未取到 priceList）；LCSC 国际站单价（LCSC-USD）：1 只 未查到，10 只 未查到（最低起订 100，100 只档 $0.0021）；LCSC 国际站库存：1705000 只；立创店招实时人民币价：未查到；立创国内库存：未查到；查询时间：2026-11-12 01:07–01:10（Asia/Shanghai，CST）。 | 0402 已按雨田 11-12 规定改为 0603，待焊台同步原理图和 PCB | reviewed
R95 | 10k | 1 | no | /Encoders and SPI/ | UNI-ROYAL | 0603WAF1002T5E | C25804 | https://item.szlcsc.com/26547.html | MyFootprints:R_0603_1608Metric |  | 1% | For 3.3V open-collector/push-pull only; no 5V logic 封装已按雨田 11-12 规定改为 0603，原理图和 PCB 封装待焊台同步。原行未标功率，0603 选用 100 mW，未自行降低。功率/介质：100mW 厚膜 ±100ppm/℃；标称公差：1%；嘉立创 SMT 库：基础库。人民币单价（SMT-CNY，嘉立创 SMT 的 LCSC 详情页）：1 只 0.0133 元，10 只 0.0133 元；LCSC 国际站单价（LCSC-USD）：1 只 未查到，10 只 未查到（最低起订 100，100 只档 $0.0022）；LCSC 国际站库存：4632500 只；立创店招实时人民币价：未查到；立创国内库存：未查到；查询时间：2026-11-12 01:07–01:10（Asia/Shanghai，CST）。 | 0402 已按雨田 11-12 规定改为 0603，待焊台同步原理图和 PCB | reviewed
R96 | 100 | 1 | no | /Encoders and SPI/ | UNI-ROYAL | 0603WAF1000T5E | C22775 | https://item.szlcsc.com/23502.html | MyFootprints:R_0603_1608Metric |  | 1% | 封装已按雨田 11-12 规定改为 0603，原理图和 PCB 封装待焊台同步。原行未标功率，0603 选用 100 mW，未自行降低。功率/介质：100mW 厚膜 ±100ppm/℃；标称公差：1%；嘉立创 SMT 库：基础库。人民币单价（SMT-CNY，嘉立创 SMT 的 LCSC 详情页）：1 只 未查到，10 只 未查到（SMT 页本次未取到 priceList）；LCSC 国际站单价（LCSC-USD）：1 只 未查到，10 只 未查到（最低起订 100，100 只档 $0.0021）；LCSC 国际站库存：1705000 只；立创店招实时人民币价：未查到；立创国内库存：未查到；查询时间：2026-11-12 01:07–01:10（Asia/Shanghai，CST）。 | 0402 已按雨田 11-12 规定改为 0603，待焊台同步原理图和 PCB | reviewed
R97 | 10k | 1 | no | /Encoders and SPI/ | UNI-ROYAL | 0603WAF1002T5E | C25804 | https://item.szlcsc.com/26547.html | MyFootprints:R_0603_1608Metric |  | 1% | For 3.3V open-collector/push-pull only; no 5V logic 封装已按雨田 11-12 规定改为 0603，原理图和 PCB 封装待焊台同步。原行未标功率，0603 选用 100 mW，未自行降低。功率/介质：100mW 厚膜 ±100ppm/℃；标称公差：1%；嘉立创 SMT 库：基础库。人民币单价（SMT-CNY，嘉立创 SMT 的 LCSC 详情页）：1 只 0.0133 元，10 只 0.0133 元；LCSC 国际站单价（LCSC-USD）：1 只 未查到，10 只 未查到（最低起订 100，100 只档 $0.0022）；LCSC 国际站库存：4632500 只；立创店招实时人民币价：未查到；立创国内库存：未查到；查询时间：2026-11-12 01:07–01:10（Asia/Shanghai，CST）。 | 0402 已按雨田 11-12 规定改为 0603，待焊台同步原理图和 PCB | reviewed
R98 | 100 | 1 | no | /Encoders and SPI/ | UNI-ROYAL | 0603WAF1000T5E | C22775 | https://item.szlcsc.com/23502.html | MyFootprints:R_0603_1608Metric |  | 1% | 封装已按雨田 11-12 规定改为 0603，原理图和 PCB 封装待焊台同步。原行未标功率，0603 选用 100 mW，未自行降低。功率/介质：100mW 厚膜 ±100ppm/℃；标称公差：1%；嘉立创 SMT 库：基础库。人民币单价（SMT-CNY，嘉立创 SMT 的 LCSC 详情页）：1 只 未查到，10 只 未查到（SMT 页本次未取到 priceList）；LCSC 国际站单价（LCSC-USD）：1 只 未查到，10 只 未查到（最低起订 100，100 只档 $0.0021）；LCSC 国际站库存：1705000 只；立创店招实时人民币价：未查到；立创国内库存：未查到；查询时间：2026-11-12 01:07–01:10（Asia/Shanghai，CST）。 | 0402 已按雨田 11-12 规定改为 0603，待焊台同步原理图和 PCB | reviewed
R99 | 10k | 1 | no | /Encoders and SPI/ | UNI-ROYAL | 0603WAF1002T5E | C25804 | https://item.szlcsc.com/26547.html | MyFootprints:R_0603_1608Metric |  | 1% | For 3.3V open-collector/push-pull only; no 5V logic 封装已按雨田 11-12 规定改为 0603，原理图和 PCB 封装待焊台同步。原行未标功率，0603 选用 100 mW，未自行降低。功率/介质：100mW 厚膜 ±100ppm/℃；标称公差：1%；嘉立创 SMT 库：基础库。人民币单价（SMT-CNY，嘉立创 SMT 的 LCSC 详情页）：1 只 0.0133 元，10 只 0.0133 元；LCSC 国际站单价（LCSC-USD）：1 只 未查到，10 只 未查到（最低起订 100，100 只档 $0.0022）；LCSC 国际站库存：4632500 只；立创店招实时人民币价：未查到；立创国内库存：未查到；查询时间：2026-11-12 01:07–01:10（Asia/Shanghai，CST）。 | 0402 已按雨田 11-12 规定改为 0603，待焊台同步原理图和 PCB | reviewed
R100 | 0 | 1 | yes | /Encoders and SPI/ | UNI-ROYAL | 0603WAF0000T5E | C21189 | https://item.szlcsc.com/21903.html | MyFootprints:R_0603_1608Metric |  | 1% | DNP until encoder power/output stage selected; 5V supply is not 5V logic compatibility 封装已按雨田 11-12 规定改为 0603，原理图和 PCB 封装待焊台同步。原行未标功率，0603 选用 100 mW，未自行降低。功率/介质：100mW 厚膜；标称公差：1%；嘉立创 SMT 库：嘉立创基础库。人民币单价（SMT-CNY，嘉立创 SMT 的 LCSC 详情页）：1 只 0.013 元，10 只 0.013 元；LCSC 国际站单价（LCSC-USD）：1 只 未查到，10 只 未查到（最低起订 100，100 只档 $0.0021）；LCSC 国际站库存：8990100 只；立创店招实时人民币价：未查到；立创国内库存：未查到；查询时间：2026-11-12 01:07–01:10（Asia/Shanghai，CST）。 | 0402 已按雨田 11-12 规定改为 0603，待焊台同步原理图和 PCB | reviewed
R101 | 100 | 1 | no | /Encoders and SPI/ | UNI-ROYAL | 0603WAF1000T5E | C22775 | https://item.szlcsc.com/23502.html | MyFootprints:R_0603_1608Metric |  | 1% | 封装已按雨田 11-12 规定改为 0603，原理图和 PCB 封装待焊台同步。原行未标功率，0603 选用 100 mW，未自行降低。功率/介质：100mW 厚膜 ±100ppm/℃；标称公差：1%；嘉立创 SMT 库：基础库。人民币单价（SMT-CNY，嘉立创 SMT 的 LCSC 详情页）：1 只 未查到，10 只 未查到（SMT 页本次未取到 priceList）；LCSC 国际站单价（LCSC-USD）：1 只 未查到，10 只 未查到（最低起订 100，100 只档 $0.0021）；LCSC 国际站库存：1705000 只；立创店招实时人民币价：未查到；立创国内库存：未查到；查询时间：2026-11-12 01:07–01:10（Asia/Shanghai，CST）。 | 0402 已按雨田 11-12 规定改为 0603，待焊台同步原理图和 PCB | reviewed
R102 | 10k | 1 | no | /Encoders and SPI/ | UNI-ROYAL | 0603WAF1002T5E | C25804 | https://item.szlcsc.com/26547.html | MyFootprints:R_0603_1608Metric |  | 1% | For 3.3V open-collector/push-pull only; no 5V logic 封装已按雨田 11-12 规定改为 0603，原理图和 PCB 封装待焊台同步。原行未标功率，0603 选用 100 mW，未自行降低。功率/介质：100mW 厚膜 ±100ppm/℃；标称公差：1%；嘉立创 SMT 库：基础库。人民币单价（SMT-CNY，嘉立创 SMT 的 LCSC 详情页）：1 只 0.0133 元，10 只 0.0133 元；LCSC 国际站单价（LCSC-USD）：1 只 未查到，10 只 未查到（最低起订 100，100 只档 $0.0022）；LCSC 国际站库存：4632500 只；立创店招实时人民币价：未查到；立创国内库存：未查到；查询时间：2026-11-12 01:07–01:10（Asia/Shanghai，CST）。 | 0402 已按雨田 11-12 规定改为 0603，待焊台同步原理图和 PCB | reviewed
R103 | 100 | 1 | no | /Encoders and SPI/ | UNI-ROYAL | 0603WAF1000T5E | C22775 | https://item.szlcsc.com/23502.html | MyFootprints:R_0603_1608Metric |  | 1% | 封装已按雨田 11-12 规定改为 0603，原理图和 PCB 封装待焊台同步。原行未标功率，0603 选用 100 mW，未自行降低。功率/介质：100mW 厚膜 ±100ppm/℃；标称公差：1%；嘉立创 SMT 库：基础库。人民币单价（SMT-CNY，嘉立创 SMT 的 LCSC 详情页）：1 只 未查到，10 只 未查到（SMT 页本次未取到 priceList）；LCSC 国际站单价（LCSC-USD）：1 只 未查到，10 只 未查到（最低起订 100，100 只档 $0.0021）；LCSC 国际站库存：1705000 只；立创店招实时人民币价：未查到；立创国内库存：未查到；查询时间：2026-11-12 01:07–01:10（Asia/Shanghai，CST）。 | 0402 已按雨田 11-12 规定改为 0603，待焊台同步原理图和 PCB | reviewed
R104 | 10k | 1 | no | /Encoders and SPI/ | UNI-ROYAL | 0603WAF1002T5E | C25804 | https://item.szlcsc.com/26547.html | MyFootprints:R_0603_1608Metric |  | 1% | For 3.3V open-collector/push-pull only; no 5V logic 封装已按雨田 11-12 规定改为 0603，原理图和 PCB 封装待焊台同步。原行未标功率，0603 选用 100 mW，未自行降低。功率/介质：100mW 厚膜 ±100ppm/℃；标称公差：1%；嘉立创 SMT 库：基础库。人民币单价（SMT-CNY，嘉立创 SMT 的 LCSC 详情页）：1 只 0.0133 元，10 只 0.0133 元；LCSC 国际站单价（LCSC-USD）：1 只 未查到，10 只 未查到（最低起订 100，100 只档 $0.0022）；LCSC 国际站库存：4632500 只；立创店招实时人民币价：未查到；立创国内库存：未查到；查询时间：2026-11-12 01:07–01:10（Asia/Shanghai，CST）。 | 0402 已按雨田 11-12 规定改为 0603，待焊台同步原理图和 PCB | reviewed
R105 | 100 | 1 | no | /Encoders and SPI/ | UNI-ROYAL | 0603WAF1000T5E | C22775 | https://item.szlcsc.com/23502.html | MyFootprints:R_0603_1608Metric |  | 1% | 封装已按雨田 11-12 规定改为 0603，原理图和 PCB 封装待焊台同步。原行未标功率，0603 选用 100 mW，未自行降低。功率/介质：100mW 厚膜 ±100ppm/℃；标称公差：1%；嘉立创 SMT 库：基础库。人民币单价（SMT-CNY，嘉立创 SMT 的 LCSC 详情页）：1 只 未查到，10 只 未查到（SMT 页本次未取到 priceList）；LCSC 国际站单价（LCSC-USD）：1 只 未查到，10 只 未查到（最低起订 100，100 只档 $0.0021）；LCSC 国际站库存：1705000 只；立创店招实时人民币价：未查到；立创国内库存：未查到；查询时间：2026-11-12 01:07–01:10（Asia/Shanghai，CST）。 | 0402 已按雨田 11-12 规定改为 0603，待焊台同步原理图和 PCB | reviewed
R106 | 10k | 1 | no | /Encoders and SPI/ | UNI-ROYAL | 0603WAF1002T5E | C25804 | https://item.szlcsc.com/26547.html | MyFootprints:R_0603_1608Metric |  | 1% | For 3.3V open-collector/push-pull only; no 5V logic 封装已按雨田 11-12 规定改为 0603，原理图和 PCB 封装待焊台同步。原行未标功率，0603 选用 100 mW，未自行降低。功率/介质：100mW 厚膜 ±100ppm/℃；标称公差：1%；嘉立创 SMT 库：基础库。人民币单价（SMT-CNY，嘉立创 SMT 的 LCSC 详情页）：1 只 0.0133 元，10 只 0.0133 元；LCSC 国际站单价（LCSC-USD）：1 只 未查到，10 只 未查到（最低起订 100，100 只档 $0.0022）；LCSC 国际站库存：4632500 只；立创店招实时人民币价：未查到；立创国内库存：未查到；查询时间：2026-11-12 01:07–01:10（Asia/Shanghai，CST）。 | 0402 已按雨田 11-12 规定改为 0603，待焊台同步原理图和 PCB | reviewed
R107 | 0 | 1 | yes | /Encoders and SPI/ | UNI-ROYAL | 0603WAF0000T5E | C21189 | https://item.szlcsc.com/21903.html | MyFootprints:R_0603_1608Metric |  | 1% | DNP until encoder power/output stage selected; 5V supply is not 5V logic compatibility 封装已按雨田 11-12 规定改为 0603，原理图和 PCB 封装待焊台同步。原行未标功率，0603 选用 100 mW，未自行降低。功率/介质：100mW 厚膜；标称公差：1%；嘉立创 SMT 库：嘉立创基础库。人民币单价（SMT-CNY，嘉立创 SMT 的 LCSC 详情页）：1 只 0.013 元，10 只 0.013 元；LCSC 国际站单价（LCSC-USD）：1 只 未查到，10 只 未查到（最低起订 100，100 只档 $0.0021）；LCSC 国际站库存：8990100 只；立创店招实时人民币价：未查到；立创国内库存：未查到；查询时间：2026-11-12 01:07–01:10（Asia/Shanghai，CST）。 | 0402 已按雨田 11-12 规定改为 0603，待焊台同步原理图和 PCB | reviewed
R108 | 33 | 1 | no | /Encoders and SPI/ | UNI-ROYAL | 0603WAF330JT5E | C23140 | https://item.szlcsc.com/23867.html | MyFootprints:R_0603_1608Metric |  | 1% | 封装已按雨田 11-12 规定改为 0603，原理图和 PCB 封装待焊台同步。原行未标功率，0603 选用 100 mW，未自行降低。功率/介质：100mW 厚膜 ±100ppm/℃；标称公差：1%；嘉立创 SMT 库：基础库。人民币单价（SMT-CNY，嘉立创 SMT 的 LCSC 详情页）：1 只 0.0142 元，10 只 0.0142 元；LCSC 国际站单价（LCSC-USD）：1 只 未查到，10 只 未查到（最低起订 100，100 只档 $0.0024）；LCSC 国际站库存：1229500 只；立创店招实时人民币价：未查到；立创国内库存：未查到；查询时间：2026-11-12 01:07–01:10（Asia/Shanghai，CST）。 | 0402 已按雨田 11-12 规定改为 0603，待焊台同步原理图和 PCB | reviewed
R109 | 33 | 1 | no | /Encoders and SPI/ | UNI-ROYAL | 0603WAF330JT5E | C23140 | https://item.szlcsc.com/23867.html | MyFootprints:R_0603_1608Metric |  | 1% | 封装已按雨田 11-12 规定改为 0603，原理图和 PCB 封装待焊台同步。原行未标功率，0603 选用 100 mW，未自行降低。功率/介质：100mW 厚膜 ±100ppm/℃；标称公差：1%；嘉立创 SMT 库：基础库。人民币单价（SMT-CNY，嘉立创 SMT 的 LCSC 详情页）：1 只 0.0142 元，10 只 0.0142 元；LCSC 国际站单价（LCSC-USD）：1 只 未查到，10 只 未查到（最低起订 100，100 只档 $0.0024）；LCSC 国际站库存：1229500 只；立创店招实时人民币价：未查到；立创国内库存：未查到；查询时间：2026-11-12 01:07–01:10（Asia/Shanghai，CST）。 | 0402 已按雨田 11-12 规定改为 0603，待焊台同步原理图和 PCB | reviewed
R110 | 33 | 1 | no | /Encoders and SPI/ | UNI-ROYAL | 0603WAF330JT5E | C23140 | https://item.szlcsc.com/23867.html | MyFootprints:R_0603_1608Metric |  | 1% | 封装已按雨田 11-12 规定改为 0603，原理图和 PCB 封装待焊台同步。原行未标功率，0603 选用 100 mW，未自行降低。功率/介质：100mW 厚膜 ±100ppm/℃；标称公差：1%；嘉立创 SMT 库：基础库。人民币单价（SMT-CNY，嘉立创 SMT 的 LCSC 详情页）：1 只 0.0142 元，10 只 0.0142 元；LCSC 国际站单价（LCSC-USD）：1 只 未查到，10 只 未查到（最低起订 100，100 只档 $0.0024）；LCSC 国际站库存：1229500 只；立创店招实时人民币价：未查到；立创国内库存：未查到；查询时间：2026-11-12 01:07–01:10（Asia/Shanghai，CST）。 | 0402 已按雨田 11-12 规定改为 0603，待焊台同步原理图和 PCB | reviewed
R111 | 33 | 1 | no | /Encoders and SPI/ | UNI-ROYAL | 0603WAF330JT5E | C23140 | https://item.szlcsc.com/23867.html | MyFootprints:R_0603_1608Metric |  | 1% | 封装已按雨田 11-12 规定改为 0603，原理图和 PCB 封装待焊台同步。原行未标功率，0603 选用 100 mW，未自行降低。功率/介质：100mW 厚膜 ±100ppm/℃；标称公差：1%；嘉立创 SMT 库：基础库。人民币单价（SMT-CNY，嘉立创 SMT 的 LCSC 详情页）：1 只 0.0142 元，10 只 0.0142 元；LCSC 国际站单价（LCSC-USD）：1 只 未查到，10 只 未查到（最低起订 100，100 只档 $0.0024）；LCSC 国际站库存：1229500 只；立创店招实时人民币价：未查到；立创国内库存：未查到；查询时间：2026-11-12 01:07–01:10（Asia/Shanghai，CST）。 | 0402 已按雨田 11-12 规定改为 0603，待焊台同步原理图和 PCB | reviewed
R112 | 10k | 1 | no | /Encoders and SPI/ | UNI-ROYAL | 0603WAF1002T5E | C25804 | https://item.szlcsc.com/26547.html | MyFootprints:R_0603_1608Metric |  | 1% | 封装已按雨田 11-12 规定改为 0603，原理图和 PCB 封装待焊台同步。原行未标功率，0603 选用 100 mW，未自行降低。功率/介质：100mW 厚膜 ±100ppm/℃；标称公差：1%；嘉立创 SMT 库：基础库。人民币单价（SMT-CNY，嘉立创 SMT 的 LCSC 详情页）：1 只 0.0133 元，10 只 0.0133 元；LCSC 国际站单价（LCSC-USD）：1 只 未查到，10 只 未查到（最低起订 100，100 只档 $0.0022）；LCSC 国际站库存：4632500 只；立创店招实时人民币价：未查到；立创国内库存：未查到；查询时间：2026-11-12 01:07–01:10（Asia/Shanghai，CST）。 | 0402 已按雨田 11-12 规定改为 0603，待焊台同步原理图和 PCB | reviewed
R113 | 0 | 1 | yes | /Encoders and SPI/ | UNI-ROYAL | 0603WAF0000T5E | C21189 | https://item.szlcsc.com/21903.html | MyFootprints:R_0603_1608Metric |  | 1% | DNP until external module is selected; IO stays 3.3V 封装已按雨田 11-12 规定改为 0603，原理图和 PCB 封装待焊台同步。原行未标功率，0603 选用 100 mW，未自行降低。功率/介质：100mW 厚膜；标称公差：1%；嘉立创 SMT 库：嘉立创基础库。人民币单价（SMT-CNY，嘉立创 SMT 的 LCSC 详情页）：1 只 0.013 元，10 只 0.013 元；LCSC 国际站单价（LCSC-USD）：1 只 未查到，10 只 未查到（最低起订 100，100 只档 $0.0021）；LCSC 国际站库存：8990100 只；立创店招实时人民币价：未查到；立创国内库存：未查到；查询时间：2026-11-12 01:07–01:10（Asia/Shanghai，CST）。 | 0402 已按雨田 11-12 规定改为 0603，待焊台同步原理图和 PCB | reviewed
R114 | 33 | 1 | no | /Encoders and SPI/ | UNI-ROYAL | 0603WAF330JT5E | C23140 | https://item.szlcsc.com/23867.html | MyFootprints:R_0603_1608Metric |  | 1% | 封装已按雨田 11-12 规定改为 0603，原理图和 PCB 封装待焊台同步。原行未标功率，0603 选用 100 mW，未自行降低。功率/介质：100mW 厚膜 ±100ppm/℃；标称公差：1%；嘉立创 SMT 库：基础库。人民币单价（SMT-CNY，嘉立创 SMT 的 LCSC 详情页）：1 只 0.0142 元，10 只 0.0142 元；LCSC 国际站单价（LCSC-USD）：1 只 未查到，10 只 未查到（最低起订 100，100 只档 $0.0024）；LCSC 国际站库存：1229500 只；立创店招实时人民币价：未查到；立创国内库存：未查到；查询时间：2026-11-12 01:07–01:10（Asia/Shanghai，CST）。 | 0402 已按雨田 11-12 规定改为 0603，待焊台同步原理图和 PCB | reviewed
R115 | 33 | 1 | no | /Encoders and SPI/ | UNI-ROYAL | 0603WAF330JT5E | C23140 | https://item.szlcsc.com/23867.html | MyFootprints:R_0603_1608Metric |  | 1% | 封装已按雨田 11-12 规定改为 0603，原理图和 PCB 封装待焊台同步。原行未标功率，0603 选用 100 mW，未自行降低。功率/介质：100mW 厚膜 ±100ppm/℃；标称公差：1%；嘉立创 SMT 库：基础库。人民币单价（SMT-CNY，嘉立创 SMT 的 LCSC 详情页）：1 只 0.0142 元，10 只 0.0142 元；LCSC 国际站单价（LCSC-USD）：1 只 未查到，10 只 未查到（最低起订 100，100 只档 $0.0024）；LCSC 国际站库存：1229500 只；立创店招实时人民币价：未查到；立创国内库存：未查到；查询时间：2026-11-12 01:07–01:10（Asia/Shanghai，CST）。 | 0402 已按雨田 11-12 规定改为 0603，待焊台同步原理图和 PCB | reviewed
R116 | 33 | 1 | no | /Encoders and SPI/ | UNI-ROYAL | 0603WAF330JT5E | C23140 | https://item.szlcsc.com/23867.html | MyFootprints:R_0603_1608Metric |  | 1% | 封装已按雨田 11-12 规定改为 0603，原理图和 PCB 封装待焊台同步。原行未标功率，0603 选用 100 mW，未自行降低。功率/介质：100mW 厚膜 ±100ppm/℃；标称公差：1%；嘉立创 SMT 库：基础库。人民币单价（SMT-CNY，嘉立创 SMT 的 LCSC 详情页）：1 只 0.0142 元，10 只 0.0142 元；LCSC 国际站单价（LCSC-USD）：1 只 未查到，10 只 未查到（最低起订 100，100 只档 $0.0024）；LCSC 国际站库存：1229500 只；立创店招实时人民币价：未查到；立创国内库存：未查到；查询时间：2026-11-12 01:07–01:10（Asia/Shanghai，CST）。 | 0402 已按雨田 11-12 规定改为 0603，待焊台同步原理图和 PCB | reviewed
R117 | 33 | 1 | no | /Encoders and SPI/ | UNI-ROYAL | 0603WAF330JT5E | C23140 | https://item.szlcsc.com/23867.html | MyFootprints:R_0603_1608Metric |  | 1% | 封装已按雨田 11-12 规定改为 0603，原理图和 PCB 封装待焊台同步。原行未标功率，0603 选用 100 mW，未自行降低。功率/介质：100mW 厚膜 ±100ppm/℃；标称公差：1%；嘉立创 SMT 库：基础库。人民币单价（SMT-CNY，嘉立创 SMT 的 LCSC 详情页）：1 只 0.0142 元，10 只 0.0142 元；LCSC 国际站单价（LCSC-USD）：1 只 未查到，10 只 未查到（最低起订 100，100 只档 $0.0024）；LCSC 国际站库存：1229500 只；立创店招实时人民币价：未查到；立创国内库存：未查到；查询时间：2026-11-12 01:07–01:10（Asia/Shanghai，CST）。 | 0402 已按雨田 11-12 规定改为 0603，待焊台同步原理图和 PCB | reviewed
R118 | 10k | 1 | no | /Encoders and SPI/ | UNI-ROYAL | 0603WAF1002T5E | C25804 | https://item.szlcsc.com/26547.html | MyFootprints:R_0603_1608Metric |  | 1% | 封装已按雨田 11-12 规定改为 0603，原理图和 PCB 封装待焊台同步。原行未标功率，0603 选用 100 mW，未自行降低。功率/介质：100mW 厚膜 ±100ppm/℃；标称公差：1%；嘉立创 SMT 库：基础库。人民币单价（SMT-CNY，嘉立创 SMT 的 LCSC 详情页）：1 只 0.0133 元，10 只 0.0133 元；LCSC 国际站单价（LCSC-USD）：1 只 未查到，10 只 未查到（最低起订 100，100 只档 $0.0022）；LCSC 国际站库存：4632500 只；立创店招实时人民币价：未查到；立创国内库存：未查到；查询时间：2026-11-12 01:07–01:10（Asia/Shanghai，CST）。 | 0402 已按雨田 11-12 规定改为 0603，待焊台同步原理图和 PCB | reviewed
R119 | 0 | 1 | yes | /Encoders and SPI/ | UNI-ROYAL | 0603WAF0000T5E | C21189 | https://item.szlcsc.com/21903.html | MyFootprints:R_0603_1608Metric |  | 1% | DNP until external module is selected; IO stays 3.3V 封装已按雨田 11-12 规定改为 0603，原理图和 PCB 封装待焊台同步。原行未标功率，0603 选用 100 mW，未自行降低。功率/介质：100mW 厚膜；标称公差：1%；嘉立创 SMT 库：嘉立创基础库。人民币单价（SMT-CNY，嘉立创 SMT 的 LCSC 详情页）：1 只 0.013 元，10 只 0.013 元；LCSC 国际站单价（LCSC-USD）：1 只 未查到，10 只 未查到（最低起订 100，100 只档 $0.0021）；LCSC 国际站库存：8990100 只；立创店招实时人民币价：未查到；立创国内库存：未查到；查询时间：2026-11-12 01:07–01:10（Asia/Shanghai，CST）。 | 0402 已按雨田 11-12 规定改为 0603，待焊台同步原理图和 PCB | reviewed
C82 | 100n | 1 | yes | /SWD UART CAN and status/ | YAGEO | CC0603KRX7R9BB104 | C14663 | https://item.szlcsc.com/15331.html | MyFootprints:C_0603_1608Metric | 50V | 10% | 封装已按雨田 11-12 规定改为 0603，原理图和 PCB 封装待焊台同步。0603 选用 50V，电压未降低；原行未标公差，采用下列标称公差。功率/介质：X7R 50V；标称公差：10%；嘉立创 SMT 库：基础库。人民币单价（SMT-CNY，嘉立创 SMT 的 LCSC 详情页）：1 只 0.0376 元，10 只 0.0376 元（1–999 同一档）；LCSC 国际站单价（LCSC-USD）：1 只 未查到，10 只 未查到（最低起订 100，100 只档 $0.0063）；LCSC 国际站库存：0 只；立创店招实时人民币价：未查到；立创国内库存：未查到；查询时间：2026-11-12 01:07–01:10（Asia/Shanghai，CST）。与板上已定 100n 0603 同一料，避免同板混料。 | 0402 已按雨田 11-12 规定改为 0603，待焊台同步原理图和 PCB | reviewed
D4 | LED_RUN | 1 | no | /SWD UART CAN and status/ |  | TBD |  |  | LED_SMD:LED_0603_1608Metric |  |  |  | color/MPN pending
D5 | LED_FAULT | 1 | no | /SWD UART CAN and status/ |  | TBD |  |  | LED_SMD:LED_0603_1608Metric |  |  |  | color/MPN pending
D6 | LED_COMM | 1 | no | /SWD UART CAN and status/ |  | TBD |  |  | LED_SMD:LED_0603_1608Metric |  |  |  | color/MPN pending
D7 | LED_AUX | 1 | no | /SWD UART CAN and status/ |  | TBD |  |  | LED_SMD:LED_0603_1608Metric |  |  |  | color/MPN pending
J13 | SWD: VTREF IO CLK GND NRST | 1 | no | /SWD UART CAN and status/ | HCTL | PZ127-1-05-Z | C5372828 | https://item.szlcsc.com/6225192.html | MyFootprints:HCTL_PZ127_1x05_P1.27mm_Drill0.70mm |  |  |  | compact mechanical engineering candidate; original pin order retained | reviewed
J14 | TTL: TX RX GND | 1 | no | /SWD UART CAN and status/ | HCTL | PZ127-1-03-Z | C5372826 | https://item.szlcsc.com/6225190.html | MyFootprints:HCTL_PZ127_1x03_P1.27mm_Drill0.70mm |  |  |  | compact mechanical engineering candidate; original pin order retained | reviewed
J15 | CAN: H L GND | 1 | yes | /SWD UART CAN and status/ | HCTL | PZ127-1-03-Z | C5372826 | https://item.szlcsc.com/6225190.html | MyFootprints:HCTL_PZ127_1x03_P1.27mm_Drill0.70mm |  |  |  | compact mechanical engineering candidate; original pin order retained | reviewed
R120 | 33 | 1 | no | /SWD UART CAN and status/ | UNI-ROYAL | 0603WAF330JT5E | C23140 | https://item.szlcsc.com/23867.html | MyFootprints:R_0603_1608Metric |  | 1% | 封装已按雨田 11-12 规定改为 0603，原理图和 PCB 封装待焊台同步。原行未标功率，0603 选用 100 mW，未自行降低。功率/介质：100mW 厚膜 ±100ppm/℃；标称公差：1%；嘉立创 SMT 库：基础库。人民币单价（SMT-CNY，嘉立创 SMT 的 LCSC 详情页）：1 只 0.0142 元，10 只 0.0142 元；LCSC 国际站单价（LCSC-USD）：1 只 未查到，10 只 未查到（最低起订 100，100 只档 $0.0024）；LCSC 国际站库存：1229500 只；立创店招实时人民币价：未查到；立创国内库存：未查到；查询时间：2026-11-12 01:07–01:10（Asia/Shanghai，CST）。 | 0402 已按雨田 11-12 规定改为 0603，待焊台同步原理图和 PCB | reviewed
R121 | 33 | 1 | no | /SWD UART CAN and status/ | UNI-ROYAL | 0603WAF330JT5E | C23140 | https://item.szlcsc.com/23867.html | MyFootprints:R_0603_1608Metric |  | 1% | 封装已按雨田 11-12 规定改为 0603，原理图和 PCB 封装待焊台同步。原行未标功率，0603 选用 100 mW，未自行降低。功率/介质：100mW 厚膜 ±100ppm/℃；标称公差：1%；嘉立创 SMT 库：基础库。人民币单价（SMT-CNY，嘉立创 SMT 的 LCSC 详情页）：1 只 0.0142 元，10 只 0.0142 元；LCSC 国际站单价（LCSC-USD）：1 只 未查到，10 只 未查到（最低起订 100，100 只档 $0.0024）；LCSC 国际站库存：1229500 只；立创店招实时人民币价：未查到；立创国内库存：未查到；查询时间：2026-11-12 01:07–01:10（Asia/Shanghai，CST）。 | 0402 已按雨田 11-12 规定改为 0603，待焊台同步原理图和 PCB | reviewed
R123 | 33 | 1 | no | /SWD UART CAN and status/ | UNI-ROYAL | 0603WAF330JT5E | C23140 | https://item.szlcsc.com/23867.html | MyFootprints:R_0603_1608Metric |  | 1% | 封装已按雨田 11-12 规定改为 0603，原理图和 PCB 封装待焊台同步。原行未标功率，0603 选用 100 mW，未自行降低。功率/介质：100mW 厚膜 ±100ppm/℃；标称公差：1%；嘉立创 SMT 库：基础库。人民币单价（SMT-CNY，嘉立创 SMT 的 LCSC 详情页）：1 只 0.0142 元，10 只 0.0142 元；LCSC 国际站单价（LCSC-USD）：1 只 未查到，10 只 未查到（最低起订 100，100 只档 $0.0024）；LCSC 国际站库存：1229500 只；立创店招实时人民币价：未查到；立创国内库存：未查到；查询时间：2026-11-12 01:07–01:10（Asia/Shanghai，CST）。 | 0402 已按雨田 11-12 规定改为 0603，待焊台同步原理图和 PCB | reviewed
R124 | 100 | 1 | no | /SWD UART CAN and status/ | UNI-ROYAL | 0603WAF1000T5E | C22775 | https://item.szlcsc.com/23502.html | MyFootprints:R_0603_1608Metric |  | 1% | 封装已按雨田 11-12 规定改为 0603，原理图和 PCB 封装待焊台同步。原行未标功率，0603 选用 100 mW，未自行降低。功率/介质：100mW 厚膜 ±100ppm/℃；标称公差：1%；嘉立创 SMT 库：基础库。人民币单价（SMT-CNY，嘉立创 SMT 的 LCSC 详情页）：1 只 未查到，10 只 未查到（SMT 页本次未取到 priceList）；LCSC 国际站单价（LCSC-USD）：1 只 未查到，10 只 未查到（最低起订 100，100 只档 $0.0021）；LCSC 国际站库存：1705000 只；立创店招实时人民币价：未查到；立创国内库存：未查到；查询时间：2026-11-12 01:07–01:10（Asia/Shanghai，CST）。 | 0402 已按雨田 11-12 规定改为 0603，待焊台同步原理图和 PCB | reviewed
R125 | 10k | 1 | no | /SWD UART CAN and status/ | UNI-ROYAL | 0603WAF1002T5E | C25804 | https://item.szlcsc.com/26547.html | MyFootprints:R_0603_1608Metric |  | 1% | 封装已按雨田 11-12 规定改为 0603，原理图和 PCB 封装待焊台同步。原行未标功率，0603 选用 100 mW，未自行降低。功率/介质：100mW 厚膜 ±100ppm/℃；标称公差：1%；嘉立创 SMT 库：基础库。人民币单价（SMT-CNY，嘉立创 SMT 的 LCSC 详情页）：1 只 0.0133 元，10 只 0.0133 元；LCSC 国际站单价（LCSC-USD）：1 只 未查到，10 只 未查到（最低起订 100，100 只档 $0.0022）；LCSC 国际站库存：4632500 只；立创店招实时人民币价：未查到；立创国内库存：未查到；查询时间：2026-11-12 01:07–01:10（Asia/Shanghai，CST）。 | 0402 已按雨田 11-12 规定改为 0603，待焊台同步原理图和 PCB | reviewed
R126 | 0 | 1 | yes | /SWD UART CAN and status/ | UNI-ROYAL | 0603WAF0000T5E | C21189 | https://item.szlcsc.com/21903.html | MyFootprints:R_0603_1608Metric |  | 1% | 封装已按雨田 11-12 规定改为 0603，原理图和 PCB 封装待焊台同步。原行未标功率，0603 选用 100 mW，未自行降低。功率/介质：100mW 厚膜；标称公差：1%；嘉立创 SMT 库：嘉立创基础库。人民币单价（SMT-CNY，嘉立创 SMT 的 LCSC 详情页）：1 只 0.013 元，10 只 0.013 元；LCSC 国际站单价（LCSC-USD）：1 只 未查到，10 只 未查到（最低起订 100，100 只档 $0.0021）；LCSC 国际站库存：8990100 只；立创店招实时人民币价：未查到；立创国内库存：未查到；查询时间：2026-11-12 01:07–01:10（Asia/Shanghai，CST）。 | 0402 已按雨田 11-12 规定改为 0603，待焊台同步原理图和 PCB | reviewed
R127 | 0 | 1 | yes | /SWD UART CAN and status/ | UNI-ROYAL | 0603WAF0000T5E | C21189 | https://item.szlcsc.com/21903.html | MyFootprints:R_0603_1608Metric |  | 1% | 封装已按雨田 11-12 规定改为 0603，原理图和 PCB 封装待焊台同步。原行未标功率，0603 选用 100 mW，未自行降低。功率/介质：100mW 厚膜；标称公差：1%；嘉立创 SMT 库：嘉立创基础库。人民币单价（SMT-CNY，嘉立创 SMT 的 LCSC 详情页）：1 只 0.013 元，10 只 0.013 元；LCSC 国际站单价（LCSC-USD）：1 只 未查到，10 只 未查到（最低起订 100，100 只档 $0.0021）；LCSC 国际站库存：8990100 只；立创店招实时人民币价：未查到；立创国内库存：未查到；查询时间：2026-11-12 01:07–01:10（Asia/Shanghai，CST）。 | 0402 已按雨田 11-12 规定改为 0603，待焊台同步原理图和 PCB | reviewed
R128 | 10k | 1 | yes | /SWD UART CAN and status/ | UNI-ROYAL | 0603WAF1002T5E | C25804 | https://item.szlcsc.com/26547.html | MyFootprints:R_0603_1608Metric |  | 1% | 封装已按雨田 11-12 规定改为 0603，原理图和 PCB 封装待焊台同步。原行未标功率，0603 选用 100 mW，未自行降低。功率/介质：100mW 厚膜 ±100ppm/℃；标称公差：1%；嘉立创 SMT 库：基础库。人民币单价（SMT-CNY，嘉立创 SMT 的 LCSC 详情页）：1 只 0.0133 元，10 只 0.0133 元；LCSC 国际站单价（LCSC-USD）：1 只 未查到，10 只 未查到（最低起订 100，100 只档 $0.0022）；LCSC 国际站库存：4632500 只；立创店招实时人民币价：未查到；立创国内库存：未查到；查询时间：2026-11-12 01:07–01:10（Asia/Shanghai，CST）。 | 0402 已按雨田 11-12 规定改为 0603，待焊台同步原理图和 PCB | reviewed
R129 | 120 | 1 | yes | /SWD UART CAN and status/ | UNI-ROYAL | 0603WAF1200T5E | C22787 | https://item.szlcsc.com/23514.html | MyFootprints:R_0603_1608Metric |  | 1% | Fit only at bus end; CAN PHY is classic <=1Mbps, not CAN-FD rated 封装已按雨田 11-12 规定改为 0603，原理图和 PCB 封装待焊台同步。原行未标功率，0603 选用 100 mW，未自行降低。功率/介质：100mW 厚膜 ±100ppm/℃；标称公差：1%；嘉立创 SMT 库：基础库。人民币单价（SMT-CNY，嘉立创 SMT 的 LCSC 详情页）：1 只 0.0117 元，10 只 0.0117 元；LCSC 国际站单价（LCSC-USD）：1 只 未查到，10 只 未查到（最低起订 100，100 只档 $0.0020）；LCSC 国际站库存：1030400 只；立创店招实时人民币价：未查到；立创国内库存：未查到；查询时间：2026-11-12 01:07–01:10（Asia/Shanghai，CST）。 | 0402 已按雨田 11-12 规定改为 0603，待焊台同步原理图和 PCB | reviewed
R131 | 2.2k | 1 | no | /SWD UART CAN and status/ | UNI-ROYAL | 0603WAF2201T5E | C4190 | https://item.szlcsc.com/4597.html | MyFootprints:R_0603_1608Metric |  | 1% | 封装已按雨田 11-12 规定改为 0603，原理图和 PCB 封装待焊台同步。原行未标功率，0603 选用 100 mW，未自行降低。功率/介质：100mW 厚膜 ±100ppm/℃；标称公差：1%；嘉立创 SMT 库：基础库。人民币单价（SMT-CNY，嘉立创 SMT 的 LCSC 详情页）：1 只 0.0109 元，10 只 0.0109 元；LCSC 国际站单价（LCSC-USD）：1 只 未查到，10 只 未查到（最低起订 100，100 只档 $0.0019）；LCSC 国际站库存：2080900 只；立创店招实时人民币价：未查到；立创国内库存：未查到；查询时间：2026-11-12 01:07–01:10（Asia/Shanghai，CST）。 | 0402 已按雨田 11-12 规定改为 0603，待焊台同步原理图和 PCB | reviewed
R132 | 2.2k | 1 | no | /SWD UART CAN and status/ | UNI-ROYAL | 0603WAF2201T5E | C4190 | https://item.szlcsc.com/4597.html | MyFootprints:R_0603_1608Metric |  | 1% | 封装已按雨田 11-12 规定改为 0603，原理图和 PCB 封装待焊台同步。原行未标功率，0603 选用 100 mW，未自行降低。功率/介质：100mW 厚膜 ±100ppm/℃；标称公差：1%；嘉立创 SMT 库：基础库。人民币单价（SMT-CNY，嘉立创 SMT 的 LCSC 详情页）：1 只 0.0109 元，10 只 0.0109 元；LCSC 国际站单价（LCSC-USD）：1 只 未查到，10 只 未查到（最低起订 100，100 只档 $0.0019）；LCSC 国际站库存：2080900 只；立创店招实时人民币价：未查到；立创国内库存：未查到；查询时间：2026-11-12 01:07–01:10（Asia/Shanghai，CST）。 | 0402 已按雨田 11-12 规定改为 0603，待焊台同步原理图和 PCB | reviewed
R133 | 2.2k | 1 | no | /SWD UART CAN and status/ | UNI-ROYAL | 0603WAF2201T5E | C4190 | https://item.szlcsc.com/4597.html | MyFootprints:R_0603_1608Metric |  | 1% | 封装已按雨田 11-12 规定改为 0603，原理图和 PCB 封装待焊台同步。原行未标功率，0603 选用 100 mW，未自行降低。功率/介质：100mW 厚膜 ±100ppm/℃；标称公差：1%；嘉立创 SMT 库：基础库。人民币单价（SMT-CNY，嘉立创 SMT 的 LCSC 详情页）：1 只 0.0109 元，10 只 0.0109 元；LCSC 国际站单价（LCSC-USD）：1 只 未查到，10 只 未查到（最低起订 100，100 只档 $0.0019）；LCSC 国际站库存：2080900 只；立创店招实时人民币价：未查到；立创国内库存：未查到；查询时间：2026-11-12 01:07–01:10（Asia/Shanghai，CST）。 | 0402 已按雨田 11-12 规定改为 0603，待焊台同步原理图和 PCB | reviewed
R134 | 2.2k | 1 | no | /SWD UART CAN and status/ | UNI-ROYAL | 0603WAF2201T5E | C4190 | https://item.szlcsc.com/4597.html | MyFootprints:R_0603_1608Metric |  | 1% | 封装已按雨田 11-12 规定改为 0603，原理图和 PCB 封装待焊台同步。原行未标功率，0603 选用 100 mW，未自行降低。功率/介质：100mW 厚膜 ±100ppm/℃；标称公差：1%；嘉立创 SMT 库：基础库。人民币单价（SMT-CNY，嘉立创 SMT 的 LCSC 详情页）：1 只 0.0109 元，10 只 0.0109 元；LCSC 国际站单价（LCSC-USD）：1 只 未查到，10 只 未查到（最低起订 100，100 只档 $0.0019）；LCSC 国际站库存：2080900 只；立创店招实时人民币价：未查到；立创国内库存：未查到；查询时间：2026-11-12 01:07–01:10（Asia/Shanghai，CST）。 | 0402 已按雨田 11-12 规定改为 0603，待焊台同步原理图和 PCB | reviewed
U31 | SN65HVD232DR | 1 | yes | /SWD UART CAN and status/ | TI | SN65HVD232DR | C30530 | https://item.szlcsc.com/31287.html | MyFootprints:SOIC-8_3.9x4.9mm_P1.27mm |  |  | 人民币单价（SMT-CNY，嘉立创 SMT 的 LCSC 详情页 https://www.jlc-smt.com/lcsc/detail/C30530.html）：1 只 未查到，10 只 未查到（SMT 页未取到人民币阶梯）；LCSC 国际站单价（LCSC-USD）：1 只 $0.9259，10 只 $0.7688；LCSC 国际站库存：24935 只（来源：https://wmsc.lcsc.com/ftps/wm/product/detail 00:40–00:46（Asia/Shanghai，CST）。 | 定案将此件搬到 controller，待 #3 从本板原理图移除 | reviewed
J101 | PM254V-12-32-H85 | 1 | no | /64-pin core sockets/ | XFCN | PM254V-12-32-H85 | C46595991 | https://item.szlcsc.com/48735272.html | MyFootprints:XFCN_PM254V-12-32-H85_2x16_P2.54mm_Vertical_Drill1.02mm |  |  | Core TOP male faces UP into power board BOTTOM socket facing DOWN. Both boards 60x60mm; power above core. Recheck physical pin1/rotation; not Rev D 40-pin compatible. 人民币单价（SMT-CNY，嘉立创 SMT 的 LCSC 详情页 https://www.jlc-smt.com/lcsc/detail?componentCode=C46595991）：1 只 2.309 元，10 只 1.805 元；LCSC 国际站库存：937 只（来源：https://wmsc.lcsc.com/ftps/wm/product/detail 00:40–00:46（Asia/Shanghai，CST）。 | P2.54 2x16 candidate; actual mating height, pin1 and land pattern pending | reviewed
J102 | PM254V-12-32-H85 | 1 | no | /64-pin core sockets/ | XFCN | PM254V-12-32-H85 | C46595991 | https://item.szlcsc.com/48735272.html | MyFootprints:XFCN_PM254V-12-32-H85_2x16_P2.54mm_Vertical_Drill1.02mm |  |  | Core TOP male faces UP into power board BOTTOM socket facing DOWN. Both boards 60x60mm; power above core. Recheck physical pin1/rotation; not Rev D 40-pin compatible. 人民币单价（SMT-CNY，嘉立创 SMT 的 LCSC 详情页 https://www.jlc-smt.com/lcsc/detail?componentCode=C46595991）：1 只 2.309 元，10 只 1.805 元；LCSC 国际站库存：937 只（来源：https://wmsc.lcsc.com/ftps/wm/product/detail 00:40–00:46（Asia/Shanghai，CST）。 | P2.54 2x16 candidate; actual mating height, pin1 and land pattern pending | reviewed
TP16 | FAULT_N | 1 | no | /64-pin core sockets/ |  |  |  |  | TestPoint:TestPoint_Pad_D1.5mm
TP17 | ENABLE_IN | 1 | no | /64-pin core sockets/ |  |  |  |  | TestPoint:TestPoint_Pad_D1.5mm
HARNESS_MR60_F_待定 | MR60-F.G.Y | 1 | no |  | AMASS | MR60-F.G.Y | C3040681 | https://item.szlcsc.com/3598448.html |  |  |  | 位号待定；线束侧配套料，不上板；3PIN 线端母头，配 MR60PW-M。 人民币单价（SMT-CNY，嘉立创 SMT 的 LCSC 详情页 https://www.jlc-smt.com/lcsc/detail?componentCode=C3040681）：1 只 3.06 元，10 只 2.88 元；LCSC 国际站库存：20039 只（来源：https://wmsc.lcsc.com/ftps/wm/product/detail 00:40–00:46（Asia/Shanghai，CST）。 | 定案已定，待 #3 原理图更新位号/封装
STANDOFF_M2X11_待定 | M2x11 FF 黄铜双通 | 4 | no |  | XHHD | STTZ2008 | C50377192 | https://item.szlcsc.com/52993853.html |  |  |  | 黄铜双通六角铜柱，商品名 H3*M2*11，两端内螺纹 M2，柱长 11 mm。本型号参数表和规格书未给出对边数值；商品名写 H3。同厂 H4*M2*11（C52976359）参数表写六角对边 4 mm。材质：黄铜（商品名/SMT 页）。人民币单价（SMT-CNY，嘉立创 SMT 的 LCSC 详情页 https://www.jlc-smt.com/lcsc/detail?componentCode=C50377192）：1 只 0.108 元，10 只 0.108 元（1–199 同一档）；LCSC 国际站单价（LCSC-USD）：1 只 未查到，10 只 未查到（国际站最低起订 20 只，20 只档 $0.0172）；LCSC 国际站库存：600 只（来源：https://wmsc.lcsc.com/ftps/wm/product/detail 01:01–01:04（Asia/Shanghai，CST）。备选同尺寸不锈钢：C52976359，MPN 303HZ20011，H4*M2*11，对边 4 mm，材质 303 不锈钢，链接 https://item.szlcsc.com/55901820.html ；SMT-CNY 1 只 0.639 元，10 只 0.639 元（1–49 同一档；50 只起 0.603 元）；LCSC-USD 1 只 未查到（最低起订 5 只，5 只档 $0.1111；10 只仍在该档 $0.1111）；LCSC 国际站库存：150 只。叠板间距：公座塑高 2.50 mm（公差未查到）+ 母座塑高 8.50±0.15 mm = 名义 11.00 mm，与柱长 11 mm 匹配。规格书见上。 | 叠板机械已按雨田要求选 M2×11 双通；待 #3 原理图补位号 | reviewed
HSINK_TOP_待定 | 40x40x11 顶面散热片候选 | 1 | no |  | XSD | XSDG20-193-B1 | C286215 | https://item.szlcsc.com/271490.html |  |  |  | 功率板顶面散热片候选（60×60 mm 板、7 颗 BSC110N15NS5、整板约 2.6–4 W）。主选 C286215，XSD XSDG20-193-B1，40×40×11 mm，材质 6063-T5 铝，表面氧化黑色。规格书见孔（图面有 Φ4 等，标题栏写「或三孔」）；热阻：未查到。人民币单价（SMT-CNY，嘉立创 SMT 的 LCSC 详情页 https://www.jlc-smt.com/lcsc/detail/C286215.html）：1 只 3.29 元，10 只 3.05 元；LCSC 国际站单价（LCSC-USD）：1 只 $0.5435，10 只 $0.5038；LCSC 国际站库存：1245 只（来源：https://wmsc.lcsc.com/ftps/wm/product/detail 01:01–01:04（Asia/Shanghai，CST）。候选 2：C286216，XSDG20-193-B2，40×40×11 mm，规格书 Φ3.3 孔（可过 M3），AL6063-T5 亚黑，热阻未查到；SMT-CNY 1 只 3.47 元、10 只 3.24 元；LCSC-USD 1 只 $0.5728、10 只 $0.5348；国际站库存 62 只；链接 https://item.szlcsc.com/271491.html 。候选 3：C4708，30×25×25 mm，6063-T5，规格书有 M3 孔且带双针（偏小块 TO-220 形态，单独一块覆盖不了 7 颗 MOS），热阻未查到；SMT-CNY 1 只 1.343 元、10 只 1.343 元（1–79 同一档）；LCSC-USD 1 只 未查到（最低起订 8 只，8 只档 $0.2454）；国际站库存 504 只；链接 https://item.szlcsc.com/5116.html 。待焊台在 #4 确认尺寸和安装方式。现图四角只有 M2 安装孔，未见 MOS 附近 M3 孔。 | 待焊台在 #4 确认尺寸和安装方式
RS_BUS_待原理图 | 5m / 3W / 1% | 1 | no |  | Milliohm | LR2512D-3W-5mR-1% | C500739 | https://item.szlcsc.com/512995.html | MyFootprints:Milliohm_HoJLR2512_Pad2.1x4.0mm_Gap4.1mm |  | 1% | A25 高端母线分流，位于母线电容与三相桥上管漏极之间；2 端子，焊盘内侧引出 Kelvin 检测走线（同 RS1–RS3），焊盘尺寸与所选封装一致。2512，5 mΩ ±1%，3 W，TCR ±25 ppm/℃，-55~+170 ℃；70 ℃ 起降额，170 ℃ 为 0。功耗核算：5 A（5 Arms 按直流等效最坏取）0.125 W、8 A 0.32 W、15 A 1.125 W、16.5 A 1.36 W；8 A 持续约占额定 11%，15 A 仅跳闸前瞬时出现，压降 75 mV。SMT-CNY：1+ 0.737 元、50+ 0.617 元、150+ 0.557 元、500+ 0.476 元、2500+ 0.359 元、4000+ 0.342 元，SMT 仓库存 13452（2026-11-12 02:00（Asia/Shanghai））；LCSC-USD：5+ $0.1208、50+ $0.1012、150+ $0.0913，国际站库存 13450（2026-11-12 01:54（Asia/Shanghai））；立创实时价/国内库存未查到。规格书 https://datasheet.lcsc.com/datasheet/pdf/af008bf05bd6536b39b0bb7d67e56045.pdf?productCode=C500739 。备选 C2903482：Milliohm HoJLR2512-3W-5mR-1%（与 RS1–RS3 同料），2512、3 W、±1%，TCR ±50 ppm/℃（2–500 mΩ），-50~+170 ℃；链接 https://item.szlcsc.com/3159236.html ；规格书 https://datasheet.lcsc.com/datasheet/pdf/bf6eace094b76bcd756cc1a79c576936.pdf?productCode=C2903482 ；SMT-CNY：仅预订参考价 0.236 元/个，无阶梯（2026-11-12 01:57（Asia/Shanghai））；LCSC-USD：5+ $0.0962、50+ $0.0817，国际站库存 37560（2026-11-12 01:54（Asia/Shanghai））。备选 C18724155：Milliohm HoCGX2512-3W-5mR-1%，2512、3 W、±1%，TCR 未查到；链接 https://item.szlcsc.com/19917527.html ；SMT-CNY：1+ 0.741 元、50+ 0.596 元、150+ 0.523 元、500+ 0.468 元，SMT 仓库存 1110（2026-11-12 01:52（Asia/Shanghai））；LCSC-USD：5+ $0.1285、50+ $0.1032，国际站库存 990（2026-11-12 01:52（Asia/Shanghai））。 | 主选；位号待原理图 #3
U_BUSAMP_待原理图 | INA241A2IDDFR | 1 | no |  | TI | INA241A2IDDFR | C5240853 | https://item.szlcsc.com/5946734.html | MyFootprints:SOT-23-8 |  |  | 双向高共模电流检测，20 V/V，VCM -5~110 V，VS 2.7–20 V，带宽 1.1 MHz，增强 PWM 抑制；SOT-23-8(DDF)：1 IN−、2 GND、3 REF2、4 NC（接地）、5 OUT、6 VS、7 REF1、8 IN+；与 U10–U12（INA241A1IDDFR，10 V/V）同封装同引脚。供电 +3V3_INV，REF1=VS、REF2=GND，零电流中点 VS/2=1.65 V；配 5 mΩ 分流为 100 mV/A。输出上摆保证值 VS−0.2 V（典型 VS−0.07 V），3.3 V 时保证上限 3.10 V，约 +14.5 A；15 A 对应 3.15 V，超过保证摆幅、仅在典型值内。待焊台 #3 三选一：（a）门限降至 ≤14 A；（b）放大器改 5 V 供电，I_BUS 到 PA3 前分压/钳位；（c）外部 REF 下移中点，尚未决定。规格书 https://www.ti.com/lit/ds/symlink/ina241a.pdf ；SMT-CNY：1+ 16.64 元、10+ 14.65 元、30+ 13.64 元、100+ 12.27 元、500+ 11.78 元、1000+ 11.58 元，SMT 仓库存 384（2026-11-12 01:54（Asia/Shanghai））；LCSC-USD：1+ $2.7486、10+ $2.4199，国际站库存 0（2026-11-12 01:52（Asia/Shanghai））；立创实时价/国内库存未查到。备选 C93965：TI INA240A1PWR，20 V/V，VCM -4~80 V，VS 2.7–5.5 V，带宽 400 kHz，转换速率 2 V/µs；TSSOP-8，与 INA241 引脚不兼容，需 TSSOP-8 封装（现有 BOM 无）；输出上摆保证值 VS−0.2 V（典型 VS−0.05 V），同样受摆幅限制；链接 https://item.szlcsc.com/95163.html ；规格书 https://datasheet.lcsc.com/datasheet/pdf/9602fbfb7e1e4a0288e8a523ed97a8b3.pdf?productCode=C93965 ；SMT-CNY：仅预订参考价 10.486 元/个，无阶梯（约 2026-11-12 01:56（Asia/Shanghai））；LCSC-USD：1+ $3.1562、10+ $2.6695，国际站库存 8793（2026-11-12 01:52（Asia/Shanghai））。备选 C147928：ADI AD8418BRMZ-RL，20 V/V，共模 -2~70 V，VS 2.7–5.5 V，MSOP-8，引脚未逐一核对；链接 https://item.szlcsc.com/159260.html ；规格书 https://datasheet.lcsc.com/datasheet/pdf/47c9367f08b1544689ed7bc95dd0ac80.pdf?productCode=C147928 ；SMT-CNY：仅预订参考价 13.386 元/个，无阶梯（2026-11-12 02:03（Asia/Shanghai））；LCSC-USD：1+ $3.4747、10+ $3.0325，国际站库存 606（2026-11-12 01:52（Asia/Shanghai））。 | 主选；位号待原理图 #3
U_BUSCMP_待原理图 | TLV1821DBVR | 1 | no |  | TI | TLV1821DBVR | C7068849 | https://item.szlcsc.com/8035460.html | MyFootprints:SOT-23-5 |  |  | A26 单路开漏比较器，无内置迟滞，需外部迟滞；供电 +3V3_INV，VS 2.4–40 V，开漏可上拉至 40 V，输入范围 (V−)−0.2~(V+)+0.2 V，传播延迟典型 420 ns，失调电压 500 µV，带上电复位。SOT-23-5：1 OUT、2 V−、3 IN+、4 IN−、5 V+。外部迟滞反相接法：IN−←I_BUS、IN+←VTH；R1：+3V3_INV→VTH，R2：VTH→GND，Rf：OUT→VTH，Rp：+3V3_INV→OUT（Rp≪Rf，TI 建议至少相差 10 倍）。正常 OUT 经 Rp 释放为高；I_BUS>VH 时 OUT 拉低为 BUS_OC_N，进现有锁存；OUT 低后门限降至 VL，I_BUS<VL 才释放。示例均为 0603 1%：R1=8.06 kΩ、R2=165 kΩ、Rf=243 kΩ、Rp=4.7 kΩ；VH=3.3·R2/(R2+R1∥(Rf+Rp))≈3.151 V（约 15.0 A），VL=3.3·(R2∥Rf)/((R2∥Rf)+R1)≈3.050 V（约 14.0 A），迟滞约 1 A。门限与放大器中点同取 +3V3_INV，属比例式；阻值待焊台 #3 按误差核算，15 A 门限受放大器保证摆幅限制，待焊台确认。规格书 https://datasheet.lcsc.com/datasheet/pdf/1acf107ee72c540c32848cd4ced5ccc5.pdf?productCode=C7068849 ；SMT-CNY：仅预订参考价 3.984 元/个，无阶梯（2026-11-12 01:59（Asia/Shanghai））；LCSC-USD：1+ $1.0136、10+ $0.905，国际站库存 3115（2026-11-12 01:53（Asia/Shanghai））；立创实时价/国内库存未查到。备选 C702120：TI TLV7021DCKR，单路开漏，VS 1.6–5.5 V，轨到轨输入，传播延迟典型 260 ns；内置迟滞典型 4.2 mV（1.2–14 mV），仅约 0.04 A，建议仍加外部迟滞；SC-70-5，引脚顺序同 TLV1821，封装不同，可用已有 MyFootprints:SOT-353_SC-70-5；链接 https://item.szlcsc.com/737196.html ；规格书 https://datasheet.lcsc.com/datasheet/pdf/d955c7471084950f84e5242f5ec7a175.pdf?productCode=C702120 ；SMT-CNY：仅预订参考价 1.76 元/个，无阶梯（2026-11-12 02:00（Asia/Shanghai））；LCSC-USD：1+ $0.5886、10+ $0.4722，国际站库存 0（2026-11-12 01:52（Asia/Shanghai））。备选 C2870937：TI TLV1702AIDGKR，双路开集电极，无内置迟滞（规格书未列），需外部电阻；VS 2.2–36 V，共模含双轨，传播延迟 560 ns，VSSOP-8；链接 https://item.szlcsc.com/3075614.html ；规格书 https://www.ti.com/lit/ds/symlink/tlv1702.pdf ；SMT-CNY：1+ 6.64 元、10+ 5.52 元、30+ 4.47 元、100+ 3.732 元、500+ 3.425 元、1000+ 3.287 元，SMT 仓库存 2601（约 2026-11-12 01:56（Asia/Shanghai））；LCSC-USD：1+ $1.0901、10+ $0.9063，国际站库存 2601（2026-11-12 01:53（Asia/Shanghai））。 | 主选；位号待原理图 #3
R_BUSTH1_待原理图 | 8.06k | 1 | no |  |  | TBD |  |  | Resistor_SMD:R_0603_1608Metric |  | 1% | 比较器门限上臂 R1（+3V3_INV→VTH），示例值，待焊台 #3 按误差核算；C 编号未查到 | value example; exact MPN/LCSC pending
R_BUSTH2_待原理图 | 165k | 1 | no |  |  | TBD |  |  | Resistor_SMD:R_0603_1608Metric |  | 1% | 比较器门限下臂 R2（VTH→GND），示例值，待焊台 #3 按误差核算；C 编号未查到 | value example; exact MPN/LCSC pending
R_BUSHYS_待原理图 | 243k | 1 | no |  |  | TBD |  |  | Resistor_SMD:R_0603_1608Metric |  | 1% | 比较器迟滞反馈 Rf（OUT→VTH），示例值，待焊台 #3 按误差核算；C 编号未查到 | value example; exact MPN/LCSC pending
R_BUSPU_待原理图 | 4.7k | 1 | no |  | UNI-ROYAL | 0603WAF4701T5E | C23162 | https://item.szlcsc.com/23889.html | Resistor_SMD:R_0603_1608Metric |  | 1% | 比较器开漏上拉 Rp（+3V3_INV→OUT），Rp≪Rf；LCSC-USD：100+ $0.0028，国际站库存 2522100（2026-11-12 02:06（Asia/Shanghai））；立创实时价/国内库存未查到。 | 示例值；待原理图 #3
C_BUSAMP_待原理图 | 100n | 1 | no |  | YAGEO | CC0603KRX7R9BB104 | C14663 | https://item.szlcsc.com/15331.html | MyFootprints:C_0603_1608Metric | 50V | 10% | U_BUSAMP VS 去耦，沿用 C14663（国际站库存 0，见 PR #12）
C_BUSCMP_待原理图 | 100n | 1 | no |  | YAGEO | CC0603KRX7R9BB104 | C14663 | https://item.szlcsc.com/15331.html | MyFootprints:C_0603_1608Metric | 50V | 10% | U_BUSCMP V+ 去耦，沿用 C14663（国际站库存 0，见 PR #12）
