leolei2012/power_system/outputs/schematic_review_2026-11-11/baseline/inverter_bom.csv

Reference | Value | Quantity | DNP | Sheet | Manufacturer | MPN | Supplier_PN | Purchase_URL | Footprint | Voltage_Rating | Tolerance | Design_Note | Selection_Status | Verification
C1 | 1u | 1 | no | /Auxiliary input/ | YAGEO | TBD |  |  | Capacitor_SMD:C_0805_2012Metric | 100V |  |  | value assigned; DC bias/MPN/LCSC pending
C2 | 22n | 1 | no | /Auxiliary input/ | YAGEO | TBD |  |  | Capacitor_SMD:C_0603_1608Metric | 25V |  |  | value assigned; DC bias/MPN/LCSC pending
C3 | 10u | 1 | no | /Auxiliary input/ | YAGEO | TBD |  |  | Capacitor_SMD:C_1206_3216Metric | 50V |  |  | value assigned; DC bias/MPN/LCSC pending
F2 | 0451002.MRL | 1 | no | /Auxiliary input/ | Littelfuse | 0451002.MRL | C99547 | https://www.lcsc.com/product-detail/C99547.html | Fuse:Fuse_Littelfuse-NANO2-451_453 |  |  |  | Exact 2 A candidate fits current Nano2 451/453 footprint; converter inrush, short-circuit coordination and ambient derating remain application checks.
J2 | AUX: +12..24V / GND | 1 | no | /Auxiliary input/ |  | B2B-PH-K-S(LF)(SN) | C131337 | https://www.lcsc.com/product-detail/C131337.html | Connector_JST:JST_PH_B2B-PH-K_1x02_P2.00mm_Vertical |  |  |  | compact mechanical engineering candidate; original pin order retained
R1 | 78.7k | 1 | no | /Auxiliary input/ | YAGEO | TBD |  |  | Resistor_SMD:R_0603_1608Metric |  | 0.1% |  | value assigned; exact MPN/LCSC pending
R2 | 10k | 1 | no | /Auxiliary input/ | YAGEO | TBD |  |  | Resistor_SMD:R_0603_1608Metric |  | 0.1% |  | value assigned; exact MPN/LCSC pending
R3 | 221k | 1 | no | /Auxiliary input/ | YAGEO | TBD |  |  | Resistor_SMD:R_0603_1608Metric |  | 0.1% |  | value assigned; exact MPN/LCSC pending
R4 | 10k | 1 | no | /Auxiliary input/ | YAGEO | TBD |  |  | Resistor_SMD:R_0603_1608Metric |  | 0.1% |  | value assigned; exact MPN/LCSC pending
R5 | 402k | 1 | no | /Auxiliary input/ | YAGEO | TBD |  |  | Resistor_SMD:R_0603_1608Metric |  | 1% | 402k selects current-limit latch-off; direct RTN would select auto-retry | value assigned; exact MPN/LCSC pending
R6 | 7.87k | 1 | no | /Auxiliary input/ | YAGEO | TBD |  |  | Resistor_SMD:R_0603_1608Metric |  | 1% | Nominal 11.8k/R -> 1.50 A; tolerance/SOA/startup review | value assigned; exact MPN/LCSC pending
R7 | 10k | 1 | no | /Auxiliary input/ | YAGEO | TBD |  |  | Resistor_SMD:R_0603_1608Metric |  | 1% |  | value assigned; exact MPN/LCSC pending
R8 | 100k | 1 | yes | /Auxiliary input/ | YAGEO | TBD |  |  | Resistor_SMD:R_0603_1608Metric |  | 1% | DNP: remove external 12..24V SHDN pullup. TPS26600 internal SHDN bias is nominal 2.7V, recommended SHDN 0..4V. SW1 still pulls to EFUSE_RTN. | compact revision electrical correction; retain footprint, do not populate
SW1 | AUX_RESET | 1 | no | /Auxiliary input/ | XUNPU | TS-1088-AR02016 | C720477 | https://www.lcsc.com/product-detail/tactile%20switches_xunpu_ts-1088-ar02016_C720477.html | Button_Switch_SMD:SW_SPST_TS-1088-xR020 |  |  |  | Exact small SMD normally-open momentary 2-terminal switch; standard local footprint matches current manufacturer drawing. SW1 bias condition below remains an electrical-review hold point.
U1 | TPS26600PWPR | 1 | no | /Auxiliary input/ | TI | TPS26600PWPR | C544399 | https://item.szlcsc.com/565050.html | MyFootprints:HTSSOP-16-1EP_4.4x5mm_P0.65mm_EP3.4x5mm_Mask2.66x2.46mm |  |  |  |  | reviewed
C4 | 100n | 1 | no | /Driver supply/ | YAGEO | TBD |  |  | Capacitor_SMD:C_0603_1608Metric | 25V |  |  | value assigned; DC bias/MPN/LCSC pending
C5 | 100n | 1 | no | /Driver supply/ | YAGEO | TBD |  |  | Capacitor_SMD:C_0603_1608Metric | 25V |  |  | value assigned; DC bias/MPN/LCSC pending
C6 | 10u | 1 | no | /Driver supply/ | YAGEO | TBD |  |  | Capacitor_SMD:C_1206_3216Metric | 50V |  |  | value assigned; DC bias/MPN/LCSC pending
C7 | 470n | 1 | no | /Driver supply/ | YAGEO | TBD |  |  | Capacitor_SMD:C_0805_2012Metric | 50V |  |  | value assigned; DC bias/MPN/LCSC pending
C8 | 22u | 1 | no | /Driver supply/ | YAGEO | TBD |  |  | Capacitor_SMD:C_1210_3225Metric | 25V |  |  | value assigned; DC bias/MPN/LCSC pending
C9 | 100n | 1 | no | /Driver supply/ | YAGEO | TBD |  |  | Capacitor_SMD:C_0603_1608Metric | 25V |  |  | value assigned; DC bias/MPN/LCSC pending
C10 | 4.7u | 1 | no | /Driver supply/ | YAGEO | TBD |  |  | Capacitor_SMD:C_0805_2012Metric | 10V |  |  | value assigned; DC bias/MPN/LCSC pending
L1 | 4.7uH | 1 | no | /Driver supply/ | Sunlord | MWSA0603S-4R7MT | C408447 | https://www.lcsc.com/product-detail/C408447.html | Inductor_SMD:L_Sunlord_MWSA0603S |  |  |  | Meets requested nominal L, current-table and DCR targets; auxiliary-converter operating/thermal qualification pending.
R9 | 100k | 1 | no | /Driver supply/ | YAGEO | TBD |  |  | Resistor_SMD:R_0603_1608Metric |  | 1% |  | value assigned; exact MPN/LCSC pending
R10 | 10k | 1 | no | /Driver supply/ | YAGEO | TBD |  |  | Resistor_SMD:R_0603_1608Metric |  | 1% |  | value assigned; exact MPN/LCSC pending
R11 | 10k | 1 | no | /Driver supply/ | YAGEO | TBD |  |  | Resistor_SMD:R_0603_1608Metric |  | 1% |  | value assigned; exact MPN/LCSC pending
R12 | 20k | 1 | no | /Driver supply/ | YAGEO | TBD |  |  | Resistor_SMD:R_0603_1608Metric |  | 1% |  | value assigned; exact MPN/LCSC pending
TP1 | +12V_DRV | 1 | no | /Driver supply/ |  |  |  |  | TestPoint:TestPoint_Pad_D1.5mm
TP2 | BB_VREG | 1 | no | /Driver supply/ |  |  |  |  | TestPoint:TestPoint_Pad_D1.5mm
TP3 | DRV_PG_LOGIC | 1 | no | /Driver supply/ |  |  |  |  | TestPoint:TestPoint_Pad_D1.5mm
U2 | TPS55165QPWPRQ1 | 1 | no | /Driver supply/ | TI | TPS55165QPWPRQ1 | C2071629 | https://item.szlcsc.com/2163212.html | MyFootprints:TI_PWP0020W_HTSSOP-20_4.4x6.5mm_P0.65mm_EP2.79x3.64mm |  |  |  |  | reviewed
C11 | 10u | 1 | no | /Logic and sensors/ | YAGEO | TBD |  |  | Capacitor_SMD:C_1206_3216Metric | 50V |  |  | value assigned; DC bias/MPN/LCSC pending
C12 | 100n | 1 | no | /Logic and sensors/ | YAGEO | TBD |  |  | Capacitor_SMD:C_0603_1608Metric | 25V |  |  | value assigned; DC bias/MPN/LCSC pending
C13 | 22u | 1 | no | /Logic and sensors/ | YAGEO | TBD |  |  | Capacitor_SMD:C_1206_3216Metric | 16V |  |  | value assigned; DC bias/MPN/LCSC pending
C14 | 22u | 1 | no | /Logic and sensors/ | YAGEO | TBD |  |  | Capacitor_SMD:C_1206_3216Metric | 16V |  |  | value assigned; DC bias/MPN/LCSC pending
C15 | 1u | 1 | no | /Logic and sensors/ | YAGEO | TBD |  |  | Capacitor_SMD:C_0603_1608Metric | 25V |  |  | value assigned; DC bias/MPN/LCSC pending
C16 | 2.2u | 1 | no | /Logic and sensors/ | YAGEO | TBD |  |  | Capacitor_SMD:C_0603_1608Metric | 25V |  |  | value assigned; DC bias/MPN/LCSC pending
C17 | 100n | 1 | no | /Logic and sensors/ | YAGEO | TBD |  |  | Capacitor_SMD:C_0402_1005Metric | 25V |  |  | value assigned; DC bias/MPN/LCSC pending
C18 | 10u | 1 | no | /Logic and sensors/ | YAGEO | TBD |  |  | Capacitor_SMD:C_0805_2012Metric | 16V |  |  | value assigned; DC bias/MPN/LCSC pending
J7 | OPTIONAL SENSOR 5V / GND | 1 | yes | /Logic and sensors/ |  | PZ127-1-02-Z | C5372825 | https://www.lcsc.com/product-detail/C5372825.html | Inverter_Compact:PinHeader_HCTL_PZ127_1x02_P1.27mm_D0.70mm |  |  |  | compact mechanical engineering candidate; original pin order retained
L2 | 4.7uH | 1 | no | /Logic and sensors/ | Sunlord | MWSA0603S-4R7MT | C408447 | https://www.lcsc.com/product-detail/C408447.html | Inductor_SMD:L_Sunlord_MWSA0603S |  |  |  | Meets requested nominal L, current-table and DCR targets; auxiliary-converter operating/thermal qualification pending.
R13 | 10k | 1 | no | /Logic and sensors/ | YAGEO | TBD |  |  | Resistor_SMD:R_0402_1005Metric |  | 1% |  | value assigned; exact MPN/LCSC pending
R14 | 49.9k | 1 | no | /Logic and sensors/ | YAGEO | TBD |  |  | Resistor_SMD:R_0603_1608Metric |  | 1% | ~0.475..0.582 A datasheet min/max formula at nominal R; resistor tolerance adds error | value assigned; exact MPN/LCSC pending
R15 | 10k | 1 | no | /Logic and sensors/ | YAGEO | TBD |  |  | Resistor_SMD:R_0603_1608Metric |  | 1% |  | value assigned; exact MPN/LCSC pending
TP4 | SENSOR_PWR_FLT_N | 1 | no | /Logic and sensors/ |  |  |  |  | TestPoint:TestPoint_Pad_D1.5mm
U3 | AP63205WU-7 | 1 | no | /Logic and sensors/ | Diodes | AP63205WU-7 | C2071056 | https://item.szlcsc.com/2162639.html | MyFootprints:TSOT-23-6 |  |  |  |  | reviewed
U4 | TPS7A2033PDBVR | 1 | no | /Logic and sensors/ | TI | TPS7A2033PDBVR | C2862740 | https://item.szlcsc.com/3067417.html | MyFootprints:SOT-23-5 |  |  |  |  | reviewed
U5 | TPS2553QDBVRQ1 | 1 | no | /Logic and sensors/ | TI | TPS2553QDBVRQ1 | C130055 | https://item.szlcsc.com/141342.html | MyFootprints:SOT-23-6 |  |  |  |  | reviewed
U6 | TPS3808G33DBVR | 1 | no | /Logic and sensors/ | TI | TPS3808G33DBVR | C43698 | https://item.szlcsc.com/44691.html | MyFootprints:SOT-23-6 |  |  |  |  | reviewed
C19 | 220u / 100V | 1 | no | /Bus and brake/ | Nippon Chemi-Con | EKYB101ELL221MK25S | C1585673 | https://item.szlcsc.com/1676488.html | MyFootprints:CP_Radial_D12.5mm_H25mm_P5.00mm |  | 20% |  |  | reviewed
C20 | 220u / 100V | 1 | no | /Bus and brake/ | Nippon Chemi-Con | EKYB101ELL221MK25S | C1585673 | https://item.szlcsc.com/1676488.html | MyFootprints:CP_Radial_D12.5mm_H25mm_P5.00mm |  | 20% |  |  | reviewed
C21 | 2.2u / 100V X7R | 1 | no | /Bus and brake/ | YAGEO | CS1210KKX7R0BB225 | C5578983 | https://item.szlcsc.com/6497372.html | MyFootprints:C_1210_3225Metric |  | 10% |  |  | reviewed
C22 | 2.2u / 100V X7R | 1 | no | /Bus and brake/ | YAGEO | CS1210KKX7R0BB225 | C5578983 | https://item.szlcsc.com/6497372.html | MyFootprints:C_1210_3225Metric |  | 10% |  |  | reviewed
C23 | 1u | 1 | no | /Bus and brake/ | YAGEO | TBD |  |  | Capacitor_SMD:C_0603_1608Metric | 25V |  |  | value assigned; DC bias/MPN/LCSC pending
C24 | 100n | 1 | no | /Bus and brake/ | YAGEO | TBD |  |  | Capacitor_SMD:C_0603_1608Metric | 25V |  |  | value assigned; DC bias/MPN/LCSC pending
D1 | MBRD20150CT-13 | 1 | no | /Bus and brake/ | Diodes | MBRD20150CT-13 | C151357 | https://item.szlcsc.com/162697.html | Package_TO_SOT_SMD:TO-252-3_TabPin2 |  |  |  | 60mm input series-diode candidate; 1/3 A,2 K/tab visually checked Rev4-2 p1; thermal and production variant pending | project_draft
D2 | SMCJ60CA / CANDIDATE DNP | 1 | yes | /Bus and brake/ | SMC (Sangdest) | SMCJ60CA | C3719686 | https://item.szlcsc.com/4287506.html | Diode_SMD:D_SMC |  |  |  | DNP candidate; manufacturer datasheet/clamp energy/layout and 100V cap margin require review
F1 | 0476015.MRSN | 1 | no | /Bus and brake/ | Littelfuse | 0476015.MRSN | C3165851 | https://www.lcsc.com/product-detail/C3165851.html | Fuse:Fuse_Littelfuse-NANO2-451_453 |  |  |  | Exact 15 A / 125 V DC / 2410 candidate; electrical coordination and hot-board derating pending.
J3 | DC INPUT: + / - | 1 | no | /Bus and brake/ |  | PCB solder holes / wire assembly |  |  | Inverter_Compact:WireSolder_2P_P6.00mm_D2.00mm |  |  |  | compact mechanical engineering candidate; original pin order retained
J4 | RAW PWM: U / V / W | 1 | no | /Bus and brake/ |  | PCB solder holes / wire assembly |  |  | Inverter_Compact:WireSolder_3P_P15.00mm_D2.00mm |  |  |  | compact mechanical engineering candidate; original pin order retained
J5 | BRAKE POWER: BR+ / BR_SW | 1 | no | /Bus and brake/ |  | PCB solder holes / wire assembly |  |  | Inverter_Compact:WireSolder_2P_P6.00mm_D2.00mm |  |  |  | compact mechanical engineering candidate; original pin order retained
Q7 | BSC110N15NS5 | 1 | no | /Bus and brake/ | Infineon | BSC110N15NS5 | C412739 | https://item.szlcsc.com/404529.html | Inverter_Compact:BSC110N15NS5_TDSON8_8PhysicalPins |  |  |  | 60mm layout candidate; physical 1-3 S,4 G,5-8 D; thermal/pulse/EMI pending | project_draft
R16 | 10k | 1 | no | /Bus and brake/ | YAGEO | TBD |  |  | Resistor_SMD:R_0603_1608Metric |  | 1% |  | value assigned; exact MPN/LCSC pending
R17 | 15 | 1 | no | /Bus and brake/ | YAGEO | TBD |  |  | Resistor_SMD:R_0805_2012Metric |  | 1% | Retain 0805 gate resistor; exact YAGEO pulse-rated MPN and gate waveform verification pending | value assigned; exact MPN/LCSC pending
R18 | 10k | 1 | no | /Bus and brake/ | YAGEO | TBD |  |  | Resistor_SMD:R_0603_1608Metric |  | 1% |  | value assigned; exact MPN/LCSC pending
U29 | UCC27517DBVR | 1 | no | /Bus and brake/ | TI | UCC27517DBVR | C99395 | https://item.szlcsc.com/100609.html | MyFootprints:SOT-23-5 |  |  |  |  | reviewed
C25 | 2.2u | 1 | no | /U half bridge/ | YAGEO | TBD |  |  | Capacitor_SMD:C_1206_3216Metric | 25V |  |  | value assigned; DC bias/MPN/LCSC pending
C26 | 100n | 1 | no | /U half bridge/ | YAGEO | TBD |  |  | Capacitor_SMD:C_0603_1608Metric | 25V |  |  | value assigned; DC bias/MPN/LCSC pending
C27 | 4.7u | 1 | no | /U half bridge/ | YAGEO | TBD |  |  | Capacitor_SMD:C_0805_2012Metric | 25V |  |  | value assigned; DC bias/MPN/LCSC pending
C28 | 100n | 1 | no | /U half bridge/ | YAGEO | TBD |  |  | Capacitor_SMD:C_0603_1608Metric | 25V |  |  | value assigned; DC bias/MPN/LCSC pending
Q1 | BSC110N15NS5 | 1 | no | /U half bridge/ | Infineon | BSC110N15NS5 | C412739 | https://item.szlcsc.com/404529.html | Inverter_Compact:BSC110N15NS5_TDSON8_8PhysicalPins |  |  |  | 60mm layout candidate; physical 1-3 S,4 G,5-8 D; thermal/pulse/EMI pending | project_draft
Q2 | BSC110N15NS5 | 1 | no | /U half bridge/ | Infineon | BSC110N15NS5 | C412739 | https://item.szlcsc.com/404529.html | Inverter_Compact:BSC110N15NS5_TDSON8_8PhysicalPins |  |  |  | 60mm layout candidate; physical 1-3 S,4 G,5-8 D; thermal/pulse/EMI pending | project_draft
R19 | 15 | 1 | no | /U half bridge/ | YAGEO | TBD |  |  | Resistor_SMD:R_0805_2012Metric |  | 1% | Retain 0805 gate resistor; exact YAGEO pulse-rated MPN and gate waveform verification pending | value assigned; exact MPN/LCSC pending
R20 | 15 | 1 | no | /U half bridge/ | YAGEO | TBD |  |  | Resistor_SMD:R_0805_2012Metric |  | 1% | Retain 0805 gate resistor; exact YAGEO pulse-rated MPN and gate waveform verification pending | value assigned; exact MPN/LCSC pending
R21 | 10k | 1 | no | /U half bridge/ | YAGEO | TBD |  |  | Resistor_SMD:R_0603_1608Metric |  | 1% |  | value assigned; exact MPN/LCSC pending
R22 | 10k | 1 | no | /U half bridge/ | YAGEO | TBD |  |  | Resistor_SMD:R_0603_1608Metric |  | 1% |  | value assigned; exact MPN/LCSC pending
R23 | 10k | 1 | no | /U half bridge/ | YAGEO | TBD |  |  | Resistor_SMD:R_0603_1608Metric |  | 1% |  | value assigned; exact MPN/LCSC pending
R24 | 10k | 1 | no | /U half bridge/ | YAGEO | TBD |  |  | Resistor_SMD:R_0603_1608Metric |  | 1% |  | value assigned; exact MPN/LCSC pending
RS1 | 5m / 3W / 1% | 1 | no | /U half bridge/ | Milliohm | HoJLR2512-3W-5mR-1% | C2903482 |  | Resistor_SMD:R_2512_6332Metric |  |  | 2-terminal resistor with Kelvin sense traces; no ground bypass across pads | candidate from local manufacturer series datasheet; domestic product URL and thermal/pulse review pending
TP5 | U_PHASE | 1 | no | /U half bridge/ |  |  |  |  | TestPoint:TestPoint_Pad_D1.5mm
TP6 | U_SOURCE | 1 | no | /U half bridge/ |  |  |  |  | TestPoint:TestPoint_Pad_D1.5mm
U7 | 2ED2182S06FXUMA1 | 1 | no | /U half bridge/ | Infineon | 2ED2182S06FXUMA1 | C1850289 | https://www.lcsc.com/product-detail/C1850289.html | MyFootprints:SOIC-8_3.9x4.9mm_P1.27mm |  |  |  |  | reviewed
C29 | 2.2u | 1 | no | /V half bridge/ | YAGEO | TBD |  |  | Capacitor_SMD:C_1206_3216Metric | 25V |  |  | value assigned; DC bias/MPN/LCSC pending
C30 | 100n | 1 | no | /V half bridge/ | YAGEO | TBD |  |  | Capacitor_SMD:C_0603_1608Metric | 25V |  |  | value assigned; DC bias/MPN/LCSC pending
C31 | 4.7u | 1 | no | /V half bridge/ | YAGEO | TBD |  |  | Capacitor_SMD:C_0805_2012Metric | 25V |  |  | value assigned; DC bias/MPN/LCSC pending
C32 | 100n | 1 | no | /V half bridge/ | YAGEO | TBD |  |  | Capacitor_SMD:C_0603_1608Metric | 25V |  |  | value assigned; DC bias/MPN/LCSC pending
Q3 | BSC110N15NS5 | 1 | no | /V half bridge/ | Infineon | BSC110N15NS5 | C412739 | https://item.szlcsc.com/404529.html | Inverter_Compact:BSC110N15NS5_TDSON8_8PhysicalPins |  |  |  | 60mm layout candidate; physical 1-3 S,4 G,5-8 D; thermal/pulse/EMI pending | project_draft
Q4 | BSC110N15NS5 | 1 | no | /V half bridge/ | Infineon | BSC110N15NS5 | C412739 | https://item.szlcsc.com/404529.html | Inverter_Compact:BSC110N15NS5_TDSON8_8PhysicalPins |  |  |  | 60mm layout candidate; physical 1-3 S,4 G,5-8 D; thermal/pulse/EMI pending | project_draft
R25 | 15 | 1 | no | /V half bridge/ | YAGEO | TBD |  |  | Resistor_SMD:R_0805_2012Metric |  | 1% | Retain 0805 gate resistor; exact YAGEO pulse-rated MPN and gate waveform verification pending | value assigned; exact MPN/LCSC pending
R26 | 15 | 1 | no | /V half bridge/ | YAGEO | TBD |  |  | Resistor_SMD:R_0805_2012Metric |  | 1% | Retain 0805 gate resistor; exact YAGEO pulse-rated MPN and gate waveform verification pending | value assigned; exact MPN/LCSC pending
R27 | 10k | 1 | no | /V half bridge/ | YAGEO | TBD |  |  | Resistor_SMD:R_0603_1608Metric |  | 1% |  | value assigned; exact MPN/LCSC pending
R28 | 10k | 1 | no | /V half bridge/ | YAGEO | TBD |  |  | Resistor_SMD:R_0603_1608Metric |  | 1% |  | value assigned; exact MPN/LCSC pending
R29 | 10k | 1 | no | /V half bridge/ | YAGEO | TBD |  |  | Resistor_SMD:R_0603_1608Metric |  | 1% |  | value assigned; exact MPN/LCSC pending
R30 | 10k | 1 | no | /V half bridge/ | YAGEO | TBD |  |  | Resistor_SMD:R_0603_1608Metric |  | 1% |  | value assigned; exact MPN/LCSC pending
RS2 | 5m / 3W / 1% | 1 | no | /V half bridge/ | Milliohm | HoJLR2512-3W-5mR-1% | C2903482 |  | Resistor_SMD:R_2512_6332Metric |  |  | 2-terminal resistor with Kelvin sense traces; no ground bypass across pads | candidate from local manufacturer series datasheet; domestic product URL and thermal/pulse review pending
TP7 | V_PHASE | 1 | no | /V half bridge/ |  |  |  |  | TestPoint:TestPoint_Pad_D1.5mm
TP8 | V_SOURCE | 1 | no | /V half bridge/ |  |  |  |  | TestPoint:TestPoint_Pad_D1.5mm
U8 | 2ED2182S06FXUMA1 | 1 | no | /V half bridge/ | Infineon | 2ED2182S06FXUMA1 | C1850289 | https://www.lcsc.com/product-detail/C1850289.html | MyFootprints:SOIC-8_3.9x4.9mm_P1.27mm |  |  |  |  | reviewed
C33 | 2.2u | 1 | no | /W half bridge/ | YAGEO | TBD |  |  | Capacitor_SMD:C_1206_3216Metric | 25V |  |  | value assigned; DC bias/MPN/LCSC pending
C34 | 100n | 1 | no | /W half bridge/ | YAGEO | TBD |  |  | Capacitor_SMD:C_0603_1608Metric | 25V |  |  | value assigned; DC bias/MPN/LCSC pending
C35 | 4.7u | 1 | no | /W half bridge/ | YAGEO | TBD |  |  | Capacitor_SMD:C_0805_2012Metric | 25V |  |  | value assigned; DC bias/MPN/LCSC pending
C36 | 100n | 1 | no | /W half bridge/ | YAGEO | TBD |  |  | Capacitor_SMD:C_0603_1608Metric | 25V |  |  | value assigned; DC bias/MPN/LCSC pending
Q5 | BSC110N15NS5 | 1 | no | /W half bridge/ | Infineon | BSC110N15NS5 | C412739 | https://item.szlcsc.com/404529.html | Inverter_Compact:BSC110N15NS5_TDSON8_8PhysicalPins |  |  |  | 60mm layout candidate; physical 1-3 S,4 G,5-8 D; thermal/pulse/EMI pending | project_draft
Q6 | BSC110N15NS5 | 1 | no | /W half bridge/ | Infineon | BSC110N15NS5 | C412739 | https://item.szlcsc.com/404529.html | Inverter_Compact:BSC110N15NS5_TDSON8_8PhysicalPins |  |  |  | 60mm layout candidate; physical 1-3 S,4 G,5-8 D; thermal/pulse/EMI pending | project_draft
R31 | 15 | 1 | no | /W half bridge/ | YAGEO | TBD |  |  | Resistor_SMD:R_0805_2012Metric |  | 1% | Retain 0805 gate resistor; exact YAGEO pulse-rated MPN and gate waveform verification pending | value assigned; exact MPN/LCSC pending
R32 | 15 | 1 | no | /W half bridge/ | YAGEO | TBD |  |  | Resistor_SMD:R_0805_2012Metric |  | 1% | Retain 0805 gate resistor; exact YAGEO pulse-rated MPN and gate waveform verification pending | value assigned; exact MPN/LCSC pending
R33 | 10k | 1 | no | /W half bridge/ | YAGEO | TBD |  |  | Resistor_SMD:R_0603_1608Metric |  | 1% |  | value assigned; exact MPN/LCSC pending
R34 | 10k | 1 | no | /W half bridge/ | YAGEO | TBD |  |  | Resistor_SMD:R_0603_1608Metric |  | 1% |  | value assigned; exact MPN/LCSC pending
R35 | 10k | 1 | no | /W half bridge/ | YAGEO | TBD |  |  | Resistor_SMD:R_0603_1608Metric |  | 1% |  | value assigned; exact MPN/LCSC pending
R36 | 10k | 1 | no | /W half bridge/ | YAGEO | TBD |  |  | Resistor_SMD:R_0603_1608Metric |  | 1% |  | value assigned; exact MPN/LCSC pending
RS3 | 5m / 3W / 1% | 1 | no | /W half bridge/ | Milliohm | HoJLR2512-3W-5mR-1% | C2903482 |  | Resistor_SMD:R_2512_6332Metric |  |  | 2-terminal resistor with Kelvin sense traces; no ground bypass across pads | candidate from local manufacturer series datasheet; domestic product URL and thermal/pulse review pending
TP9 | W_PHASE | 1 | no | /W half bridge/ |  |  |  |  | TestPoint:TestPoint_Pad_D1.5mm
TP10 | W_SOURCE | 1 | no | /W half bridge/ |  |  |  |  | TestPoint:TestPoint_Pad_D1.5mm
U9 | 2ED2182S06FXUMA1 | 1 | no | /W half bridge/ | Infineon | 2ED2182S06FXUMA1 | C1850289 | https://www.lcsc.com/product-detail/C1850289.html | MyFootprints:SOIC-8_3.9x4.9mm_P1.27mm |  |  |  |  | reviewed
C37 | 100n | 1 | no | /Current sensing/ | YAGEO | TBD |  |  | Capacitor_SMD:C_0603_1608Metric | 25V |  |  | value assigned; DC bias/MPN/LCSC pending
C38 | 100n | 1 | no | /Current sensing/ | YAGEO | TBD |  |  | Capacitor_SMD:C_0603_1608Metric | 25V |  |  | value assigned; DC bias/MPN/LCSC pending
C39 | 100n | 1 | no | /Current sensing/ | YAGEO | TBD |  |  | Capacitor_SMD:C_0603_1608Metric | 25V |  |  | value assigned; DC bias/MPN/LCSC pending
C40 | 100n | 1 | no | /Current sensing/ | YAGEO | TBD |  |  | Capacitor_SMD:C_0402_1005Metric | 25V |  |  | value assigned; DC bias/MPN/LCSC pending
C41 | 100n | 1 | no | /Current sensing/ | YAGEO | TBD |  |  | Capacitor_SMD:C_0402_1005Metric | 25V |  |  | value assigned; DC bias/MPN/LCSC pending
C62 | 100n | 1 | no | /Current sensing/ | YAGEO | TBD |  |  | Capacitor_SMD:C_0402_1005Metric | 25V |  |  | value assigned; DC bias/MPN/LCSC pending
R37 | 47 | 1 | no | /Current sensing/ | YAGEO | TBD |  |  | Resistor_SMD:R_0603_1608Metric |  | 1% | Output isolation at amplifier; trip comparators sense before resistor | value assigned; exact MPN/LCSC pending
R38 | 47 | 1 | no | /Current sensing/ | YAGEO | TBD |  |  | Resistor_SMD:R_0603_1608Metric |  | 1% | Output isolation at amplifier; trip comparators sense before resistor | value assigned; exact MPN/LCSC pending
R39 | 47 | 1 | no | /Current sensing/ | YAGEO | TBD |  |  | Resistor_SMD:R_0603_1608Metric |  | 1% | Output isolation at amplifier; trip comparators sense before resistor | value assigned; exact MPN/LCSC pending
R40 | 10k | 1 | no | /Current sensing/ | YAGEO | TBD |  |  | Resistor_SMD:R_0402_1005Metric |  | 0.1% |  | value assigned; exact MPN/LCSC pending
R41 | 10k | 1 | no | /Current sensing/ | YAGEO | TBD |  |  | Resistor_SMD:R_0402_1005Metric |  | 0.1% |  | value assigned; exact MPN/LCSC pending
R42 | 39k | 1 | no | /Current sensing/ | YAGEO | TBD |  |  | Resistor_SMD:R_0402_1005Metric |  | 0.1% |  | value assigned; exact MPN/LCSC pending
R43 | 1.8k | 1 | no | /Current sensing/ | YAGEO | TBD |  |  | Resistor_SMD:R_0402_1005Metric |  | 0.1% |  | value assigned; exact MPN/LCSC pending
R44 | 10k | 1 | no | /Current sensing/ | YAGEO | TBD |  |  | Resistor_SMD:R_0402_1005Metric |  | 0.1% |  | value assigned; exact MPN/LCSC pending
R45 | 10k | 1 | no | /Current sensing/ | YAGEO | TBD |  |  | Resistor_SMD:R_0402_1005Metric |  | 0.1% |  | value assigned; exact MPN/LCSC pending
R46 | 1.8k | 1 | no | /Current sensing/ | YAGEO | TBD |  |  | Resistor_SMD:R_0402_1005Metric |  | 0.1% |  | value assigned; exact MPN/LCSC pending
R47 | 39k | 1 | no | /Current sensing/ | YAGEO | TBD |  |  | Resistor_SMD:R_0402_1005Metric |  | 0.1% |  | value assigned; exact MPN/LCSC pending
TP11 | I_U | 1 | no | /Current sensing/ |  |  |  |  | TestPoint:TestPoint_Pad_D1.5mm
TP12 | I_V | 1 | no | /Current sensing/ |  |  |  |  | TestPoint:TestPoint_Pad_D1.5mm
TP13 | I_W | 1 | no | /Current sensing/ |  |  |  |  | TestPoint:TestPoint_Pad_D1.5mm
U10 | INA241A1IDDFR | 1 | no | /Current sensing/ | TI | INA241A1IDDFR | C19712054 | https://item.szlcsc.com/21022225.html | MyFootprints:SOT-23-8 |  |  |  |  | reviewed
U11 | INA241A1IDDFR | 1 | no | /Current sensing/ | TI | INA241A1IDDFR | C19712054 | https://item.szlcsc.com/21022225.html | MyFootprints:SOT-23-8 |  |  |  |  | reviewed
U12 | INA241A1IDDFR | 1 | no | /Current sensing/ | TI | INA241A1IDDFR | C19712054 | https://item.szlcsc.com/21022225.html | MyFootprints:SOT-23-8 |  |  |  |  | reviewed
U13 | TLV9001IDCKR | 1 | no | /Current sensing/ | TI | TLV9001IDCKR | C398362 | https://item.szlcsc.com/380592.html | MyFootprints:SOT-353_SC-70-5 |  |  |  |  | reviewed
U28 | 74LVC74AD,118 | 1 | no | /Current sensing/ | Nexperia | 74LVC74AD,118 | C6099 | https://item.szlcsc.com/6565.html | MyFootprints:SOIC-14_3.9x8.7mm_P1.27mm |  |  |  |  | reviewed
C42 | 100p | 1 | no | /Voltage and NTC/ | YAGEO | TBD |  |  | Capacitor_SMD:C_0402_1005Metric | 25V |  |  | value assigned; DC bias/MPN/LCSC pending
C43 | 100n | 1 | no | /Voltage and NTC/ | YAGEO | TBD |  |  | Capacitor_SMD:C_0402_1005Metric | 25V |  |  | value assigned; DC bias/MPN/LCSC pending
C44 | 1n | 1 | no | /Voltage and NTC/ | YAGEO | TBD |  |  | Capacitor_SMD:C_0402_1005Metric | 25V |  |  | value assigned; DC bias/MPN/LCSC pending
C45 | 100n | 1 | no | /Voltage and NTC/ | YAGEO | TBD |  |  | Capacitor_SMD:C_0402_1005Metric | 25V |  |  | value assigned; DC bias/MPN/LCSC pending
C46 | 1n | 1 | no | /Voltage and NTC/ | YAGEO | TBD |  |  | Capacitor_SMD:C_0402_1005Metric | 25V |  |  | value assigned; DC bias/MPN/LCSC pending
C47 | 100n | 1 | no | /Voltage and NTC/ | YAGEO | TBD |  |  | Capacitor_SMD:C_0402_1005Metric | 25V |  |  | value assigned; DC bias/MPN/LCSC pending
C48 | 1n | 1 | no | /Voltage and NTC/ | YAGEO | TBD |  |  | Capacitor_SMD:C_0402_1005Metric | 25V |  |  | value assigned; DC bias/MPN/LCSC pending
C49 | 100n | 1 | no | /Voltage and NTC/ | YAGEO | TBD |  |  | Capacitor_SMD:C_0402_1005Metric | 25V |  |  | value assigned; DC bias/MPN/LCSC pending
C50 | 10n | 1 | no | /Voltage and NTC/ | YAGEO | TBD |  |  | Capacitor_SMD:C_0402_1005Metric | 25V |  |  | value assigned; DC bias/MPN/LCSC pending
J8 | EXTERNAL 10k NTC | 1 | no | /Voltage and NTC/ |  | PZ127-1-02-Z | C5372825 | https://www.lcsc.com/product-detail/C5372825.html | Inverter_Compact:PinHeader_HCTL_PZ127_1x02_P1.27mm_D0.70mm |  |  |  | compact mechanical engineering candidate; original pin order retained
R48 | 240k | 1 | no | /Voltage and NTC/ | YAGEO | TBD |  |  | Resistor_SMD:R_0805_2012Metric |  | 0.1% |  | value assigned; exact MPN/LCSC pending
R49 | 240k | 1 | no | /Voltage and NTC/ | YAGEO | TBD |  |  | Resistor_SMD:R_0805_2012Metric |  | 0.1% |  | value assigned; exact MPN/LCSC pending
R50 | 10k | 1 | no | /Voltage and NTC/ | YAGEO | TBD |  |  | Resistor_SMD:R_0603_1608Metric |  | 0.1% |  | value assigned; exact MPN/LCSC pending
R51 | 10k | 1 | no | /Voltage and NTC/ | YAGEO | TBD |  |  | Resistor_SMD:R_0603_1608Metric |  | 0.1% |  | value assigned; exact MPN/LCSC pending
R52 | 47 | 1 | no | /Voltage and NTC/ | YAGEO | TBD |  |  | Resistor_SMD:R_0402_1005Metric |  | 1% | Local follower feedback before output isolator; cable and controller ADC RC after resistor | value assigned; exact MPN/LCSC pending
R53 | 240k | 1 | no | /Voltage and NTC/ | YAGEO | TBD |  |  | Resistor_SMD:R_0805_2012Metric |  | 0.1% |  | value assigned; exact MPN/LCSC pending
R54 | 240k | 1 | no | /Voltage and NTC/ | YAGEO | TBD |  |  | Resistor_SMD:R_0805_2012Metric |  | 0.1% |  | value assigned; exact MPN/LCSC pending
R55 | 10k | 1 | no | /Voltage and NTC/ | YAGEO | TBD |  |  | Resistor_SMD:R_0603_1608Metric |  | 0.1% |  | value assigned; exact MPN/LCSC pending
R56 | 10k | 1 | no | /Voltage and NTC/ | YAGEO | TBD |  |  | Resistor_SMD:R_0603_1608Metric |  | 0.1% |  | value assigned; exact MPN/LCSC pending
R57 | 47 | 1 | no | /Voltage and NTC/ | YAGEO | TBD |  |  | Resistor_SMD:R_0402_1005Metric |  | 1% | Local follower feedback before output isolator; cable and controller ADC RC after resistor | value assigned; exact MPN/LCSC pending
R58 | 240k | 1 | no | /Voltage and NTC/ | YAGEO | TBD |  |  | Resistor_SMD:R_0805_2012Metric |  | 0.1% |  | value assigned; exact MPN/LCSC pending
R59 | 240k | 1 | no | /Voltage and NTC/ | YAGEO | TBD |  |  | Resistor_SMD:R_0805_2012Metric |  | 0.1% |  | value assigned; exact MPN/LCSC pending
R60 | 10k | 1 | no | /Voltage and NTC/ | YAGEO | TBD |  |  | Resistor_SMD:R_0603_1608Metric |  | 0.1% |  | value assigned; exact MPN/LCSC pending
R61 | 10k | 1 | no | /Voltage and NTC/ | YAGEO | TBD |  |  | Resistor_SMD:R_0603_1608Metric |  | 0.1% |  | value assigned; exact MPN/LCSC pending
R62 | 47 | 1 | no | /Voltage and NTC/ | YAGEO | TBD |  |  | Resistor_SMD:R_0402_1005Metric |  | 1% | Local follower feedback before output isolator; cable and controller ADC RC after resistor | value assigned; exact MPN/LCSC pending
R63 | 240k | 1 | no | /Voltage and NTC/ | YAGEO | TBD |  |  | Resistor_SMD:R_0805_2012Metric |  | 0.1% |  | value assigned; exact MPN/LCSC pending
R64 | 240k | 1 | no | /Voltage and NTC/ | YAGEO | TBD |  |  | Resistor_SMD:R_0805_2012Metric |  | 0.1% |  | value assigned; exact MPN/LCSC pending
R65 | 10k | 1 | no | /Voltage and NTC/ | YAGEO | TBD |  |  | Resistor_SMD:R_0603_1608Metric |  | 0.1% |  | value assigned; exact MPN/LCSC pending
R66 | 10k | 1 | no | /Voltage and NTC/ | YAGEO | TBD |  |  | Resistor_SMD:R_0603_1608Metric |  | 0.1% |  | value assigned; exact MPN/LCSC pending
R67 | 47 | 1 | no | /Voltage and NTC/ | YAGEO | TBD |  |  | Resistor_SMD:R_0402_1005Metric |  | 1% | Local follower feedback before output isolator; cable and controller ADC RC after resistor | value assigned; exact MPN/LCSC pending
R68 | 20k | 1 | no | /Voltage and NTC/ | YAGEO | TBD |  |  | Resistor_SMD:R_0402_1005Metric |  | 0.1% |  | value assigned; exact MPN/LCSC pending
R69 | 13k | 1 | no | /Voltage and NTC/ | YAGEO | TBD |  |  | Resistor_SMD:R_0402_1005Metric |  | 0.1% |  | value assigned; exact MPN/LCSC pending
R70 | 10k | 1 | no | /Voltage and NTC/ | YAGEO | TBD |  |  | Resistor_SMD:R_0402_1005Metric |  | 1% |  | value assigned; exact MPN/LCSC pending
U14 | TLV9001IDCKR | 1 | no | /Voltage and NTC/ | TI | TLV9001IDCKR | C398362 | https://item.szlcsc.com/380592.html | MyFootprints:SOT-353_SC-70-5 |  |  |  |  | reviewed
U15 | TLV9001IDCKR | 1 | no | /Voltage and NTC/ | TI | TLV9001IDCKR | C398362 | https://item.szlcsc.com/380592.html | MyFootprints:SOT-353_SC-70-5 |  |  |  |  | reviewed
U16 | TLV9001IDCKR | 1 | no | /Voltage and NTC/ | TI | TLV9001IDCKR | C398362 | https://item.szlcsc.com/380592.html | MyFootprints:SOT-353_SC-70-5 |  |  |  |  | reviewed
U17 | TLV9001IDCKR | 1 | no | /Voltage and NTC/ | TI | TLV9001IDCKR | C398362 | https://item.szlcsc.com/380592.html | MyFootprints:SOT-353_SC-70-5 |  |  |  |  | reviewed
C51 | 100n | 1 | no | /Analog protection/ | YAGEO | TBD |  |  | Capacitor_SMD:C_0603_1608Metric | 25V |  |  | value assigned; DC bias/MPN/LCSC pending
C52 | 100n | 1 | no | /Analog protection/ | YAGEO | TBD |  |  | Capacitor_SMD:C_0603_1608Metric | 25V |  |  | value assigned; DC bias/MPN/LCSC pending
C53 | 100n | 1 | no | /Analog protection/ | YAGEO | TBD |  |  | Capacitor_SMD:C_0603_1608Metric | 25V |  |  | value assigned; DC bias/MPN/LCSC pending
C54 | 100n | 1 | no | /Analog protection/ | YAGEO | TBD |  |  | Capacitor_SMD:C_0402_1005Metric | 25V |  |  | value assigned; DC bias/MPN/LCSC pending
R71 | 76.1k | 1 | no | /Analog protection/ | YAGEO | TBD |  |  | Resistor_SMD:R_0402_1005Metric |  | 0.1% |  | value assigned; exact MPN/LCSC pending
R72 | 10k | 1 | no | /Analog protection/ | YAGEO | TBD |  |  | Resistor_SMD:R_0402_1005Metric |  | 0.1% |  | value assigned; exact MPN/LCSC pending
U18 | TLV3202AIDGK | 1 | no | /Analog protection/ | TI | TLV3202AIDGK | C182416 | https://item.szlcsc.com/193816.html | MyFootprints:VSSOP-8_3x3mm_P0.65mm |  |  |  |  | reviewed
U19 | TLV3202AIDGK | 1 | no | /Analog protection/ | TI | TLV3202AIDGK | C182416 | https://item.szlcsc.com/193816.html | MyFootprints:VSSOP-8_3x3mm_P0.65mm |  |  |  |  | reviewed
U20 | TLV3202AIDGK | 1 | no | /Analog protection/ | TI | TLV3202AIDGK | C182416 | https://item.szlcsc.com/193816.html | MyFootprints:VSSOP-8_3x3mm_P0.65mm |  |  |  |  | reviewed
U21 | TLV3202AIDGK | 1 | no | /Analog protection/ | TI | TLV3202AIDGK | C182416 | https://item.szlcsc.com/193816.html | MyFootprints:VSSOP-8_3x3mm_P0.65mm |  |  |  |  | reviewed
C55 | 10n | 1 | no | /Hardware latch/ | YAGEO | TBD |  |  | Capacitor_SMD:C_0402_1005Metric | 25V |  |  | value assigned; DC bias/MPN/LCSC pending
Q8 | MMBT3904LT1G | 1 | no | /Hardware latch/ | onsemi | MMBT3904LT1G | C81464 | https://item.szlcsc.com/82615.html | Package_TO_SOT_SMD:SOT-23 |  |  |  | project draft; public library not modified | project_draft
R73 | 10k | 1 | no | /Hardware latch/ | YAGEO | TBD |  |  | Resistor_SMD:R_0402_1005Metric |  | 1% |  | value assigned; exact MPN/LCSC pending
R74 | 10k | 1 | no | /Hardware latch/ | YAGEO | TBD |  |  | Resistor_SMD:R_0402_1005Metric |  | 1% |  | value assigned; exact MPN/LCSC pending
R75 | 100k | 1 | no | /Hardware latch/ | YAGEO | TBD |  |  | Resistor_SMD:R_0402_1005Metric |  | 1% |  | value assigned; exact MPN/LCSC pending
TP14 | FAULT_LATCH | 1 | no | /Hardware latch/ |  |  |  |  | TestPoint:TestPoint_Pad_D1.5mm
U22 | 74LVC08APW,118 | 1 | no | /Hardware latch/ | Nexperia | 74LVC08APW,118 | C6053 | https://item.szlcsc.com/6519.html | MyFootprints:TSSOP-14_4.4x5mm_P0.65mm |  |  |  |  | reviewed
U23 | 74LVC08APW,118 | 1 | no | /Hardware latch/ | Nexperia | 74LVC08APW,118 | C6053 | https://item.szlcsc.com/6519.html | MyFootprints:TSSOP-14_4.4x5mm_P0.65mm |  |  |  |  | reviewed
U24 | 74LVC08APW,118 | 1 | no | /Hardware latch/ | Nexperia | 74LVC08APW,118 | C6053 | https://item.szlcsc.com/6519.html | MyFootprints:TSSOP-14_4.4x5mm_P0.65mm |  |  |  |  | reviewed
U25 | 74LVC08APW,118 | 1 | no | /Hardware latch/ | Nexperia | 74LVC08APW,118 | C6053 | https://item.szlcsc.com/6519.html | MyFootprints:TSSOP-14_4.4x5mm_P0.65mm |  |  |  |  | reviewed
U27 | 74LVC00APW,118 | 1 | no | /Hardware latch/ | Nexperia | 74LVC00APW,118 | C6045 | https://item.szlcsc.com/6511.html | MyFootprints:TSSOP-14_4.4x5mm_P0.65mm |  |  |  |  | reviewed
C56 | 100n | 1 | no | /Hardware PWM gates/ | YAGEO | TBD |  |  | Capacitor_SMD:C_0402_1005Metric | 25V |  |  | value assigned; DC bias/MPN/LCSC pending
C57 | 100n | 1 | no | /Hardware PWM gates/ | YAGEO | TBD |  |  | Capacitor_SMD:C_0402_1005Metric | 25V |  |  | value assigned; DC bias/MPN/LCSC pending
C58 | 100n | 1 | no | /Hardware PWM gates/ | YAGEO | TBD |  |  | Capacitor_SMD:C_0402_1005Metric | 25V |  |  | value assigned; DC bias/MPN/LCSC pending
C59 | 100n | 1 | no | /Hardware PWM gates/ | YAGEO | TBD |  |  | Capacitor_SMD:C_0402_1005Metric | 25V |  |  | value assigned; DC bias/MPN/LCSC pending
C60 | 100n | 1 | no | /Hardware PWM gates/ | YAGEO | TBD |  |  | Capacitor_SMD:C_0402_1005Metric | 25V |  |  | value assigned; DC bias/MPN/LCSC pending
C61 | 100n | 1 | no | /Hardware PWM gates/ | YAGEO | TBD |  |  | Capacitor_SMD:C_0402_1005Metric | 25V |  |  | value assigned; DC bias/MPN/LCSC pending
R76 | 10k | 1 | no | /Hardware PWM gates/ | YAGEO | TBD |  |  | Resistor_SMD:R_0402_1005Metric |  | 1% |  | value assigned; exact MPN/LCSC pending
R77 | 10k | 1 | no | /Hardware PWM gates/ | YAGEO | TBD |  |  | Resistor_SMD:R_0402_1005Metric |  | 1% |  | value assigned; exact MPN/LCSC pending
R78 | 10k | 1 | no | /Hardware PWM gates/ | YAGEO | TBD |  |  | Resistor_SMD:R_0402_1005Metric |  | 1% |  | value assigned; exact MPN/LCSC pending
R79 | 10k | 1 | no | /Hardware PWM gates/ | YAGEO | TBD |  |  | Resistor_SMD:R_0402_1005Metric |  | 1% |  | value assigned; exact MPN/LCSC pending
R80 | 10k | 1 | no | /Hardware PWM gates/ | YAGEO | TBD |  |  | Resistor_SMD:R_0402_1005Metric |  | 1% |  | value assigned; exact MPN/LCSC pending
R81 | 10k | 1 | no | /Hardware PWM gates/ | YAGEO | TBD |  |  | Resistor_SMD:R_0402_1005Metric |  | 1% |  | value assigned; exact MPN/LCSC pending
R82 | 10k | 1 | no | /Hardware PWM gates/ | YAGEO | TBD |  |  | Resistor_SMD:R_0402_1005Metric |  | 1% |  | value assigned; exact MPN/LCSC pending
R83 | 100k | 1 | no | /Hardware PWM gates/ | YAGEO | TBD |  |  | Resistor_SMD:R_0402_1005Metric |  | 1% |  | value assigned; exact MPN/LCSC pending
U26 | 74LVC08APW,118 | 1 | no | /Hardware PWM gates/ | Nexperia | 74LVC08APW,118 | C6053 | https://item.szlcsc.com/6519.html | MyFootprints:TSSOP-14_4.4x5mm_P0.65mm |  |  |  |  | reviewed
R160 | 10k | 1 | no | /Base interlock/ | YAGEO | TBD |  |  | Resistor_SMD:R_0402_1005Metric |  | 1% |  | value assigned; exact MPN/LCSC pending
D3 | PWR | 1 | no | /Base LEDs/ |  | TBD |  |  | LED_SMD:LED_0603_1608Metric |  |  |  | color/MPN pending
R130 | 2.2k | 1 | no | /Base LEDs/ | YAGEO | TBD |  |  | Resistor_SMD:R_0402_1005Metric |  | 1% |  | value assigned; exact MPN/LCSC pending
R135 | 33 | 1 | no | /GPIO command coupling/ | YAGEO | TBD |  |  | Resistor_SMD:R_0402_1005Metric |  | 1% |  | value assigned; exact MPN/LCSC pending
R136 | 33 | 1 | no | /GPIO command coupling/ | YAGEO | TBD |  |  | Resistor_SMD:R_0402_1005Metric |  | 1% |  | value assigned; exact MPN/LCSC pending
R137 | 33 | 1 | no | /GPIO command coupling/ | YAGEO | TBD |  |  | Resistor_SMD:R_0402_1005Metric |  | 1% |  | value assigned; exact MPN/LCSC pending
R138 | 33 | 1 | no | /GPIO command coupling/ | YAGEO | TBD |  |  | Resistor_SMD:R_0402_1005Metric |  | 1% |  | value assigned; exact MPN/LCSC pending
R139 | 33 | 1 | no | /GPIO command coupling/ | YAGEO | TBD |  |  | Resistor_SMD:R_0402_1005Metric |  | 1% |  | value assigned; exact MPN/LCSC pending
R140 | 33 | 1 | no | /GPIO command coupling/ | YAGEO | TBD |  |  | Resistor_SMD:R_0402_1005Metric |  | 1% |  | value assigned; exact MPN/LCSC pending
R141 | 33 | 1 | no | /GPIO command coupling/ | YAGEO | TBD |  |  | Resistor_SMD:R_0402_1005Metric |  | 1% |  | value assigned; exact MPN/LCSC pending
R142 | 33 | 1 | no | /GPIO command coupling/ | YAGEO | TBD |  |  | Resistor_SMD:R_0402_1005Metric |  | 1% |  | value assigned; exact MPN/LCSC pending
R143 | 10k | 1 | no | /GPIO command coupling/ | YAGEO | TBD |  |  | Resistor_SMD:R_0402_1005Metric |  | 1% | Required local pullup; Q8 open collector drives TIM1 BKIN low on fault | value assigned; exact MPN/LCSC pending
C69 | 1n | 1 | no | /ADC and status returns/ | YAGEO | TBD |  |  | Capacitor_SMD:C_0402_1005Metric | 16 V minimum |  | Provisional RC; acquisition time and PWM sampling window to be validated | value assigned; DC bias/MPN/LCSC pending
C70 | 1n | 1 | no | /ADC and status returns/ | YAGEO | TBD |  |  | Capacitor_SMD:C_0402_1005Metric | 16 V minimum |  | Provisional RC; acquisition time and PWM sampling window to be validated | value assigned; DC bias/MPN/LCSC pending
C71 | 1n | 1 | no | /ADC and status returns/ | YAGEO | TBD |  |  | Capacitor_SMD:C_0402_1005Metric | 16 V minimum |  | Provisional RC; acquisition time and PWM sampling window to be validated | value assigned; DC bias/MPN/LCSC pending
C72 | 1n | 1 | no | /ADC and status returns/ | YAGEO | TBD |  |  | Capacitor_SMD:C_0402_1005Metric | 16 V minimum |  | Provisional RC; acquisition time and PWM sampling window to be validated | value assigned; DC bias/MPN/LCSC pending
C73 | 1n | 1 | no | /ADC and status returns/ | YAGEO | TBD |  |  | Capacitor_SMD:C_0402_1005Metric | 16 V minimum |  | Provisional RC; acquisition time and PWM sampling window to be validated | value assigned; DC bias/MPN/LCSC pending
C74 | 1n | 1 | no | /ADC and status returns/ | YAGEO | TBD |  |  | Capacitor_SMD:C_0402_1005Metric | 16 V minimum |  | Provisional RC; acquisition time and PWM sampling window to be validated | value assigned; DC bias/MPN/LCSC pending
C75 | 1n | 1 | no | /ADC and status returns/ | YAGEO | TBD |  |  | Capacitor_SMD:C_0402_1005Metric | 16 V minimum |  | Provisional RC; acquisition time and PWM sampling window to be validated | value assigned; DC bias/MPN/LCSC pending
C76 | 1n | 1 | no | /ADC and status returns/ | YAGEO | TBD |  |  | Capacitor_SMD:C_0402_1005Metric | 16 V minimum |  | Provisional RC; acquisition time and PWM sampling window to be validated | value assigned; DC bias/MPN/LCSC pending
D201 | BAT54S,215 | 1 | no | /ADC and status returns/ | Nexperia | BAT54S,215 | C47546 | https://www.lcsc.com/product-detail/C47546.html | Package_TO_SOT_SMD:SOT-23 |  |  | DS 2022-07-01: pin1=A1 GND; pin2=K2 3V3_MCU; pin3=K1/A2 clamped signal. Basic transient clamps, no galvanic isolation. |  | project_draft
D202 | BAT54S,215 | 1 | no | /ADC and status returns/ | Nexperia | BAT54S,215 | C47546 | https://www.lcsc.com/product-detail/C47546.html | Package_TO_SOT_SMD:SOT-23 |  |  | DS 2022-07-01: pin1=A1 GND; pin2=K2 3V3_MCU; pin3=K1/A2 clamped signal. Basic transient clamps, no galvanic isolation. |  | project_draft
D203 | BAT54S,215 | 1 | no | /ADC and status returns/ | Nexperia | BAT54S,215 | C47546 | https://www.lcsc.com/product-detail/C47546.html | Package_TO_SOT_SMD:SOT-23 |  |  | DS 2022-07-01: pin1=A1 GND; pin2=K2 3V3_MCU; pin3=K1/A2 clamped signal. Basic transient clamps, no galvanic isolation. |  | project_draft
D204 | BAT54S,215 | 1 | no | /ADC and status returns/ | Nexperia | BAT54S,215 | C47546 | https://www.lcsc.com/product-detail/C47546.html | Package_TO_SOT_SMD:SOT-23 |  |  | DS 2022-07-01: pin1=A1 GND; pin2=K2 3V3_MCU; pin3=K1/A2 clamped signal. Basic transient clamps, no galvanic isolation. |  | project_draft
D205 | BAT54S,215 | 1 | no | /ADC and status returns/ | Nexperia | BAT54S,215 | C47546 | https://www.lcsc.com/product-detail/C47546.html | Package_TO_SOT_SMD:SOT-23 |  |  | DS 2022-07-01: pin1=A1 GND; pin2=K2 3V3_MCU; pin3=K1/A2 clamped signal. Basic transient clamps, no galvanic isolation. |  | project_draft
D206 | BAT54S,215 | 1 | no | /ADC and status returns/ | Nexperia | BAT54S,215 | C47546 | https://www.lcsc.com/product-detail/C47546.html | Package_TO_SOT_SMD:SOT-23 |  |  | DS 2022-07-01: pin1=A1 GND; pin2=K2 3V3_MCU; pin3=K1/A2 clamped signal. Basic transient clamps, no galvanic isolation. |  | project_draft
D207 | BAT54S,215 | 1 | no | /ADC and status returns/ | Nexperia | BAT54S,215 | C47546 | https://www.lcsc.com/product-detail/C47546.html | Package_TO_SOT_SMD:SOT-23 |  |  | DS 2022-07-01: pin1=A1 GND; pin2=K2 3V3_MCU; pin3=K1/A2 clamped signal. Basic transient clamps, no galvanic isolation. |  | project_draft
D208 | BAT54S,215 | 1 | no | /ADC and status returns/ | Nexperia | BAT54S,215 | C47546 | https://www.lcsc.com/product-detail/C47546.html | Package_TO_SOT_SMD:SOT-23 |  |  | DS 2022-07-01: pin1=A1 GND; pin2=K2 3V3_MCU; pin3=K1/A2 clamped signal. Basic transient clamps, no galvanic isolation. |  | project_draft
D209 | BAT54S,215 | 1 | no | /ADC and status returns/ | Nexperia | BAT54S,215 | C47546 | https://www.lcsc.com/product-detail/C47546.html | Package_TO_SOT_SMD:SOT-23 |  |  | 1 GND,2 3V3_MCU,3 protected return status. Fault pullup remains on the protected MCU side. |  | project_draft
D210 | BAT54S,215 | 1 | no | /ADC and status returns/ | Nexperia | BAT54S,215 | C47546 | https://www.lcsc.com/product-detail/C47546.html | Package_TO_SOT_SMD:SOT-23 |  |  | 1 GND,2 3V3_MCU,3 protected return status. Fault pullup remains on the protected MCU side. |  | project_draft
R84 | 100 | 1 | no | /ADC and status returns/ | YAGEO | TBD |  |  | Resistor_SMD:R_0402_1005Metric |  | 1% | Local ADC isolation; 47R source isolator also present except NTC | value assigned; exact MPN/LCSC pending
R85 | 100 | 1 | no | /ADC and status returns/ | YAGEO | TBD |  |  | Resistor_SMD:R_0402_1005Metric |  | 1% | Local ADC isolation; 47R source isolator also present except NTC | value assigned; exact MPN/LCSC pending
R86 | 100 | 1 | no | /ADC and status returns/ | YAGEO | TBD |  |  | Resistor_SMD:R_0402_1005Metric |  | 1% | Local ADC isolation; 47R source isolator also present except NTC | value assigned; exact MPN/LCSC pending
R87 | 100 | 1 | no | /ADC and status returns/ | YAGEO | TBD |  |  | Resistor_SMD:R_0402_1005Metric |  | 1% | Local ADC isolation; 47R source isolator also present except NTC | value assigned; exact MPN/LCSC pending
R88 | 100 | 1 | no | /ADC and status returns/ | YAGEO | TBD |  |  | Resistor_SMD:R_0402_1005Metric |  | 1% | Local ADC isolation; 47R source isolator also present except NTC | value assigned; exact MPN/LCSC pending
R89 | 100 | 1 | no | /ADC and status returns/ | YAGEO | TBD |  |  | Resistor_SMD:R_0402_1005Metric |  | 1% | Local ADC isolation; 47R source isolator also present except NTC | value assigned; exact MPN/LCSC pending
R90 | 100 | 1 | no | /ADC and status returns/ | YAGEO | TBD |  |  | Resistor_SMD:R_0402_1005Metric |  | 1% | Local ADC isolation; 47R source isolator also present except NTC | value assigned; exact MPN/LCSC pending
R91 | 100 | 1 | no | /ADC and status returns/ | YAGEO | TBD |  |  | Resistor_SMD:R_0402_1005Metric |  | 1% | Local ADC isolation; 47R source isolator also present except NTC | value assigned; exact MPN/LCSC pending
R201 | 360 | 1 | no | /ADC and status returns/ | YAGEO | TBD |  |  | Resistor_SMD:R_0603_1608Metric |  | 1% | Input transient limiting; with original 100R gives 460R / 1n, tau about 0.46us. Not a 60V fault barrier. | exact YAGEO MPN pending
R202 | 360 | 1 | no | /ADC and status returns/ | YAGEO | TBD |  |  | Resistor_SMD:R_0603_1608Metric |  | 1% | Input transient limiting; with original 100R gives 460R / 1n, tau about 0.46us. Not a 60V fault barrier. | exact YAGEO MPN pending
R203 | 360 | 1 | no | /ADC and status returns/ | YAGEO | TBD |  |  | Resistor_SMD:R_0603_1608Metric |  | 1% | Input transient limiting; with original 100R gives 460R / 1n, tau about 0.46us. Not a 60V fault barrier. | exact YAGEO MPN pending
R204 | 360 | 1 | no | /ADC and status returns/ | YAGEO | TBD |  |  | Resistor_SMD:R_0603_1608Metric |  | 1% | Input transient limiting; with original 100R gives 460R / 1n, tau about 0.46us. Not a 60V fault barrier. | exact YAGEO MPN pending
R205 | 360 | 1 | no | /ADC and status returns/ | YAGEO | TBD |  |  | Resistor_SMD:R_0603_1608Metric |  | 1% | Input transient limiting; with original 100R gives 460R / 1n, tau about 0.46us. Not a 60V fault barrier. | exact YAGEO MPN pending
R206 | 360 | 1 | no | /ADC and status returns/ | YAGEO | TBD |  |  | Resistor_SMD:R_0603_1608Metric |  | 1% | Input transient limiting; with original 100R gives 460R / 1n, tau about 0.46us. Not a 60V fault barrier. | exact YAGEO MPN pending
R207 | 360 | 1 | no | /ADC and status returns/ | YAGEO | TBD |  |  | Resistor_SMD:R_0603_1608Metric |  | 1% | Input transient limiting; with original 100R gives 460R / 1n, tau about 0.46us. Not a 60V fault barrier. | exact YAGEO MPN pending
R208 | 360 | 1 | no | /ADC and status returns/ | YAGEO | TBD |  |  | Resistor_SMD:R_0603_1608Metric |  | 1% | Input transient limiting; with original 100R gives 460R / 1n, tau about 0.46us. Not a 60V fault barrier. | exact YAGEO MPN pending
R209 | 10k | 1 | no | /ADC and status returns/ | YAGEO | TBD |  |  | Resistor_SMD:R_0603_1608Metric |  |  | BASE_READY_MCU reads LOW if unplugged or the base output is unpowered.
R210 | 1k | 1 | no | /ADC and status returns/ | YAGEO | TBD |  |  | Resistor_SMD:R_0603_1608Metric |  | 1% | Return-status transient limiting; 1k with the 10k local pull gives valid logic levels. No isolation.
R211 | 1k | 1 | no | /ADC and status returns/ | YAGEO | TBD |  |  | Resistor_SMD:R_0603_1608Metric |  | 1% | Return-status transient limiting; 1k with the 10k local pull gives valid logic levels. No isolation.
J9 | ENC_A: PWR GND A B Z | 1 | no | /Encoders and SPI/ |  | PZ127-1-05-Z | C5372828 | https://www.lcsc.com/product-detail/C5372828.html | Inverter_Compact:PinHeader_HCTL_PZ127_1x05_P1.27mm_D0.70mm |  |  |  | compact mechanical engineering candidate; original pin order retained
J10 | ENC_B: PWR GND A B Z | 1 | no | /Encoders and SPI/ |  | PZ127-1-05-Z | C5372828 | https://www.lcsc.com/product-detail/C5372828.html | Inverter_Compact:PinHeader_HCTL_PZ127_1x05_P1.27mm_D0.70mm |  |  |  | compact mechanical engineering candidate; original pin order retained
J11 | SPI_A: PWR GND SCK MOSI MISO CS | 1 | no | /Encoders and SPI/ |  | PZ127-1-06-Z | C5372829 | https://www.lcsc.com/product-detail/C5372829.html | Inverter_Compact:PinHeader_HCTL_PZ127_1x06_P1.27mm_D0.70mm |  |  |  | compact mechanical engineering candidate; original pin order retained
J12 | SPI_B: PWR GND SCK MOSI MISO CS | 1 | no | /Encoders and SPI/ |  | PZ127-1-06-Z | C5372829 | https://www.lcsc.com/product-detail/C5372829.html | Inverter_Compact:PinHeader_HCTL_PZ127_1x06_P1.27mm_D0.70mm |  |  |  | compact mechanical engineering candidate; original pin order retained
R94 | 100 | 1 | no | /Encoders and SPI/ | YAGEO | TBD |  |  | Resistor_SMD:R_0402_1005Metric |  | 1% |  | value assigned; exact MPN/LCSC pending
R95 | 10k | 1 | no | /Encoders and SPI/ | YAGEO | TBD |  |  | Resistor_SMD:R_0402_1005Metric |  | 1% | For 3.3V open-collector/push-pull only; no 5V logic | value assigned; exact MPN/LCSC pending
R96 | 100 | 1 | no | /Encoders and SPI/ | YAGEO | TBD |  |  | Resistor_SMD:R_0402_1005Metric |  | 1% |  | value assigned; exact MPN/LCSC pending
R97 | 10k | 1 | no | /Encoders and SPI/ | YAGEO | TBD |  |  | Resistor_SMD:R_0402_1005Metric |  | 1% | For 3.3V open-collector/push-pull only; no 5V logic | value assigned; exact MPN/LCSC pending
R98 | 100 | 1 | no | /Encoders and SPI/ | YAGEO | TBD |  |  | Resistor_SMD:R_0402_1005Metric |  | 1% |  | value assigned; exact MPN/LCSC pending
R99 | 10k | 1 | no | /Encoders and SPI/ | YAGEO | TBD |  |  | Resistor_SMD:R_0402_1005Metric |  | 1% | For 3.3V open-collector/push-pull only; no 5V logic | value assigned; exact MPN/LCSC pending
R100 | 0 | 1 | yes | /Encoders and SPI/ | YAGEO | TBD |  |  | Resistor_SMD:R_0402_1005Metric |  | 1% | DNP until encoder power/output stage selected; 5V supply is not 5V logic compatibility | value assigned; exact MPN/LCSC pending
R101 | 100 | 1 | no | /Encoders and SPI/ | YAGEO | TBD |  |  | Resistor_SMD:R_0402_1005Metric |  | 1% |  | value assigned; exact MPN/LCSC pending
R102 | 10k | 1 | no | /Encoders and SPI/ | YAGEO | TBD |  |  | Resistor_SMD:R_0402_1005Metric |  | 1% | For 3.3V open-collector/push-pull only; no 5V logic | value assigned; exact MPN/LCSC pending
R103 | 100 | 1 | no | /Encoders and SPI/ | YAGEO | TBD |  |  | Resistor_SMD:R_0402_1005Metric |  | 1% |  | value assigned; exact MPN/LCSC pending
R104 | 10k | 1 | no | /Encoders and SPI/ | YAGEO | TBD |  |  | Resistor_SMD:R_0402_1005Metric |  | 1% | For 3.3V open-collector/push-pull only; no 5V logic | value assigned; exact MPN/LCSC pending
R105 | 100 | 1 | no | /Encoders and SPI/ | YAGEO | TBD |  |  | Resistor_SMD:R_0402_1005Metric |  | 1% |  | value assigned; exact MPN/LCSC pending
R106 | 10k | 1 | no | /Encoders and SPI/ | YAGEO | TBD |  |  | Resistor_SMD:R_0402_1005Metric |  | 1% | For 3.3V open-collector/push-pull only; no 5V logic | value assigned; exact MPN/LCSC pending
R107 | 0 | 1 | yes | /Encoders and SPI/ | YAGEO | TBD |  |  | Resistor_SMD:R_0402_1005Metric |  | 1% | DNP until encoder power/output stage selected; 5V supply is not 5V logic compatibility | value assigned; exact MPN/LCSC pending
R108 | 33 | 1 | no | /Encoders and SPI/ | YAGEO | TBD |  |  | Resistor_SMD:R_0402_1005Metric |  | 1% |  | value assigned; exact MPN/LCSC pending
R109 | 33 | 1 | no | /Encoders and SPI/ | YAGEO | TBD |  |  | Resistor_SMD:R_0402_1005Metric |  | 1% |  | value assigned; exact MPN/LCSC pending
R110 | 33 | 1 | no | /Encoders and SPI/ | YAGEO | TBD |  |  | Resistor_SMD:R_0402_1005Metric |  | 1% |  | value assigned; exact MPN/LCSC pending
R111 | 33 | 1 | no | /Encoders and SPI/ | YAGEO | TBD |  |  | Resistor_SMD:R_0402_1005Metric |  | 1% |  | value assigned; exact MPN/LCSC pending
R112 | 10k | 1 | no | /Encoders and SPI/ | YAGEO | TBD |  |  | Resistor_SMD:R_0402_1005Metric |  | 1% |  | value assigned; exact MPN/LCSC pending
R113 | 0 | 1 | yes | /Encoders and SPI/ | YAGEO | TBD |  |  | Resistor_SMD:R_0402_1005Metric |  | 1% | DNP until external module is selected; IO stays 3.3V | value assigned; exact MPN/LCSC pending
R114 | 33 | 1 | no | /Encoders and SPI/ | YAGEO | TBD |  |  | Resistor_SMD:R_0402_1005Metric |  | 1% |  | value assigned; exact MPN/LCSC pending
R115 | 33 | 1 | no | /Encoders and SPI/ | YAGEO | TBD |  |  | Resistor_SMD:R_0402_1005Metric |  | 1% |  | value assigned; exact MPN/LCSC pending
R116 | 33 | 1 | no | /Encoders and SPI/ | YAGEO | TBD |  |  | Resistor_SMD:R_0402_1005Metric |  | 1% |  | value assigned; exact MPN/LCSC pending
R117 | 33 | 1 | no | /Encoders and SPI/ | YAGEO | TBD |  |  | Resistor_SMD:R_0402_1005Metric |  | 1% |  | value assigned; exact MPN/LCSC pending
R118 | 10k | 1 | no | /Encoders and SPI/ | YAGEO | TBD |  |  | Resistor_SMD:R_0402_1005Metric |  | 1% |  | value assigned; exact MPN/LCSC pending
R119 | 0 | 1 | yes | /Encoders and SPI/ | YAGEO | TBD |  |  | Resistor_SMD:R_0402_1005Metric |  | 1% | DNP until external module is selected; IO stays 3.3V | value assigned; exact MPN/LCSC pending
C82 | 100n | 1 | yes | /SWD UART CAN and status/ | YAGEO | TBD |  |  | Capacitor_SMD:C_0402_1005Metric | 16 V minimum |  |  | value assigned; DC bias/MPN/LCSC pending
D4 | LED_RUN | 1 | no | /SWD UART CAN and status/ |  | TBD |  |  | LED_SMD:LED_0603_1608Metric |  |  |  | color/MPN pending
D5 | LED_FAULT | 1 | no | /SWD UART CAN and status/ |  | TBD |  |  | LED_SMD:LED_0603_1608Metric |  |  |  | color/MPN pending
D6 | LED_COMM | 1 | no | /SWD UART CAN and status/ |  | TBD |  |  | LED_SMD:LED_0603_1608Metric |  |  |  | color/MPN pending
D7 | LED_AUX | 1 | no | /SWD UART CAN and status/ |  | TBD |  |  | LED_SMD:LED_0603_1608Metric |  |  |  | color/MPN pending
J13 | SWD: VTREF IO CLK GND NRST | 1 | no | /SWD UART CAN and status/ |  | PZ127-1-05-Z | C5372828 | https://www.lcsc.com/product-detail/C5372828.html | Inverter_Compact:PinHeader_HCTL_PZ127_1x05_P1.27mm_D0.70mm |  |  |  | compact mechanical engineering candidate; original pin order retained
J14 | TTL: TX RX GND | 1 | no | /SWD UART CAN and status/ |  | PZ127-1-03-Z | C5372826 | https://www.lcsc.com/product-detail/C5372826.html | Inverter_Compact:PinHeader_HCTL_PZ127_1x03_P1.27mm_D0.70mm |  |  |  | compact mechanical engineering candidate; original pin order retained
J15 | CAN: H L GND | 1 | yes | /SWD UART CAN and status/ |  | PZ127-1-03-Z | C5372826 | https://www.lcsc.com/product-detail/C5372826.html | Inverter_Compact:PinHeader_HCTL_PZ127_1x03_P1.27mm_D0.70mm |  |  |  | compact mechanical engineering candidate; original pin order retained
R120 | 33 | 1 | no | /SWD UART CAN and status/ | YAGEO | TBD |  |  | Resistor_SMD:R_0402_1005Metric |  | 1% |  | value assigned; exact MPN/LCSC pending
R121 | 33 | 1 | no | /SWD UART CAN and status/ | YAGEO | TBD |  |  | Resistor_SMD:R_0402_1005Metric |  | 1% |  | value assigned; exact MPN/LCSC pending
R123 | 33 | 1 | no | /SWD UART CAN and status/ | YAGEO | TBD |  |  | Resistor_SMD:R_0402_1005Metric |  | 1% |  | value assigned; exact MPN/LCSC pending
R124 | 100 | 1 | no | /SWD UART CAN and status/ | YAGEO | TBD |  |  | Resistor_SMD:R_0402_1005Metric |  | 1% |  | value assigned; exact MPN/LCSC pending
R125 | 10k | 1 | no | /SWD UART CAN and status/ | YAGEO | TBD |  |  | Resistor_SMD:R_0402_1005Metric |  | 1% |  | value assigned; exact MPN/LCSC pending
R126 | 0 | 1 | yes | /SWD UART CAN and status/ | YAGEO | TBD |  |  | Resistor_SMD:R_0402_1005Metric |  | 1% |  | value assigned; exact MPN/LCSC pending
R127 | 0 | 1 | yes | /SWD UART CAN and status/ | YAGEO | TBD |  |  | Resistor_SMD:R_0402_1005Metric |  | 1% |  | value assigned; exact MPN/LCSC pending
R128 | 10k | 1 | yes | /SWD UART CAN and status/ | YAGEO | TBD |  |  | Resistor_SMD:R_0402_1005Metric |  | 1% |  | value assigned; exact MPN/LCSC pending
R129 | 120 | 1 | yes | /SWD UART CAN and status/ | YAGEO | TBD |  |  | Resistor_SMD:R_0402_1005Metric |  | 1% | Fit only at bus end; CAN PHY is classic <=1Mbps, not CAN-FD rated | value assigned; exact MPN/LCSC pending
R131 | 2.2k | 1 | no | /SWD UART CAN and status/ | YAGEO | TBD |  |  | Resistor_SMD:R_0402_1005Metric |  | 1% |  | value assigned; exact MPN/LCSC pending
R132 | 2.2k | 1 | no | /SWD UART CAN and status/ | YAGEO | TBD |  |  | Resistor_SMD:R_0402_1005Metric |  | 1% |  | value assigned; exact MPN/LCSC pending
R133 | 2.2k | 1 | no | /SWD UART CAN and status/ | YAGEO | TBD |  |  | Resistor_SMD:R_0402_1005Metric |  | 1% |  | value assigned; exact MPN/LCSC pending
R134 | 2.2k | 1 | no | /SWD UART CAN and status/ | YAGEO | TBD |  |  | Resistor_SMD:R_0402_1005Metric |  | 1% |  | value assigned; exact MPN/LCSC pending
U31 | SN65HVD232DR | 1 | yes | /SWD UART CAN and status/ | TI | SN65HVD232DR | C30530 | https://item.szlcsc.com/31287.html | MyFootprints:SOIC-8_3.9x4.9mm_P1.27mm |  |  |  |  | reviewed
J101 | PM254V-12-32-H85 | 1 | no | /64-pin core sockets/ | XFCN | PM254V-12-32-H85 | C46595991 | https://www.lcsc.com/product-detail/C46595991.html | Connector_PinSocket_2.54mm:PinSocket_2x16_P2.54mm_Vertical |  |  | Core TOP male faces UP into power board BOTTOM socket facing DOWN. Both boards 60x60mm; power above core. Recheck physical pin1/rotation; not Rev D 40-pin compatible. | P2.54 2x16 candidate; actual mating height, pin1 and land pattern pending | project_draft
J102 | PM254V-12-32-H85 | 1 | no | /64-pin core sockets/ | XFCN | PM254V-12-32-H85 | C46595991 | https://www.lcsc.com/product-detail/C46595991.html | Connector_PinSocket_2.54mm:PinSocket_2x16_P2.54mm_Vertical |  |  | Core TOP male faces UP into power board BOTTOM socket facing DOWN. Both boards 60x60mm; power above core. Recheck physical pin1/rotation; not Rev D 40-pin compatible. | P2.54 2x16 candidate; actual mating height, pin1 and land pattern pending | project_draft
TP16 | FAULT_N | 1 | no | /64-pin core sockets/ |  |  |  |  | TestPoint:TestPoint_Pad_D1.5mm
TP17 | ENABLE_IN | 1 | no | /64-pin core sockets/ |  |  |  |  | TestPoint:TestPoint_Pad_D1.5mm
