leolei2012/power_system/controller/hardware/g431_core/review/bom_issue2.csv

Reference | Value | Footprint | Manufacturer | MPN | Supplier | Supplier_PN | LCSC | Purchase_URL | Voltage_Rating | Tolerance | DNP | Qty
C63 | 100n | MyFootprints:C_0603_1608Metric | YAGEO | CC0603KRX7R9BB104 | LCSC | C14663 | C14663 | https://item.szlcsc.com/15331.html | 50V | 10% |  | 1
C64 | 100n | MyFootprints:C_0603_1608Metric | YAGEO | CC0603KRX7R9BB104 | LCSC | C14663 | C14663 | https://item.szlcsc.com/15331.html | 50V | 10% |  | 1
C65 | 100n | MyFootprints:C_0603_1608Metric | YAGEO | CC0603KRX7R9BB104 | LCSC | C14663 | C14663 | https://item.szlcsc.com/15331.html | 50V | 10% |  | 1
C66 | 100n | MyFootprints:C_0603_1608Metric | YAGEO | CC0603KRX7R9BB104 | LCSC | C14663 | C14663 | https://item.szlcsc.com/15331.html | 50V | 10% |  | 1
C67 | 100n | MyFootprints:C_0603_1608Metric | YAGEO | CC0603KRX7R9BB104 | LCSC | C14663 | C14663 | https://item.szlcsc.com/15331.html | 50V | 10% |  | 1
C68 | 4.7u | Capacitor_SMD:C_0603_1608Metric | YAGEO | TBD | LCSC |  |  |  | 16 V minimum |  |  | 1
C77 | 100n | MyFootprints:C_0603_1608Metric | YAGEO | CC0603KRX7R9BB104 | LCSC | C14663 | C14663 | https://item.szlcsc.com/15331.html | 50V | 10% |  | 1
C78 | 1u | Capacitor_SMD:C_0603_1608Metric | YAGEO | TBD | LCSC |  |  |  | 16 V minimum |  |  | 1
C79 | 100n | MyFootprints:C_0603_1608Metric | YAGEO | CC0603KRX7R9BB104 | LCSC | C14663 | C14663 | https://item.szlcsc.com/15331.html | 50V | 10% |  | 1
C80 | 1u | Capacitor_SMD:C_0603_1608Metric | YAGEO | TBD | LCSC |  |  |  | 16 V minimum |  |  | 1
C81 | 100n | MyFootprints:C_0603_1608Metric | YAGEO | CC0603KRX7R9BB104 | LCSC | C14663 | C14663 | https://item.szlcsc.com/15331.html | 50V | 10% |  | 1
C83 | 18p / provisional | MyFootprints:C_0603_1608Metric | YAGEO | CC0603JRNPO9BN180 | LCSC | C107040 | C107040 | https://item.szlcsc.com/108256.html | 50V | 5% | DNP | 1
C84 | 18p / provisional | MyFootprints:C_0603_1608Metric | YAGEO | CC0603JRNPO9BN180 | LCSC | C107040 | C107040 | https://item.szlcsc.com/108256.html | 50V | 5% | DNP | 1
C201 | 1n | Capacitor_SMD:C_0603_1608Metric |  | 待#5 |  |  | 待#5 |  | 待#5（设计要求 ≥10 V） |  |  | 1
C202 | 1n | Capacitor_SMD:C_0603_1608Metric |  | 待#5 |  |  | 待#5 |  | 待#5（设计要求 ≥10 V） |  |  | 1
C203 | 1n | Capacitor_SMD:C_0603_1608Metric |  | 待#5 |  |  | 待#5 |  | 待#5（设计要求 ≥10 V） |  |  | 1
C204 | 1n | Capacitor_SMD:C_0603_1608Metric |  | 待#5 |  |  | 待#5 |  | 待#5（设计要求 ≥10 V） |  |  | 1
C205 | 10n | Capacitor_SMD:C_0603_1608Metric |  | 待#5 |  |  | 待#5 |  | 待#5（设计要求 ≥10 V） |  |  | 1
C206 | 10n | Capacitor_SMD:C_0603_1608Metric |  | 待#5 |  |  | 待#5 |  | 待#5（设计要求 ≥10 V） |  |  | 1
C207 | 10n | Capacitor_SMD:C_0603_1608Metric |  | 待#5 |  |  | 待#5 |  | 待#5（设计要求 ≥10 V） |  |  | 1
C208 | 10n | Capacitor_SMD:C_0603_1608Metric |  | 待#5 |  |  | 待#5 |  | 待#5（设计要求 ≥10 V） |  |  | 1
C209 | 100n | Capacitor_SMD:C_0603_1608Metric | YAGEO | CC0603KRX7R9BB104 | LCSC | C14663 | C14663 | https://www.lcsc.com/product-detail/C14663.html |  | 10% |  | 1
C210 | 100n | Capacitor_SMD:C_0603_1608Metric | YAGEO | CC0603KRX7R9BB104 | LCSC | C14663 | C14663 | https://www.lcsc.com/product-detail/C14663.html |  | 10% |  | 1
C211 | 100n | MyFootprints:C_0603_1608Metric | YAGEO | CC0603KRX7R9BB104 | LCSC | C14663 | C14663 | https://item.szlcsc.com/15331.html | 50V | 10% |  | 1
C212 | 4.7u | Capacitor_SMD:C_0805_2012Metric | YAGEO | TBD（同C301待#5） | LCSC | TBD（同C301待#5） | TBD（同C301待#5） | TBD（同C301待#5） | 25V |  |  | 1
C301 | 4.7u | Capacitor_SMD:C_0805_2012Metric | YAGEO | TBD | LCSC |  |  |  | 25V |  |  | 1
C302 | 4.7u | Capacitor_SMD:C_0805_2012Metric | YAGEO | TBD | LCSC |  |  |  | 25V |  |  | 1
C303 | 4.7u | Capacitor_SMD:C_0805_2012Metric | YAGEO | TBD | LCSC |  |  |  | 16V |  |  | 1
C304 | 100n | MyFootprints:C_0603_1608Metric | YAGEO | CC0603KRX7R9BB104 | LCSC | C14663 |  | https://item.szlcsc.com/15331.html | 50V | 10% |  | 1
C305 | 47u 10% 10V | MyFootprints:KEMET_T491_B_3528_Pad1.80x2.23mm_Gap1.12mm | KEMET | T491B476K010AT | LCSC | C116617 |  | https://item.szlcsc.com/117871.html | 10V |  |  | 1
C306 | 100n | MyFootprints:C_0603_1608Metric | YAGEO | CC0603KRX7R9BB104 | LCSC | C14663 |  | https://item.szlcsc.com/15331.html | 50V | 10% |  | 1
C307 | 100n | MyFootprints:C_0603_1608Metric | YAGEO | CC0603KRX7R9BB104 | LCSC | C14663 |  | https://item.szlcsc.com/15331.html | 50V | 10% |  | 1
C308 | 100n | MyFootprints:C_0603_1608Metric | YAGEO | CC0603KRX7R9BB104 | LCSC | C14663 |  | https://item.szlcsc.com/15331.html | 50V | 10% |  | 1
D101 | SMF6.0A-TP | MyFootprints:MCC_SOD-123FL_Pad0.91x1.22mm_Gap2.36mm | MCC | SMF6.0A-TP | LCSC | C914434 |  | https://item.szlcsc.com/985114.html |  |  |  | 1
D102 | S1A-13-F | MyFootprints:Diodes_SMA_Pad2.50x1.70mm_P4.00mm | Diodes Incorporated | S1A-13-F | LCSC | C150735 |  | https://item.szlcsc.com/162075.html |  |  |  | 1
D103 | PMEG2010ER,115 | MyFootprints:Nexperia_CFP3_SOD123W_Reflow | Nexperia | PMEG2010ER,115 | LCSC | C82288 |  | https://item.szlcsc.com/83445.html |  |  |  | 1
D201 | PMEG2010ER,115 | MyFootprints:Nexperia_CFP3_SOD123W_Reflow | Nexperia | PMEG2010ER,115 | LCSC | C82288 | C82288 | https://item.szlcsc.com/83445.html |  |  |  | 1
D202 | SM712.TCT | Package_TO_SOT_SMD:SOT-23 | Semtech | SM712.TCT | LCSC | C12067 | C12067 | https://item.szlcsc.com/12644.html |  |  | DNP | 1
D203 | PESD2CAN,215 | Package_TO_SOT_SMD:SOT-23 | Nexperia | PESD2CAN,215 | LCSC | C75176 | C75176 | https://item.szlcsc.com/76300.html |  |  | DNP | 1
D204 | E6C1204YGAC1UDA | ControllerLocal:LED_Ekinglux_1204_SideView_3.2x1.0mm | ekinglux 亿晶源 | E6C1204YGAC1UDA | LCSC | C375534 | C375534 | https://item.szlcsc.com/347834.html |  |  |  | 1
D205 | E6C1204URAC1UDA | ControllerLocal:LED_Ekinglux_1204_SideView_3.2x1.0mm | ekinglux 亿晶源 | E6C1204URAC1UDA | LCSC | C375479 | C375479 | https://item.szlcsc.com/347829.html |  |  |  | 1
J101 | PZ254V-12-32P | MyFootprints:XFCN_PZ254V-12-32P_2x16_P2.54mm_Vertical_Drill1.02mm | XFCN | PZ254V-12-32P | LCSC | C22465940 |  | https://item.szlcsc.com/24163082.html |  |  |  | 1
J102 | PZ254V-12-32P | MyFootprints:XFCN_PZ254V-12-32P_2x16_P2.54mm_Vertical_Drill1.02mm | XFCN | PZ254V-12-32P | LCSC | C22465940 |  | https://item.szlcsc.com/24163082.html |  |  |  | 1
J201 | GH1.25 卧式 4P 待#5 | Connector_JST:JST_GH_SM04B-GHS-TB_1x04-1MP_P1.25mm_Horizontal |  | 待#5 |  |  | 待#5 |  |  |  |  | 1
J202 | GH1.25 卧式 3P 待#5 | Connector_JST:JST_GH_SM03B-GHS-TB_1x03-1MP_P1.25mm_Horizontal |  | 待#5 |  |  | 待#5 |  |  |  |  | 1
J203 | GH1.25 卧式 5P 待#5 | Connector_JST:JST_GH_SM05B-GHS-TB_1x05-1MP_P1.25mm_Horizontal |  | 待#5 |  |  | 待#5 |  |  |  |  | 1
J204 | GH1.25 卧式 6P 待#5 | Connector_JST:JST_GH_SM06B-GHS-TB_1x06-1MP_P1.25mm_Horizontal |  | 待#5 |  |  | 待#5 |  |  |  |  | 1
J205 | GH1.25 卧式 5P 待#5 | Connector_JST:JST_GH_SM05B-GHS-TB_1x05-1MP_P1.25mm_Horizontal |  | 待#5 |  |  | 待#5 |  |  |  |  | 1
JP201 | 485终端 默认断开 | Jumper:SolderJumper-2_P1.3mm_Open_Pad1.0x1.5mm |  | 待#5 |  |  | 待#5 |  |  |  |  | 1
JP202 | CAN终端 默认断开 | Jumper:SolderJumper-2_P1.3mm_Open_Pad1.0x1.5mm |  | 待#5 |  |  | 待#5 |  |  |  |  | 1
R92 | 0 | MyFootprints:R_0603_1608Metric | UNI-ROYAL | 0603WAF0000T5E | LCSC | C21189 | C21189 | https://item.szlcsc.com/21903.html |  | 1% |  | 1
R93 | 0 | MyFootprints:R_0603_1608Metric | UNI-ROYAL | 0603WAF0000T5E | LCSC | C21189 | C21189 | https://item.szlcsc.com/21903.html |  | 1% |  | 1
R122 | 10k | MyFootprints:R_0603_1608Metric | UNI-ROYAL | 0603WAF1002T5E | LCSC | C25804 | C25804 | https://item.szlcsc.com/26547.html |  | 1% |  | 1
R201 | 100 | Resistor_SMD:R_0603_1608Metric |  | 待#5 |  |  | 待#5 |  |  |  |  | 1
R202 | 100 | Resistor_SMD:R_0603_1608Metric |  | 待#5 |  |  | 待#5 |  |  |  |  | 1
R203 | 100 | Resistor_SMD:R_0603_1608Metric |  | 待#5 |  |  | 待#5 |  |  |  |  | 1
R204 | 100 | Resistor_SMD:R_0603_1608Metric |  | 待#5 |  |  | 待#5 |  |  |  |  | 1
R205 | 1k | Resistor_SMD:R_0603_1608Metric |  | 待#5 |  |  | 待#5 |  |  |  |  | 1
R206 | 1k | Resistor_SMD:R_0603_1608Metric |  | 待#5 |  |  | 待#5 |  |  |  |  | 1
R207 | 1k | Resistor_SMD:R_0603_1608Metric |  | 待#5 |  |  | 待#5 |  |  |  |  | 1
R208 | 1k | Resistor_SMD:R_0603_1608Metric |  | 待#5 |  |  | 待#5 |  |  |  |  | 1
R209 | 10k | Resistor_SMD:R_0603_1608Metric |  | 待#5 |  |  | 待#5 |  |  |  |  | 1
R210 | 10k | Resistor_SMD:R_0603_1608Metric |  | 待#5 |  |  | 待#5 |  |  |  |  | 1
R211 | 120 | Resistor_SMD:R_0805_2012Metric |  | 待#5 |  |  | 待#5 |  |  |  |  | 1
R212 | 120 | Resistor_SMD:R_0805_2012Metric |  | 待#5 |  |  | 待#5 |  |  |  |  | 1
R213 | 100 | Resistor_SMD:R_0603_1608Metric |  | 待#5 |  |  | 待#5 |  |  |  |  | 1
R214 | 100 | Resistor_SMD:R_0603_1608Metric |  | 待#5 |  |  | 待#5 |  |  |  |  | 1
R215 | 100 | Resistor_SMD:R_0603_1608Metric |  | 待#5 |  |  | 待#5 |  |  |  |  | 1
R216 | 100 | Resistor_SMD:R_0603_1608Metric |  | 待#5 |  |  | 待#5 |  |  |  |  | 1
R217 | 100 | Resistor_SMD:R_0603_1608Metric |  | 待#5 |  |  | 待#5 |  |  |  |  | 1
R218 | 100 | Resistor_SMD:R_0603_1608Metric |  | 待#5 |  |  | 待#5 |  |  |  |  | 1
R219 | 100 | Resistor_SMD:R_0603_1608Metric |  | 待#5 |  |  | 待#5 |  |  |  |  | 1
R220 | 10k | Resistor_SMD:R_0603_1608Metric |  | 待#5 |  |  | 待#5 |  |  |  |  | 1
R221 | 10k | Resistor_SMD:R_0603_1608Metric |  | 待#5 |  |  | 待#5 |  |  |  |  | 1
R222 | 10k | Resistor_SMD:R_0603_1608Metric |  | 待#5 |  |  | 待#5 |  |  |  |  | 1
R223 | 10k | Resistor_SMD:R_0603_1608Metric |  | 待#5 |  |  | 待#5 |  |  |  |  | 1
R224 | 10k | Resistor_SMD:R_0603_1608Metric |  | 待#5 |  |  | 待#5 |  |  |  |  | 1
R225 | 1k | Resistor_SMD:R_0603_1608Metric | UNI-ROYAL | 0603WAF1001T5E | LCSC | C21190 | C21190 | https://www.lcsc.com/product-detail/C21190.html |  | 1% |  | 1
R226 | 1k | Resistor_SMD:R_0603_1608Metric | UNI-ROYAL | 0603WAF1001T5E | LCSC | C21190 | C21190 | https://www.lcsc.com/product-detail/C21190.html |  | 1% |  | 1
R227 | 49.9k | MyFootprints:R_0603_1608Metric | UNI-ROYAL | 0603WAF4992T5E | LCSC | C23184 | C23184 | https://item.szlcsc.com/23911.html |  | 1% |  | 1
R228 | 680 | MyFootprints:R_0603_1608Metric | UNI-ROYAL | 0603WAF6800T5E | LCSC | C23228 | C23228 | https://item.szlcsc.com/23955.html |  | 1% | DNP | 1
R229 | 680 | MyFootprints:R_0603_1608Metric | UNI-ROYAL | 0603WAF6800T5E | LCSC | C23228 | C23228 | https://item.szlcsc.com/23955.html |  | 1% | DNP | 1
R301 | 0.47 | Resistor_SMD:R_0805_2012Metric | YAGEO | TBD | LCSC |  |  |  |  | 1% |  | 1
R302 | 3.83k 0.1% | MyFootprints:R_0603_1608Metric | YAGEO | RT0603BRD073K83L | LCSC | C861384 |  | https://item.szlcsc.com/921722.html |  | 0.1% |  | 1
R303 | 10k 0.1% | MyFootprints:R_0603_1608Metric | YAGEO | RT0603BRD0710KL | LCSC | C95204 |  | https://item.szlcsc.com/96405.html |  | 0.1% |  | 1
R304 | 1k | Resistor_SMD:R_0603_1608Metric | YAGEO | TBD | LCSC |  |  |  |  | 1% |  | 1
R305 | 1.1k | Resistor_SMD:R_0603_1608Metric | YAGEO | TBD | LCSC |  |  |  |  | 1% |  | 1
R306 | 10k | Resistor_SMD:R_0603_1608Metric | YAGEO | TBD | LCSC |  |  |  |  | 1% |  | 1
R402 | 10k | Resistor_SMD:R_0603_1608Metric | YAGEO | TBD |  |  |  |  |  | 1% |  | 1
SW2 | SKRTLAE010 | Button_Switch_SMD:SW_Push_1P1T-MP_NO_Horizontal_Alps_SKRTLAE010 | ALPS ALPINE | SKRTLAE010 | LCSC | C110293 | C110293 | https://item.szlcsc.com/111515.html |  |  |  | 1
TP15 | BOOT0 | TestPoint:TestPoint_Pad_D1.5mm |  | 待#5 |  |  | 待#5 |  |  |  |  | 1
TP16 | 3V3 | TestPoint:TestPoint_Pad_D1.5mm |  | 待#5 |  |  | 待#5 |  |  |  |  | 1
U30 | STM32G431RBT6 | MyFootprints:ST_LQFP-64_10x10mm_P0.5mm_Pad1.2x0.3mm | STMicroelectronics | STM32G431RBT6 | LCSC | C431633 |  | https://item.szlcsc.com/428111.html |  |  |  | 1
U101 | TLV76733DRVR | MyFootprints:WSON-6-1EP_2x2mm_P0.65mm_EP1x1.6mm | TI | TLV76733DRVR | LCSC | C2848334 |  | https://item.szlcsc.com/3046559.html |  |  |  | 1
U102 | TPS3808G33DBVR | MyFootprints:SOT-23-6 | TI | TPS3808G33DBVR | LCSC | C43698 |  | https://item.szlcsc.com/44691.html |  |  |  | 1
U103 | SN74LVC1G17DBVR | MyFootprints:TI_DBV0005A_Pad1.10x0.60mm_P2.60mm | Texas Instruments | SN74LVC1G17DBVR | LCSC | C7836 |  | https://item.szlcsc.com/8313.html |  |  |  | 1
U104 | TL431BIDBZR | MyFootprints:TI_DBZ0003A_Pad1.30x0.60mm_P2.10mm | Texas Instruments | TL431BIDBZR | LCSC | C41283 |  | https://item.szlcsc.com/42267.html |  |  |  | 1
U105 | SN74LVC1G08DBVR | MyFootprints:TI_DBV0005A_Pad1.10x0.60mm_P2.60mm | Texas Instruments | SN74LVC1G08DBVR | LCSC | C7666 |  | https://item.szlcsc.com/8143.html |  |  |  | 1
U201 | MAX3485ESA+T | Package_SO:SOIC-8_3.9x4.9mm_P1.27mm | Analog Devices / Maxim | MAX3485ESA+T | LCSC | C18148 | C18148 | https://item.szlcsc.com/18840.html |  |  |  | 1
U202 | SN65HVD232DR | Package_SO:SOIC-8_3.9x4.9mm_P1.27mm | TI | SN65HVD232DR | LCSC | C30530 | C30530 | https://item.szlcsc.com/31287.html |  |  |  | 1
U203 | TPS2553QDBVRQ1 | MyFootprints:SOT-23-6 | TI | TPS2553QDBVRQ1 | LCSC | C130055 | C130055 | https://item.szlcsc.com/141342.html |  |  |  | 1
Y1 | 8MHz / CL TBD / DNP | Crystal:Crystal_SMD_3225-4Pin_3.2x2.5mm |  | TBD | LCSC |  |  |  |  |  | DNP | 1
