leolei2012/power_system/inverter/hardware/Inverter_Compact_sources.csv

Footprint | References | Quantity | Definition_Type | Current_File | Current_SHA256 | Upstream_Footprint | Upstream_SHA256 | Manufacturer_Drawing | Changes_or_Match | Status | Geometry_License | License_URL | Checked_Date
Inverter_Compact:BSC110N15NS5_TDSON8_8PhysicalPins | Q1,Q2,Q3,Q4,Q5,Q6,Q7 | 7 | Project derivative | inverter/hardware/Inverter_Compact.pretty/BSC110N15NS5_TDSON8_8PhysicalPins.kicad_mod | ca8e042f6adb4f6d2bd3f7898f8f1bab5955408dab95411645c3db285ce588cf | Package_SON:Infineon_PG-TDSON-8_6.15x5.15mm | fabc6a7d5ea07491b84aff498233174c69251ac75087066ac8f21394b0a97edb | https://www.infineon.com/assets/row/public/documents/24/49/infineon-bsc110n15ns5-datasheet-en.pdf | Drain toes are physical5/6/7/8 at1.27 mm pitch; tab repeats5; source1/2/3,gate4. Upstream body/drain/paste reused; prototype land/mask/paste/thermal check pending. | project_draft; no prototype/thermal qualification | CC BY-SA 4.0 with KiCad design-use exception | https://www.kicad.org/libraries/license/ | 2026-11-06
Inverter_Compact:PinHeader_HCTL_PZ127_1x02_P1.27mm_D0.70mm | J7,J8 | 2 | Project derivative | inverter/hardware/Inverter_Compact.pretty/PinHeader_HCTL_PZ127_1x02_P1.27mm_D0.70mm.kicad_mod | f8ef0e972d8db2f2c4105e14c4b0088e0c438647329ce7149f1a2391ea5dc18d | Connector_PinHeader_1.27mm:PinHeader_1x02_P1.27mm_Vertical | 55136a1d6fde269a759611cb733fff2c30e1fb031aa4d1071c14c9a0aad27814 | https://atta.szlcsc.com/upload/public/pdf/source/20240407/11460212CBFB9238DF6EEC00AAE28C4B.pdf | Change finished PTH from0.65 to0.70 mm; preserve centers, pitch1.27 and numbered pad order. Body/cable/assembly tolerance pending. | project_draft; no prototype/thermal qualification | CC BY-SA 4.0 with KiCad design-use exception | https://www.kicad.org/libraries/license/ | 2026-11-06
Inverter_Compact:PinHeader_HCTL_PZ127_1x03_P1.27mm_D0.70mm | J14,J15 | 2 | Project derivative | inverter/hardware/Inverter_Compact.pretty/PinHeader_HCTL_PZ127_1x03_P1.27mm_D0.70mm.kicad_mod | 5a4b7391130114a8dfec96c468f7fc375ade7771a19c5de071021c24b7277f45 | Connector_PinHeader_1.27mm:PinHeader_1x03_P1.27mm_Vertical | cedf8cbd1feacfe6b70abdc77c97718bcaf71d02e311bfabc8672e1ccc9df0ea | https://atta.szlcsc.com/upload/public/pdf/source/20240407/11460212CBFB9238DF6EEC00AAE28C4B.pdf | Change finished PTH from0.65 to0.70 mm; preserve centers, pitch1.27 and numbered pad order. Body/cable/assembly tolerance pending. | project_draft; no prototype/thermal qualification | CC BY-SA 4.0 with KiCad design-use exception | https://www.kicad.org/libraries/license/ | 2026-11-06
Inverter_Compact:PinHeader_HCTL_PZ127_1x05_P1.27mm_D0.70mm | J9,J10,J13 | 3 | Project derivative | inverter/hardware/Inverter_Compact.pretty/PinHeader_HCTL_PZ127_1x05_P1.27mm_D0.70mm.kicad_mod | 3f7fea648415960d27b3ed4dcb40425d93ba981c991ced8e1ebfd239cbaf7f8f | Connector_PinHeader_1.27mm:PinHeader_1x05_P1.27mm_Vertical | 5015ab6da5175a90b0067a63f5c9fbb8ed099568b7649b88dcc6a4ace95ffa67 | https://atta.szlcsc.com/upload/public/pdf/source/20240407/11460212CBFB9238DF6EEC00AAE28C4B.pdf | Change finished PTH from0.65 to0.70 mm; preserve centers, pitch1.27 and numbered pad order. Body/cable/assembly tolerance pending. | project_draft; no prototype/thermal qualification | CC BY-SA 4.0 with KiCad design-use exception | https://www.kicad.org/libraries/license/ | 2026-11-06
Inverter_Compact:PinHeader_HCTL_PZ127_1x06_P1.27mm_D0.70mm | J11,J12 | 2 | Project derivative | inverter/hardware/Inverter_Compact.pretty/PinHeader_HCTL_PZ127_1x06_P1.27mm_D0.70mm.kicad_mod | b3062ba2a9bc299370ee182197deacbbe3c3e2c3146ef48ef70e4d1ba7eb320c | Connector_PinHeader_1.27mm:PinHeader_1x06_P1.27mm_Vertical | 87b36557c09d74237486ab20a9b499224461c0c9a572e112cdecc33a4293ee28 | https://atta.szlcsc.com/upload/public/pdf/source/20240407/11460212CBFB9238DF6EEC00AAE28C4B.pdf | Change finished PTH from0.65 to0.70 mm; preserve centers, pitch1.27 and numbered pad order. Body/cable/assembly tolerance pending. | project_draft; no prototype/thermal qualification | CC BY-SA 4.0 with KiCad design-use exception | https://www.kicad.org/libraries/license/ | 2026-11-06
Inverter_Compact:WireSolder_2P_P6.00mm_D2.00mm | J3,J5 | 2 | Project engineering definition | inverter/hardware/Inverter_Compact.pretty/WireSolder_2P_P6.00mm_D2.00mm.kicad_mod | 71557713328b4d969e423c6e5efb43fe71c00204e7d19d96fd2cd0455592766b |  |  | tools/compact_design.json; tools/compact_revision.py | Project engineering geometry: 2.0 mm finished holes,4.5 mm pads;2P pitch6 mm forJ3/J5;3P pitch15 mm forJ4; first pad rectangular. Wire, strain relief and current/thermal check pending. | project_draft; no prototype/thermal qualification | Project-authored engineering geometry; no external geometry copied |  | 2026-11-06
Inverter_Compact:WireSolder_3P_P15.00mm_D2.00mm | J4 | 1 | Project engineering definition | inverter/hardware/Inverter_Compact.pretty/WireSolder_3P_P15.00mm_D2.00mm.kicad_mod | 2763543383bdef890f459aa6946a95643efba5646dc3e851f1ac9ec726485e34 |  |  | tools/compact_design.json; tools/compact_revision.py | Project engineering geometry: 2.0 mm finished holes,4.5 mm pads;2P pitch6 mm forJ3/J5;3P pitch15 mm forJ4; first pad rectangular. Wire, strain relief and current/thermal check pending. | project_draft; no prototype/thermal qualification | Project-authored engineering geometry; no external geometry copied |  | 2026-11-06
Package_TO_SOT_SMD:TO-252-3_TabPin2 | D1 | 1 | KiCad official geometry reused | C:/Program Files/KiCad/10.0/share/kicad/footprints/Package_TO_SOT_SMD.pretty/TO-252-3_TabPin2.kicad_mod | e8e4222f48dd523401a2f6f19c4dc339279a078dd198242515d20cfbbfea39b0 | Package_TO_SOT_SMD:TO-252-3_TabPin2 | e8e4222f48dd523401a2f6f19c4dc339279a078dd198242515d20cfbbfea39b0 | https://www.diodes.com/datasheet/download/MBRD20150CT.pdf | Rev4-2 Sept2026 pin1/3 A andpin2/tab K checked. Standard DPAK geometry candidate; actual TO252 variant/land and thermal remain pending. | project_draft; no prototype/thermal qualification | CC BY-SA 4.0 with KiCad design-use exception | https://www.kicad.org/libraries/license/ | 2026-11-06
Fuse:Fuse_Littelfuse-NANO2-451_453 | F1,F2 | 2 | KiCad official geometry reused | C:/Program Files/KiCad/10.0/share/kicad/footprints/Fuse.pretty/Fuse_Littelfuse-NANO2-451_453.kicad_mod | 1e5c63293cf2fa83e70d53f8b488d8b5d4bbb596b20ceed26ef71cf468c40b14 | Fuse:Fuse_Littelfuse-NANO2-451_453 | 1e5c63293cf2fa83e70d53f8b488d8b5d4bbb596b20ceed26ef71cf468c40b14 | https://www.littelfuse.com/assetdocs/littelfuse-fuse-476-datasheet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 ; https://www.littelfuse.com/assetdocs/fuse-451-and-453-datasheet?assetguid=533cd5cc-956c-4243-867f-6ab5a62f6ba1 | 451/453 official geometry also fits476 recommended pads1.96x3.15, centers+/-2.455;476 outer land6.86 vs local6.87 mm rounding. Electrical ratings depend on exact F1/F2 MPN, not footprint name. | project_draft; no prototype/thermal qualification | CC BY-SA 4.0 with KiCad design-use exception | https://www.kicad.org/libraries/license/ | 2026-11-06
Inductor_SMD:L_Sunlord_MWSA0603S | L1,L2 | 2 | KiCad official geometry reused | C:/Program Files/KiCad/10.0/share/kicad/footprints/Inductor_SMD.pretty/L_Sunlord_MWSA0603S.kicad_mod | e9abc434e679ccecbf818e082ac05ddb942b9212677e2b4cba03024b93983b0b | Inductor_SMD:L_Sunlord_MWSA0603S | e9abc434e679ccecbf818e082ac05ddb942b9212677e2b4cba03024b93983b0b | https://www.sunlordinc.com/uploads/files/20230303/MWSA-S%C2%A0series%C2%A0of%C2%A0SMD%C2%A0Power%C2%A0Inductor.pdf | Official land2.35x3.50 mm,3.70 gap, centers+/-3.025. L1/L2 preserve nonpolar pin1/2; auxiliary only,30 V absolute max. | project_draft; no prototype/thermal qualification | CC BY-SA 4.0 with KiCad design-use exception | https://www.kicad.org/libraries/license/ | 2026-11-06
Button_Switch_SMD:SW_SPST_TS-1088-xR020 | SW1,SW2 | 2 | KiCad official geometry reused | C:/Program Files/KiCad/10.0/share/kicad/footprints/Button_Switch_SMD.pretty/SW_SPST_TS-1088-xR020.kicad_mod | add8704300b5fc07181e6a0feeb535dc7516376cbe0e66301f6db49741982496 | Button_Switch_SMD:SW_SPST_TS-1088-xR020 | add8704300b5fc07181e6a0feeb535dc7516376cbe0e66301f6db49741982496 | https://datasheet.lcsc.com/datasheet/pdf/0475ac02febf455ca9ddcfb380b0df0d.pdf?productCode=C720477 | Current one-page manufacturer drawing matches pads1.05x2.0, centers+/-2.225;2-terminal NO,1left2right. Older two-page land dimensions differ; use current drawing. | project_draft; no prototype/thermal qualification | CC BY-SA 4.0 with KiCad design-use exception | https://www.kicad.org/libraries/license/ | 2026-11-06
Connector_JST:JST_PH_B2B-PH-K_1x02_P2.00mm_Vertical | J2 | 1 | KiCad official geometry reused | C:/Program Files/KiCad/10.0/share/kicad/footprints/Connector_JST.pretty/JST_PH_B2B-PH-K_1x02_P2.00mm_Vertical.kicad_mod | d9ba86aaa376bf3218cc43ad10c0c4c59de8e812cbeabb3aeaa501082eb459cd | Connector_JST:JST_PH_B2B-PH-K_1x02_P2.00mm_Vertical | d9ba86aaa376bf3218cc43ad10c0c4c59de8e812cbeabb3aeaa501082eb459cd | https://www.jst-mfg.com/product/index.php?lang=2&series=199 | 2 mm pitch, official hole0.7+0.1/-0; local0.75 mm hole within range. Preserve pin1/2 and keyed mating orientation. | project_draft; no prototype/thermal qualification | CC BY-SA 4.0 with KiCad design-use exception | https://www.kicad.org/libraries/license/ | 2026-11-06
