leolei2012/power_system/inverter/hardware/review/shared_parts_2026-11-11/before_d1.png

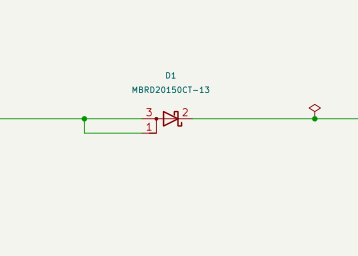
inverter/hardware/review/shared_parts_2026-11-11/before_d1.png
