leolei2012/power_system/inverter/hardware/review/shared_parts_2026-11-11/contact_01.png

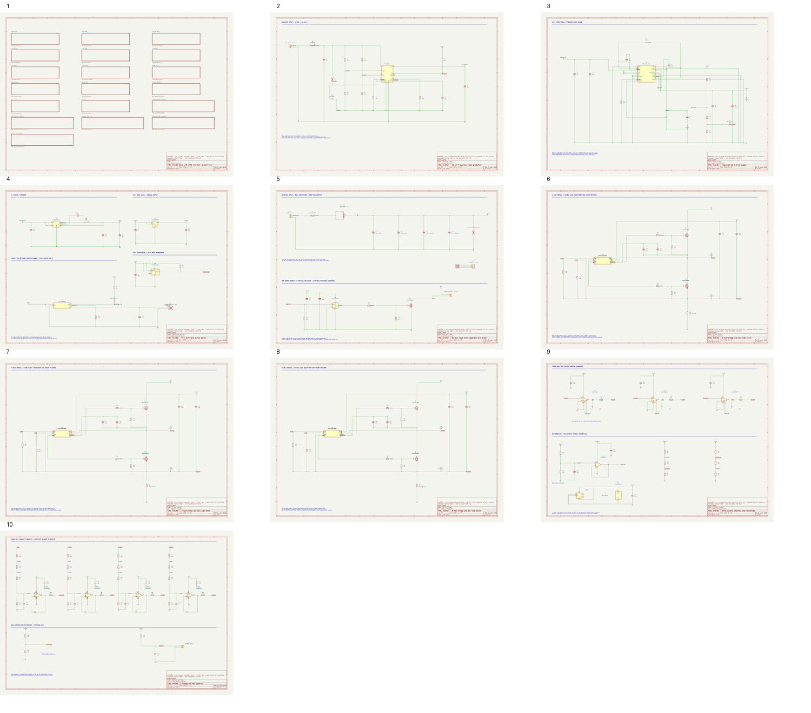
inverter/hardware/review/shared_parts_2026-11-11/contact_01.png
