leolei2012/power_system/docs/test_spec.md

# power_system Rev E 测试规范（草案）

- 对应 Issue：#6（编写测试规范）。阈值回核依赖：#3（inverter 原理图）、#7（`inverter/sim/params.py`），以及 #1（`docs/pinmap.md`）、#2（controller 原理图）、#4（布局）。
- 起草：探针，2026-11-12（Asia/Shanghai）。起草依据：`main` 分支提交 `487548d`，以及 Issue #3、#6、#7 的正文（当时三个 Issue 都还没有评论）。
- 修订：2026-11-12 增加 §6A 正式验收项 ACC-1（60 V、5 Arms、叠板、30 分钟），新增待定项 P-19 至 P-23。
- 状态：**只是规范，没有执行过任何测试**。文中没有“已通过”的结论。凡是写着「草案」的判据，要等雨田确认；凡是写着「待定」的项，见第 12 节《待定项清单》。
- 阈值的写法：每个阈值都注明来源（`文件:行号`，或者原理图位号/网络名）。如果仓库里几处说法互相对不上，就把几个值并列写出来，标「待定」，不替任何一方选。#3、#7 合并后要按新原理图和新 `params.py` 回核一遍，改一个版本号。

---

## 0. 背景与已定方向

### 0.1 群里与 Issue 已确定的方向

- 两块 60×60 mm 板，用 2.54 mm 排针叠装（Rev E 路线），**保持两组 2×16**；排针上没用的脚全部接 GND（Issue #3/#6/#7 正文）。端子版不做。
- controller 4 层，inverter 6 层，铜厚 2 oz（Issue 正文；与现有 PCB 的冲突见 P-09）。
- **验收电流 5 Arms**，母线 12–60 V，开关频率 20 kHz；不加风扇，不焊铜条（Issue 正文）。
- controller 自带通讯端子：CAN 一路（SN65HVD232）；485 一路（MAX3485ESA+T，C18148，**不隔离**），4 针端子，依次为 A、B、GND、5V，5V 加二极管或跳线防止倒灌底板 5 V（Issue #3 正文）。
- 功率板顶层补测试点：I_U、I_V、I_W、FAULT_N、ENABLE、GND、VBUS、+5V、+3V3（Issue #3 正文）。
- MCU 侧 ADC 输入加 RC（Issue 正文）。
- D1 改成理想二极管做防反接，型号由焊台在 #3 里选（Issue #3 正文）。
- NTC 放在 MOS 旁边，接 PB1（Issue #3 正文；与现有引脚表的冲突见 P-06）。

### 0.2 被测对象和网络名约定

下文使用现有原理图（`inverter/hardware/review/inverter.net.xml`）里的网络名和位号。#3 改图后如果位号变了，按新图替换，测试方法不变。

| 名称 | 含义 | 现有位置 |
| --- | --- | --- |
| VBUS | 母线正，经 D1 之后 | C19/C20 正端 |
| GND | 唯一的地网，即母线负（DC−）、分流冷端，也是所有通讯口和调试口的地 | J3 第 2 脚 |
| I_U / I_V / I_W | INA241A1 输出，1.65 V 偏置，50 mV/A | TP11/TP12/TP13（现在都在 B 面） |
| FAULT_N | 故障开集电极输出，经 R211 1 kΩ 到 PB12（TIM1_BKIN） | TP16（B 面） |
| FAULT_LATCH | 故障锁存 U28 输出 | TP14（F 面） |
| ENABLE_IN | 桥使能输入 | TP17（B 面） |
| x_PHASE / x_SOURCE | 相线、低管源极（分流热端） | TP5/7/9、TP6/8/10（F 面） |
| +12V_DRV | 驱动 12 V | TP1（B 面） |

> 叠装后，B 面的 TP1、TP4、TP11–TP13、TP16、TP17 都够不到（核对 `inverter/hardware/inverter.kicad_pcb` 里测试点所在的层）。本规范按 #3 要求，假设这些点都已经搬到功率板顶层。如果实物还没搬，凡是要用这些点的测试，必须改用增高排针或转接治具。不许在叠装状态下飞线去探底面的点。

---

## 1. 安全总则（所有测试都适用，优先于后面各节）

### 1.1 共地，不隔离

- 两块板只有一个 `GND` 网，它就是**母线负（DC−）**，也是低边分流冷端。SWD、485、CAN、编码器的地，全部是这个 GND。板上没有任何隔离器件（数字隔离器、光耦、隔离电源都没有）。依据：`inverter/hardware/review/inverter.net.xml` 的 GND 网；`README.md:5`、`README.md:18`。
- **485 的地就是功率地。** MAX3485 不隔离（Issue #3）。所以 **PC 端必须用隔离型 USB 转 485**，不许用普通的 USB-485。
- **SWD 调试也必须隔离**：ST-Link 与 PC 之间串 USB 隔离器（速率要匹配：V2 用全速隔离器就行，V3 要用支持高速的隔离器），或者直接用隔离版调试器。CAN 适配器也一样，要用隔离型，或者经 USB 隔离器连接。
- **上面这些隔离措施没到位之前，母线只许 ≤24 V，而且必须限流上电**（Issue #6）。
- 拿笔记本只靠电池供电、不接充电器，可以作为临时手段，但不能代替隔离器，也不能作为 >24 V 测试的条件。

### 1.2 示波器与探头

- 无源单端探头的地夹**只许夹在 GND 上**，例如 J3−、GND 测试点或分流冷端。**禁止**把地夹夹在 x_PHASE、x_SOURCE、高管栅极、HO/VS/自举等任何不是 GND 的节点上。一旦夹在相线上，高管导通时 60 V 会经“地夹 → 大地 → PC USB → 调试器 → 板 GND”短路。这条路径不经过分流电阻，硬件过流检测不到。
- 浮动节点（相电压、高管 Vgs、VS）只能用高压差分探头（共模 ≥100 V，带宽 ≥50 MHz）或光隔离探头测。
- 相电流用电流钳夹 J4 出线；母线电流用电流钳夹 J3 引线。
- **禁止**拔掉示波器的保护地，**禁止**用“断地插头”让示波器浮地。
- 一次只允许一个大地参考点。

### 1.3 电源与防护

- 母线用可编程直流电源，限流可调，最好有 OVP。辅助 12–24 V 用另一台独立的限流电源。
- 母线回路里串一个**急停**（能断母线正的急停开关或接触器），操作人员伸手就能按到。
- 母线 >24 V 的测试要加防护罩（透明挡板），并佩戴护目镜。
- 60 V 处在 SELV 60 V DC 的边界上。做过压测试时电源会升到 >65 V，超出 SELV，**这时不许碰任何裸露导体**。
- 板上**没有专门的母线放电回路**（`inverter/docs/spec.md:37`）。下电后要用万用表确认 VBUS <5 V，才可以动手。必要时用外接放电电阻（例如 100 Ω/10 W）放电。
- **不许带电插拔**两块板、端子和调试线（`inverter/hardware/design_review.md:28`）。
- 下电顺序：停 PWM → 断母线 → 等 VBUS <5 V → 断辅助电源 → 断 5 V。

### 1.4 通用中止条件

出现以下任何一条就立刻按急停，并在记录里写明：

- 冒烟、有焦味，或者出现异响。
- 任何温度测点 ≥110 °C。
- 母线电流超出预期值的 1.5 倍，或者限流电源进入恒流状态而预期不应进入。
- FAULT_N 意外拉低。
- 调试链路或 485 通讯断开。

---

## 2. 测试设备清单

| 编号 | 设备 | 最低要求 | 用于 |
| --- | --- | --- | --- |
| E1 | 可编程直流电源（母线） | 0–70 V，≥10 A，限流可调，有 OVP，输出浮地 | §4–§10 |
| E2 | 直流电源（辅助） | 12–24 V，≥1 A，限流可调 | §4 起 |
| E3 | 直流电源（5 V） | 4.75–5.25 V 可调，限流可调 | §4.1 |
| E4 | 隔离型 USB 转 485 | 隔离型 | 通讯 |
| E5 | USB 隔离器或隔离版调试器 | 速率与调试器匹配 | SWD |
| E6 | 隔离 CAN 适配器 | 隔离型，或经 E5 连接 | CAN |
| E7 | 示波器 | ≥4 通道，≥100 MHz | §6–§10 |
| E8 | 高压差分探头 ×2 | 共模 ≥100 V，≥50 MHz | §7、§9、§10 |
| E9 | 电流钳 ×2 | DC–≥1 MHz，≥30 A 峰值 | §6–§10 |
| E10 | K 型热电偶 + 多路记录仪 | ≥12 路，1 s 采样 | §6 |
| E11 | 热像仪 | 发射率可设置 | §6 |
| E12 | 三相负载 | RL 负载（Y 接），或电机加测功机 | §6 |
| E13 | 功率电感 | 例如 100 µH，饱和电流 ≥30 A | §8 |
| E14 | 万用表、LCR 表、游标卡尺、塞尺 | — | §3、§4 |
| E15 | 急停与防护罩 | 能断母线正 | 全程 |
| E16 | 短路治具 | 低感短路线或 MOSFET 受控短路开关，可单次触发 | §9 |
| E17 | 环境温度计 | ±0.5 °C | §6 |

---

## 3. 机械与装配检查（不上电）

### 3.1 排针插合与叠高

- **目的**：确认 2×16 公针与母座插到底、接触可靠；叠装总高与支柱高度一致。
- **前置条件**：两块板都已焊好；支柱、螺钉型号已定（见 P-12）。
- **设备**：E14；公针、母座的规格书（`PZ254V-12-32P/C22465940`、`PM254V-12-32-H85/C46595991`，`docs/schematic_update_2026-11-11.md:14-15`）。
- **步骤**：
  1. 按规格书记下：公针插合长度、母座的有效接触深度、母座塑高（8.5 mm）、公针塑高（2.5 mm）。
  2. 按“板厚 + 塑高 + 插合量”算出理论板距，与支柱高度对比。
  3. 实际装配，用游标卡尺量四角的板间距。
  4. 逐号核对 pin1 方向和同心度（`docs/pcb_review_2026-11-11.md:25`：按同号焊盘同心判断，不按俯视图判断）。
  5. 用万用表逐针检查导通：64 针都从 controller 侧量到 inverter 侧。
- **记录项**：理论板距；四角实测板距；插合深度；每针导通电阻；pin1 方向。
- **判据**：
  - 四角板距差 ≤0.2 mm（草案）。
  - 实测插合深度不小于规格书要求的最小有效插合量。
  - 64 针全部导通，单针电阻 ≤50 mΩ（草案）。
  - pin1 正确。
- **阈值来源**：插合量以规格书为准；板距和支柱高度没定（`docs/pcb_review_2026-11-11.md:29`），见 P-12。

### 3.2 板间器件间隙

- **目的**：确认两板之间最高的器件不会顶到对面板；RESET/BOOT 按键还能按到。
- **前置条件**：同 §3.1。
- **步骤**：
  1. 从 3D 模型或规格书里查出两板相向面上最高的器件。
  2. 实际装配后用塞尺测间隙。
  3. 试按 SW2/SW3（`docs/pcb_review_2026-11-11.md:57`）。
- **记录项**：最高器件位号与高度；实测间隙；按键是否能操作。
- **判据**：间隙 ≥1.0 mm（草案）；按键能正常按下和回弹。
- **阈值来源**：仓库里没有定义（P-12）。

### 3.3 上电前电阻检查

- **目的**：在上电前排除电源轨短路和桥臂短路。
- **前置条件**：两块板分开放，再叠装，各量一遍；所有外部电源都断开；母线电容已放电。
- **设备**：E14。
- **步骤**：先用黑表笔接 GND 量下列各项，再反接表笔量一遍。
  - J3+ 对 GND、VBUS 对 GND。
  - U/V/W_PHASE 分别对 GND 和对 VBUS。
  - +12V_DRV、+5V、+3V3（两侧 3.3 V 分开量：controller 和 inverter 两侧的 3.3 V 不并联，`README.md:18`）、+5V_SENSOR，分别对 GND。
  - 485 端子的 A、B、5V 对 GND；CAN H、L 对 GND。
  - 用二极管档量 VBUS 到 J3+ 的方向（理想二极管装好后，这一步的表现要按 #3 选定的型号确认）。
- **记录项**：每一项的电阻值（两个极性都记）。
- **判据（草案）**：
  - 没有 <10 Ω 的项。电解电容充电时读数会逐渐上升，属于正常。
  - 首块板的读数作为基准；之后每块板与基准的差异 >20% 要复查。
  - 相线对 GND、相线对 VBUS 不许呈现低阻。

---

## 4. 分级上电

> 顺序是固定的，前一步没通过不进入下一步（Issue #6）。

### 4.1 第一步：只送 5 V，单测 controller

- **目的**：在不接功率板的情况下，验证 controller 的最小系统、LED、SWD、CAN、485 和编码器接口。
- **前置条件**：§3.3 通过；controller 单独放置；E5 隔离已接好。
- **设备**：E3、E4、E5、E6、E14。
- **步骤**：
  1. E3 设为 5.00 V，限流 0.2 A，从 controller 的 5 V 输入送电（Rev E 现在是 J101/1、3，`README.md:14`；以 #2 最终的电源入口为准）。
  2. 测 +3V3（controller 的 LDO 输出）、VDDA。
  3. 经隔离 SWD 连接，读 IDCODE，下载测试固件。
  4. LED 测试：PC5 RUN 绿灯、PC8 FAULT 红灯，分别点亮和熄灭（Issue #3）。
  5. 485 测试：PC 端经 E4 收发，测试速率由烧录定。用示波器测 DE 脚的切换（DE 选的哪只脚以 #1 的 pinmap 为准，候选为 PB3、PB4、PB9）。
  6. **485 端子 5V 防倒灌测试**：controller 不上电，从 485 端子的第 4 针灌 5 V（限流 0.1 A），测 controller 的 5 V 网络和排针 5 V 针上有没有电压。反过来，controller 上电后，测 485 端子第 4 针的电压，确认符合 #2 设计的二极管或跳线方案。
  7. CAN 测试：经 E6 与 PC 收发，测 CANH、CANL 的波形。
  8. 编码器口测试：ABZ（PA0、PA1、PA2）用信号源或手转编码器，读计数；SPI 口用实际传感器或回环读数（SPI 的引脚以 #1/#2 为准）。
  9. 测 5 V 输入电流（静态和满载）。
- **记录项**：+3V3、VDDA 电压；5 V 输入电流；IDCODE；各接口的收发结果和波形截图；倒灌测试的电压。
- **判据**：
  - +3V3 在 3.3 V ±3% 以内（草案，以 #2 选定 LDO 的规格书为准）。
  - SWD 能连上并下载。
  - LED 按命令点亮和熄灭。
  - 485、CAN 各收发 1000 帧，无误码（草案）。
  - ABZ 计数与输入脉冲数一致。
  - 倒灌：controller 不上电时，从 485 端子灌入的 5 V 在 controller 5 V 网络上应 ≤0.3 V（草案）。具体看 #2 选的是二极管还是跳线；如果是跳线，按跳线断开和闭合两种状态各测一次。
  - controller 静态电流不超过 #2 给出的预算（`README.md:18` 写的 3.3 V 总预算是 100 mA）。
- **阈值来源**：Issue #3 正文；`README.md:14`、`README.md:18`。

### 4.2 第二步：叠装，只上辅助电源

- **目的**：确认驱动和逻辑电源正常；确认桥在上电后默认关断。
- **前置条件**：§4.1 通过；两板已叠装；母线不接（J3 开路）。
- **设备**：E2、E5、E7、E14。
- **步骤**：
  1. E2 设为 12 V，限流 0.3–0.5 A，接辅助输入。
  2. 测 +12V_DRV、BB_VREG（TP2）、+5V、+3V3（两侧都测）。
  3. 测六路栅极电压（低管栅极对 GND 可以用单端探头；高管栅极此时没有母线，也按浮动节点处理，用差分探头）、ENABLE_IN、FAULT_N、CTRL_READY。
  4. 复位 MCU、按 BOOT、停在 ROM 状态，分别确认 CTRL_READY 保持为低、桥不被许可（`README.md:16`）。
  5. 辅助电源从 12 V 升到 24 V，再重复测一次步骤 2。
- **记录项**：各电源轨电压；辅助电源电流；栅极状态；CTRL_READY、ENABLE_IN、FAULT_N 的电平。
- **判据**：
  - 各电源轨在额定值 ±5% 以内（草案）。
  - 复位、ROM 和程序未 ARM 时，六路栅极都为低，CTRL_READY 为低。
  - +12V_DRV 高于驱动欠压门限（推导值约 11.2 V，见 §7.3）。
- **阈值来源**：`README.md:16`；`R71`/`R72`/`R68`/`R69` 推导。

### 4.3 第三步：母线 ≤24 V 限流上电，不接负载

- **目的**：首次上母线，检查自举建立、PWM、死区和静态电流。
- **前置条件**：§4.2 通过。**如果 E4/E5 的隔离没到位，本步以及后续所有测试都只许 ≤24 V**（Issue #6）。
- **设备**：E1、E7、E8、E9、E15。
- **步骤**：
  1. E1 设为 12 V，限流 0.5 A，接 J3；不开 PWM，记下母线静态电流。
  2. 开 PWM：20 kHz、50% 占空比，三相同相位，不接负载。测各相相电压（用差分探头）、低管 Vgs，以及死区时间。
  3. 母线逐级升到 24 V，每一级都重复步骤 1、2，限流设为 0.5–1 A。
  4. 确认隔离到位后，再逐级升到 48 V、60 V，每一级都先限流。
- **记录项**：各级母线电压下的静态电流和 PWM 空载电流；相电压波形；死区时间；Vgs 的幅值和振铃。
- **判据**：
  - 死区时间与固件设置值一致（`inverter/docs/spec.md:27` 写的是旧仿真的候选值 1 µs，最终值以烧录的配置为准）。
  - 相电压波形没有直通的迹象（母线电流在开关沿上没有异常尖峰）。
  - 空载电流在各电压级之间单调变化，没有突变（草案）。
- **阈值来源**：`inverter/docs/spec.md:26-27`。

---

## 5. 母线范围测试（12–60 V）

- **目的**：在 12/24/48/60 V 四个点上验证整机能正常工作。
- **前置条件**：§4.3 通过；隔离已到位；§7（保护）已经在 ≤24 V 下完成过一次。**60 V 运行之前，必须先完成 §7.1 过压和 §7.2 过流的锁存测试。**
- **设备**：E1、E2、E4、E5、E7–E9、E12、E15。
- **步骤**：在每个电压点上：
  1. 用 1 Arms 开环 SVPWM，输出 50 Hz，运行 5 分钟。
  2. 读 MCU 测到的 V_DC，与万用表测的值对比。
  3. 记下电流 ADC 的偏置。
- **记录项**：母线电压（实测值与 ADC 值）；输入电流；相电流（电流钳）；各相电流 ADC 的偏置。
- **判据**：
  - V_DC 的 ADC 读数误差 ≤±2%（草案；分压比 50:1，电阻精度 0.1%，见 §7.1）。
  - 运行中没有 FAULT。
- **阈值来源**：Issue #6（12–60 V）；`inverter/docs/spec.md:13`。

---

## 6. 5 Arms 连续温升测试（不加风扇）

- **目的**：在 5 Arms、20 kHz、不加风扇、不焊铜条的条件下，验证两块板叠装后都能达到热稳定，并且不超出温度判据。
- **前置条件**：
  - §5 通过。
  - 环境温度 25 ±3 °C，静止空气（门窗关闭，测试区附近没有风扇）。
  - 两块板按最终支柱高度叠装，水平放置，离台面 ≥50 mm。
  - 被测热像区域喷哑光黑漆或贴 Kapton 胶带，发射率按 0.95 设置。
  - 铜厚、D1 型号已定（P-09、P-10）。
- **设备**：E1、E2、E7、E9、E10、E11、E12、E17。
- **测点**（热电偶用高温胶或导热胶粘贴；叠装后够不到的点要在叠装前贴好）：

| 编号 | 测点 | 说明 |
| --- | --- | --- |
| T1–T6 | Q1–Q6 漏极焊盘旁，优先低管 Q2/Q4/Q6 | 用来推算 MOS 结温 |
| T7 | D1（理想二极管的 MOSFET）外壳或焊盘 | 型号以 #3 为准 |
| T8 | 母线输入走线：J3+ 到 F1 段的中部 | 原 2 mm 走线已知太窄（Issue #3） |
| T9 | F1 本体 | — |
| T10 | U 相换层过孔群上方 | 换层过孔原本不够（Issue #3；`inverter/hardware/PCB_REVIEW.md:23`） |
| T11 | V 相换层过孔群上方 | 同上 |
| T12–T14 | 分流电阻 RS1–RS3 | — |
| T15 | 电解电容 C19/C20 外壳 | — |
| T16 | 驱动芯片 U7–U9 中温度最高的一颗 | 先用热像找出最热的那颗 |
| T17 | controller 板 ADC 输入 RC 附近或 MCU 外壳 | 叠装后在两板之间 |
| T18 | 排针、母座区 | — |
| T19 | J3、J4 焊点 | — |
| T20 | 环境温度 | 离板 ≥200 mm |

- **工况**：三相 RL 负载（Y 接），开环 SVPWM，输出 50 Hz，开关频率 20 kHz。负载阻抗按母线电压选：12 V 时线电压最大约 8.5 Vrms（`inverter/docs/spec.md:29`），要达到 5 Arms，每相阻抗要 ≤约 0.98 Ω。
- **步骤**：
  1. 母线 48 V，相电流按 1、2、3、4、5 Arms 逐级升高。每一级都运行到热稳定，才进入下一级。热稳定的定义是：所有测点在 10 分钟内变化 <1 °C，并且这一级至少运行 30 分钟。
  2. 在 5 Arms 下，再分别在 12 V、24 V、60 V 母线上各跑一次，到热稳定为止。
  3. 每一级稳定后拍热像：上板顶面全景，加上能看到的侧面。
  4. 每一级稳定后，读 NTC 的 ADC 值，与 T1–T6 中离 NTC 最近的那个点对比。
  5. **记录项：10 Arms 短时运行（只作记录，不作验收）**：在 24 V 母线下，从 5 Arms 的热稳定状态开始，升到 10 Arms 运行，直到任何测点到达判据上限，或者运行满 60 s 为止。记下时间和温度曲线。60 V 下的 10 Arms 不做，等雨田确认后再说（P-01）。
- **记录项**：每一级的母线电压、输入电流、输入功率；三相电流的有效值（电流钳）；T1–T20 的温度曲线（1 s 采样）；热像图；NTC 读数；到达稳定所用的时间。
- **判据（全部为草案，见 P-11）**：

| 项 | 判据 | 依据 |
| --- | --- | --- |
| MOS 推算结温 Tj = T_case + P × RthJC | ≤125 °C，即距离 Tj,max 150 °C 留 ≥25 °C 余量 | BSC110N15NS5 规格书：Tj,max 150 °C，RthJC ≤1 K/W；P 按 RDS(on)（热态）× I² 加开关损耗估算 |
| 走线和过孔温升（T8、T10、T11 对环境） | ≤30 K | 探针草案 |
| FR-4 表面最高温度（热像） | ≤105 °C | 探针草案（距离 FR-4 Tg 留有余量；板材 Tg 待定） |
| D1（理想二极管 MOSFET） | 按 #3 选定型号的规格书留 ≥25 °C 余量 | P-10 |
| 电解电容 C19/C20 | ≤85 °C | 探针草案 |
| 排针和母座 | ≤85 °C | 探针草案（以规格书的工作温度为准） |
| controller MCU、ADC 附近（T17） | ≤80 °C | 与 §6A 的 A6 统一（STM32G431RBT6：TJ,max 105 °C，TA,max 85 °C，DS12589 表 17） |
| 外观 | 热稳定后，焊点不变色，板材不起泡 | — |

- **阈值来源**：Issue #6 只给出条件（5 Arms、12–60 V、20 kHz、不加风扇、不焊铜条），没有给出温度判据。#3、#7 正文里也没有温度判据，所以以上判据都标为「待定」（P-11）。

---

## 6A. 正式验收项 ACC-1：60 V、5 Arms、20 kHz 叠板连续运行 30 分钟温升

> 来源：领班 2026-11-12 补充的要求。背景：焊台按 5 Arms 无风扇估算整板损耗约 2.6–4 W；叠板间隙小时，板温悲观估算可能超过 110 °C；MCU 在热源正下方。这组数字来自焊台在群里的估算，仓库里还没有对应文档（P-23）。§6 是摸底和分级测试，本节是**正式验收项**。判据以本节为准。

- **目的**：在最严酷的验收工况下（母线上限 60 V、验收电流 5 Arms、20 kHz、两板叠插、不加风扇、不焊铜条），连续运行 30 分钟，确认 MOS、功率板板面和控制板 MCU 的温度都在器件上限以内，并留有余量。
- **前置条件**：
  1. §4（分级上电，包括 §4.3 升到 60 V 的空载）全部完成。
  2. §6 中 **24 V、5 Arms 的温升已经跑到热稳定**，并且没有超出本节判据。
  3. §7.1（过压）、§7.2（过流与 BKIN）已经在 60 V 下完成。
  4. 隔离措施全部到位（§1.1）。
  5. 两板按装配状态叠插：最终的支柱和螺钉，最终的板距（P-12），水平放置，离台面 ≥50 mm。
  6. 不加风扇，环境为静止空气，温度 25 ±3 °C。
  7. 叠插之前，先把两板之间的热电偶贴好，引线从板边引出，不能改变板距。
- **设备**：E1、E2、E4、E5、E9（电流钳夹三相出线和 J3）、E10（K 型热电偶，至少 8 路，记录间隔 ≤1 s）、E11（热像仪，只能看到上板顶面和侧面）、E12（三相 RL 负载，在 60 V 下按 5 Arms 选阻抗）、E15、E17。
- **测点**：

| 编号 | 位置 | 方法 |
| --- | --- | --- |
| A1 | 发热最高的那颗 MOS 的漏极焊盘或外露铜皮。用 §6 的热像先找出是哪颗，优先看低管 Q2/Q4/Q6 | 热电偶。BSC110N15NS5 的“case”是底部漏极焊盘，所以热电偶贴在焊盘紧邻的外露铜上 |
| A2 | 第二热的 MOS，位置要求同 A1 | 热电偶 |
| A3 | MOS 塑封顶面 | 热像。只作参考：datasheet 没给结到顶面的热阻（P-19） |
| A4 | 功率板顶面热点。用 §6 的热像定位，预计在输入走线、换层过孔或 MOS 附近 | 热电偶，并用热像复核 |
| A5 | 功率板底面热点（即朝向控制板的那一面），位置在 MOS 正下方 | 热电偶，叠插前贴好 |
| A6 | 控制板 MCU（U30）封装顶面中心 | 热电偶，叠插前贴好 |
| A7 | 控制板上 MCU 正下方或紧邻 MCU 的板面 | 热电偶 |
| A8 | 两板间隙内的空气，位置在 MCU 上方，悬空不碰任何器件 | 热电偶。用来近似 MCU 的局部环境温度 TA |
| A9 | 环境温度，离板 ≥200 mm，与板同一高度 | 热电偶或 E17 |

- **步骤**：
  1. 所有测点先在不通电的状态下记录 5 分钟，确认读数稳定，并记下初始温度。
  2. 母线 60 V，开环 SVPWM 输出 50 Hz，20 kHz。相电流在 2 分钟内升到 5 Arms（用电流钳读数确认）。计时从相电流到达 5 Arms 时开始。
  3. 连续运行 30 分钟。**每分钟记录一次**所有测点（A1–A9），同时记录母线电压、母线电流、三相电流的有效值，以及 NTC 的 ADC 读数。每 5 分钟拍一次热像。
  4. 30 分钟到了，或者触发了终止条件，就停止 PWM，然后按 §1.3 的顺序下电。停机后继续记录 5 分钟的降温曲线。
  5. **30 分钟内没有达到热稳定时**（热稳定的定义同 §6：10 分钟内变化 <1 °C），照样记录完整的趋势：最后 5 分钟每个测点的升温速率（°C/min），并注明“未稳定”。是否需要延长运行时间，见 P-22。
- **终止条件**（任意一条满足就立即停机，即停 PWM 并按急停，并记录触发时刻和当时的读数）：
  - 任何一个测点达到下面判据表里该点的上限。
  - §1.4 里的任何一条。
  - 任何一个测点的升温速率 >5 °C/min，并且已经超过 90 °C（草案）。
- **判据**（30 分钟内，所有测点都不超过上限，就判为通过；超过上限的，判为不通过，并记录在哪一分钟超限）：

| 测点 | 器件上限（来源） | 提出的上限 | 推导与说明 |
| --- | --- | --- | --- |
| A1、A2：MOS 漏极焊盘 | BSC110N15NS5：Tj,max = 150 °C；RthJC 最大值 1 K/W（junction–case，case 即底部漏极焊盘）。见 [Infineon BSC110N15NS5 datasheet Rev 2.6](https://www.infineon.com/assets/row/public/documents/24/49/infineon-bsc110n15ns5-datasheet-en.pdf) 第 1 节（最大额定值）和表 3（热特性）。料号见 `inverter/hardware/bom/bom.csv`：Q1–Q7 为 BSC110N15NS5ATMA1，立创编号 C412739 | **≤105 °C**（受板面上限约束，见右栏）。MOS 自身的换算上限是 **≤124 °C（待定 P-19）** | 结温要留 ≥25 °C 余量，即 Tj ≤125 °C。焊盘上限按 T_pad ≤ 125 °C − P_MOS × RthJC,max 计算。P_MOS 取 Issue #3 的估算，每颗约 0.5 W，得到 T_pad ≤124.5 °C，向下取整为 124 °C。P_MOS 里的热态 RDS(on) 系数和开关损耗都没核算过，**所以这个值待定（P-19）**。另外，焊盘直接焊在 FR-4 上，焊盘温度实际上受板面 105 °C 的上限约束，所以 A1、A2 按 105 °C 执行 |
| A3：MOS 顶面（热像） | datasheet 里没有结到顶面的热阻 | 只作记录 | 顶面温度不能直接换算成结温，P-19 |
| A4、A5：功率板板面 | FR-4 板材和 Tg 都没定（P-21）。没有可以引用的器件上限 | **≤105 °C（草案）** | 沿用 §6 的草案。焊台的悲观估算是“可能 >110 °C”，比这个上限还高。**如果悲观估算成立，本项会在 30 分钟内触发终止，判为不通过**，需要雨田决定是加大板距、加散热，还是放宽判据（P-23）。板材 Tg 定了以后，按 Tg − 25 °C 和 105 °C 中较低的一个执行（草案） |
| A6：MCU 封装顶面 | STM32G431RBT6（温度后缀 6）：TJ = −40～105 °C；最大功耗下 TA = −40～85 °C。LQFP64 的 ΘJC = 10.1 °C/W，ΘJA = 50.8 °C/W。见 [ST DS12589 Rev 6](https://www.st.com/resource/en/datasheet/stm32g431rb.pdf) 表 17（General operating conditions，第 71 页）和表 100（Package thermal characteristics，第 190 页）。仓库里也有一份：`reference/ST_G431_dual_pwm/original/DS12589_STM32G431_Rev6.pdf` | **≤80 °C** | Tj ≈ T_top + P_MCU × ΘJC。P_MCU 没核算过（P-20）。即使按 0.2 W 算，也只多 2 °C，所以顶面 80 °C 对应 Tj 约 82 °C，距离 105 °C 留了 ≥20 °C 余量。这个上限同时保证局部温度不超过 TA 的 85 °C。§6 原来的草案是 70 °C，现在统一为 80 °C |
| A7：MCU 正下方板面 | 同 A6 | **≤80 °C** | MCU 通过引脚和板子导热，板面温度就是 MCU 的边界温度 |
| A8：两板间隙空气（近似 TA） | 同 A6，TA,max = 85 °C | **≤80 °C** | 距离 TA 上限留 5 °C 余量。用一个热电偶近似 TA 的方法本身还待定（P-20） |
| A9：环境温度 | — | 25 ±3 °C | 超出范围的话，这次测试无效 |

- **记录项**：上述所有测点的每分钟读数（用 §13.4 的表）；母线电压和电流、输入功率；三相电流的有效值；NTC 读数；每 5 分钟一张热像图；是否达到热稳定，以及最后 5 分钟的升温速率；是否触发终止，触发时刻和读数；降温曲线；外观检查（焊点是否变色、板材是否起泡）。
- **阈值来源**：见判据表。器件上限都来自厂家 datasheet；余量（25 °C、20 °C、5 °C）以及板面的 105 °C 是探针提出的草案，需要雨田确认。

## 7. 保护阈值测试

> 阈值推导所依据的网络和位号，都来自 `inverter/hardware/review/inverter.net.xml`（`main` 分支 `487548d`）。#3 改图后要重新推导一遍。

### 7.0 阈值对照表

| 保护项 | 原理图推导（现有图） | spec.md | params.py | 状态 |
| --- | --- | --- | --- | --- |
| 母线硬件过压 | VBUS 经 R48 240k + R49 240k + R50 10k，再对 R51 10k 分压，即 50:1；再经 U14 缓冲成 V_DC。比较器 U21A：反相端接 V_DC，同相端接 OV_REF_1V30（R68 20k / R69 13k 从 +3V3_INV 分压，得 1.300 V）。**名义门限 65.0 V**（`inverter/hardware/voltage_sense.kicad_sch:158` 有注释） | 65 V（`inverter/docs/spec.md:18`、`:56`） | `V_DC_OV = 130.0`（`inverter/sim/params.py:12`） | 原理图与 spec 一致；params.py 不一致，**待定 P-03** |
| 母线欠压 | 没有硬件比较器 | 由软件处理，门限未定（`inverter/docs/spec.md:62`） | `V_DC_UV = 75.0`（`inverter/sim/params.py:11`），高于 60 V 的工作上限，不可用 | **待定 P-04** |
| 相电流硬件过流 | INA241A1 50 mV/A，偏置 1.65 V。OC_HIGH_REF：R45 10k 接 +3V3、R46 1.8k + R47 39k 接 GND，得 2.650 V，对应 +20.0 A。OC_LOW_REF：R42 39k + R43 1.8k 接 +3V3、R44 10k 接 GND，得 0.650 V，对应 −20.0 A。比较器 U18–U20 | 瞬时 ±20 A（`inverter/docs/spec.md:17`、`:59`） | 没有定义 | 原理图与 spec 一致；验收电流改为 5 Arms 后，±20 A 是否保留，**待定 P-05** |
| 驱动 12 V 欠压 | +12V_DRV 经 R71 76.1k / R72 10k 分压，与 1.30 V 比较（U21B），**名义门限约 11.19 V**；没有外部迟滞网络 | 没有数值 | 没有定义 | 推导值，文档里没有对照，**待定 P-07** |
| 过温 | 没有硬件比较器；NTC 经 R70 10k 上拉到 +3V3_INV，由软件判断 | 没有数值 | 没有定义 | **待定 P-06** |
| 制动开启/关闭 | 软件控制（TIM8） | 60 V 工况下 62 V 开启、61 V 关闭（`inverter/docs/spec.md:20-21`、`:57`） | 没有定义 | 其他母线电压下的门限未定，**待定 P-08** |
| BKIN 总关断时间 | — | 未定（`inverter/docs/spec.md:55`） | — | 草案 ≤2 µs，**待定 P-05** |

推导时取 +3V3_INV = 3.300 V。R42–R51、R68–R72 在原理图里标的精度是 0.1%；+3V3_INV 本身的误差没有计入。

### 7.1 母线过压（硬件，65 V）

- **目的**：测实际触发点、锁存行为，以及关断六路驱动的延迟。
- **前置条件**：§4.3 通过；PWM 空载运行，不接负载；E1 的 OVP 设为 70 V，用来保护被测板。**本测试的母线电压会超过 60 V，必须遵守 §1.3**。
- **设备**：E1、E7、E8、E14。
- **步骤**：
  1. 母线 60 V，PWM 20 kHz、50% 运行。
  2. 以 ≤0.1 V/s 的速度缓慢升压，同时用示波器记录 V_DC（U14 输出）、BUS_OV_OK（U21 第 1 脚）、FAULT_LATCH（TP14）、FAULT_N（TP16）和一路低管 Vgs。
  3. 记下 FAULT_N 拉低时母线的实测电压（用万用表）。
  4. 把母线降回 60 V，确认**不会自动恢复**；然后按 §7.5 恢复。
  5. 重复 3 次。
- **记录项**：3 次的触发电压；从 BUS_OV_OK 翻转到 Vgs 降为低的时间；锁存状态。
- **判据**：
  - 触发电压在 65 V ±2% 以内（草案：分压用 0.1% 电阻，主要误差来自 +3V3_INV 和比较器失调）。
  - 降压后保持锁存。
  - 六路栅极全部为低。
- **阈值来源**：`inverter/docs/spec.md:18`；R48–R51、R68/R69。与 params.py 的冲突见 P-03。

### 7.2 相电流硬件过流与 BKIN 关断时间

- **目的**：测 ±20 A 的触发点，以及“电流越限 → 比较器 → 锁存 → 封锁驱动”这条链的总延迟；同时确认 MCU 经 PB12（TIM1_BKIN）收到故障。
- **前置条件**：§4.3 通过；隔离已到位。先在 12 V 下做，再在 24 V 下做；48 V、60 V 等 12/24 V 通过后再做。
- **设备**：E1、E7、E8、E9、E13。
- **激励**：采用双脉冲方式。在 U 相和 V 相之间接 E13 电感（例如 100 µH）。U 相高管和 V 相低管同时导通，电流的上升率为 di/dt = Vbus / L（24 V、100 µH 时约 0.24 A/µs），一直导通直到过流触发。电流从 V 相低管流经 RS2 到 GND，I_V 从 1.65 V 往上升。把电感对调或改变导通的相，就可以分别测 U、V、W 三相的正、负方向。
- **测点**：
  - CH1：I_V（TP12）。示波器单端，地夹接 GND。
  - CH2：OC_V_HIGH_OK（U19 第 1 脚），或者 FAULT_LATCH（TP14）。
  - CH3：FAULT_N（TP16）。
  - CH4：V 相低管 Vgs，单端（低管的源极经 5 mΩ 分流接 GND，可以用单端测）；高管 Vgs 用 E8 差分探头另测一次。
  - 电流钳：电感电流，作为参考。
- **步骤**：
  1. 固件给出一个单次长脉冲，脉宽按 t = L × 25 A / Vbus 设定，留出触发余量。
  2. 示波器用 CH1 越过 2.65 V 作触发，单次采集。
  3. 读取以下时间：t1 = 电流越限到 FAULT_LATCH 翻转；t2 = 到 FAULT_N 拉低；t3 = 到 Vgs 降到 <2 V。另外通过 SWD 读 TIM1 的 BKIF 和 MOE 位，确认 MCU 已进入 break 状态，并且 PC8 FAULT 灯亮。
  4. 每相、每个方向各做 3 次。
- **记录项**：触发电流（电流钳读数，以及 I_V 电压换算出的电流）；t1、t2、t3；关断时的峰值电流；BKIF/MOE 状态。
- **判据**：
  - 触发电流在 ±20 A ±10% 以内（草案，即 18–22 A）。
  - t3 ≤2 µs（草案，P-05）。
  - 关断峰值电流 ≤ BSC110N15NS5 规格书里的 I_D,pulse，并且在 SOA 以内。
  - FAULT_N 拉低后保持锁存。
  - MCU 进入 break 状态。
- **阈值来源**：`inverter/docs/spec.md:17`、`:59`；R42–R47。

### 7.3 驱动 12 V 欠压

- **目的**：测 DRV_UV_OK 的触发点和恢复点。
- **前置条件**：§4.2 通过；母线不接。
- **步骤**：辅助电源从 12 V 开始缓慢降压，直到 +12V_DRV 降到 DRV_UV_OK（U21 第 7 脚）翻转，记下这时的 +12V_DRV 电压；再缓慢升压，记下恢复点。
- **记录项**：触发点、恢复点、迟滞；FAULT 是否锁存。
- **判据**：触发点在 11.19 V ±3% 以内（草案）；触发后六路驱动封锁。
- **阈值来源**：R71/R72、R68/R69 推导（P-07）。另外，TPS55165 的辅助输入是升降压的，要先确认在辅助电源降低时能否让 +12V_DRV 跟着下降。如果不能，就改为直接在 +12V_DRV 上外接可调电源来测（此时要断开 U2，由焊台给出方法）。

### 7.4 过温（软件）

- **目的**：验证 NTC 读数与实际温度的对应关系，以及软件过温保护的动作。
- **前置条件**：NTC 型号、所接引脚、过温门限都已定（P-06）。
- **步骤**：
  1. 用热风枪或加热台缓慢加热 NTC 附近，同时用热电偶作参考，记下 25、50、75、100 °C 时的 ADC 读数。
  2. 在软件过温门限附近确认保护动作（停 PWM、FAULT 灯亮）和恢复策略。
- **判据**：NTC 推算温度与热电偶的偏差 ≤±3 °C（草案）；动作门限待定。
- **阈值来源**：没有（P-06）。

### 7.5 故障锁存与恢复

- **目的**：确认各类故障发生后都保持锁存、不会自动重启，只能通过明确的 ENABLE 复位来恢复。
- **依据**：`inverter/docs/spec.md:55-56`、`:59`；`inverter/hardware/fault_logic.kicad_sch` 里写的 “DELIBERATE DISABLE-TO-RESET”。
- **步骤**：对 §7.1–§7.3 的每一种故障：
  1. 故障触发后，先撤掉故障源，观察 ≥10 s，确认 FAULT_N 一直保持为低、桥不工作。
  2. 在故障源还存在时，执行 ENABLE 低→高，确认不能恢复。
  3. 故障源撤掉后，执行 ENABLE 低→高，确认 FAULT_N 释放；只有 MCU 再次 ARM 之后，PWM 才恢复。
  4. MCU 复位后，确认桥保持封锁（CTRL_READY 为低）。
- **判据**：上面 4 条全部满足。

---

## 8. 零电流 ADC 噪声测试

- **目的**：量化 PWM 开关对电流采样的干扰；检查三相之间的偏置差。
- **前置条件**：§4.3 通过；**电机不接，J4 开路**；固件有一个采样测试模式：ADC 在 PWM 中心对齐触发，连续采样并通过 SWD 或 485 导出原始码值（由烧录提供）。
- **设备**：E1、E2、E4、E5、E7。
- **步骤**：
  1. 母线 24 V。**PWM 关闭**，每路电流 ADC（I_U、I_V、I_W）连续采 10 000 点，作为对照组。
  2. **PWM 开启**：20 kHz、50% 占空比，三相同相，空跑。每路连续采 10 000 点。
  3. 母线 48 V，重复步骤 1、2。
  4. 如果时间允许，在 12 V 和 60 V 下也各做一组，作为补充记录。
  5. 同时用示波器在 TP11–TP13 上测模拟波形，记录开关沿上的尖峰，用来区分噪声是模拟前端的还是 ADC 侧的。
- **记录项**：每一组（母线电压 × PWM 开/关 × 相）的平均值、标准差、峰峰值（单位：LSB 和 A）；PWM 开与关的差值；示波器截图。
- **判据（草案，P-13）**：
  - PWM 开启时，每一路的噪声（峰峰值）折算成电流后 ≤满量程的 0.5%。
  - 三相之间的偏置差 ≤满量程的 1%。
  - 说明：如果把“满量程”取为 ADC 输入 0–3.3 V 对应 ±33 A（即 66 A），那么 0.5% 约等于 16.5 mV、20 LSB、0.33 A；1% 约等于 33 mV、41 LSB、0.66 A。0.33 A 相当于 5 Arms 峰值 7.07 A 的约 4.7%。所以“满量程”到底按 ADC 满量程还是按验收电流算，需要拍板（P-13）。
- **判据依据**：群里提出的草案（Issue #6）；50 mV/A 和 1.65 V 偏置来自 `inverter/hardware/design_review.md:34`。

---

## 9. 地弹（两板 GND 压差）

- **目的**：量出两块板 GND 之间在开关沿上的压差，为评估“空脚接地”的效果提供数据。
- **前置条件**：§4.3 通过；两块板上都有可探测的 GND 点。controller 侧可以用 485 或 SWD 端子的 GND，功率板侧用顶层的 GND 测试点。
- **设备**：E7、E8（差分探头，用最小量程档）。
- **步骤**：
  1. 先把差分探头的两端短接到同一个 GND 点，记下探头本身的底噪。
  2. 差分探头的正端接 controller GND，负端接功率板 GND（尽量靠近排针）。
  3. 工况：24 V 和 48 V（如有余力加 60 V），相电流分别为 0、2.5、5 Arms，20 kHz。
  4. 用开关沿作触发，记下尖峰的峰值、持续时间，以及低频分量的有效值。
- **记录项**：各工况下的峰值、宽度、有效值；探头底噪；截图。
- **判据**：只作记录，暂时没有合格线（P-15）。作为参考，尖峰持续时间要和 ADC 的采样窗口一起看。

---

## 10. 短路分级试验

- **目的**：验证各类短路发生后，保护能把器件保住，或者只有熔断器动作。同时把**低边采样对相对地短路的盲区**用实测数据量化出来。
- **安全边界**：
  - 从 12 V 起步。母线电源限流 ≤2 A。
  - 每一级都在防护罩下进行，人员离开 ≥1 m，用急停或远程触发。
  - 每次只短路一次。每次短路后，复查 §3.3 的电阻，确认没有损坏，才进入下一级。
  - 母线电容的储能（440 µF，`inverter/docs/spec.md:19`）不受电源限流约束，这一点要事先评估。
- **短路类型**：

| 类型 | 方法 | 能否检测到 |
| --- | --- | --- |
| A 相间短路 | 运行中用 E16 把 U 和 V 短接 | 低管导通时，分流电阻能看到电流，硬件过流动作 |
| B 相对 DC+ 短路 | 用 E16 把 U 相和 VBUS 短接 | 低管导通时，分流电阻能看到电流 |
| C 相对 DC−（GND）短路 | 用 E16 把 U 相和 GND 短接 | **看不到**：高管导通时，电流从 VBUS 经高管、相线直接到 GND，不经过分流电阻（`inverter/docs/spec.md:60`：“低端分流存在检测盲区”） |

- **分级**：A、B 两类按 12 V → 24 V → 48 V → 60 V 逐级做。每一级都要先通过上一级，母线 >24 V 时要求隔离已到位。
- **C 类（盲区）的限制**：
  - 只在 12 V、电源限流 ≤2 A 的条件下做一次，短路持续时间 ≤10 µs（用 E16 的受控开关来保证）。
  - 用来测这时 FAULT 会不会动作，以及电流峰值的大小。
  - **在雨田决定盲区怎么处理之前（P-14），C 类不做 24 V 以上的级别。**
- **测点**：母线电流（电流钳夹 J3）、短路电流（电流钳夹 E16 的回路）、FAULT_N、高管 Vgs（差分探头）、相电压（差分探头）。
- **记录项**：每一次的短路电流峰值、保护动作时间（或未动作）、F1 是否熔断及熔断时间（如果 F1 保留）、短路后的电阻复查结果。
- **判据**：
  - A、B 类：硬件过流动作，并满足 §7.2 的判据；MOS 不损坏。
  - C 类：本规范**不设合格线**，只记录。风险已写进 P-14：在盲区内，保护只能依靠母线电源的限流或者 F1。
- **阈值来源**：`inverter/docs/spec.md:59-60`。

---

## 11. 测试顺序总览

1. §3 机械检查和上电前检查
2. §4.1 controller 只上 5 V
3. §4.2 叠装，只上辅助电源
4. §4.3 母线 ≤24 V 限流
5. §7（≤24 V 的那部分）
6. 确认隔离已到位
7. §4.3（48 V、60 V）
8. §7.1、§7.2 全部完成
9. §5
10. §8、§9
11. §6（先做 24 V、5 Arms 到热稳定）
12. §6A 正式验收项 ACC-1（60 V、5 Arms、30 分钟）
13. §10

---

## 12. 待定项清单

| 编号 | 项 | 冲突来源（文件:行号） | 需谁拍板 |
| --- | --- | --- | --- |
| P-01 | 验收电流：Issue 写的是 5 Arms；spec、README、design_review 写的仍是每相连续 10 Arms、直流输入 10 A。本规范按 5 Arms 验收，10 Arms 只作记录 | Issue #6/#3/#7 正文 ↔ `inverter/docs/spec.md:14-15`、`README.md:18`、`inverter/hardware/design_review.md:34`、`docs/pcb_review_2026-11-11.md:59` | 雨田（spec 是否跟着改） |
| P-02 | 10 Arms 短时运行要不要做到 60 V，时长多少 | 同 P-01 | 雨田 |
| P-03 | 母线过压：原理图和 spec 都是 65 V，params.py 是 130 V | `inverter/sim/params.py:12` ↔ `inverter/docs/spec.md:18`、`:56`；`inverter/hardware/voltage_sense.kicad_sch:158` | 焊台（#7） |
| P-04 | 母线欠压：params.py 写 75 V，高于 60 V 工作上限；spec 写的是由软件定，没有数值；工作范围下限是 12 V | `inverter/sim/params.py:8-11` ↔ `inverter/docs/spec.md:13`、`:62` | 焊台（#7）、烧录、雨田 |
| P-05 | 验收电流改成 5 Arms 后，±20 A 的硬件过流门限要不要保留；BKIN 总关断时间没有规格值（草案 ≤2 µs）；params.py 没有过流项 | `inverter/docs/spec.md:17`、`:55`、`:59`；R42–R47；`inverter/sim/params.py`（缺这一项） | 雨田、焊台 |
| P-06 | 过温：NTC 接哪个引脚有冲突（Issue #3 写 PB1，放在 MOS 旁边；引脚表写 PB2，外接 J8）；没有硬件比较器；没有过温门限 | Issue #3 正文 ↔ `inverter/docs/pin_assignment.md:17-18`；`inverter/docs/spec.md:74` | 焊台（#1/#3）、烧录、雨田 |
| P-07 | 驱动 12 V 欠压：推导值约 11.19 V，文档里没有规格值，也没有外部迟滞 | R71/R72/R68/R69（`inverter/hardware/comparators.kicad_sch`） | 焊台 |
| P-08 | 制动门限：只定了 60 V 工况（62/61 V），12/24/48 V 工况未定 | `inverter/docs/spec.md:20-21`、`:57` | 烧录、雨田 |
| P-09 | 铜厚：Issue 写 2 oz；PCB_REVIEW 写 1 oz 候选；PCB 文件里没有定义叠层 | Issue 正文 ↔ `inverter/hardware/PCB_REVIEW.md:5`；`inverter/hardware/inverter.kicad_pcb`（没有 stackup） | 焊台（#4） |
| P-10 | D1：Issue 要求改成理想二极管，型号未定；现有原理图仍是 MBRD20150CT。温升判据要等型号定了再写 | Issue #3 正文 ↔ `docs/schematic_update_2026-11-11.md:16` | 焊台（#3） |
| P-11 | 温升判据（Tj 余量 ≥25 °C、走线温升 ≤30 K、FR-4 表面 ≤105 °C 等）只是探针草案，#3、#7 里都没有对应的数值 | Issue #6 正文（只给了条件） | 雨田 |
| P-12 | 排针位置和板距：Issue 写的是“左右两边最外侧”，现有 PCB 是两组都集中在左侧；支柱和板距未定 | Issue 正文 ↔ `docs/pcb_review_2026-11-11.md:18`、`:29` | 焊台（#4） |
| P-13 | 零电流噪声判据（0.5%、1%）是草案；“满量程”按 ADC 满量程（±33 A）还是按验收电流算，没有定 | Issue #6 正文；`inverter/hardware/design_review.md:34` | 雨田、烧录 |
| P-14 | 低边采样看不到相对地短路，这个盲区怎么处理：接受（靠电源限流和 F1），还是加母线电流或高边检测 | `inverter/docs/spec.md:60` | 雨田、焊台 |
| P-15 | 地弹没有合格线，暂时只作记录 | Issue #6 正文 | 雨田 |
| P-16 | 测试点：Issue 要求在顶层放 9 个；现有 PCB 里 TP11–TP13、TP16、TP17、TP1、TP4 都在 B 面，也没有 GND、VBUS、+5V、+3V3 测试点 | Issue #3 正文 ↔ `inverter/hardware/inverter.kicad_pcb`（测试点所在的层） | 焊台（#3/#4） |
| P-17 | 485 端子 5 V 防倒灌用二极管还是跳线；DE 脚用 PB3、PB4、PB9 中的哪一个 | Issue #3 正文；#1、#2 | 焊台（#1/#2） |
| P-18 | 上电前电阻和各电源轨电压的判据（<10 Ω、±5% 等）是草案，要等 #2/#3 的选型定了再回核 | 本规范 §3.3、§4 | 焊台 |
| P-19 | MOS 焊盘上限 124 °C 是按每颗 0.5 W 换算的。热态 RDS(on) 系数和开关损耗都没核算，datasheet 也没给结到顶面的热阻，所以热像测到的顶面温度不能换算成结温 | Issue #3 正文（每颗约 0.5 W）；BSC110N15NS5 datasheet 表 3 | 焊台（损耗核算）、雨田 |
| P-20 | MCU 功耗 P_MCU 没核算；用两板间隙里的空气温度近似 TA 这个方法是否可以接受 | DS12589 表 17、表 100；本规范 §6A A6–A8 | 烧录（功耗/时钟配置）、雨田 |
| P-21 | FR-4 板材和 Tg 没定，板面 105 °C 上限没有板材依据 | 仓库里没有板材规格；`inverter/hardware/PCB_REVIEW.md:5` 只写了层数和厚度 | 焊台（#4）、雨田 |
| P-22 | 30 分钟内没达到热稳定时，是按 30 分钟时的读数判定，还是要延长到热稳定再判 | 领班补充的要求（2026-11-12） | 雨田 |
| P-23 | 焊台的整板损耗 2.6–4 W 和板温可能 >110 °C 的估算还没入库；如果估算成立，ACC-1 会触发终止，需要先定散热或板距方案 | 群聊（2026-11-12），仓库里没有对应文档 | 焊台（入库估算）、雨田（拍板） |

---

## 13. 测试记录模板

每一次测试填一份（可以复制成 `docs/test_records/YYYYMMDD_<项>.md`）。**没有实际做过的项，不许填写结果。**

```markdown
# 测试记录：<章节号 / 测试名>

- 日期时间（Asia/Shanghai）：
- 测试人：
- 被测板：controller SN ____ / inverter SN ____，硬件版本 ____，固件版本（git hash）____
- 规范版本：docs/test_spec.md @ <commit>
- 环境：温度 ____ °C，湿度 ____ %，静止空气 是/否
- 隔离状态：USB-485 隔离型 是/否；SWD 隔离 是/否；CAN 隔离 是/否；板 GND 对 PC 外壳电阻 ____ MΩ
- 设备（型号 / 编号 / 校准有效期）：

| 设备 | 型号 | 编号 | 校准有效期 |
| --- | --- | --- | --- |

## 设置
- 母线 ____ V，限流 ____ A；辅助 ____ V，限流 ____ A
- PWM ____ kHz，占空比 / 调制方式 ____，负载 ____

## 结果

| 记录项 | 测量值 | 判据 | 结论（通过 / 不通过 / 仅记录） |
| --- | --- | --- | --- |

## 波形 / 热像 / 原始数据
- 文件路径：

## 异常与偏离规范之处
-

## 结论与签字
- 结论：
- 复核人：
```

### 13.1 温升记录附表

| 级别 | 母线 V | 相电流 Arms | 输入 W | 稳定时间 min | T1 | T2 | … | T19 | T20（环境） | 最高点 / 位置 | 推算 Tj |
| --- | --- | --- | --- | --- | --- | --- | --- | --- | --- | --- | --- |

### 13.2 零电流噪声附表

| 母线 V | PWM | 相 | 均值 LSB | σ LSB | 峰峰值 LSB | 峰峰值 A | 峰峰值 %FS | 偏置差 %FS |
| --- | --- | --- | --- | --- | --- | --- | --- | --- |

### 13.3 保护附表

| 保护项 | 方向 / 相 | 次数 | 触发值 | t1 µs | t2 µs | t3 µs | 锁存 | 恢复方式 |
| --- | --- | --- | --- | --- | --- | --- | --- | --- |

### 13.4 ACC-1 每分钟记录表

| 分钟 | 母线 V | 母线 A | Iu/Iv/Iw Arms | A1 | A2 | A4 | A5 | A6 | A7 | A8 | A9 | NTC | 备注 |
| --- | --- | --- | --- | --- | --- | --- | --- | --- | --- | --- | --- | --- | --- |
| 0 | | | | | | | | | | | | | |

最后 5 分钟的升温速率（°C/min）：A1 ___，A4 ___，A5 ___，A6 ___。是否达到热稳定：是 / 否。是否触发终止：否 / 是（第 ___ 分钟，测点 ___，读数 ___）。
