leolei2012/power_system/controller/hardware/review/controller.pdf

1 | 2 | 3 | 4 | 5 | 6 | 7 | 8

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
Size: A3 | Rev: A-draft | F Date: 2026-11-01
KiCad E.D.A. 10.0.7 | Id: 1/9

# Title: Controller - Overview and design boundaries

## File: controller.kicad_sch

## Sheet: /

## power_system

## HARDWARE REVIEW DRAFT - NOT RELEASED FOR PCB

## LKS32MC451VCT8 | single reference GND | 5 V input only

5 V input, 3.3 V and supervision 文件: power.kicad_sch | LKS32MC451VCT8 signal assignment 文件: mcu.kicad_sch
Inverter 1 signal port and brake 文件: inverter_1.kicad_sch Dedicated Boost / Vienna control port 文件: pfc.kicad_sch | ABZ encoder ports 文件: sensors.kicad_sch

Inverter 2 signal port and brake 文件: inverter_2.kicad_sch

Two independent SPI expansion ports 文件: spi.kicad_sch | SWD, UART, CAN and status LEDs 文件: debug_comms.kicad_sch

## CONTROLLER / REV A HARDWARE REVIEW

One LKS32MC451VCT8; 2 inverter ports + 1 dedicated PFC port. No LLC, USB or Hall. All sheets share the explicitly named global nets. All external ports are NON-ISOLATED in this draft. 5 V input -> TLV76733 -> 3.3 V

TPS3808G33 reset and MCU decoupling | U1A/B/C + crystal + reserved test pads Physical pin numbers follow the 100-pin CSV

J2: six PWM + enable + fault + eight ADC J3: separate brake command

J7/J8: independent A/B/Z inputs 3.3 V single-ended draft; optional power DNP

J4: six PWM + enable + fault + eight ADC J5: separate brake command

J6: six gate commands + nine ADC Enable, fault and future precharge command

J9/J10: independent SPI_A / SPI_B
CS pull-ups; optional sensor power DNP

J11 SWD / J12 UART / J13 CAN option Reset, five status LEDs; CAN defaults DNP REVIEW BOUNDARIES

1. Only a regulated 5 V source enters J1; select one inverter supply. No parallel supplies. 2. Three 24-pin ports carry signals only; no bus power or sensor supply on these ports. 3. GND/AGND contact positions share controller GND. Different power reference domains require isolation. 4. ABZ is provisionally 3.3 V single-ended. Do not connect 5 V / differential encoders directly. 5. Connector mechanics, crystal loading, ESD/clamps and component procurement remain review items. 6. PFC timing / ADC scheduling are not proven by this schematic. See design_review.md.

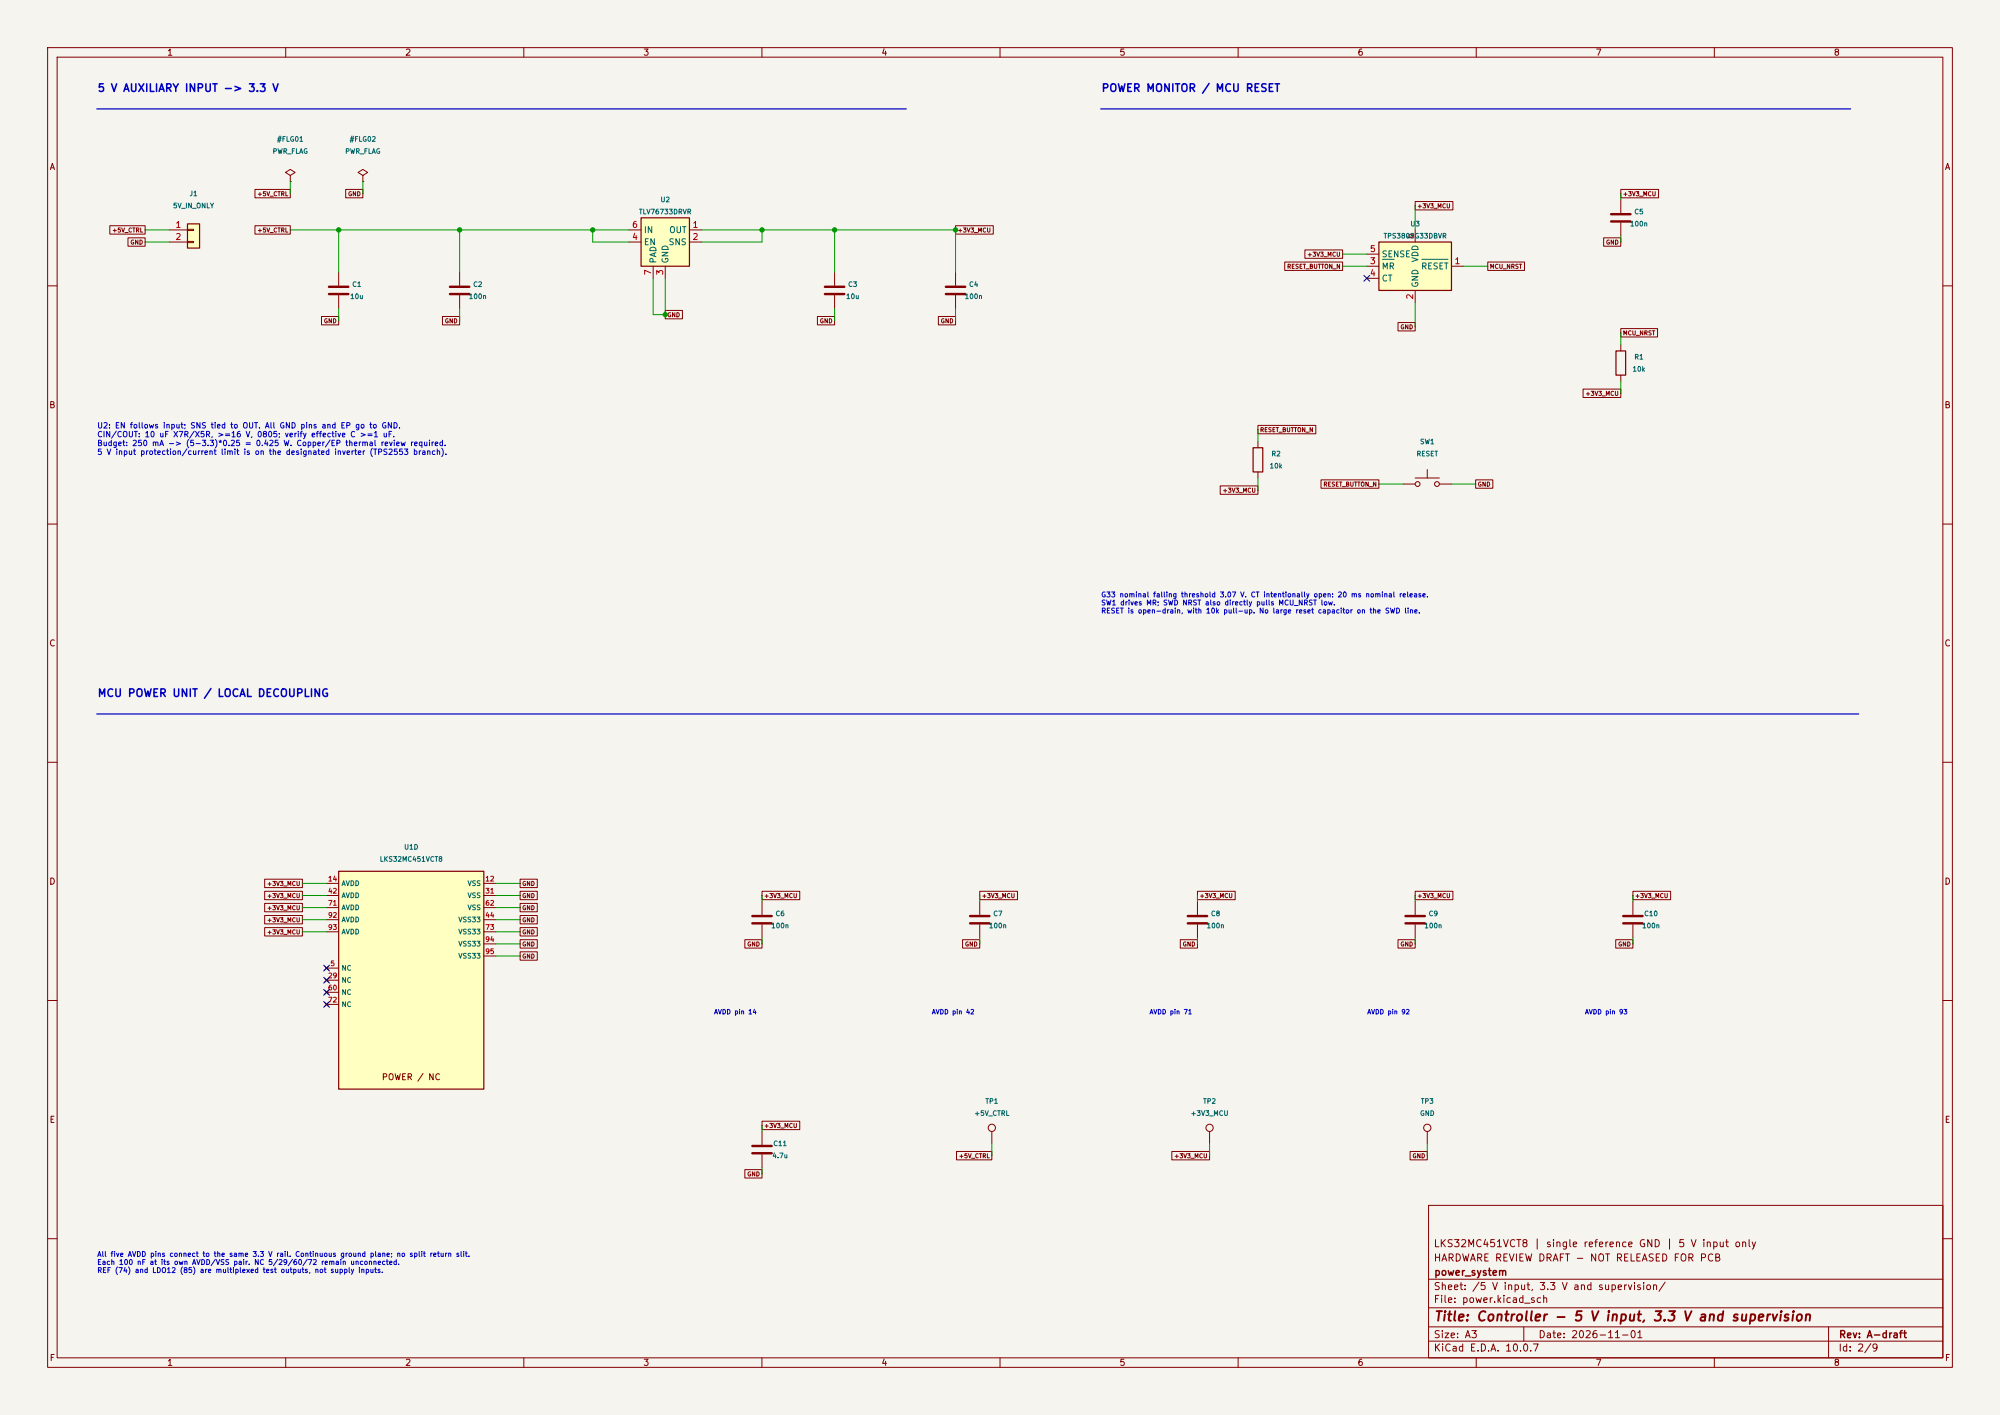
[picture p162: page 2]

POWER MONITOR / MCU RESET

U2: EN follows input; SNS tied to OUT. All GND pins and EP go to GND. CIN/COUT: 10 uF X7R/X5R, >=16 V, 0805; verify effective C >=1 uF. Budget: 250 mA -> (5-3.3)*0.25 = 0.425 W. Copper/EP thermal review required. 5 V input protection/current limit is on the designated inverter (TPS2553 branch).

AVDD pin 92 MCU POWER UNIT / LOCAL DECOUPLING

+5V_CTRL All five AVDD pins connect to the same 3.3 V rail. Continuous ground plane; no split return slit. Each 100 nF at its own AVDD/VSS pair. NC 5/29/60/72 remain unconnected. REF (74) and LDO12 (85) are multiplexed test outputs, not supply inputs.

LKS32MC451VCT8 | single reference GND | 5 V input only
HARDWARE REVIEW DRAFT - NOT RELEASED FOR PCB
power_system
Sheet: /5 V input, 3.3 V and supervision/
File: power.kicad_sch
Title: Controller - 5 V input, 3.3 V and supervision

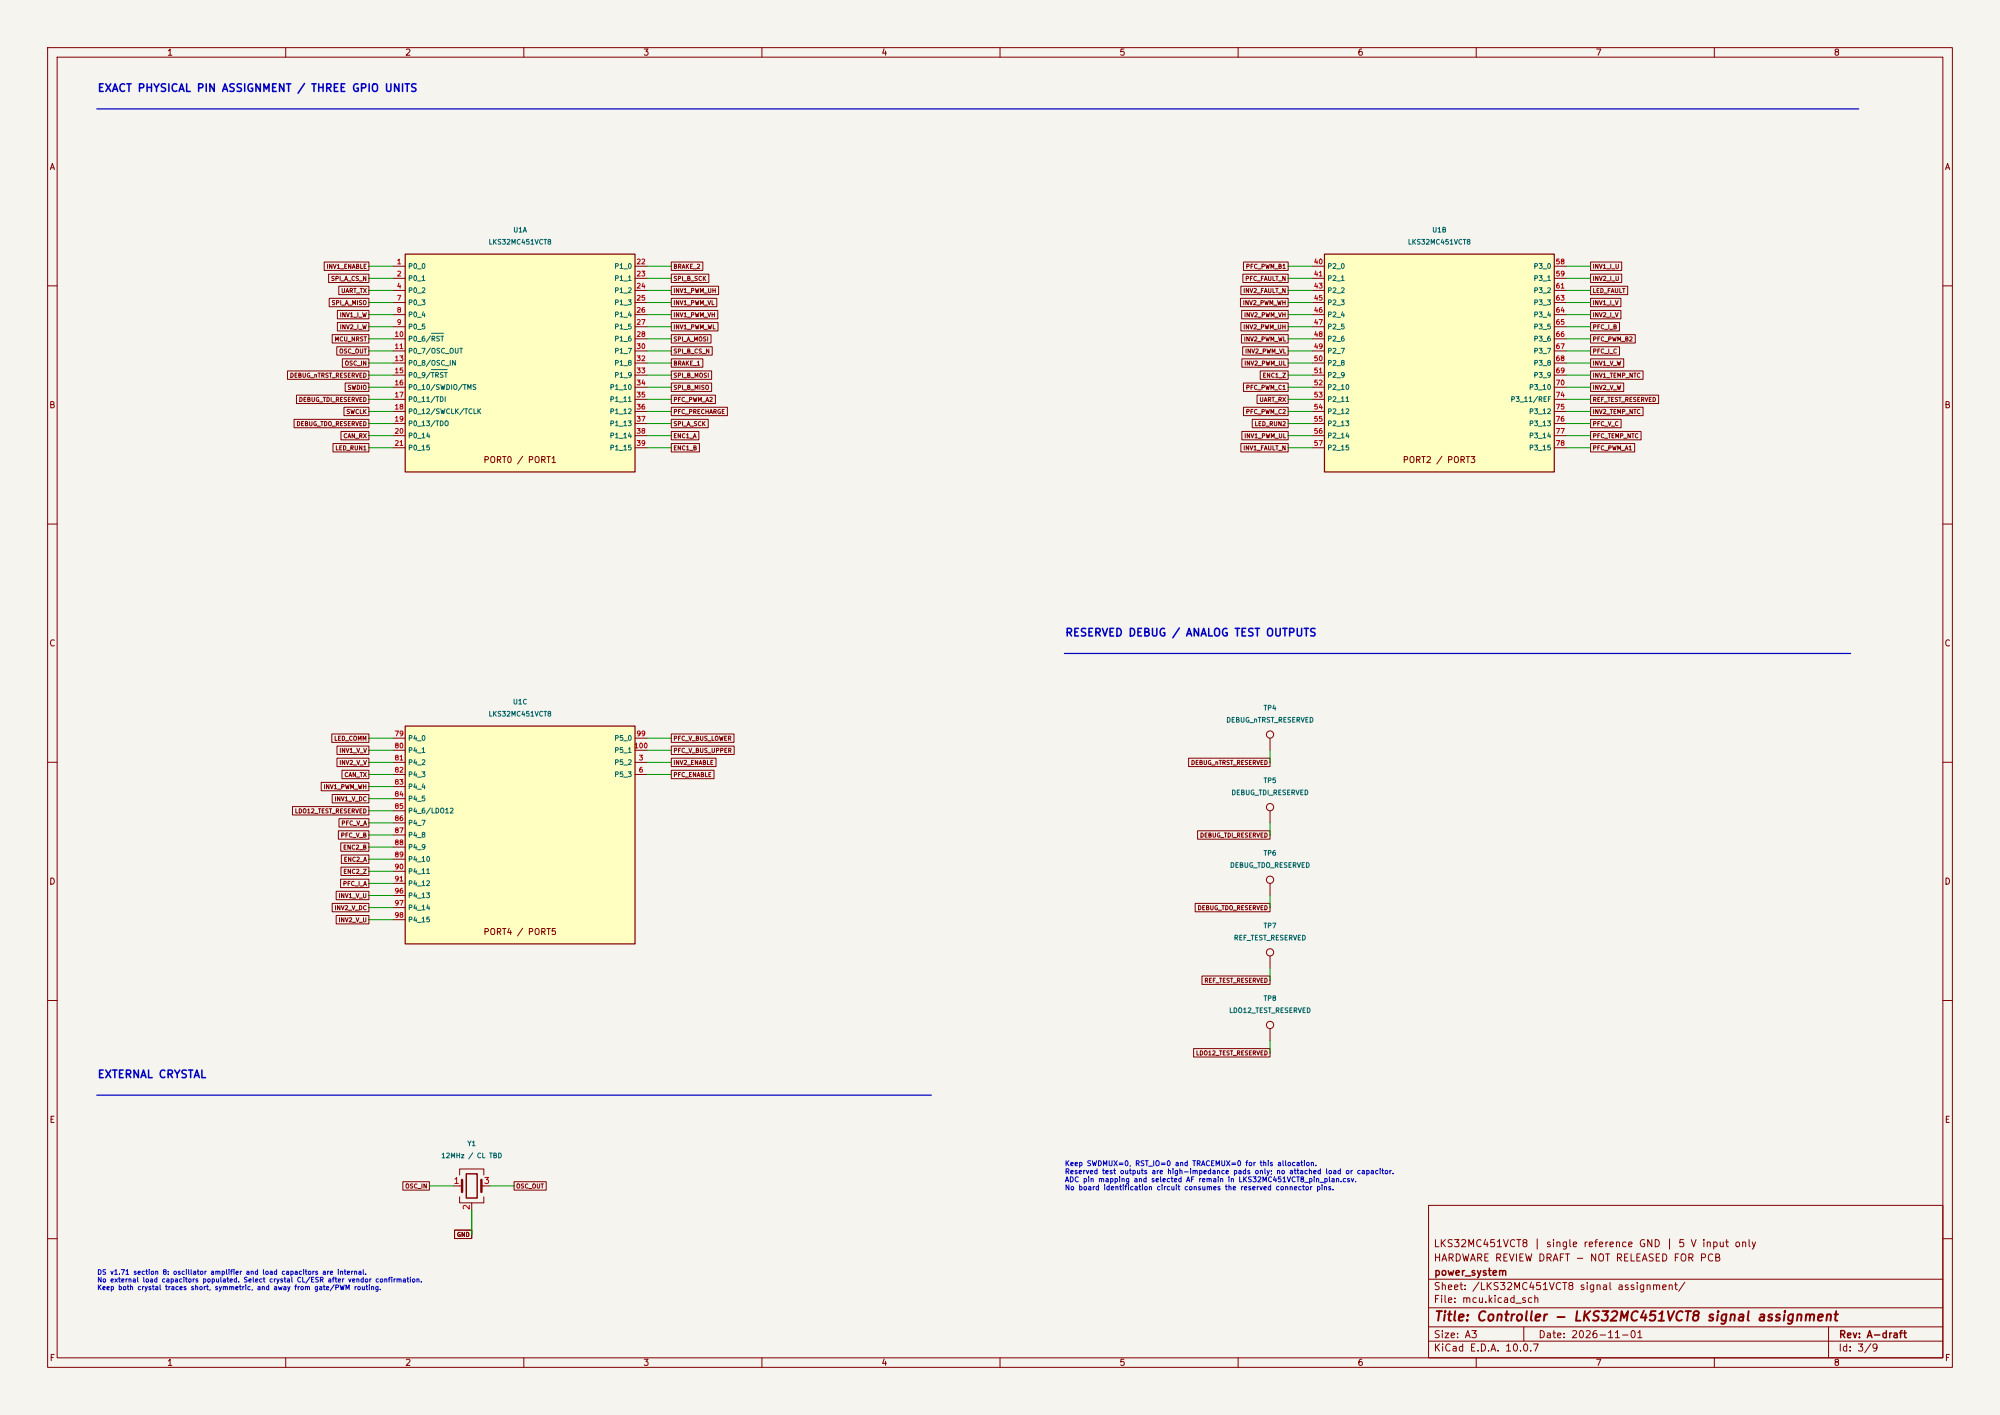
[picture p163: page 3]

EXACT PHYSICAL PIN ASSIGNMENT / THREE GPIO UNITS

RESERVED DEBUG / ANALOG TEST OUTPUTS

LKS32MC451VCT8 | single reference GND | 5 V input only
HARDWARE REVIEW DRAFT - NOT RELEASED FOR PCB
power_system
Sheet: /LKS32MC451VCT8 signal assignment/
File: mcu.kicad_sch
Title: Controller - LKS32MC451VCT8 signal assignment

DS v1.71 section 8: oscillator amplifier and load capacitors are internal. No external load capacitors populated. Select crystal CL/ESR after vendor confirmation. Keep both crystal traces short, symmetric, and away from gate/PWM routing.

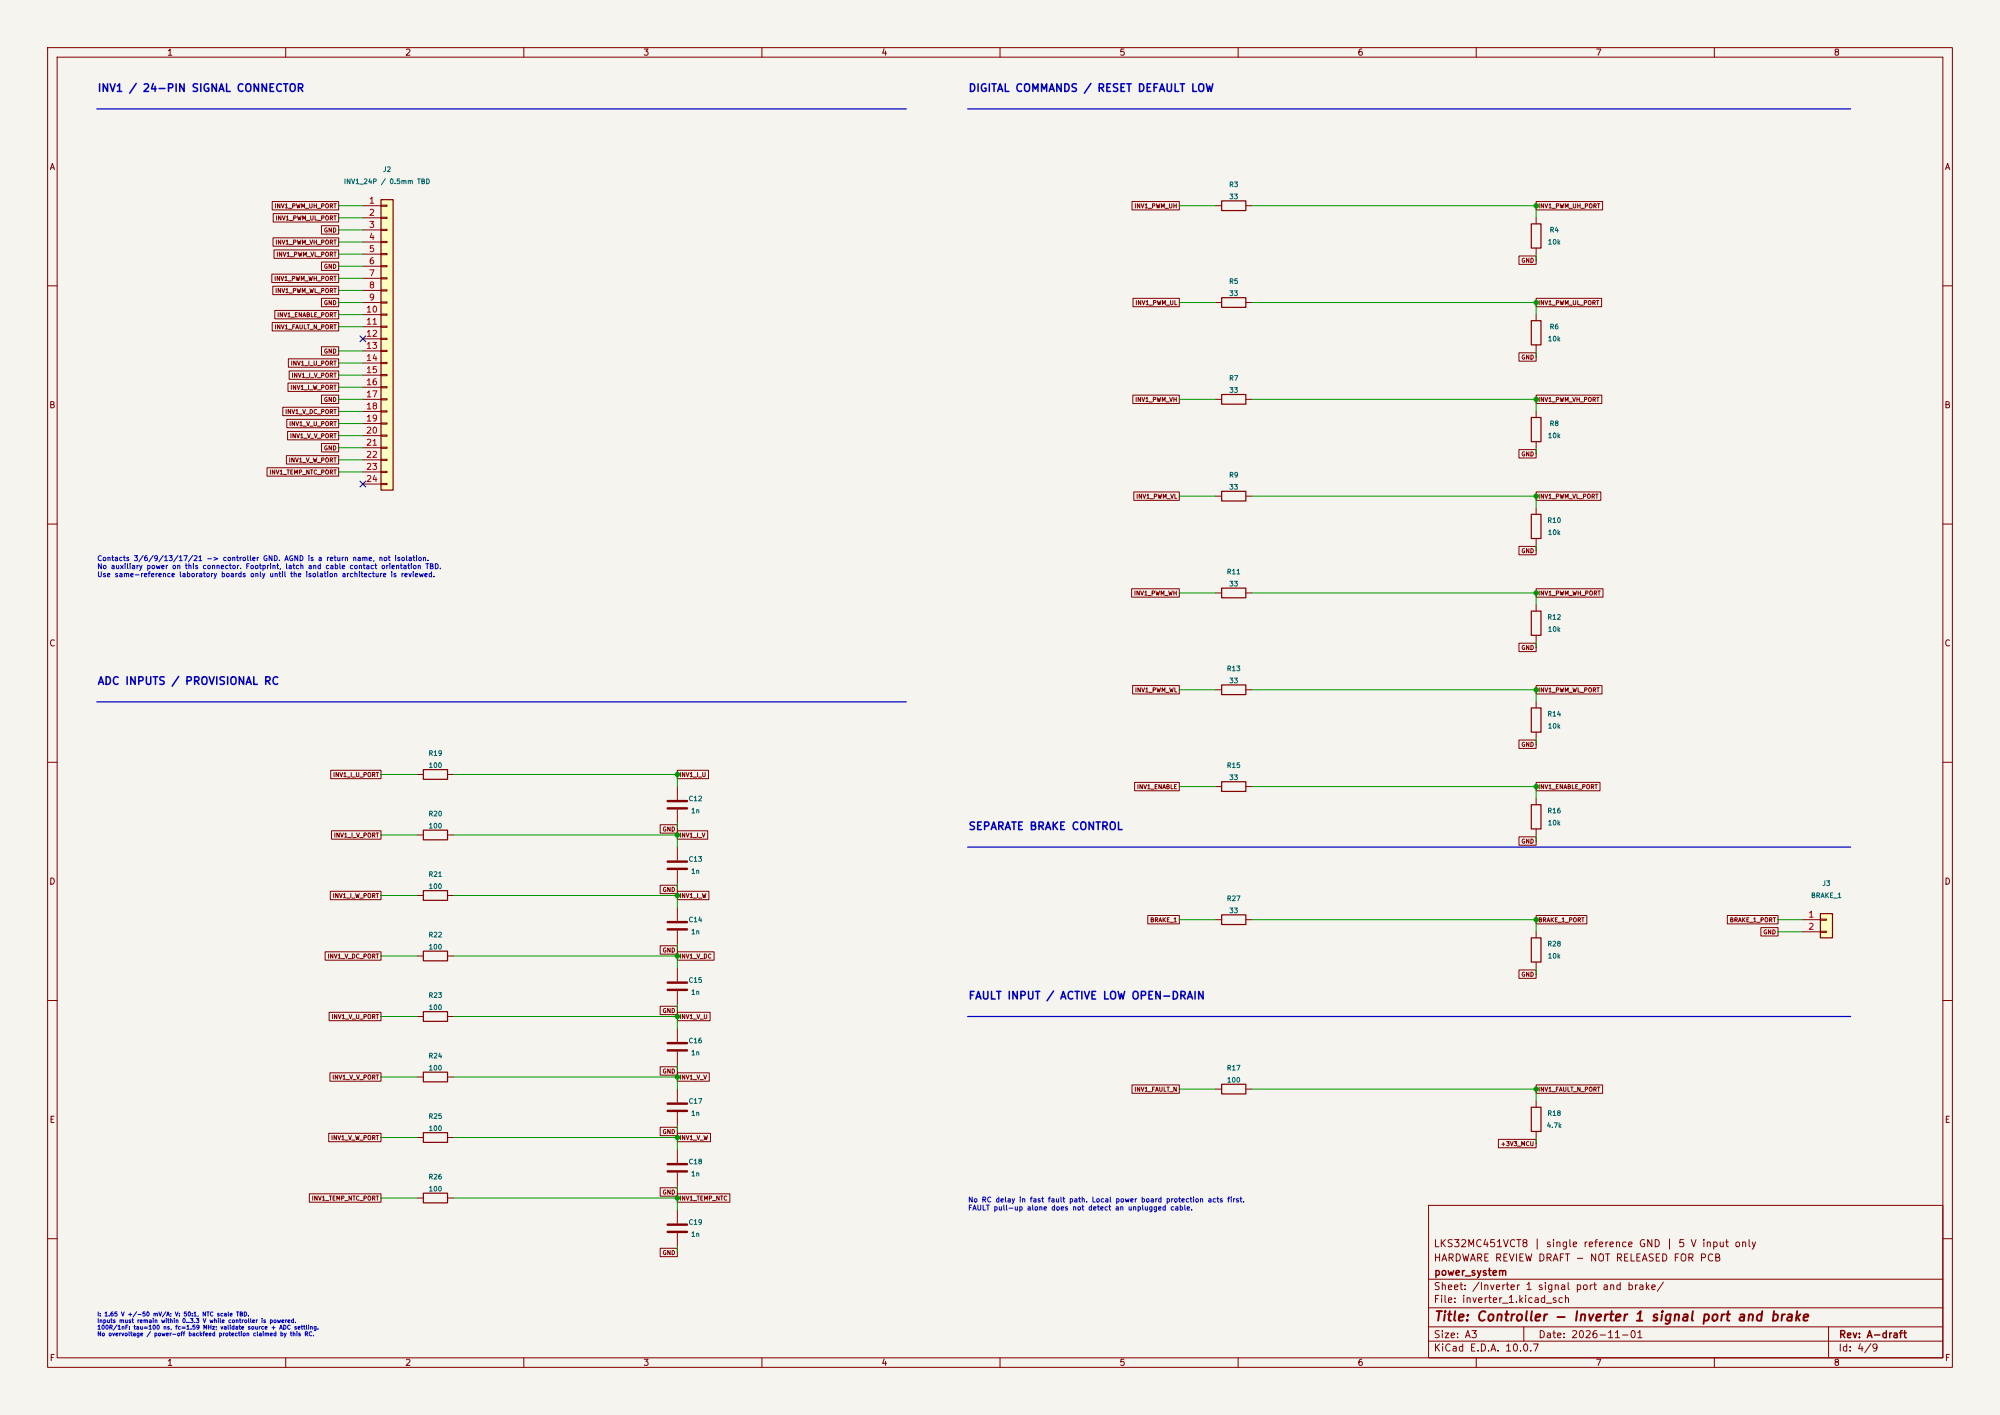
[picture p164: page 4]

Contacts 3/6/9/13/17/21 -> controller GND. AGND is a return name, not isolation. No auxiliary power on this connector. Footprint, latch and cable contact orientation TBD. Use same-reference laboratory boards only until the isolation architecture is reviewed. ADC INPUTS / PROVISIONAL RC

LKS32MC451VCT8 | single reference GND | 5 V input only
HARDWARE REVIEW DRAFT - NOT RELEASED FOR PCB
power_system
Sheet: /Inverter 1 signal port and brake/
File: inverter_1.kicad_sch
Title: Controller - Inverter 1 signal port and brake

I: 1.65 V +/-50 mV/A; V: 50:1, NTC scale TBD.

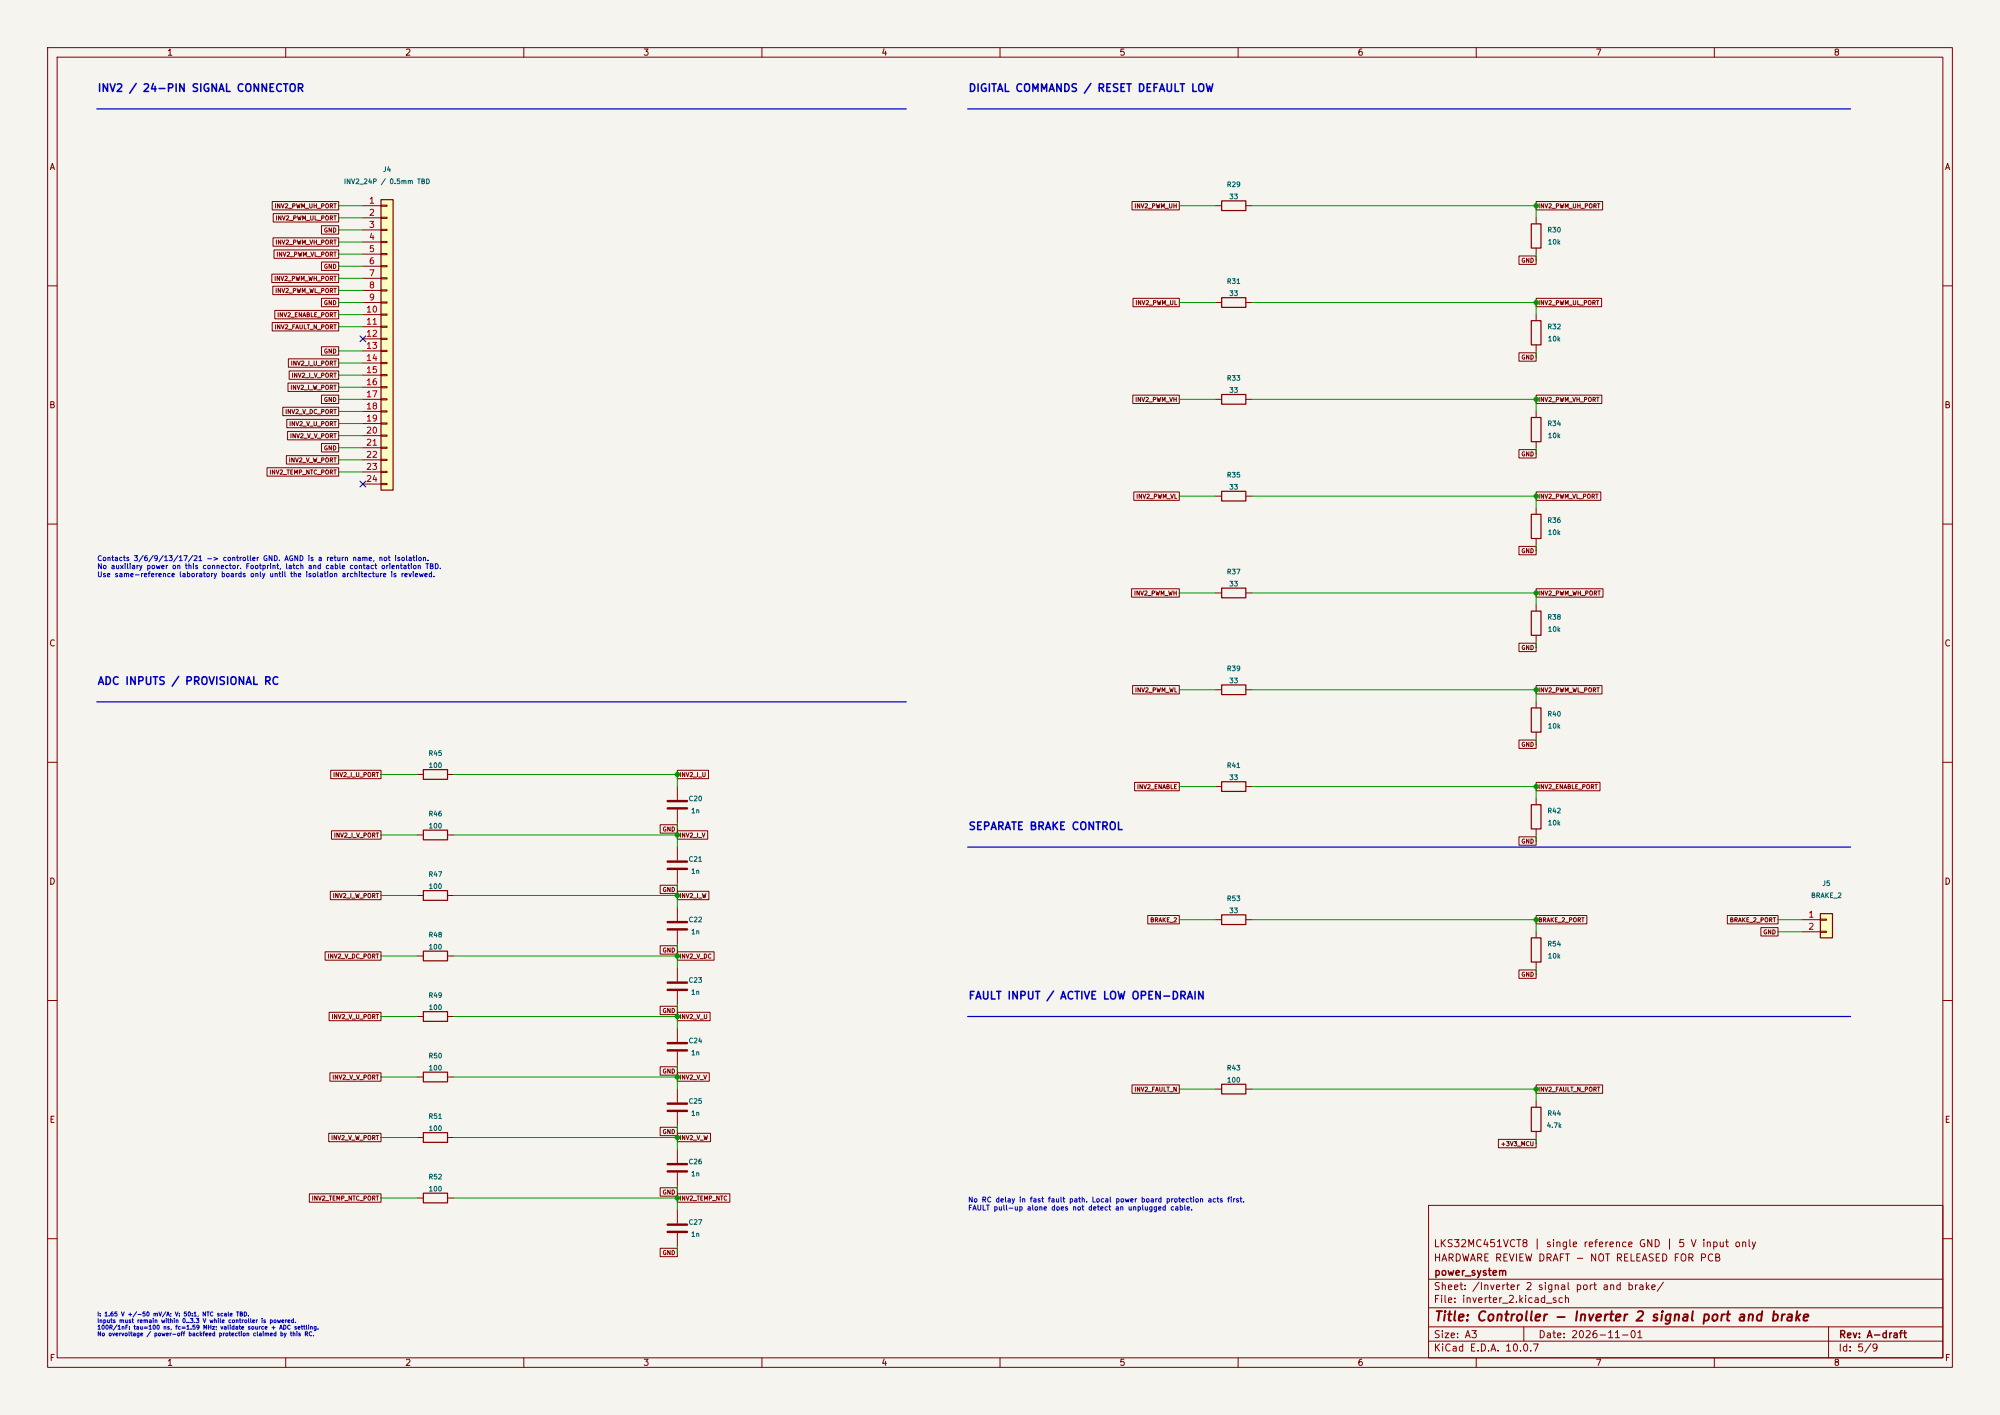
[picture p165: page 5]
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

LKS32MC451VCT8 | single reference GND | 5 V input only
HARDWARE REVIEW DRAFT - NOT RELEASED FOR PCB
power_system
Sheet: /Inverter 2 signal port and brake/
File: inverter_2.kicad_sch
Title: Controller - Inverter 2 signal port and brake

I: 1.65 V +/-50 mV/A; V: 50:1, NTC scale TBD.

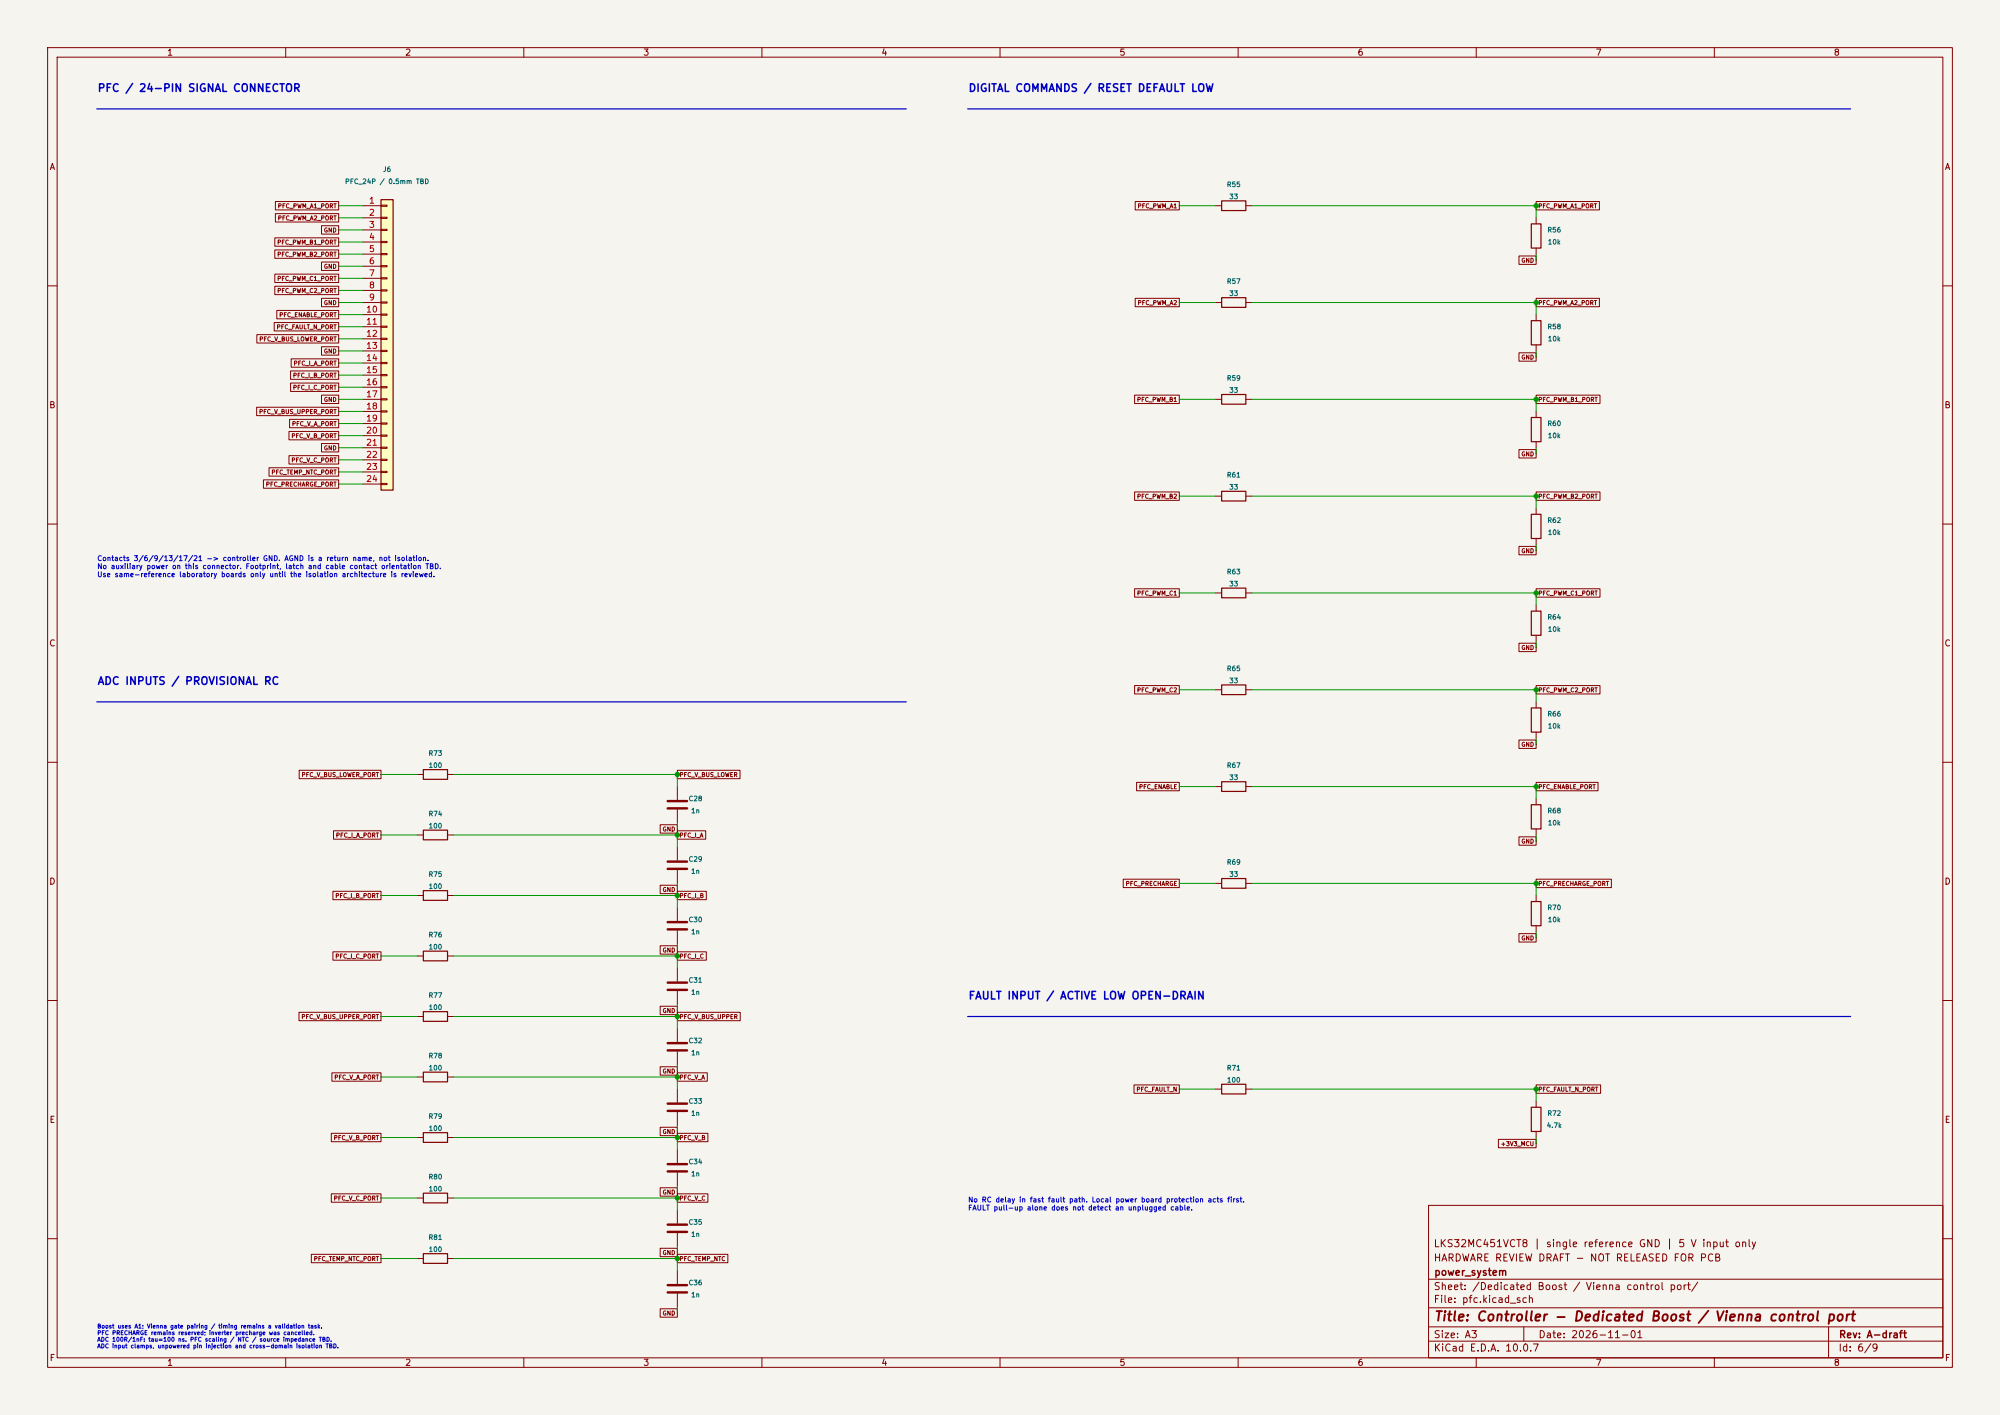
[picture p166: page 6]
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

FAULT INPUT / ACTIVE LOW OPEN-DRAIN

LKS32MC451VCT8 | single reference GND | 5 V input only
HARDWARE REVIEW DRAFT - NOT RELEASED FOR PCB
power_system
Sheet: /Dedicated Boost / Vienna control port/
File: pfc.kicad_sch
Title: Controller - Dedicated Boost / Vienna control port

Boost uses A1; Vienna gate pairing / timing remains a validation task. PFC PRECHARGE remains reserved; inverter precharge was cancelled. ADC 100R/1nF: tau=100 ns. PFC scaling / NTC / source impedance TBD. ADC input clamps, unpowered pin injection and cross-domain isolation TBD.

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
# Title: Controller - ABZ encoder ports

## File: sensors.kicad_sch

## Sheet: /ABZ encoder ports/

## power_system

## HARDWARE REVIEW DRAFT - NOT RELEASED FOR PCB

## LKS32MC451VCT8 | single reference GND | 5 V input only

R83
100k R88
0 | R87

100k 1
2
3
4
5

J7
ENC1: A B Z GND VOPT | R85

100k R82
100 R84
100 | 1
2
3
4
5

J8
ENC2: A B Z GND VOPT C37

100n R86

100 | R89
100 | R90

100k R91

100 R93
100 | R92
100k R94

100k R95

0 | C38
| 100n

# ENC1_B_PORT ENC1_Z_PORT

ENC1_B_PORT ENC1_Z_PORT GND

GND

ENC1_VOPT | ENC1_B

ENC1_Z

ENC1_A_PORT

ENC1_VOPT GND +3V3_MCU

GND

ENC1_VOPT

ENC2_B_PORT ENC2_Z_PORT GND

ENC2_VOPT | ENC2_A ENC2_B

ENC2_A GND

ENC2_B

ENC2_A_PORT ENC2_A_PORT ENC2_B_PORT ENC2_Z_PORT ENC1_Z

ENC1_A | GND

ENC2_Z

ENC1_A ENC1_B

ENC2_Z

ENC2_VOPT

ENC1_A_PORT | GND

ENC2_VOPT GND

GND | +3V3_MCU

VOPT link + bypass DNP: no sensor power by default. 3.3 V push-pull ABZ only; no differential receiver or 5 V conversion. External supply reference must be GND; do not backfeed this port. ENCODER INTERFACE REVIEW

The five-pin connector is a provisional schematic assignment, not a frozen production connector. Actual encoder model / output stage / cable length / pulse rate must be selected before PCB. A 5 V TTL, open-collector, RS-422 or other differential encoder needs an appropriate input stage. The eight reserved sensor-power parts on the ABZ/SPI sheets are not enabled by merely fitting connectors.

## ABZ INCREMENTAL ENCODERS / 3.3 V SINGLE-ENDED DRAFT

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

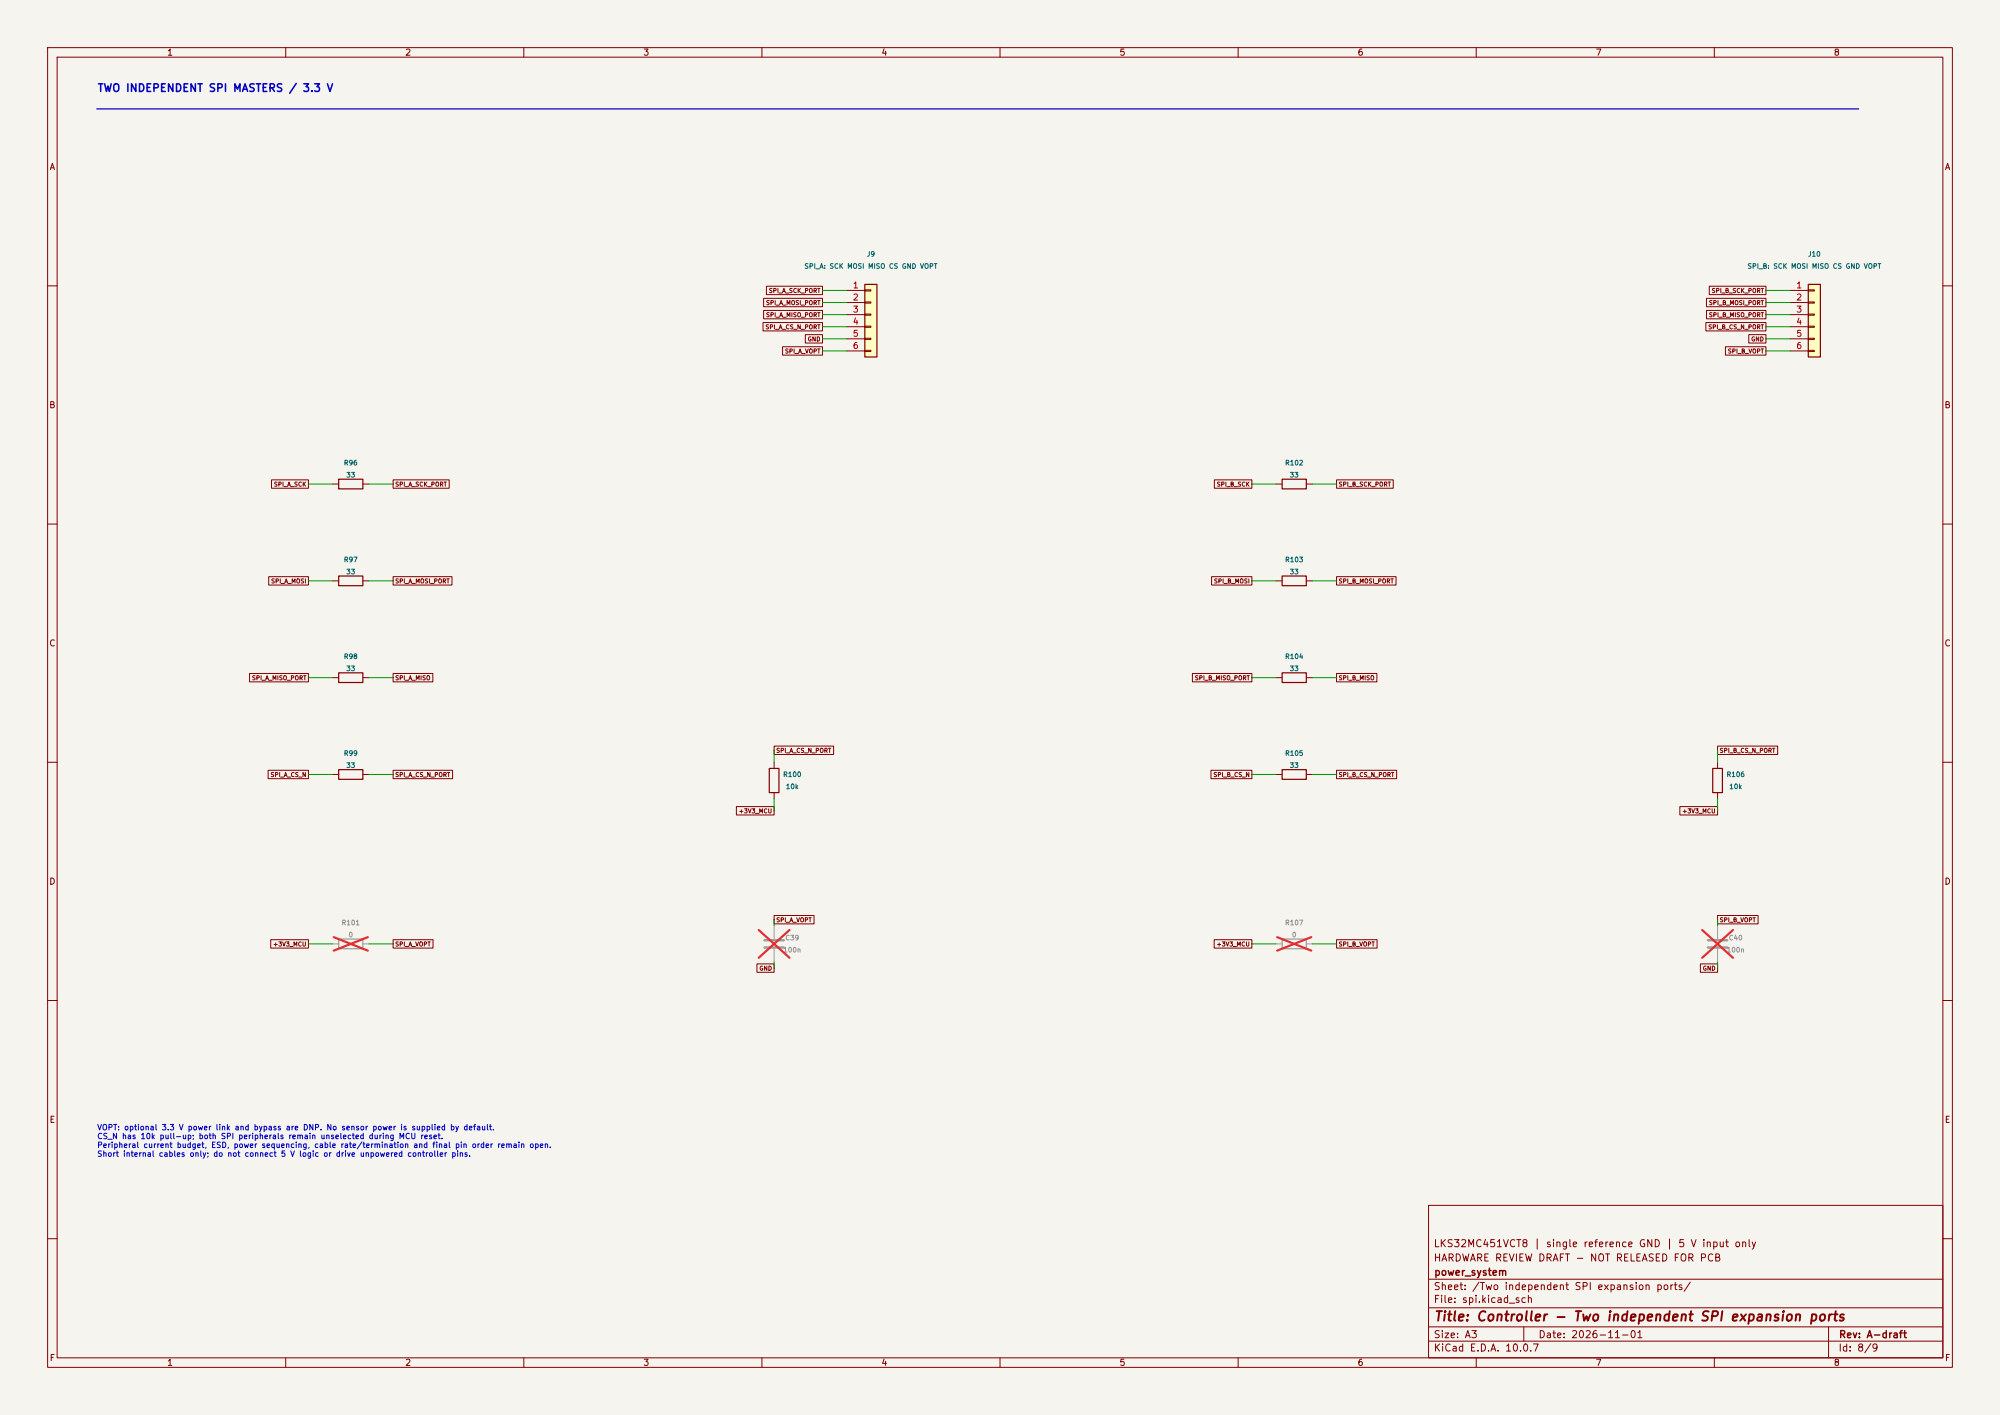
[picture p167: page 8]

SPI_B_SCK_PORT SPI_B_MOSI_PORT TWO INDEPENDENT SPI MASTERS / 3.3 V

SPI_B: SCK MOSI MISO CS GND VOPT 1

SPI_A: SCK MOSI MISO CS GND VOPT R99

VOPT: optional 3.3 V power link and bypass are DNP. No sensor power is supplied by default. CS_N has 10k pull-up; both SPI peripherals remain unselected during MCU reset. Peripheral current budget, ESD, power sequencing, cable rate/termination and final pin order remain open. Short internal cables only; do not connect 5 V logic or drive unpowered controller pins.

LKS32MC451VCT8 | single reference GND | 5 V input only
HARDWARE REVIEW DRAFT - NOT RELEASED FOR PCB
power_system
Sheet: /Two independent SPI expansion ports/
File: spi.kicad_sch
Title: Controller - Two independent SPI expansion ports

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
# Title: Controller - SWD, UART, CAN and status LEDs

## File: debug_comms.kicad_sch

## Sheet: /SWD, UART, CAN and status LEDs/

## power_system

## HARDWARE REVIEW DRAFT - NOT RELEASED FOR PCB

## LKS32MC451VCT8 | single reference GND | 5 V input only

R120
2.2k

R114

10k R110
10k R111

10k R115

0 | R121
2.2k | R117

10k C41
100n

R113

100 R112
100

R123
2.2k D5

LED_COMM / BLUE D4
LED_FAULT / RED

R116
0 | R122

2.2k

1
2
3
4
5

J11
SWD: VTREF IO CLK GND NRST | 1

2
3

J12 UART: TX RX GND

R119
2.2k | D3
LED_RUN2 | / GREEN
D1 PWR / | GREEN

D2
LED_RUN1 / GREEN

R108
33 R109
33 | R118

120 D

1 | GND

# 2 VCC

3 R

4 | CANL | 6 CANH | 7

U4
SN65HVD232DR | 1
2
3
4

J13 CAN: H L GND NC

# SWCLK_PORT CAN_TX_PHY CAN_RX

+3V3_MCU

CAN_TX

SWDIO_PORT SWCLK_PORT GND MCU_NRST

CAN_RX_PHY | +3V3_MCU
PWR_ANODE | LED_RUN1_ANODE

LED_RUN1

SWDIO_PORT

GND

SWDIO

SWCLK | UART_RX_PORT

CAN_H

SWDIO

SWCLK | +3V3_MCU

GND

GND

CAN_H | CAN_L

UART_TX

+3V3_MCU

# CAN_TX_PHY +3V3_MCU

CAN_L

LED_RUN2

GND

+3V3_MCU

UART_TX_PORT

LED_FAULT

UART_TX_PORT

LED_FAULT_ANODE

UART_RX

LED_COMM_ANODE

+3V3_MCU

LED_COMM

UART_RX_PORT | UART_RX

LED_RUN2_ANODE

+3V3_MCU

GND

CAN_H | +3V3_MCU +3V3_MCU

GND +3V3_MCU

CAN_L CAN_RX_PHY CAN_TX_PHY

VTREF is target-voltage reference, not a power input. No SWO; preserve reserved JTAG group pins. MCU_NRST open-drain pull-up is on power sheet. CLASSIC CAN / OPTIONAL ASSEMBLY BLOCK

SWD / RESET | 3.3 V TTL UART / NO POWER PIN

TX/RX directions relative to controller. Cross TX to peer RX. 3.3 V logic only; no RS-232 / RS-485 transceiver.

Indicative LED current <=(3.3-1.6)/2.2k=0.77 mA. LEDs do not grant hardware PWM permission. Exact LEDs and switch are procurement TODOs. FIVE INDICATORS / LOW-ACTIVE GPIO LEDS

DNP block: U4, two 0R links, TX pull-up, bypass, J and termination. Populate the entire transceiver block together; 120R only at a bus end. SN65HVD232 pins 5/8 are NC; no standby GPIO. Pin 4 at connector is NC; no supply output. ESD/protection TBD.
