leolei2012/power_system/(list of files, drawings)

Other design files:
controller/hardware/g431_core/review/pcb_2026-11-11/pcb_check.json
controller/hardware/g431_core/review/pcb_2026-11-11/routing/controller.dsn
docs/pcb_stack_contract_rev_e.json
inverter/hardware/review/compact_classic_guarded.dsn
inverter/hardware/review/compact_classic_raw.dsn
inverter/hardware/review/compact_probe.dsn
inverter/hardware/review/compact_resume_guarded.dsn
inverter/hardware/review/compact_resume_raw.dsn
inverter/hardware/review/compact_route_guarded.dsn
inverter/hardware/review/compact_route_raw.dsn
inverter/hardware/review/inverter_route.dsn
inverter/hardware/review/inverter_route_resume.dsn
inverter/hardware/review/inverter_route_scoped.dsn
inverter/hardware/review/kelvin_final_probe/fresh.dsn
inverter/hardware/review/kelvin_final_probe/guarded.dsn
inverter/hardware/review/kelvin_private_probe/fresh_probe.dsn
inverter/hardware/review/kelvin_private_probe/guarded_probe.dsn
inverter/hardware/review/kelvin_resume_probe/resume.dsn
inverter/hardware/review/kelvin_resume_probe/resume_guarded.dsn
inverter/hardware/review/pcb_aux_candidate_drc.json
inverter/hardware/review/pcb_aux_candidate_geometry.json
inverter/hardware/review/pcb_check.json
inverter/hardware/review/pcb_deadend_cleanup.json
inverter/hardware/review/pcb_drc.json
inverter/hardware/review/pcb_final_aux_candidate_drc.json
inverter/hardware/review/pcb_final_aux_candidate_geometry.json
inverter/hardware/review/pcb_final_power_check.json
inverter/hardware/review/pcb_initial_drc.json
inverter/hardware/review/pcb_merged_routes.json
inverter/hardware/review/pcb_necks_candidate_drc.json
inverter/hardware/review/pcb_necks_candidate_geometry.json
inverter/hardware/review/pcb_placement.json
inverter/hardware/review/pcb_power_candidate_check.json
inverter/hardware/review/pcb_power_copper.json
inverter/hardware/review/pcb_power_drc.json
inverter/hardware/review/pcb_power_geometry_final.json
inverter/hardware/review/pcb_rev_e_2026-11-11/full_route/inverter_fourth_guarded.dsn
inverter/hardware/review/pcb_rev_e_2026-11-11/full_route/inverter_fourth_guarded.raw.dsn
inverter/hardware/review/pcb_rev_e_2026-11-11/full_route/inverter_fourth_scoped.dsn
inverter/hardware/review/pcb_rev_e_2026-11-11/full_route/inverter_guarded.dsn
inverter/hardware/review/pcb_rev_e_2026-11-11/full_route/inverter_remaining.dsn
inverter/hardware/review/pcb_rev_e_2026-11-11/full_route/inverter_second_guarded.dsn
inverter/hardware/review/pcb_rev_e_2026-11-11/full_route/inverter_second_guarded.raw.dsn
inverter/hardware/review/pcb_rev_e_2026-11-11/full_route/inverter_third_guarded.dsn
inverter/hardware/review/pcb_rev_e_2026-11-11/full_route/inverter_third_guarded.raw.dsn
inverter/hardware/review/pcb_rev_e_2026-11-11/pcb_review.json
inverter/hardware/review/pcb_route_scope.json
inverter/hardware/review/pcb_routing_repair.json
inverter/hardware/review/pcb_shunt_returns.json
inverter/hardware/review/pcb_silkscreen.json
inverter/hardware/review/pcb_tooling.json
inverter/hardware/review/pcb_via_bank_spacing.json
inverter/hardware/review/pcb_whin_candidate_drc.json
inverter/hardware/review/pcb_whin_candidate_geometry.json
inverter/hardware/review/pcb_whin_long_applied_geometry.json
inverter/hardware/review/pcb_whin_long_candidate_drc.json
inverter/hardware/review/pcb_whin_long_geometry.json
inverter/hardware/review/pcb_whin_long_obstacles.json
inverter/hardware/review/pcb_whin_long_with_feed_drc.json
inverter/hardware/tools/pcb_3v3_feeds.json
inverter/hardware/tools/pcb_aux_routes.json
inverter/hardware/tools/pcb_control_copper_refinements.json
inverter/hardware/tools/pcb_control_placement.json
inverter/hardware/tools/pcb_control_refinements.json
inverter/hardware/tools/pcb_control_routes.json
inverter/hardware/tools/pcb_driver_refinements.json
inverter/hardware/tools/pcb_final_aux_routes.json
inverter/hardware/tools/pcb_final_control_checkpoint.json
inverter/hardware/tools/pcb_final_control_routes.json
inverter/hardware/tools/pcb_final_power_checkpoint.json
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
