leolei2012/power_system/controller/hardware/g431_core/controller.kicad_pcb

## KiCad design controller/hardware/g431_core/controller.kicad_pcb (2026-11-12)

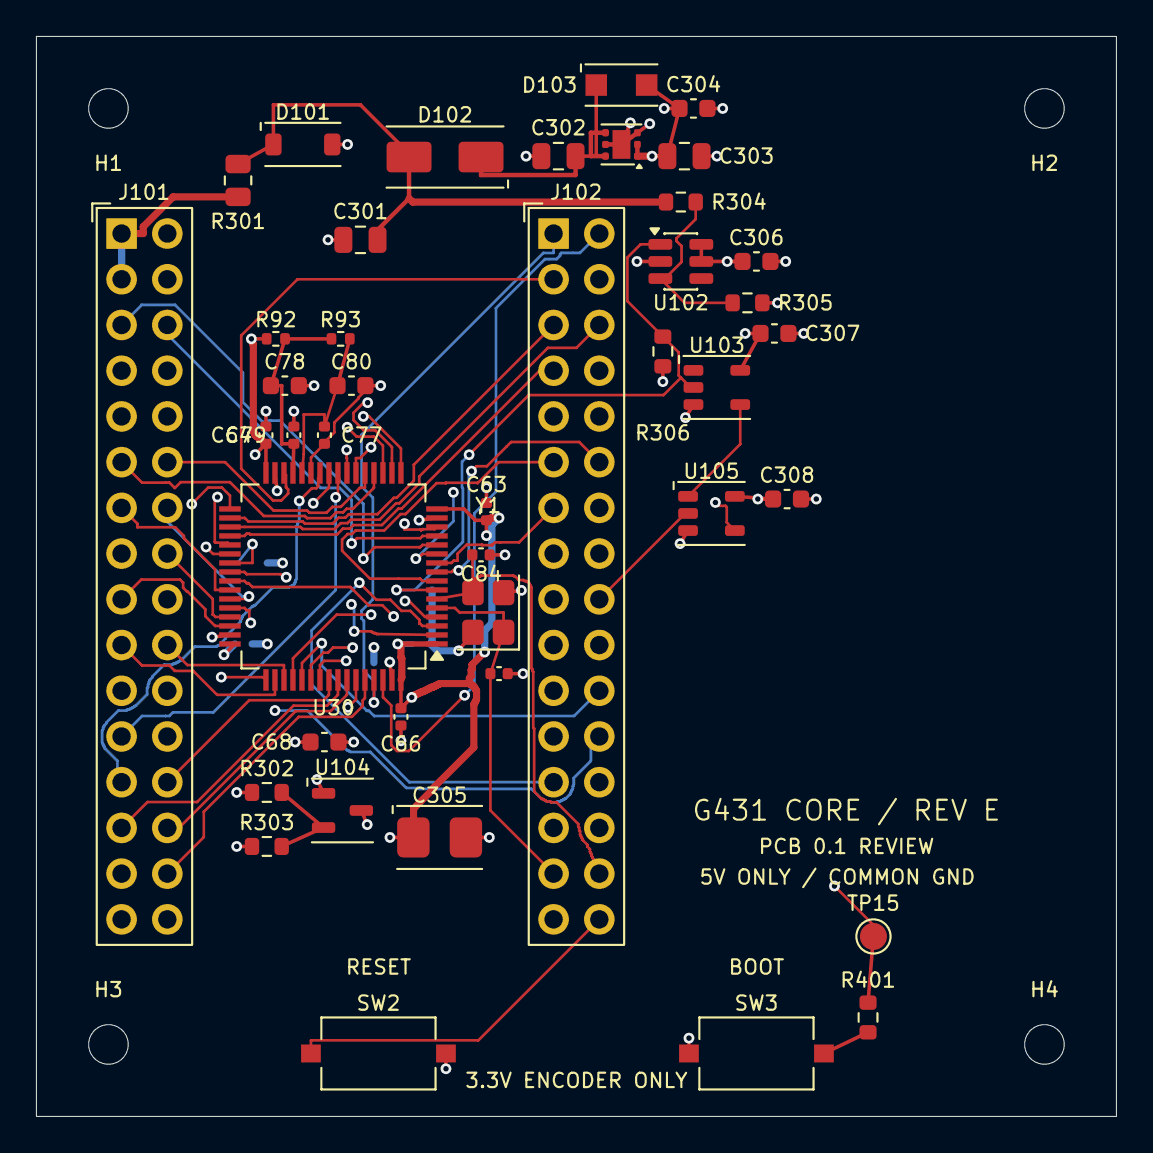
[picture p223: board controller.kicad_pcb from above]

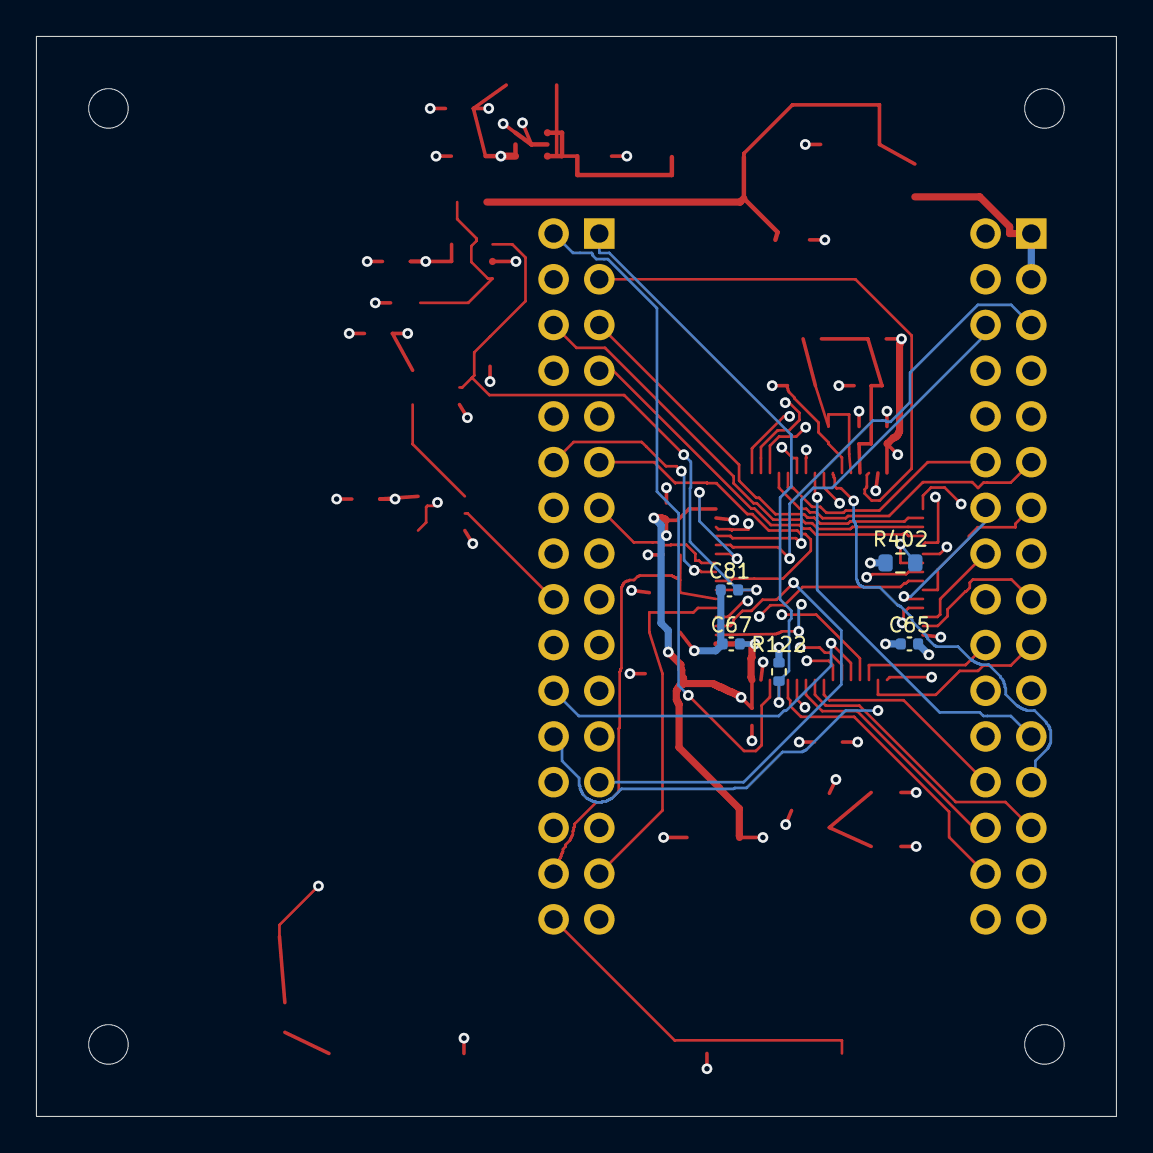
[picture p224: board controller.kicad_pcb from below]

Board: 4 copper layers, 60.0 x 60.0 mm, 51 parts (5 on the bottom side), 64 nets.

Parts:
C63, C64, C65, C66, C67, C77, C79, C81: 100n; C_0402_1005Metric
C68: 4.7u; C_0603_1608Metric
C78, C80: 1u; C_0603_1608Metric
C83, C84: 18p / provisional; C_0402_1005Metric
C301, C302, C303: 4.7u; C_0805_2012Metric
C304, C306, C307, C308: 100n; C_0603_1608Metric
C305: 47u 10% 10V; KEMET_T491_B_3528_Pad1.80x2.23mm_Gap1.12mm
D101: SMF6.0A-TP; MCC_SOD-123FL_Pad0.91x1.22mm_Gap2.36mm
D102: S1A-13-F; Diodes_SMA_Pad2.50x1.70mm_P4.00mm
D103: PMEG2010ER,115; Nexperia_CFP3_SOD123W_Reflow
H1, H2, H3, H4: M2 NPTH 2.2mm; MountingHole_2.2mm_M2
J101, J102: PZ254V-12-32P; XFCN_PZ254V-12-32P_2x16_P2.54mm_Vertical_Drill1.02mm
R92, R93: 0; R_0402_1005Metric
R122: 10k; R_0402_1005Metric
R301: 0.47; R_0805_2012Metric
R302: 3.83k 0.1%; R_0603_1608Metric
R303: 10k 0.1%; R_0603_1608Metric
R304, R401: 1k; R_0603_1608Metric
R305: 1.1k; R_0603_1608Metric
R306, R402: 10k; R_0603_1608Metric
SW2: MCU_RESET; XKB_TS-1101-C-W_6.05x3.70mm_Pad1.10x1.00mm
SW3: BOOT; XKB_TS-1101-C-W_6.05x3.70mm_Pad1.10x1.00mm
TP15: BOOT0; TestPoint_Pad_D1.5mm
U30: STM32G431RBT6; ST_LQFP-64_10x10mm_P0.5mm_Pad1.2x0.3mm
U101: TLV76733DRVR; WSON-6-1EP_2x2mm_P0.65mm_EP1x1.6mm
U102: TPS3808G33DBVR; SOT-23-6
U103: SN74LVC1G17DBVR; TI_DBV0005A_Pad1.10x0.60mm_P2.60mm
U104: TL431BIDBZR; TI_DBZ0003A_Pad1.30x0.60mm_P2.10mm
U105: SN74LVC1G08DBVR; TI_DBV0005A_Pad1.10x0.60mm_P2.60mm
Y1: 8MHz / CL TBD / DNP; Crystal_SMD_3225-4Pin_3.2x2.5mm

Connections:
+3V3_A_MCU: C77.1, C78.1, R92.2, R93.1, U30.29
+3V3_MCU: C63.1, C64.1, C65.1, C66.1, C67.1, C68.1, C303.1, C304.1, C305.1, C306.1, C307.1, C308.1, D103.2, J101.22, J101.32, R92.1, R302.1, R306.1, SW3.1, U30.1, U30.16, U30.32, U30.48, U30.64, U101.1, U101.2, U102.5, U102.6, U103.5, U104.1, U105.5
+5V_CORE_IN: J101.1, J101.3, R301.1
/Local power and reset/CORE_5V_TVS: C301.1, D101.1, D102.2, R301.2, R304.1
/Local power and reset/CORE_LDO_IN: C302.1, D102.1, D103.1, U101.4, U101.6
/Local power and reset/CORE_MR_5V_PRESENT: R304.2, R305.1, U102.3
/Local power and reset/CORE_SHUNT_REF: R302.2, R303.1, U104.2
CORE_RESET_OK: U103.4, U105.1
CTRL_READY: J102.10, U105.4
GND: C63.2, C64.2, C65.2, C66.2, C67.2, C68.2, C77.2, C78.2, C79.2, C80.2, C81.2, C83.2, C84.2, C301.2, C302.2, C303.2, C304.2, C305.2, C306.2, C307.2, C308.2, D101.2, J101.2, J101.4, J101.21, J101.31, J102.9, J102.27, J102.31, R122.2, R303.2, R305.2, R402.2, SW2.2, U30.15, U30.27, U30.31, U30.47, U30.63, U101.3, U101.5, U101.7, U102.2, U103.3, U104.3, U105.3, Y1.2, Y1.4
HSE_IN: C83.1, J102.29, U30.5, Y1.1
HSE_OUT: C84.1, J102.30, U30.6, Y1.3
NRST: C81.1, J102.32, R306.2, SW2.1, U30.7, U102.1, U103.2
unnamed: R401.1, SW3.2
PA0: J101.5, U30.12
PA1: J101.6, U30.13
PA2: J101.7, U30.14
PA3: J101.8, U30.17
PA4: J101.9, U30.18
PA5: J101.10, U30.19
PA6: J101.11, U30.20
PA7: J101.12, U30.21
PA8: J101.13, U30.42
PA9: J101.14, U30.43
PA10: J101.15, U30.44
PA11: J101.16, U30.45
PA12: J101.17, U30.46
PA13: J101.18, U30.49
PA14: J101.19, U30.50
PA15: J101.20, U30.51
PB0: J101.23, U30.24
PB1: J101.24, U30.25
PB2: J101.25, U30.26
PB3: J101.26, U30.56
PB4: J101.27, U30.57
PB5: J101.28, U30.58
PB6: J101.29, U30.59
PB7: J101.30, U30.60
PB8_BOOT0: J102.1, R122.1, R401.2, TP15.1, U30.61
PB9: J102.2, U30.62
PB10: J102.3, U30.30
PB11: J102.4, U30.33
PB12: J102.5, U30.34
PB13: J102.6, U30.35
PB14: J102.7, U30.36
PB15: J102.8, U30.37
PC0: J102.11, U30.8
PC1: J102.12, U30.9
PC2: J102.13, U30.10
PC3: J102.14, U30.11
PC4: J102.15, U30.22
PC5: J102.16, U30.23
PC6: J102.17, U30.38
PC7: J102.18, R402.1, U30.39, U105.2
PC8: J102.19, U30.40
PC9: J102.20, U30.41
PC10: J102.21, U30.52
PC11: J102.22, U30.53
PC12: J102.23, U30.54
PC13: J102.24, U30.2
PC14: J102.25, U30.3
PC15: J102.26, U30.4
PD2: J102.28, U30.55
VREF_MCU: C79.1, C80.1, R93.2, U30.28
