leolei2012/power_system/inverter/history/integrated_rev_c_60x60/inverter.kicad_pcb

## KiCad design inverter/history/integrated_rev_c_60x60/inverter.kicad_pcb (2026-11-11)

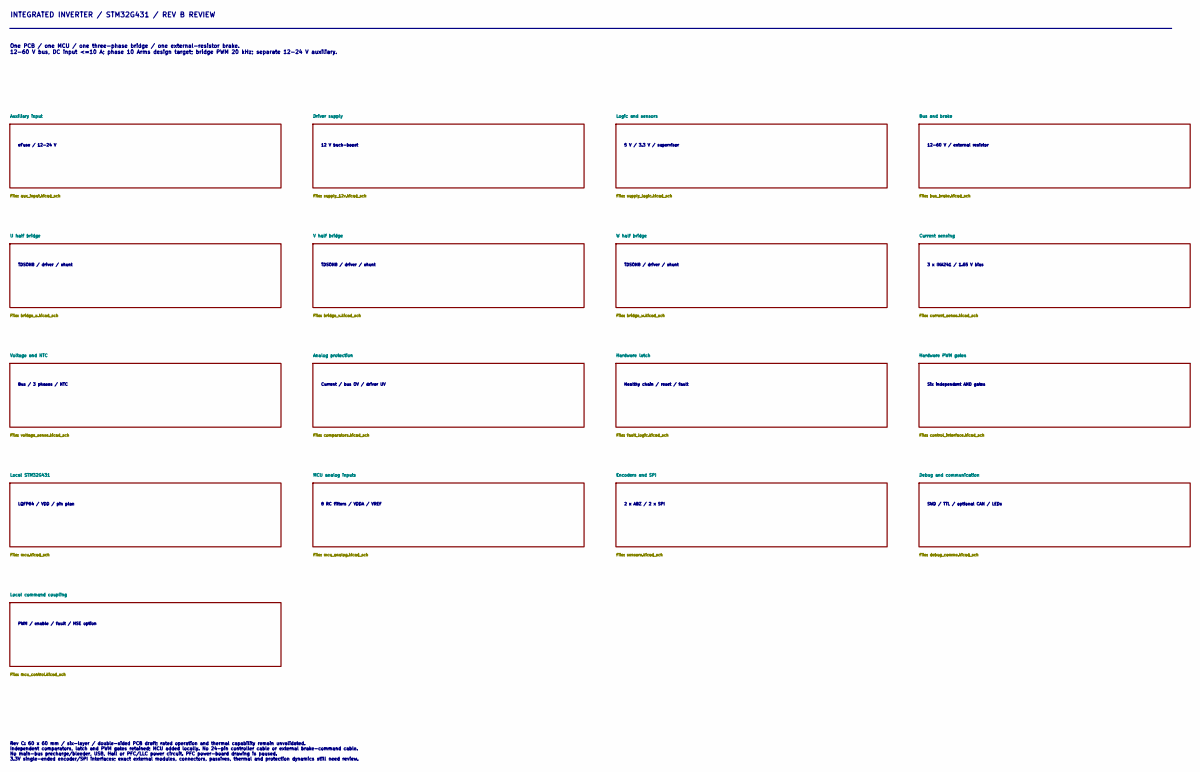
[picture p225: schematic inverter.kicad_sch, Inverter - integrated STM32G431 review draft]

Notes on the sheet:
INTEGRATED INVERTER / STM32G431 / REV B REVIEW
One PCB / one MCU / one three-phase bridge / one external-resistor brake. 12-60 V bus, DC input <=10 A; phase 10 Arms design target; bridge PWM 20 kHz; separate 12-24 V auxiliary.
eFuse / 12-24 V
12 V buck-boost
5 V / 3.3 V / supervisor
12-60 V / external resistor
TDSON8 / driver / shunt
3 x INA241 / 1.65 V bias
Bus / 3 phases / NTC
Current / bus OV / driver UV
Healthy chain / reset / fault
Six independent AND gates
LQFP64 / VDD / pin plan
8 RC filters / VDDA / VREF
2 x ABZ / 2 x SPI
SWD / TTL / optional CAN / LEDs
PWM / enable / fault / HSE option
Rev C: 60 x 60 mm / six-layer / double-sided PCB draft; rated operation and thermal capability remain unvalidated. Independent comparators, latch and PWM gates retained; MCU added locally. No 24-pin controller cable or external brake-command cable. No main-bus precharge/bleeder, USB, Hall or PFC/LL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

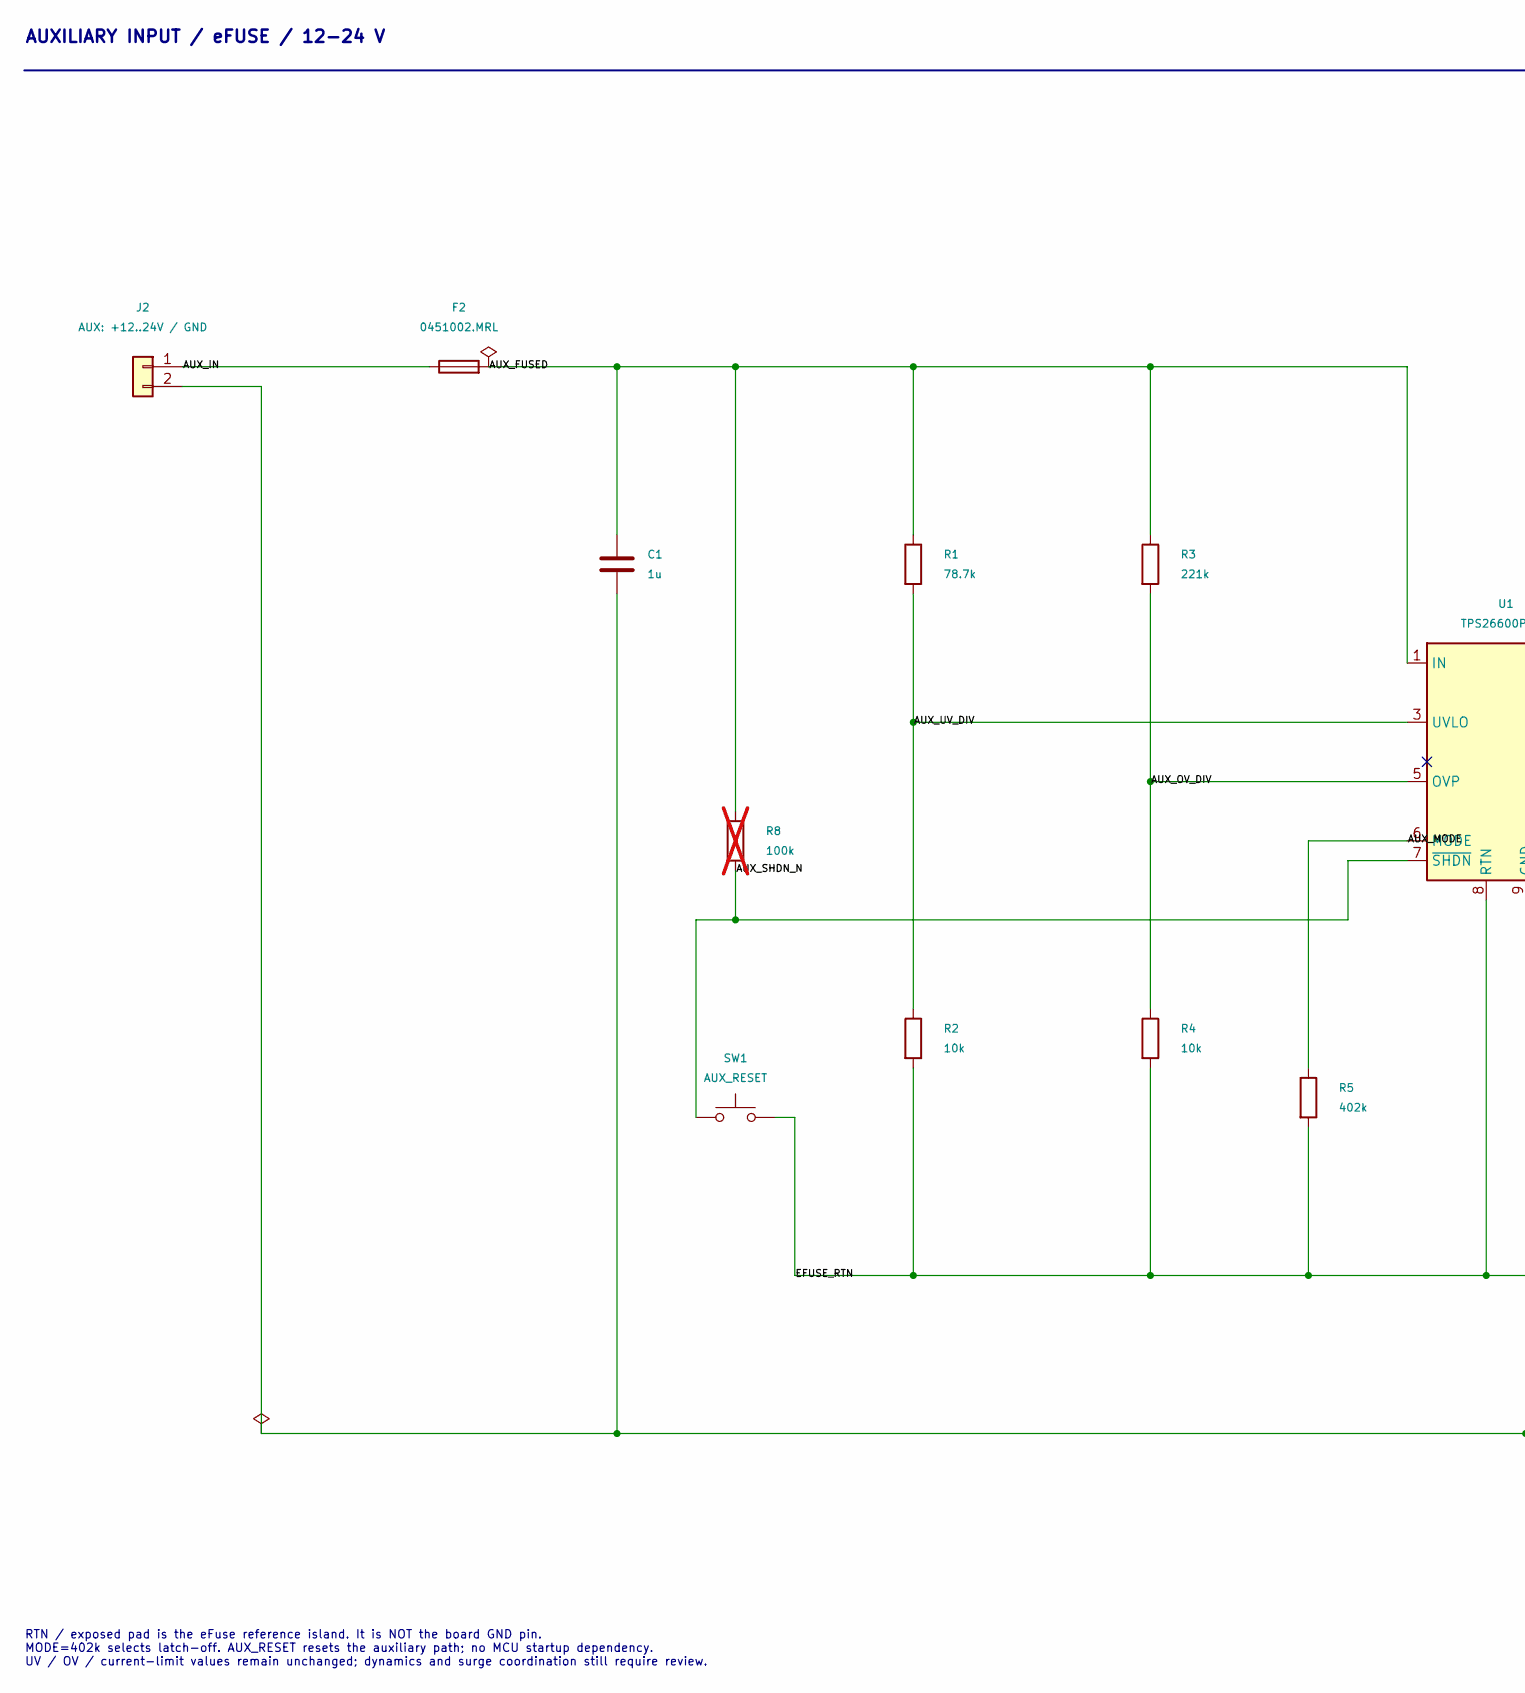
[picture p226: schematic aux_input.kicad_sch, Inverter - 12-24 V auxiliary input protection, part in row 1, column 1]

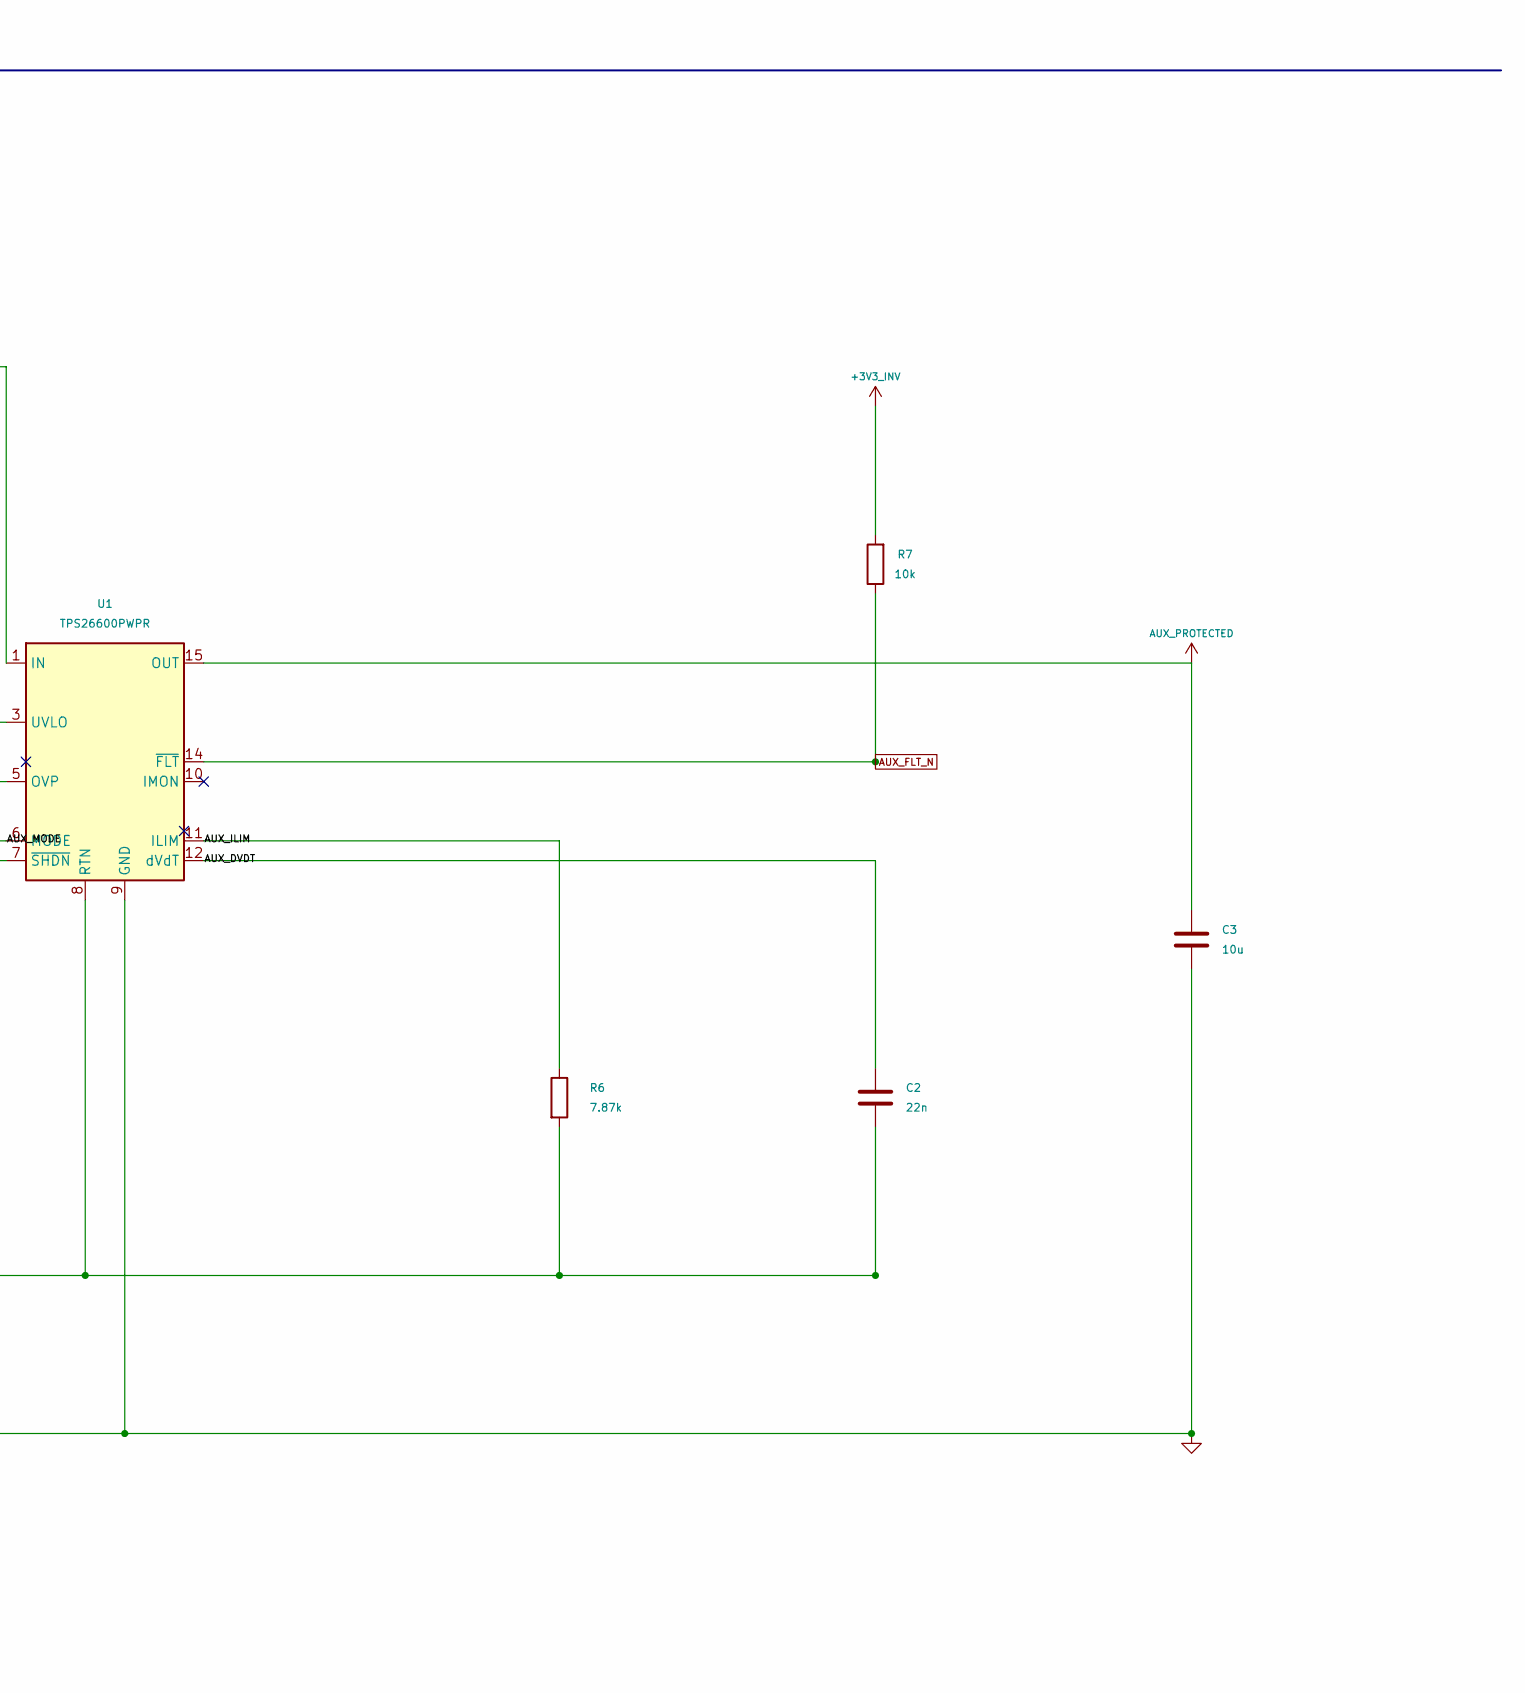
[picture p227: schematic aux_input.kicad_sch, Inverter - 12-24 V auxiliary input protection, part in row 1, column 2]

Parts:
C1: 1u; C_0805_2012Metric; Voltage_Rating 100V; MPN TBD
C2: 22n; C_0603_1608Metric; Voltage_Rating 25V; MPN TBD
C3: 10u; C_1206_3216Metric; Voltage_Rating 50V; MPN TBD
F2: 0451002.MRL; Fuse_Littelfuse-NANO2-451_453; MPN 0451002.MRL
J2: AUX: +12..24V / GND; JST_PH_B2B-PH-K_1x02_P2.00mm_Vertical; MPN B2B-PH-K-S(LF)(SN)
R1: 78.7k; R_0603_1608Metric; Tolerance 0.1%; MPN TBD
R2, R4: 10k; R_0603_1608Metric; Tolerance 0.1%; MPN TBD
R3: 221k; R_0603_1608Metric; Tolerance 0.1%; MPN TBD
R5: 402k; R_0603_1608Metric; Tolerance 1%; MPN TBD
R6: 7.87k; R_0603_1608Metric; Tolerance 1%; MPN TBD
R7: 10k; R_0603_1608Metric; Tolerance 1%; MPN TBD
R8: 100k; R_0603_1608Metric; Tolerance 1%; MPN TBD; not fitted
SW1: AUX_RESET; SW_SPST_TS-1088-xR020; MPN TS-1088-AR02016
U1: TPS26600PWPR; HTSSOP-16-1EP_4.4x5mm_P0.65mm_EP3.4x5mm_Mask2.66x2.46mm; MPN TPS26600PWPR

Connections:
+3V3_INV: R7.2; also elsewhere on the board
/Auxiliary input/AUX_DVDT: C2.1, U1.12 (dVdT)
/Auxiliary input/AUX_FUSED: C1.1, F2.2, R1.1, R3.1, R8.1, U1.1 (IN), U1.2 (IN)
/Auxiliary input/AUX_ILIM: R6.1, U1.11 (ILIM)
/Auxiliary input/AUX_IN: F2.1, J2.1
/Auxiliary input/AUX_MODE: R5.1, U1.6 (MODE)
/Auxiliary input/AUX_OV_DIV: R3.2, R4.1, U1.5 (OVP)
/Auxiliary input/AUX_SHDN_N: R8.2, SW1.1, U1.7 (~SHDN)
/Auxiliary input/AUX_UV_DIV: R1.2, R2.1, U1.3 (UVLO)
/Auxiliary input/EFUSE_RTN: C2.2, R2.2, R4.2, R5.2, R6.2, SW1.2, U1.8 (RTN), U1.17 (RTN)
AUX_FLT_N: R7.1, U1.14 (~FLT); also elsewhere on the board
AUX_PROTECTED: C3.1, U1.15 (OUT), U1.16 (OUT); also elsewhere on the board

Notes on the sheet:
AUXILIARY INPUT / eFUSE / 12-24 V
RTN / exposed pad is the eFuse reference island. It is NOT the board GND pin. MODE=402k selects latch-off. AUX_RESET resets the auxiliary path; no MCU startup dependency. UV / OV / current-limit values remain unchanged; dynamics and surge coordination still require review.

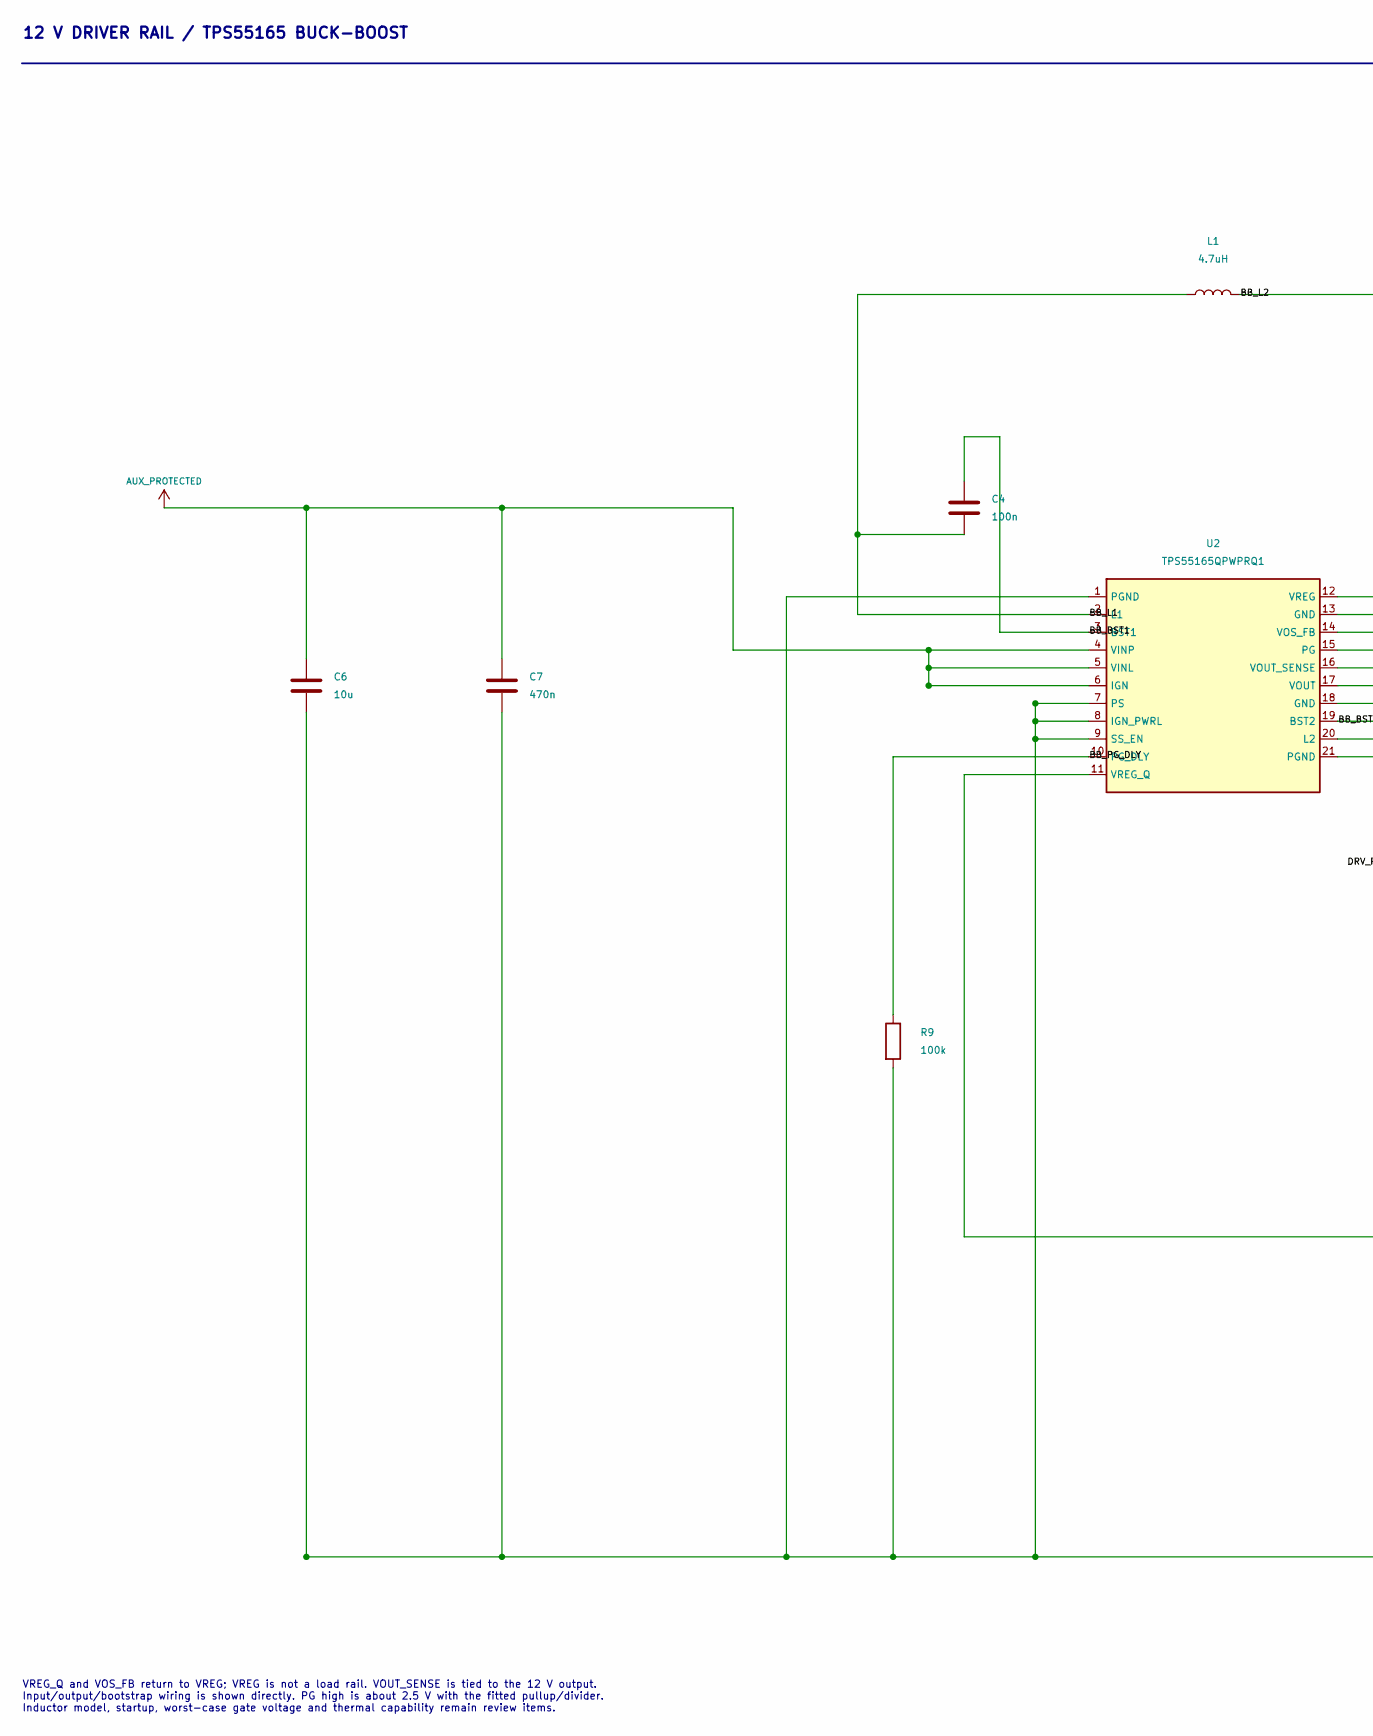
[picture p228: schematic supply_12v.kicad_sch, Inverter - regulated 12 V driver supply, part in row 1, column 1]

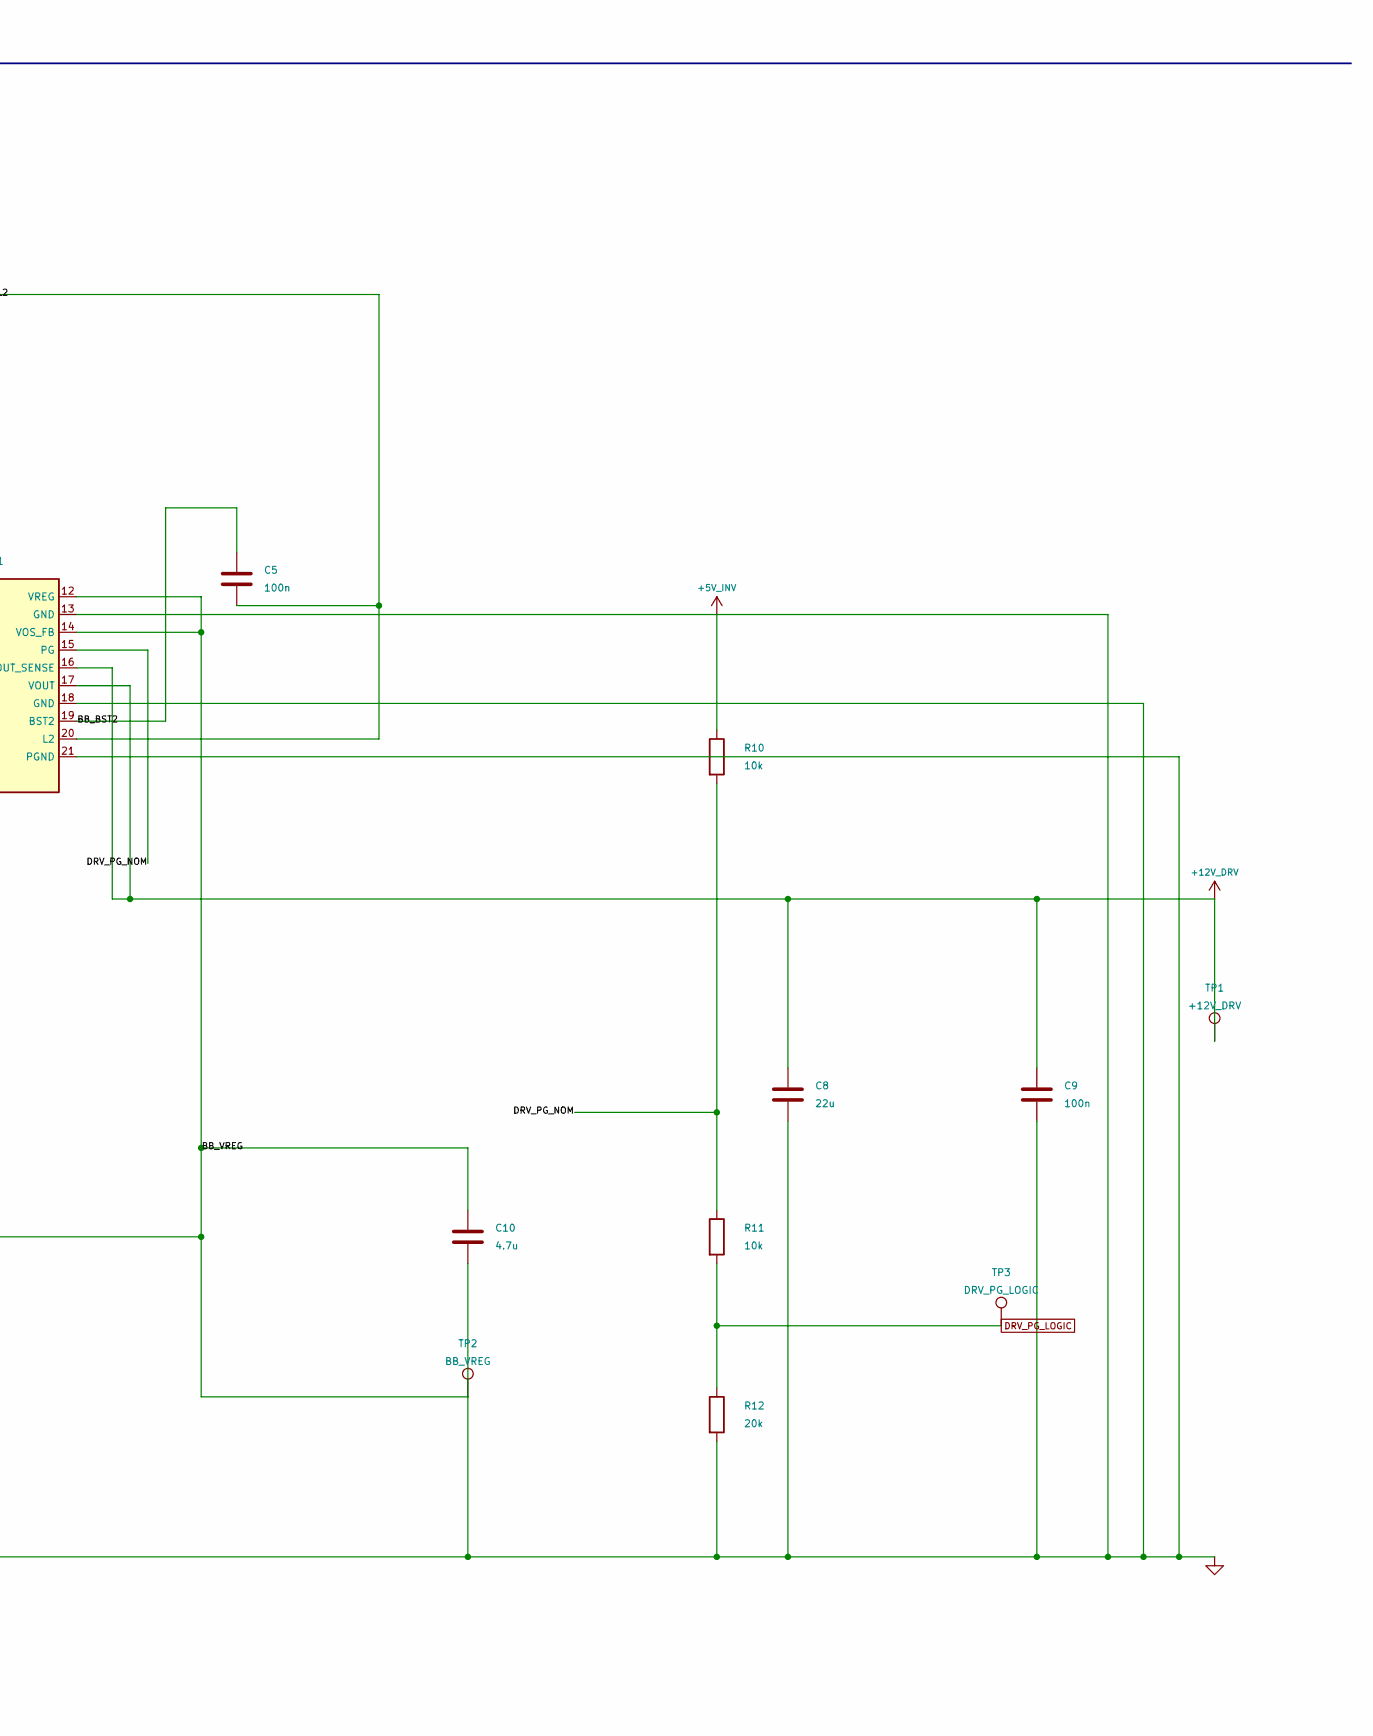
[picture p229: schematic supply_12v.kicad_sch, Inverter - regulated 12 V driver supply, part in row 1, column 2]

Parts:
C4, C5, C9: 100n; C_0603_1608Metric; Voltage_Rating 25V; MPN TBD
C6: 10u; C_1206_3216Metric; Voltage_Rating 50V; MPN TBD
C7: 470n; C_0805_2012Metric; Voltage_Rating 50V; MPN TBD
C8: 22u; C_1210_3225Metric; Voltage_Rating 25V; MPN TBD
C10: 4.7u; C_0805_2012Metric; Voltage_Rating 10V; MPN TBD
L1: 4.7uH; L_Sunlord_MWSA0603S; MPN MWSA0603S-4R7MT
R9: 100k; R_0603_1608Metric; Tolerance 1%; MPN TBD
R10, R11: 10k; R_0603_1608Metric; Tolerance 1%; MPN TBD
R12: 20k; R_0603_1608Metric; Tolerance 1%; MPN TBD
TP1: +12V_DRV; TestPoint_Pad_D1.5mm
TP2: BB_VREG; TestPoint_Pad_D1.5mm
TP3: DRV_PG_LOGIC; TestPoint_Pad_D1.5mm
U2: TPS55165QPWPRQ1; TI_PWP0020W_HTSSOP-20_4.4x6.5mm_P0.65mm_EP2.79x3.64mm; MPN TPS55165QPWPRQ1

Connections:
+12V_DRV: C8.1, C9.1, TP1.1, U2.16 (VOUT_SENSE), U2.17 (VOUT); also elsewhere on the board
/Driver supply/BB_BST1: C4.1, U2.3 (BST1)
/Driver supply/BB_BST2: C5.1, U2.19 (BST2)
/Driver supply/BB_L1: C4.2, L1.1, U2.2 (L1)
/Driver supply/BB_L2: C5.2, L1.2, U2.20 (L2)
/Driver supply/BB_PG_DLY: R9.1, U2.10 (PG_DLY)
/Driver supply/BB_VREG: C10.1, TP2.1, U2.11 (VREG_Q), U2.12 (VREG), U2.14 (VOS_FB)
/Driver supply/DRV_PG_NOM: R10.2, R11.1, U2.15 (PG)
AUX_PROTECTED: C6.1, C7.1, U2.4 (VINP), U2.5 (VINL), U2.6 (IGN); also elsewhere on the board
DRV_PG_LOGIC: R11.2, R12.1, TP3.1; also elsewhere on the board

Notes on the sheet:
12 V DRIVER RAIL / TPS55165 BUCK-BOOST
VREG_Q and VOS_FB return to VREG; VREG is not a load rail. VOUT_SENSE is tied to the 12 V output. Input/output/bootstrap wiring is shown directly. PG high is about 2.5 V with the fitted pullup/divider. Inductor model, startup, worst-case gate voltage and thermal capability remain review items.
