leolei2012/power_system/inverter/hardware/review/compact_fine_smoke/inverter.kicad_pcb

## KiCad design inverter/history/integrated_rev_c_60x60/inverter.kicad_pcb (continued)

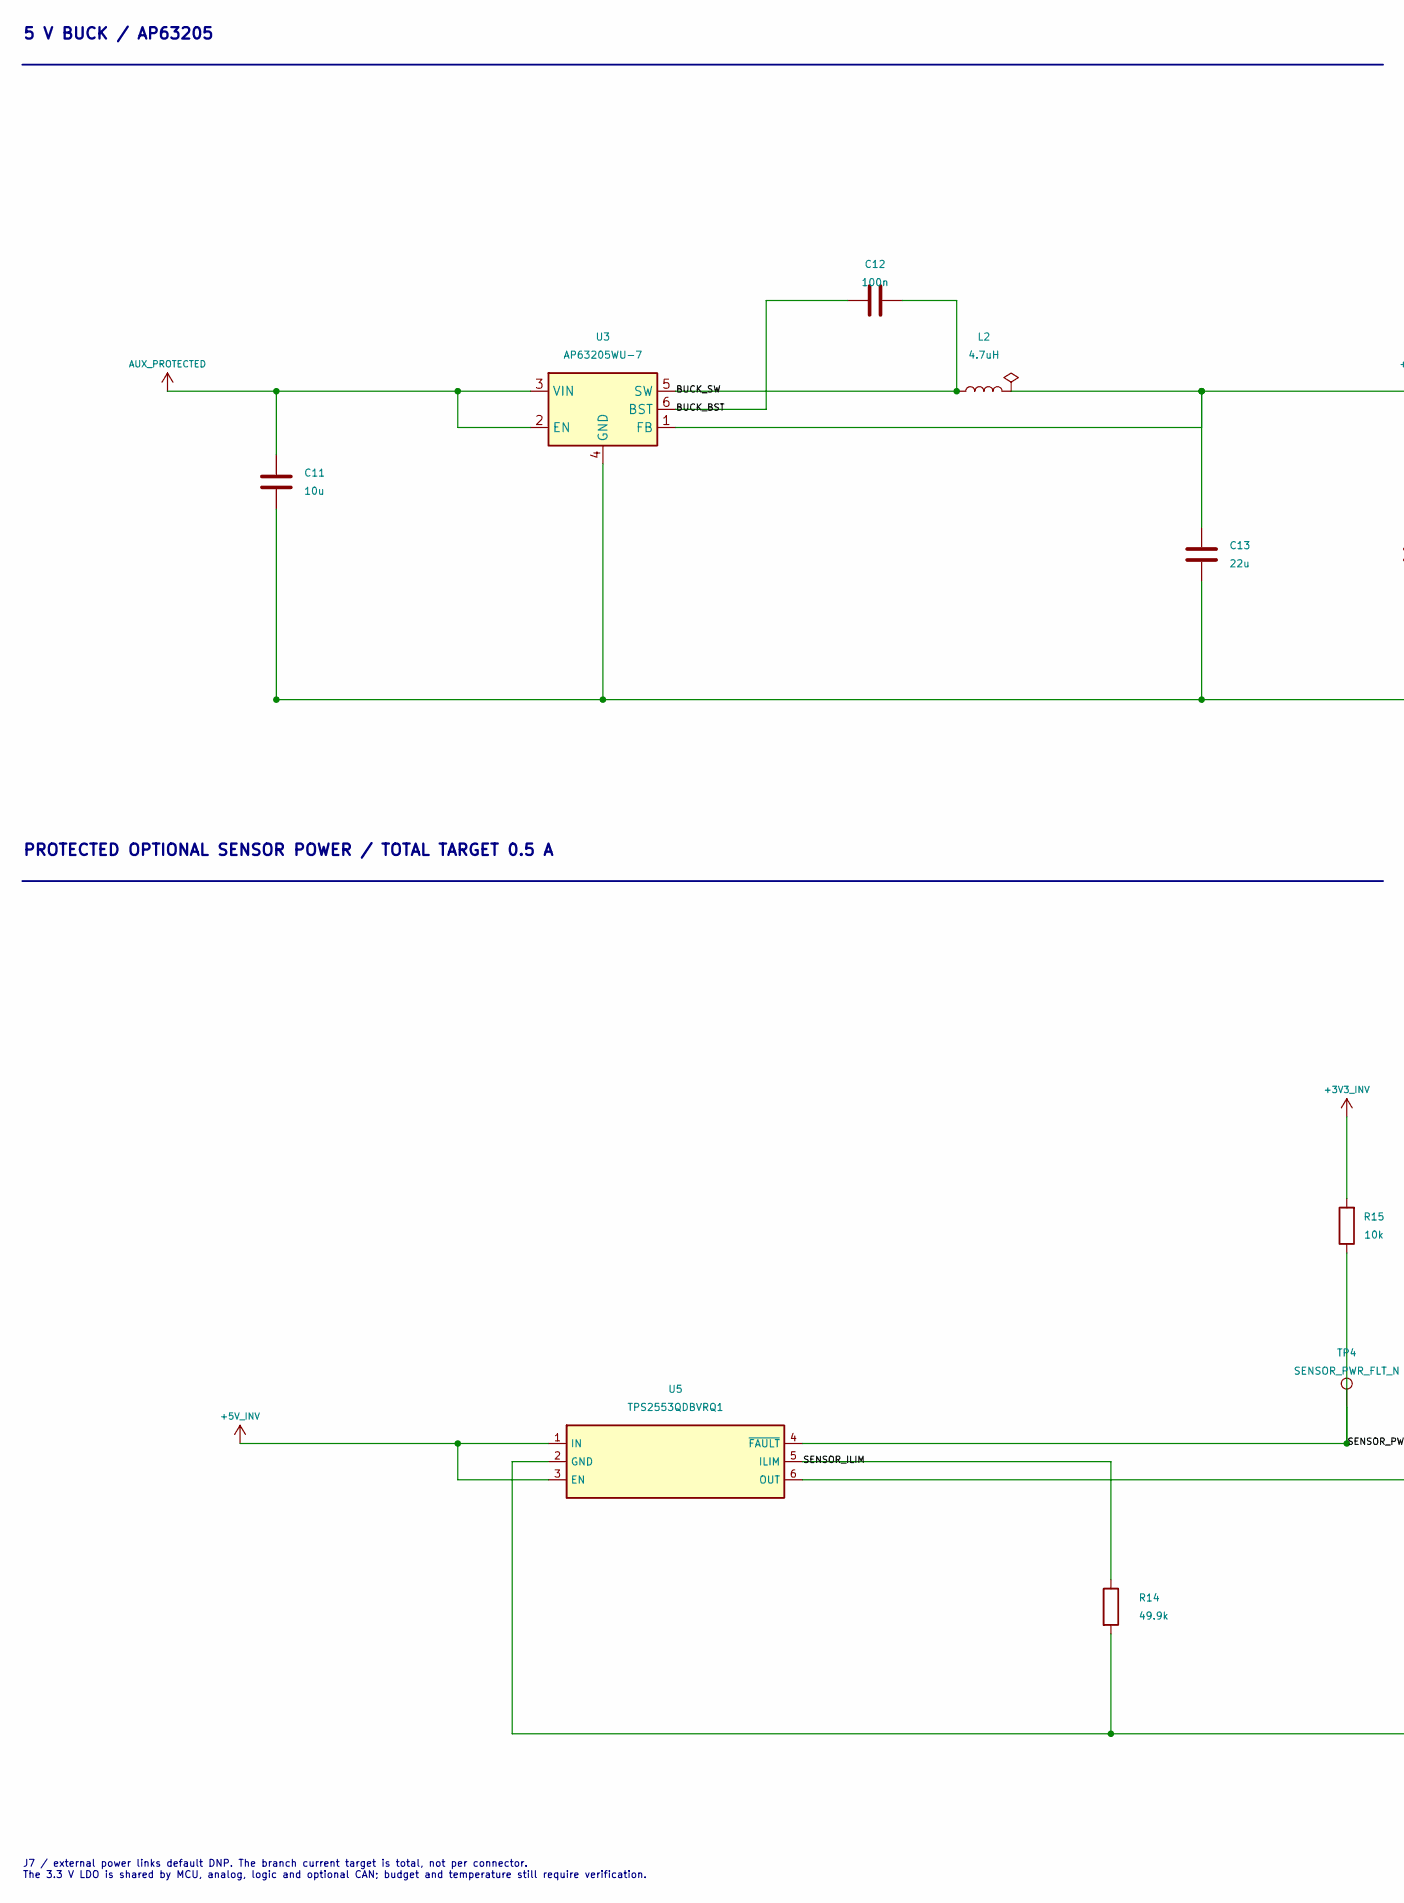
[picture p230: schematic supply_logic.kicad_sch, Inverter - 5 V, 3.3 V and sensor power, part in row 1, column 1]

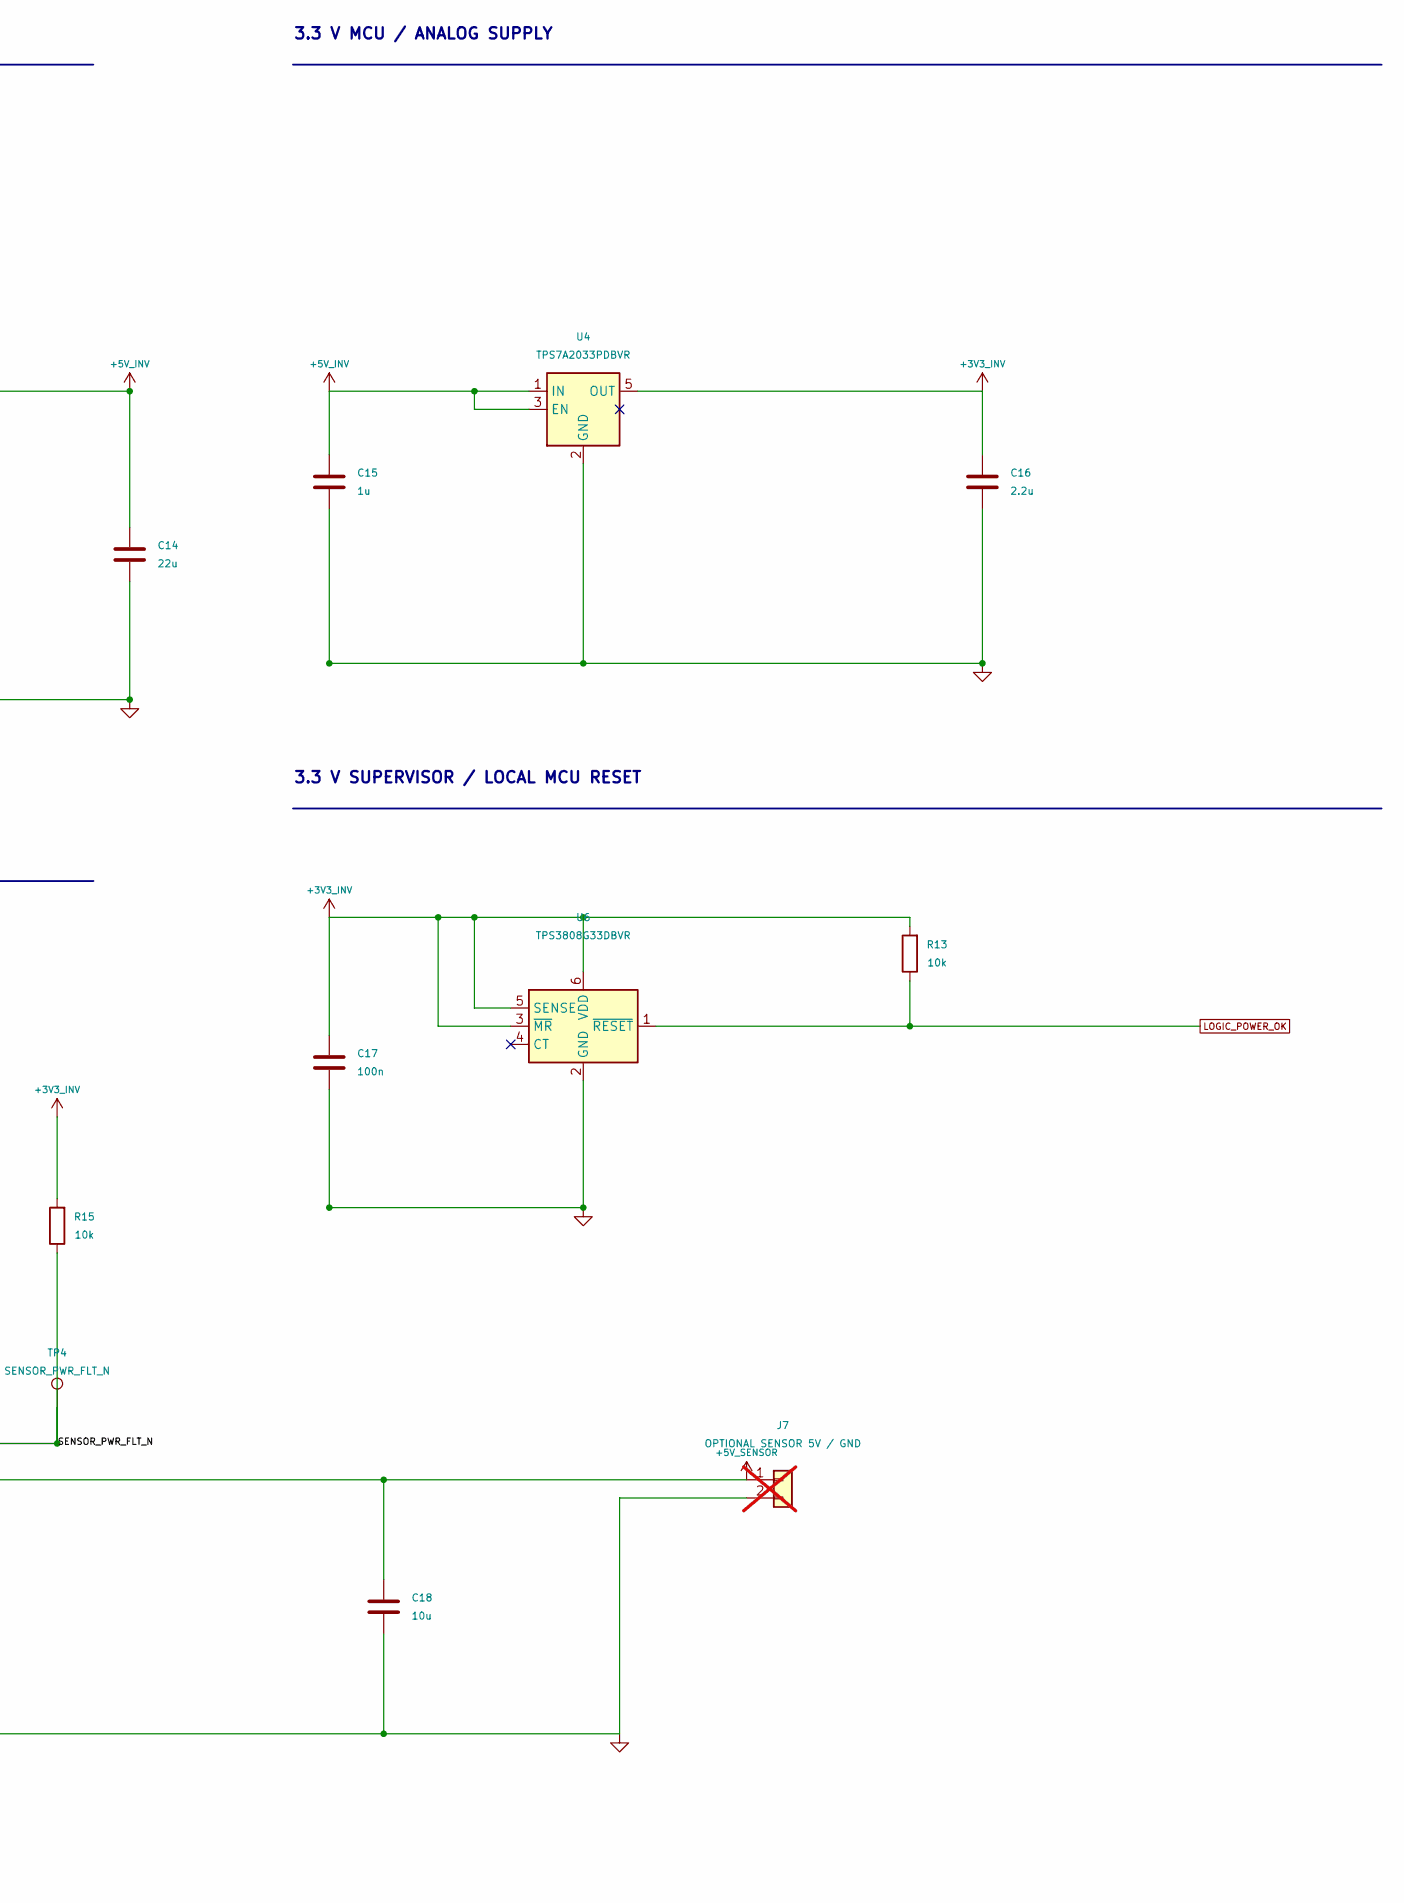
[picture p231: schematic supply_logic.kicad_sch, Inverter - 5 V, 3.3 V and sensor power, part in row 1, column 2]

Parts:
C11: 10u; C_1206_3216Metric; Voltage_Rating 50V; MPN TBD
C12: 100n; C_0603_1608Metric; Voltage_Rating 25V; MPN TBD
C13, C14: 22u; C_1206_3216Metric; Voltage_Rating 16V; MPN TBD
C15: 1u; C_0603_1608Metric; Voltage_Rating 25V; MPN TBD
C16: 2.2u; C_0603_1608Metric; Voltage_Rating 25V; MPN TBD
C17: 100n; C_0402_1005Metric; Voltage_Rating 25V; MPN TBD
C18: 10u; C_0805_2012Metric; Voltage_Rating 16V; MPN TBD
J7: OPTIONAL SENSOR 5V / GND; PinHeader_HCTL_PZ127_1x02_P1.27mm_D0.70mm; MPN PZ127-1-02-Z; not fitted
L2: 4.7uH; L_Sunlord_MWSA0603S; MPN MWSA0603S-4R7MT
R13: 10k; R_0402_1005Metric; Tolerance 1%; MPN TBD
R14: 49.9k; R_0603_1608Metric; Tolerance 1%; MPN TBD
R15: 10k; R_0603_1608Metric; Tolerance 1%; MPN TBD
TP4: SENSOR_PWR_FLT_N; TestPoint_Pad_D1.5mm
U3: AP63205WU-7; TSOT-23-6; MPN AP63205WU-7
U4: TPS7A2033PDBVR; SOT-23-5; MPN TPS7A2033PDBVR
U5: TPS2553QDBVRQ1; SOT-23-6; MPN TPS2553QDBVRQ1
U6: TPS3808G33DBVR; SOT-23-6; MPN TPS3808G33DBVR

Connections:
+3V3_INV: C16.1, C17.1, R13.2, R15.2, U4.5 (OUT), U6.3 (~MR), U6.5 (SENSE), U6.6 (VDD); also elsewhere on the board
+5V_SENSOR: C18.1, J7.1, U5.6 (OUT); also elsewhere on the board
/Logic and sensors/BUCK_BST: C12.1, U3.6 (BST)
/Logic and sensors/BUCK_SW: C12.2, L2.1, U3.5 (SW)
/Logic and sensors/SENSOR_ILIM: R14.1, U5.5 (ILIM)
/Logic and sensors/SENSOR_PWR_FLT_N: R15.1, TP4.1, U5.4 (~FAULT)
AUX_PROTECTED: C11.1, U3.2 (EN), U3.3 (VIN); also elsewhere on the board
LOGIC_POWER_OK: R13.1, U6.1 (~RESET); also elsewhere on the board

Notes on the sheet:
5 V BUCK / AP63205
3.3 V MCU / ANALOG SUPPLY
3.3 V SUPERVISOR / LOCAL MCU RESET
PROTECTED OPTIONAL SENSOR POWER / TOTAL TARGET 0.5 A
J7 / external power links default DNP. The branch current target is total, not per connector. The 3.3 V LDO is shared by MCU, analog, logic and optional CAN; budget and temperature still require verification.

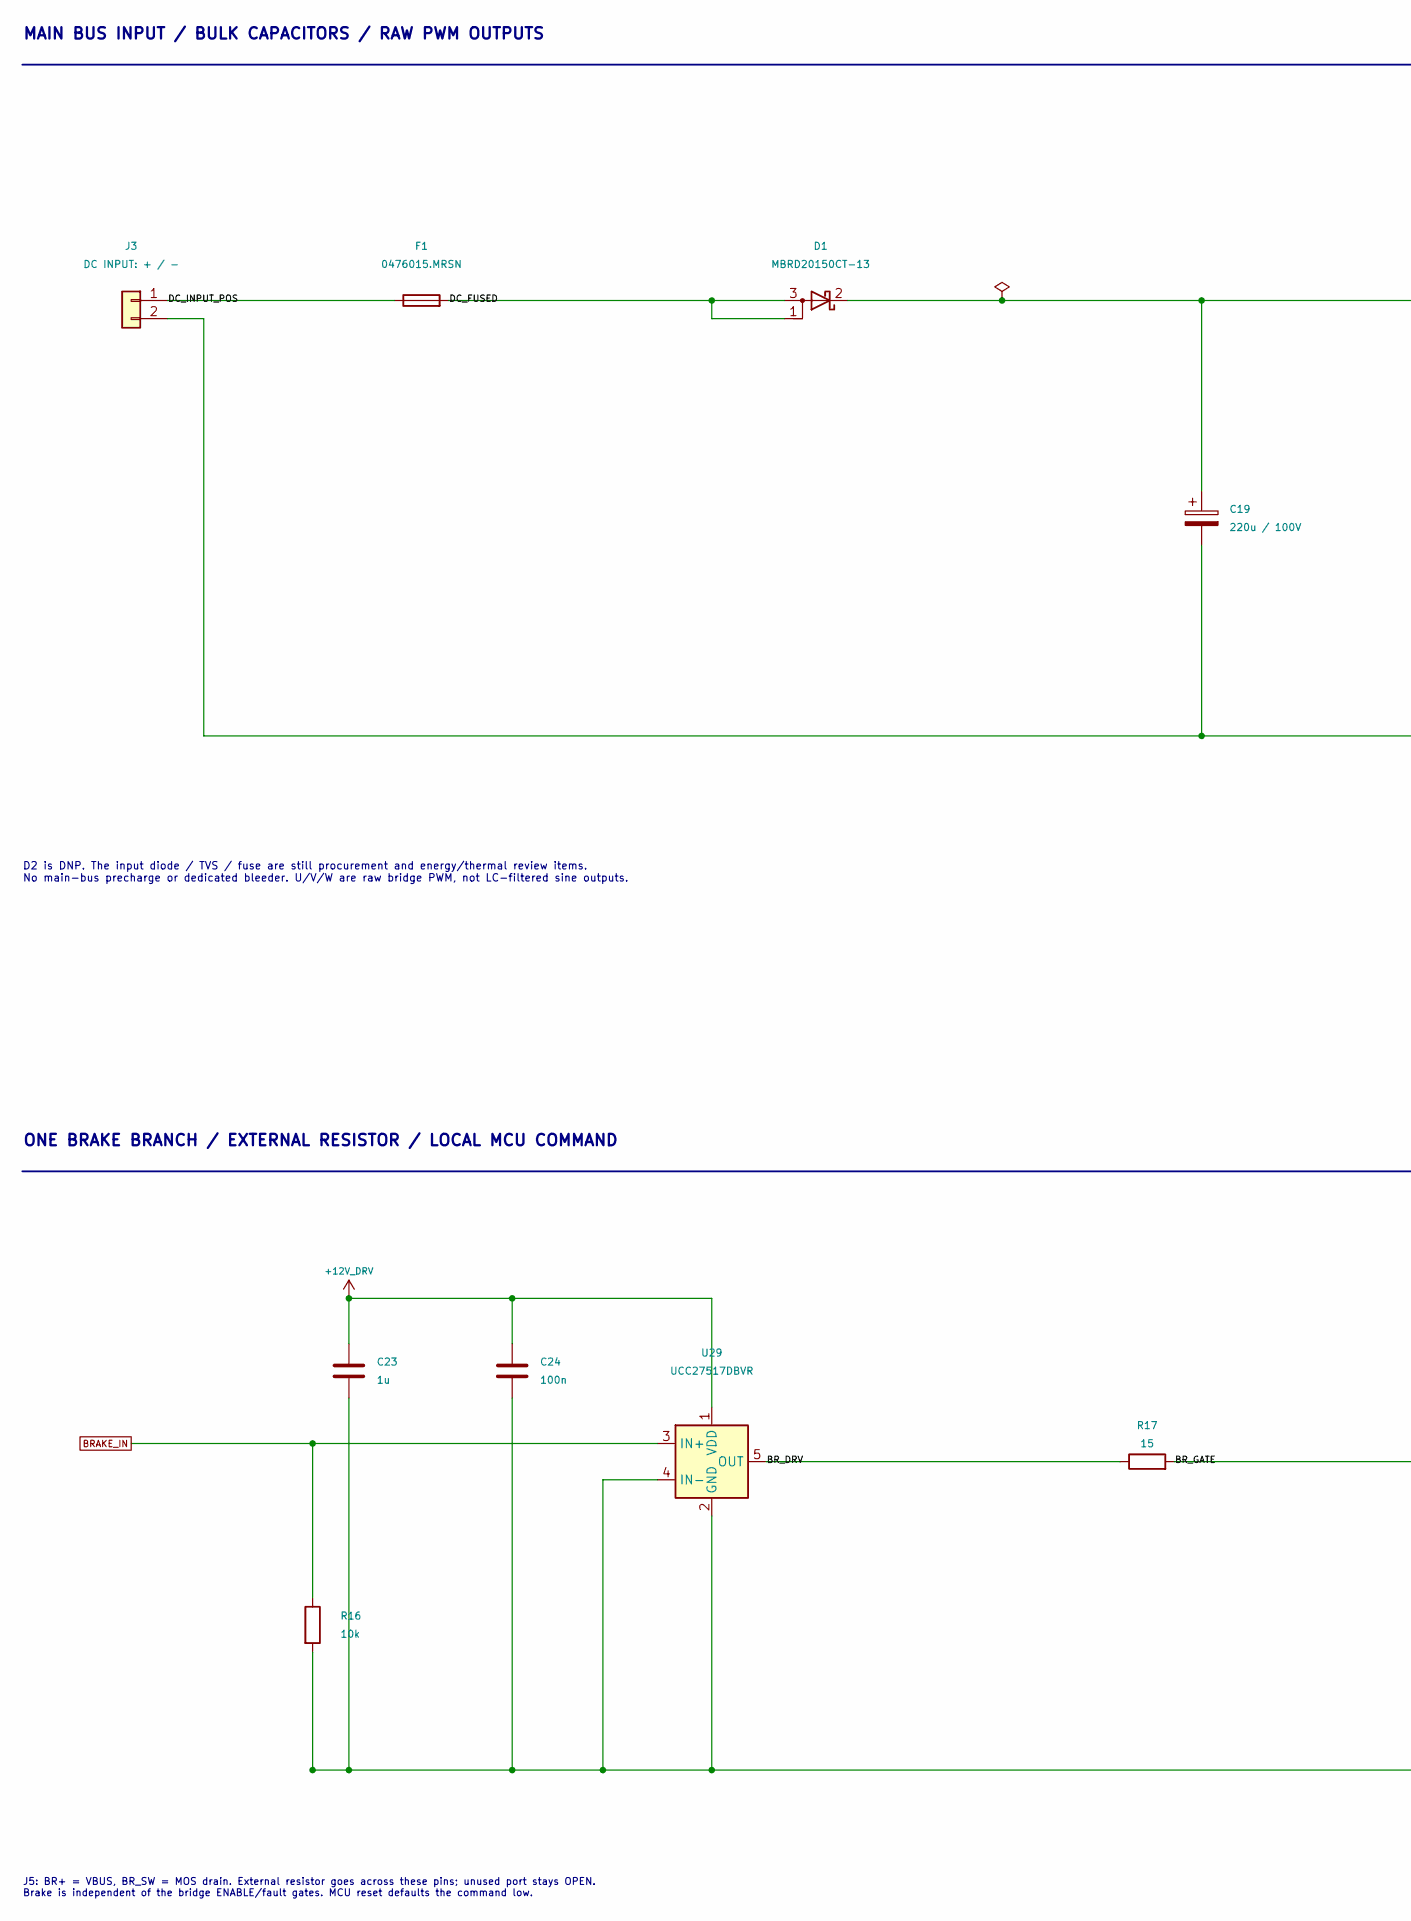
[picture p232: schematic bus_brake.kicad_sch, Inverter - DC bus input, bulk capacitors and brake, part in row 1, column 1]

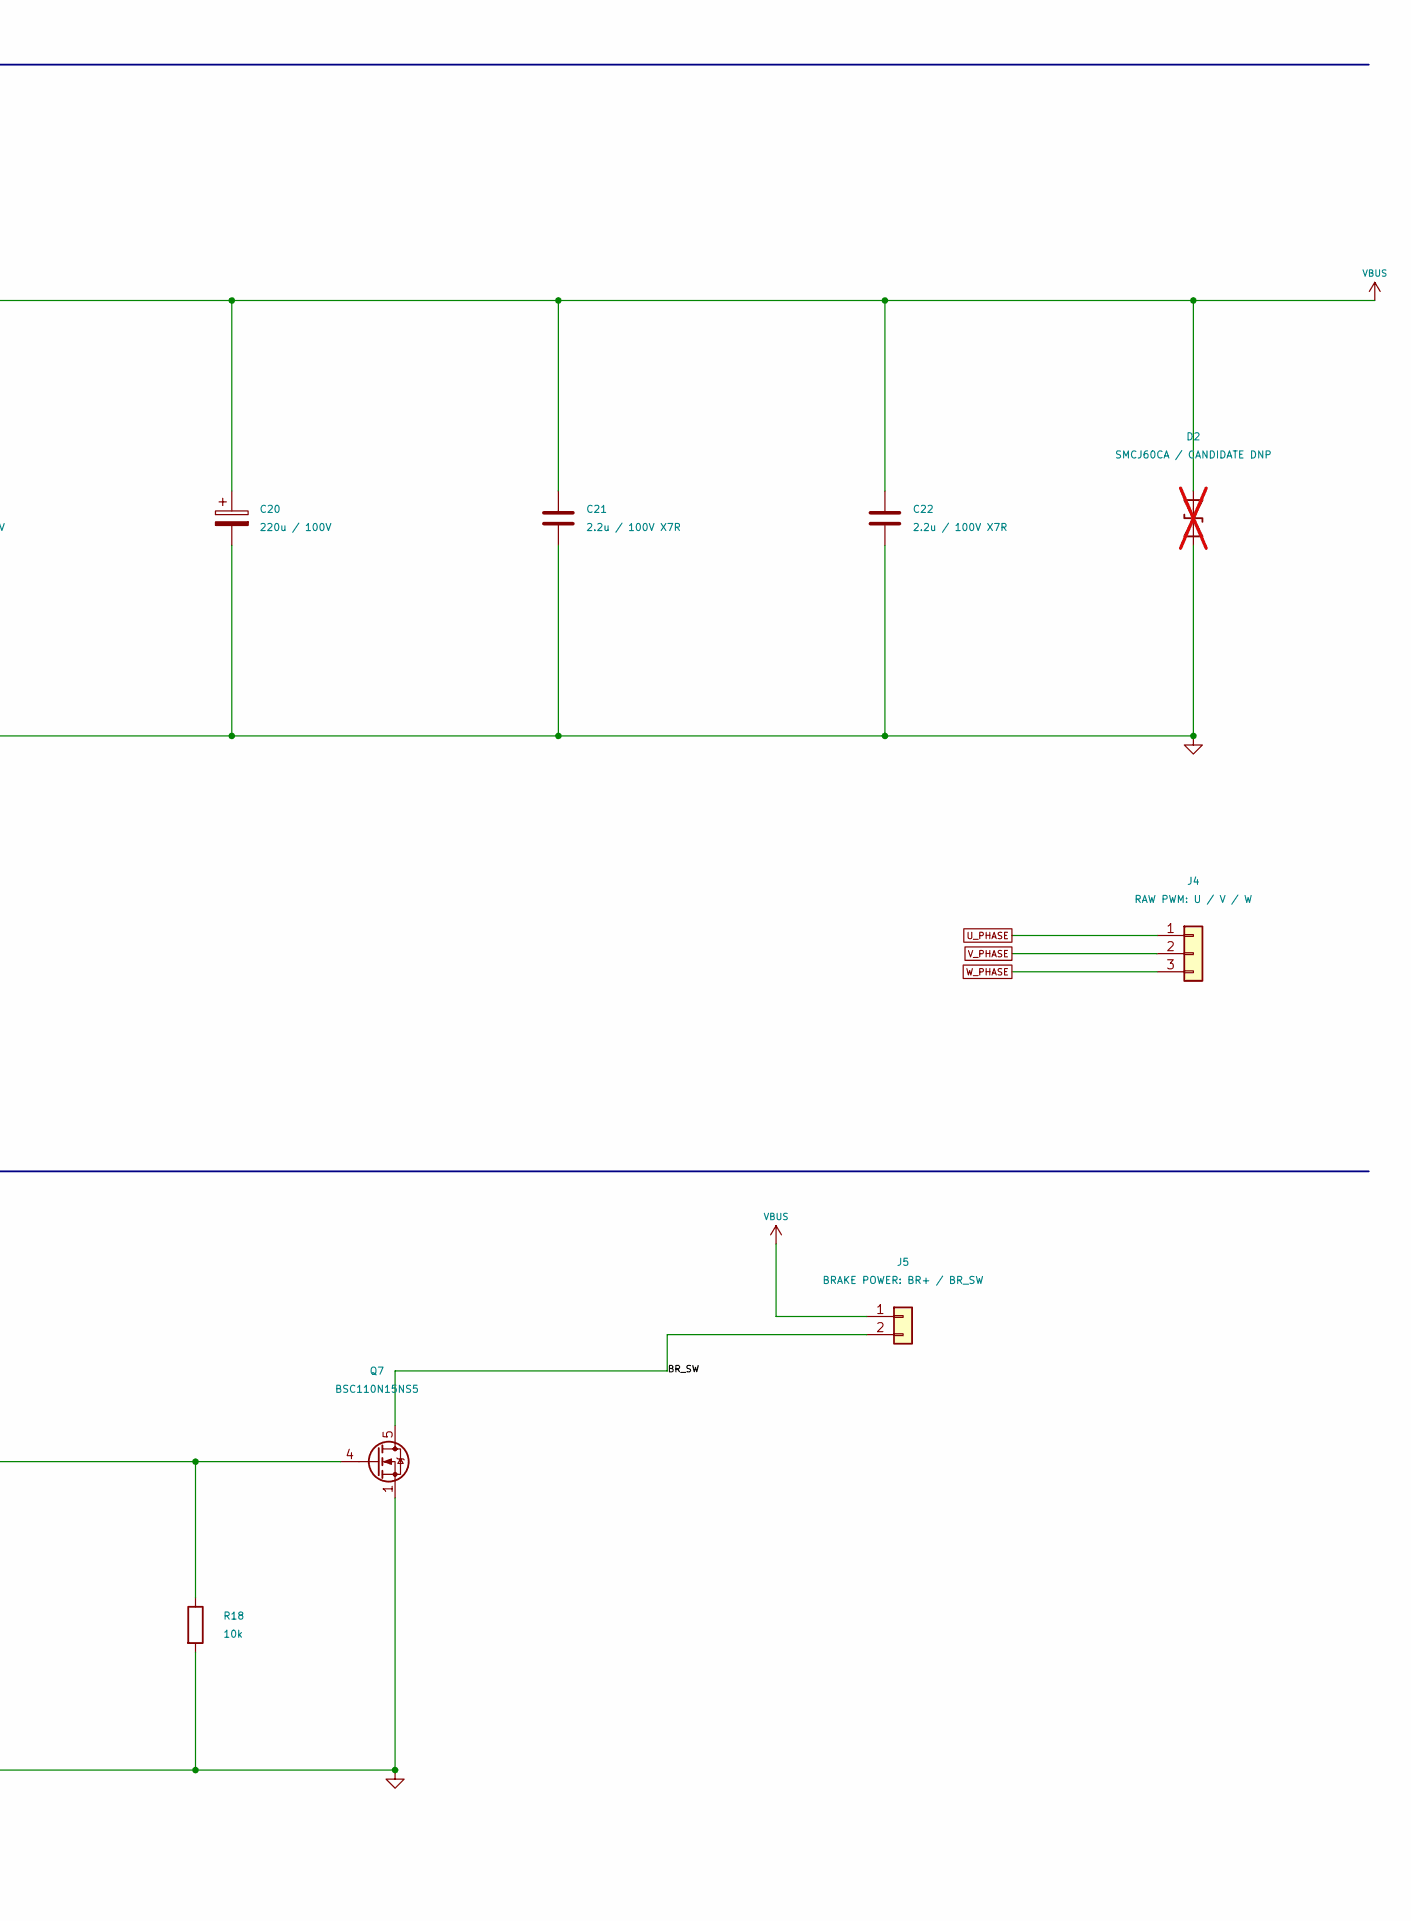
[picture p233: schematic bus_brake.kicad_sch, Inverter - DC bus input, bulk capacitors and brake, part in row 1, column 2]

Parts:
C19, C20: 220u / 100V; CP_Radial_D12.5mm_H25mm_P5.00mm; Voltage 100V; Tolerance 20%; MPN EKYB101ELL221MK25S
C21, C22: 2.2u / 100V X7R; C_1210_3225Metric; Voltage 100V; Tolerance 10%; MPN CS1210KKX7R0BB225
C23: 1u; C_0603_1608Metric; Voltage_Rating 25V; MPN TBD
C24: 100n; C_0603_1608Metric; Voltage_Rating 25V; MPN TBD
D1: MBRD20150CT-13; TO-252-3_TabPin2; MPN MBRD20150CT-13
D2: SMCJ60CA / CANDIDATE DNP; D_SMC; MPN SMCJ60CA; not fitted
F1: 0476015.MRSN; Fuse_Littelfuse-NANO2-451_453; MPN 0476015.MRSN
J3: DC INPUT: + / -; WireSolder_2P_P6.00mm_D2.00mm; MPN PCB solder holes / wire assembly
J4: RAW PWM: U / V / W; WireSolder_3P_P15.00mm_D2.00mm; MPN PCB solder holes / wire assembly
J5: BRAKE POWER: BR+ / BR_SW; WireSolder_2P_P6.00mm_D2.00mm; MPN PCB solder holes / wire assembly
Q7: BSC110N15NS5; BSC110N15NS5_TDSON8_8PhysicalPins; MPN BSC110N15NS5
R16, R18: 10k; R_0603_1608Metric; Tolerance 1%; MPN TBD
R17: 15; R_0805_2012Metric; Tolerance 1%; MPN TBD
U29: UCC27517DBVR; SOT-23-5; MPN UCC27517DBVR

Connections:
+12V_DRV: C23.1, C24.1, U29.1 (VDD); also elsewhere on the board
/Bus and brake/BR_DRV: R17.1, U29.5 (OUT)
/Bus and brake/BR_GATE: Q7.4 (G), R17.2, R18.1
/Bus and brake/BR_SW: J5.2, Q7.5 (D), Q7.6 (D), Q7.7 (D), Q7.8 (D)
/Bus and brake/DC_FUSED: D1.1 (A), D1.3 (A), F1.2
/Bus and brake/DC_INPUT_POS: F1.1, J3.1
BRAKE_IN: R16.1, U29.3 (IN+); also elsewhere on the board
U_PHASE: J4.1; also elsewhere on the board
VBUS: C19.1, C20.1, C21.1, C22.1, D1.2 (K), D2.1 (A1), J5.1; also elsewhere on the board
V_PHASE: J4.2; also elsewhere on the board
W_PHASE: J4.3; also elsewhere on the board

Notes on the sheet:
MAIN BUS INPUT / BULK CAPACITORS / RAW PWM OUTPUTS
D2 is DNP. The input diode / TVS / fuse are still procurement and energy/thermal review items. No main-bus precharge or dedicated bleeder. U/V/W are raw bridge PWM, not LC-filtered sine outputs.
ONE BRAKE BRANCH / EXTERNAL RESISTOR / LOCAL MCU COMMAND
J5: BR+ = VBUS, BR_SW = MOS drain. External resistor goes across these pins; unused port stays OPEN. Brake is independent of the bridge ENABLE/fault gates. MCU reset defaults the command low.

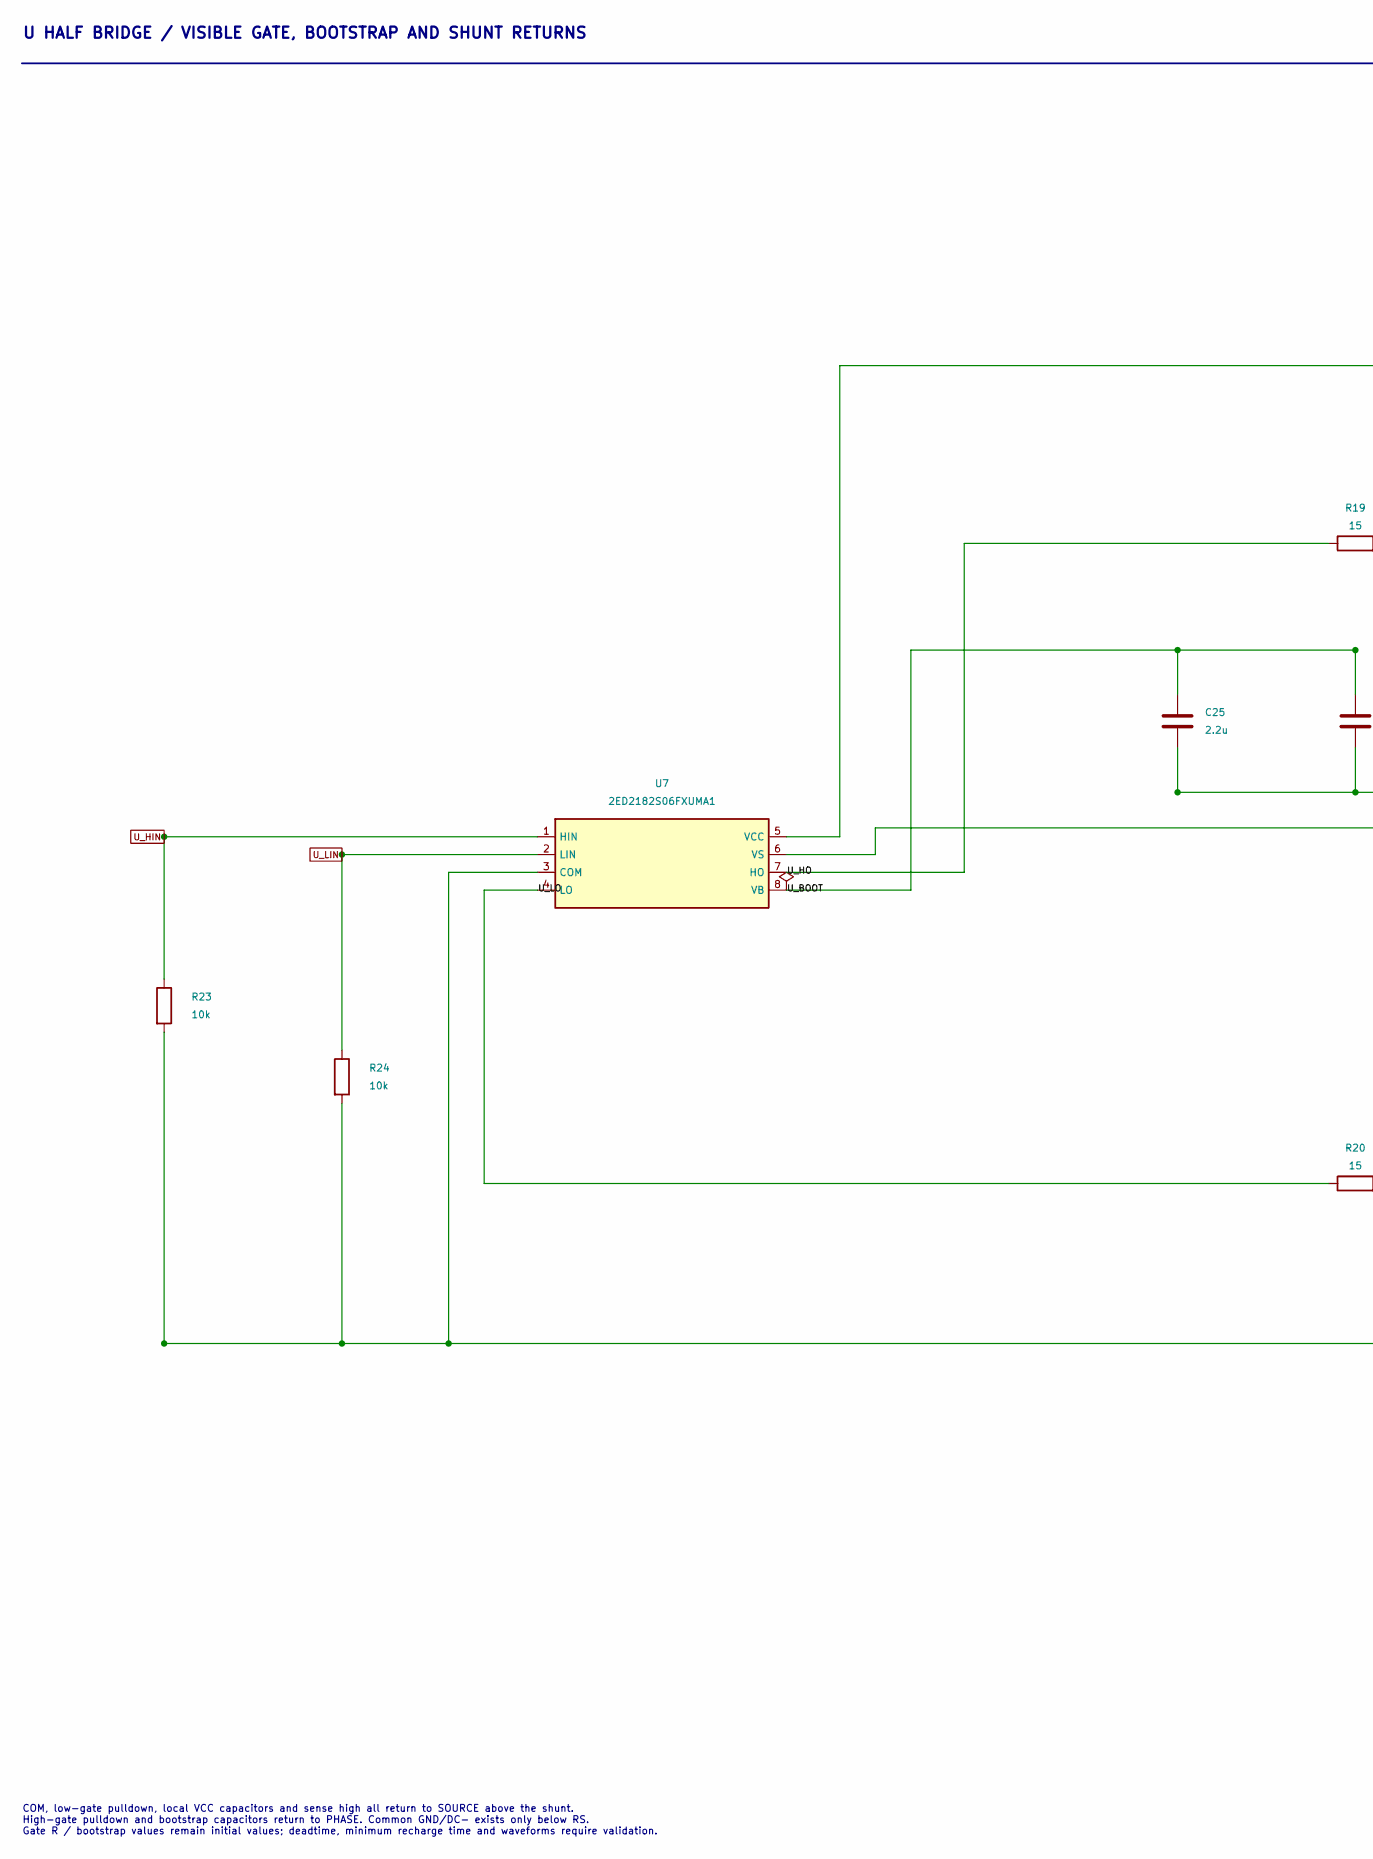
[picture p234: schematic bridge_u.kicad_sch, Inverter - U half bridge and low-side shunt, part in row 1, column 1]

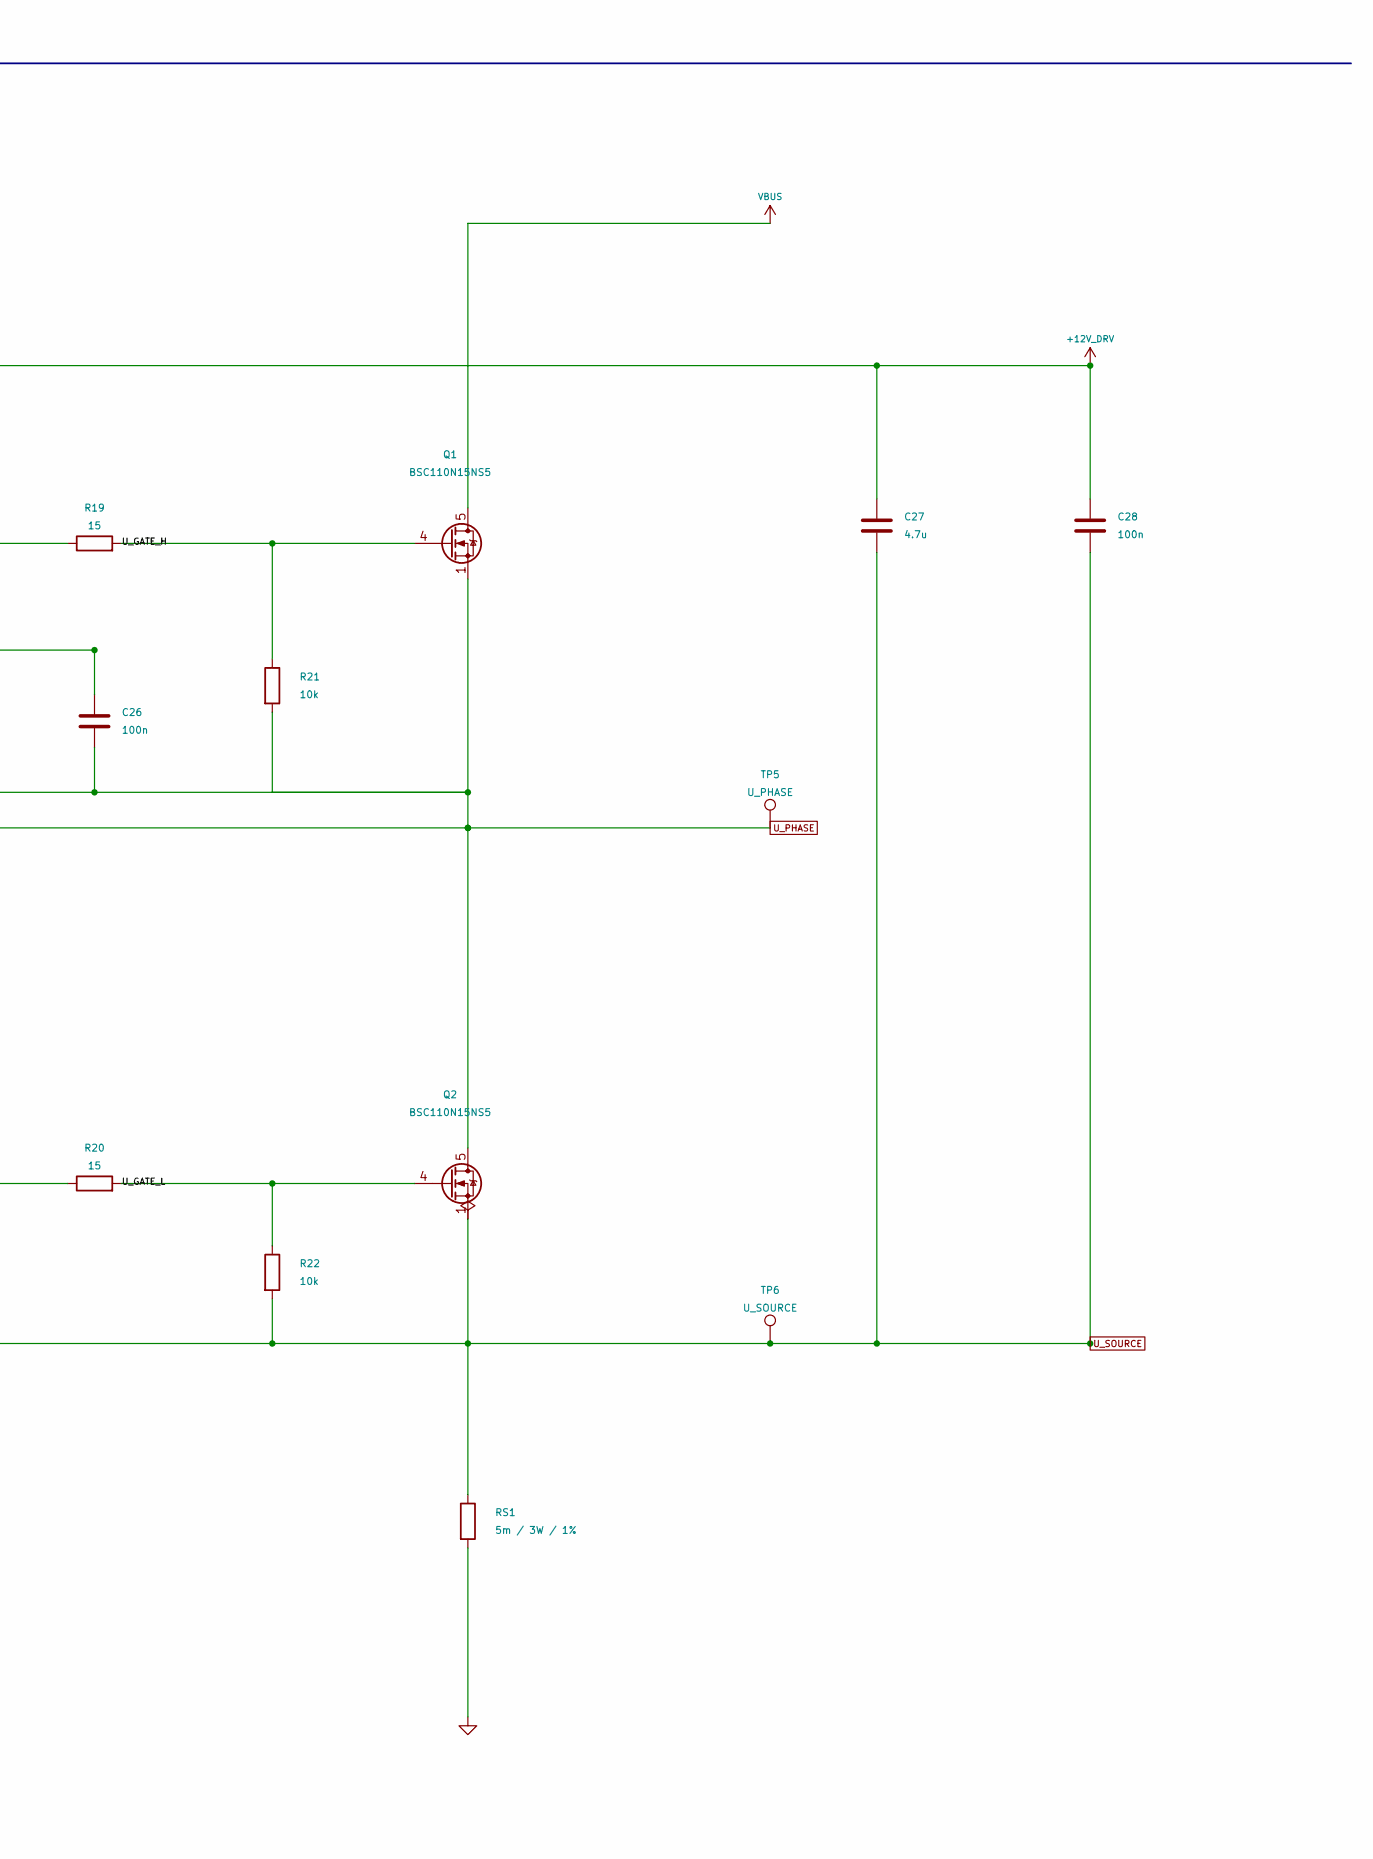
[picture p235: schematic bridge_u.kicad_sch, Inverter - U half bridge and low-side shunt, part in row 1, column 2]

Parts:
C25: 2.2u; C_1206_3216Metric; Voltage_Rating 25V; MPN TBD
C26, C28: 100n; C_0603_1608Metric; Voltage_Rating 25V; MPN TBD
C27: 4.7u; C_0805_2012Metric; Voltage_Rating 25V; MPN TBD
Q1, Q2: BSC110N15NS5; BSC110N15NS5_TDSON8_8PhysicalPins; MPN BSC110N15NS5
R19, R20: 15; R_0805_2012Metric; Tolerance 1%; MPN TBD
R21, R22, R23, R24: 10k; R_0603_1608Metric; Tolerance 1%; MPN TBD
RS1: 5m / 3W / 1%; R_2512_6332Metric; MPN HoJLR2512-3W-5mR-1%
TP5: U_PHASE; TestPoint_Pad_D1.5mm
TP6: U_SOURCE; TestPoint_Pad_D1.5mm
U7: 2ED2182S06FXUMA1; SOIC-8_3.9x4.9mm_P1.27mm; MPN 2ED2182S06FXUMA1

Connections:
+12V_DRV: C27.1, C28.1, U7.5 (VCC); also elsewhere on the board
/U half bridge/U_BOOT: C25.1, C26.1, U7.8 (VB)
/U half bridge/U_GATE_H: Q1.4 (G), R19.2, R21.1
/U half bridge/U_GATE_L: Q2.4 (G), R20.2, R22.1
/U half bridge/U_HO: R19.1, U7.7 (HO)
/U half bridge/U_LO: R20.1, U7.4 (LO)
U_HIN: R23.1, U7.1 (HIN); also elsewhere on the board
U_LIN: R24.1, U7.2 (LIN); also elsewhere on the board
U_PHASE: C25.2, C26.2, Q1.1 (S), Q1.2 (S), Q1.3 (S), Q2.5 (D), Q2.6 (D), Q2.7 (D), Q2.8 (D), R21.2, TP5.1, U7.6 (VS); also elsewhere on the board
U_SOURCE: C27.2, C28.2, Q2.1 (S), Q2.2 (S), Q2.3 (S), R22.2, R23.2, R24.2, RS1.1, TP6.1, U7.3 (COM); also elsewhere on the board
VBUS: Q1.5 (D), Q1.6 (D), Q1.7 (D), Q1.8 (D); also elsewhere on the board

Notes on the sheet:
U HALF BRIDGE / VISIBLE GATE, BOOTSTRAP AND SHUNT RETURNS
COM, low-gate pulldown, local VCC capacitors and sense high all return to SOURCE above the shunt. High-gate pulldown and bootstrap capacitors return to PHASE. Common GND/DC- exists only below RS. Gate R / bootstrap values remain initial values; deadtime, minimum recharge time and waveforms require 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
