leolei2012/power_system/inverter/hardware/review/compact_fine_smoke/inverter.kicad_pcb

## KiCad design inverter/history/integrated_rev_c_60x60/inverter.kicad_pcb (continued)

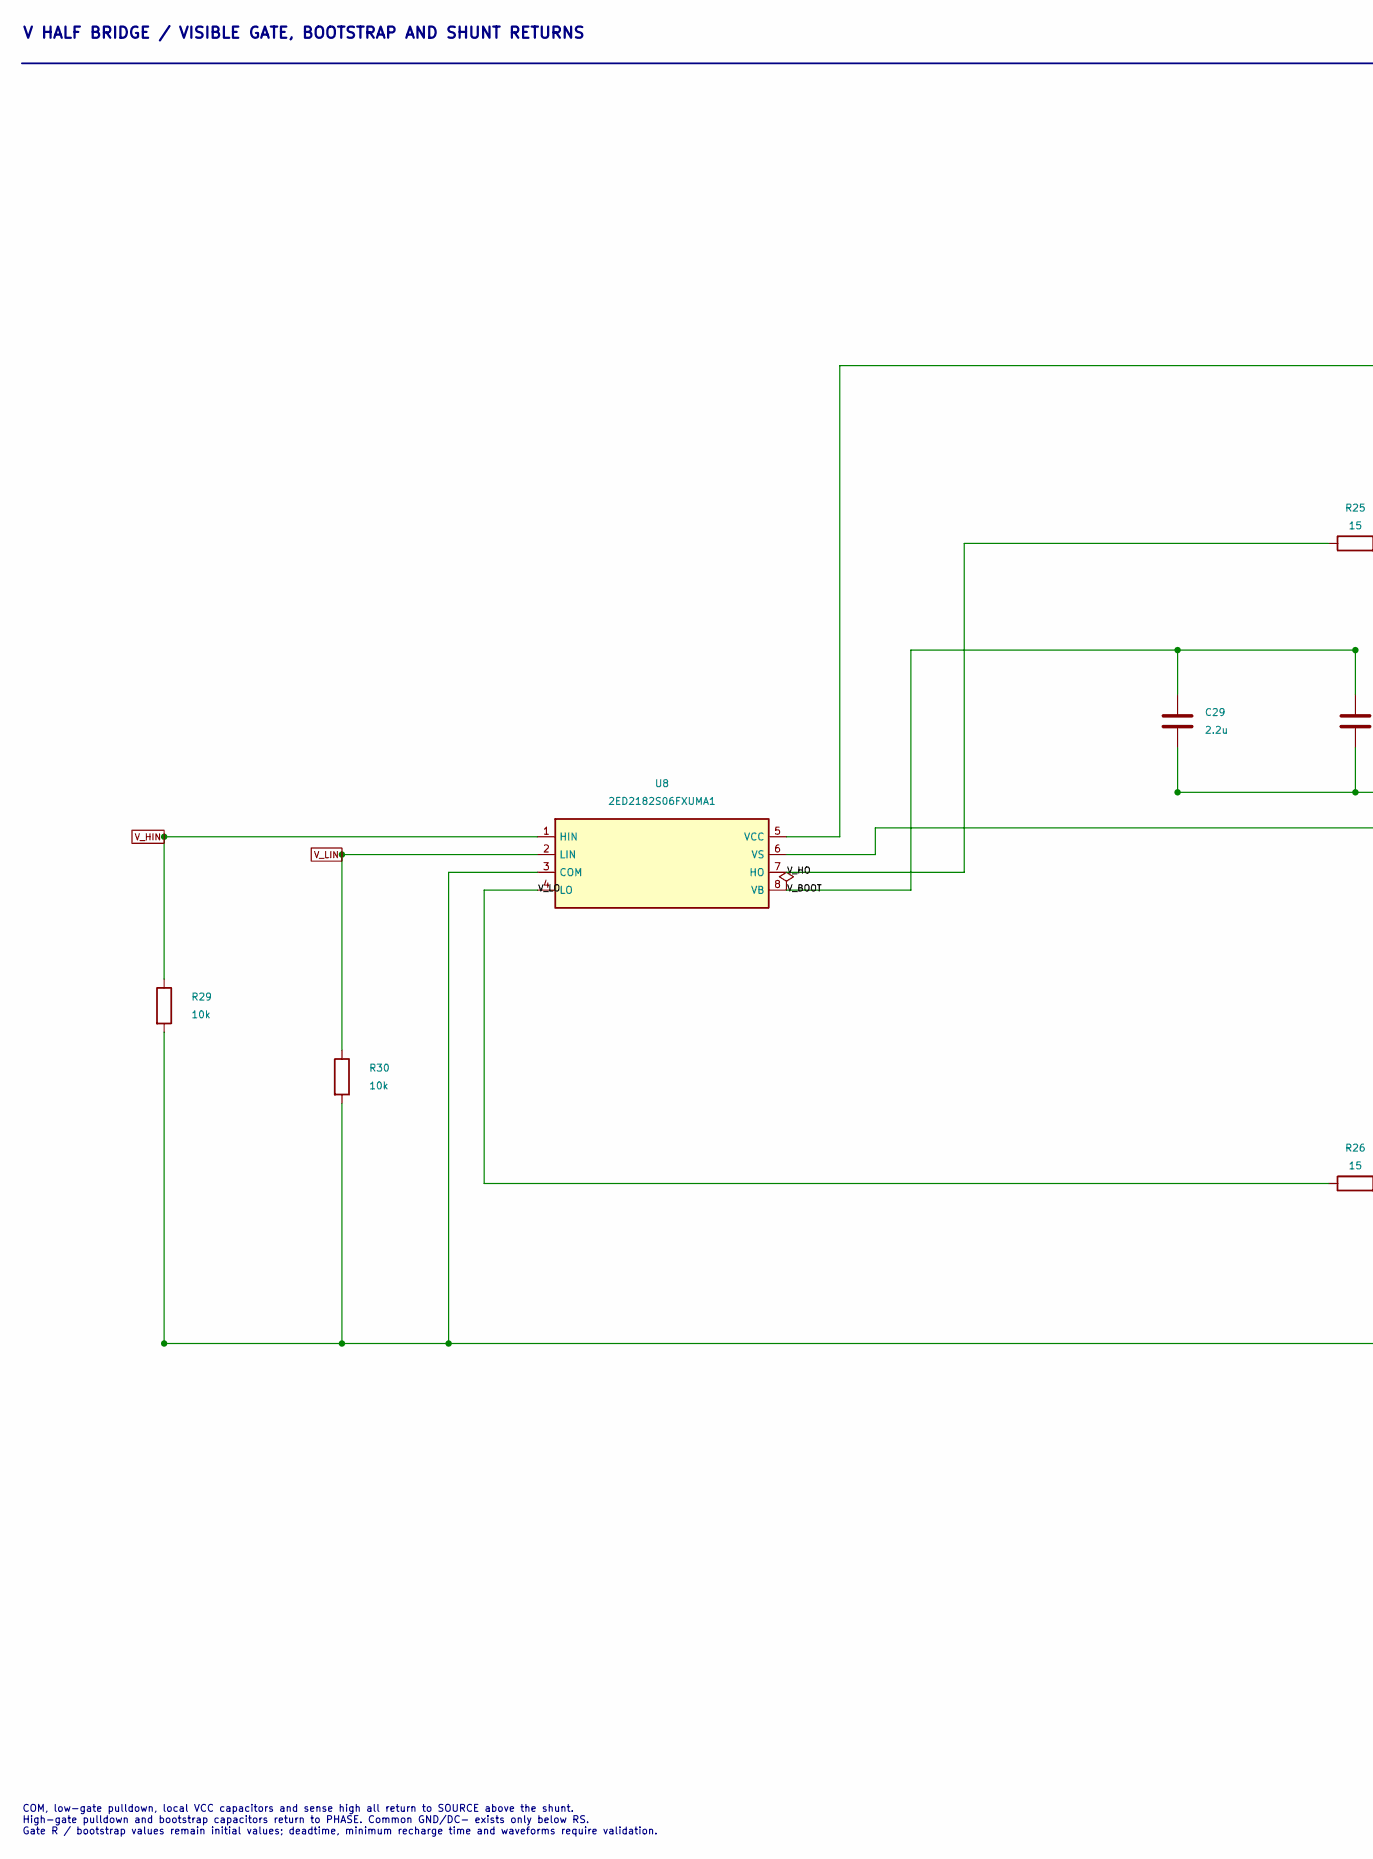
[picture p236: schematic bridge_v.kicad_sch, Inverter - V half bridge and low-side shunt, part in row 1, column 1]

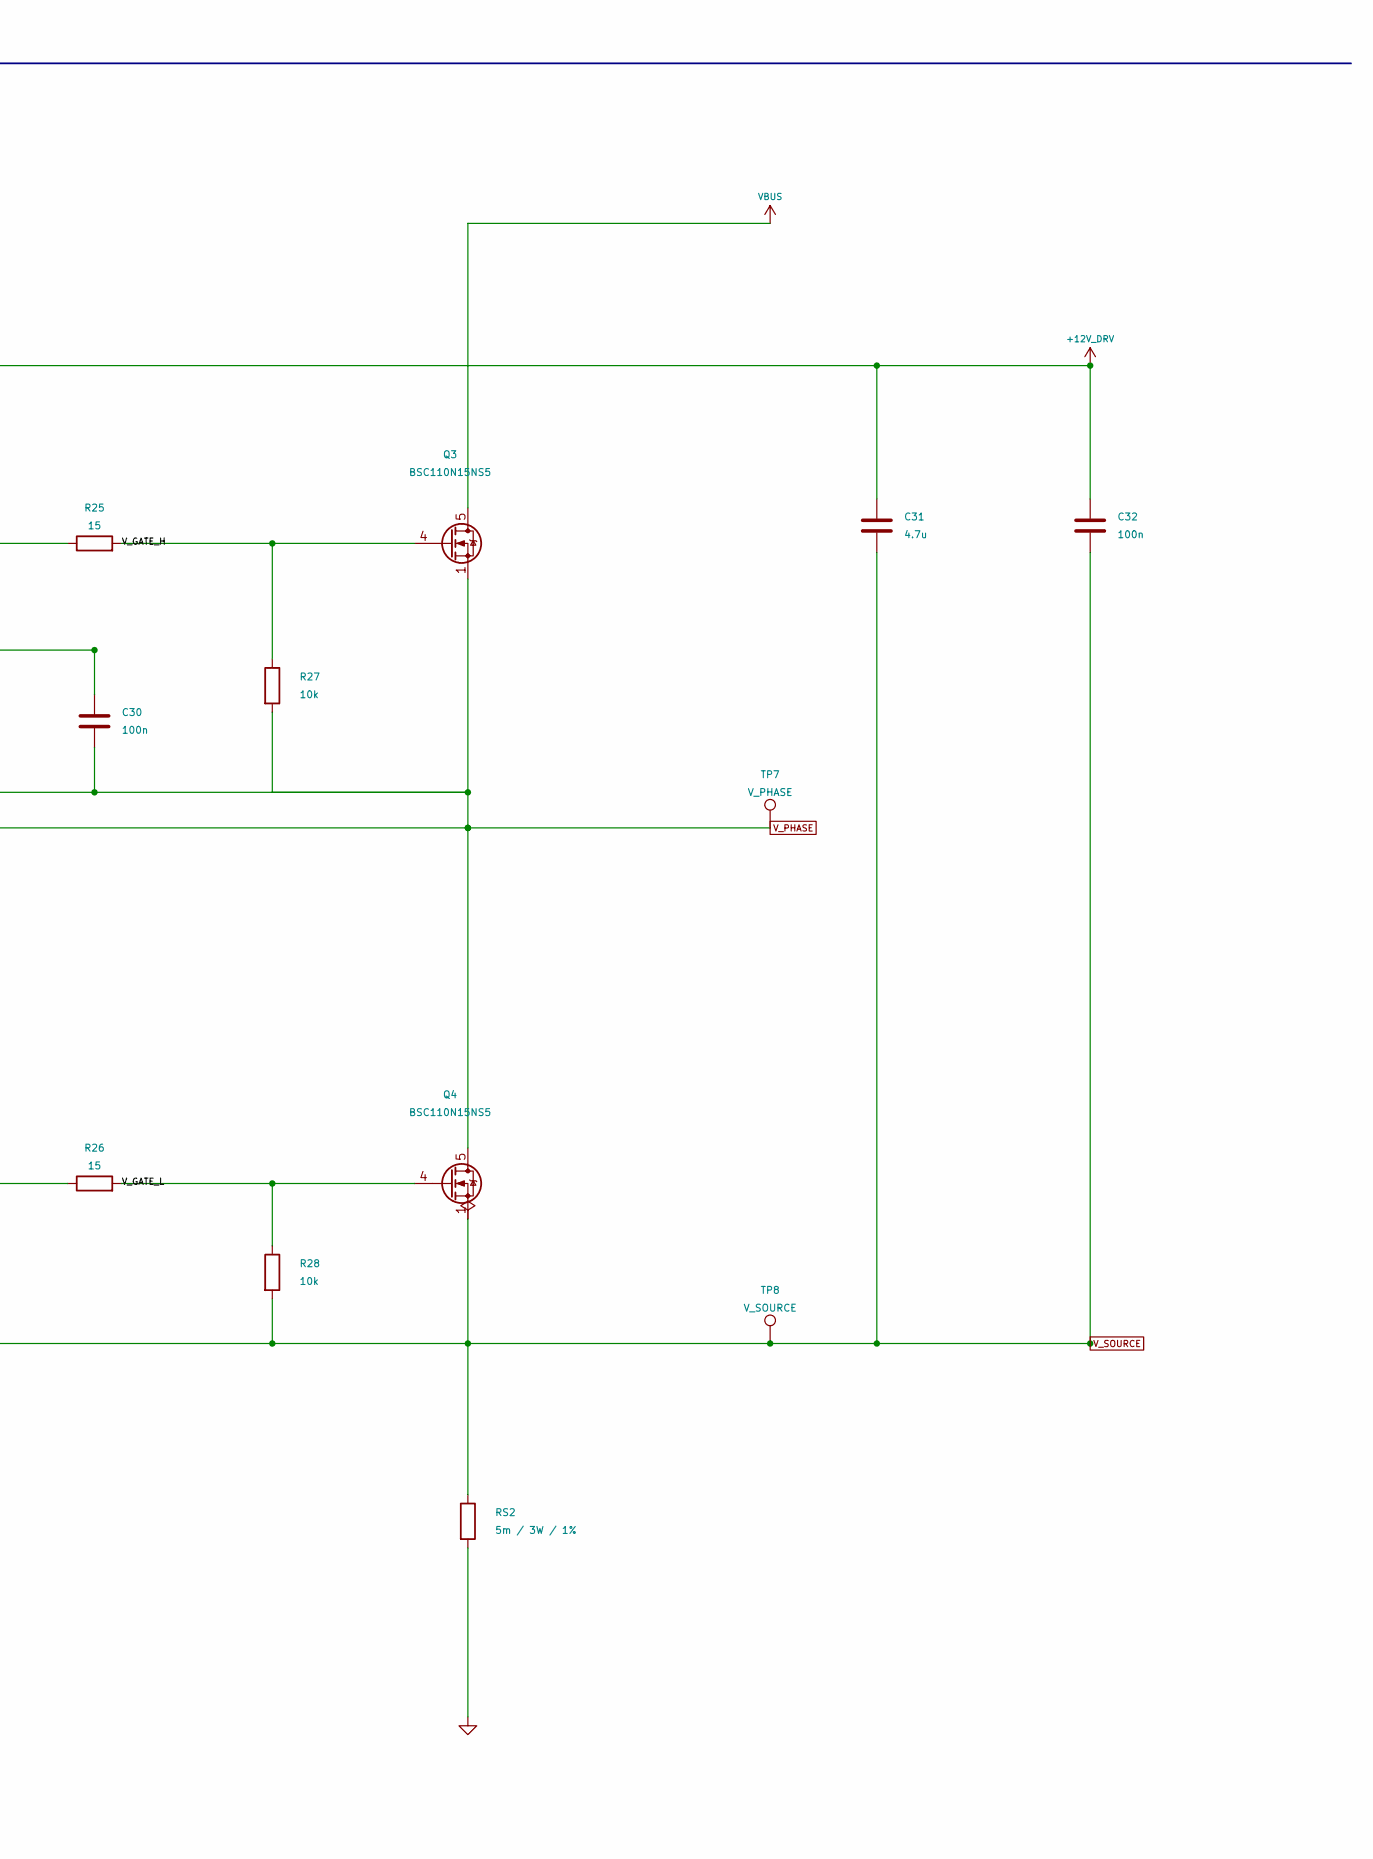
[picture p237: schematic bridge_v.kicad_sch, Inverter - V half bridge and low-side shunt, part in row 1, column 2]

Parts:
C29: 2.2u; C_1206_3216Metric; Voltage_Rating 25V; MPN TBD
C30, C32: 100n; C_0603_1608Metric; Voltage_Rating 25V; MPN TBD
C31: 4.7u; C_0805_2012Metric; Voltage_Rating 25V; MPN TBD
Q3, Q4: BSC110N15NS5; BSC110N15NS5_TDSON8_8PhysicalPins; MPN BSC110N15NS5
R25, R26: 15; R_0805_2012Metric; Tolerance 1%; MPN TBD
R27, R28, R29, R30: 10k; R_0603_1608Metric; Tolerance 1%; MPN TBD
RS2: 5m / 3W / 1%; R_2512_6332Metric; MPN HoJLR2512-3W-5mR-1%
TP7: V_PHASE; TestPoint_Pad_D1.5mm
TP8: V_SOURCE; TestPoint_Pad_D1.5mm
U8: 2ED2182S06FXUMA1; SOIC-8_3.9x4.9mm_P1.27mm; MPN 2ED2182S06FXUMA1

Connections:
+12V_DRV: C31.1, C32.1, U8.5 (VCC); also elsewhere on the board
/V half bridge/V_BOOT: C29.1, C30.1, U8.8 (VB)
/V half bridge/V_GATE_H: Q3.4 (G), R25.2, R27.1
/V half bridge/V_GATE_L: Q4.4 (G), R26.2, R28.1
/V half bridge/V_HO: R25.1, U8.7 (HO)
/V half bridge/V_LO: R26.1, U8.4 (LO)
VBUS: Q3.5 (D), Q3.6 (D), Q3.7 (D), Q3.8 (D); also elsewhere on the board
V_HIN: R29.1, U8.1 (HIN); also elsewhere on the board
V_LIN: R30.1, U8.2 (LIN); also elsewhere on the board
V_PHASE: C29.2, C30.2, Q3.1 (S), Q3.2 (S), Q3.3 (S), Q4.5 (D), Q4.6 (D), Q4.7 (D), Q4.8 (D), R27.2, TP7.1, U8.6 (VS); also elsewhere on the board
V_SOURCE: C31.2, C32.2, Q4.1 (S), Q4.2 (S), Q4.3 (S), R28.2, R29.2, R30.2, RS2.1, TP8.1, U8.3 (COM); also elsewhere on the board

Notes on the sheet:
V HALF BRIDGE / VISIBLE GATE, BOOTSTRAP AND SHUNT RETURNS
COM, low-gate pulldown, local VCC capacitors and sense high all return to SOURCE above the shunt. High-gate pulldown and bootstrap capacitors return to PHASE. Common GND/DC- exists only below RS. Gate R / bootstrap values remain initial values; deadtime, minimum recharge time and waveforms require 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

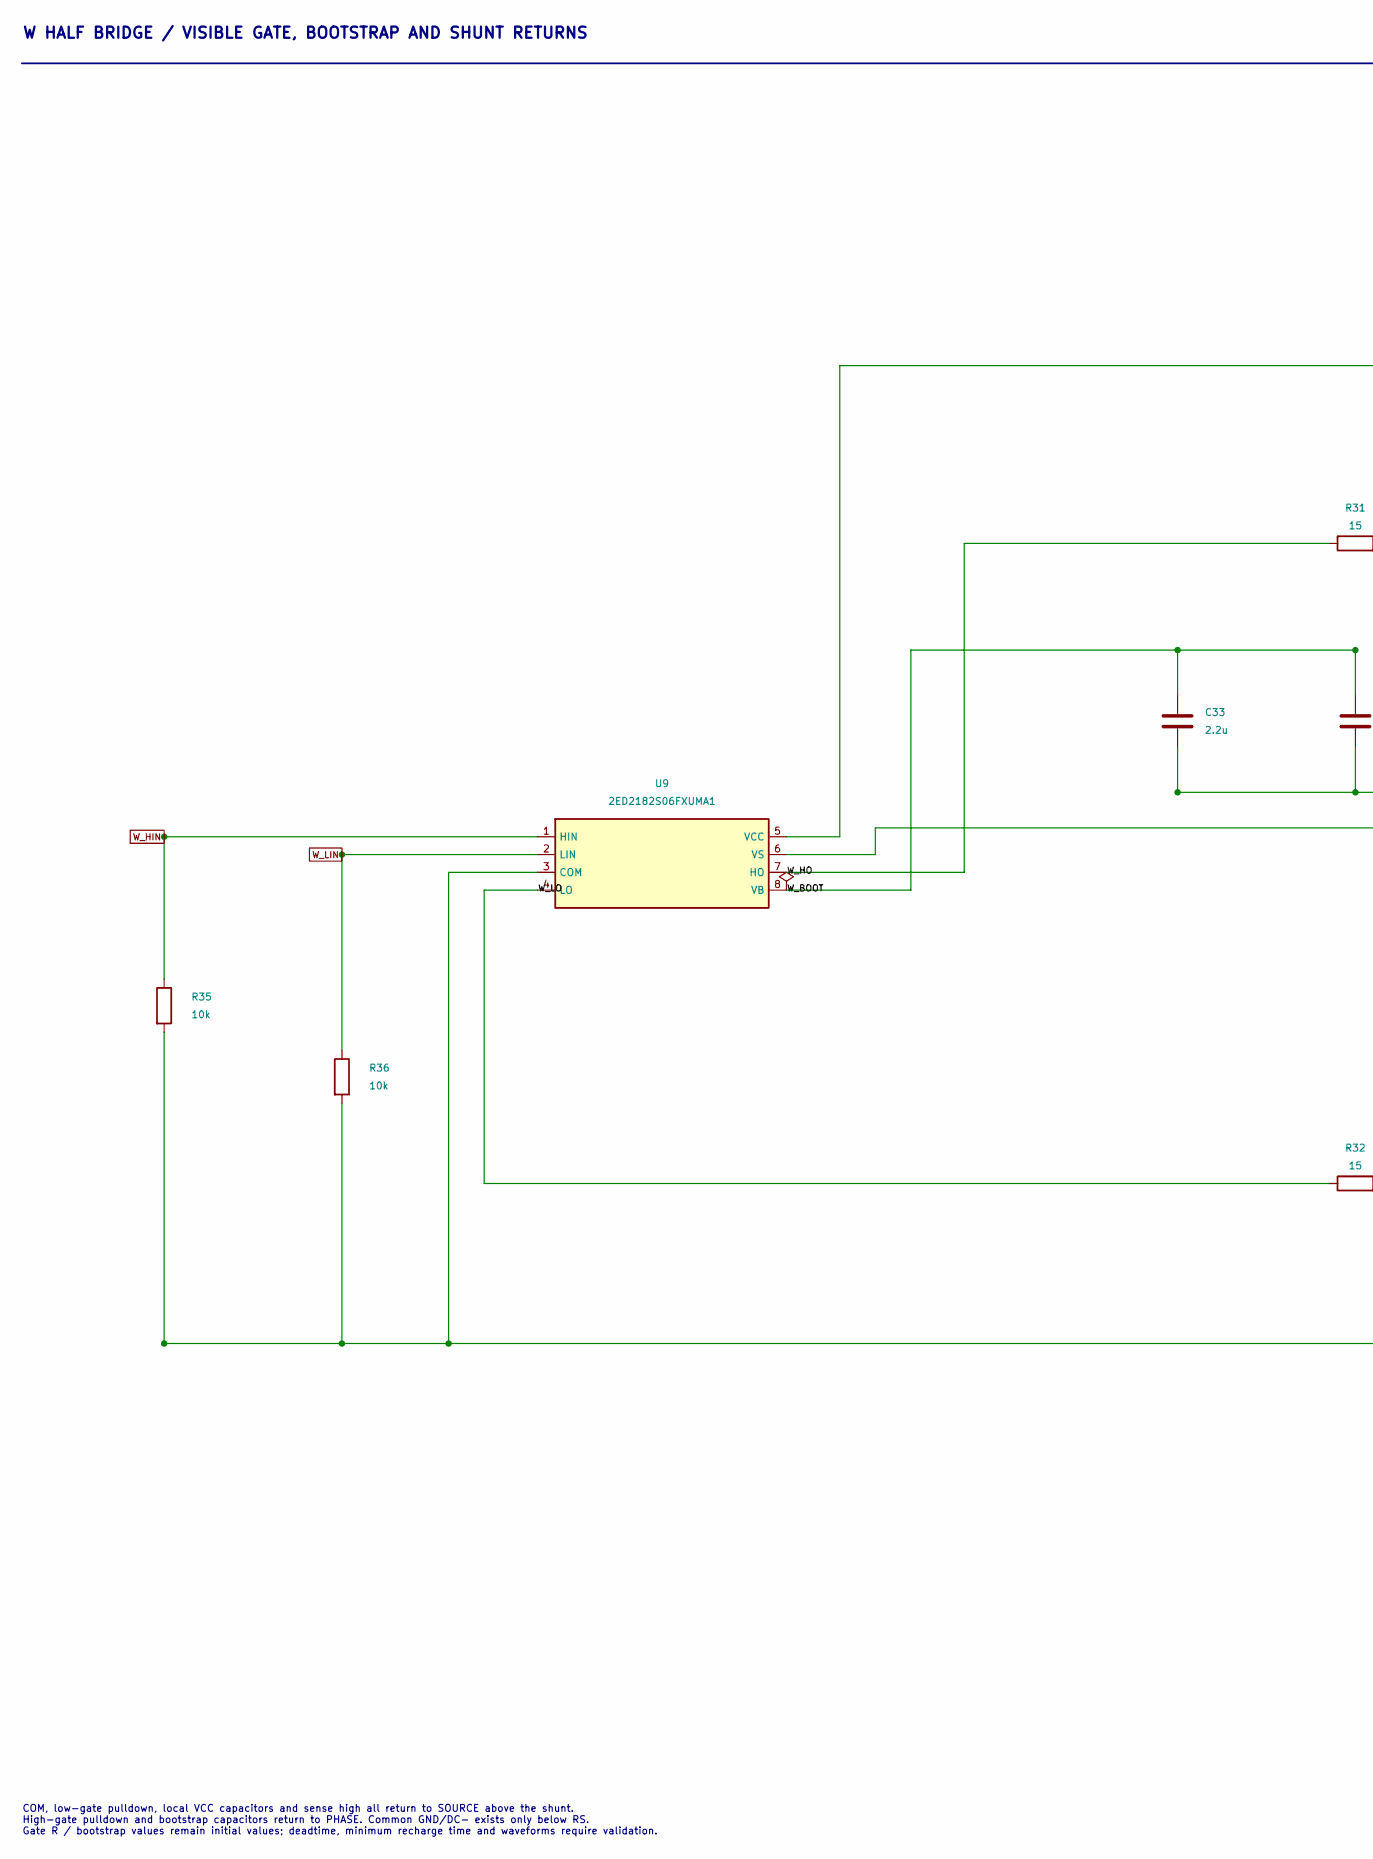
[picture p238: schematic bridge_w.kicad_sch, Inverter - W half bridge and low-side shunt, part in row 1, column 1]

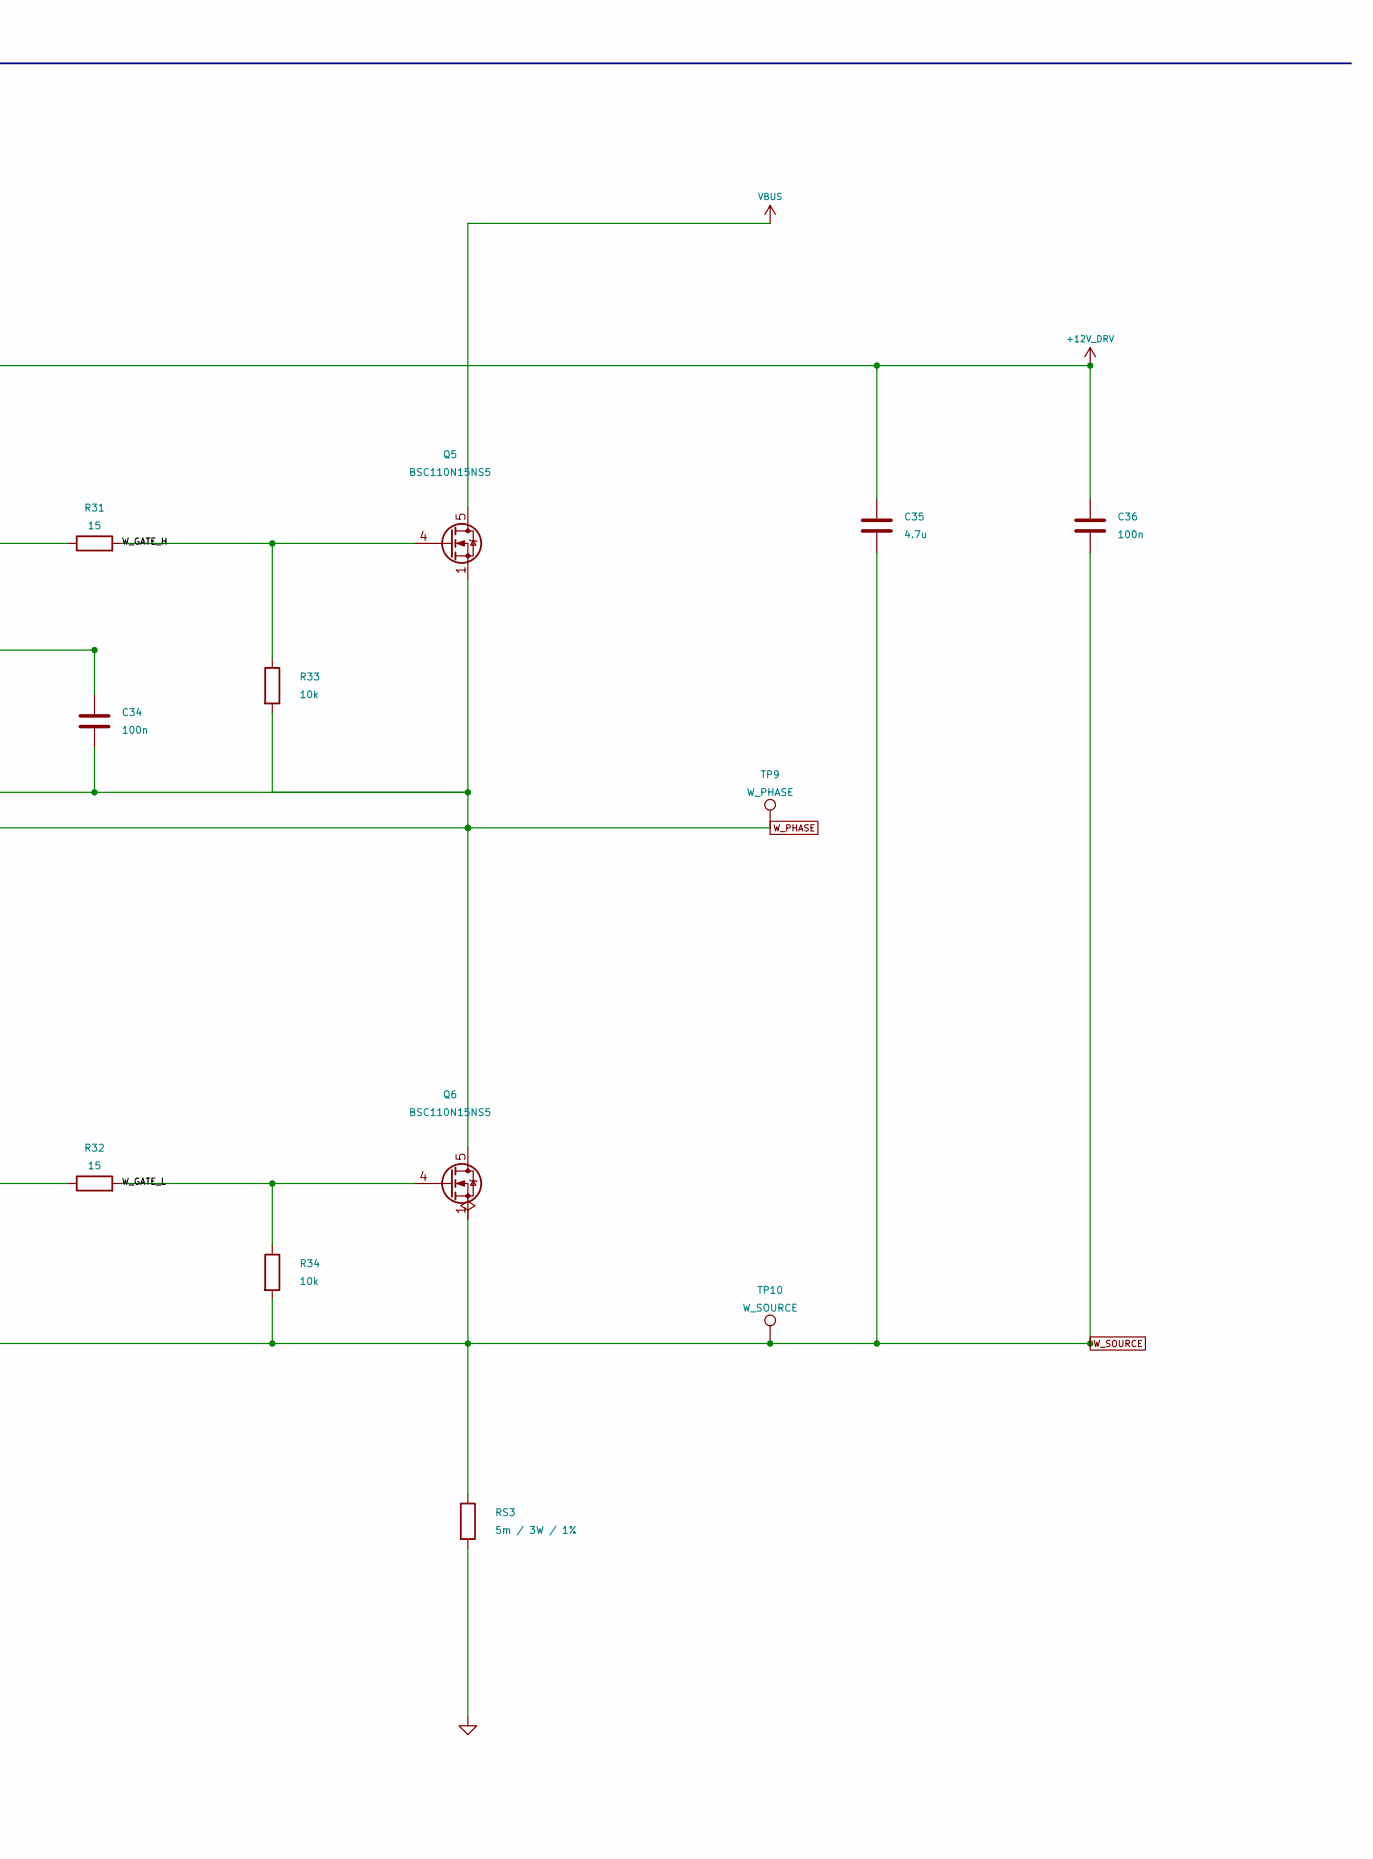
[picture p239: schematic bridge_w.kicad_sch, Inverter - W half bridge and low-side shunt, part in row 1, column 2]

Parts:
C33: 2.2u; C_1206_3216Metric; Voltage_Rating 25V; MPN TBD
C34, C36: 100n; C_0603_1608Metric; Voltage_Rating 25V; MPN TBD
C35: 4.7u; C_0805_2012Metric; Voltage_Rating 25V; MPN TBD
Q5, Q6: BSC110N15NS5; BSC110N15NS5_TDSON8_8PhysicalPins; MPN BSC110N15NS5
R31, R32: 15; R_0805_2012Metric; Tolerance 1%; MPN TBD
R33, R34, R35, R36: 10k; R_0603_1608Metric; Tolerance 1%; MPN TBD
RS3: 5m / 3W / 1%; R_2512_6332Metric; MPN HoJLR2512-3W-5mR-1%
TP9: W_PHASE; TestPoint_Pad_D1.5mm
TP10: W_SOURCE; TestPoint_Pad_D1.5mm
U9: 2ED2182S06FXUMA1; SOIC-8_3.9x4.9mm_P1.27mm; MPN 2ED2182S06FXUMA1

Connections:
+12V_DRV: C35.1, C36.1, U9.5 (VCC); also elsewhere on the board
/W half bridge/W_BOOT: C33.1, C34.1, U9.8 (VB)
/W half bridge/W_GATE_H: Q5.4 (G), R31.2, R33.1
/W half bridge/W_GATE_L: Q6.4 (G), R32.2, R34.1
/W half bridge/W_HO: R31.1, U9.7 (HO)
/W half bridge/W_LO: R32.1, U9.4 (LO)
VBUS: Q5.5 (D), Q5.6 (D), Q5.7 (D), Q5.8 (D); also elsewhere on the board
W_HIN: R35.1, U9.1 (HIN); also elsewhere on the board
W_LIN: R36.1, U9.2 (LIN); also elsewhere on the board
W_PHASE: C33.2, C34.2, Q5.1 (S), Q5.2 (S), Q5.3 (S), Q6.5 (D), Q6.6 (D), Q6.7 (D), Q6.8 (D), R33.2, TP9.1, U9.6 (VS); also elsewhere on the board
W_SOURCE: C35.2, C36.2, Q6.1 (S), Q6.2 (S), Q6.3 (S), R34.2, R35.2, R36.2, RS3.1, TP10.1, U9.3 (COM); also elsewhere on the board

Notes on the sheet:
W HALF BRIDGE / VISIBLE GATE, BOOTSTRAP AND SHUNT RETURNS
COM, low-gate pulldown, local VCC capacitors and sense high all return to SOURCE above the shunt. High-gate pulldown and bootstrap capacitors return to PHASE. Common GND/DC- exists only below RS. Gate R / bootstrap values remain initial values; deadtime, minimum recharge time and waveforms require 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

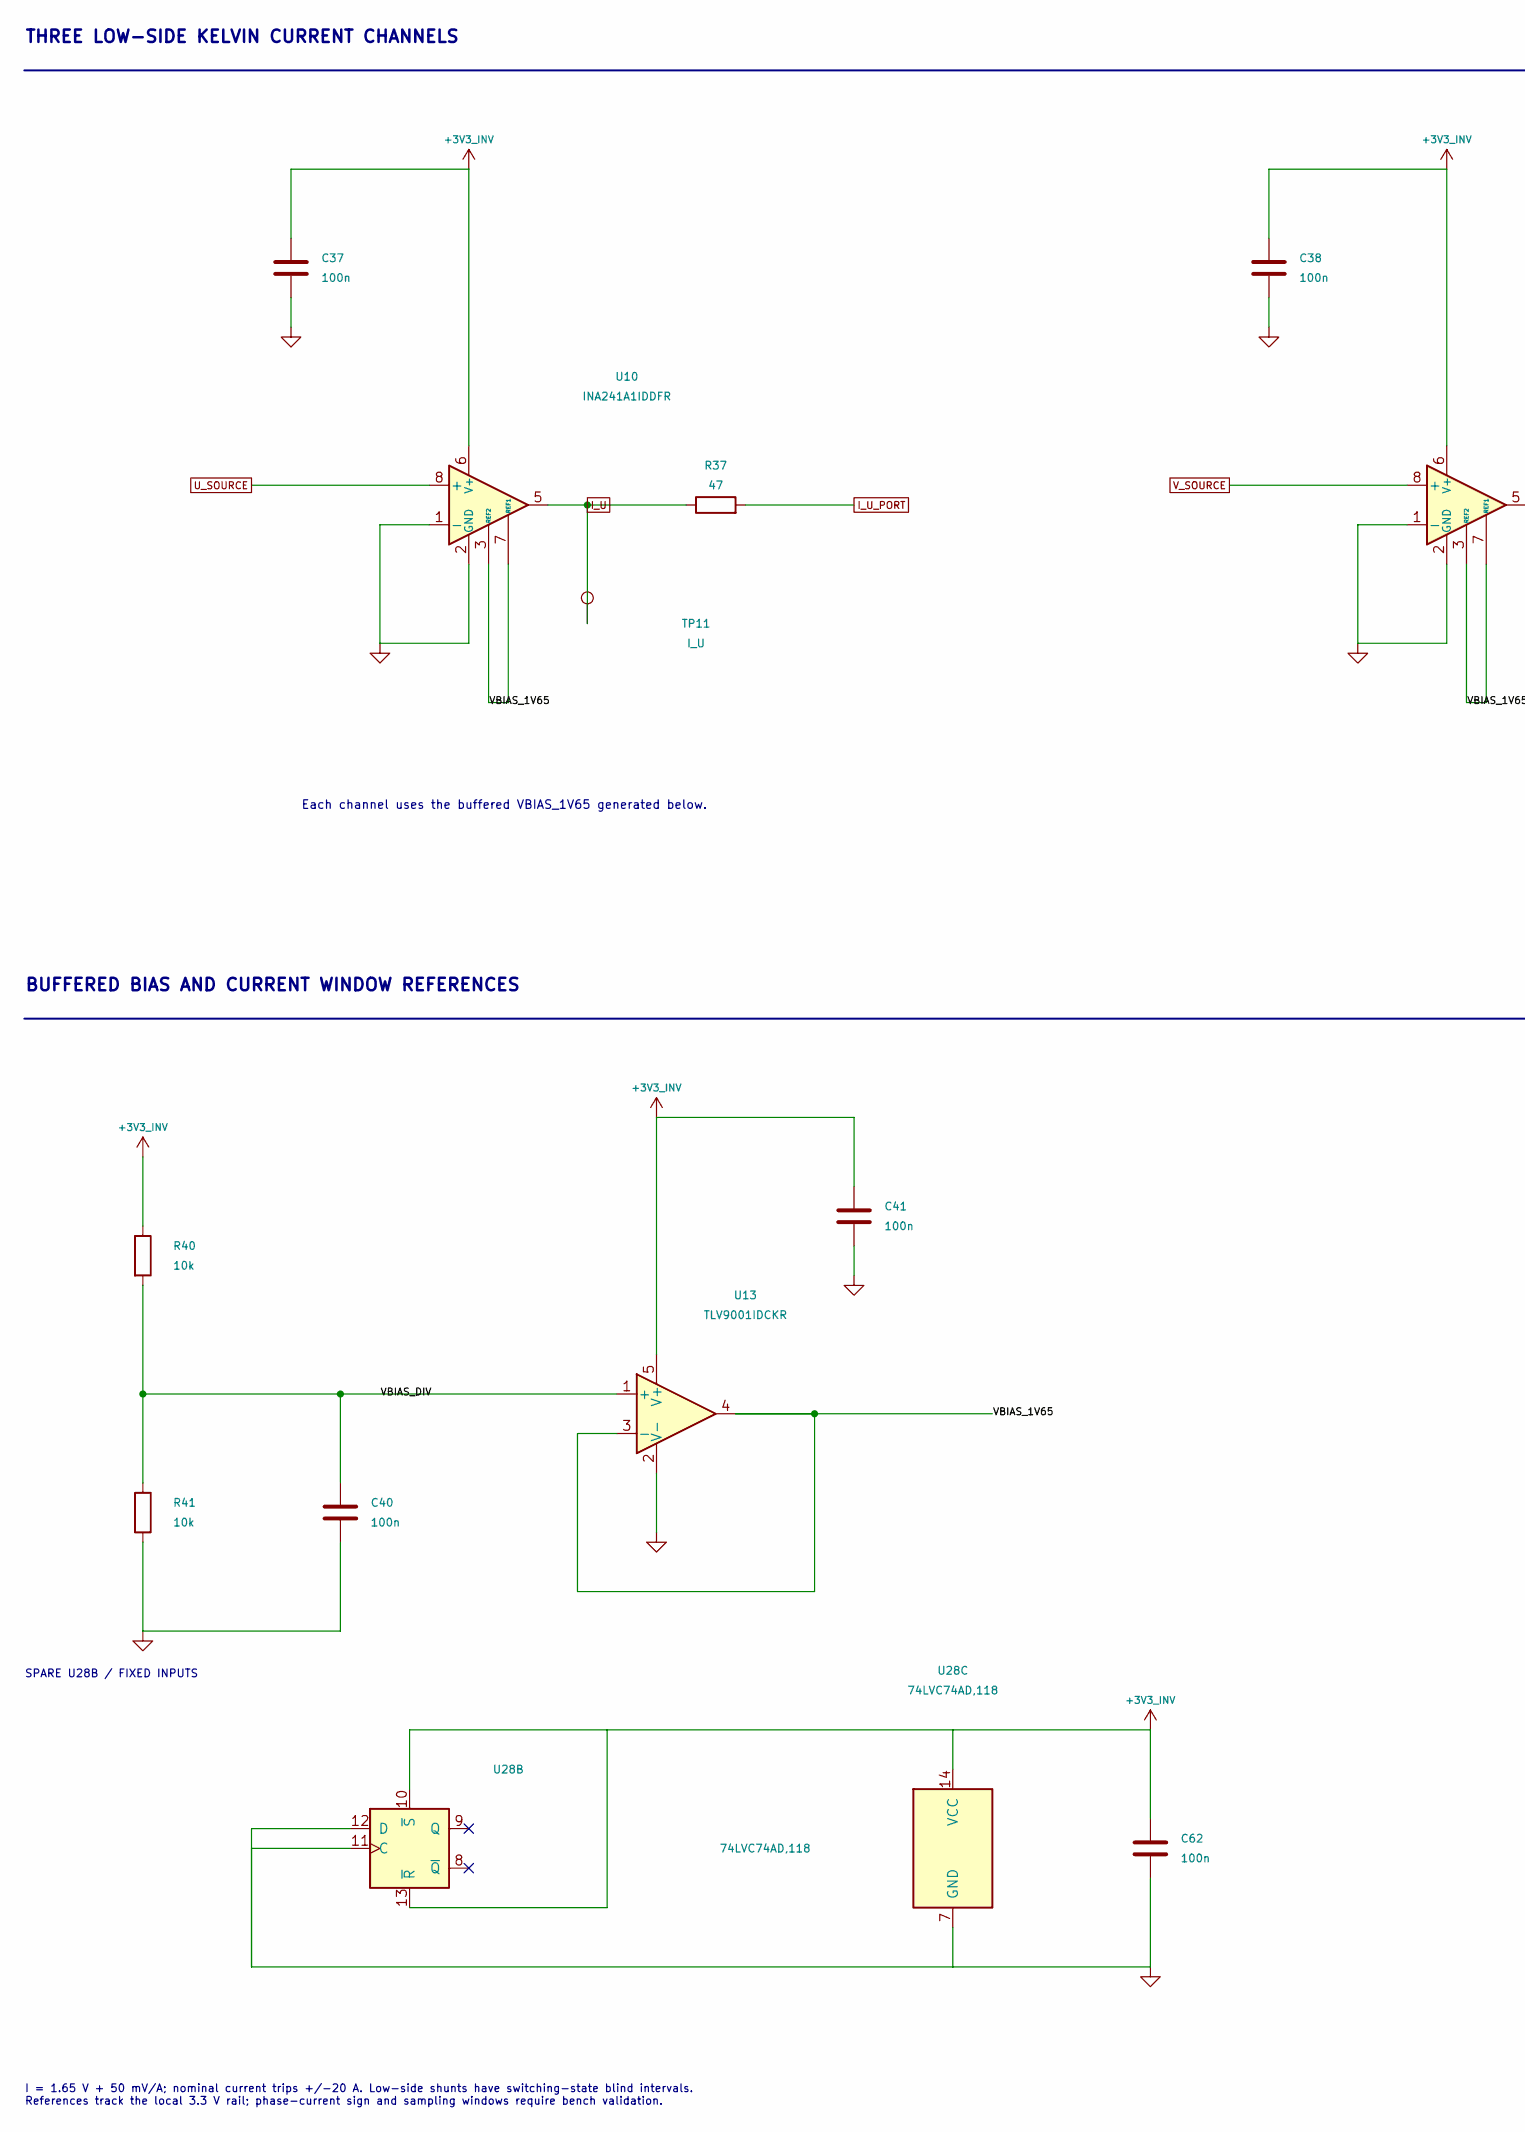
[picture p240: schematic current_sense.kicad_sch, Inverter - three current channels and references, part in row 1, column 1]

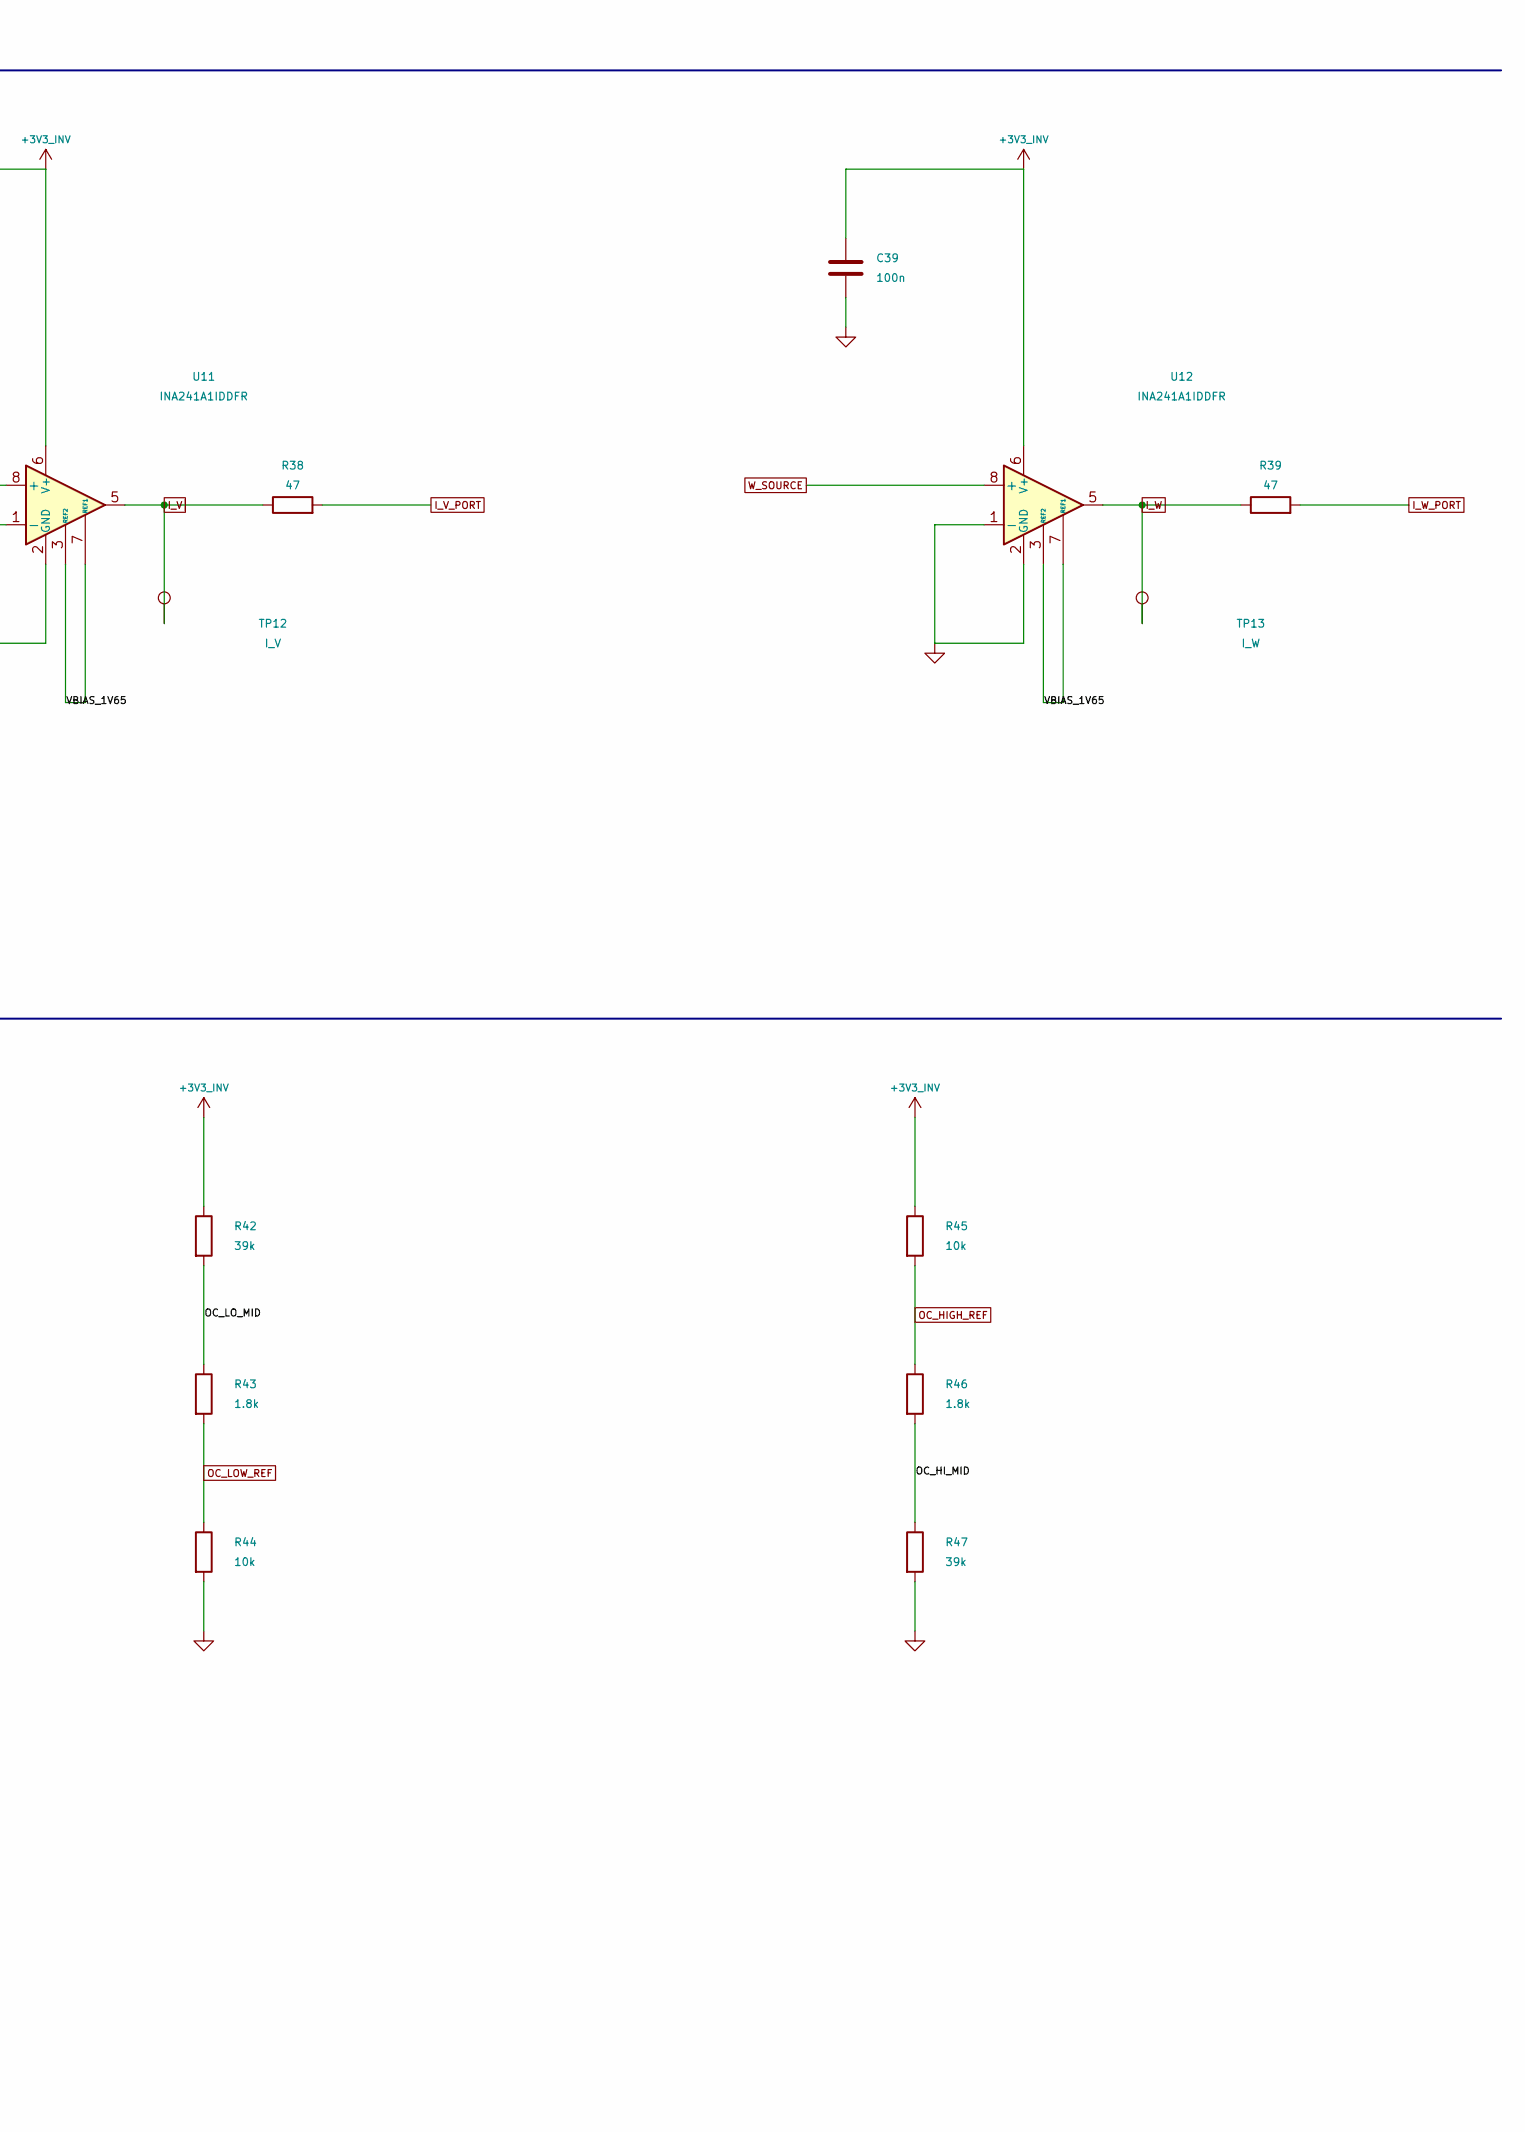
[picture p241: schematic current_sense.kicad_sch, Inverter - three current channels and references, part in row 1, column 2]

Parts:
C37, C38, C39: 100n; C_0603_1608Metric; Voltage_Rating 25V; MPN TBD
C40, C41, C62: 100n; C_0402_1005Metric; Voltage_Rating 25V; MPN TBD
R37, R38, R39: 47; R_0603_1608Metric; Tolerance 1%; MPN TBD
R40, R41, R44, R45: 10k; R_0402_1005Metric; Tolerance 0.1%; MPN TBD
R42, R47: 39k; R_0402_1005Metric; Tolerance 0.1%; MPN TBD
R43, R46: 1.8k; R_0402_1005Metric; Tolerance 0.1%; MPN TBD
TP11: I_U; TestPoint_Pad_D1.5mm
TP12: I_V; TestPoint_Pad_D1.5mm
TP13: I_W; TestPoint_Pad_D1.5mm
U10, U11, U12: INA241A1IDDFR; SOT-23-8; MPN INA241A1IDDFR
U13: TLV9001IDCKR; SOT-353_SC-70-5; MPN TLV9001IDCKR
U28: 74LVC74AD,118; SOIC-14_3.9x8.7mm_P1.27mm; MPN 74LVC74AD,118

Connections:
+3V3_INV: C37.1, C38.1, C39.1, C41.1, C62.1, R40.1, R42.1, R45.1, U10.6 (V+), U11.6 (V+), U12.6 (V+), U13.5 (V+), U28.10 (~S), U28.13 (~R), U28.14 (VCC); also elsewhere on the board
/Current sensing/OC_HI_MID: R46.2, R47.1
/Current sensing/OC_LO_MID: R42.2, R43.1
/Current sensing/VBIAS_1V65: U10.3 (REF2), U10.7 (REF1), U11.3 (REF2), U11.7 (REF1), U12.3 (REF2), U12.7 (REF1), U13.3 (-), U13.4
/Current sensing/VBIAS_DIV: C40.1, R40.2, R41.1, U13.1 (+)
I_U: R37.1, TP11.1, U10.5; also elsewhere on the board
I_U_PORT: R37.2; also elsewhere on the board
I_V: R38.1, TP12.1, U11.5; also elsewhere on the board
I_V_PORT: R38.2; also elsewhere on the board
I_W: R39.1, TP13.1, U12.5; also elsewhere on the board
I_W_PORT: R39.2; also elsewhere on the board
OC_HIGH_REF: R45.2, R46.1; also elsewhere on the board
OC_LOW_REF: R43.2, R44.1; also elsewhere on the board
U_SOURCE: U10.8 (+); also elsewhere on the board
V_SOURCE: U11.8 (+); also elsewhere on the board
W_SOURCE: U12.8 (+); also elsewhere on the board

Notes on the sheet:
THREE LOW-SIDE KELVIN CURRENT CHANNELS
Each channel uses the buffered VBIAS_1V65 generated below.
BUFFERED BIAS AND CURRENT WINDOW REFERENCES
SPARE U28B / FIXED INPUTS
I = 1.65 V + 50 mV/A; nominal current trips +/-20 A. Low-side shunts have switching-state blind intervals. References track the local 3.3 V rail; phase-current sign and sampling windows require bench validation.
