leolei2012/power_system/inverter/hardware/review/compact_fine_smoke/inverter.kicad_pcb

## KiCad design inverter/history/integrated_rev_c_60x60/inverter.kicad_pcb (continued)

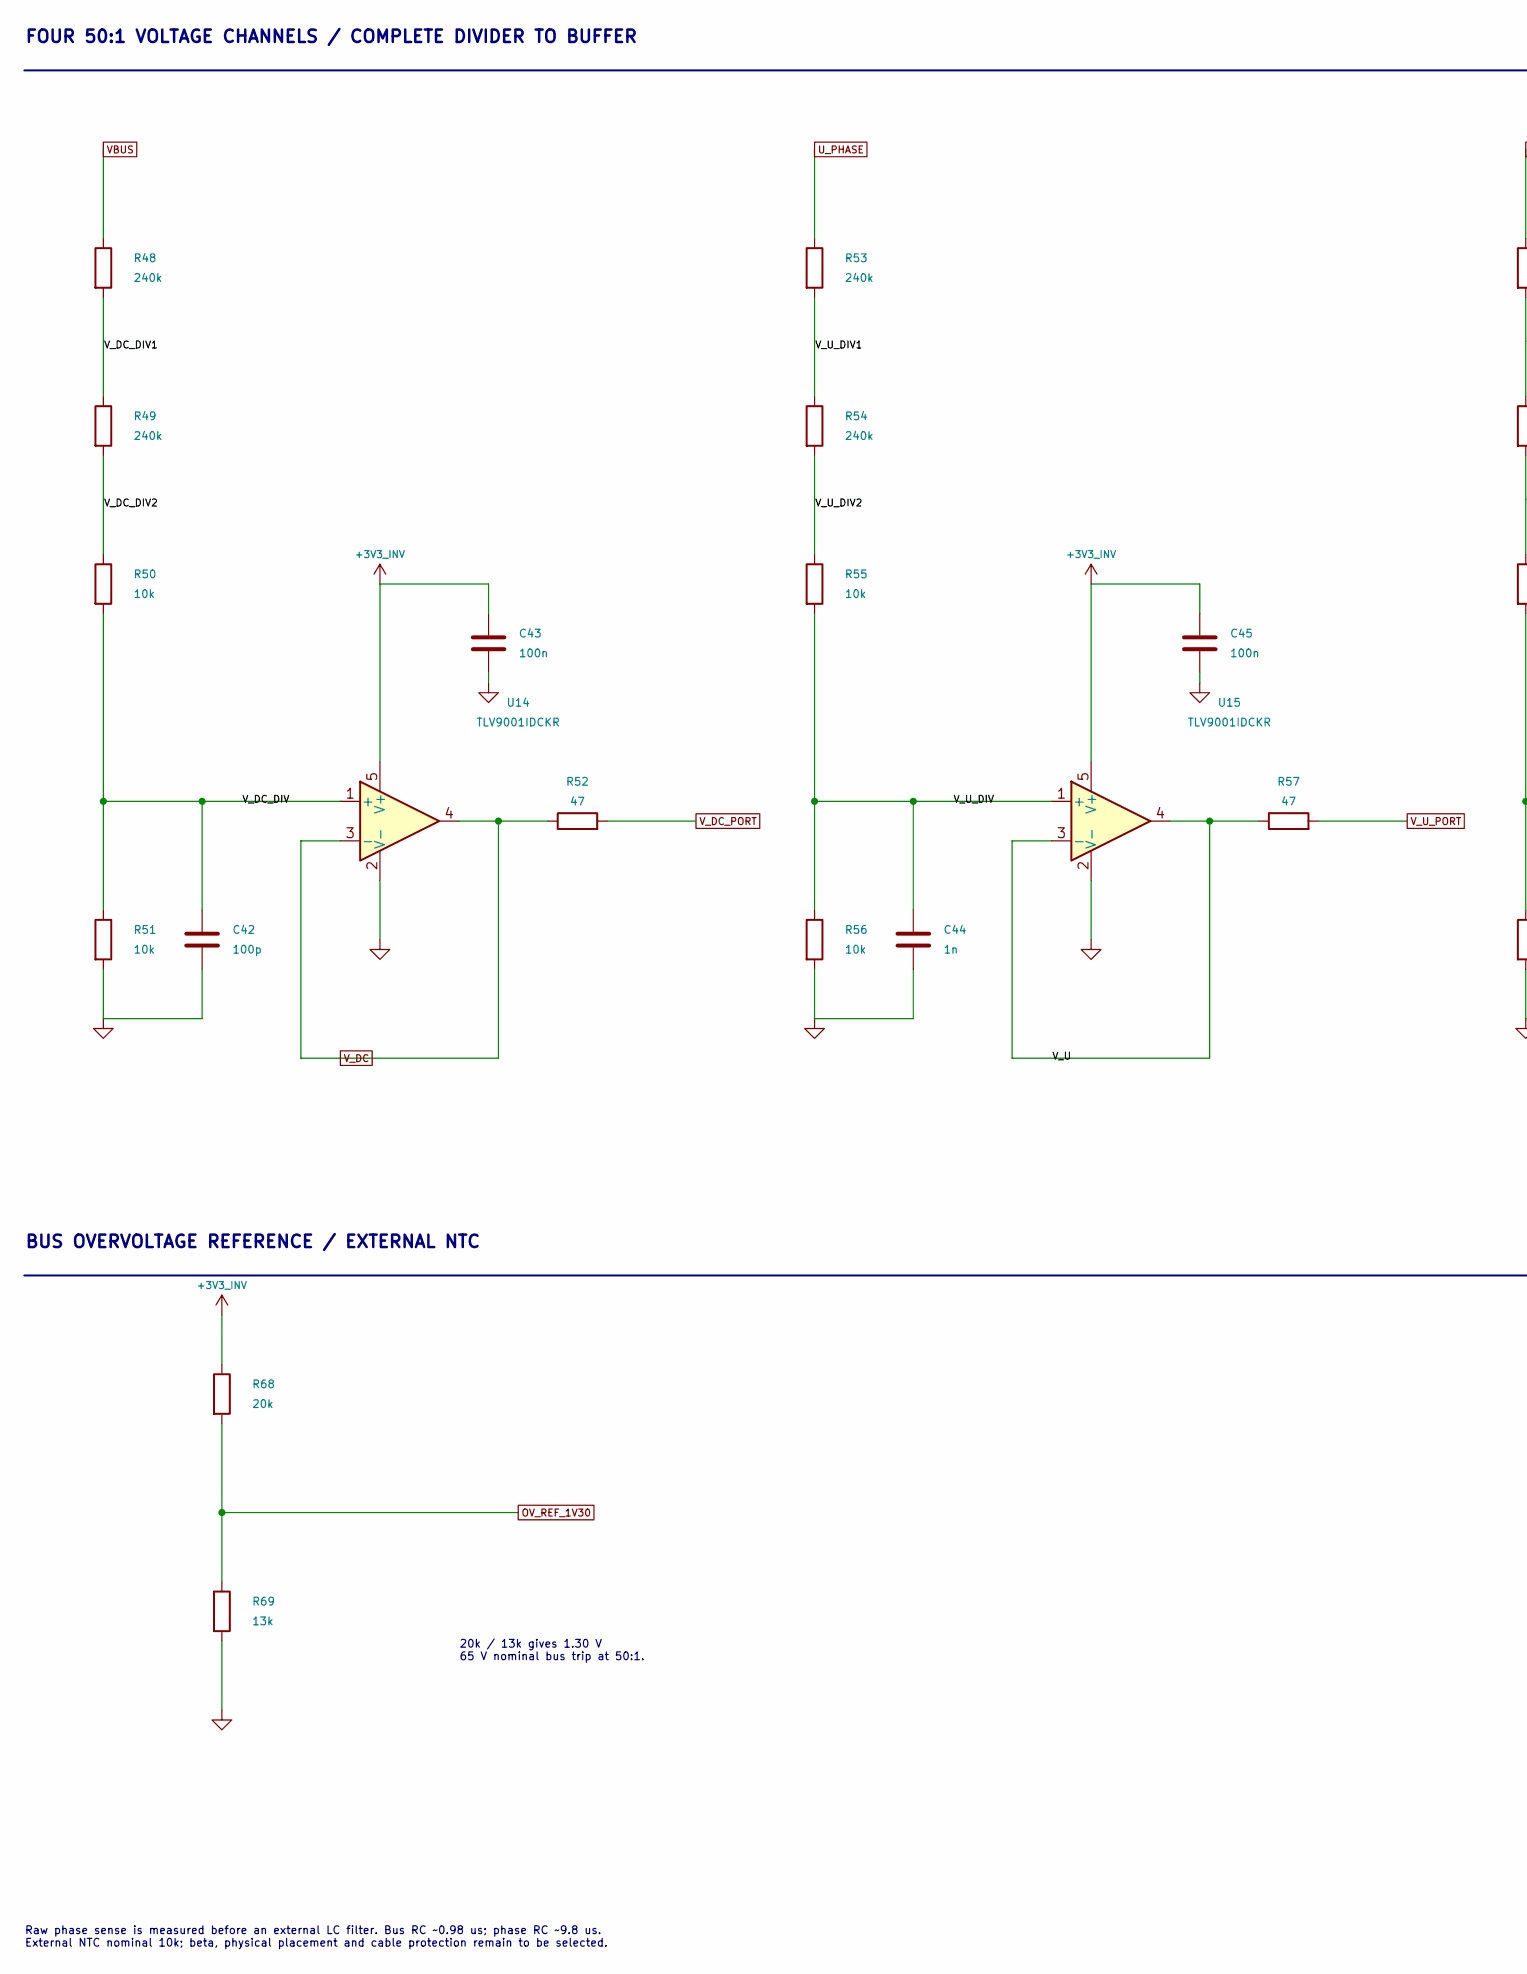
[picture p242: schematic voltage_sense.kicad_sch, Inverter - voltage and NTC sensing, part in row 1, column 1]

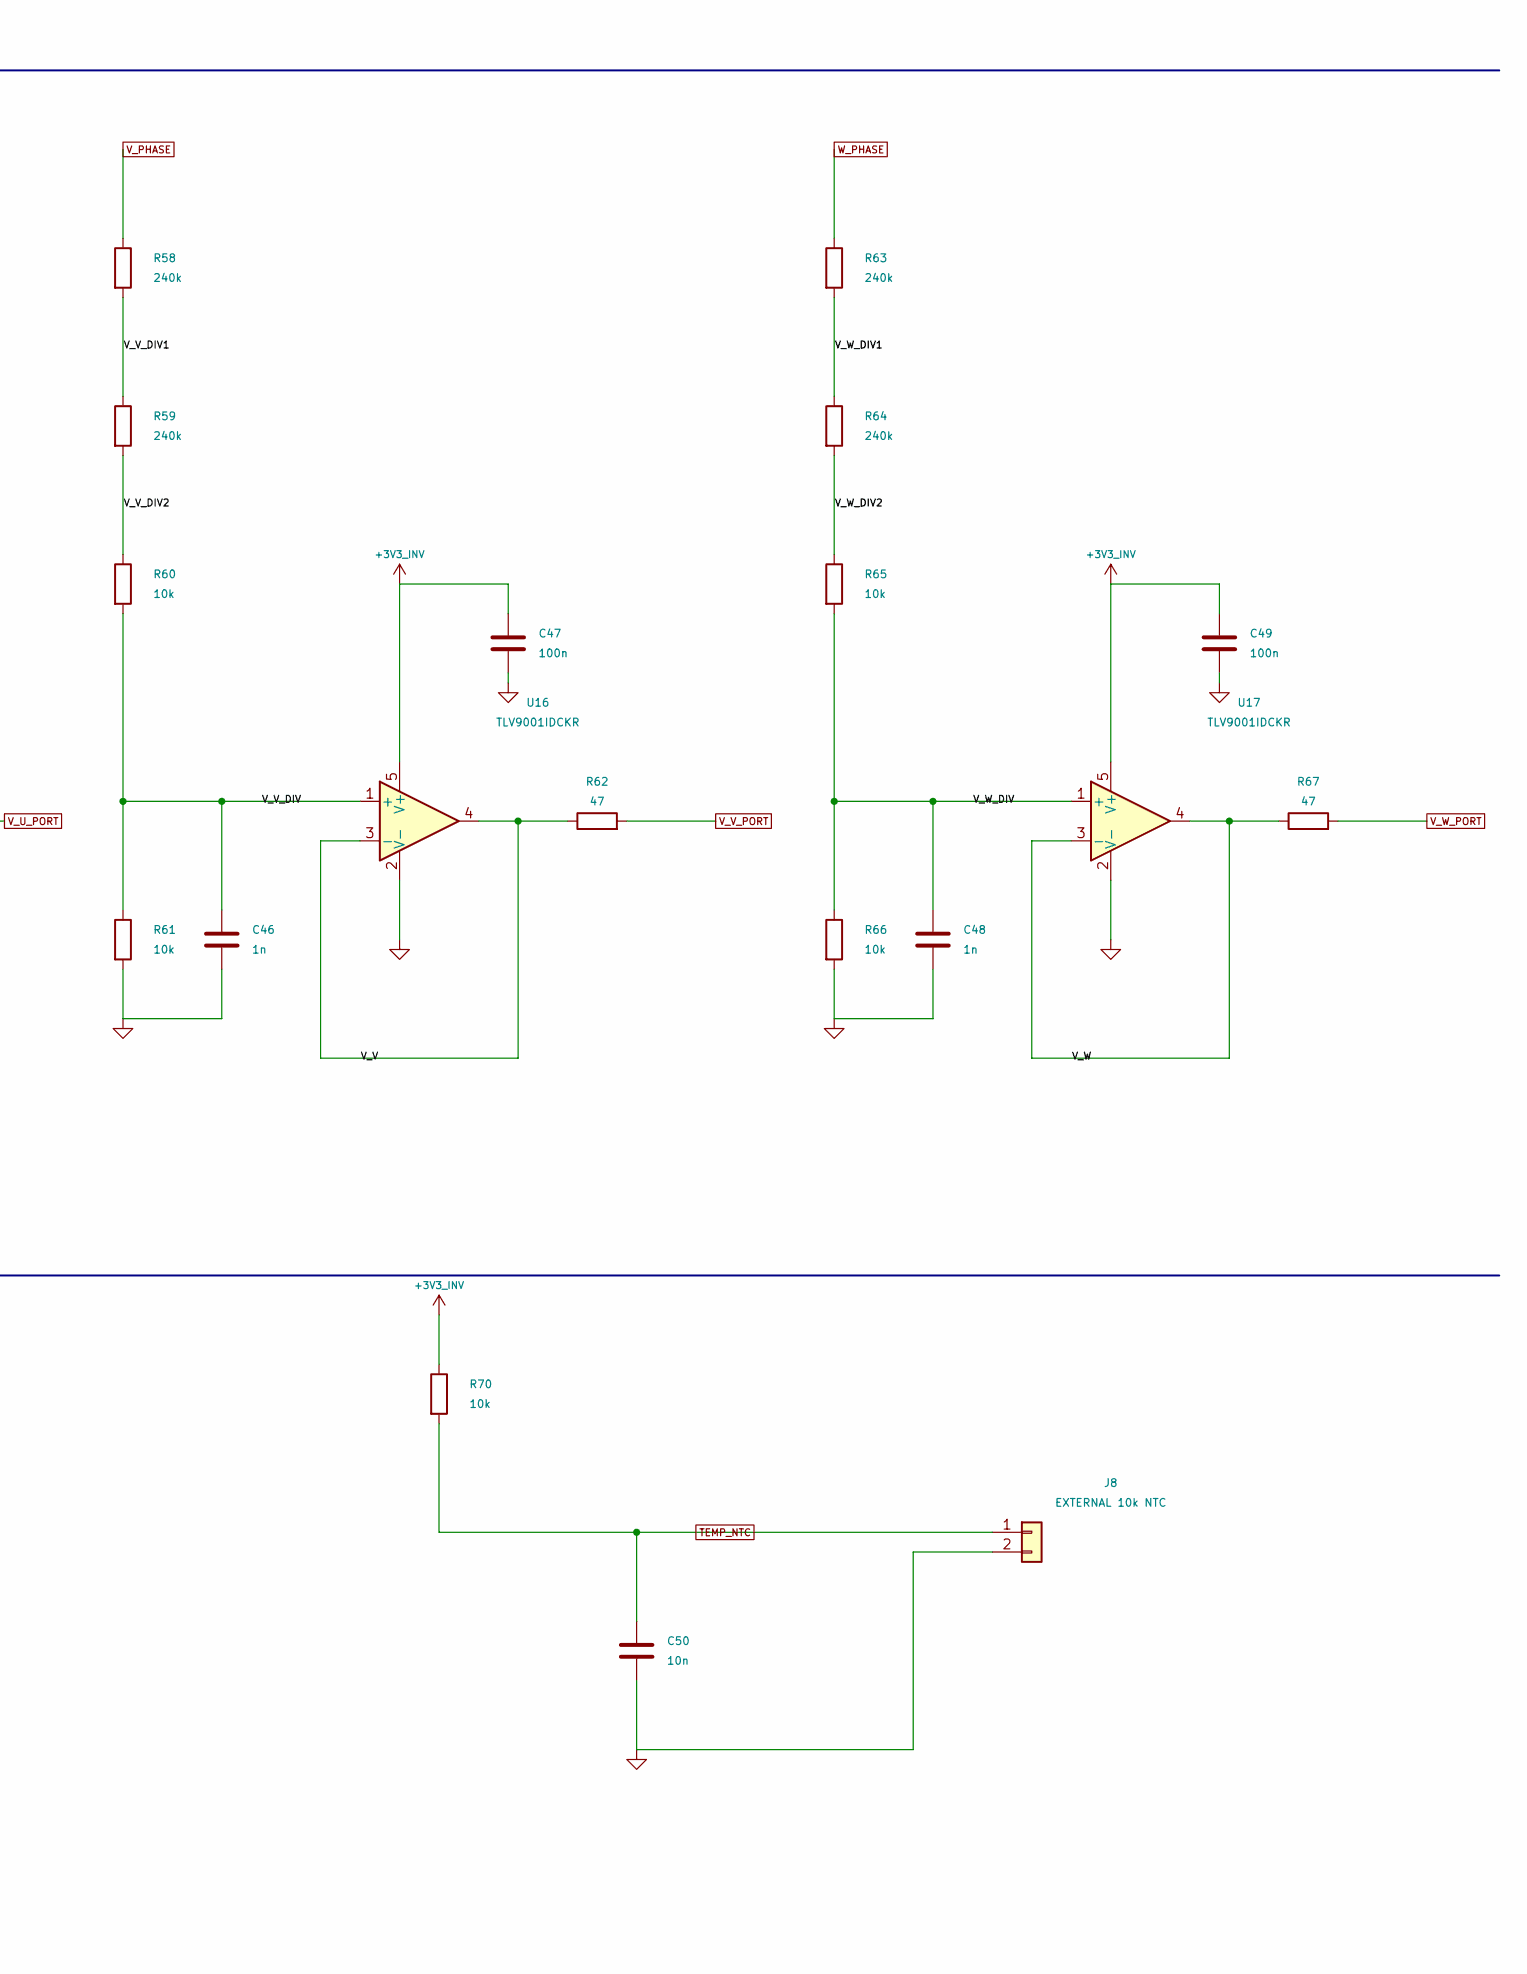
[picture p243: schematic voltage_sense.kicad_sch, Inverter - voltage and NTC sensing, part in row 1, column 2]

Parts:
C42: 100p; C_0402_1005Metric; Voltage_Rating 25V; MPN TBD
C43, C45, C47, C49: 100n; C_0402_1005Metric; Voltage_Rating 25V; MPN TBD
C44, C46, C48: 1n; C_0402_1005Metric; Voltage_Rating 25V; MPN TBD
C50: 10n; C_0402_1005Metric; Voltage_Rating 25V; MPN TBD
J8: EXTERNAL 10k NTC; PinHeader_HCTL_PZ127_1x02_P1.27mm_D0.70mm; MPN PZ127-1-02-Z
R48, R49, R53, R54, R58, R59, R63, R64: 240k; R_0805_2012Metric; Tolerance 0.1%; MPN TBD
R50, R51, R55, R56, R60, R61, R65, R66: 10k; R_0603_1608Metric; Tolerance 0.1%; MPN TBD
R52, R57, R62, R67: 47; R_0402_1005Metric; Tolerance 1%; MPN TBD
R68: 20k; R_0402_1005Metric; Tolerance 0.1%; MPN TBD
R69: 13k; R_0402_1005Metric; Tolerance 0.1%; MPN TBD
R70: 10k; R_0402_1005Metric; Tolerance 1%; MPN TBD
U14, U15, U16, U17: TLV9001IDCKR; SOT-353_SC-70-5; MPN TLV9001IDCKR

Connections:
+3V3_INV: C43.1, C45.1, C47.1, C49.1, R68.1, R70.1, U14.5 (V+), U15.5 (V+), U16.5 (V+), U17.5 (V+); also elsewhere on the board
/Voltage and NTC/V_DC_DIV: C42.1, R50.2, R51.1, U14.1 (+)
/Voltage and NTC/V_DC_DIV1: R48.2, R49.1
/Voltage and NTC/V_DC_DIV2: R49.2, R50.1
/Voltage and NTC/V_U: R57.1, U15.3 (-), U15.4
/Voltage and NTC/V_U_DIV: C44.1, R55.2, R56.1, U15.1 (+)
/Voltage and NTC/V_U_DIV1: R53.2, R54.1
/Voltage and NTC/V_U_DIV2: R54.2, R55.1
/Voltage and NTC/V_V: R62.1, U16.3 (-), U16.4
/Voltage and NTC/V_V_DIV: C46.1, R60.2, R61.1, U16.1 (+)
/Voltage and NTC/V_V_DIV1: R58.2, R59.1
/Voltage and NTC/V_V_DIV2: R59.2, R60.1
/Voltage and NTC/V_W: R67.1, U17.3 (-), U17.4
/Voltage and NTC/V_W_DIV: C48.1, R65.2, R66.1, U17.1 (+)
/Voltage and NTC/V_W_DIV1: R63.2, R64.1
/Voltage and NTC/V_W_DIV2: R64.2, R65.1
OV_REF_1V30: R68.2, R69.1; also elsewhere on the board
TEMP_NTC: C50.1, J8.1, R70.2; also elsewhere on the board
U_PHASE: R53.1; also elsewhere on the board
VBUS: R48.1; also elsewhere on the board
V_DC: R52.1, U14.3 (-), U14.4; also elsewhere on the board
V_DC_PORT: R52.2; also elsewhere on the board
V_PHASE: R58.1; also elsewhere on the board
V_U_PORT: R57.2; also elsewhere on the board
V_V_PORT: R62.2; also elsewhere on the board
V_W_PORT: R67.2; also elsewhere on the board
W_PHASE: R63.1; also elsewhere on the board

Notes on the sheet:
FOUR 50:1 VOLTAGE CHANNELS / COMPLETE DIVIDER TO BUFFER
BUS OVERVOLTAGE REFERENCE / EXTERNAL NTC
20k / 13k gives 1.30 V 65 V nominal bus trip at 50:1.
Raw phase sense is measured before an external LC filter. Bus RC ~0.98 us; phase RC ~9.8 us. External NTC nominal 10k; beta, physical placement and cable protection remain to be selected.

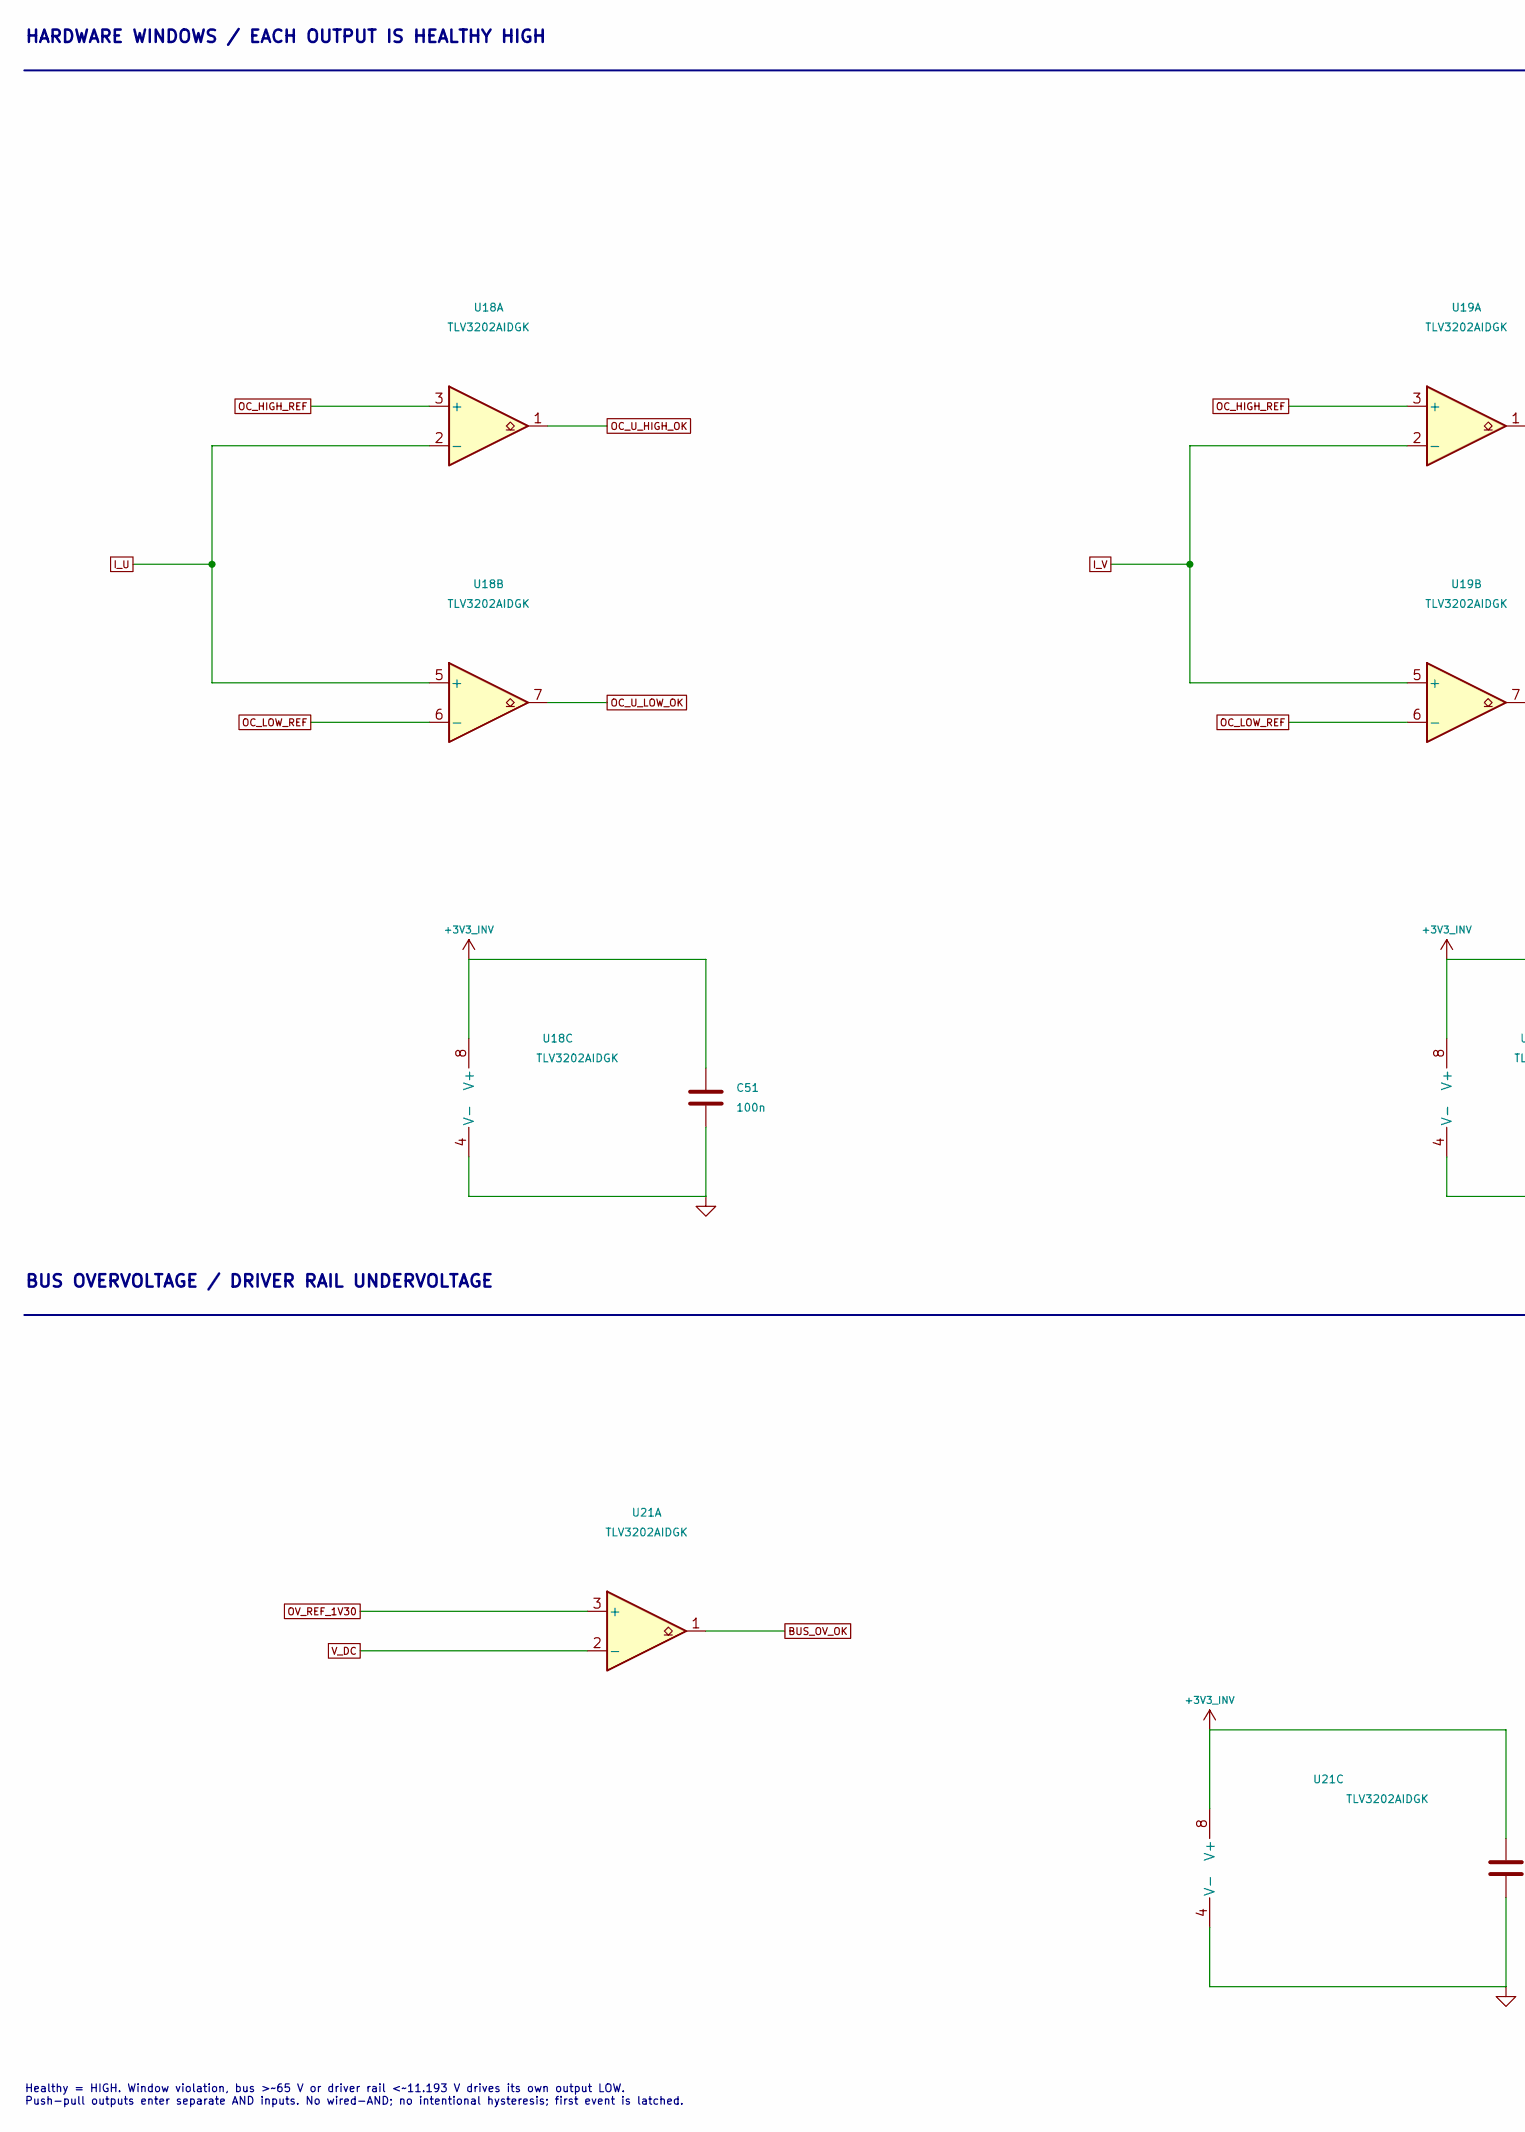
[picture p244: schematic comparators.kicad_sch, Inverter - current, bus voltage and driver rail comparators, part in row 1, column 1]

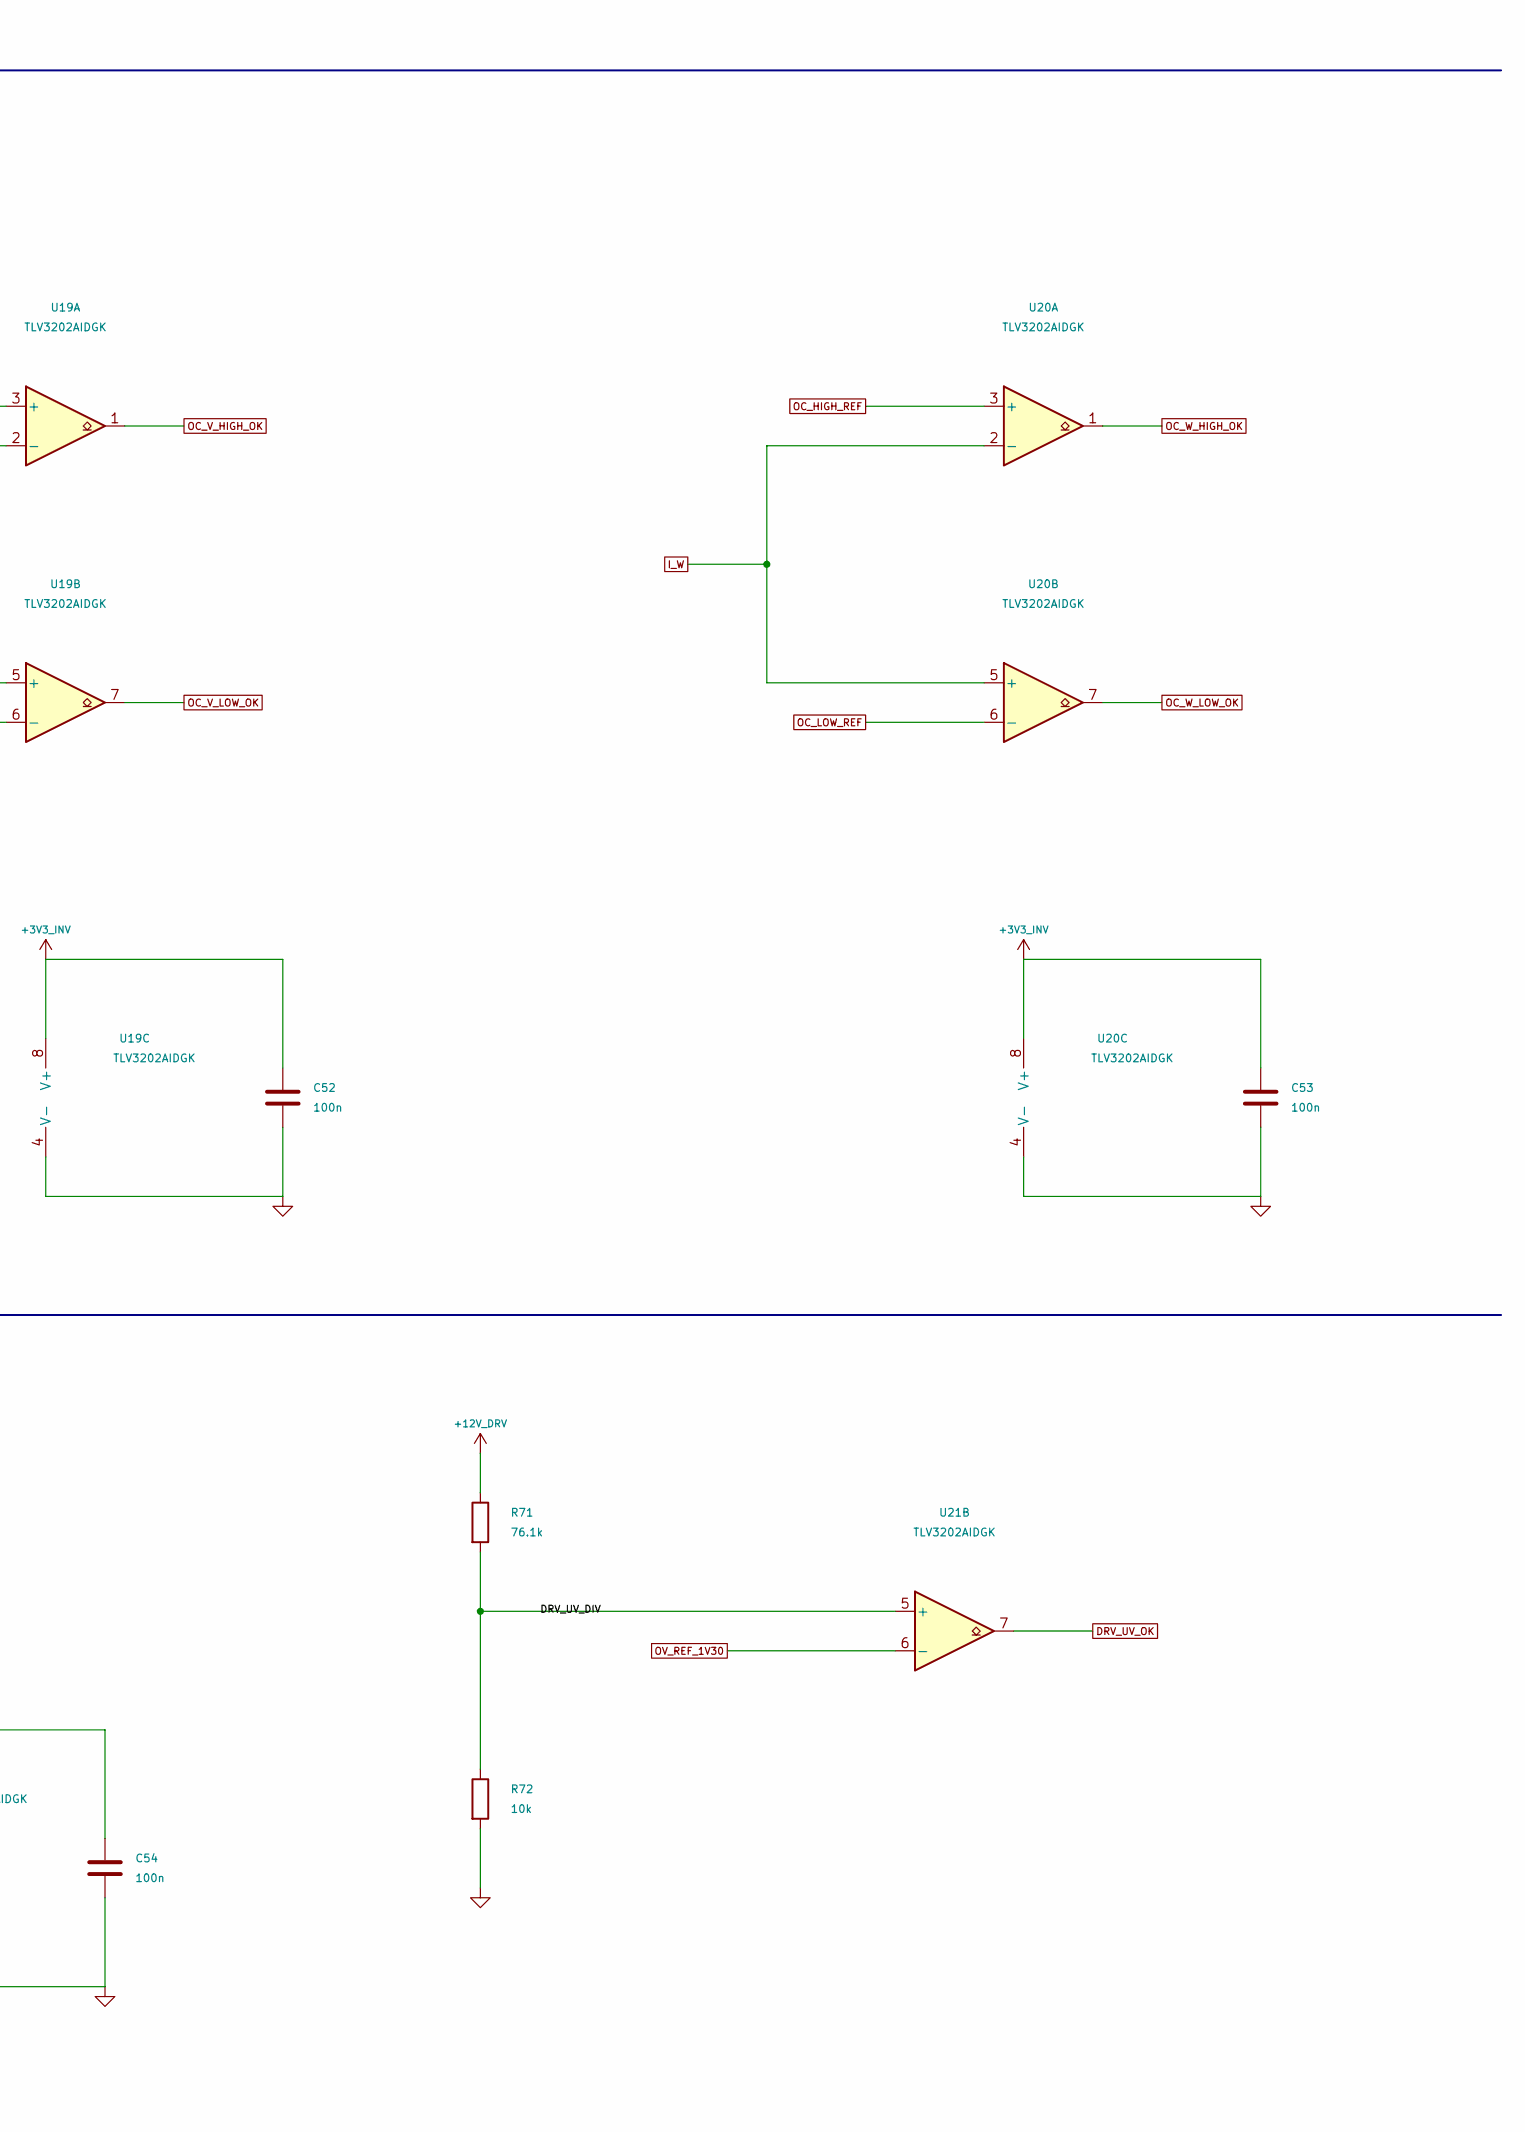
[picture p245: schematic comparators.kicad_sch, Inverter - current, bus voltage and driver rail comparators, part in row 1, column 2]

Parts:
C51, C52, C53: 100n; C_0603_1608Metric; Voltage_Rating 25V; MPN TBD
C54: 100n; C_0402_1005Metric; Voltage_Rating 25V; MPN TBD
R71: 76.1k; R_0402_1005Metric; Tolerance 0.1%; MPN TBD
R72: 10k; R_0402_1005Metric; Tolerance 0.1%; MPN TBD
U18, U19, U20, U21: TLV3202AIDGK; VSSOP-8_3x3mm_P0.65mm; MPN TLV3202AIDGK

Connections:
+3V3_INV: C51.1, C52.1, C53.1, C54.1, U18.8 (V+), U19.8 (V+), U20.8 (V+), U21.8 (V+); also elsewhere on the board
+12V_DRV: R71.1; also elsewhere on the board
/Analog protection/DRV_UV_DIV: R71.2, R72.1, U21.5 (+)
BUS_OV_OK: U21.1; also elsewhere on the board
DRV_UV_OK: U21.7; also elsewhere on the board
I_U: U18.2 (-), U18.5 (+); also elsewhere on the board
I_V: U19.2 (-), U19.5 (+); also elsewhere on the board
I_W: U20.2 (-), U20.5 (+); also elsewhere on the board
OC_HIGH_REF: U18.3 (+), U19.3 (+), U20.3 (+); also elsewhere on the board
OC_LOW_REF: U18.6 (-), U19.6 (-), U20.6 (-); also elsewhere on the board
OC_U_HIGH_OK: U18.1; also elsewhere on the board
OC_U_LOW_OK: U18.7; also elsewhere on the board
OC_V_HIGH_OK: U19.1; also elsewhere on the board
OC_V_LOW_OK: U19.7; also elsewhere on the board
OC_W_HIGH_OK: U20.1; also elsewhere on the board
OC_W_LOW_OK: U20.7; also elsewhere on the board
OV_REF_1V30: U21.3 (+), U21.6 (-); also elsewhere on the board
V_DC: U21.2 (-); also elsewhere on the board

Notes on the sheet:
HARDWARE WINDOWS / EACH OUTPUT IS HEALTHY HIGH
BUS OVERVOLTAGE / DRIVER RAIL UNDERVOLTAGE
Healthy = HIGH. Window violation, bus >~65 V or driver rail <~11.193 V drives its own output LOW. Push-pull outputs enter separate AND inputs. No wired-AND; no intentional hysteresis; first event is latched.

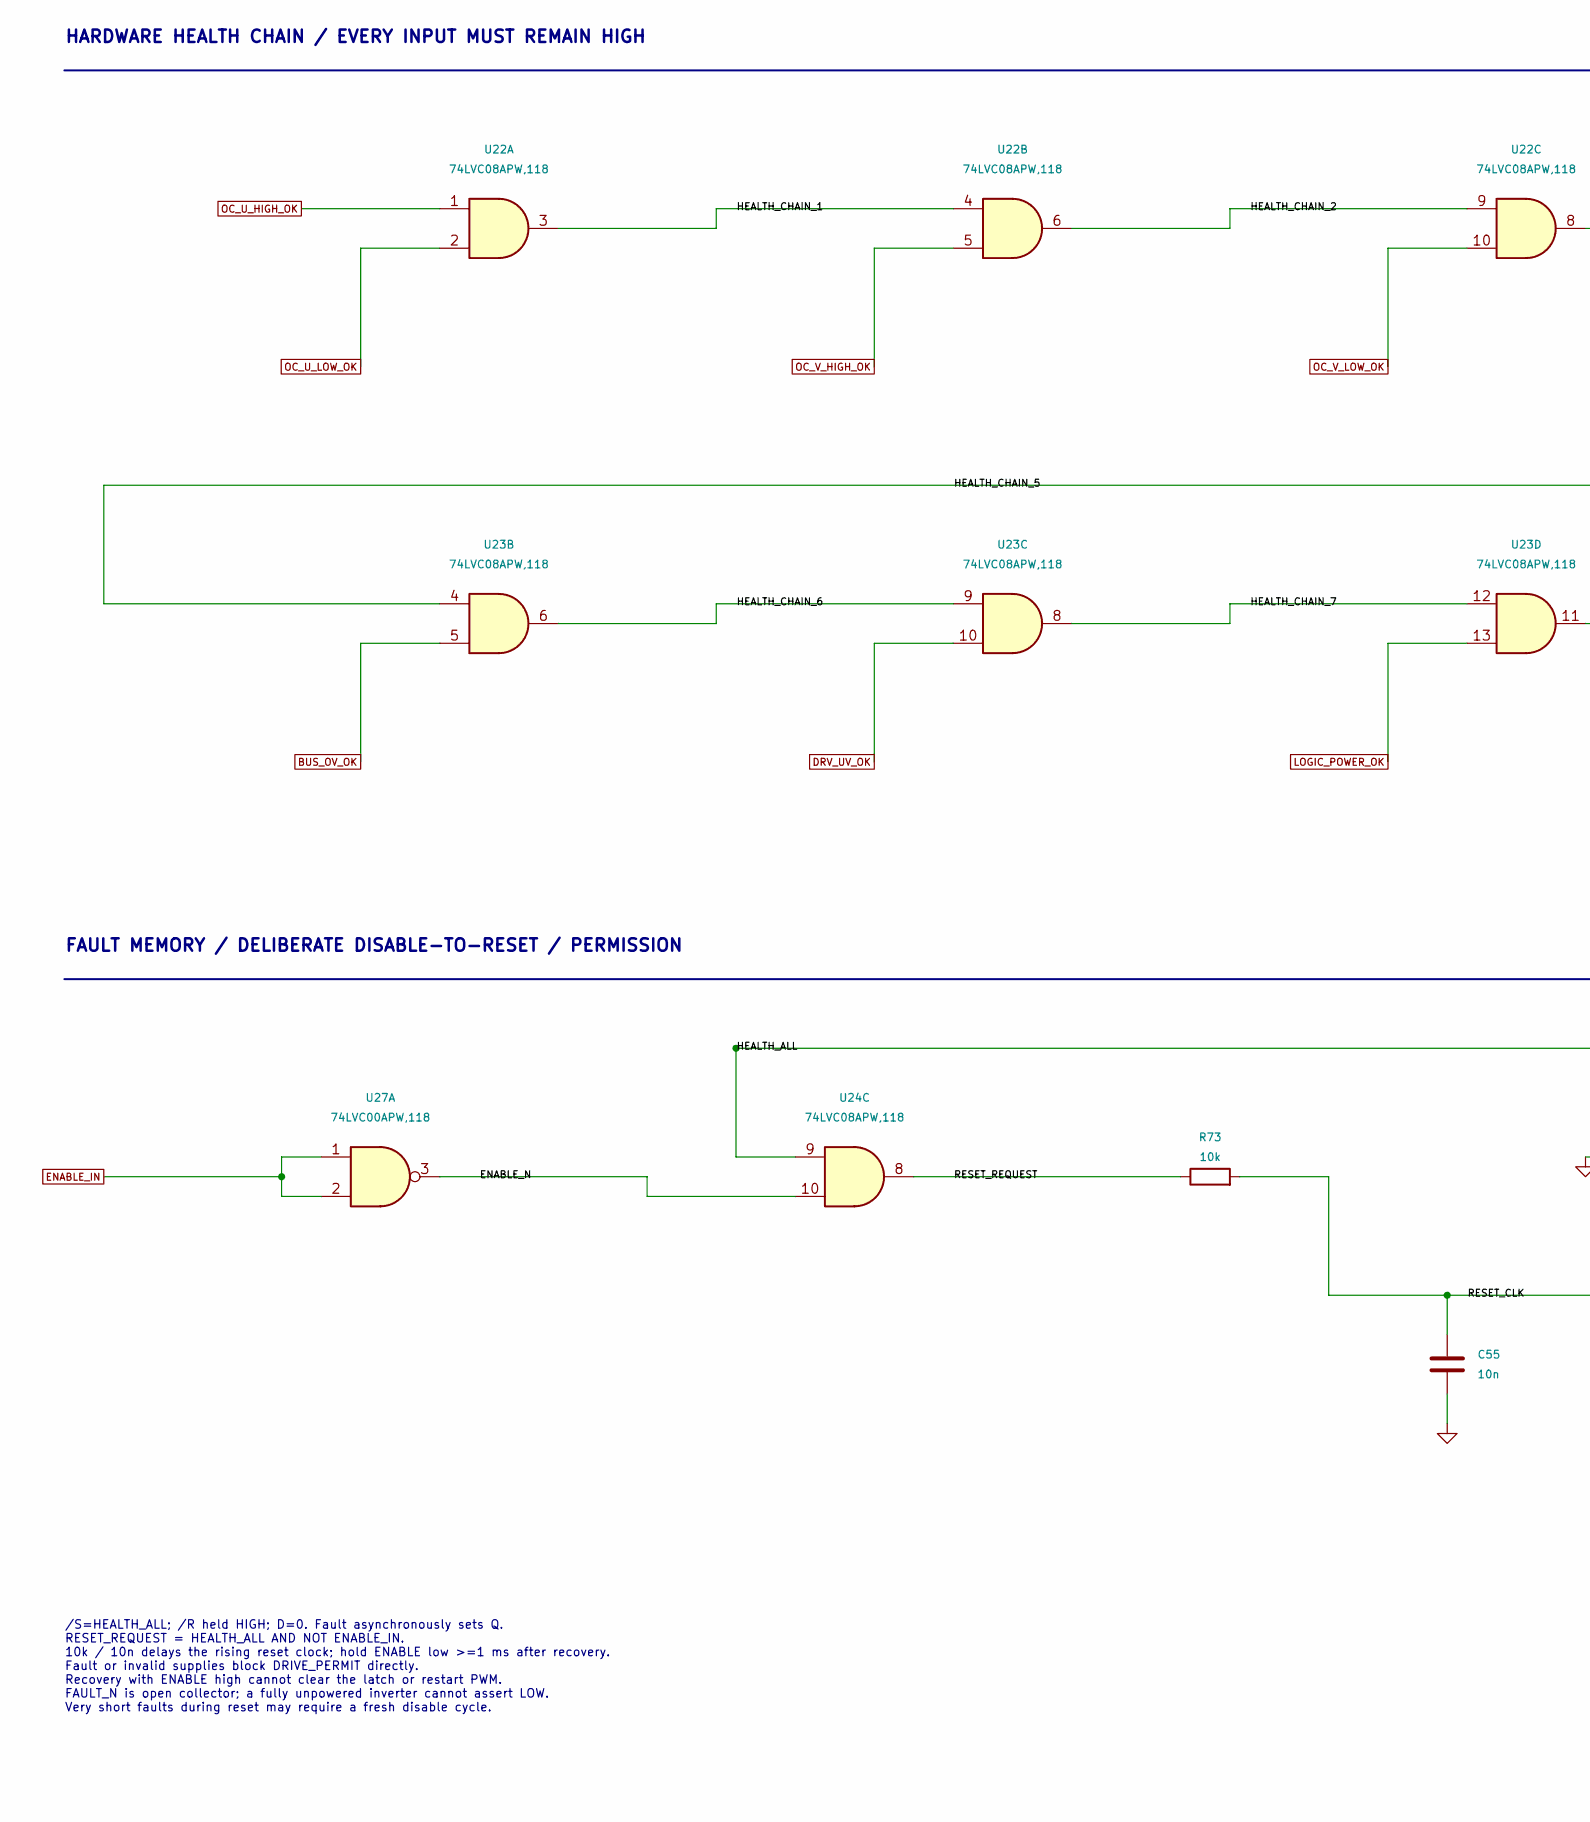
[picture p246: schematic fault_logic.kicad_sch, Inverter - fault aggregation and reset latch, part in row 1, column 1]

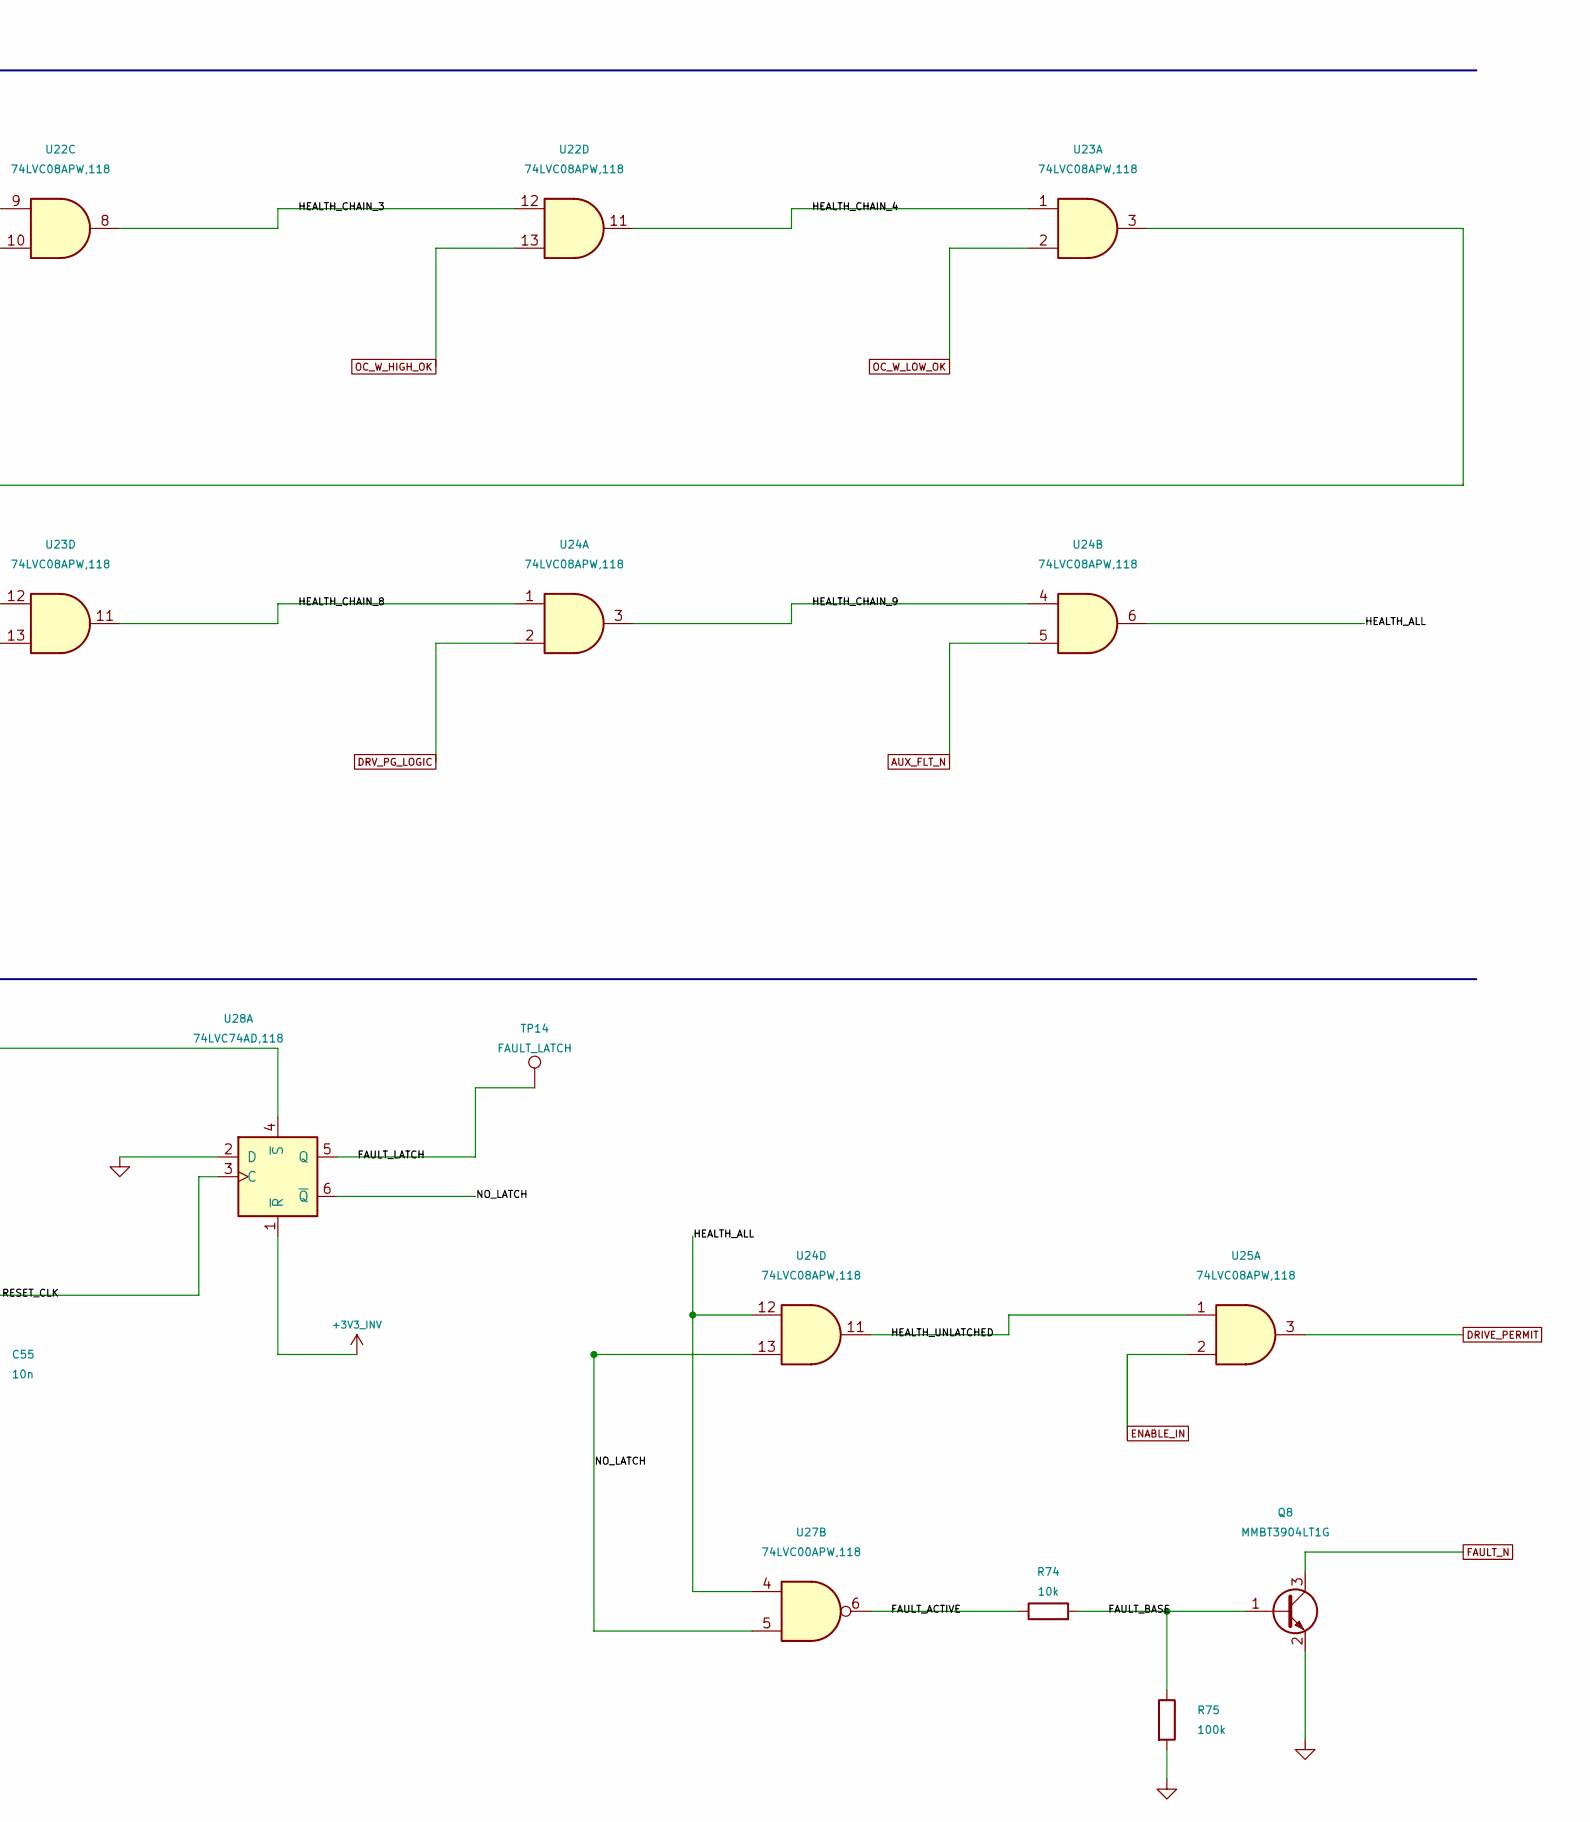
[picture p247: schematic fault_logic.kicad_sch, Inverter - fault aggregation and reset latch, part in row 1, column 2]

Parts:
C55: 10n; C_0402_1005Metric; Voltage_Rating 25V; MPN TBD
Q8: MMBT3904LT1G; SOT-23; MPN MMBT3904LT1G
R73, R74: 10k; R_0402_1005Metric; Tolerance 1%; MPN TBD
R75: 100k; R_0402_1005Metric; Tolerance 1%; MPN TBD
TP14: FAULT_LATCH; TestPoint_Pad_D1.5mm
U22, U23, U24, U25: 74LVC08APW,118; TSSOP-14_4.4x5mm_P0.65mm; MPN 74LVC08APW,118
U27: 74LVC00APW,118; TSSOP-14_4.4x5mm_P0.65mm; MPN 74LVC00APW,118
U28: 74LVC74AD,118; SOIC-14_3.9x8.7mm_P1.27mm; MPN 74LVC74AD,118

Connections:
+3V3_INV: U28.1 (~R); also elsewhere on the board
/Hardware latch/ENABLE_N: U24.10, U27.3
/Hardware latch/FAULT_ACTIVE: R74.1, U27.6
/Hardware latch/FAULT_BASE: Q8.1 (B), R74.2, R75.1
/Hardware latch/FAULT_LATCH: TP14.1, U28.5 (Q)
/Hardware latch/HEALTH_ALL: U24.6, U24.9, U24.12, U27.4, U28.4 (~S)
/Hardware latch/HEALTH_CHAIN_1: U22.3, U22.4
/Hardware latch/HEALTH_CHAIN_2: U22.6, U22.9
/Hardware latch/HEALTH_CHAIN_3: U22.8, U22.12
/Hardware latch/HEALTH_CHAIN_4: U22.11, U23.1
/Hardware latch/HEALTH_CHAIN_5: U23.3, U23.4
/Hardware latch/HEALTH_CHAIN_6: U23.6, U23.9
/Hardware latch/HEALTH_CHAIN_7: U23.8, U23.12
/Hardware latch/HEALTH_CHAIN_8: U23.11, U24.1
/Hardware latch/HEALTH_CHAIN_9: U24.3, U24.4
/Hardware latch/HEALTH_UNLATCHED: U24.11, U25.1
/Hardware latch/NO_LATCH: U24.13, U27.5, U28.6 (~Q)
/Hardware latch/RESET_CLK: C55.1, R73.2, U28.3 (C)
/Hardware latch/RESET_REQUEST: R73.1, U24.8
AUX_FLT_N: U24.5; also elsewhere on the board
BUS_OV_OK: U23.5; also elsewhere on the board
DRIVE_PERMIT: U25.3; also elsewhere on the board
DRV_PG_LOGIC: U24.2; also elsewhere on the board
DRV_UV_OK: U23.10; also elsewhere on the board
ENABLE_IN: U25.2, U27.1, U27.2; also elsewhere on the board
FAULT_N: Q8.3 (C); also elsewhere on the board
LOGIC_POWER_OK: U23.13; also elsewhere on the board
OC_U_HIGH_OK: U22.1; also elsewhere on the board
OC_U_LOW_OK: U22.2; also elsewhere on the board
OC_V_HIGH_OK: U22.5; also elsewhere on the board
OC_V_LOW_OK: U22.10; also elsewhere on the board
OC_W_HIGH_OK: U22.13; also elsewhere on the board
OC_W_LOW_OK: U23.2; also elsewhere on the board

Notes on the sheet:
HARDWARE HEALTH CHAIN / EVERY INPUT MUST REMAIN HIGH
FAULT MEMORY / DELIBERATE DISABLE-TO-RESET / PERMISSION
/S=HEALTH_ALL; /R held HIGH; D=0. Fault asynchronously sets Q. RESET_REQUEST = HEALTH_ALL AND NOT ENABLE_IN. 10k / 10n delays the rising reset clock; hold ENABLE low >=1 ms after recovery. Fault or invalid supplies block DRIVE_PERMIT directly. Recovery with ENABLE high cannot clear the latch or res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
