leolei2012/power_system/inverter/hardware/review/compact_fine_smoke/inverter.kicad_pcb

## KiCad design inverter/history/integrated_rev_c_60x60/inverter.kicad_pcb (continued)

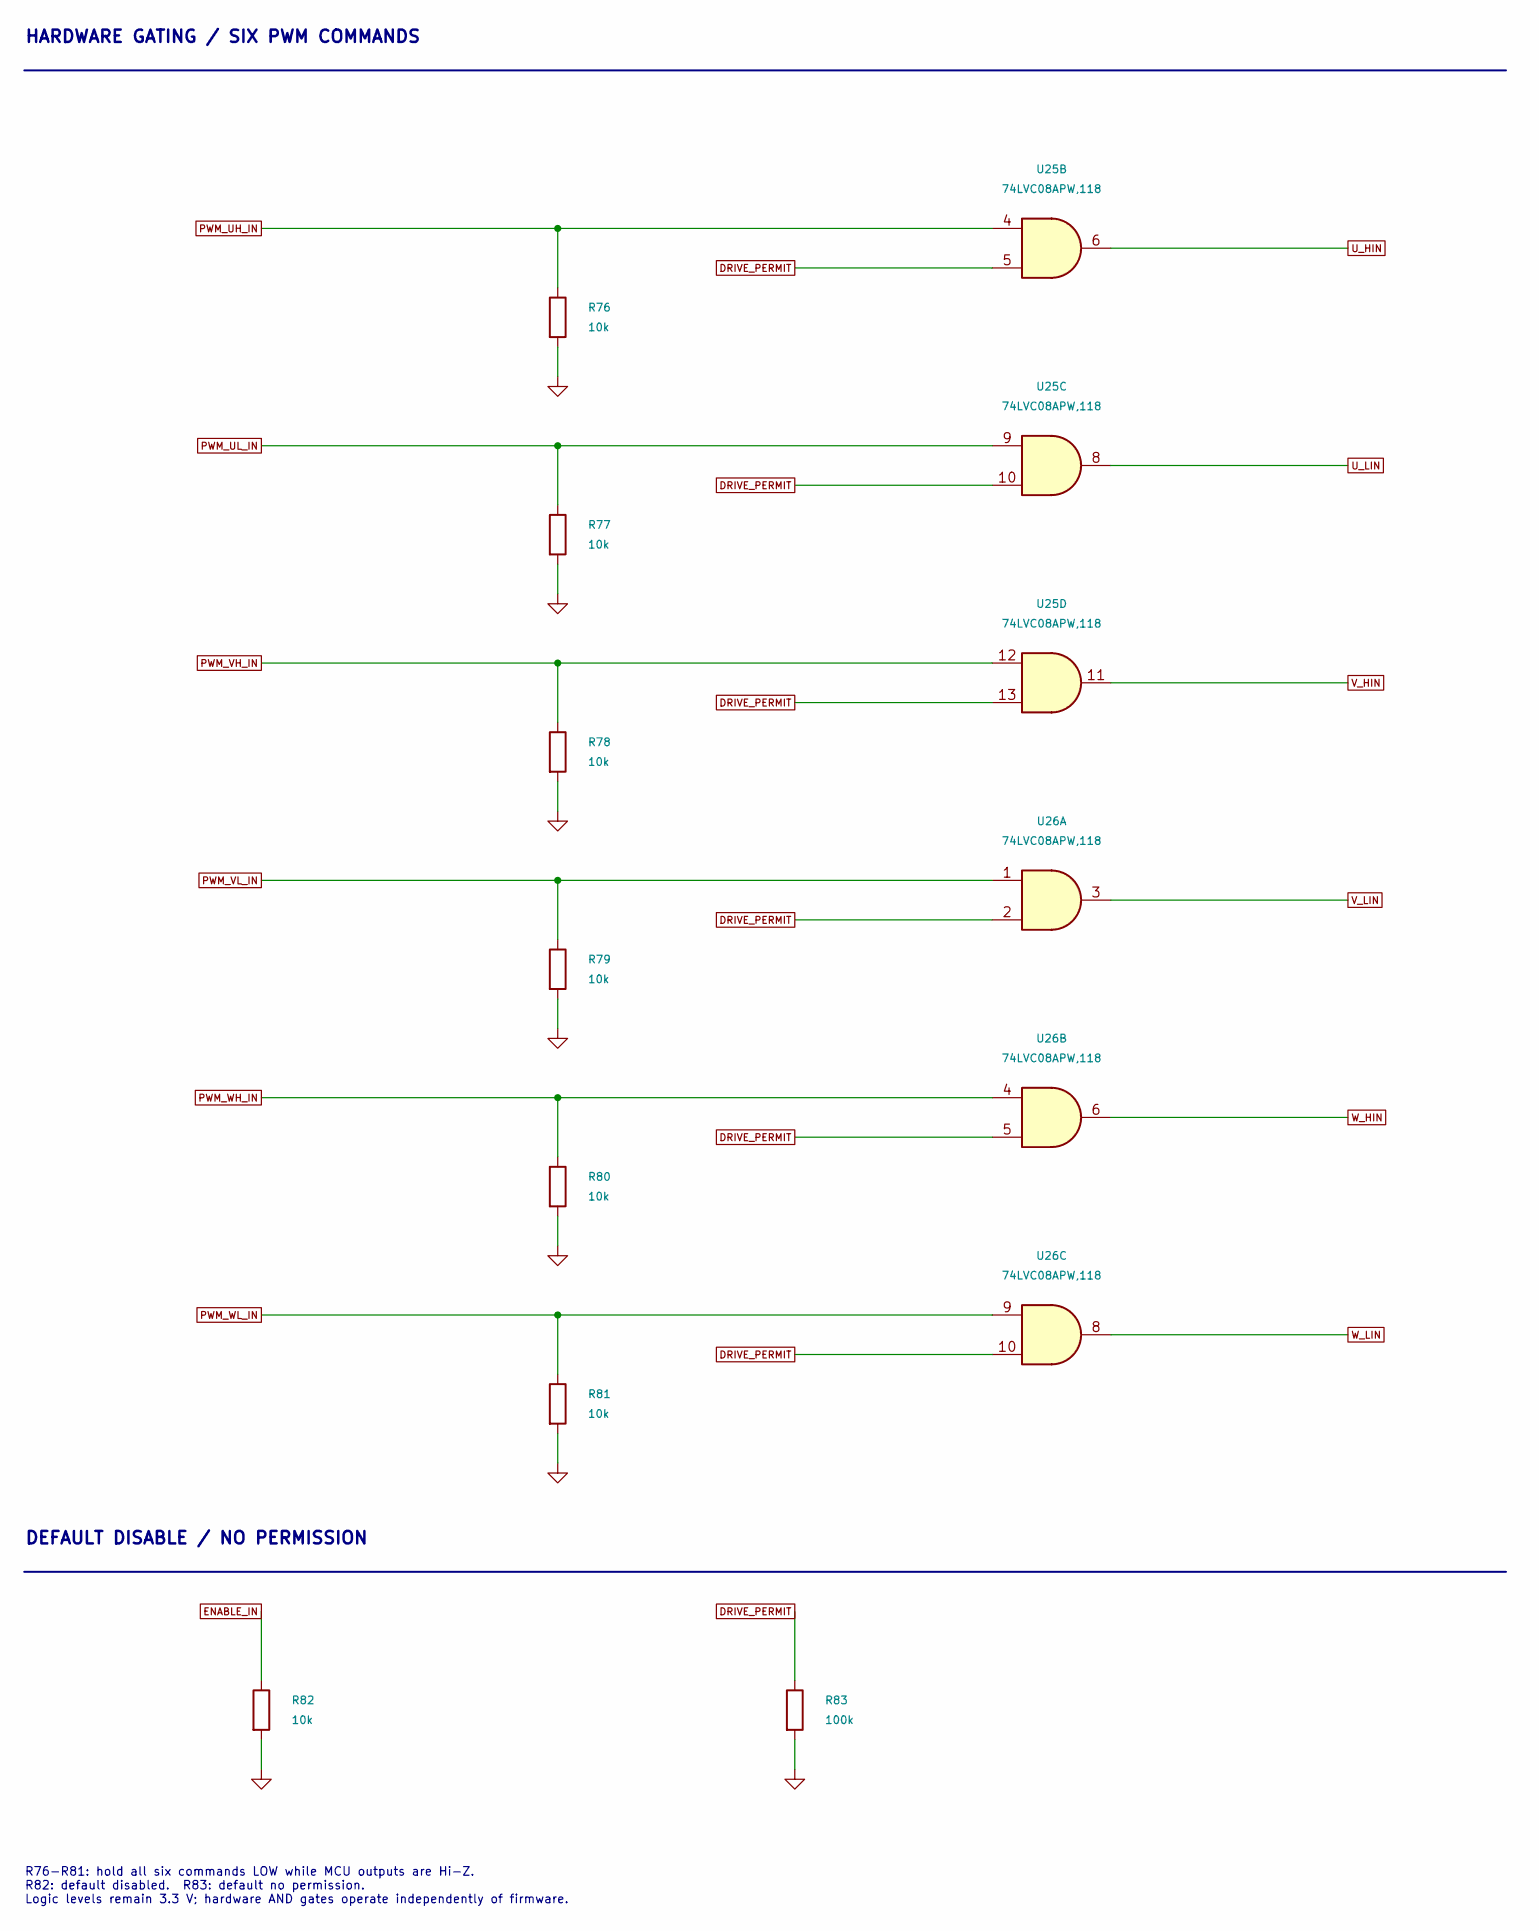
[picture p248: schematic control_interface.kicad_sch, Inverter - local six PWM hardware gates, part in row 1, column 1]

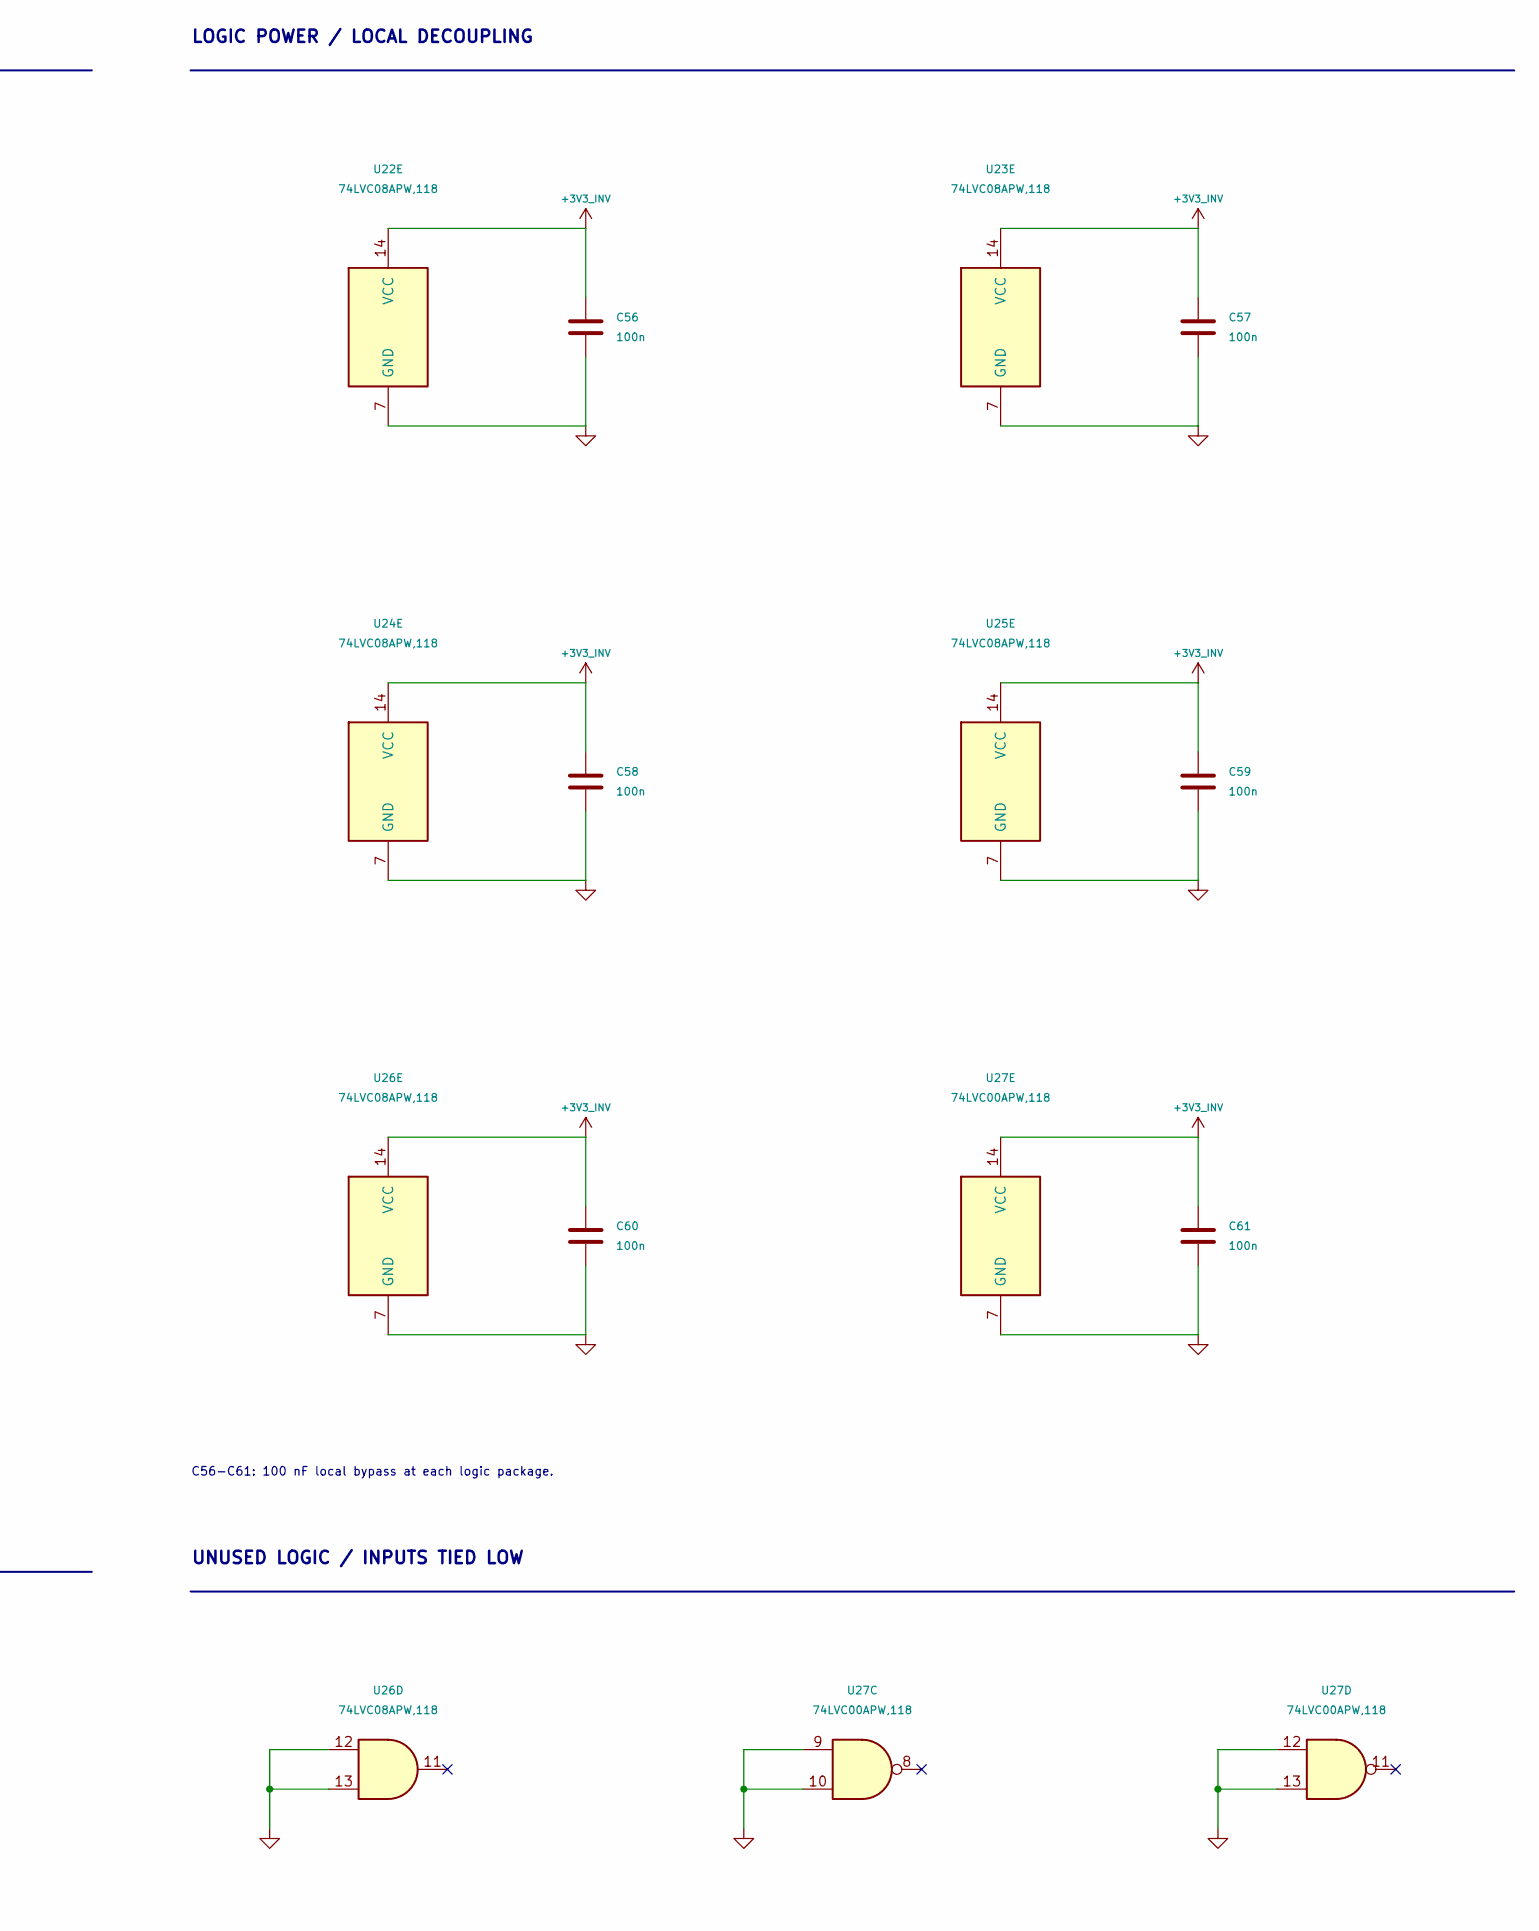
[picture p249: schematic control_interface.kicad_sch, Inverter - local six PWM hardware gates, part in row 1, column 2]

Parts:
C56, C57, C58, C59, C60, C61: 100n; C_0402_1005Metric; Voltage_Rating 25V; MPN TBD
R76, R77, R78, R79, R80, R81, R82: 10k; R_0402_1005Metric; Tolerance 1%; MPN TBD
R83: 100k; R_0402_1005Metric; Tolerance 1%; MPN TBD
U22, U23, U24, U25, U26: 74LVC08APW,118; TSSOP-14_4.4x5mm_P0.65mm; MPN 74LVC08APW,118
U27: 74LVC00APW,118; TSSOP-14_4.4x5mm_P0.65mm; MPN 74LVC00APW,118

Connections:
+3V3_INV: C56.1, C57.1, C58.1, C59.1, C60.1, C61.1, U22.14 (VCC), U23.14 (VCC), U24.14 (VCC), U25.14 (VCC), U26.14 (VCC), U27.14 (VCC); also elsewhere on the board
DRIVE_PERMIT: R83.1, U25.5, U25.10, U25.13, U26.2, U26.5, U26.10; also elsewhere on the board
ENABLE_IN: R82.1; also elsewhere on the board
PWM_UH_IN: R76.1, U25.4; also elsewhere on the board
PWM_UL_IN: R77.1, U25.9; also elsewhere on the board
PWM_VH_IN: R78.1, U25.12; also elsewhere on the board
PWM_VL_IN: R79.1, U26.1; also elsewhere on the board
PWM_WH_IN: R80.1, U26.4; also elsewhere on the board
PWM_WL_IN: R81.1, U26.9; also elsewhere on the board
U_HIN: U25.6; also elsewhere on the board
U_LIN: U25.8; also elsewhere on the board
V_HIN: U25.11; also elsewhere on the board
V_LIN: U26.3; also elsewhere on the board
W_HIN: U26.6; also elsewhere on the board
W_LIN: U26.8; also elsewhere on the board

Notes on the sheet:
HARDWARE GATING / SIX PWM COMMANDS
LOGIC POWER / LOCAL DECOUPLING
DEFAULT DISABLE / NO PERMISSION
R76-R81: hold all six commands LOW while MCU outputs are Hi-Z. R82: default disabled. R83: default no permission. Logic levels remain 3.3 V; hardware AND gates operate independently of firmware.
C56-C61: 100 nF local bypass at each logic package.
UNUSED LOGIC / INPUTS TIED LOW

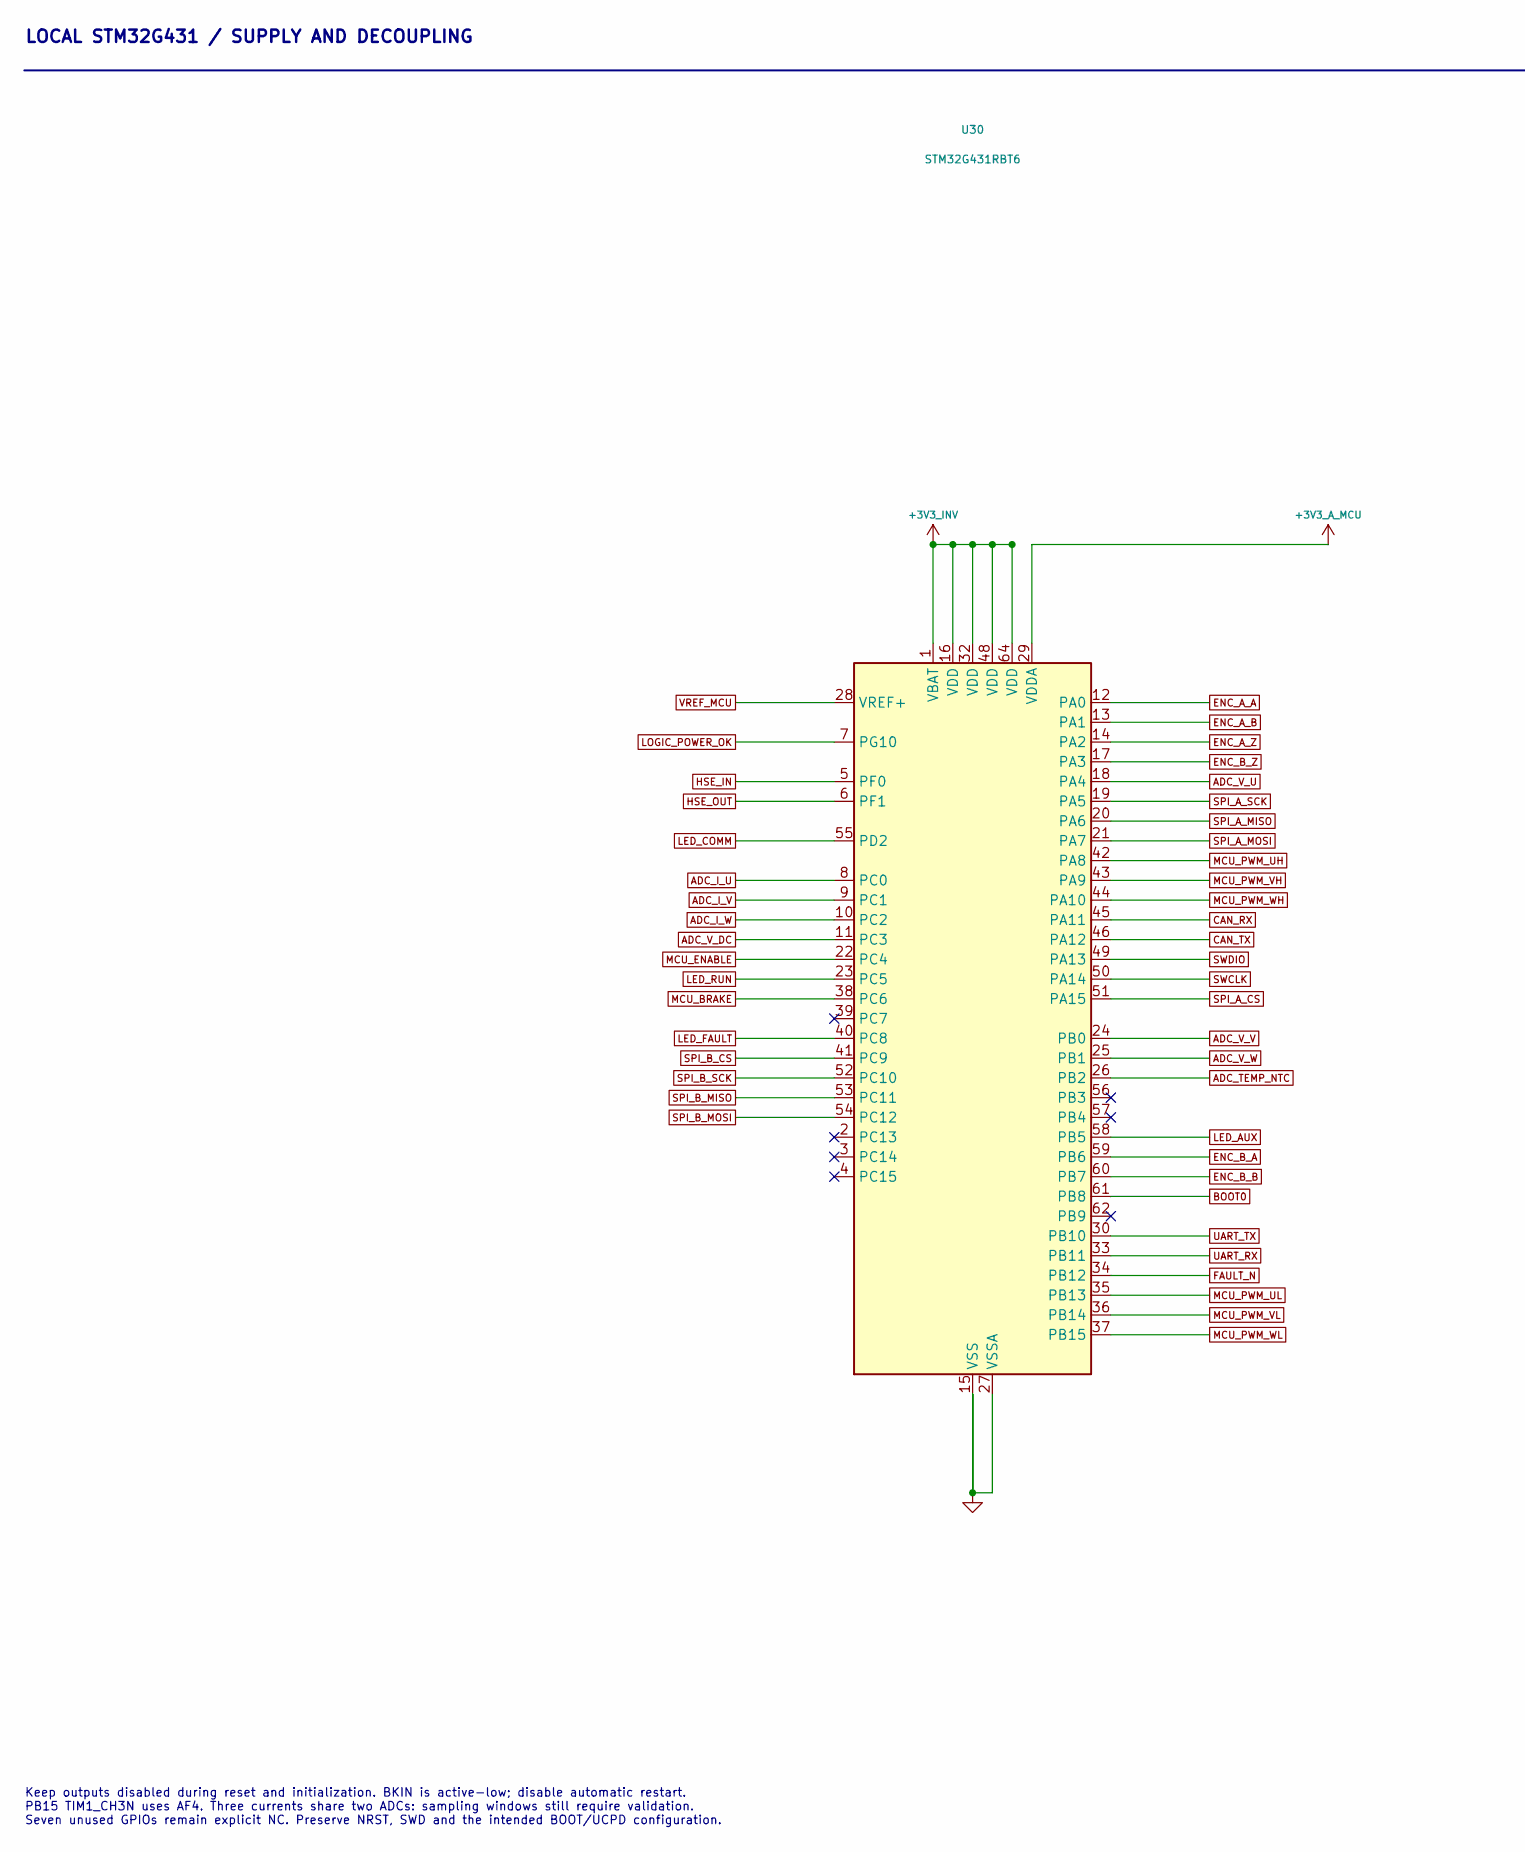
[picture p250: schematic mcu.kicad_sch, Inverter - STM32G431 minimum system, part in row 1, column 1]

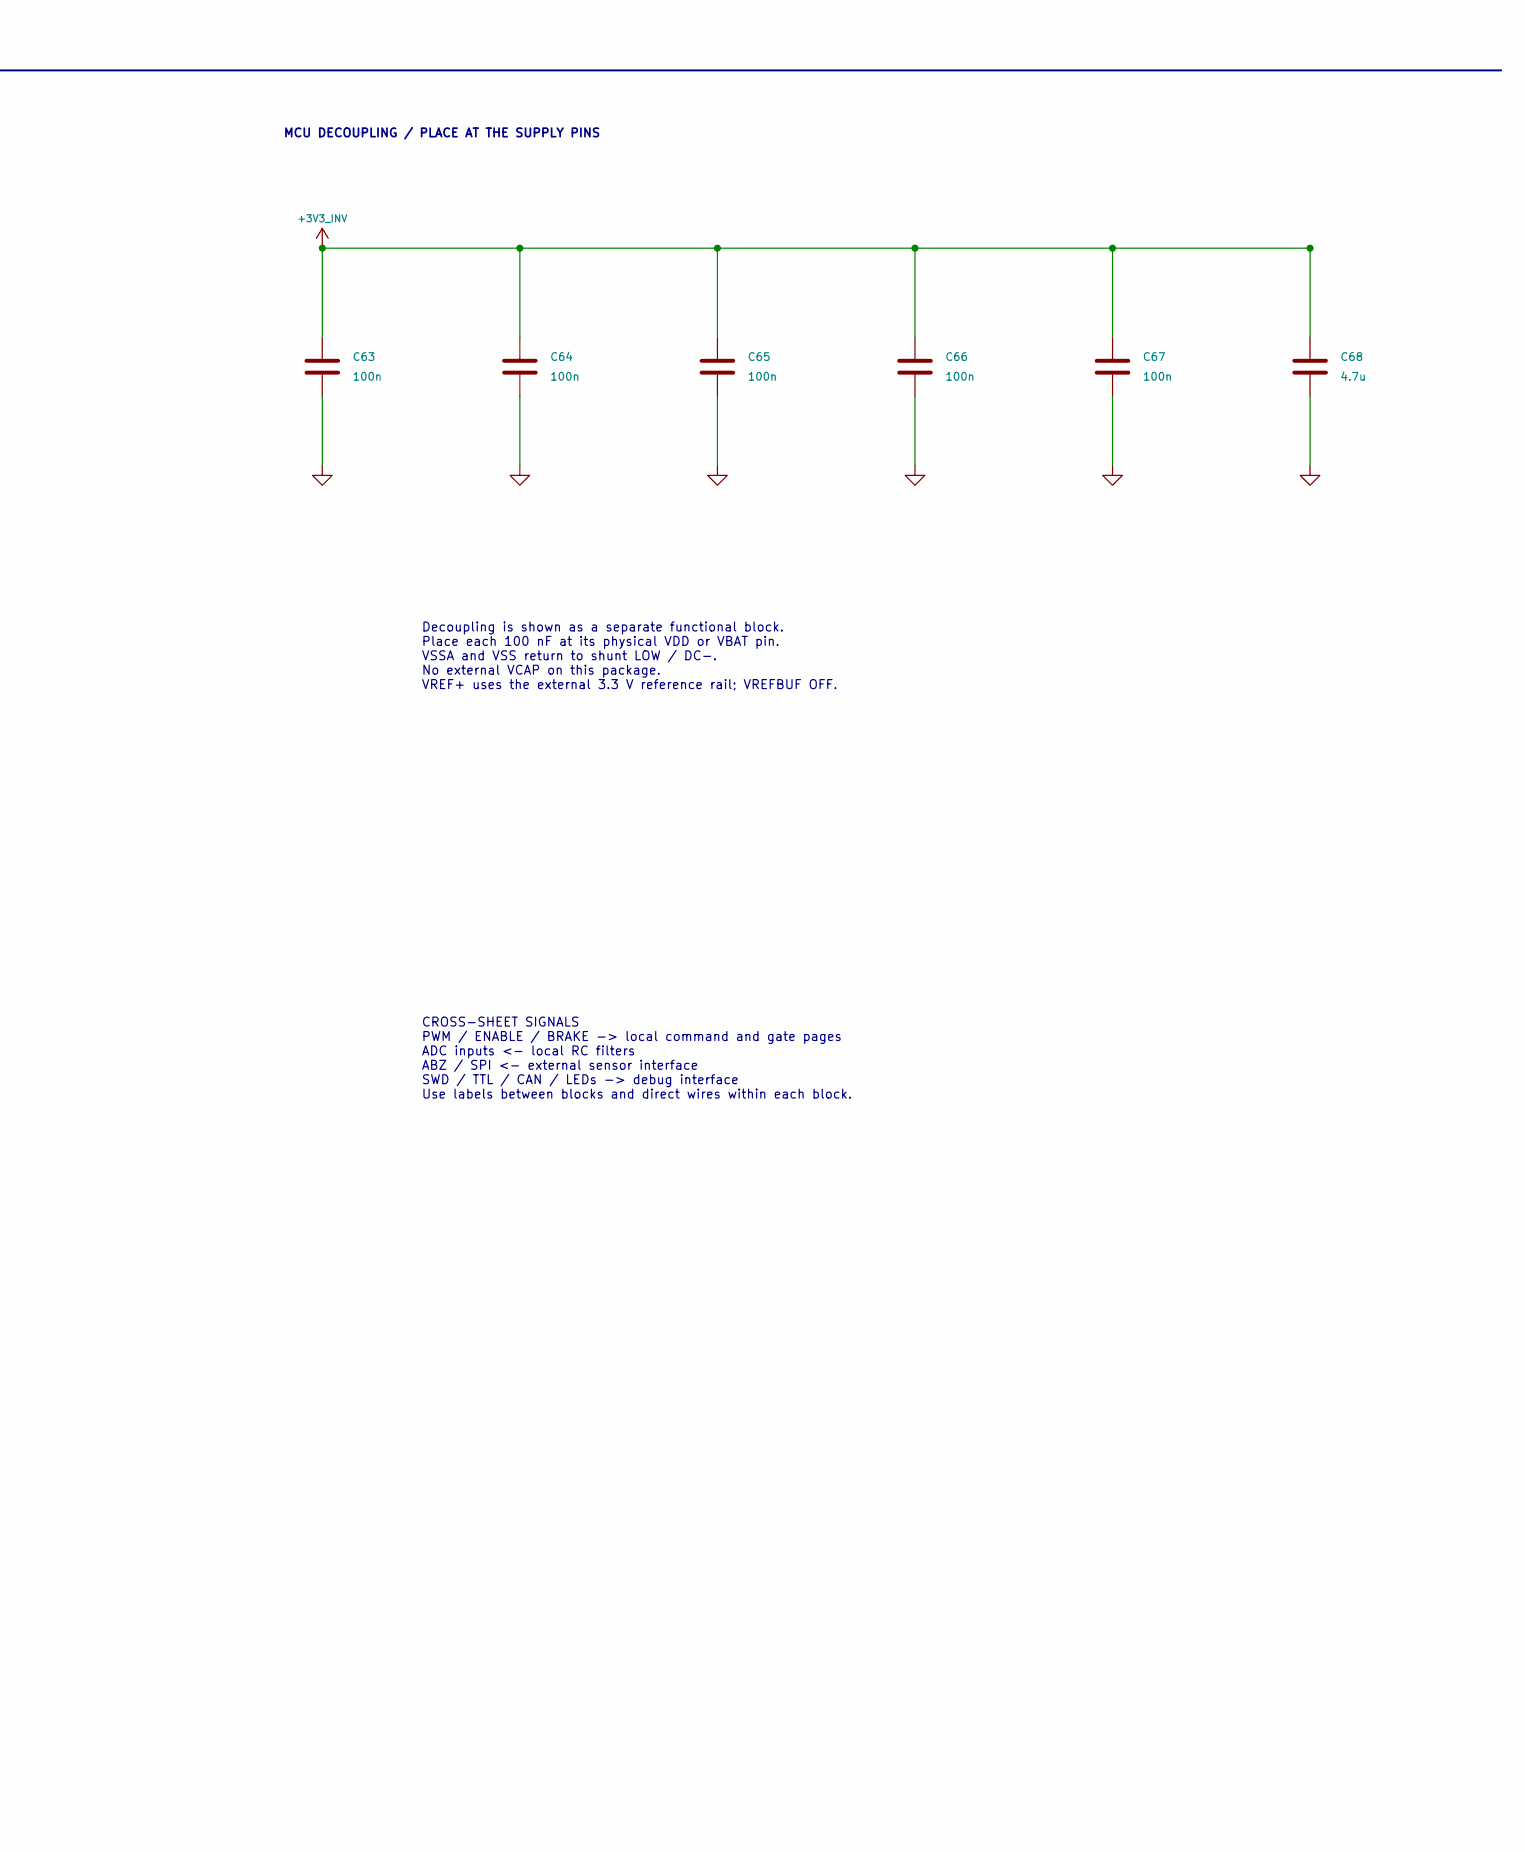
[picture p251: schematic mcu.kicad_sch, Inverter - STM32G431 minimum system, part in row 1, column 2]

Parts:
C63, C64, C65, C66, C67: 100n; C_0402_1005Metric; Voltage_Rating 16 V minimum; MPN TBD
C68: 4.7u; C_0603_1608Metric; Voltage_Rating 16 V minimum; MPN TBD
U30: STM32G431RBT6; LQFP-64_10x10mm_P0.5mm; MPN STM32G431RBT6

Connections:
+3V3_A_MCU: U30.29 (VDDA); also elsewhere on the board
+3V3_INV: C63.1, C64.1, C65.1, C66.1, C67.1, C68.1, U30.1 (VBAT), U30.16 (VDD), U30.32 (VDD), U30.48 (VDD), U30.64 (VDD); also elsewhere on the board
ADC_I_U: U30.8 (PC0); also elsewhere on the board
ADC_I_V: U30.9 (PC1); also elsewhere on the board
ADC_I_W: U30.10 (PC2); also elsewhere on the board
ADC_TEMP_NTC: U30.26 (PB2); also elsewhere on the board
ADC_V_DC: U30.11 (PC3); also elsewhere on the board
ADC_V_U: U30.18 (PA4); also elsewhere on the board
ADC_V_V: U30.24 (PB0); also elsewhere on the board
ADC_V_W: U30.25 (PB1); also elsewhere on the board
BOOT0: U30.61 (PB8); also elsewhere on the board
CAN_RX: U30.45 (PA11); also elsewhere on the board
CAN_TX: U30.46 (PA12); also elsewhere on the board
ENC_A_A: U30.12 (PA0); also elsewhere on the board
ENC_A_B: U30.13 (PA1); also elsewhere on the board
ENC_A_Z: U30.14 (PA2); also elsewhere on the board
ENC_B_A: U30.59 (PB6); also elsewhere on the board
ENC_B_B: U30.60 (PB7); also elsewhere on the board
ENC_B_Z: U30.17 (PA3); also elsewhere on the board
FAULT_N: U30.34 (PB12); also elsewhere on the board
HSE_IN: U30.5 (PF0); also elsewhere on the board
HSE_OUT: U30.6 (PF1); also elsewhere on the board
LED_AUX: U30.58 (PB5); also elsewhere on the board
LED_COMM: U30.55 (PD2); also elsewhere on the board
LED_FAULT: U30.40 (PC8); also elsewhere on the board
LED_RUN: U30.23 (PC5); also elsewhere on the board
LOGIC_POWER_OK: U30.7 (PG10); also elsewhere on the board
MCU_BRAKE: U30.38 (PC6); also elsewhere on the board
MCU_ENABLE: U30.22 (PC4); also elsewhere on the board
MCU_PWM_UH: U30.42 (PA8); also elsewhere on the board
MCU_PWM_UL: U30.35 (PB13); also elsewhere on the board
MCU_PWM_VH: U30.43 (PA9); also elsewhere on the board
MCU_PWM_VL: U30.36 (PB14); also elsewhere on the board
MCU_PWM_WH: U30.44 (PA10); also elsewhere on the board
MCU_PWM_WL: U30.37 (PB15); also elsewhere on the board
SPI_A_CS: U30.51 (PA15); also elsewhere on the board
SPI_A_MISO: U30.20 (PA6); also elsewhere on the board
SPI_A_MOSI: U30.21 (PA7); also elsewhere on the board
SPI_A_SCK: U30.19 (PA5); also elsewhere on the board
SPI_B_CS: U30.41 (PC9); also elsewhere on the board
SPI_B_MISO: U30.53 (PC11); also elsewhere on the board
SPI_B_MOSI: U30.54 (PC12); also elsewhere on the board
SPI_B_SCK: U30.52 (PC10); also elsewhere on the board
SWCLK: U30.50 (PA14); also elsewhere on the board
SWDIO: U30.49 (PA13); also elsewhere on the board
UART_RX: U30.33 (PB11); also elsewhere on the board
UART_TX: U30.30 (PB10); also elsewhere on the board
VREF_MCU: U30.28 (VREF+); also elsewhere on the board

Notes on the sheet:
LOCAL STM32G431 / SUPPLY AND DECOUPLING
MCU DECOUPLING / PLACE AT THE SUPPLY PINS
Decoupling is shown as a separate functional block. Place each 100 nF at its physical VDD or VBAT pin. VSSA and VSS return to shunt LOW / DC-. No external VCAP on this package. VREF+ uses the external 3.3 V reference rail; VREFBUF OFF.
CROSS-SHEET SIGNALS PWM / ENABLE / BRAKE -> local command and gate pages ADC inputs <- local RC filters ABZ / SPI <- external sensor interface SWD / TTL / CAN / LEDs -> debug interface Use labels between blocks and direct wires within each block.
Keep outputs disabled during reset and initialization. BKIN is active-low; disable automatic restart. PB15 TIM1_CH3N uses AF4. Three currents share two ADCs: sampling windows still require validation. Seven unused GPIOs remain explicit NC. Preserve NRST, SWD and the intended BOOT/UCPD configuration.

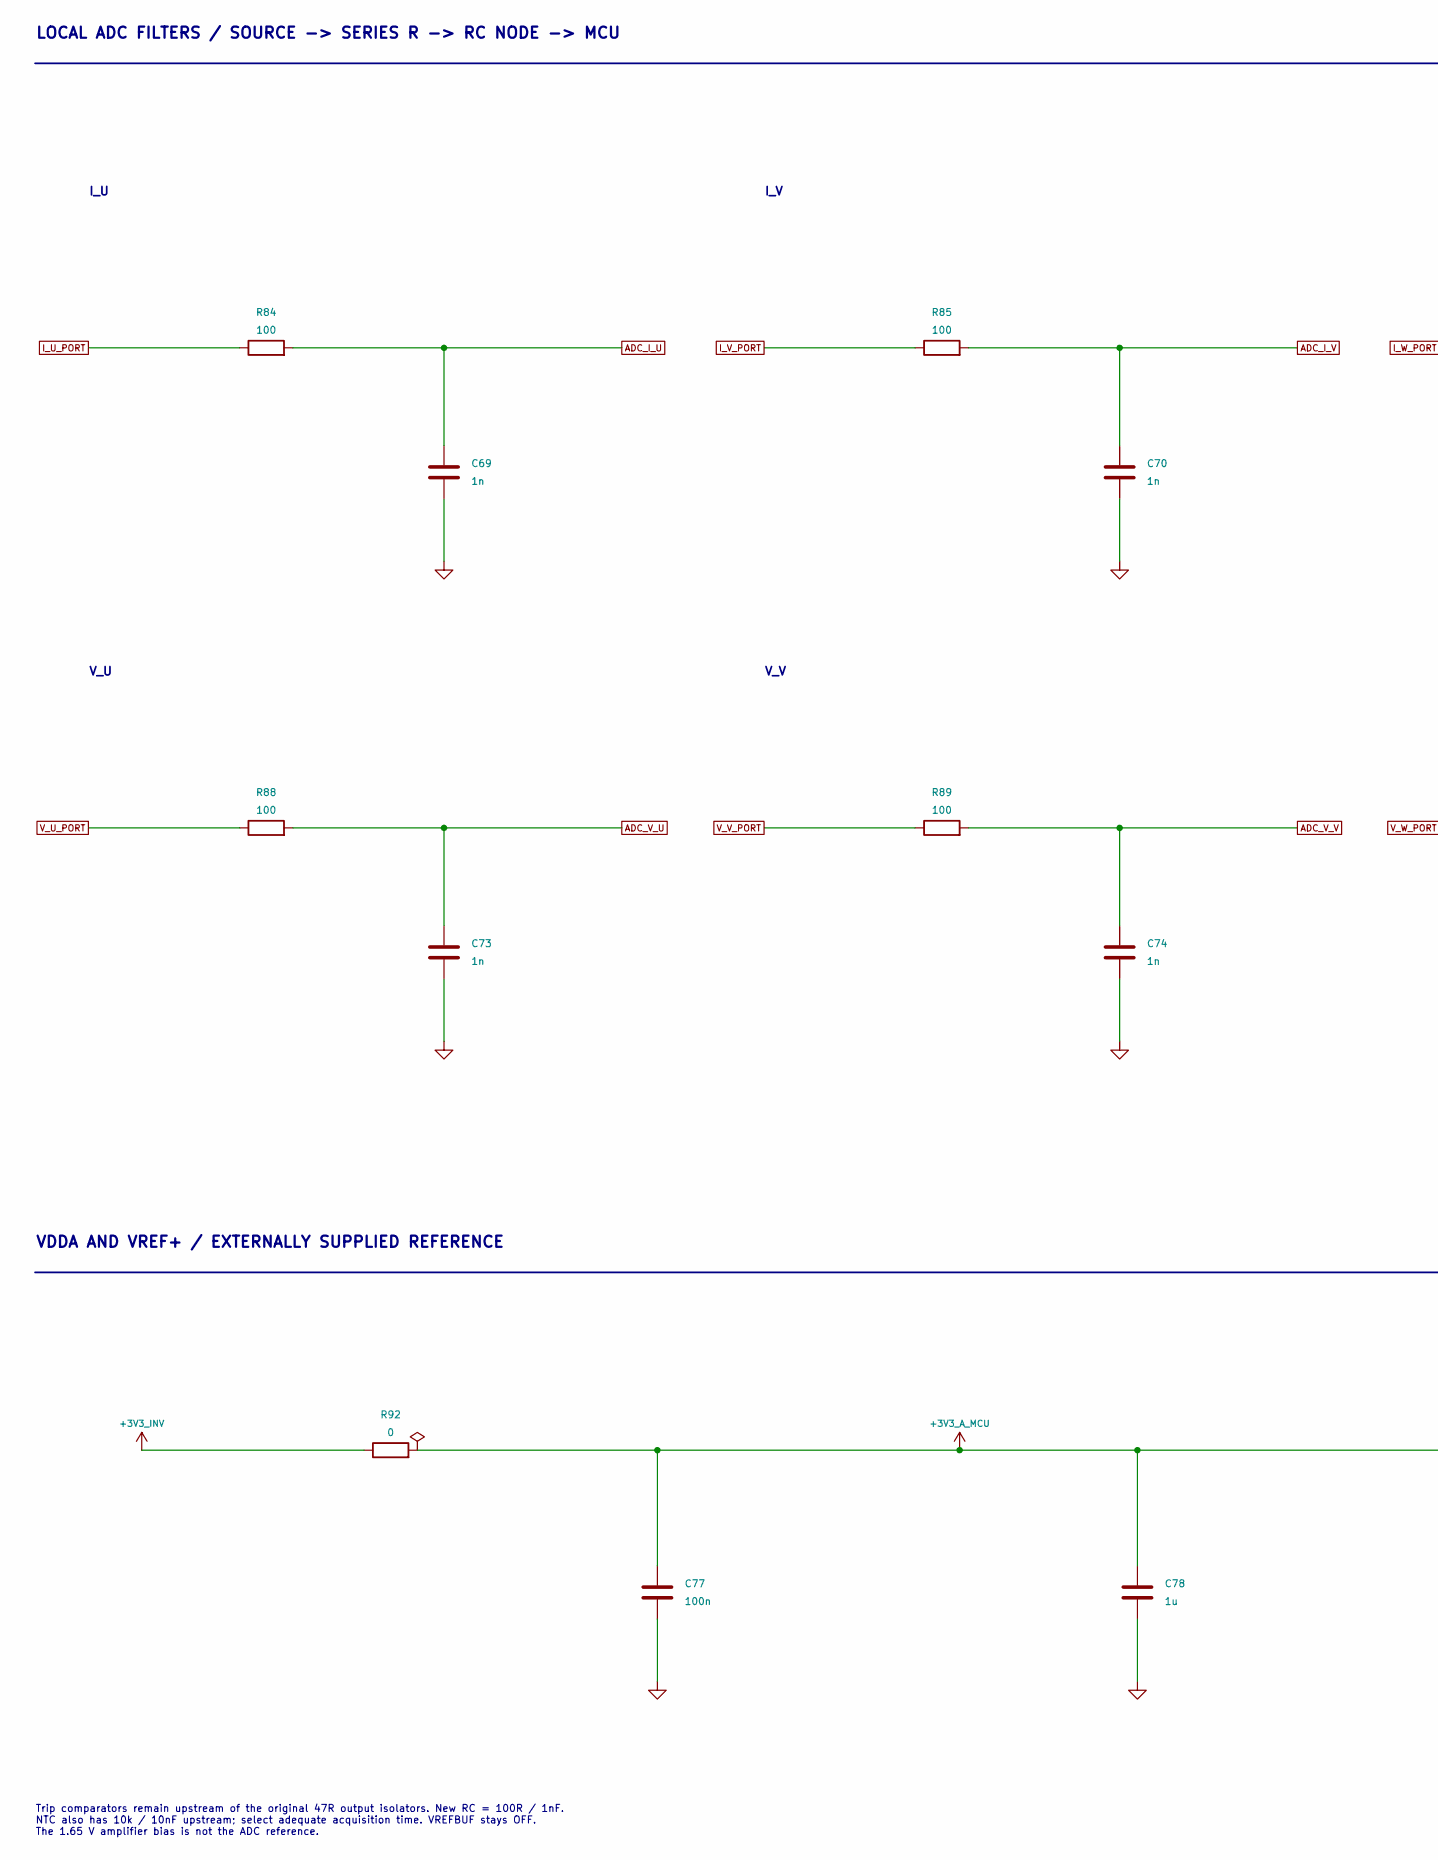
[picture p252: schematic mcu_analog.kicad_sch, Inverter - local ADC filters and analog supply, part in row 1, column 1]

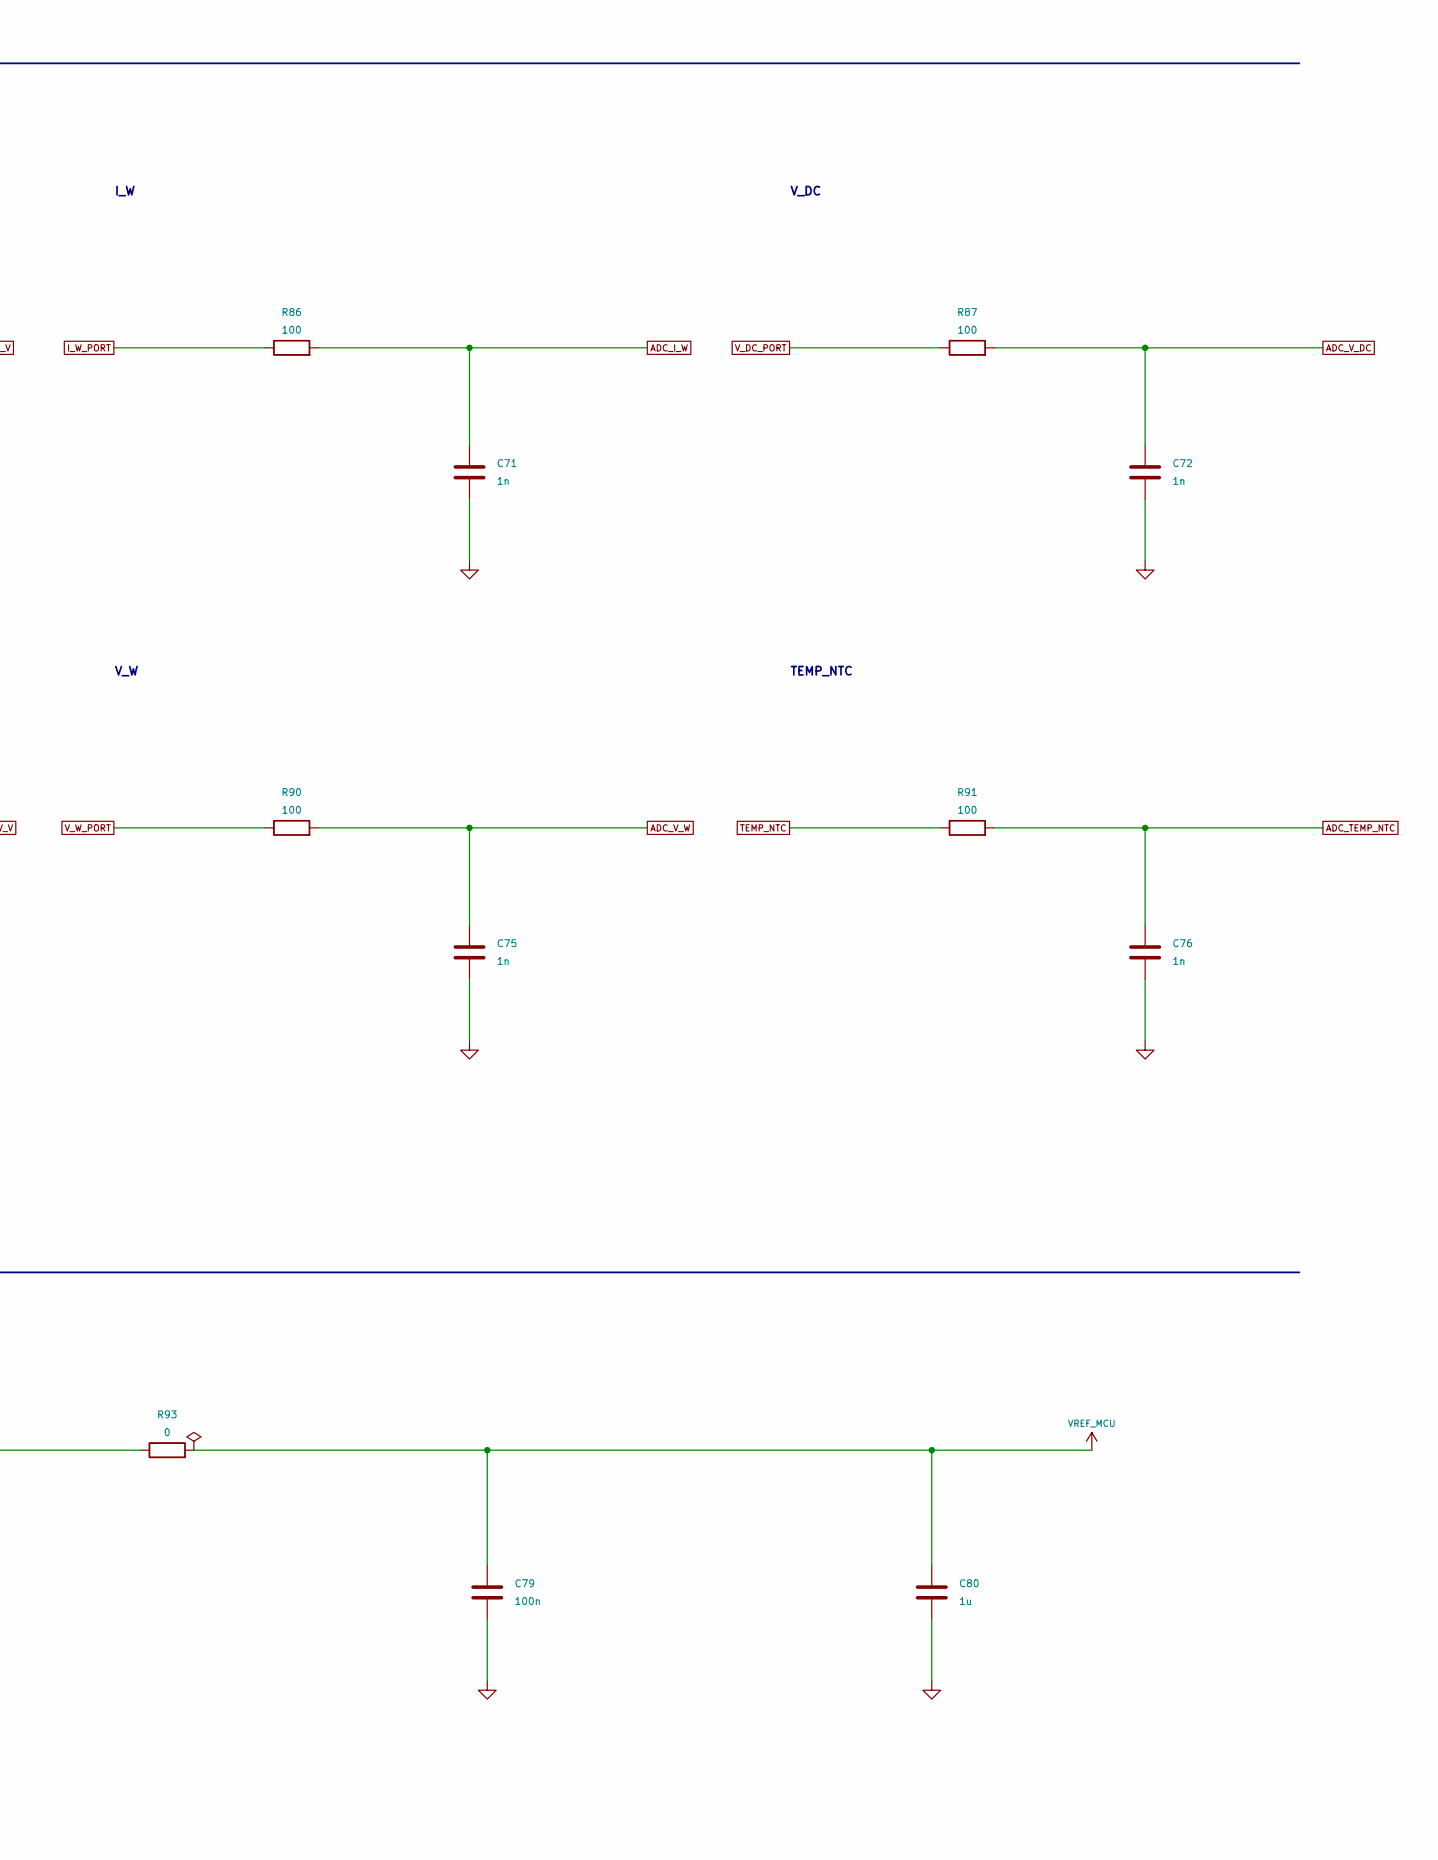
[picture p253: schematic mcu_analog.kicad_sch, Inverter - local ADC filters and analog supply, part in row 1, column 2]

Parts:
C69, C70, C71, C72, C73, C74, C75, C76: 1n; C_0402_1005Metric; Voltage_Rating 16 V minimum; MPN TBD
C77, C79: 100n; C_0402_1005Metric; Voltage_Rating 16 V minimum; MPN TBD
C78, C80: 1u; C_0603_1608Metric; Voltage_Rating 16 V minimum; MPN TBD
R84, R85, R86, R87, R88, R89, R90, R91: 100; R_0402_1005Metric; Tolerance 1%; MPN TBD
R92, R93: 0; R_0402_1005Metric; Tolerance 1%; MPN TBD

Connections:
+3V3_A_MCU: C77.1, C78.1, R92.2, R93.1; also elsewhere on the board
+3V3_INV: R92.1; also elsewhere on the board
ADC_I_U: C69.1, R84.2; also elsewhere on the board
ADC_I_V: C70.1, R85.2; also elsewhere on the board
ADC_I_W: C71.1, R86.2; also elsewhere on the board
ADC_TEMP_NTC: C76.1, R91.2; also elsewhere on the board
ADC_V_DC: C72.1, R87.2; also elsewhere on the board
ADC_V_U: C73.1, R88.2; also elsewhere on the board
ADC_V_V: C74.1, R89.2; also elsewhere on the board
ADC_V_W: C75.1, R90.2; also elsewhere on the board
I_U_PORT: R84.1; also elsewhere on the board
I_V_PORT: R85.1; also elsewhere on the board
I_W_PORT: R86.1; also elsewhere on the board
TEMP_NTC: R91.1; also elsewhere on the board
VREF_MCU: C79.1, C80.1, R93.2; also elsewhere on the board
V_DC_PORT: R87.1; also elsewhere on the board
V_U_PORT: R88.1; also elsewhere on the board
V_V_PORT: R89.1; also elsewhere on the board
V_W_PORT: R90.1; also elsewhere on the board

Notes on the sheet:
LOCAL ADC FILTERS / SOURCE -> SERIES R -> RC NODE -> MCU
I_U
I_V
I_W
V_DC
V_U
V_V
V_W
TEMP_NTC
VDDA AND VREF+ / EXTERNALLY SUPPLIED REFERENCE
Trip comparators remain upstream of the original 47R output isolators. New RC = 100R / 1nF. NTC also has 10k / 10nF upstream; select adequate acquisition time. VREFBUF stays OFF. The 1.65 V amplifier bias is not the ADC reference.
