leolei2012/power_system/inverter/hardware/review/compact_fine_smoke/inverter.kicad_pcb

## KiCad design inverter/history/integrated_rev_c_60x60/inverter.kicad_pcb (continued)

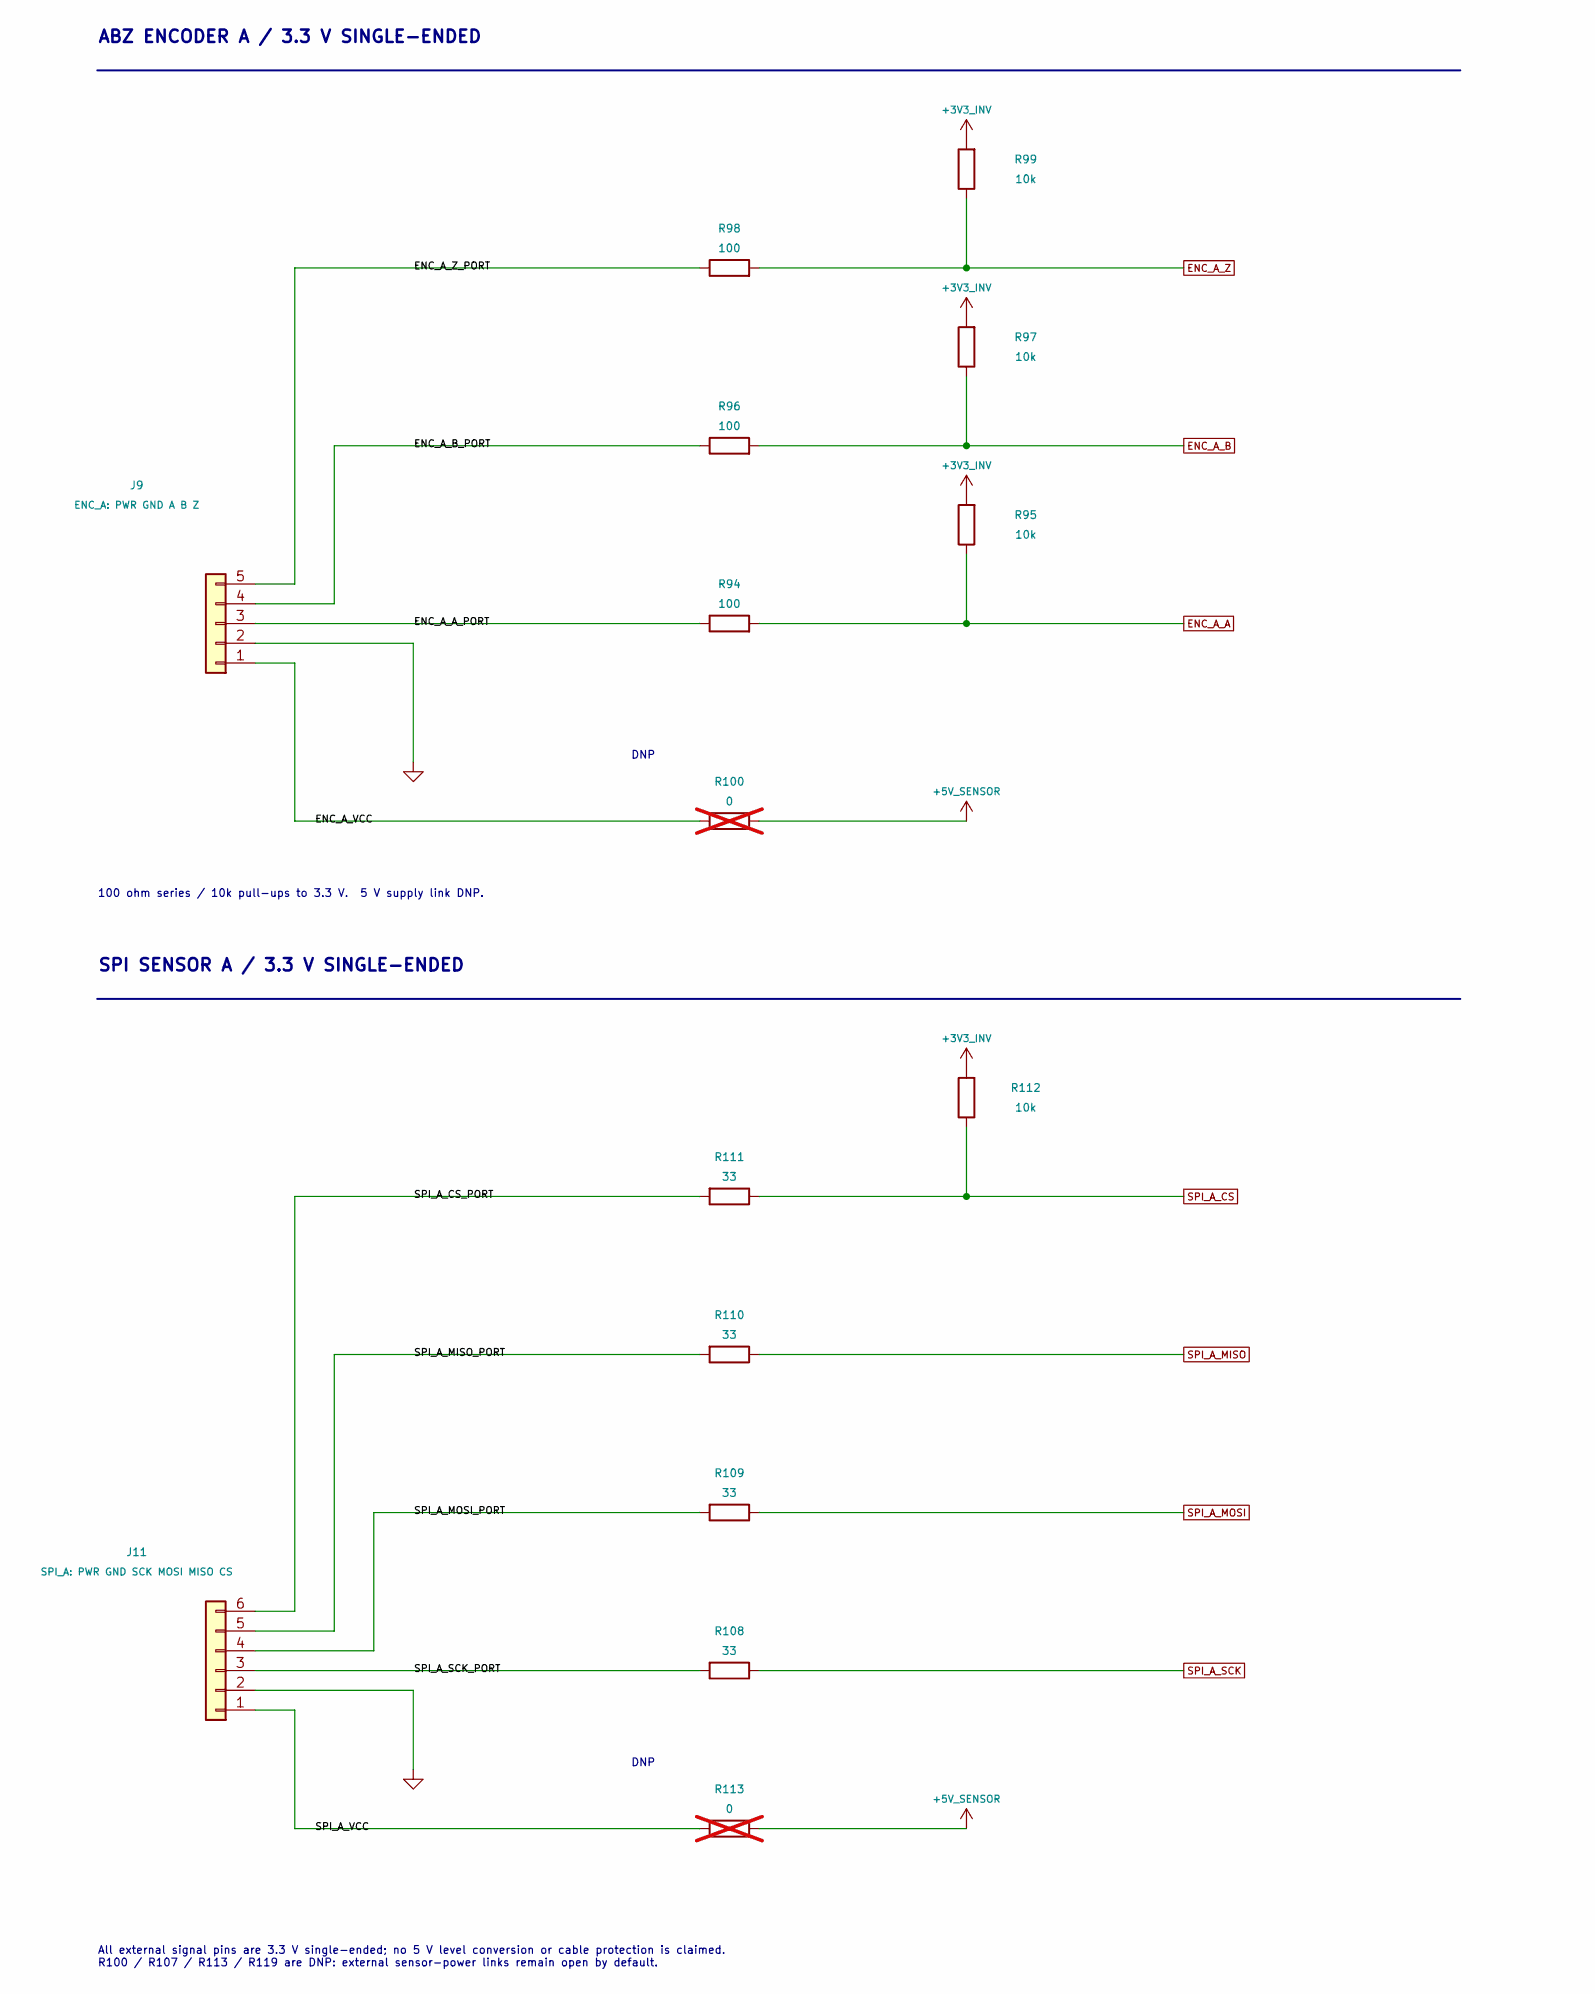
[picture p254: schematic sensors.kicad_sch, Inverter - two ABZ and two SPI ports, part in row 1, column 1]

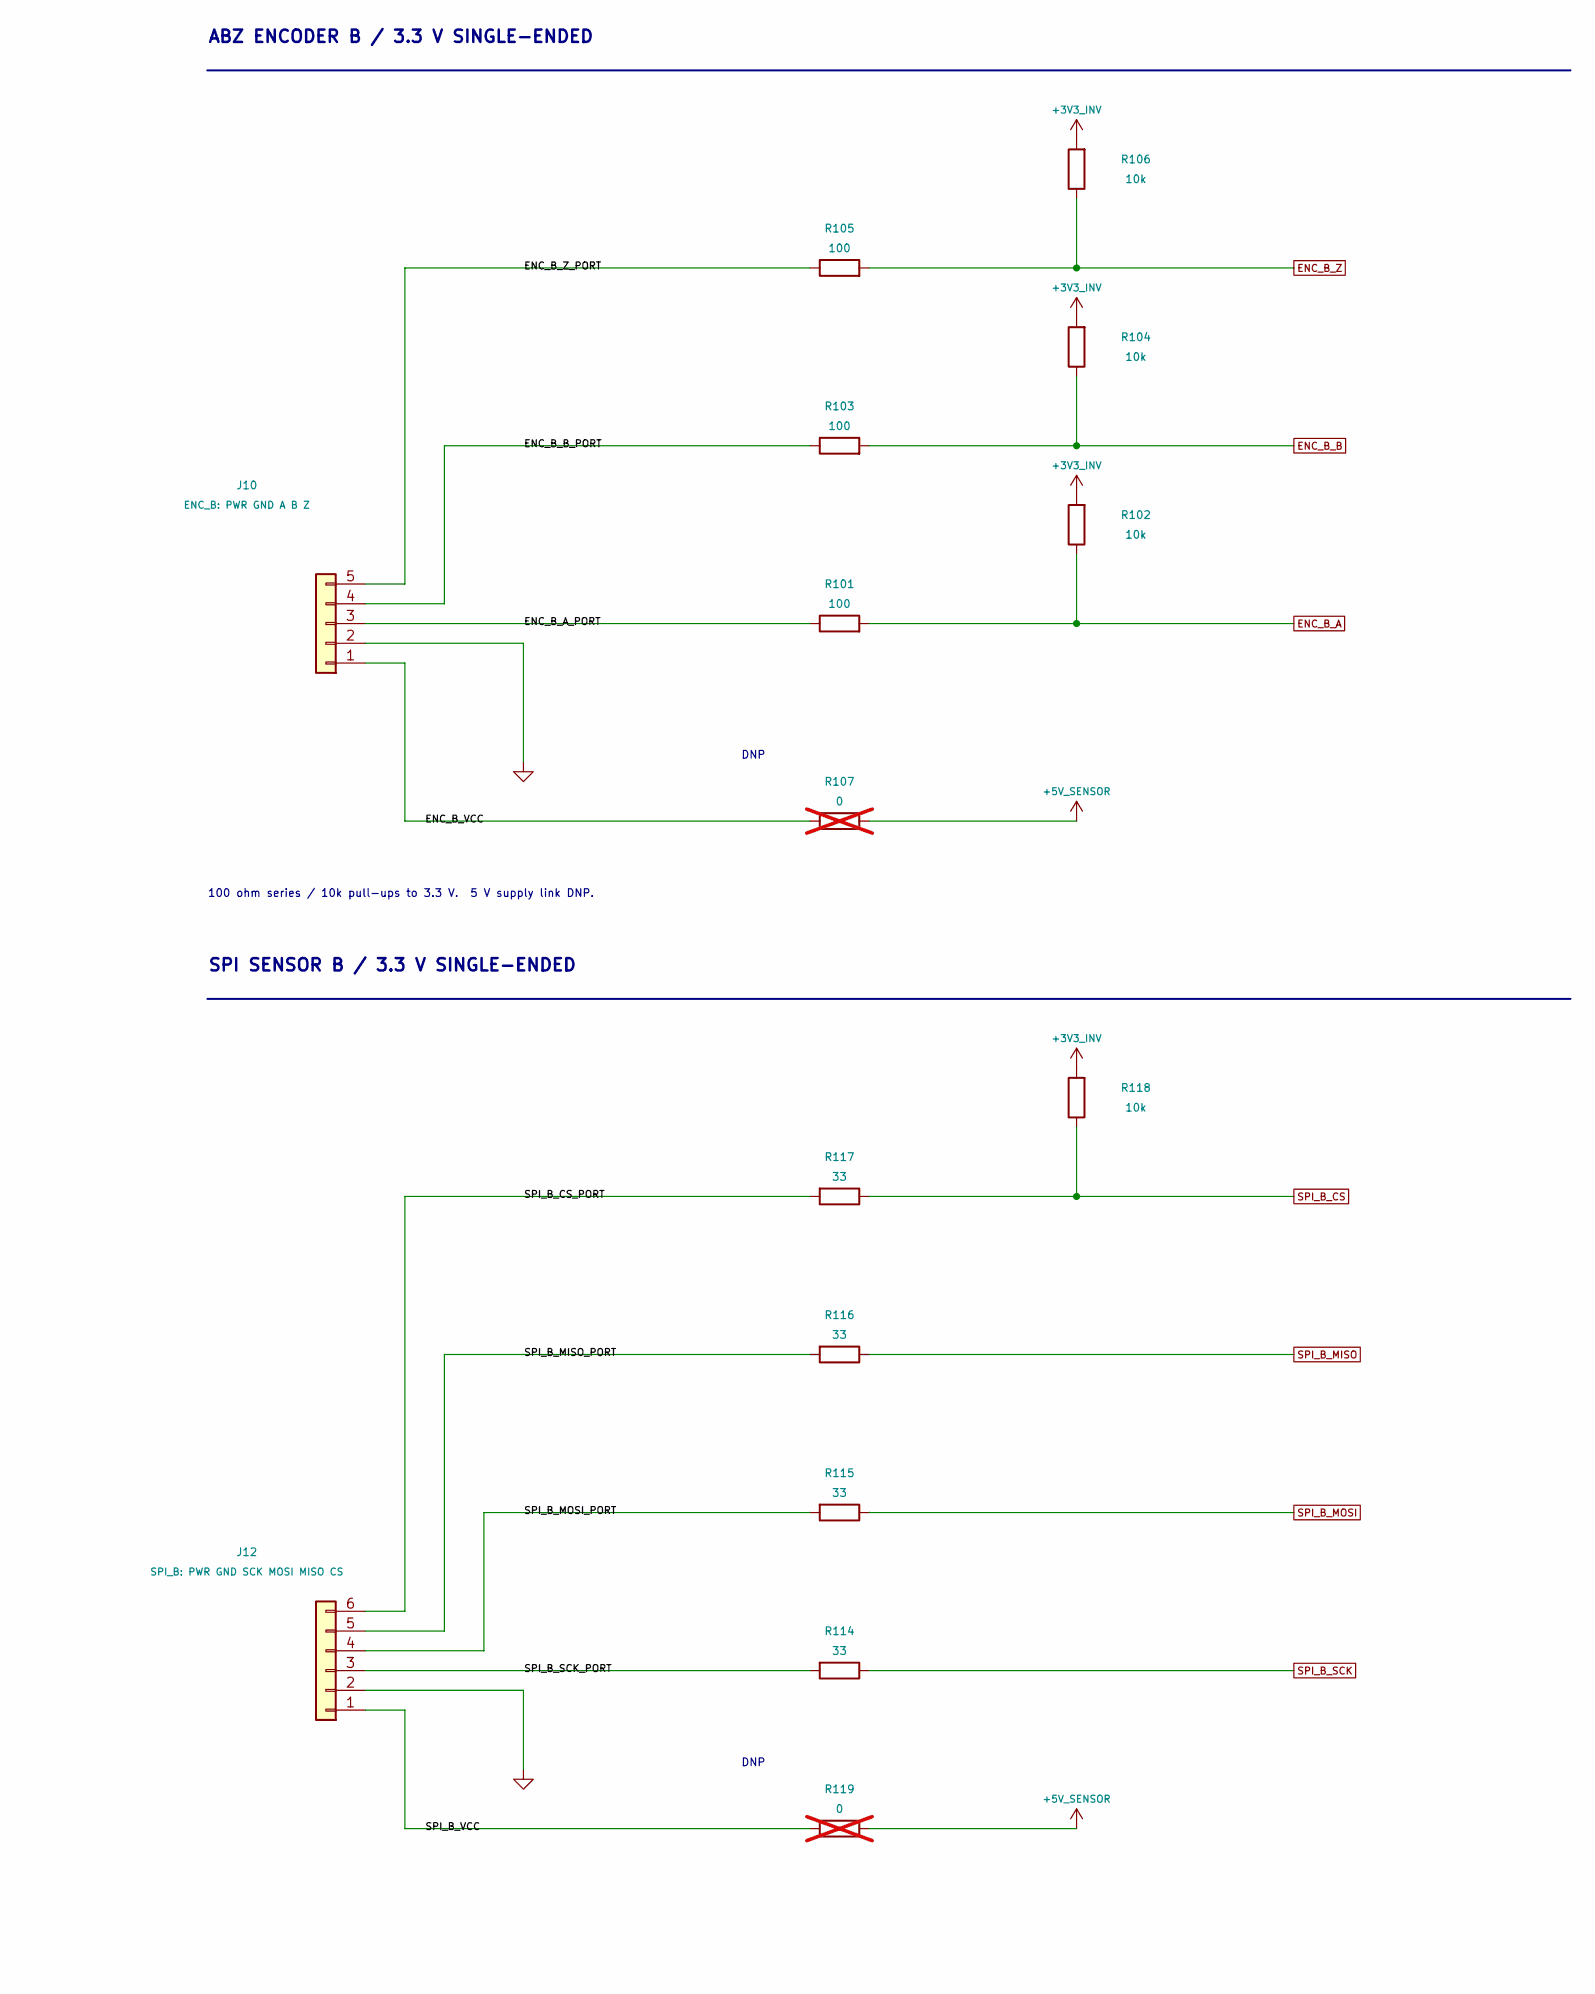
[picture p255: schematic sensors.kicad_sch, Inverter - two ABZ and two SPI ports, part in row 1, column 2]

Parts:
J9: ENC_A: PWR GND A B Z; PinHeader_HCTL_PZ127_1x05_P1.27mm_D0.70mm; MPN PZ127-1-05-Z
J10: ENC_B: PWR GND A B Z; PinHeader_HCTL_PZ127_1x05_P1.27mm_D0.70mm; MPN PZ127-1-05-Z
J11: SPI_A: PWR GND SCK MOSI MISO CS; PinHeader_HCTL_PZ127_1x06_P1.27mm_D0.70mm; MPN PZ127-1-06-Z
J12: SPI_B: PWR GND SCK MOSI MISO CS; PinHeader_HCTL_PZ127_1x06_P1.27mm_D0.70mm; MPN PZ127-1-06-Z
R94, R96, R98, R101, R103, R105: 100; R_0402_1005Metric; Tolerance 1%; MPN TBD
R95, R97, R99, R102, R104, R106, R112, R118: 10k; R_0402_1005Metric; Tolerance 1%; MPN TBD
R100, R107, R113, R119: 0; R_0402_1005Metric; Tolerance 1%; MPN TBD; not fitted
R108, R109, R110, R111, R114, R115, R116, R117: 33; R_0402_1005Metric; Tolerance 1%; MPN TBD

Connections:
+3V3_INV: R95.2, R97.2, R99.2, R102.2, R104.2, R106.2, R112.2, R118.2; also elsewhere on the board
+5V_SENSOR: R100.1, R107.1, R113.1, R119.1; also elsewhere on the board
/Encoders and SPI/ENC_A_A_PORT: J9.3, R94.1
/Encoders and SPI/ENC_A_B_PORT: J9.4, R96.1
/Encoders and SPI/ENC_A_VCC: J9.1, R100.2
/Encoders and SPI/ENC_A_Z_PORT: J9.5, R98.1
/Encoders and SPI/ENC_B_A_PORT: J10.3, R101.1
/Encoders and SPI/ENC_B_B_PORT: J10.4, R103.1
/Encoders and SPI/ENC_B_VCC: J10.1, R107.2
/Encoders and SPI/ENC_B_Z_PORT: J10.5, R105.1
/Encoders and SPI/SPI_A_CS_PORT: J11.6, R111.2
/Encoders and SPI/SPI_A_MISO_PORT: J11.5, R110.2
/Encoders and SPI/SPI_A_MOSI_PORT: J11.4, R109.2
/Encoders and SPI/SPI_A_SCK_PORT: J11.3, R108.2
/Encoders and SPI/SPI_A_VCC: J11.1, R113.2
/Encoders and SPI/SPI_B_CS_PORT: J12.6, R117.2
/Encoders and SPI/SPI_B_MISO_PORT: J12.5, R116.2
/Encoders and SPI/SPI_B_MOSI_PORT: J12.4, R115.2
/Encoders and SPI/SPI_B_SCK_PORT: J12.3, R114.2
/Encoders and SPI/SPI_B_VCC: J12.1, R119.2
ENC_A_A: R94.2, R95.1; also elsewhere on the board
ENC_A_B: R96.2, R97.1; also elsewhere on the board
ENC_A_Z: R98.2, R99.1; also elsewhere on the board
ENC_B_A: R101.2, R102.1; also elsewhere on the board
ENC_B_B: R103.2, R104.1; also elsewhere on the board
ENC_B_Z: R105.2, R106.1; also elsewhere on the board
SPI_A_CS: R111.1, R112.1; also elsewhere on the board
SPI_A_MISO: R110.1; also elsewhere on the board
SPI_A_MOSI: R109.1; also elsewhere on the board
SPI_A_SCK: R108.1; also elsewhere on the board
SPI_B_CS: R117.1, R118.1; also elsewhere on the board
SPI_B_MISO: R116.1; also elsewhere on the board
SPI_B_MOSI: R115.1; also elsewhere on the board
SPI_B_SCK: R114.1; also elsewhere on the board

Notes on the sheet:
ABZ ENCODER A / 3.3 V SINGLE-ENDED
DNP
100 ohm series / 10k pull-ups to 3.3 V. 5 V supply link DNP.
SPI SENSOR A / 3.3 V SINGLE-ENDED
ABZ ENCODER B / 3.3 V SINGLE-ENDED
SPI SENSOR B / 3.3 V SINGLE-ENDED
All external signal pins are 3.3 V single-ended; no 5 V level conversion or cable protection is claimed. R100 / R107 / R113 / R119 are DNP: external sensor-power links remain open by default.

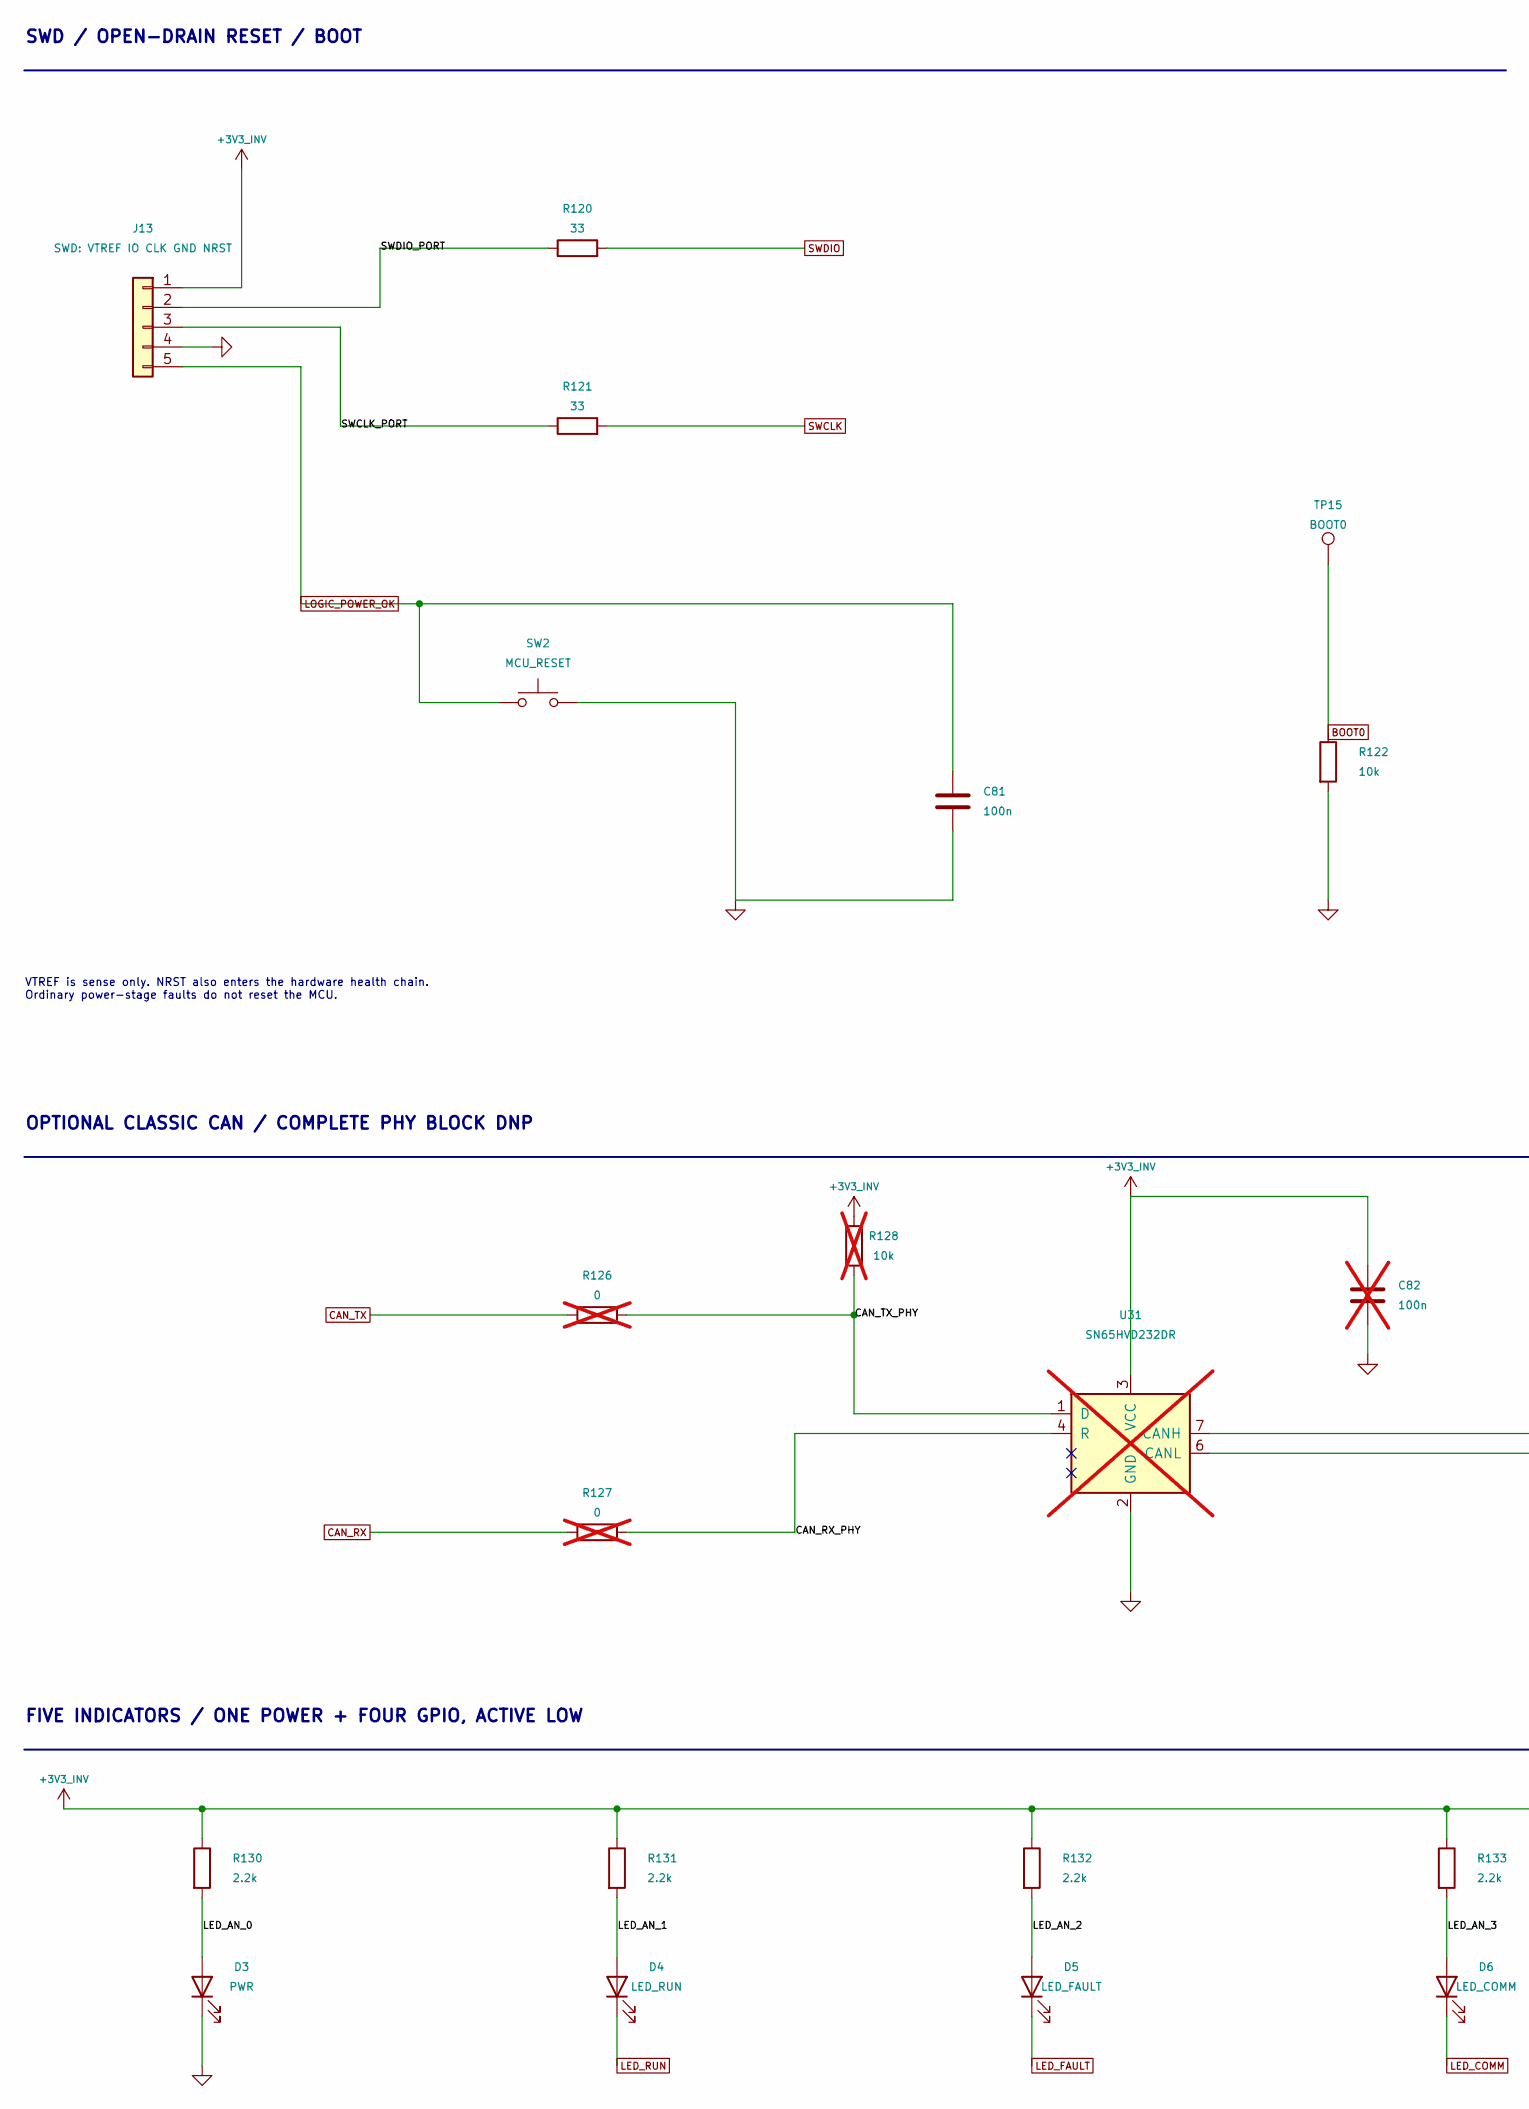
[picture p256: schematic debug_comms.kicad_sch, Inverter - SWD TTL optional CAN and status, part in row 1, column 1]

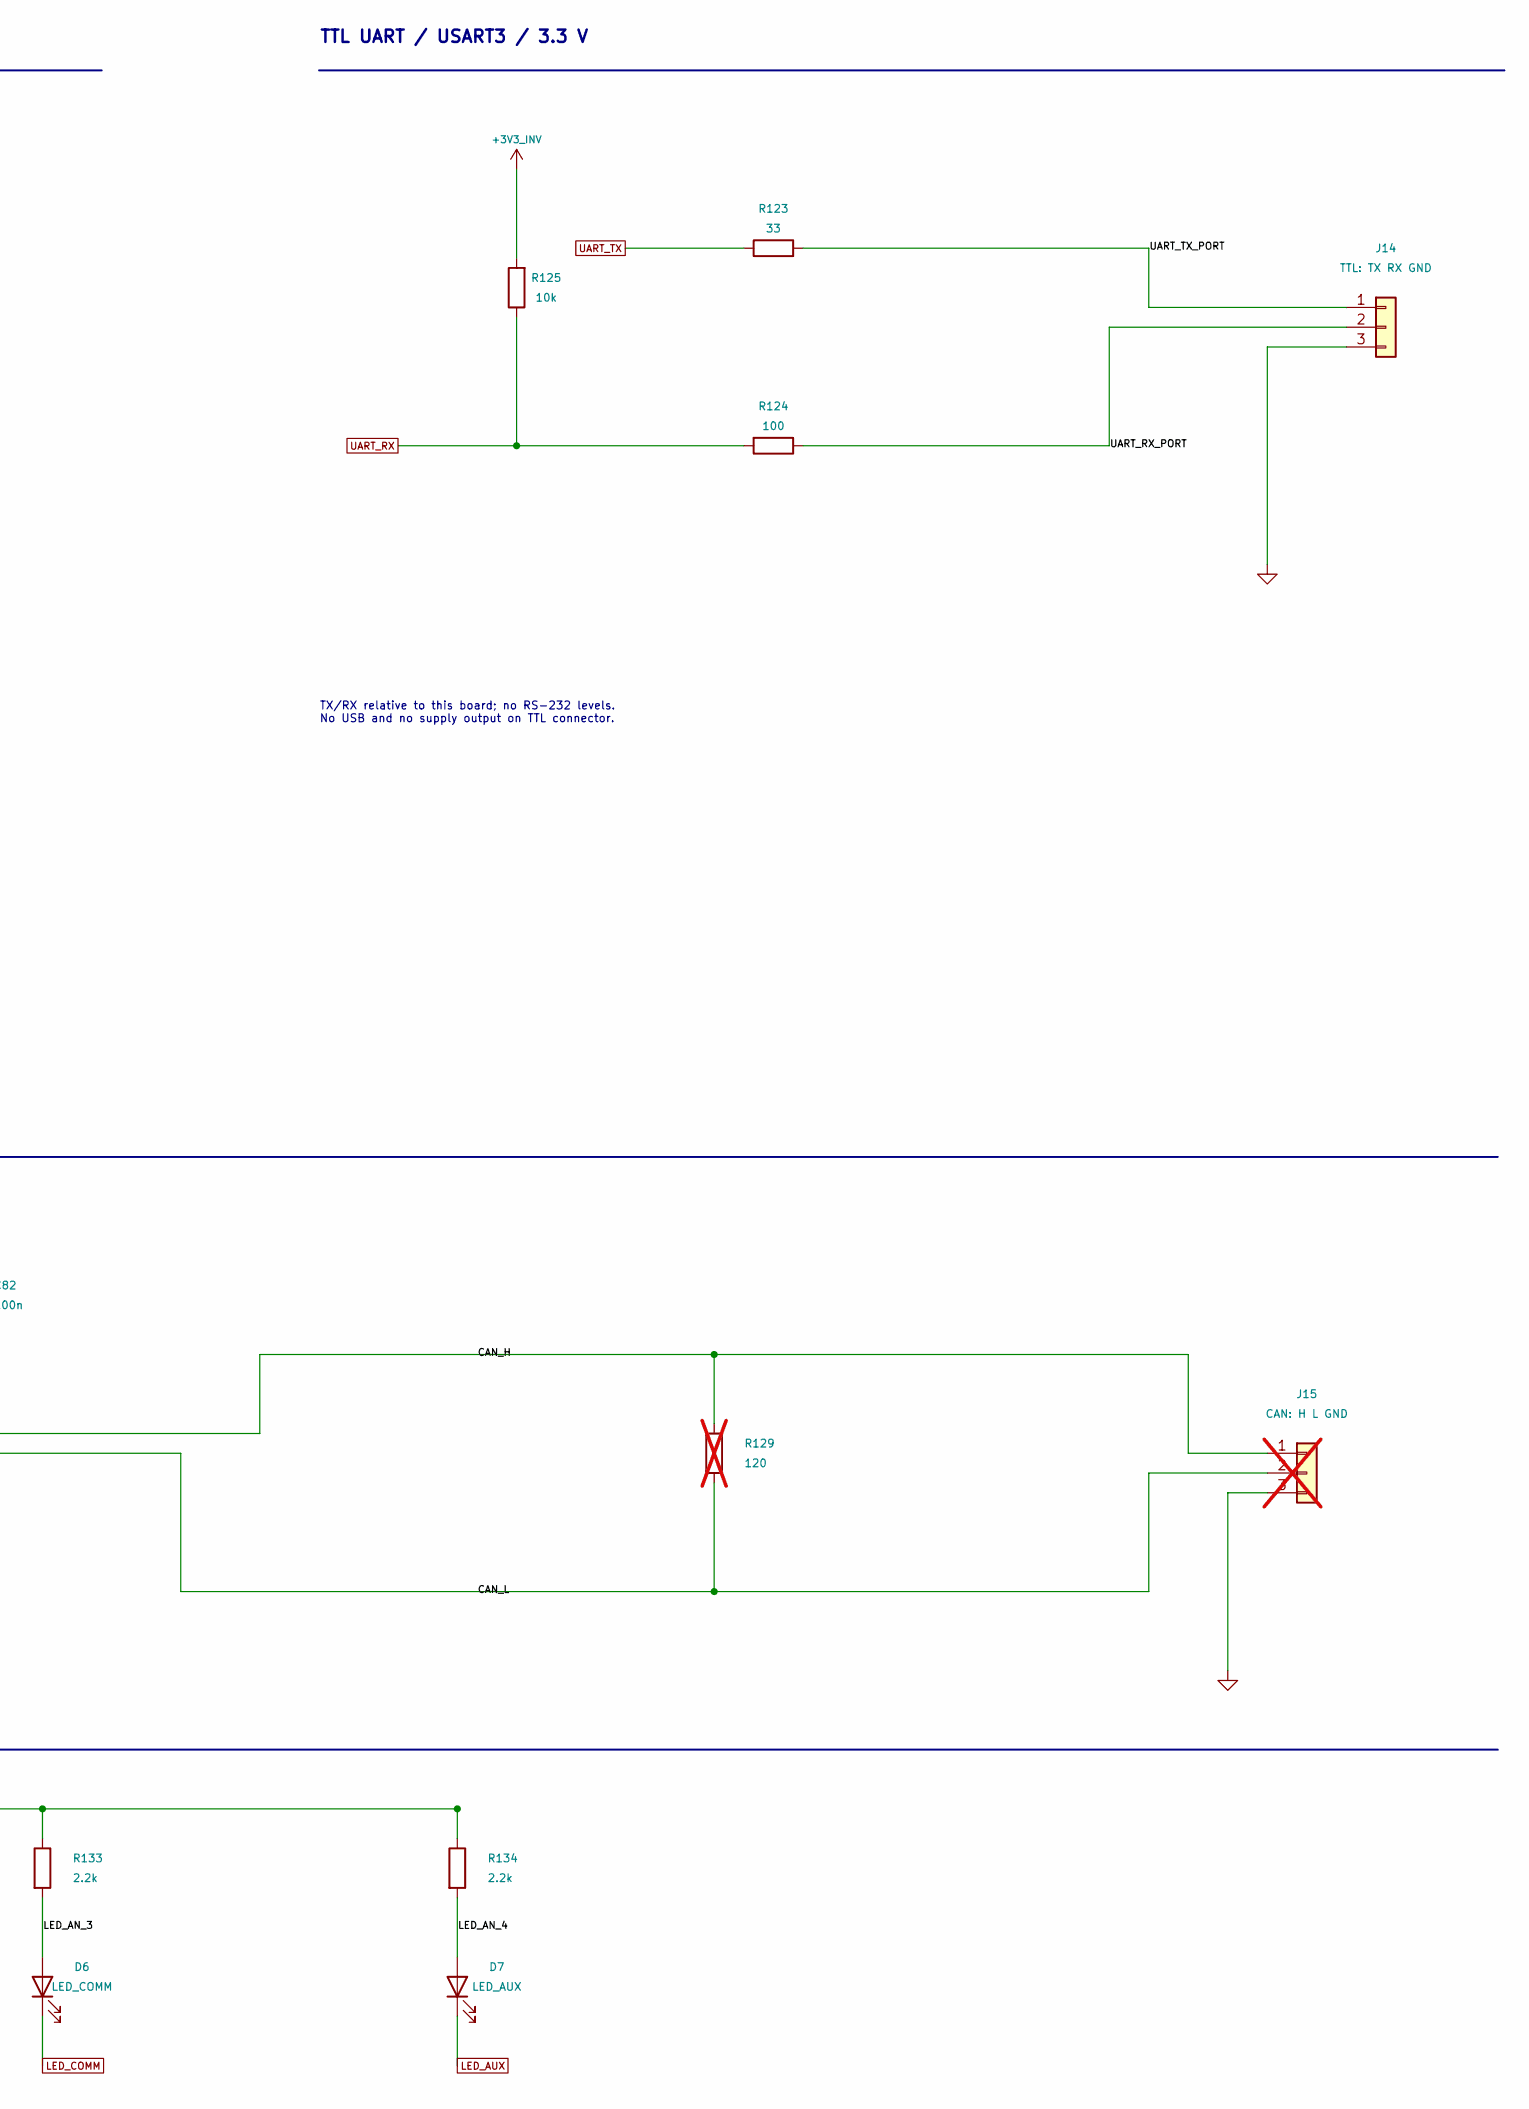
[picture p257: schematic debug_comms.kicad_sch, Inverter - SWD TTL optional CAN and status, part in row 1, column 2]

Parts:
C81: 100n; C_0402_1005Metric; Voltage_Rating 16 V minimum; MPN TBD
C82: 100n; C_0402_1005Metric; Voltage_Rating 16 V minimum; MPN TBD; not fitted
D3: PWR; LED_0603_1608Metric; MPN TBD
D4: LED_RUN; LED_0603_1608Metric; MPN TBD
D5: LED_FAULT; LED_0603_1608Metric; MPN TBD
D6: LED_COMM; LED_0603_1608Metric; MPN TBD
D7: LED_AUX; LED_0603_1608Metric; MPN TBD
J13: SWD: VTREF IO CLK GND NRST; PinHeader_HCTL_PZ127_1x05_P1.27mm_D0.70mm; MPN PZ127-1-05-Z
J14: TTL: TX RX GND; PinHeader_HCTL_PZ127_1x03_P1.27mm_D0.70mm; MPN PZ127-1-03-Z
J15: CAN: H L GND; PinHeader_HCTL_PZ127_1x03_P1.27mm_D0.70mm; MPN PZ127-1-03-Z; not fitted
R120, R121, R123: 33; R_0402_1005Metric; Tolerance 1%; MPN TBD
R122, R125: 10k; R_0402_1005Metric; Tolerance 1%; MPN TBD
R124: 100; R_0402_1005Metric; Tolerance 1%; MPN TBD
R126, R127: 0; R_0402_1005Metric; Tolerance 1%; MPN TBD; not fitted
R128: 10k; R_0402_1005Metric; Tolerance 1%; MPN TBD; not fitted
R129: 120; R_0402_1005Metric; Tolerance 1%; MPN TBD; not fitted
R130, R131, R132, R133, R134: 2.2k; R_0402_1005Metric; Tolerance 1%; MPN TBD
SW2: MCU_RESET; SW_SPST_TS-1088-xR020; MPN TS-1088-AR02016
TP15: BOOT0; TestPoint_Pad_D1.5mm
U31: SN65HVD232DR; SOIC-8_3.9x4.9mm_P1.27mm; MPN SN65HVD232DR; not fitted

Connections:
+3V3_INV: C82.1, J13.1, R125.2, R128.2, R130.1, R131.1, R132.1, R133.1, R134.1, U31.3 (VCC); also elsewhere on the board
/Debug and communication/CAN_H: J15.1, R129.1, U31.7 (CANH)
/Debug and communication/CAN_L: J15.2, R129.2, U31.6 (CANL)
/Debug and communication/CAN_RX_PHY: R127.1, U31.4 (R)
/Debug and communication/CAN_TX_PHY: R126.2, R128.1, U31.1 (D)
/Debug and communication/LED_AN_0: D3.2 (A), R130.2
/Debug and communication/LED_AN_1: D4.2 (A), R131.2
/Debug and communication/LED_AN_2: D5.2 (A), R132.2
/Debug and communication/LED_AN_3: D6.2 (A), R133.2
/Debug and communication/LED_AN_4: D7.2 (A), R134.2
/Debug and communication/SWCLK_PORT: J13.3, R121.1
/Debug and communication/SWDIO_PORT: J13.2, R120.1
/Debug and communication/UART_RX_PORT: J14.2, R124.1
/Debug and communication/UART_TX_PORT: J14.1, R123.2
BOOT0: R122.1, TP15.1; also elsewhere on the board
CAN_RX: R127.2; also elsewhere on the board
CAN_TX: R126.1; also elsewhere on the board
LED_AUX: D7.1 (K); also elsewhere on the board
LED_COMM: D6.1 (K); also elsewhere on the board
LED_FAULT: D5.1 (K); also elsewhere on the board
LED_RUN: D4.1 (K); also elsewhere on the board
LOGIC_POWER_OK: C81.1, J13.5, SW2.1; also elsewhere on the board
SWCLK: R121.2; also elsewhere on the board
SWDIO: R120.2; also elsewhere on the board
UART_RX: R124.2, R125.1; also elsewhere on the board
UART_TX: R123.1; also elsewhere on the board

Notes on the sheet:
SWD / OPEN-DRAIN RESET / BOOT
VTREF is sense only. NRST also enters the hardware health chain. Ordinary power-stage faults do not reset the MCU.
TTL UART / USART3 / 3.3 V
TX/RX relative to this board; no RS-232 levels. No USB and no supply output on TTL connector.
OPTIONAL CLASSIC CAN / COMPLETE PHY BLOCK DNP
FIVE INDICATORS / ONE POWER + FOUR GPIO, ACTIVE LOW
