leolei2012/power_system/inverter/hardware/review/compact_fine_smoke/inverter.kicad_pcb

## KiCad design inverter/history/integrated_rev_c_60x60/inverter.kicad_pcb (continued)

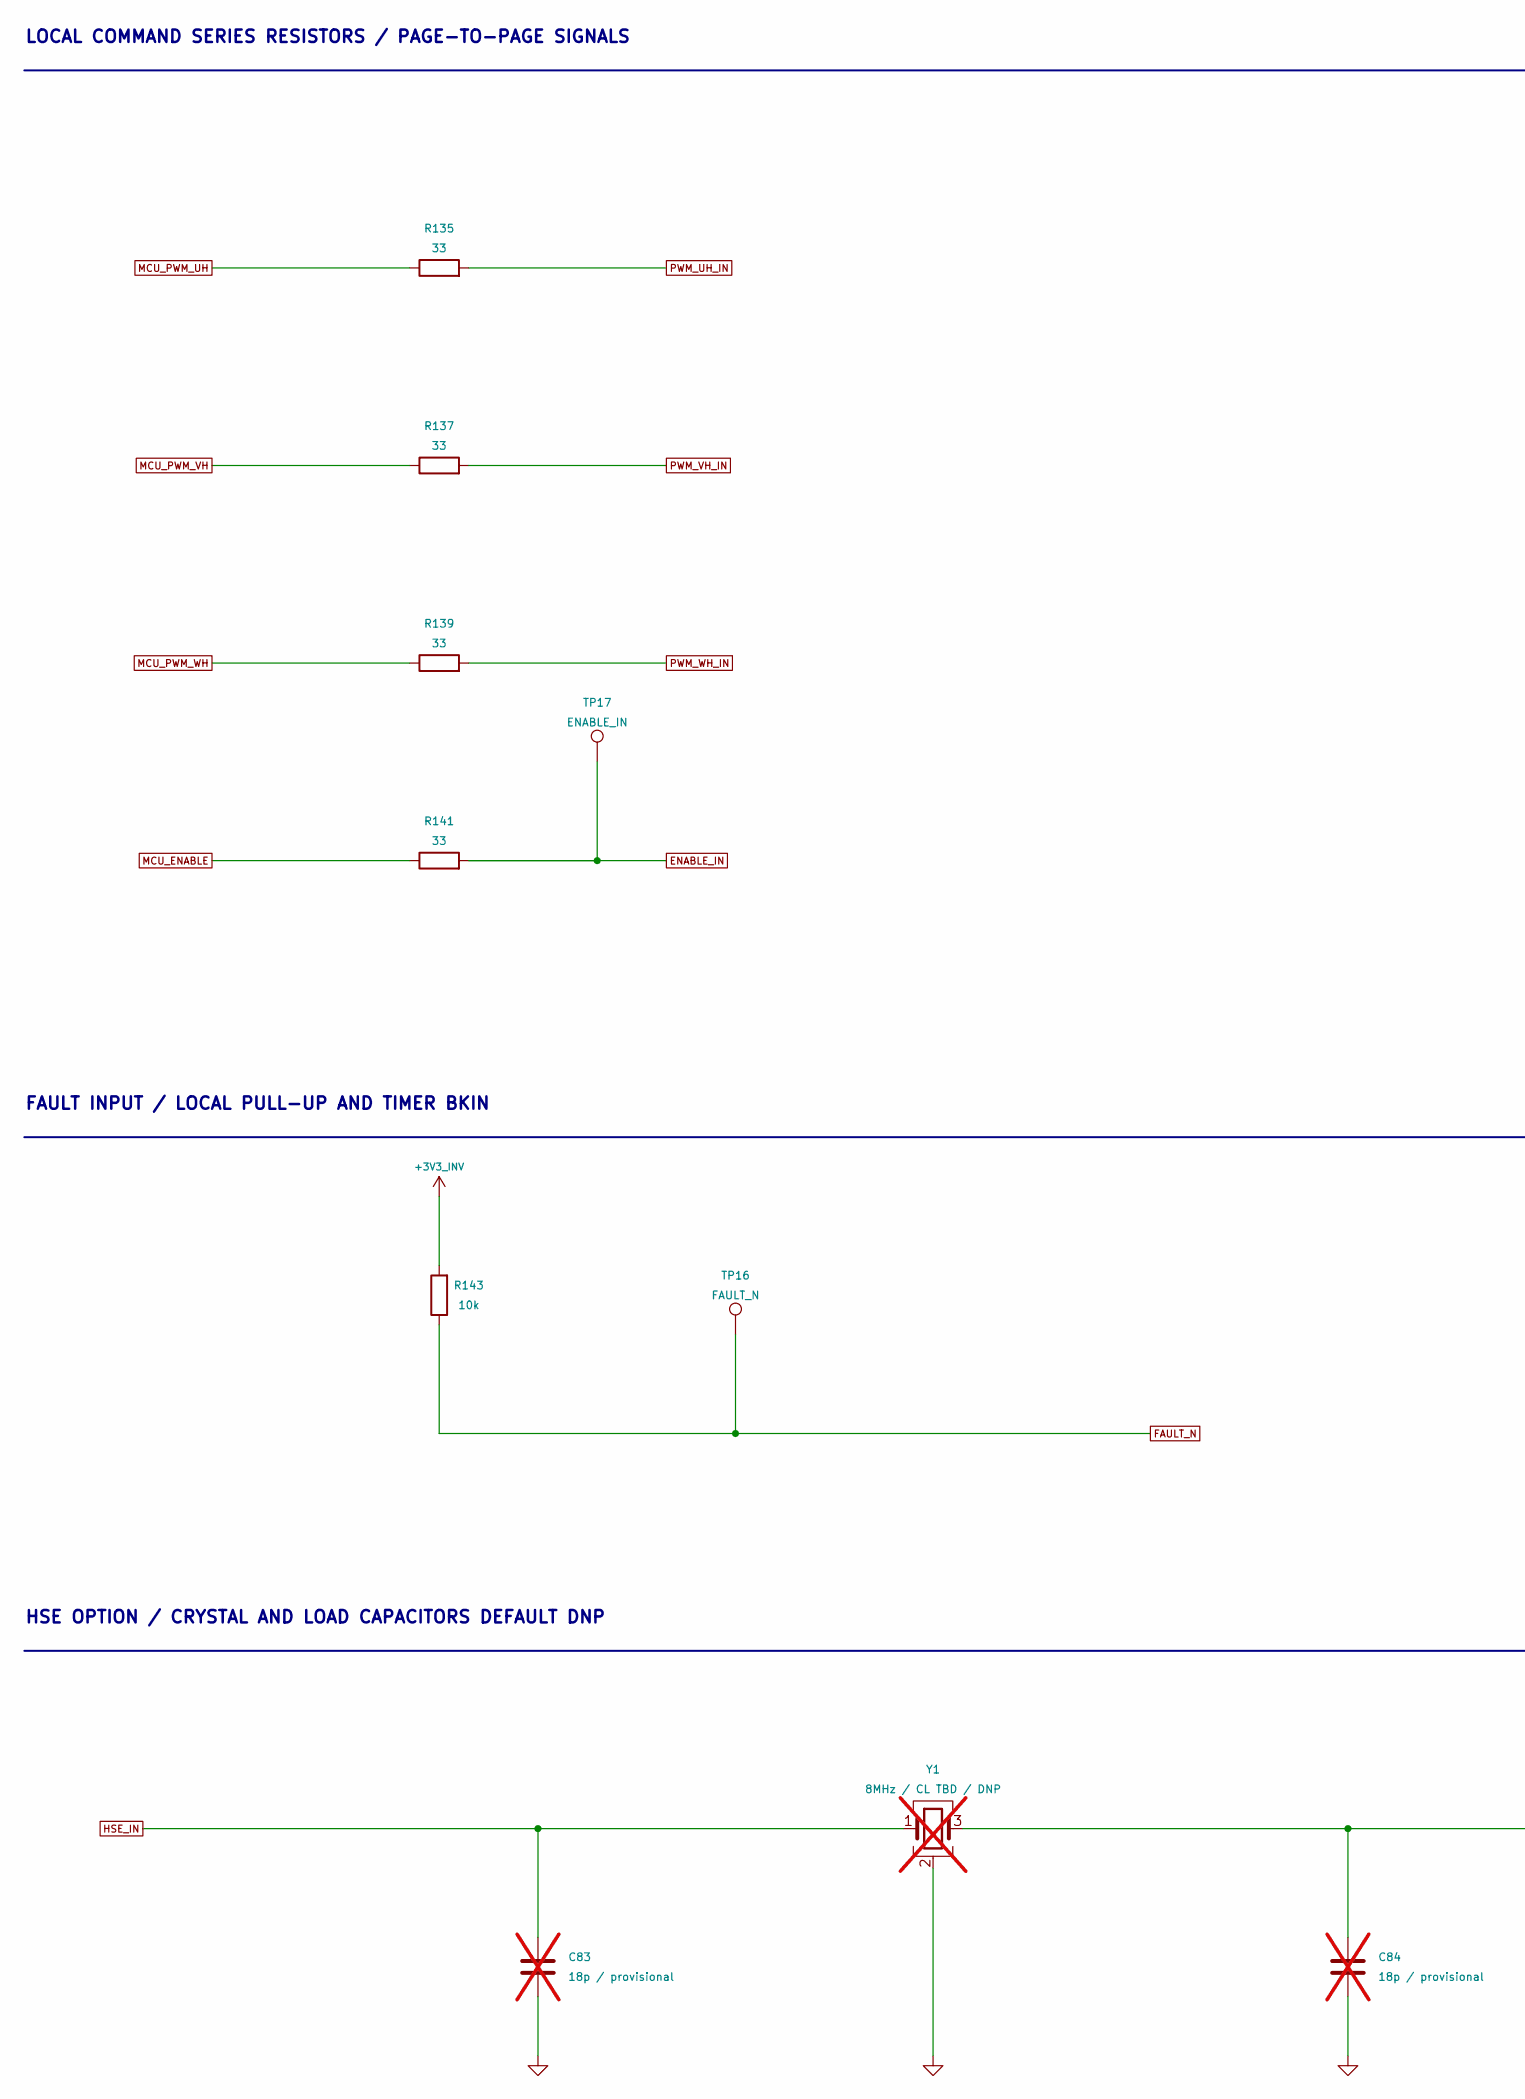
[picture p258: schematic mcu_control.kicad_sch, Inverter - PWM enable fault brake and HSE, part in row 1, column 1]

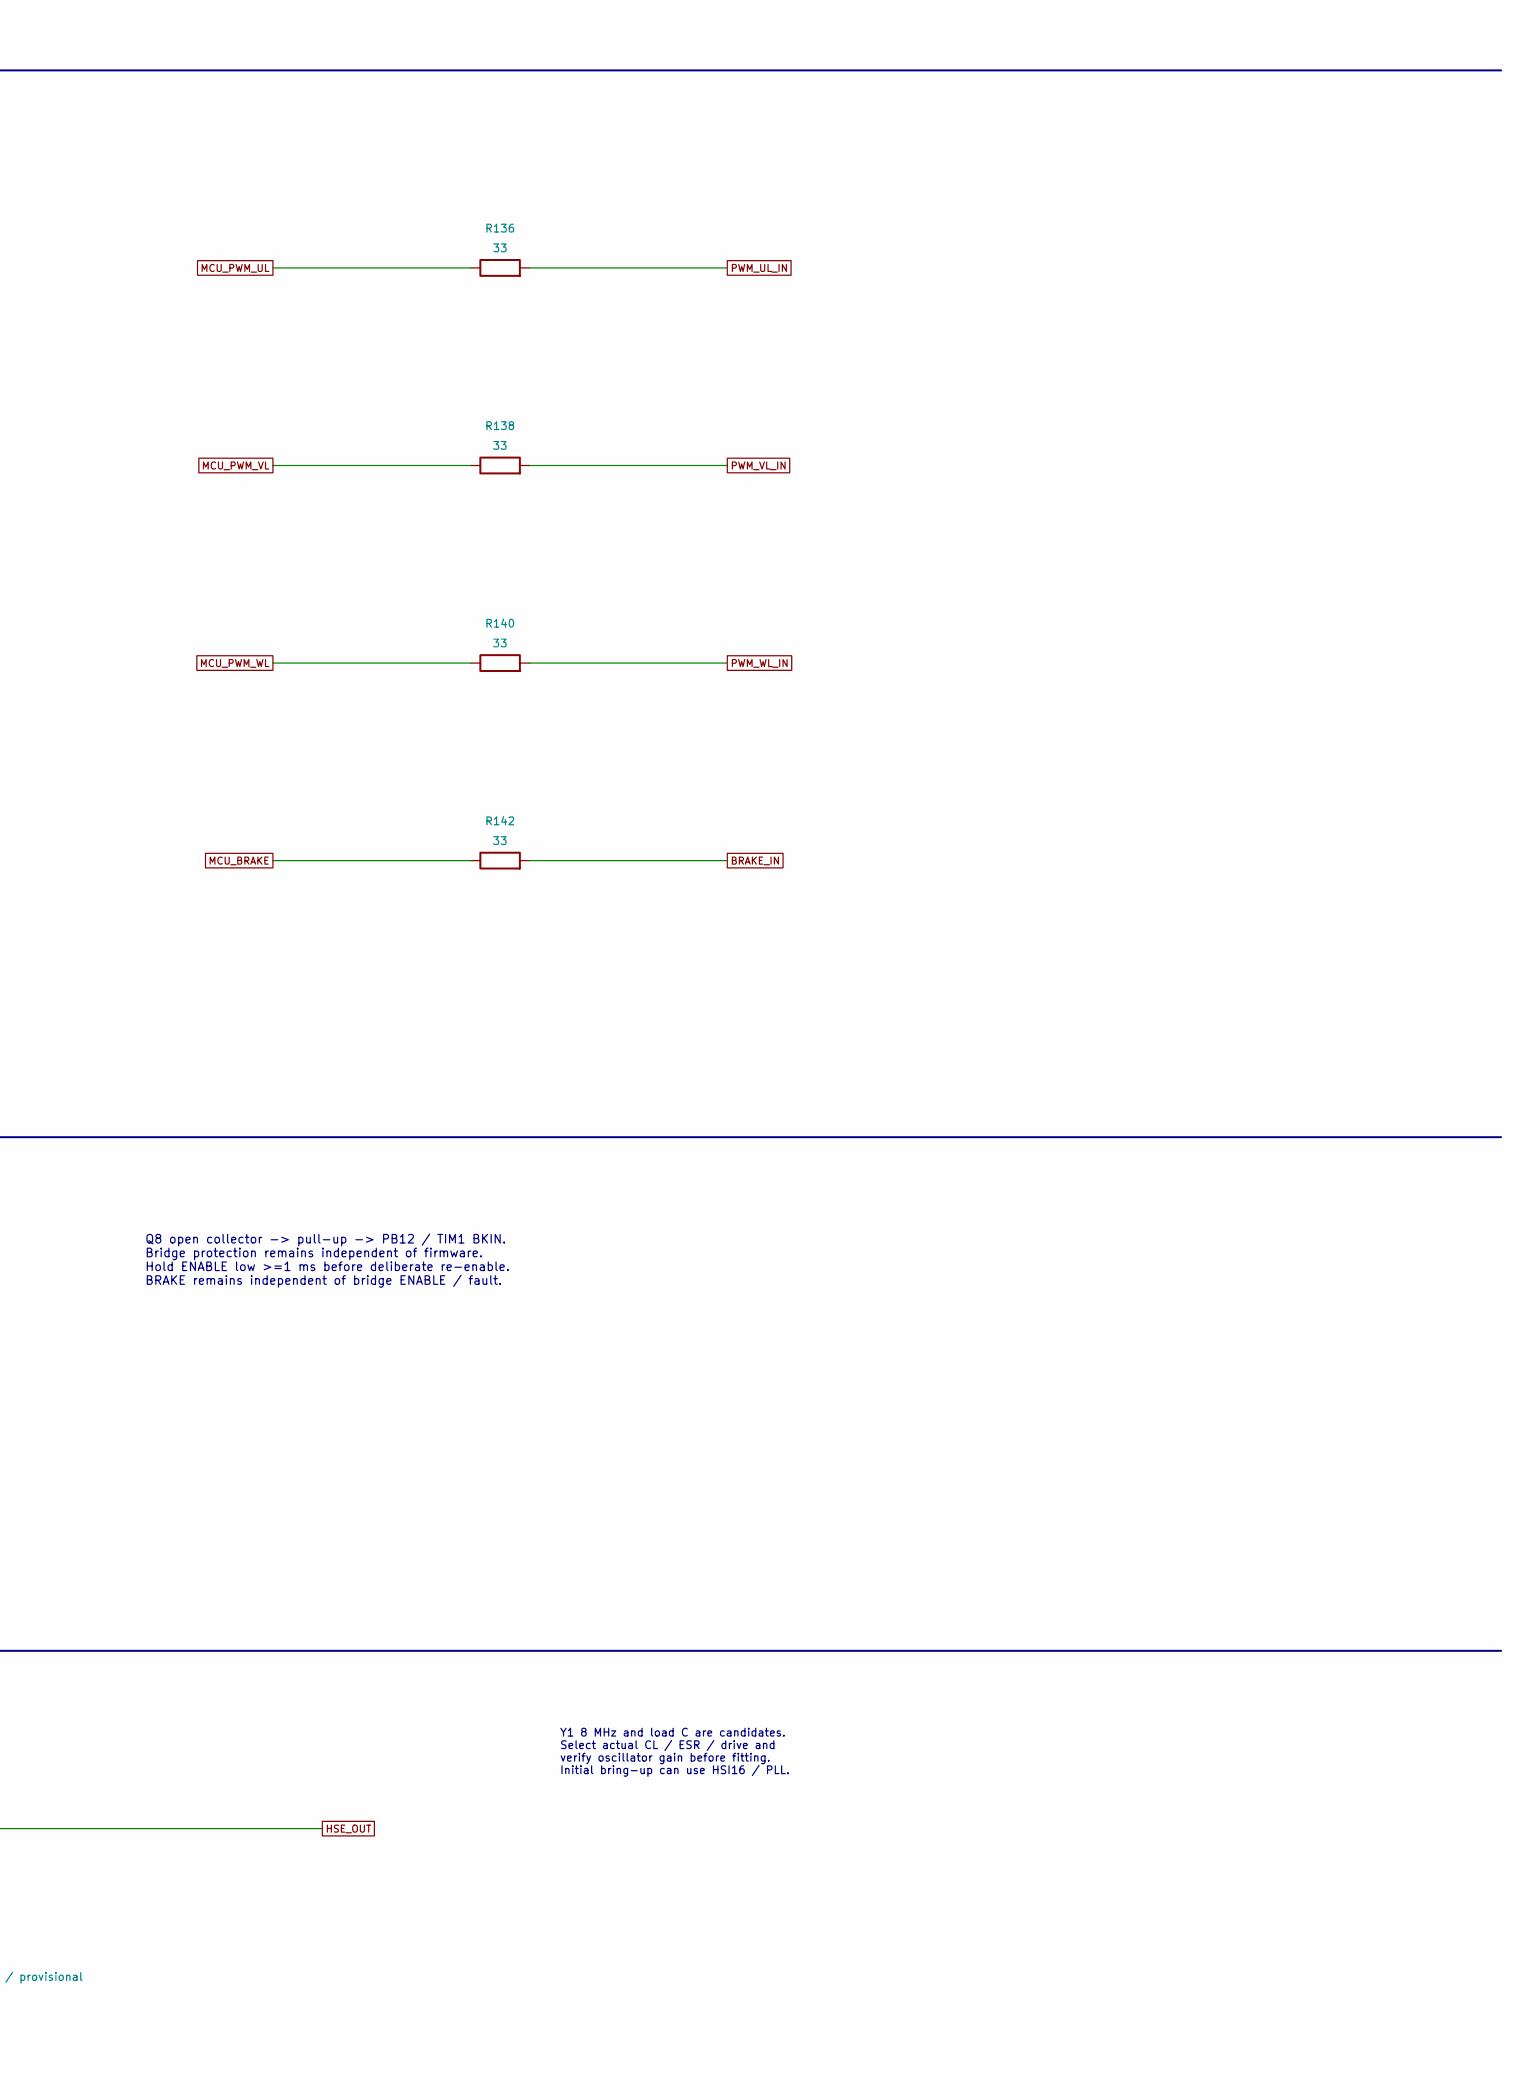
[picture p259: schematic mcu_control.kicad_sch, Inverter - PWM enable fault brake and HSE, part in row 1, column 2]

Parts:
C83, C84: 18p / provisional; C_0402_1005Metric; Voltage_Rating 16 V minimum; MPN TBD; not fitted
R135, R136, R137, R138, R139, R140, R141, R142: 33; R_0402_1005Metric; Tolerance 1%; MPN TBD
R143: 10k; R_0402_1005Metric; Tolerance 1%; MPN TBD
TP16: FAULT_N; TestPoint_Pad_D1.5mm
TP17: ENABLE_IN; TestPoint_Pad_D1.5mm
Y1: 8MHz / CL TBD / DNP; Crystal_SMD_3225-4Pin_3.2x2.5mm; MPN TBD; not fitted

Connections:
+3V3_INV: R143.2; also elsewhere on the board
BRAKE_IN: R142.2; also elsewhere on the board
ENABLE_IN: R141.2, TP17.1; also elsewhere on the board
FAULT_N: R143.1, TP16.1; also elsewhere on the board
HSE_IN: C83.1, Y1.1; also elsewhere on the board
HSE_OUT: C84.1, Y1.3; also elsewhere on the board
MCU_BRAKE: R142.1; also elsewhere on the board
MCU_ENABLE: R141.1; also elsewhere on the board
MCU_PWM_UH: R135.1; also elsewhere on the board
MCU_PWM_UL: R136.1; also elsewhere on the board
MCU_PWM_VH: R137.1; also elsewhere on the board
MCU_PWM_VL: R138.1; also elsewhere on the board
MCU_PWM_WH: R139.1; also elsewhere on the board
MCU_PWM_WL: R140.1; also elsewhere on the board
PWM_UH_IN: R135.2; also elsewhere on the board
PWM_UL_IN: R136.2; also elsewhere on the board
PWM_VH_IN: R137.2; also elsewhere on the board
PWM_VL_IN: R138.2; also elsewhere on the board
PWM_WH_IN: R139.2; also elsewhere on the board
PWM_WL_IN: R140.2; also elsewhere on the board

Notes on the sheet:
LOCAL COMMAND SERIES RESISTORS / PAGE-TO-PAGE SIGNALS
FAULT INPUT / LOCAL PULL-UP AND TIMER BKIN
Q8 open collector -> pull-up -> PB12 / TIM1 BKIN. Bridge protection remains independent of firmware. Hold ENABLE low >=1 ms before deliberate re-enable. BRAKE remains independent of bridge ENABLE / fault.
HSE OPTION / CRYSTAL AND LOAD CAPACITORS DEFAULT DNP
Y1 8 MHz and load C are candidates. Select actual CL / ESR / drive and verify oscillator gain before fitting. Initial bring-up can use HSI16 / PLL.

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
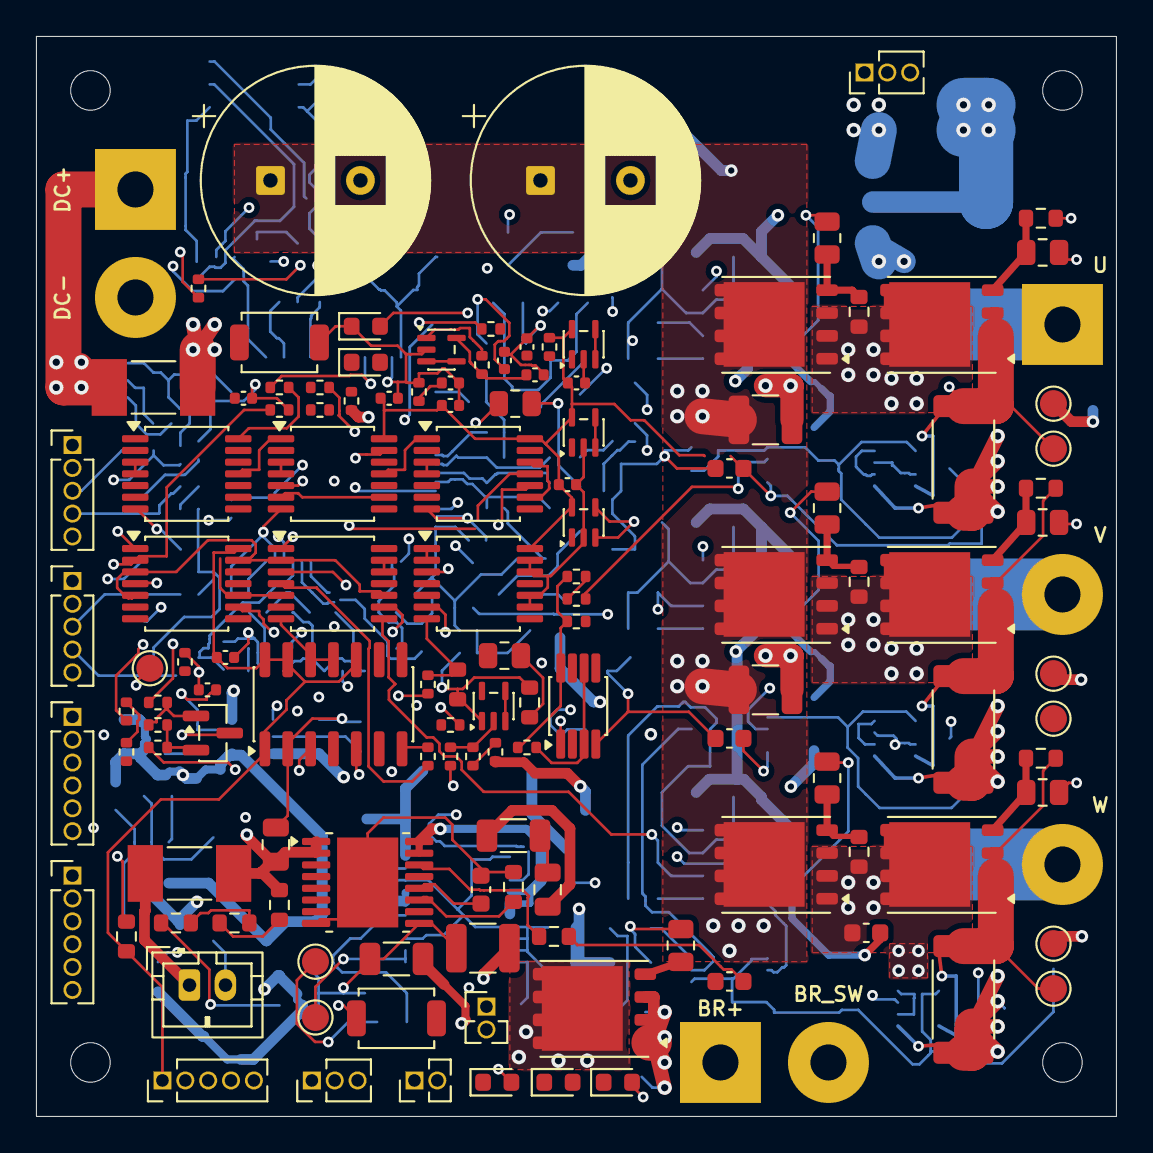
[picture p260: board inverter.kicad_pcb from above]

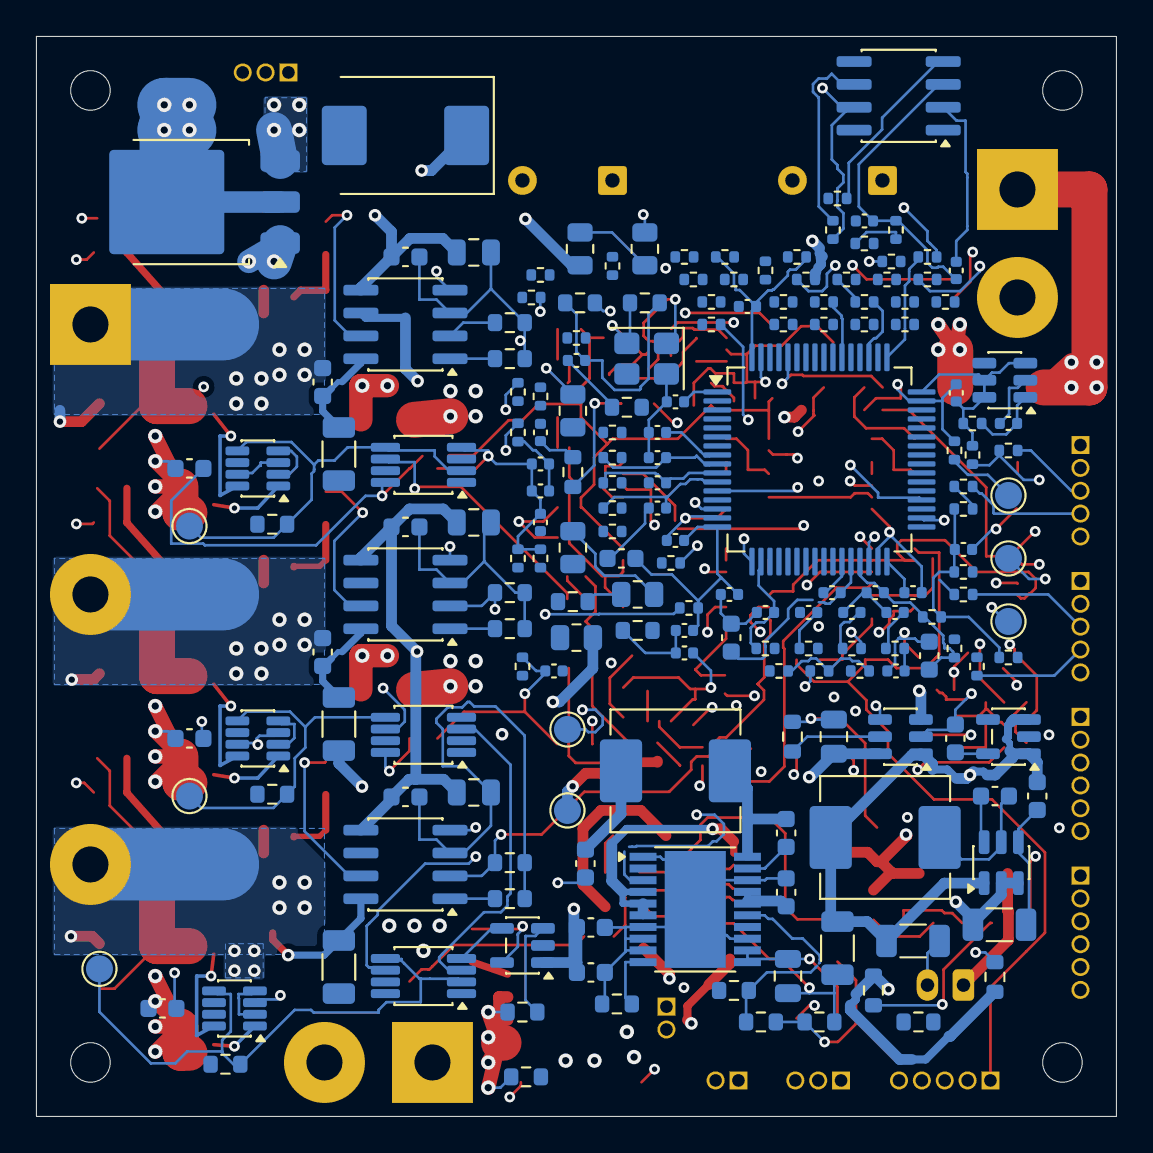
[picture p261: board inverter.kicad_pcb from below]

Board: 6 copper layers, 60.0 x 60.0 mm, 317 parts (183 on the bottom side), 209 nets.

Other parts of the board:
H1, H2, H3, H4: MountingHole_2.2mm_M2
