leolei2012/power_system/inverter/hardware/tools/migrate_integrated_rev_b.py

"""One-time Rev A -> integrated STM32G431 Rev B drawing record.

Reads the archived Rev A, not build_inverter.py; preserves existing power circuits.
DO NOT rerun over later manual edits. --write is deliberately required.
"""
from schematic_common import *
import argparse
import io
import zipfile

parser=argparse.ArgumentParser(description=__doc__)
parser.add_argument('--write', action='store_true')
args=parser.parse_args()
assert args.write, 'Explicit --write required; this replaces the Rev B drawing.'
archive=BASE.parent/'history/split_rev_a_2026-11-06.zip'
assert hashlib.sha256(archive.read_bytes()).hexdigest()=='ddf02a894b393ae0f5daab146b57430e298ea2ed765a1c85b54617d7ed1a465e'
z=zipfile.ZipFile(archive)
def old(name):
    key=next(v for v in z.namelist() if v.replace('\\','/').endswith('/'+name))
    return z.read(key).decode('utf-8-sig')
def parse_old(name): return sx.loads(old(name))
def props(sym):return {str(v[1]):str(v[2]) for v in children(sym,'property')}
def native_write(name,data):
    (BASE/name).write_text('('+str(data[0])+'\n'+'\n'.join(sx.dumps(v) if isinstance(v,list) else str(v) for v in data[1:])+')\n',encoding='utf-8')
def change_strings(v,fn):
    if isinstance(v,list):return [change_strings(x,fn) for x in v]
    if isinstance(v,str):return fn(v)
    return v
def set_title(d,title):
    t=child(d,'title_block')
    child(t,'title')[1]=title;child(t,'date')[1]='2026-11-06';child(t,'rev')[1]='B-integrated-draft'
    return d

# New designators start after the existing drawing; all existing power refs survive.
old_bom=list(csv.DictReader(io.StringIO(old('review/bom.csv'))))
for prefix in ['R','C','J','D','TP','U','Y','SW','PF']:
    counts[prefix]=max([int(r['Reference'][len(prefix):]) for r in old_bom
                        if r['Reference'].startswith(prefix) and r['Reference'][len(prefix):].isdigit()]+[0])
counts['PF']=100  # Existing hidden power flags are not physical BOM records.
new_pages=[]
new_expected=[]

# Resolve KiCad's official inherited G431 symbol into a project-local full symbol.
mculib=sx.load((STD/'MCU_ST_STM32G4.kicad_sym').open(encoding='utf-8'))
base_symbol=copy.deepcopy(next(x for x in mculib if tag(x,'symbol') and x[1]=='STM32G431R_6-8-B_Tx'))
leaf=next(x for x in mculib if tag(x,'symbol') and x[1]=='STM32G431RBTx')
oldname=base_symbol[1];base_symbol[1]='InverterLocal:STM32G431RBT6'
for u in children(base_symbol,'symbol'):u[1]=u[1].replace(oldname+'_','STM32G431RBT6_')
for p in children(base_symbol,'property'):base_symbol.remove(p)
for p in children(leaf,'property'):base_symbol.append(copy.deepcopy(p))
local=sx.loads(old('InverterLocal.kicad_sym'))
meta={'Value':'STM32G431RBT6','Manufacturer':'STMicroelectronics','MPN':'STM32G431RBT6',
      'Supplier':'LCSC','Supplier_PN':'C431633','Purchase_URL':'https://item.szlcsc.com/428111.html',
      'Verification':'project_draft','Selection_Status':'Rev B drawing candidate; shared library intake not performed',
      'Datasheet':'https://www.st.com/resource/en/datasheet/stm32g431rb.pdf',
      'Design_Note':'LQFP64; physical pins per DS12589 Rev6 Fig10/Table12; no external VCAP pin'}
for k,v in meta.items():
    p=next((p for p in children(base_symbol,'property') if p[1]==k),None)
    if p:p[2]=v
    else:base_symbol.append(sx.loads(f'(property {q(k)} {q(v)} (at 0 0 0) (hide yes) {effects(1)})'))
cache[base_symbol[1]]=base_symbol
s=copy.deepcopy(base_symbol);s[1]='STM32G431RBT6';local.append(s)
native_write('InverterLocal.kicad_sym',local)

def cap(p,x,y,value,net,b='GND',notes='',dnp=False):
    c=capacitor(p,x,y,value,notes=notes,dnp=dnp);c.connect(1,net,2.54);c.connect(2,b,2.54);return c
def rr(p,x,y,value,a,b,angle=0,dnp=False,notes=''):
    r=resistor(p,x,y,value,angle,dnp,notes);r.fields['Tolerance']='1%'
    r.connect(1,a,5.08 if angle==90 else 2.54);r.connect(2,b,5.08 if angle==90 else 2.54);return r
def flag(p,x,y,net):
    c=p.inst('power:PWR_FLAG',f'#FLG{ref("PF")[2:]}','PWR_FLAG',x,y);c.connect(1,net,2.54)
def port(p,x,y,count,value,mapping,dnp=False):
    j=connector(p,x,y,count,value,dnp=dnp)
    for k,v in mapping.items():j.nc(k) if v is None else j.connect(k,v)
    return j
def note(p,text,x=20.32,y=269.24):p.text(text,x,y,1.02)
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
