leolei2012/power_system/(commit log)

2026-11-11 feat: add controller and inverter engineering baseline
    Add KiCad projects, design documents, reference materials, and review artifacts.
    Document the single-power-port controller plan and 60x60 mm placement study.
    Keep ADC reduction alternatives recorded separately from the active ten-port plan.
    [Inverter_Compact_sources.csv, LKS32MC451VCT8_pin_plan.csv, STM32G431RBT6_pin_plan.csv, after_first_route_before_repairs.kicad_pcb, after_router_before_width_fix.kicad_pcb, agent_conditional_52pad.csv, aux_input.kicad_sch, aux_placement_proposal.kicad_pcb]
2026-11-11 docs: 新增 design_decisions.md（Rev E-1 设计决定记录）
2026-11-11 docs: 新增 Rev E 测试规范 docs/test_spec.md（#6）
    只写测试方法与判据，未执行任何测试。阈值来源逐条注明，
    与原理图/params.py/spec.md 不一致之处列入待定项清单 P-01～P-18。
2026-11-11 docs: design_decisions 补叠板顺序 A12、默认做法改为已定
2026-11-11 docs(test_spec): 增加正式验收项 ACC-1（60 V/5 Arms/20 kHz 叠板 30 分钟温升）（#6）
    阈值按 BSC110N15NS5、STM32G431RBT6 datasheet 上限留余量提出；
    新增待定项 P-19～P-23。未执行任何测试。
2026-11-11 docs: design_decisions 补保护参数 A13、不留风扇位 X17，修正 README 行号
2026-11-11 docs: 新增 docs/pinmap.md（Rev E-1 引脚唯一真源，Issue #1）
2026-11-11 按 Issue #5 定案补全已定料的 BOM 字段与查询数据
    仅更新 controller 与 inverter 的正式 BOM 及其 review 副本，不改原理图、PCB 和固件。
    已在原理图上的 MOS、2×16 排针和排座核对 C 编号并写入 2026-11-12 的价格与库存来源。
    XT60/XT30/MR60 板端连接器、线束侧 MR60-F，以及搬到 controller 的 CAN/485 按定案写入；现图尚未更新的位号和封装已标注待 #3。
    Refs #5
    [bom.csv]
2026-11-11 docs: design_decisions 补 00:57 定案 A14–A23（叠板细节、母线电流检测），C12 定案，X8 改为采用顶面散热片
2026-11-11 docs: design_decisions 补 A24 阻容最小封装 0603
2026-11-11 docs(pinmap): 母线电流检测 I_BUS(PA3→COMP2/BKIN2)、叠板机械与 0603 规则（#1 第2轮）
2026-11-11 docs: design_decisions 补 A25–A27（母线高端保护、板上比较器、J4/C20 位置）
2026-11-11 按雨田新增要求补 M2×11 铜柱、顶面散热片候选，并把 BOM 中 0402 阻容改为 0603
    不改原理图和 PCB。正式 BOM 与 review 副本保持同步。散热片尺寸和安装方式待焊台在 #4 确认。
    [bom.csv]
2026-11-11 bom(inverter): 选型母线保护器件（5mΩ 分流、INA241A2、TLV1821 开漏比较器）Refs #5
    [bom.csv]
2026-11-11 hw(controller): Rev E-1 原理图按 pinmap 更新（Issue #2）
    - J101/J102 按 docs/pinmap.md 逐针重连（23 非 GND + 41 GND）
    - 新增 RS-485（MAX3485ESA+T C18148，PB9 DE//RE+10k 下拉，5V_OUT 经 PMEG2010ER 防倒灌）
    - CAN 搬到 controller（SN65HVD232DR），ABZ/SPI 编码器、SWD 板边 GH1.25 卧式侧插
    - 侧发光 RUN/FAULT LED、侧按 RESET，取消 BOOT 按钮（BOOT0 10k 下拉 + TP）
    - MCU 侧 8 路 ADC RC（I_U/V/W/I_BUS 100R/1nF，V_DC/NTC/SP1/SP2 1k/10nF）
    - 13 个 0402 阻容改 0603；13 个未用 GPIO NC
    - 共享库改为 git 子模块 lib/kicad_library（main 1dd8f79），库表用 ${KIPRJMOD} 相对路径
    - ERC 0 错误 0 警告；导出 PDF/网表/BOM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
    [bom_issue2.csv, comms.kicad_sch, controller.kicad_sch, core_arm.kicad_sch, core_interface.kicad_sch, core_supply.kicad_sch, encoders.kicad_sch, mcu.kicad_sch]
2026-11-11 hw(controller): 0603 阻容封装/料号同步 PR #12 BOM（Issue #2）
    [bom_issue2.csv, core_supply.kicad_sch, mcu.kicad_sch, mcu_analog.kicad_sch, mcu_control.kicad_sch]
2026-11-12 docs(pinmap): I_BUS 零点改 0.825 V、量程 +22.75/−7.75 A（依据 #3 结论，PR #13）
2026-11-12 docs(pinmap): 编码器端子固定 3.3 V（仅支持 3.3 V 编码器）；485 第4针 5V 经 TPS2553 限流 + D201（Refs #2）
2026-11-12 hw(controller): 未实例化旧页 debug_comms/sensors 移入 history/（探针 N3，Refs #2）
    [debug_comms.kicad_sch, sensors.kicad_sch]
2026-11-12 hw(controller): 5V_OUT 加 TPS2553 限流、去掉 JP203 编码器仅 3.3 V、N1 补封装、N2 统一 D201、N6 485 偏置(DNP)、丝印 3.3V ENCODER ONLY（Refs #2）
    [comms.kicad_sch, controller.kicad_pcb, controller.kicad_sch, core_supply.kicad_sch, encoders.kicad_sch, mcu_control.kicad_sch, ui_debug.kicad_sch]
2026-11-12 hw(controller): 更新 review 产物（ERC/DRC、网表、BOM、PDF、逐脚核对、第三轮变更说明，Refs #2）
    [bom_issue2.csv]
